dsgmxc/2026_fpga_qrs/llm-log/LLM-078.md

# LLM-078:拐点提前是不是「log 扫描 + 少点 + 插值」造成的?—— **不是**;顺带把自绘硬件板卡入库

- **日期**: 2026-10-24
- **模型**: deepseek-flash(Claude Code harness)
- **任务**: ①用户怀疑 C-V 曲线拐点比参考偏早,是**显示方式**(log 扫描、点数少、插值)造成的;
  ②把桌面新增的四块**自绘硬件板卡**设计源文件推入交付仓库。

## 提示词

```
我突然决定是不是因为我们是log扫描而且点数比较小曲线主要是插值出来的所以从图上显得和标准有点不符合
```

```
你确定水平差不是这个原因导致的吗，我主要是想解决我们曲线的拐点在实测前面的问题
```

```
如果是测量误差就算了，只要不是显示导致的就行
```

```
桌面上多了一个硬件电路文件夹，这些是我们自己画的主要功能的板子也要推送进交付仓库
```

## 一、问题拆分

「显示导致的」包含两个互不相同的机制,必须分开验证:

| 机制 | 会改变什么 | 不会改变什么 |
|---|---|---|
| 60 点 log 网格 + log-log 直线插值 | **点与点之间**画出来的线 | **采样点上的读数**、拐点的真实位置(至多把拐点量化到网格) |
| 实测数据本身 | 采样点读数与拐点位置 | — |

## 二、判据:半降电压 V50

不用「最陡线段」估拐点(它对采样相位敏感),改用与拟合无关的判据:

> **V50** = 电容从 1 V 平台降到 50 V 平台、跨过对数中值时的电压(对数域线性插值)。

对三条腿分别算三种曲线:①参考曲线(201 点,直接取);②参考曲线**按我们的 60 点 log 网格采样后再 log-log 线插**;③实测(2026-10-24 一轮,60 点/腿)。

| 腿 | 参考 V50 | 参考按 60 点采样 + 线插 | 实测 V50 |
|---|---|---|---|
| CISS | 3.94 V | 3.95 V | 4.09 V |
| **COSS** | **10.06 V** | **10.04 V** | **9.23 V** |
| **CRSS** | **10.38 V** | **10.28 V** | **9.11 V** |

⇒ **采样 + 插值只让拐点动 0.02 V(COSS)/ 0.10 V(CRSS);实测却早了 0.83 V / 1.17 V**,差一个数量级。
且插值在采样点上**恒等于实测值** —— 9.62 V 那点实测 385 pF、参考 916 pF,与线怎么画无关。

## 三、实测差异的性质:整条曲线在电压轴上左移

把实测 COSS 与参考做「电压平移 + 竖直偏置」拟合:

| 轮次 | 最佳电压平移 | 竖直偏置 | 平移后残差 | 只做竖直对齐的残差 |
|---|---|---|---|---|
| 2026-10-23 | **+7.6 %** | −6.0 % | 2.2 % | 14.7 % |
| 2026-10-24 | **+7.9 %** | −6.1 % | 2.1 % | 14.7 % |

两轮独立扫压一致到 0.3 %,是稳定的系统效应。关键点:

| 电压 | 实测 COSS | 参考@同电压 | 参考@电压 ×1.079 |
|---|---|---|---|
| 9.62 V | **384.9 pF** | 916.3 pF | **412.5 pF** |

⇒ 不是竖直电平错,而是**整条 COSS 曲线在电压轴上左移约 8 %**(拐点段形状重合,残差 2.1 %)。
**CRSS 不能套这个结论**:平移后残差仍 27 %、电平差 51 %,形状本身就对不上。
**CISS 无有效约束**:曲线平坦,平移与竖直偏置高度简并(有/无平移残差同为 1.2 %)。

## 四、原因未定,但可排除显示

| 候选 | 证据 |
|---|---|
| **显示/插值** | ❌ 已排除:V50 只动 0.02–0.10 V(§二) |
| 器件拐点比参考(10 颗 TK9J90T 中位数)低 | 支持:平移后形状完全重合 |
| 偏压轴标度偏 +8 % | 未排除:`×10` 高压级(`CV_BIAS_HV_RATIO`)**从未端到端实测**;已记录的 DAC 模块误差(`19.777×frac − 10.057`,增益 −1.1 %、零点 −57 mV)**方向相反** |

⇒ 要分开这两者,只能在下一个上电周期用万用表实测高压级 1 / 10 / 50 / 100 V 四点。
用户决定:**若是测量误差则不再追**(原话:「如果是测量误差就算了,只要不是显示导致的就行」)。

## 五、纠错轨迹

| # | 事情 | 结论 |
|---|---|---|
| 1 | 先用「最陡线段」估拐点,得到「60 点网格让 COSS 拐点早约 0.6 V」 | 换成 V50 判据后只有 **0.02 V** ⇒ 那是**估计器自己**的偏差,不是网格效应。**判据的选择会决定结论**;对"位置"类问题要用与拟合无关的判据 |
| 2 | 一度把窗段拟合(低段 −9 % / 拐点 +8 % / 高段 +17 %)当成"非均匀平移" | 平坦段 **平移与竖直偏置简并**,窗段平移不可辨识;只有拐点段约束有效 |
| 3 | 差点把"8 % 左移"归因于已知 DAC 模块误差 | 该误差会让偏压**偏低**、拐点**偏晚**,与观测**方向相反** ⇒ 不能拿来解释 |

## 六、硬件设计源文件入库(同日)

桌面 `硬件电路/` 下 4 份**立创EDA专业版工程归档**,复制进交付仓库 `hardware/`,
**文件名改为纯英文**(M14),源文件保持不动:

| 仓库文件名 | 原文件名 | 大小 | MD5 |
|---|---|---|---|
| `cv_control_expansion_board.epro` | `ProPrj_26cv测试主控拓展版_2026-10-24.epro` | 102,176 B | `20b46ffc…` |
| `lcr_acquisition_board_v3.epro2` | `ProPrj_26嵌赛-LCR采集板-zjy-第三版_2026-10-24.epro2` | 270,729 B | `cc6461a5…` |
| `power_board_110v_48v_in_110v_12v_5v_out.epro2` | `电源板110v,48v输入110v,12v,5v输出.epro2` | 419,302 B | `8f7e76ef…` |
| `relay_matrix.epro2` | `ProPrj_26嵌入式大赛继电器矩阵_2026-10-24.epro2` | 491,762 B | `fe2c9b65…` |

- 复制后逐份 `md5sum` 与源文件比对,**4/4 一致**;
- 新增 `hardware/README.md`:用途 / 打开方式 / 收录范围 / 校验值;
- 顶层 `README.md`:目录对照表加 `hardware/` 行、「新增目录」数 4→6、
  「唯一二进制」改为两类(位流 + 4 份工程归档);
- ⚠️ 工程归档内嵌立创EDA账号元数据(原理图/封装文档的 `username`/`nickname` 字段),
  属设计文件自带内容,**未改动** —— 改动会破坏工程归档的完整性。

## 七、当前状态

| 项 | 状态 |
|---|---|
| 显示/插值嫌疑 | ✅ **已排除**(V50 0.02–0.10 V vs 实测 0.83–1.17 V) |
| 拐点左移的根因 | ⚠️ **未定**:器件 vs 偏压轴;需万用表实测高压级 |
| 用户决定 | 按测量误差处理,**不再追** |
| 代码改动 | **无**(本轮只做分析,未改测量/渲染代码) |
| 硬件文件入库 | ✅ 4 份,MD5 4/4 一致,待提交推送 |
