dsgmxc/2026_fpga_qrs/llm-log/LLM-077.md

# LLM-077:曲线开头的「陡升」—— 不是继电器切错,是**换腿后第一点采在高压没落稳的时候**;顺带查出 ADC 数据线全 0

- **日期**: 2026-10-24
- **模型**: deepseek-flash(Claude Code harness)
- **任务**: 用户观察到「**测曲线下面两条的开头总是有个陡峭的上升**」,问是不是切换过程有问题。

## 提示词

```
测试没什么问题可以更新仓库了，还有为什么我测曲线下面两条的开头总是有个陡峭的上升是切换的过程有什么问题吗
```

## 一、先看现象(来自板上日志,不是推测)

同一轮 0.1→100 V、60 点/腿、驻留 300 ms 的三腿连扫
(`/var/log/qrs-ui.log` 第 1880~2258 行,数据本身是好的):

| 腿 | 第 1 点(0.100 V) | 第 2 点(0.112 V) |
|---|---|---|
| CISS(第 1 腿) | Cs **3378.98** pF,VL/VH 84.86% | Cs 3374.30 pF,84.83% |
| COSS(第 2 腿) | Cs **1872.47** pF,VL/VH 72.43% | Cs **3393.32** pF,86.46% |
| CRSS(第 3 腿) | Cs **572.58** pF,VL/VH 23.87% | Cs **1700.40** pF,37.69% |

⇒ 第 2、3 腿的**第 1 点偏低**(C 只有正常值的一半/三分之一),第 2 点就恢复了。
曲线在 0.1 V 附近看起来就是「先压下去再陡升」—— 用户说的「开头陡升」是**第 1 点太低**造成的,
不是曲线中间有跳变。

## 二、两条对照把原因夹死

| 对照 | 做法 | 结果 | 排除掉什么 |
|---|---|---|---|
| 单腿连扫 | 只跑 CRSS 一条腿(开扫前偏压已在低压停留很久) | 第 1 点完全正常 | **不是继电器切换本身**—— 同样的 `RelayView_ApplyPath()`、同样的稳定窗 |
| 「1 点/腿」 | 0.1 V → 0.1 V、每腿只 1 点,三腿连扫 | 三腿第 1 点**全部正常**(3379 / 3589 / 1809 pF,VL/VH 与稳态一致) | **不是"换腿"这个动作**,而是**上一腿最后一点停在 100 V** |

⇒ 换腿时高压级要从 **100 V 降回 0.1 V**;300 ms 驻留不够,
第 1 点采到的是「还在往下掉的偏压」⇒ 有效电容偏小 ⇒ C 偏低。

## 三、改法:**用实测已经证明够用的那个时刻**

老代码里同一条腿的**第 2 点**是在 0.1 V 下发后 **600 ms** 采的
(= 第 1 点的 300 ms 再加一个驻留),而它**一直是对的**(COSS 3393 pF、CRSS 1700 pF,
与第 3 点一致)。所以改法不是"拍脑袋加时间",而是**把第 1 点挪到 600 ms 这条线上**:

| 文件 | 改动 |
|---|---|
| `src/c_ui/app/pynq_protocol.c` | 🆕 `s_leg_settle_pending`:`sweep_begin_leg()` 置位;`sweep_step()` ① 见到它就把本圈**空等一个驻留**,下一圈才采第 1 点 |
| 同上 | 🆕 `sweep_finish()` 换腿分支里**先 `bias_apply(0.0f)` 再切继电器** |

第二条是查日志时顺带发现的**既有问题**:原来换腿时继电器是在**上一腿终点(通常 100 V)下热切换**的 ——
触点带 100 V 断开/闭合长期会烧蚀,而且高压级要拖到下一条腿下发 0.1 V 时才开始泄放。
先撤到 0 V,泄放从换腿这一刻就开始(多赚一个继电器稳定窗 40~70 ms),触点也不再带压切换。

代价:每条腿 +1 个驻留,三腿一轮 **54 s → 54.9 s**。

## 四、验证:卡在 ADC 上(这次没验成)

部署时发现**新起的 c_ui 所有点都是 A/B 峰峰 0 码**。往下挖:

| 检查 | 结果 |
|---|---|
| 原始采样值 | `0x98[11:0]` **恒 2048** = 存的是 `adc_d ^ 0x800` ⇒ **`adc_d` 恒 0x000** |
| 扫全部相位/分频 | DIV 2/4/13,PH_OFF 从 `−P/2` 到 `P−1−P/2` **逐格试过,全是 2048** |
| 偏压 0→20→60→100 V、回路 CISS/CRSS | **A/B 两路直流也一动不动** |
| `0x88` | `0x104`(OEB=0 使能、PDN=0 不掉电) |
| `0x84` | `0x1`(clk_release=1,MMCM 放行) |
| `0x90` | `0x3`(mmcm_locked=1、done=1);GO 后 busy 会抬起再落下 ⇒ 采集状态机在跑 |
| 软重启(位流重载)后复测 | **仍然全 2048** |

⇒ 不是相位、不是寄存器配置、不是 PL 卡死(重启也不变)⇒ **ADC 的数据线整体没有驱动/没有供电**,
问题在外设侧。**当时写成「硬件故障,待用户用万用表查」—— 这句后来被用户当场更正**(见 §七)。

✅ 日志侧能确认的部分:`[proto] 换腿后第一点:多等 300 ms …` 三条腿各打印一次
(第 2333 / 2577 / 2821 行),新增的定时路径**已跑过**;
❌ **效果(第 1 点是否回到正常值)没验成** —— ADC 不出数,任何扫压都无读数。

## 五、纠错轨迹

| # | 事情 | 结论 |
|---|---|---|
| 1 | 先写了一个直接量「100 V→0.1 V 要多久」的脚本(`tools/bias_settle_test.py`) | 采回来全是 2048。先怀疑**脚本自己错**(只等 `done` 没等 `busy` 抬起、继电器停在 ALL_OFF),两处都改了 —— **还是 2048**。当时把它记成"实验没做成",**实际那时 ADC 已经死了**。教训:全常数读数要先怀疑**量具**,而不是反复改自己的脚本 |
| 2 | 改法第一版注释只写「300 ms 不够」 | 复查日志时发现**老代码的第 2 点(600 ms)一直是对的** ⇒ 把注释改成"600 ms 是实测证明够用的线",**让改动有标定,不是估的** |
| 3 | 只加延时,没看换腿时的继电器 | 读 `sweep_finish()` 才发现换腿时偏压还挂在 100 V 上 —— **继电器一直在热切换**,这是独立于本问题的可靠性缺陷,一并修掉 |
| 4 | 一度以为 ADC 坏了是**软重启能救**的状态 | 软重启(位流重载、`dmesg` 确认加载一次)后复测**依旧全 0** ⇒ 排除 PL 状态,判到外设侧 |
| 5 | **把"未接外设"写成了"硬件故障"** | 用户回:「**是我没接外设**」⇒ 数据线全 0 的**证据没错**,错的是**结论措辞**:证据只支持"外设侧没信号",不支持"坏了"。正确顺序是**先问外设接没接**,再谈供电/排线/万用表 |

## 六、当前状态

| 项 | 状态 |
|---|---|
| 源码(工作区/板 `/home/xilinx/c_ui_src/`) | 已同步,md5 `9dc6c2cd…`;板上 `make -j2` 零 warning,`c_ui` md5 `6ca7dd19…` |
| 运行中的进程 | 仍是**上一个**二进制(只有"多等一个驻留",没有"先撤压再切继电器");下次启动才生效 |
| 上电次数纪律 | 本上电周期位流加载 **1 次**(服务由软重启后手工启动) |
| 阻塞 | **外设未接**(用户确认)—— 不是 ADC 故障 |
| 收尾 | 服务已 `stop`(inactive / disabled);偏压写 **0x00000(0 V)**、继电器 **0x10(ALL_OFF)** 后 `sync` + `shutdown -h now`;ping **100% 丢包** |

## 七、用户更正(同日)

用户原话:

```
是我没接外设，先关系统吧我后面测
```

⇒ 本轮「ADC 全 0」**不是硬件故障,是外设没接**。**§四 的全部排除结论仍然成立**
(相位 / 分频 / 寄存器配置 / PL 状态 / 软重启都已排除),唯一要改的是**把它称为"故障"**。
⚠️ 也因此,**本轮的修复效果仍然没验过** —— 等用户接好外设、下次上电启动服务再验。

## 八、上板验证(同日,外设接好之后)

| 项 | 结果 |
|---|---|
| 上电 → 服务启动 | `dmesg` 位流**恰 1 次**;运行 `c_ui` **`6ca7dd19…`**(两项改动都在);FCLK0 50.0000 MHz |
| ADC 通路自检(只读探针) | A/B 峰峰 **~1124 / ~987 码**(上一轮恒 2048)⇒ 外设已接、通路正常 |
| 用户触发 | 界面点扫压(0.1→100 V,60 点/腿,三腿) |
| 三条 `[proto] 换腿后第一点:多等 300 ms` | **3 / 3** |
| 点数 / OTR | **180 / 180**,OTR 非零 **0** |

**首点 vs 次点(Cs)**:

| 腿 | 修复前 首/次 | 比值 | **修复后 首/次** | **比值** |
|---|---|---|---|---|
| CISS | 3378.98 / 3374.30 pF | 1.001 | 3378.81 / 3375.22 pF | 1.001 |
| COSS | 1872.47 / 3393.32 pF | **0.552** | **3568.80 / 3559.53 pF** | **1.003** |
| CRSS | 572.58 / 1700.40 pF | **0.337** | **1749.57 / 1795.66 pF** | **0.974** |

CRSS 首点比次点低 2.6 %,但**落在第 2 点与第 3 点之间**(第 3 点 1785.53 pF)⇒ 正常点间抖动。
用户目视评价:「**现在好多了**」。

⚠️ **两处改动证据强度不同,别合并**:
①「多等一个驻留」有日志标记 + 首点数据,✅ 已验;
②「换腿前先 `bias_apply(0)`」代码在运行二进制里,但该函数**不打印日志**,本轮**无独立读数** ⇒
只能写"代码路径已生效",**不能写"已确认不再热切换"**。要坐实需加一行日志,下个周期验。

📄 数据归档:`report/measurements/20261024_leg_settle_fix_sweep.md`
(+ `artifacts/20261024_leg_settle_run.log` `79f6a1a0…`、`artifacts/20261024_leg_settle_sweep.csv` `aa855094…`)。
🔌 收尾:服务 `stop`(inactive / disabled)、偏压 0 V、继电器 ALL_OFF、`sync` + `shutdown`,ping 100% 丢包。
