dsgmxc/2026_fpga_qrs/llm-log/LLM-073.md

# LLM-073:自动换挡改判据 —— 用 `VL/VH` 反推 `|Z|`、加换挡后核对、一次只走一挡

- **日期**: 2026-10-23
- **模型**: deepseek-flash(Claude Code harness)
- **任务**: 用户接好回路控制后试自动换挡,报告「合理的电压下切换没问题,电压较小的时候用高档位确实会测出负的」。把换挡判据从复数 `|Z|` 改成两路**解调幅值之比**,并给换挡加一道"换完核对"。

## 提示词

```
现在我的回路控制都连接好了按理说应该可以尝试自动切换了，
前面100欧姆档应该问题不大但是后面是不是切10om会比较好
（模型纠正方向后）
刚式了一下在合理的电压下切换应该没有问题电压较小的时候用高档位确实会测出负的
先断电吧然后你写完我重新上电
```

## 诊断

用用户 2026-10-23 日志里同一器件、同一 50 V CRSS 的三个挡位读数:

| 挡位 | R0 | Re Z | Re Z / R0 | Im Z |
|---|---:|---:|---:|---:|
| B | 100 Ω | 1.85 kΩ | 18.5 | −12.5 kΩ |
| C | 1 kΩ | 17.7 kΩ | 17.7 | −11.9 kΩ |
| D | 10 kΩ | 175 kΩ | 17.5 | −9.7 kΩ |

**实部几乎严格正比于 R0,虚部基本不动** ⇒ 实部是测量链的镜像,不是器件。
`Z = R0·(VH−VL)/VL` 在 `VL ≪ VH` 时是一个大数减小数,通道间任何失配都被按
`|Z|/R0` 倍放大;R0 越大,同一个失配越显眼。负的 Cs 就是在这个背景下出现的:
真实信号已经小于失配项,`Im Z` 被实部伪影压过符号。

**机制未定**:试过"B 路加性串扰"和"B 路增益误差"两个最简模型,都只能解释 Re
而解释不了 Im 同时基本正确。**记录只到"实部 ∝ R0"这一层,不编机制**。
候选的实验是四挡已知电阻标定(见下)。

## 改动(全部在 `src/c_ui/app/pynq_protocol.c`)

| # | 改动 | 为什么 |
|---|---|---|
| 1 | `AdcPair` 增 `vl_vh`(两路解调幅值之比)与 `fresh`(本次采到) | `Z` 坏了比例仍在;`fresh` 防拿上一点残留做决定 |
| 2 | 采集后算 `vl_vh`;比例 > 0.95 ⇒ **判本点无读数**(`z_valid = 0`)并给出建议挡位 | 大数相减已经不可信,往曲线上塞负电容更糟 |
| 3 | 比例 < 0.15 % ⇒ 只警告(不判无效) | B 路进噪声底时 Cs 靠相干平均仍可用,`D/Cp` 不可信 |
| 4 | 换挡判据改为 `z_app = R0·√(1/r² − 1)` | 直接用比值,不经过 `(A−B)` 相消 |
| 5 | **换挡后核对**:同一器件换一挡,`z_app` 必须落在 1.5 倍内;否则**回退旧挡并关闭本轮自动** | 判据错误是确定性的,失败后每点都会重来 —— 必须粘滞 |
| 6 | **一次只走一挡**(`gear_adjacent()`) | 跨挡会一次跨过两个没验证过的电阻,出问题定位不到 |
| 7 | 目标带 `[0.15, 0.90]`;上界取 0.90 而非 0.85 | 0.1 V 的 CISS 在 B 挡上就是 0.894,那一点用户实测"问题不大",不该被赶去 A 挡 |
| 8 | `[adc]` 日志行增 `VL/VH ××.××%` 带 ⚠低/⛔高 | 挡位是否匹配一眼可读,不用事后算 |
| 9 | `sweep_start()` / 换腿时清核对状态 | 换腿等于换器件,上一腿的 `|Z|` 不能跨腿比 |

**自动换挡仍然默认关闭**(文件 `/home/xilinx/sweep_auto_gear` 才开),理由不变:
四个挡位的参考电阻尚未用已知件标定,未标定的比例上做自动决策只是放大未知量。

## 自我纠错(本次最重要的一条)

2026-10-15 的方案注释里写过「**换挡判据本身没错 —— 错的是它脚下的 |Z| 本身不可信**」。
2026-10-23 的数据说明**这句只对一半**:判据(拿复数 `|Z|` 选挡)本身就错,
因为那条 `|Z|` 的实部 ∝ R0,拿它选挡会把坏数再放大一次。注释已改写,
并保留原判断作为追溯(见 `SWEEP_AUTO_GEAR_FLAG` 上方)。

**同日上板后第二次纠错**:上面新加的「换挡后核对」在**拐点附近会误判**。
第一次实测的 3.13× 出现在 9.617 V(B)→ 10.812 V(C),两个点本来就跨过
Coss/Crss 的拐点;而 C 挡的 Re 伪影(9.27 kΩ)又把 `z_app` 抬高。
**判据的假设(相邻两点 |Z| 变化 < 1.5 倍、`z_app` 与 R0 无关)在拐点处两条都不成立。**
⇒ 1.5 倍阈值不是"待定",是**已知不成立**;核对必须改成同偏压复测。
这条也说明:把「未验证的风险」写进记录是有用的 —— 它正是这次踩中的那一条。

## 结果

☐ ✅ 直接可用   ☑ ⚠️ 部分可用   ☐ ❌ 不可用

- **已上板(2026-10-23 第 2 次上电)**:自动换挡只走一步就被核对拦下 ——
  9.617 V 时 B(100 Ω)比例 2.85 % → 换 C;10.812 V 时 C 挡反推 10982 Ω vs 锚点
  3512 Ω,判 **3.13 倍** → 回退 B,**本轮不再换挡**。负 Cs 未再出现;
  其余 58 点全程 100 Ω,所以曲线与上一轮 B 挡数据一致(用户:「感觉区别不大」)。
- **⚠️ 核对判据有缺陷(本轮实测)**:3.13× 不能证明 C 挡坏 ——
  ① 两个读数跨了拐点(9.617 V vs 10.812 V,真实 |Z| 本身在变);
  ② C 挡的 Re∝R0 伪影把**比例反推**的 |Z| 抬高(10.812 V:Re 9.27 kΩ、Im 4.03 kΩ),
     而 `z_app` 只有幅值、分不清 Re/Im。
  ⇒ 结论从「这一挡算不出来」降级为「**这一挡没法用这个判据验**」。
  改法:换挡后在**同一偏压**复测再比,不要拿下一个扫压点当参照。
- **Cs 本身在 C 挡是可用的**:C 挡 10.812 V 读 39.5 pF,与 B 挡 9.617 V 的 50.0 pF、
  12.155 V 的 35.2 pF 连成单调曲线 —— 坏的只是复数 Z 的实部,不是 Cs。
- **证据**:`report/measurements/artifacts/20261023_crss_gear_probe.log`(md5 `26aa69c0…`)。

## 验证方式(上电后照这个跑)

1. `sudo touch /home/xilinx/sweep_auto_gear`,测量页选 B 挡,跑一次「全部」或 CRSS。
2. 日志里应当看到:
   - `[adc] ... VL/VH ××.××%` —— 50 V CRSS(≈12.5 kΩ)在 B 挡应为 **≈0.8 %**
     (`100/√(100²+12550²)`);**若日志明显大于这个数**,说明 B 路存在与 R0 无关的
     偏移,那正是要查的量;
   - 第一次往 C 挡换后,下一点出现 `⛔ 换挡后 |Z| 对不上 … 回退到 100 Ω 挡`,
     随后整轮不再换挡;
   - **不再出现负 Cs**(比例 > 95 % 的点被 ⛔ 挡住)。
3. 若核对没有触发、C 挡的 `z_app` 与 B 挡一致 ⇒ 说明这一挡是好的,可以继续往上试。
4. 四挡已知电阻(10 Ω / 100 Ω / 1 kΩ / 10 kΩ 各配一只)标定做完后,才考虑默认开启。
