dsgmxc/2026_fpga_qrs/llm-log/LLM-069.md

# LLM-069: CRSS 高压端坏点的根因 ——从"采样刻度错一拍"改判到"ADC 真的过载了"(OTR 作证)

- **日期**: 2026-10-15(第 64 次会话)
- **模型**: Claude(DeepSeek-V4-Flash 会话)
- **任务**: 用户 2026-10-14 报告「**我发现 50 附近测量 CRSS 确实容易出问题**」+
  「**我看到的调试界面就是下面那个曲线有波动不太干净的正弦波,你先分析一下这些坏点原因导致的**」。
  产出:`report/measurements/20261015_crss_bad_points_root_cause.md`(纯分析,**未改一行代码**)。
  **推翻/修正了 `LLM-068` 里那条机制推断。**
- **上游**: `LLM-068`(自洽判据 + 重采 —— 它把尖峰"挡在门外",本次是问"门外的到底是什么")

## 提示词

```
我发现50附近测量crss确实容易出问题，现在先把系统关了我要断电了，你查一下最近的单点测量看看原因
```
```
我看到的调试界面就是下面那个曲线有波动不太干净的正弦波，你先分析一下这些坏点原因导致的
```

## 模型回答

**结论一句话**:坏点不是噪声、不是解调算错 —— 是**采集缓冲里混进了 1–10 个打到 ADC 满量程轨的样本**;
它**既挑回路(只有 CRSS)、又挑偏压(只在 ≥40 V)**。CRSS@50 V 坏捕捉 **73%(11/15)**、
CRSS@55 V **89%(8/9)**、CRSS@0.1 V 只有 **5%(1/20)**、CISS 扫压 60 点全程 **0%**。

**三条指纹**:

1. **解调干净、峰峰炸。** CRSS ≥39 V 采纳点上 A 路解调幅值 CV = **0.14%**(0.3274 ± 0.0005 V),
   而同期 ppA 在 1348 → 1354 之间跳。8190 点相干解调对 1–10 个孤立样本几乎免疫(权重 0.12%),
   而峰峰 `max−min` 被单个样本完全决定 ⇒ **是极少数样本的瞬时越界,不是整段污染、不是算术错**。
2. **ppA 落在离散台阶上。** 干净 1060–1640;另一簇在 **2348–2787**。算给你看:
   干净信号跨 `[2048−671, 2048+671] = [1377, 2719]`;若**一个**样本打到上轨 4095 ⇒ `pp = 4095−1377 = 2718`。
   实测那一簇 2731 / 2737 / 2740,**差 <1%** ⇒ **"恰好一个样本到轨"**。`ppA ≈ 4095` 那簇 = 两端都到轨。
3. **A、B 一起胀。** CRSS@55 V 干净时 ppA/ppB = 1351 / **32**(B 路幅值只有 **5.7 码** = 0.28% 满量程),
   坏时 3968 / 3932 —— 20 条高压过载里 **18 条 B 也 ≥2000** ⇒ 瞬变是**两路共有的**,量级 ≡ 满量程。

**★ 决定性证据:`adc_otr`。** 它是 **AD9238 自己的输出引脚**(`Y8`,`led.xdc:130`),
手册原文 *"Out-of-Range Indicator for Channel A/B"*。逐字 OTR 位(2026-10-14 修好位序后才有效):

| 分组 | n | `OTR > 0` |
|---|---|---|
| 干净(ppA < 2000) | **213** | **0(0%)** |
| 高压过载 | 20 | 16(80%) |
| └ ppA ≥ 3900 | **13** | **13(100%)** |

数据总线是 12 根线,OTR 是**独立的第 13 根**。一根与数据无关的引脚**跟着一起置起**,
说明不是数据总线被读错,是 **ADC 自己判定输入越了量程**。且计数只有 1–10 / 16384 字,
而"采样刻度错一拍"会**每个周期都错**(8190 次/采)—— **量级差三个数量级**。

**机制候选(排过序)**:H2a **CRSS 组合下栅极浮空**(1 MHz 经 `Cgd` 整流给浮空节点充电到击穿)领先
—— 它一次解释了"只有 CRSS""只有高压""1–10 次/8192 的稀疏率"三件事;
H2b 50 V 下继电器触点微弧;H2c 偏压 ×10 放大器尖峰(**解释不了"只有 CRSS"**,CISS/COSS 走同一套偏压);
H1 采样刻度错一拍(**被削弱但未排除**,见下)。

**判别实验**:★(a) CRSS 夹具加一只 **1 kΩ 栅–源电阻**(一只电阻,判别力最强);
(b) CRSS@50 V 关掉激励再采;(c) **软件诊断打印越界样本的序号/值/通道** —— 纯 C、不占位流周期,
**是唯一能把 H1 和 H2 分开的实验**。

**⛔ 明确说了不要做的事**:不要用放宽阈值的办法"修"它 —— `142 / 208 / 362` 这种量级,放宽度覆盖不了,
只会把 519 pF 那种尖峰重新放回曲线上。**要修的是模拟侧,不是判据。**

## 结果

☐ ✅ 直接可用
☐ ⚠️ 部分可用
☑ **📋 分析结论,不改代码** —— 用户要的是"分析原因",本次**一行代码没动**。
结论是**根因定位到模拟侧(候选 H2a),并给出三个判别实验**;
⚠️ **没有把 H1(数字)排除掉** —— 见"纠错轨迹"第 7 条。

## 验证方式

**全部数字都在同一份日志上现场重算,不引用转述**:

| 项 | 值 |
|---|---|
| 原始日志 | 板上 `/var/log/qrs-ui.log` → 主机 `/tmp/qrs-ui-final.log` |
| 文件 | **949465 B · 9211 行** · md5 **`809f9c5898362d6b46b63095ba7335c1`** |
| 分析窗口 | 第 7964 – 9211 行(最后一次 `c_ui 启动` 起,进程未再重启) |
| 证据行 | **245 条**(严格格式,带 `码/期望` 与 `采 N 次` 两列) |
| 脚本 | `/tmp/doc69.py` `doc69b.py` `doc69c.py` `doc69d.py`(主机,重启即失;逻辑已写进测量记录各表) |

**回路归属用硬件真值**:取 `[relay] 回路 → X(0xNN)` 那行 —— 它是 `c_ui` **真的写了 `0x1C` 并回读确认**
之后打的,**不是界面按钮状态**。

**手册依据**(本次新读):`/home/hyp/Desktop/硬件资料/AD9238模块资料/芯片手册/ADI-AD9238-65.pdf`
(Rev. C)—— OTR 引脚定义(脚 58 / 脚 39)、*"Out-of-range signals indicate an overflow condition"*、
流水线延迟 **7 周期**、离开过量程 **2 周期**。

**没有做的验证**(不得写成"已证明"):越界样本的序号/通道未记录(§七(c) 要做);
"界面上的正弦不干净"这句**日志证实不了**(见下)。

## 纠错轨迹

<!-- 这一节是评分重点。只记成功案例拿不到分。 -->

1. **★ 差点拿一个"脚本算出来的数"当结论 —— 那个脚本的归属逻辑是错的。**
   我先前用 `/tmp/rate2.py` 算过一张"回路 × 偏压坏点率"表,得到
   `CRSS@50 V 52/54 = 96.3%`、`CISS@50 V 0/11 = 0%`,并据此写下**"是路径依赖,不是偏压依赖"**。
   **这次重算:CRSS@50 V 是 11/15 = 73%(不是 52/54);而且 CRSS@0.1 V 只有 5%、
   高压过载的 20 条全部落在 CRSS、低压过载的 12 条横跨三条腿。**
   根因:`rate2.py` 用 `[proto] 点测 CISS @ 0.10 V` 这行归属回路,而这行**在扫压期间会残留**
   ⇒ 把 227 次扫压捕捉全算到「CISS @ 0.10 V」名下。**那个数已作废,并已告知用户。**
   ⇒ **教训:归类用的"标记行",必须挑那种"写下去就会被回读确认"的(这里是 `[relay] 回路 →`);
   不能用"打印一句话表示意图"的。前者是状态,后者是心情。**

2. **★ 差点把结论说成单因子。** 我第二版的措辞是"**是路径依赖,不是偏压依赖**"。
   重算后:**两个变量都成立** —— 同偏压(50 V)下 CISS 0% vs CRSS 73%(回路);
   同回路(CRSS)下 0.1 V 5% vs 50 V 73%(偏压)。**改成"两个都有,不是单因子"。**
   (这条是第 1 条的后遗症:坏数据必然长出坏结论。)

3. **★ 差点把两个不同口径的 OTR 混成一个。** 我一度准备写"坏点 92–96% 带 OTR≠0,
   正常点也有 4–5%"—— 那是 `LLM-068` 里从 `/tmp/qrs-ui.log` 得来的数。
   **本次实测:干净捕捉 0/213(0.0%)**,与那个"4–5%"对不上。
   根因:逐字 OTR 位是 **2026-10-14 修好位序之后**才有效的(`adc_capture.v:468` 记着
   原文 `{adc_otr, 3'b000, ...}` 把 otr 放到了 bit15,而 `rd_otr = rd_r[12]` 取的是**填充位**),
   早期那些"OTR"只能来自 `0x90[3]` 那根**粘滞**标志 —— **两个口径不是一回事。**
   ⇒ 以本日志为准,**旧口径标为存疑、不删**(它是既成事实的一部分)。

4. **★ 差点把"界面上的正弦不干净"直接算成坏点造成的,算完概率才发现对不上。**
   波形页喂的是交织拆分后的 `s_code_a[0..95]`,**96 点**;
   而越界样本是 **1–10 个 / 8192 点** ⇒ 落进这个窗口的概率约 **1%–12%**。
   这与"一直看着不干净"**对不上**。⇒ **如实标为"未查证",不下判断**,并写清日志里根本没有那 96 点波形数据。
   **没有为了让故事完整而把两者焊在一起。**

5. **★ 差点把 65 MSPS 那一段的证据混进来。** 同一份日志里有 **11 个 `c_ui 启动` 段**,
   前 4 段是 `0x88 = 0x0FF02`(DIV=2,**65.00 MSPS**),后 7 段才是 `0x00104`(DIV=4,32.50 MSPS)。
   我按"格式"筛出的 245 条**逐条核过采样配置,245/245 全落在 32.5 MSPS 段**;
   但**宽松正则能匹配到 2559 条** —— 多出来的 2314 条是**旧格式**(没有 `码/期望` / `采 N 次` 两列)。
   ⇒ **筛证据行不能只按"长得像",要按"哪一段配置生成的"再核一遍。**

6. **★ 差点又把"OTR 是独立证据"说过头了。** 它的确是与 12 位数据线无关的第 13 根线,
   但它**和数据走同一个采样刻度**。所以它排除的是「总线被串扰 / 数据被读错」,
   **不能**排除「整个采样刻度都错」。写成"OTR 证明是模拟问题"会**过度断言**;
   现在的措辞是「**天平压向模拟侧,不是焊死**」,并在 §六 专门留了一节讲数字侧还没排除。

7. **★ 一条自己给自己踩的刹车 —— 没有把 H1(数字)从结论里删掉。**
   证据对 H1 是**不利**的(0/213 vs 16/20 的相关性、量级差三个数量级),但不利 ≠ 排除。
   `led.xdc:213` 那条"输入时序本版**有意不约束**"(杜邦线 tPD ~4 ns vs P=2 时 15.4 ns 眼宽)
   是真的事实 ⇒ **在它被消除之前,"数字侧无辜"说不了。**
   所以结论写成"压向模拟侧 + 给出能把两者分开的实验",**不是**"已经证明是模拟问题"。

8. **★ 顺带纠正了一条我自己先前对用户说过的判断。**
   我说过「CRSS 在 50 V 下 `Re Z = 17.5 kΩ`、`D = 1.43` 物理上不可能」。
   这次因为用户中途**换过挡位**,拿到了同一器件在不同 `R0` 下的三组对照:
   `Re Z` 跟着 `R0` 走(7.2× / 13× / 8.5×),`Im Z` 大体不动(2% / 5% / 10%)。
   ⇒ **可疑的不是那个数大,是它随量程电阻变。** 前面那句话本身说得不准,已在测量记录 §八 里标注修正。

9. **★ 统计数字我做了"增量算术",实跑之后才发现差了 4。**
   写本次会话的 `INDEX.md` footer 时,我按"上一版写 `合计=64`,加我一行 ⇒ 65"手写了一个数。
   **实跑本文件自带的统计脚本后,是 `✅=24 / ⚠️=44 / ❌=0 / 无标记=1 / 合计=69`** ——
   差的不是 1 行,是 **4 行**:表里早就有 68 行,而 footer 一路写 64。三处对账(`ls | wc -l` = 69、
   `grep -c '^| \[LLM-'` = 69、脚本 `合计` = 69,编号 001–069 连续无缺口)全部支持 69。
   ⇒ **改法**:以实跑为准,并把这次漂移**记下来**(与 `LLM-057/058` 那次同类)。
   **教训:统计类数字一律现场跑,不要做增量算术** —— 你不只是可能算错一行,
   是**继承了他人的错误基线却按正确基线递增**,结果两头都不对。

## 沉淀

<!-- 这次的经验能变成 skill/ 下的哪一项?没有就不填,不要硬凑。 -->

→ 候选 `skill/recount-dont-increment/`
   —— **汇总类数字(合计、计数、覆盖率)一律现场重跑,不做"上一版 + 增量"的算术**。
   本次实测:footer 一路写 `合计=64`,实跑得 **69**(少记 4 行,`✅` 虚少 3、`⚠️` 虚少 1);
   而我自己又在其上做了增量算术,得到一个**两头都不对**的 65。
   ⇒ **增量算术会让你同时继承错误基线、又叠加自己的增量。**

→ 候选 `skill/classify-by-state-not-by-intent/`
   —— **归类证据要挑"写下去会被回读确认"的状态行(`[relay] 回路 → X`),不要挑"打印一句话表示意图"的
   (会残留、会跨段污染)**。本次差点因为用错标记行把 227 次捕捉归错回路,
   并从中长出一整条错结论("是路径依赖,不是偏压依赖")。
   适用面比本项目宽:任何"日志里找标记行做分组"的分析都适用。

→ 候选 `skill/independent-evidence-must-share-no-pipeline/`
   —— **判定"某根引脚是独立证据"时,要问它和数据是不是走同一个采样刻度**。
   `adc_otr` 与 12 位数据是两根线、但与数据同拍 ⇒ 它能排除"总线串扰",**不能**排除"刻度整体错"。
   与既有 `skill/measurement-instrument-can-be-wrong` 同族。

→ 与 `LLM-068` 的 `skill/consistency-gate-over-median/` 连成一条线:
   **判据负责"这一次算不算数";根因分析负责"门外的东西是什么"。两件事,别互相替代。**

---

<!--
填写提醒:
1. 当天记录,不要事后补 —— 补出来的没有"验证方式"和"纠错轨迹"
2. 失败也要记 —— 失败记录才是技能包的原料
3. 每条记录里必须能看到"我不同意 / 我改了 / 我验证了"
4. commit message 里加 [llm-XXX] 关联
-->
