dsgmxc/2026_fpga_qrs/docs/dac1220_interface.md

# DAC1220 接口规格(PL 侧实现依据)

> **用途**:`src/rtl/dac_1220.v` 与 `spi_master` 参数取值的**唯一依据**;同时作为
> 设计报告 M09「软硬件划分依据与接口设计」的接口部分素材。
>
> **本文所有结论均出自数据手册或厂商例程源码,逐条标了出处。**
> 凡属**推断**的,一律显式标注「推断」;凡**未核实**的,列入文末。

---

## 〇、资料来源

| 资料 | 路径 | 性质 |
|---|---|---|
| TI 数据手册 SBAS082G(1998-02 / 修订 2009-09) | `/home/hyp/Desktop/硬件资料/DAC1220资料/DAC1220资料/dac1220.pdf` | **一手权威** |
| | ⚠️ 2026-10-12 更正:上格原写 `~/Desktop/DAC1220资料/...`,**该路径不存在** | |
| 厂商 STM32 例程(电压设置版) | 同目录 `程序/DAC1220电压设置/` | 可运行参考,但**本身有两处缺陷**(见 §七) |
| 厂商 STM32 例程(三角波版) | 同目录 `程序/DAC1220三角波输出/` | 同上,追加三角波查表示范 |

**模块晶振频率**:**2.4576 MHz**(2026-09-16 用户**查看模块丝印确认**,与厂商例程声明一致)
→ `tXIN = 1 / 2.4576 MHz = 406.90 ns`(手册 Table 2 规定 `fXIN ∈ [1, 2.5] MHz`,2.4576 MHz 在范围内)。

> ✅ **晶振前提已锁定**(2.4576 MHz → `tXIN = 406.90 ns`)。
>
> ⚠️ **时钟频率**同样决定全部「拍数」。
> ~~当前 PL-only 测试顶层用 `clk_50m`,将来 `cv_sys` 用 `clk_axi = 100 MHz`。~~
>
> 🔴 **2026-09-29 更正:上句已作废。** `clk_axi` 已定为 **50 MHz**(见 `CLAUDE.md` §八、
> `report/source_design_checklist.md` §2.3),与当前 PL-only 顶层的 `clk_50m` **同为 50 MHz**
> ⇒ **"当前"与"将来"不再有频率差**。
> **后果**:本文 §5.1 等处的常量表按两列给出(`@50 MHz` / `@100 MHz`),其中
> **`@100 MHz` 列已失去前提,一律取 `@50 MHz` 列**;该列**保留不删**,作为"换时钟时整表怎么重算"
> 的记录(100 MHz 列 = 50 MHz 列 × 2)。
> ⚠️ 换用任何新频率时,**仍须整表重算**,不要沿用任一列。
> 换算方法见 §3.1 与 §四 的公式列。

---

## 一、电气层

| 项 | 结论 | 出处 |
|---|---|---|
| 引脚 | `SDIO`(双向,数据)、`SCLK`(输入,时钟)、`CS`(输入,低有效)、`XIN/XOUT`(晶振) | 手册引脚图 |
| **CS 处置** | **全程拉低,不参与分帧** | p11:「If CS is not used, it should be tied low.」;例程 `DAC_CS = 0;` 仅出现在 `IO_Init` 中,全文无第二处 |
| CS 高时 | SCLK 上的活动**被忽略** | p11 原文 |
| **reset pattern 前提** | **只在 CS 低时才能触发** | p11:「can only be triggered when CS is low」 |

> **本项目的处置**:`dac_1220.v` 的 `cs` 输出恒低(DAC1220 这一路),
> `spi_master` 的 CS 分帧能力对 DAC1220 不使用(`cs` 仍要驱动,只是保持低)。
> AD9833 的 FSYNC 分帧不受影响 —— 那是另一路。

---

## 二、协议层:帧格式

### 2.1 命令字节格式(手册 Table 6 / Table 7,p12)

| 位 | 7 | 6–5 | 4 | 3–0 |
|---|---|---|---|---|
| 名称 | `R/W` | `MB` | 恒 0 | `ADR` |
| 取值 | 0=写 / 1=读 | 00=1字节 01=2字节 10=3字节 11=保留 | 写 0 | 起始地址 0–15 |

- **命令字节恒为 MSB 先**,不受 `MSB` 位影响(手册 p12「Bit and Byte Order」)
- 一帧 = **命令字节 + 1/2/3 个数据字节**(「A DAC1220 command can read or write one byte, or two or three adjacent bytes」,p12)

### 2.2 寄存器地址(手册 Table 11,p15)

| ADR | 内容 | ADR | 内容 |
|---|---|---|---|
| 0 | DIR 字节 2(MSB) | 8/9/10 | OCR 字节 2/1/0 |
| 1 | DIR 字节 1 | 11 | 保留 |
| 2 | DIR 字节 0(LSB) | 12/13/14 | FCR 字节 2/1/0 |
| 3 | 保留 | 15 | 保留 |
| **4** | **CMR 字节 1(MSB)** | 6/7 | 保留 |
| **5** | **CMR 字节 0(LSB)** | | |

### 2.3 本项目用到的命令字

| 命令字 | 二进制 | 含义 | 数据字节数 |
|---|---|---|---|
| `0x40` | `0100_0000` | **写 DIR(3 字节,ADR=0)** —— 20 位码一次写完 | 3 |
| `0x24` | `0010_0100` | **写 CMR(2 字节,ADR=4)** | 2 |
| `0x05` | `0000_0101` | 写 CMR 低字节(仅改 MD 时用) | 1 |

> **备选(厂商例程的做法)**:`0x00`/`0x01`/`0x02` 分三次写 DIR,`0x04`/`0x05` 分两次写 CMR。
> 功能等价,只是帧数多一倍。**本项目采用多字节命令**,理由:更贴合手册的命令模型,
> 且减少帧数 = 减少 §四 那个 18 µs 帧间隔的累计开销。

### 2.4 DIR 码值格式

手册 p14 原文:DIR 是 24 位,**码值左对齐,低位被忽略**
(「the code stored in it is left justified, with the least significant bits ignored」)。

```
DIR[23:0] = code20 << 4          // 20 位模式:高 20 位有效,低 4 位为 0
```

- 20 位模式:三个字节都必须写(手册 p14 明文)
- 16 位模式:只需写高两字节 —— **本项目用 20 位**

#### 2.4.1 三个数据字节的**逐字节取值**(2026-09-19 补)

> ⚠️ **本节是补上来的。** 上面那句「`DIR = code << 4`」在这里躺了两周,
> 但**从来没有被翻译成"三个字节分别取哪几位"** —— 2026-09-18 的 RTL 就是在这个空档里
> 写成 `code[19:16] / code[15:8]`,**把 `code[11:4]` 这 8 位整个丢掉了**(见 LLM-010)。
> **规格写了公式 ≠ 规格写了接口。**

| 字节 | 手册名 | 取 `code20` 的哪几位 | 写法 |
|---|---|---|---|
| 数据字节 1 | DIR 高字节 | `code[19:12]` | `code[19:12]` |
| 数据字节 2 | DIR 中字节 | `code[11:4]` | `code[11:4]` |
| 数据字节 3 | DIR 低字节 | 只有 `code[3:0]` 是有效码值,低 4 位是**填充** | `{code[3:0], 4'b0000}` |

**三处互证**(三者相互独立,结论一致):

1. **手册 p14 原文** —— 「left justified, with the least significant bits ignored」;
2. **手册 Table 9 算例** —— `code = 80000h` → `DIR = 80000xh`(注意是 5 个十六进制位 + 一个 `x`);
3. **厂商例程 `DAC1220_WDAT()`** —— 先 `dat << 4` 得到 24 位,再取 `[23:16] / [15:8] / [7:0]`。

**常见的错法**(本次踩的就是它):照 `[19:16] / [15:8]` 切。
那等于把 20 位码值当成 24 位里的**连续**三段来切 —— 而 `code << 4` 之后,
字节 2 落在 `DIR[15:8] = code[11:4]`,**不是 `code[15:8]`**。

**错误后果的量级**(引用时用这一行):有效码值变成 `code & ~20'h0FF0` →
最大偏差 4080 码 ≈ **0.39% 满量程**,有效分辨率从 20 位掉到 ~12 位,
且**输出仍然单调** → 用电压表逐点看**发现不了**。

---

## 三、SPI 波形契约(决定上板能否通)

手册 p9 原文:
> "The DAC1220 **latches incoming bits on the falling edge** of SCLK, and **shifts outgoing bits on the rising edge** of SCLK."

| 项 | 结论 | 出处 |
|---|---|---|
| **SCLK 空闲电平** | **低** | Figure 9 / Figure 10 |
| **从机采样边沿(写)** | **下降沿** | p9 正文 |
| **主机改变 SDIO 的边沿** | 上升沿 | p9 正文 |
| **对应 SPI 模式** | **CPOL=0 / CPHA=1(Mode 2)** | 由上两行推出 —— **推断**,非手册原文表述 |
| 位序 | MSB 先(**默认**;`MSB` 位 =0) | Table 13 bit2 |
| 字节序 | 地址递增(**默认**;`BD` 位 =0) | Table 13 bit3 |

### 3.1 时序数值(手册 Table 3,p9 与 Table 4,p10)

| 符号 | 含义 | 下限 | 上限 | `tXIN` 折算 | **建议拍数(@50 MHz / @100 MHz)** |
|---|---|---|---|---|---|
| `t3` | SCLK 高 | 5×tXIN | — | ≥ 2.03 µs | **256** ✅ 已定 / 512 ← **`SPI_HALF_T`,= 5.12 µs** |
| `t4` | SCLK 低 | 5×tXIN | — | ≥ 2.03 µs | **256** / 512(同 `SPI_HALF_T`) |
| `t5` | 数据建立(→ 下降沿) | 40 ns | — | — | 自动满足 |
| `t6` | 数据保持(下降沿 →) | 20 ns | — | — | 自动满足 |
| `t8` | 上升沿 → 新数据输出有效 | — | 50 ns | — | **读方向需注意** |
| `t9` | 命令字节末沿 → 数据字节首沿 | 13×tXIN | — | ≥ 5.29 µs | 见下 |
| `t14` | 上命令末沿 → 下命令首沿(**CS 恒低**) | **41×tXIN** | — | **≥ 16.68 µs** | **1024** / 2048(= 20.48 µs) |

> ⚠️ **由 `t3` 强制的硬约束:`f_SCLK ≤ 1/(10×tXIN) ≈ 246 kHz`。**
> `SPI_HALF_T` 下限 = `5×tXIN / 时钟周期`:**@50 MHz → 102**;**@100 MHz → 204**。
> 原仿真用的 `SPI_HALF_T=10`(100 MHz 下即 5 MHz)**比 DAC1220 的上限快约 20 倍** ——
> **那次验证结论不能直接用于 DAC1220,必须按新分频重跑。**
>
> ✅ 2026-09-16 已定:**`SPI_HALF_T = 256` @ `clk_50m`** = 5.12 µs / 97.66 kHz,余量 +152%。

> **字节间距统一取 ≥ 41×tXIN(即 `t14`)。**
> 该值天然同时满足 `t9`(13)、读方向的 `t11+t12`(14)、`t13`(6),
> 用一个常数覆盖所有「字节之间」的等待,代价是初始化多几十微秒。
> **@50 MHz 取 1024 拍;@100 MHz 取 2048 拍。**

### 3.2 读方向(本项目**不实现**,列出备查)

读时 SDIO 由 DAC 驱动:命令末沿后 `t11`(8–10×tXIN)转输出,再过 `t12`(4×tXIN)首个上升沿到来;
末个下降沿后 `t13`(4–6×tXIN)转三态。

> ⚠️ 厂商例程的 `DAC1220_Read_Byte()` 在**拉高 SCLK 的同一刻**读 SDIO。
> 但按手册,从机是在**上升沿更新**输出(`t8` ≤ 50 ns),那一刻线上还是**上一位**。
> STM32 的 GPIO 操作慢,恰好躲过;**RTL 若做读,必须在下降沿采。**

---

## 四、SCLK Reset Pattern

DAC1220 **无专用复位引脚**,靠 SCLK 上的一段特殊图案触发内部复位(手册 Figure 12 + Table 5,p11)。
**必须在 CS 低时**才被检测。

| 符号 | 定义 | 手册范围(×tXIN) | 窗口(µs) | **厂商例程** | **本项目(RTL 实际值 @50 MHz)** |
|---|---|---|---|---|---|
| `t16` | 第 1 段高 | 512 ~ 800 | 208.3 ~ 325.5 | 600 ✓ | **13000 拍** = 260 µs(= 639 tXIN) |
| `t17` | 低 | ≥ 10 | ≥ 4.07 | 20 ✓ | **500 拍** = 10 µs(= 24.6) |
| `t18` | 第 2 段高 | 1024 ~ 1800 | 416.7 ~ 732.4 | 1100 ⚠️ | **28500 拍** = 570 µs(= 1401) |
| `t19` | 第 3 段高 | 2048 ~ 2400 | 833.3 ~ 976.6 | 2100 ⚠️ | **45000 拍** = 900 µs(= 2212) |

> 🔴 **2026-10-05 更正**:本表原有一列「本项目建议(100 MHz)」,拍数是表中值的 2 倍。
> 该列**已失去前提**(`clk_axi` 2026-09-29 定为 50 MHz),且与 RTL 实值不符 ⇒ 已改成
> 「RTL 实际值 @50 MHz」,逐项与 `dac_1220.v` 对齐。**驱动 `dac_1220` 的时钟是
> `s_axi_aclk`(= PS FCLK0),不是 `clk_axi` 的什么分频。**

> 表中 `t16`/`t18`/`t19` 的拍数均取**窗口近中点**(639 / 1401 / 2212 tXIN,
> 对应中点 656 / 1412 / 2224),而非厂商例程的贴边值。

**复位在第 3 段高的下降沿触发。** 复位后芯片进入 **Sleep 模式**
(Table 12:`MD` 默认 `10b`)。

> 本项目一律取**窗口中点**,而非厂商的下限贴边值 ——
> 厂商的 `t18=1100`(下限 1024)与 `t19=2100`(下限 2048)余量分别只有 7% 与 2.5%。

> 🔴 **表宽要求**:最大表项 **45000 拍 > 65535?** —— 否,45000 < 65535,当前表宽够用。
> 但**若将来取上限值或提高时钟频率,必须复核**:
> 原按 100 MHz 估的 90000 拍**超过 16 位**,这就是 `LLM-005` 当年的告警来源。
> 保守做法:计数器直接用 `[31:0]`(代价可忽略)。

### 4.1 🔴 这三段是**双向窗口**,不是"不低于"—— 决定了允许的时钟频率(2026-10-05 补)

`t16` / `t18` / `t19` **同时有下界和上界**。低位不到复位不完整,
**高位超上界则复位彻底不触发**。这与 `adc_9833` 的时序**性质不同**
(那边全部只有下界,降频只会变慢不会错)。

于是拍数常数一旦按某个频率折好,**就反过来锁定了允许的时钟频率区间**:

| 段 | 拍数 | 窗口(µs) | ⇒ 允许频率 |
|---|---|---|---|
| `t16` | 13000 | 208.3 ~ 325.5 | 39.9 ~ 62.4 MHz |
| `t18` | 28500 | 416.7 ~ 732.4 | 38.9 ~ 68.4 MHz |
| `t19` | 45000 | 833.3 ~ 976.6 | **46.1 ~ 54.0 MHz** ← 最紧 |
| | | **交集** | **46.1 ~ 54.0 MHz** |

⚠️ **不能靠改常数拓宽**:折成拍数后,两个频率下的合法区间**三段全不重叠** ——

| | @27.78 MHz | @50 MHz |
|---|---|---|
| `t16` | 5786 ~ 9042 | 10415 ~ 16275 |
| `t18` | 11575 ~ 20344 | 20835 ~ 36620 |
| `t19` | 23147 ~ 27128 | 41665 ~ 48830 |

⇒ **不存在一组常数同时覆盖两个频率。**

🔴 **本项目的实际后果(已实测坐实)**:板上 `BOOT.BIN` 把 FCLK0 留在 **27.7778 MHz**,
三段变成 **468 / 1026 / 1620 µs,全部超上界** ⇒ 复位不触发 ⇒ CMR 配置与自校准被忽略
⇒ DIR 写入永不生效 ⇒ 输出停在芯片默认 DIR=0,**而寄存器回读一切正常**。

> 🔴 **2026-10-15 更正「DIR=0 到底是多少伏」**:原写「= **−10 V**」,那是 **DF = 1** 口径。
> 芯片实际跑 **DF = 0**,手册 Table 13 的原话是「**If DF is 1, zero gives 0V;
> if DF is 0, zero gives VREF (mid-scale)**」⇒ **DIR = 0 给的是中位 VREF**
> ⇒ 模块 **0 V**,不是 −10 V。
> 📌 当年量到的恒定 −10 V 仍是真的,但它**不是芯片的上电默认值**,而是
> **DF 被上一次成功写进去的 CMR(旧式 `0x20A1`,DF=1)留在芯片里** ——
> DF 是易失位,只要不复位就一直保持;后来 FCLK0 掉到 27.78 MHz 导致
> 新 CMR 写不进去,**旧值就那样留在里面的**。所以复位图案失效那次的症状是 −10 V。

**处置**:新增寄存器 `0x84 CV_CTRL`,**复位值 0**(-DAC 被按在复位态),
由 `drivers/board.py::release_dac()` 在**实测确认 FCLK0 ∈ [46.1, 54.0] MHz** 之后才写 1。
`main.py` 紧跟 `apply_fclk0()` 调用。详见 `report/source_design_checklist.md` §3「第 4 条硬约束」。

📌 **顺带一条**:放行前写进 `0x14` 的偏压码**不会丢** —— `set_in` 只在 `NORMAL_WAIT` 锁存,
被闸住时那一拍确实被丢掉,但寄存器值留着,放行后从机侧的上电脉冲会拿**当前** code 补发一次。
(九步脚本第 `[8]` 步实测过。)

> 证据:`report/llm-log/LLM-043.md` + `report/measurements/artifacts/20261005_dac_release_test.log`。
> ⚠️ **修复后模块输出端的真实电压尚未用万用表量。**

---

## 五、初始化序列(手册 p13「Startup Sequence」)

手册规定的顺序:① 等晶振起振 → ② 可选地发 reset pattern → ③ 配 CMR → ④ 校准。

**本项目采用(纯写,不读回):**

| # | 动作 | 拍数 @100 MHz | 依据 |
|---|---|---|---|
| 1 | **等待 200 ms** | 10 000 000(@50 MHz)/ 20 000 000(@100 MHz) | 硬性下限是 p13「wait for the oscillator to start—**at least 25ms**」;取 200 ms 是为**一次覆盖** p18 写-only 那节的建议「wait at least **150ms-200ms** after startup」(让 I/O 恢复超时清掉残留半截命令)。只在配置后发生一次,取大无成本 |
| 2 | **SCLK reset pattern** | 见 §四 | Figure 12 |
| 3 | 帧间隔 | ≥ 2048 | `t14` |
| 4 | 命令 `0x24` + 数据 `0x20, 0x80` → **CMR = 0x2080** | — | 20 位 + **偏移二进制补码** + Normal + **bit13=1** |
| 5 | 帧间隔 | ≥ 2048 | `t14` |
| 6 | 命令 `0x05` + 数据 `0x81` → **CMR = 0x2081** | — | **只改 MD** → Self Calibration |
| 7 | **等待 600 ms**(参数化,PS 接上后可改为寄存器可写) | 30 000 000(@50 MHz)/ 60 000 000(@100 MHz) | p13:2.5 MHz 下 **300–500 ms,且"实际时间不确定"**;同页写-only 建议「simply wait at least 500ms」 |
| 8 | 完成 | — | 校准结束后**芯片自动回到 Normal 模式**(p13 原文),**无需再写一次 CMR** |

### CMR = 0x2080 逐位

> 🔴 **2026-10-12:本节原写的 `0x20A0 / 0x20A1` 已改成 `0x2080 / 0x2081`** —— 只动了 bit5 `DF`。
> 依据是板上实测:芯片实际跑在**偏移二进制补码**,而原值把 `DF` 写成 1(直通二进制),
> 与 PS 侧换算、也与芯片上电默认值**都不一致**。详见本节末尾「DF 位更正」。

| 位 | 名称 | 值 | 含义 | 出处 |
|---|---|---|---|---|
| 15 | `ADPT` | 0 | 自适应滤波使能(默认) | Table 13 |
| 14 | `CALPIN` | 0 | **校准期间输出断开**(默认,安全) | Table 13 |
| **13** | 保留 | **1** | **必须写 1**(见下) | Table 13 / p18 |
| 9 | `CRST` | 0 | 不复位校准寄存器 | Table 13 |
| **7** | `RES` | **1** | **20 位分辨率** | Table 13 |
| 6 | `CLR` | 0 | 不清数据寄存器 | Table 13 |
| **5** | `DF` | **0** | **偏移二进制补码**(= 上电默认,见下) | Table 13 |
| 4 | `DISF` | 0 | 快速建立/自适应滤波使能 | Table 13 |
| 3 | `BD` | 0 | 地址递增 | Table 13 |
| 2 | `MSB` | 0 | 数据 MSB 先 | Table 13 |
| 1–0 | `MD` | `00` | **Normal**(`01`=自校准,`10`=Sleep) | Table 13 |

### 与厂商例程的两处差异(均为本项目主动修正)

1. **bit13 必须为 1。** 手册 p18 原文:*"For first revision chips, **always write a '1' to this bit**...
   This does no harm in current revision chips."* 厂商例程写的是 CMR 高字节 `0x00` → bit13 = 0,**不满足手册要求**。
   本项目写 `0x20` → `CMR = 0x2080`。
2. **先配好模式,再进校准。** 手册 Table 13 对 `MD=01b` 明确警告:
   *"**No other bits should be changed** in the Command Register when setting this mode."*
   厂商例程把「20位 + 直通二进制 + 进校准」塞进同一次 CMR 写。本项目拆成步骤 4 / 6 两步规避。

---

### 5.1 RTL 常量总表(直接照抄)

**前提 ①**:模块晶振 **2.4576 MHz** → `tXIN = 406.90 ns`(2026-09-16 查丝印确认)。
**前提 ②**:时钟频率 —— **下表给两列,按当前实现选**。

> ⚠️ **时钟频率是这套常量的强前提,不是背景信息。**
> 当前 PL-only 测试顶层用 **`clk_50m`**(`spi_master` 与 `dac_1220` 同一域);
> 将来搬进 `cv_sys` 时是 **`clk_axi = 100 MHz`**(CLAUDE.md §八),
> **届时右列整体减半,且两个模块一起搬** —— 不要把 `dac_1220` 单独留在别的时钟域,
> 否则 `start`/`busy` 变成跨时钟域信号,需要额外的同步器。

| 常量 | 时间 | **@50 MHz 拍数**(当前) | **@100 MHz 拍数**(`cv_sys`) | 手册依据 | 余量 |
|---|---|---|---|---|---|
| **`SPI_HALF_T`** | 5.12 µs | **256** ✅ 已定 | 512 | `t3`/`t4` ≥ 5 tXIN = 2.035 µs | **+152%**(12.58 tXIN) |
| **字节间隔**(所有字节之间统一用) | 20.48 µs | **1024** | 2048 | `t14` ≥ 41 tXIN = 16.68 µs | **+22.8%**;同时覆盖 `t9`(13)、读向 `t11+t12`(14)、`t13`(6) |
| 上电等待 | 200 ms | **10 000 000** | 20 000 000 | 硬性 ≥ 25 ms(p13)+ 建议 150–200 ms(p18) | — |
| 复位 `t16` | 260 µs | **13000** | 26000 | [512, 800] tXIN = 208~326 µs | 639 tXIN(中点 656) |
| 复位 `t17` | 10 µs | **500** | 1000 | ≥ 10 tXIN = 4.07 µs | 24.6 tXIN |
| 复位 `t18` | 570 µs | **28500** | 57000 | [1024, 1800] tXIN = 417~732 µs | 1401 tXIN(中点 1412) |
| 复位 `t19` | 900 µs | **45000** | 90000 | [2048, 2400] tXIN = 833~977 µs | 2212 tXIN(中点 2224) |
| 校准等待 | 600 ms | **30 000 000** | 60 000 000 | 300–500 ms 不定;建议 ≥ 500 ms | 1.2× 上界 |

**`SPI_HALF_T` 为什么最终取 5.12 µs 而不是贴着下限的 2.04 µs:**
传输时间在整套初始化里只占 ~0.4 ms,而紧随其后的校准一步就要 600 ms ——
**跑快没有任何收益,唯一该考虑的是余量。** 实际时钟频率 97.66 kHz。

### 5.1.1 若改成「CS 分帧」而非「CS 恒低」

本项目按 §一 决定 **CS 全程拉低**,因此 `t10`/`t15` 不适用,只需满足 `t14`。
若将来改用 CS 分帧(手册 Figure 10),约束换成:

| 符号 | 含义 | 下限 | @50 MHz 拍数 |
|---|---|---|---|
| `t10` | CS 下降沿 → 首个 SCLK 上升沿 | 11 tXIN = 4.47 µs | ≥ 224 |
| `t15` | CS 高电平脉冲宽度 | 22 tXIN = 8.95 µs | ≥ 448 |

> ⚠️ 当前 `CS_SETUP = 250` @ 50 MHz = 5 µs,对 `t10` 只有 **+12%** 余量(**偏薄**)。
> 且该参数@100 MHz 会变成 2.5 µs < 4.47 µs —— **不满足**。
> 本项目不用这条路,故不成问题;但如果 AD9833 那一路复用同一个 `spi_master`,
> **要单独核 AD9833 的 FSYNC 建立/保持时间**,不要沿用这里的数。

> ⚠️ **字节间隔的起算点**:手册的 `t14` 定义是「上一条命令**最后一个 SCLK 下降沿** → 下一条命令
> **第一个 SCLK 上升沿**」。FSM 里的「字节完成」标志若落在别的边沿上,实际间隔会与表值不符 ——
> **请在波形上量一次下降沿→上升沿的实际空闲时间**,不要只看代码里的常数。

### 5.2 位宽(最容易埋雷的地方)

| 对象 | 最小位宽 | 依据 | 建议 |
|---|---|---|---|
| **延迟表项** | @50 MHz **25 位** / @100 MHz **26 位** | 最大 `30 000 000`(50 MHz)< 2²⁵ = 33 554 432;`60 000 000`(100 MHz)< 2²⁶ | 直接 `[31:0]`,两个频率都够 |
| **分频计数器** | **8 位** | `$clog2(SPI_HALF_T)` = `$clog2(256)` | **参数化推导**,勿写死 `[3:0]` |
| `state` 寄存器 | **3 位** | 状态数 = 6 | 原写 8 位,可收掉 |

> 🔴 **校准等待被 16 位截断的后果(@50 MHz)**:`30 000 000 mod 65536 = 45824` 拍 ≈ **0.92 ms**。
> **综合、实现、仿真全都不报错,但校准根本没等够** —— 症状只会在上板上表现为"输出不准",
> 极难定位。
> `t19` 的 `45000` 也在 16 位临界附近(勉强放得下,但和 25000 的 `t16` 混在一起编很容易抄错),
> 统一用 `[31:0]` 最省心。

---

## 五补、写 DIR 之后的建立时间(正常工作状态的节奏依据)

> **建立时间不在 §五 的初始化序列里** —— 初始化只关心"命令怎么发得出去",
> 而正常工作状态每写一次 DIR 都要**等输出稳定**才能采 ADC。这个数此前本文档缺失,
> 2026-09-18 补入。

**出处**:手册 DYNAMIC PERFORMANCE 表(p3)

| 条件 | 建立时间 |
|---|---|
| To ±0.012%(**16 位**模式) | 1.8 typ / **2 ms max** |
| **20-bit mode, to ±0.003%** | **15 ms** |

**同表注 (5) 原文**:
> "Valid from AGND + 20mV to AVDD – 20mV. **Outside of this range, settling time can be twice the value indicated.**"

→ **本项目是 20 位模式(`RES=1`)** → 按 **15 ms** 计;落在量程两端 20 mV 以内时按 **30 ms** 计。

**自适滤波会加速,但不可依赖**(手册 p18 原文):
> "...increasing the filter frequency only **while the DAC is changing its output by more than
> approximately 40mV**. When the output has settled, the filter frequency is reduced again."

CMR 里 `ADPT=0` / `DISF=0`(Table 10:`00` = "Fast settling only during > 40mV step")→ 已使能。
**这是器件自主行为,不构成时序保证** —— 参数要按 15 ms 留够。

**RTL 取值(@50 MHz)**:`1500000` 拍 = **30 ms**(吃最坏退化值)。
> 供参考:`cal_delay[6]` 的 600 ms 是 30 000 000 拍。

**扫描预算**:100 点 × (0.43 ms 传输 + 15 ms 建立) ≈ **1.54 s / 次扫描**。
(此前 `docs/project_state.md` R05 写的 "~10 ms/点" 是估算,现可换成有出处的 15 ms。)

---

## 六、两条容易踩的运行约束

| 约束 | 内容 | 出处 | 对本项目的影响 |
|---|---|---|---|
| **I/O 恢复超时** | `fCLK=2.5MHz` 时约 **100 ms**;命令若被中断,SCLK/CS 上 **100 ms 无活动则命令被取消** | p11「I/O Recovery」 | **命令中途任何等待都必须 < 100 ms**。步骤 7 的 600 ms 位于**命令之间**,不受影响 —— 但要确认它不落在帧中间 |
| **写-only 的代价** | 无法通过串口确认校准已完成,**DAC 进入开环** | p18「Write-Only Interfacing」 | 校准效果最终由 PS 侧读 ADC 实测输出电压**间接确认**;手册同页建议 write-only 时上电可多等 150–200 ms |

---

## 七、厂商例程自身的两处缺陷(参考时勿照抄)

| # | 位置 | 问题 | 依据 |
|---|---|---|---|
| 1 | `DAC1220_Write_Byte()` 之间的 `delay_us(10)` | 10 µs **低于 `t14` 的 16.68 µs 下限** | Table 4,p10 |
| 2 | `DAC1220_Read_Byte()` 在 SCLK 上升沿即刻采样 | 违反手册「从机在上升沿更新输出」,采样点落在数据翻转窗口内 | p9 正文 + Table 3 `t8` |

> 例程能跑通,说明它落在**容差内**(或 `delay_us` 实际偏长)。**但这不能作为 RTL 的取值依据。**

---

## 八、未核实项(上板前需确认)

| # | 事项 | 为什么重要 |
|---|---|---|
| ~~U1~~ | ✅ **已解除(2026-09-16)**:模块晶振 **2.4576 MHz**(用户查看丝印确认) | §四/§五 全部窗口按 `tXIN = 406.90 ns` 折算的前提成立 |
| U2 | 🔴🔴 **2026-10-12 作废**(留档不删)。那三点读数实为 **`DF = 1` 状态**下取的,与今天(`DF = 0`)矛盾,对照表见 §八补末。原文:🟢 **已证实(2026-09-19 板上实测)**:模块层为 **双极性 ±10 V 量程**。用户用万用表量 **`0x40000`/`0x80000`/`0xC0000`** → **−5 V / 0 V / +5 V**,与 ±10 V 双极性映射**完全对上**。⚠️ **仍未测**:两端点 `0x00000`/`0xFFFFF`(轨附近可能被钳位),故"**满量程恰好是 ±10.00 V**"仍属未证实,只能确认**这三点**落在 ±10 V 线性区间内。⚠️ 证据形式是**用户实测口述,无读数截图** | 芯片本体是 **单极性 `0 ~ 2×VREF`**(Table 8/9,p14);厂商例程里的 **±10 V** 来自模块模拟级 —— **资料包内无模块原理图,无法断言**。**2026-09-18 补充**:厂商例程 `DAC1220VolWrite()` 里 `mapfloat(v, -10.0, 10.0, 0, 1048575)`,是 **±10 V 双极性映射**的**代码级证据**(仍非原理图证据) |
| U3 | 🔴🔴 **2026-10-12 作废**(留档不删)—— 同一批读数,见 §八补。原文:🟢 **已证实(2026-09-19 板上实测)**:`code → 输出电压` 的**模块层**传递关系确为 `V = −10 + 20 × code / 1048575`,三点实测(−5/0/+5 V)与预期一致且单调;实测**字节序** `40 40 00 00`/`40 80 00 00`/`40 C0 00 00` 也**反向确认了 DIR 的 left-justified 位切片实现正确**(见 `report/llm-log/LLM-010.md`)。⚠️ **芯片层 `VOUT = 2×VREF×code/2^20` 未单独实测** —— 但模块层式子与它**同时成立才自洽**,且本项目只用模块层输出 | 决定 PS 侧 Vds 扫描时如何反算码值。见下方 §八补 |
| U4 | **模块 CS/SDIO/SCLK 与 FPGA 引脚的对接方式** | 影响顶层 XDC 与是否需要 IOBUF(本项目纯写,**不需要 IOBUF**) |

### 八补.码值 ↔ 输出电压(2026-09-18 立 / **2026-10-12 实测推翻重写**)

> 🔴 **本节原文写「芯片层用直通二进制、`code = 0` 对应 0 V」,并据此推出
> `V = −10 + 20×code/1048575`。2026-10-12 板上实测证明芯片跑的是
> 偏移二进制补码,原文整体偏了半个量程。本节按实测重写。**

**决定格式的是 CMR 的 `DF` 位(Table 13):`0` = 偏移二进制补码(上电默认),`1` = 直通二进制。**
本项目固定 `DF = 0`,于是:

| 层 | 传递关系(`DF = 0`) | `code = 0x80000` 对应 | 出处 |
|---|---|---|---|
| **芯片层**(DAC1220 本体) | `VOUT = 2×VREF × ((code − 0x80000) mod 2^20) / 2^20` | 芯片 VOUT = **0 V** | Table 8 / Table 9(**补码行**) |
| **模块层**(康威模块模拟级) | `V_module = −10 + 20 × ((code − 0x80000) mod 2^20) / 1048575` | **−10 V** | 下表实测 |

> ⚠️ **`DF = 1` 时同一个码含义完全不同**:`0x80000` 在直通二进制下是
> **芯片 2.5 V → 模块 0 V**。两种格式**正好差半个量程**,在 `code ≥ 0x80000`
> 的整个正半轴上**无法区分**,只有 `code < 0x80000` 能分开 ——
> 2026-10-12 就是靠 `0x7FFFF` 这一点把两者分开的。

**2026-10-12 实测(模块级万用表,`DF = 0` 且软件侧已对齐):**

| 码(hex) | frac = ((code−0x80000) mod 2²⁰)/1048575 | **实测** | 补码模型 | 直通模型 |
|---|---|---|---|---|
| `0x7FFFF` | 1.000 | **+9.72 V** | +10.00 ✓ | **0.0 ✗** |
| `0x26666` | 0.650 | **+2.80 V** | +3.00 ✓ | −3.0 ✗ |
| `0x0CCCC` | 0.550 | **+0.820 V** | +0.82 ✓ | −5.0 ✗ |
| `0x80000` | 0.000 | **−10.0 V** | −10.00 ✓ | 0.0 ✗ |
| `0x99999` | 0.100 | **−8.0 V** | −8.00 ✓ | −2.0 ✗ |
| `0xA6666` | 0.150 | **−7.0 V** | −7.00 ✓ | −1.0 ✗ |

⇒ **六点全部落在补码模型上,直通模型一点不中。**

**六点拟合出的实际特性(不是理想式):**

```
V_module = 19.777 × frac − 10.057        (frac 定义同上)
```

跨度 **19.777 V**(设计 20.000,即 **−1.12%**),零点 **−0.057 V**。
三个带两位小数的点残差 **≤ 0.003 V**。

> ⚠️ **这 ~1.1% 不是 DAC 的。** 手册 p4:DAC 的 gain error 是 **±150 ppm(0.015%)**、
> 双极性零点误差 **±15 ppm** —— 实测偏差是它的 **75 倍**。而且 **DAC1220 没有内部基准**:
> `VREF` 是**输入脚**(手册 p7 接法图:"+2.5V from Voltage Reference"),而 ±150 ppm 的前提
> 写死了「VREF = +2.5V」。⇒ **这 1.1% 出在板上外部 2.5 V 基准或模块增益级的电阻容差上。**
>
> 🟡 **未结案**:自校准(`MD = 01`)到底执行过没有 —— 若 CMR 从未写进芯片,则自校准
> 也从未跑过,芯片一直处于未校准状态,这也可能是这 1.1% 的一部分来源。需仿真的波形证据定论。

**关于 2026-09-19 那次「−5 / 0 / +5 V」实测 —— 已作废:**

| 码 | 那次记录 | 直通二进制应给 | 补码应给 |
|---|---|---|---|
| `0x40000` | **−5 V** | −5 V ✓ | +4.78 V ✗ |
| `0x80000` | **0 V** | 0 V ✓ | −10.06 V ✗ |
| `0xC0000` | **+5 V** | +5 V ✓ | −5.11 V ✗ |

**三点精确落在直通二进制上** ⇒ **那天芯片是 `DF = 1`,今天是 `DF = 0`。**
CMR 易失(芯片无复位脚,配置靠上电后由 RTL 写入),而这次 CMR 写**跨上电不一致**
⇒ 偏压映射**每次上电可能不同**。这正是必须把 RTL 的 `DF` 位改成 0 的理由:
改完之后**无论 CMR 写没写进芯片,`DF` 都是 0**,行为确定。
(仅靠 PS 侧旋转 `0x80000` 治不好 —— 哪次上电 CMR 又写进去了,软件就反着错。)

⚠️ **证据形式**:用户万用表实测**口述**,**无读数截图/数值原文**。定稿报告引用时须写明来源。

```text
剩余待补:写 code = 0x00000 / 0xFFFFF,看是否仍为 −10 V / +10 V
→ 若两端被钳位(如只有 −9.2 V / +9.2 V),则须用实际端点重新拟合 code = (V − b)/a
```

---

## 九、上板测试判据

**协议层(ILA 抓 `sclk` / `sdio` / `cs`)**

- [ ] `cs` 全程为低
- [ ] reset pattern 三段高电平宽度落在 Table 5 窗口内
- [ ] 每个字节 **8 个 SCLK 沿**,`f_SCLK ≈ 195 kHz`
- [ ] SDIO 相对**下降沿**稳定(建立 ≥ 40 ns / 保持 ≥ 20 ns)
- [ ] 字节间距 ≥ 18 µs

**电压层(万用表 / ADC)**

- [x] ✅ **2026-09-19 已完成(三点)**:`0x40000` / `0x80000` / `0xC0000`
      → **−5 V / 0 V / +5 V**,**单调递增、等间距** ⇒ 模块层双极性 ±10 V 量程成立
- [ ] ⏭ **端点补测**:`0x00000` / `0xFFFFF` → 预期 −10 V / +10 V,
      **若被输出轨钳位则须改用实际端点重新拟合**(见 §八补)

> ⚠️ **首轮上板不要接高压级**,先量裸模块输出。

---

*建立:2026-09-16 · 依据 TI SBAS082G + 厂商例程 · 未验证项见 §八*
