dsgmxc/2026_fpga_qrs/llm-log/LLM-066.md

# LLM-066: DAC 上电默认电压追查,查实 `0x14` 复位值在 DF=0 下是 **−100 V**(安全项),已改并重综合

- **日期**: 2026-10-15
- **模型**: Claude(DeepSeek-V4-Flash 会话)
- **任务**: 用户问「**dac上电后默认电压是多少,我发现dac一直输出5v**」→
  查实后用户给指令:「**把pl端默认值给改了重新编译**」

## 提示词

```
dac上电后默认电压是多少，我发现dac一直输出5v
```
```
把pl端默认值给改了重新编译
```

## 模型回答

### 一、先回答「上电默认是多少」—— 分三层,别混

**① 芯片层(有手册出处)**:0 V。

| 出处(`dac1220.pdf`,SBAS082G) | 事实 |
|---|---|
| Table 13,bit 5 `DF` | `0` = Offset two's complement(**default**) |
| Table 13,bit 9 `CRST` 说明 | 「**If DF is 1, zero gives 0V; if DF is 0, zero gives VREF (mid-scale)**」 |
| p17 正文 | 「**After reset, the DIR contains zero.**」 |
| Table 9(20 位补码行) | `0x00000` → 芯片 **2.5 V**;`0x80000` → 芯片 **0 V** |

⇒ DIR 复位 = 0、DF 默认 = 0 ⇒ 芯片出 **中位 VREF = 2.5 V** ⇒ 模块层(−10…+10 V)
⇒ **模块 0 V / 栅极 0 V**。**芯片自己的上电态本来就是 0 V。**

**② 板上实际(改之前)**:🔴 **−100 V**。见下节,这是本轮的真发现。

**③ 用户量到的 +5 V**:不属于上面任何一种 ⇒ 待定位(见 §五)。

### 二、🔴 真发现:`cv_axi_lite_slave.v:514` 的复位值在 DF=0 下是 −10 V

```verilog
bias_code <= 32'h0008_0000;     // 中位码 = 0 V 偏压   ← 旧值
```

它上面那段注释的依据是**旧的 DF=1 传递式** `V_module = −10 + 20 × code/1048575`。
而 `dac_1220.v` 的 CMR 已于 **2026-10-12 由 `0x20A1`(DF=1) 改成 `0x2081`(DF=0)**,
⇒ **同一个码翻到了量程的另一端**:

| 码 | DF=1(注释的依据) | **DF=0(现用,已实测)** |
|---|---|---|
| `0x00000` | −10 V | **0 V** ← 现在 0 V 在这里 |
| `0x80000` | **0 V** ← 复位值想取的就是它 | **−10 V** ⇒ 栅极 **−100 V** |
| `0x7FFFF` | +10 V | +10 V |

**危险点**:那段注释自己的设计意图写着「上电停在 0 V 是无条件安全的中点」,
而 DF=0 之后它落在 **`Vgs` 绝对值最大的那一端**。若上电时 DUT 已接上,是真风险。

**消费时机**:该复位值只经「上电自动发一次 `bias_set`」下发,而该脉冲**门控在 `dac_init_done`**,
所以它恰好在 DAC 初始化跑完(含 CMR=0x2081 那次写)之后才被消费 ——
**即被消费时 DF=0 是确定的**,这正是该换成 `0x00000` 的理由(不成立的只有注释的算术)。

### 三、修复(用户指令)

| 位置 | 改动 |
|---|---|
| `qrs.srcs/sources_1/new/cv_axi_lite_slave.v:514` | `32'h0008_0000` → **`32'h0000_0000`** |
| 同处注释段(497–513) | 整段重写为 DF=0 口径:补上实测传递式、两个码各对应多少伏、**并把「由 DF=1 改来」这件事记在注释里**(不删旧结论,写明它错在哪) |
| `docs/dac1220_interface.md:237` | 「DIR=0 = **−10 V**」→ 更正为 0 V,并**解释当年量到恒定 −10 V 的真因**(DF 是**易失位**,是上一次成功写进去的旧 CMR `0x20A1` 留在芯片里,不是芯片默认) |
| `report/source_design_checklist.md:417` | `0x14` 行的旧传递式**标作废**,换成 DF=0 的实测式 + 新复位值 |
| `docs/dev_handbook.md:183` | `0x80000` = 0 V → **复位值 `0x00000` = 0 V** |

后四处是按本项目既有纪律做的:🔴 **同一句假话印在多处,改一处不改另一处 = 留下自相矛盾的证据。**
(交付仓库镜像 `qrs_fpga_2026/src/rtl/cv_axi_lite_slave.v` 同步,两边 md5 一致。)

### 四、重新综合(用户指令「重新编译」)

用**交付仓库里既有的** `build/build_bitstream.tcl`(它 `source` `build/report_summary.tcl`
出 `build/summary.txt`);脚本每次 `reset_run` 重跑,**不复用旧结果** ——
本工程踩过一次「mtime 落在未来 ⇒ 工具静默跳过重建」。

```
export PATH=$HOME/xilinx/2025.2/Vivado/bin:$PATH
QRS_PROJ_DIR=$HOME/Desktop/fpga_pro/qrs \
QRS_OUT_DIR=$HOME/Desktop/qrs_fpga_2026/build \
vivado -mode batch -notrace -source build/build_bitstream.tcl \
    -log build/vivado_build.log -journal build/vivado_build.jou
```

⚠️ **这一条是纠错后重做的** —— 见下方纠错轨迹第 4 条:本轮**第一遍**综合是我自己
新写了一个 `build/run_impl.tcl` 跑出来的,那个脚本**是重复造轮子**(交付仓库里
`build_bitstream.tcl` 早就在,且 LLM-062 里就引用过它)。已删掉重复件、用既有脚本重跑一遍。

| 项 | 值 |
|---|---|
| 位流 | `qrs.runs/impl_1/system_wrapper.bit` |
| **位流 md5** | **`c92c7ed5b7d695dee73d86abc1c6089c`**(旧 `232c649d0cc143c12c87f17365f6ddd3`)<br>⚠️ 第一遍(重复件脚本)产出的是 `98318ad0…`,**已弃用并删除**,见纠错④ |
| WNS / TNS / 失败端点 | **+0.316 ns** / 0.000 / **0 / 5472** |
| WHS / THS / 失败端点 | **+0.065 ns** / 0.000 / **0 / 5472** |
| WPWS / TPWS / 失败端点 | 3.346 ns / 0.000 / 0 / 2047 |
| LUT / FF | **1790(3.36%)** / **2022(1.90%)** |
| BRAM Tile / DSP | **7.5(5.36%)** / **0** |
| IOB | **67(53.60%)** ← 仍是真瓶颈 |
| DRC ERROR | **0** |
| `.hwh` | **未变**(BD 没动)⇒ `6c376905b48aa8d79778f0d4b21f0bbc` |

已同步 `qrs_fpga_2026/board/qrs.bit`(改名对齐 `config.OVERLAY_BIT`),两边 md5 已回读一致。

### 五、⏳ 仍未结案:用户量到的 **+5 V** 不属于任何一种"默认"

DF=0 下 +5 V 对应的码:

| 表笔接在 | +5 V 意味着 | 对应 `0x14` | 界面「偏压」应显示 |
|---|---|---|---|
| 模块输出端 | 模块 +5 V | `0x42E86` | +50.00 V |
| 栅极(×10 之后) | 模块 +0.500 V | `0x08A3F` | +5.00 V |
| 芯片 VOUT 引脚 | 芯片满量程 2×VREF | `0x7FFFF` | +100.00 V |

⇒ **需要用户回答两件事**(我当不了仪表):量的是**哪两点**;
这个 5 V 是**恒定的**还是**只在上电后一小段时间**。
以及一组三行判据(① 起界面前读 `0x14` 应 = `0x00080000`;② 模块端应量到 −10 V;
③ 起界面后应变 0)。⚠️ **注意①那条判据的预期值已随本次修复改变** ——
下个上电周期读到的应是 **`0x00000000`**。

## 结果

☑ ⚠️ 部分可用

| 项 | 判定 |
|---|---|
| **① 上电默认电压(芯片层)** | ✅ **有手册出处**,0 V |
| **② 板上复位值错在 DF=0 口径** | ✅ **查实**,`0x80000` 在 DF=0 下是 −10 V(有 2026-10-12 六点实测支撑) |
| **③ 修复 + 重综合** | ✅ **完成**(新位流 `98318ad8…`,时序全过,DRC 0 Error) |
| **④ 上板验证** | ⛔ **未做** —— 板子关着(用户此前令 `shutdown -h now`) |
| **⑤ 用户量到的 +5 V** | 🔴 **未定位**,需要用户两个回答 |

## 验证方式

| 项 | 具体 |
|---|---|
| **寄存器映射的出处** | TI `dac1220.pdf`(SBAS082G)Table 8 / Table 9(p14)、Table 13(DF 默认)、p17(DIR 复位=0)、bit9 CRST 说明(**"If DF is 1, zero gives 0V; if DF is 0, zero gives VREF (mid-scale)"**——这一句直接定死了本题) |
| **"旧值在 DF=0 下是 −10 V"** | 不是推导:**2026-10-12 板上六点实测**里 `0x80000 → −10.0 V` 那一点逐字命中(`docs/dac1220_interface.md` §八补) |
| **新位流确实是新的** | md5 `c92c7ed5b7d695dee73d86abc1c6089c` ≠ 旧 `232c649d0cc143c12c87f17365f6ddd3`;`board/qrs.bit` 与工程 `qrs.runs/impl_1/system_wrapper.bit` **回读一致**;`.hwh` 未变(`6c376905…`) |
| **"源没变,P&R 不逐比特可复现"** | **本轮实测复现**:同源、只换驱动脚本,位流 md5 由 `98318ad0…` 变 `c92c7ed5…`,而报出的时序/资源数**一字未变**(WNS +0.316 / LUT 1790 / FF 2022 / BRAM 7.5 / IOB 67) |
| **时间/资源 M3 素材** | `build/summary.txt`(由 `build/report_summary.tcl` 生成)+ `build/system_wrapper_{timing_summary,utilization,drc}_*.rpt`(实现流程自动落盘,从 `qrs.runs/impl_1/` 取) |
| **⛔ 未覆盖** | 上板后的**实际电压**未量(板子关着);`+5 V` 成因未定 |

## 纠错轨迹

1. **我先按旧注释的口径给出了"上电默认 −10 V"的说法(说在"板子实际"那一层) ——
   方向对、数字错。** 真正的板子默认(改前)是 **−10 V 是模块端没错**,但我一开始
   还把它当成"设计有意为之的安全值",直到读到手写注释里那句
   「上电停在 0 V 是无条件安全的中点」才发现**它自己都不认为自己会出 −10 V**。
   ⇒ **注释里写着的"意图"和它当前"实际"打架时,后者才是要报的那个。**
2. **差点把 `qrs.v` 的硬编码 `20'hC0000` 当成"一直输出 5 V"的元凶。**
   `20'hC0000` 在 **DF=1** 下正好是 **+5 V**(与 2026-09-19 那次实测一致),看着极像真凶。
   **靠 `.hwh` 否掉的**:交付与构建两边的 `system.hwh` 里 `MODTYPE` 只有
   `cv_sys / proc_sys_reset / processing_system7 / smartconnect` ——
   **`qrs.v` 不是部署顶层**(它是 P1 时代的独立顶层,恰好在同一个目录里)。
   📌 教训与既有 memory 一致:**"看着最像"的线索要先证伪掉再往下报**。
3. **用错了传递式的年代,差点把 2026-09-19 的旧读数当今天的证据。**
   `project_state.md:791` 那句「`0x086666` = 模块 +0.500 V ×10 = +5.00 V」是
   **DF=1 时代**的;在 DF=0 下同一个 `0x086666` 是 **−9.56 V**。
   ⇒ 本项目**凡引用 2026-10-12 之前的码↔电压读数,必须先确认它属于哪个 DF**。
4. **★ 我重复造了一个本来就存在的构建脚本 —— 而且是在"交付仓库"这一层。**
   我断定「工程里原先没有综合脚本」(依据是上一次构建用的是 `/tmp/q_pull.tcl`,
   而 `/tmp` 跨重启会丢 —— memory 里已有这条,判断本身没错),
   **但我只在工作区 `~/Desktop/qrs_2026_fpga/` 里找了一遍就下了结论**,
   于是新写了 `build/run_impl.tcl` 并跑出位流。
   事后核对交付仓库才发现:**`build/build_bitstream.tcl` 早就在**,
   它 `source` 的 `build/report_summary.tcl` 产出 `build/summary.txt` ——
   正是 LLM-062 里引用过的那个「时序出处」。功能与我的重复件**完全等价**。
   ⇒ **已删掉重复件、用既有脚本把整条链重跑了一遍。**
   📌 教训与既有 memory 同款(**"别说'不存在',除非穷尽搜索"**):**这个项目有两棵树,
   `src/` `build/` `sim/` 是对称的** —— 在**一棵树里**找不到某东西,
   **不等于另一棵树里也没有**。判断"没有某个脚本"之前必须**两棵树都查**。

## 沉淀

→ `skill/`:可复用形态 **「量程旋转半格」** —— 当芯片的**数据格式位**(DF/极性/offset
binary)变更时,**所有以"码"为单位的既有常数(复位值、默认值、查找表、软件映射)
必须逐个复算**;同一个十六进制数在新格式下可能恰好是"另一个极端"。
判据:**格式变更的 commit 里必须列出"所有含码常数的位置",而不是只改那个"看起来相关"的。**
本项目这次就是:PS 侧映射当天改了,PL 侧复位值**漏了三天**。

→ `build/build_bitstream.tcl` 本身:可复用的是**「不复用旧 run」**这一条 ——
`reset_run` 每次都重来,代价是几分钟,换掉的是"工具静默跳过重建"这类
**无提示失败**。

## 归属说明(与 M11 有关)

- **问题是用户提出的**(「dac上电后默认电压是多少,我发现dac一直输出5v」),
  **修复指令也是用户给的**(「把pl端默认值给改了重新编译」)。
- 手册查证、代码定位、修复、综合、文档四处更正由 Claude 完成;
  **上板后量电压仍必须由用户持表**。
- ⭐ **本轮最有价值的是纠错 2**:`20'hC0000` 这条线索在 DF=1 下**精确等于 +5 V**,
  而且它在**同一目录**里,几乎就是答案 —— **是 `.hwh` 的 `MODTYPE` 列表把它否掉的**。
  如果只靠"读起来很像",这次会把一个 P1 时代的退役文件写成根因。
