dsgmxc/2026_fpga_qrs/llm-log/LLM-067.md

# LLM-067: 上板核验复位值(`0x14 = 0x00000` ✅)+ **「PL 空着没有」的判据我自己也是错的** + Python 侧第三处 DF=1 + **恒定 5 V 未结案**

- **日期**: 2026-10-15
- **模型**: Claude(DeepSeek-V4-Flash 会话)
- **任务**: 用户上电后说「**上电了,尝试设置一个电压测试**」,并在岔路口选了
  **「Python 先验复位值 + 设电压」** —— 即:先加载位流、**在软件写任何东西之前**读一次
  `0x14` 的复位值(验证第 61 次那次修复),再放行 DAC 并给出一个电压让用户拿万用表量。
  中途用户问「**你能读到芯片的寄存器值吗,现在还是5v感觉硬件有问题**」→ 指令
  「**应该是dac坏了,先关系统吧**」;末了回答我追问的"读数动过没有" = 「**恒5v**」。

## 提示词

```
上电了，尝试设置一个电压测试
```
```
现在什么情况
```
```
你能读到芯片的寄存器值吗，现在还是5v感觉硬件有问题
```
```
应该是dac坏了，先关系统吧
```
```
恒5v
```

## 模型回答

### 一、把上次的修复放到板上验 —— 过了

`0x14` 的复位值(第 61 次由 `32'h0008_0000` 改成 `32'h0000_0000`)这一次是**读出来的**,
不是推出来的。位流加载后、`apply_fclk0()` 与 `release_dac()` **之前**的快照:

| 寄存器 | 复位值 | 判读 |
|---|---|---|
| **`BIAS_CODE` (0x14)** | **`0x00000000`** | ✅ **期望值** —— DF=0 下正是模块 0 V / 栅极 0 V |
| `VERSION` (0x48) | `0x00010000` | RTL 版本 1.0 |
| `SCRATCH` (0x4C) | `0x00000000` | —— |
| `STATUS` (0x04) | `0x00000000` | 无 err / 无 fault |
| `RANGE_SEL` (0x18) | `0x00000002` | B 挡(100 Ω)—— 与硬件复位挡位一致 |
| `RELAY_CFG` (0x1C) | `0x00000010` | `ALL_OFF`(安全态) |
| `SETTLE_CFG` (0x24) | `0x002805DC` | 稳定窗 0x5DC = 1500 |
| `CV_CTRL` (0x84) | `0x00000000` → **`0x00000001`** | 放行前 DAC 按在复位态,放行后抬起 |

⇒ **旧位流 `0x80000`(栅极 −100 V)没有出现** —— 说明板上/仓库里那份确是新位流。

`apply_fclk0()` 实测 **50.0000 MHz**(IO PLL 1000 / DIV0 20 / DIV1 1,窗口 [40.8, 67.2] 内)。

### 二、回答「能不能读芯片的寄存器」—— 不能,而且原因在 RTL 里

| 问 | 答 |
|---|---|
| FPGA 侧寄存器(`0x14`/`0x1C`/`0x90`…) | ✅ **能** 读,寄存器映射表在 `report/source_design_checklist.md` §3 |
| **DAC1220 芯片内部寄存器**(DIR / CMR / 校准状态) | ⛔ **不能** —— `dac_1220.v` 例化 `spi_master` 时把 `miso(1'd0)` 接了常数、`rx_data()` 悬空 |

⇒ **`docs/dac1220_interface.md` 里挂着的两项「未结案」(CMR 那次写落没落进芯片、
自校准跑没跑起来),用现在这个位流永远结不了案。** 要结案只有两条路:
(1) 改 RTL 把 MISO 接回 `spi_master.rx_data` + 实现读命令(要新位流);
(2) 上示波器/逻辑分析仪抓 SCLK/SDIO(板上 `/opt/sigrok/bin` 在 PATH 里)。

### 三、新增两个工具,把「改电压」的代价从"一次位流"降到"零"

以前改一次偏压就要重载一次位流,而**一次上电只允许一次 `Overlay()`** ——
等于一个上电周期只能试一个电压。现在拆成两件:

| | `tools/bias_set.py` | `tools/bias_mmap.py` |
|---|---|---|
| 位流 | **加载一次**(`Overlay()`) | ⛔ **一次都不加载**(裸 mmap) |
| 何时能跑 | 上电后、PL 还空着的时候 | 位流已配好之后,想跑几次跑几次 |
| 干什么 | 读复位值 / 配 FCLK0 / 放行 DAC `0x84[0]` | 改 `0x14`、回读 |

`bias_mmap.py` 开头自己查 devcfg 判断"本周期加载过位流没有",PL 空着就**拒绝运行** ——
因为空 PL 上读 `0x43C00000` 会把 CPU 挂在 AXI 上(2026-10-02 踩过)。

### 四、走了一遍扫描,数字侧全对,但表针不动

| 步 | 写 `0x14` | 期望模块输出 | 回读 |
|---|---|---|---|
| 1 | `0x00000` | +0.000 V | ✅ |
| 2 | `0x26666` | +3.000 V | ✅ |
| 3 | `0x00000` | +0.000 V | ✅ |
| 4 | `0xD9999` | −3.000 V | ✅ |
| 5 | `0x00000` | +0.000 V | ✅ |

写入/回读**逐点一致**,`0x26666` 正是 2026-10-12 量到 **+2.80 V** 的那个码
(同一块板、同一根线、同一个码)。用户读数:**恒 5 V,全程没动过。**

> ⚠️ 同一天、同一个码、同一块板:2026-10-12 是 **+2.80 V**,2026-10-15 是 **5 V 不动**。
> **这不像"公式错了",像"链子断了"。** 数字侧已解释不了 +5 V:DF=0 下模块满量程
> 是 −10…+10 V,码 `0x00000` 对应 0 V,而 +5 V 只在码 `0x40000` 附近,寄存器里**没有**这个值。

### 五、用户怀疑硬件,我同意「先停」,但三种可能一条都还没排除

| # | 可能 | 怎么分辨 |
|---|---|---|
| 1 | DAC 芯片/模块坏了 | 换模块试;或量模块的基准脚 |
| 2 | SPI 接线动过(SDIO/SCLK/CS 松) | 目视 + 逻辑分析仪抓 SDIO |
| 3 | 模块模拟级坏了(±10 V 放大器 / 它的供电 / 2.5 V 基准) | **量基准脚:若基准脚本身就是 5 V ⇒ 故障在模拟级,不在 DAC** |

⇒ 下一个上电周期的**第一步不是加载位流,是拿表量三个点**:
**基准脚(期望 ≈2.5 V)/ 供电脚 / 输出脚**。

### 六、顺手查出来的仓库漂移(未修)

| 文件 | 工程(Vivado,产位流) | 工作区 / 交付仓库 |
|---|---|---|
| `dac_1220.v` 的 CMR | `0x2080` / `0x2081`(**DF=0** ✅) | `0x20A0` / `0x20A1`(**DF=1** ❌ 陈旧) |
| `swm.v` | —— | 两份不一致 |
| `src/rtl/` 模块数 | 18 个 | **4 个** —— 其余 14 个只在工程里(M1「完整工程文件与源码」的缺口) |

## 结果

⚠️ 部分可用 —— **复位值核验这一条是干净的通过**(且有板上读数),
但**恒定 5 V 的根因一条都没排除**;而我这一轮自己犯的两个错(下详)都属于
"结论听起来像事实、其实没实测"。

## 验证方式

- **复位值**:板上 `/home/xilinx/cv` 跑 `sudo -E … python3 tools/bias_set.py`,
  快照印在终端;期望值来自第 61 次的 RTL 改动 + `cv_regs.BIAS_CODE_ZERO`。
- **判据校准**:同一块板,`Overlay()` **前**读 devcfg(空 PL)
  vs **后**读(已配置)各一次,四个位逐一对照(下表)。
- **写通路**:5 个码写入后逐点回读,全部一致。
- **输出**:用户持万用表读数(=「恒 5 V」)。⚠️ **口头判读,无逐点表值** ——
  只能写"不随码变化",**不能写任何误差百分数**(同 `LLM-043` ⑭⑮ 的口径纪律)。

## 纠错轨迹

1. 🔴 **★ 我第一版 `tools/pl_state.py` 读的寄存器根本不存在。**
   我读了 `PCAP_STATUS(0xF80070C4)` 的 bit0。那个偏移**不是 devcfg 的寄存器**,
   所以它恒读 0 —— 而我在一块**已配置**的 PL 上跑,得到的结论是「⛔ PL 是空的」,差点让用户白等一个上电周期。
   **怎么发现的**:结论与"刚才明明 `Overlay()` 过"自相矛盾,回去查
   `<Vivado>/data/embeddedsw/.../devcfg_v3_9/src/xdevcfg_hw.h`,发现 `STATUS` 在 `0x14`。

2. 🔴 **★ 更隐蔽的一个:我的"判据"也是背来的,不是实测的。**
   改读 `STATUS(0x14)` 之后我用了 `CFG_RESET_B == 0 and GPWRDWN_B == 0` 当"已配置"。
   **实测:这两个位在加载位流前后都读 1,根本不区分。**
   ⇒ 判据改成**在同一块板上、加载前后各读一次**校准出来的 `bit10 PSS_FST_CFG_B`:

   | 位 | 空 PL | 已配置 PL | 结论 |
   |---|---|---|---|
   | 5 `PSS_CFG_RESET_B` | 1 | 1 | **不区分** |
   | 9 `PSS_GPWRDWN_B` | 1 | 1 | **不区分** |
   | **10 `PSS_FST_CFG_B`** | **0** | **1** | ★ **区分** |
   | `STATUS` 整字 | `0x40000A30` | `0x50000F30` | —— |

   ⚠️ **只测了"加载后"那一列**:空 PL 时**我没读 `INT_STS`**,所以
   `INT_STS` bit2(`PCFG_DONE`)只是"加载后为 1",**不算已验证的判据** ——
   文件头已如实标注,不当结论用。

3. 🔴 **板上既有的 `tools/step1_plstate.py`(我 2026-10-03 写的)是错的,且是"永远说已配置"。**
   它把 `STATUS` **bit5** 标成 `PCFG_DONE`。厂商头文件原文是
   `XDCFG_STATUS_PSS_CFG_RESET_B`;真正的 `PCFG_DONE` 在 **`INT_STS(0x0C)` bit2**
   (`XDCFG_IXR_PCFG_DONE_MASK = 0x04`)。
   ⇒ 空 PL 的 bit5 也是 1 ⇒ **它在空 PL 上也会回「已配置 ✅」**,
   即这个"安全探针"在最危险的那种场合失效。**已在 `pl_state.py` 里就地更正并注释留痕**。

4. 🔴 **Python 侧还有第三处 DF=1 —— `cv_regs.py`。**
   第 61 次修的是 RTL 复位值(那是我找到的第二处),第一处是 `dac_1220.v` 的 CMR。
   这次上板前自查才发现 **`bias_volts_to_code(0.0)` 会算出 `0x80000`** ——
   在 DF=0 下那是 **−100 V**。**"要 0 V,给 −100 V"** 是同一个 bug 的第三个落点:
   一个 DF 位,三处独立代码各自记着旧公式。已重写(含 `BIAS_CODE_ROT`、
   `BIAS_CODE_ZERO`),主机端五点自检通过。
   ⇒ 📌 **教训:改一个"语义位"必须全仓搜公式,搜的是"所有算这个物理量地方",不是"我想到的那处"。**

5. 🔴 **★ 我在板上又建了一棵重复的树(第 4 次同型错误)。**
   我把 `src/python` 打包推到 `/home/xilinx/qrs_py`,而板上 **`/home/xilinx/cv` 早就有
   一份逐字节相同的完整 Python 树**(那才是 `qrs-ui.service` 的 `WorkingDirectory`)。
   **怎么发现的**:推之前在板上 `ls`,发现有 `/home/xilinx/cv`。
   已删掉重复件,把新文件直接放进 `/home/xilinx/cv/`。
   ⇒ 现在**一共三棵树**:工作区 / 交付仓库 / 板上 `/home/xilinx/cv`。
   同型错误的前三次见 [[no-all-negative-from-shallow-search]]。

6. ⚠️ **解释器 + 环境变量,我自己先失败了两轮才跑通。**
   `sudo -E python3 tools/bias_set.py` → `ModuleNotFoundError: No module named 'pynq'`;
   换对了 `/usr/local/share/pynq-venv/bin/python3` 之后 → `RuntimeError: No Devices Found / is the XRT environment sourced?`。
   正解(与 `qrs-ui.service` 的单元文件逐字一致):
   `cd /home/xilinx/cv && echo xilinx | sudo -S -p "" -E env XILINX_XRT=/usr /usr/local/share/pynq-venv/bin/python3 …`
   ⇒ 板上 Python 有**三件套前提**:cwd(`/home/xilinx/cv`)、解释器(venv)、`XILINX_XRT`。

7. ⚠️ **一个"看起来是证据、其实不是"的东西**:`/sys/class/fpga_manager/fpga0/state`
   在这块板上**恒为 `unknown`** —— PYNQ 走 `/dev/xdevcfg`/XRT,不经过 fpga_manager。
   ⇒ 「PL 配没配」这个问题,这个 sysfs 文件**答不了**(已写进 `pl_state.py` 文件头,免得下次又去读它)。

## 沉淀

→ 候选 `skill/register-bit-calibration/`(待提炼):
**"判据"和"位定义"一样需要实测校准** —— 从厂商头文件抄位定义只是第一步,
"哪个位真的能区分两种状态"必须在**真件的两种状态上各读一次**才算数。
本例的两个反面样本(读了一个不存在的偏移;用了一个前后都读 1 的位)都不是靠推理发现的,
是靠"在两种状态下各读一次"发现的。

→ 并入既有 [[tool-zero-hits-suspect-the-tool]] 的一类:**判据恒真或恒假时,先怀疑判据本身**,
别急着解释被观测对象。
