dsgmxc/2026_fpga_qrs/llm-log/LLM-062.md

# LLM-062: 「切换测量项目回路没有切换」——一处从未落地的设计,与相位通路的打通

- **日期**: 2026-10-14
- **模型**: Claude(DeepSeek-V4-Flash 会话)
- **任务**: ① 查清"点测量项目按钮,继电器回路不跟着切"的根因并修好;
  ② 在**一次上电周期**内把 RG / Cp / D 三项读数打通(要相位);
  ③ 修完再综合、再上电。

## 提示词

用户的输入按时间顺序,原文粘贴:

```
那就先恢复回路的问题,为什么我切换测量项目回路没有相应的切换
```

(我用 AskUserQuestion 问了三个岔路,用户的回答原文)

```
写入权 = "C 界面接管(推荐)"
范围   = "回路全语义修正(推荐)"
RG 读数 = "看桌面上的qrs项目是怎么计算的"
```

接着是连续四问 —— **这四问是本次记录的核心素材**:

```
我们也用vh和vl的相位差不行吗

不是已经能采到数据了吗,做dft相除不行吗,为什么做不到

adc是同步采样为什么不是统一相位

把系统关了,把项目修复完整再上电
```

## 模型回答

**第一问(回路不切换)**:查实根因不是 bug,是**一处从未落地的设计**。`0x1C`(RELAY_CFG)
能写的地方有三处,一处都没写:

| 位置 | 现状 |
|---|---|
| PL `relay_ctrl.v` | ✅ 白名单互锁 / 原子翻转 / 稳定计时 / err_code,**2026-10-10 已上板验证** |
| C 界面 `relay_view.c` | ⛔ 文件头写着「只读,一个寄存器都不写 —— 写入权归 Python 侧」 |
| C 界面 `pynq_protocol.c:RequestPath()` | ⛔ 只 `printf`「只读回读,未改硬件」 |
| Python `drivers/relay.py` | ✅ 写得完整、实测过 —— 但 **`main.py` 只 import `drivers.board`,零调用方** |

⇒ 硬件永远停在复位值 `ALL_OFF(0x10)`。**顶栏那一栏没在说谎**(它读硬件真值),
说谎的是**按钮高亮** —— 按下去只换了个颜色。

连带查实四处「假装」,全部有代码注释自认:

| 界面动作 | 改之前实际发生 |
|---|---|
| 点「全部」单点 | 把**一份读数填进三张卡** |
| 点「先测 RG 再三路扫压」 | 打印「跳过」,**RG 根本没测** |
| 点 RG 单点 | 打印「无读数可填」,卡片留 `--` |
| 扫压 | 把**同一个 `cs_pf` 写进三条曲线** |

**第二问(为什么不能用 VH/VL 的相位差)**:追查前序 `~/Desktop/qrs`(STM32 工程)的 RG 算式,
逐字抄下来是 `Rg = Re(Z) + 0.7`,`Z = R0·(VH−VL)/VL`(复数)。
问题在于 `Z` 要 **VH 与 VL 的相对相位**,而当时两路是**两次独立采集**,
解调基准锚在**各次采集的第 0 点**(`adc_sample.c:372`):

```
Φ_A = 2π·f_e·t_A + ψ_DUT
Φ_B = 2π·f_e·t_B + ψ_R0
要的相位差 = (Φ_A − Φ_B) − 2π·f_e·(t_B − t_A)     ← 这一项软件不知道
```

`t_B − t_A` 中间隔着一次 8192 点读回(~2.5 ms),而:
- 1 MHz 下要 1° 精度 ⇒ 时间要准到 **2.8 ns**;板上最细的 50 MHz `clk_axi` 只有 **20 ns = 7.2°**;
- 且激励是 AD9833 的**板载 25 MHz 晶振**,与 FPGA 时钟**不同源**;
  2.5 ms 内漂 100 ppm ⇒ 250 ns ⇒ **1 MHz 下 90°**。

⇒ **任何"事后补时间差"的方案在 1 MHz 下都不成立。不是算术问题,是两次采集的相位原点本来就不同。**

**第三问(用户追问「不是已经能采到数据了吗,做 dft 相除不行吗」)**:不行,原因不是 DFT 的算法,
是**两个相量的原点不同**。DFT 本身完全正确,但 `∠Z` 里混进了 `2π·f_e·(t_B − t_A)` 这个
软件不知道的量。用户可以量到"相位差",但那不是 DUT 的相位差。

**第四问(用户追问「adc 是同步采样为什么不是统一相位」)—— 这一问把我推对了。**
用户是对的:**AD9238 在同一个转换沿上同时采 A 和 B**,产生一对同步样本,
这两个字在**同一条总线**上先后送出(tick −1 与 tick 0 就是同一个转换周期的两个半周期)。
而 `adc_capture.v:275` 当时是:

```verilog
wire samp_en = (tick == $signed(ph_off));   // 每个 ADC 周期只命中一个 tick
```

⇒ 同步的那一对里 **B 被扔掉**,要 B 只能再发一次 GO(一万多个转换周期之后)。
**不是 ADC 不同步,是采集器没接那股同步数据 —— 它就在线上,一个 tick 之遥。**
前序 `ad9238_capture.c::AD9238_Deinterleave` 正是这么做的。

于是本轮改成:一次 GO 里 A 窗、B 窗各写一次(偶地址 A、奇地址 B),缓冲 8192 → 16384 字
(每通道仍是 8192 点 ⇒ 解调窗长表一个字不用改)。

**第五问(用户拍板「把系统关了,把项目修复完整再上电」)**:把原本分两批的计划**合成一批**,
一次修完、一次综合、一个位流周期。执行顺序:

```
① 关板子(ssh shutdown)  →  ② 改代码  →  ③ 综合出位流  →  ④ 报「可以上电了」
⑤ 上电:加载位流(本周期仅此一次)→ 板上重编 c_ui → 验证
```

## 结果

☐ ✅ 直接可用   ☑ ⚠️ 部分可用   ☐ ❌ 不可用

> **代码侧已完成并自检通过;上板判据待第 ⑤ 步。**
> 「部分可用」的准确含义:本记录填写的时刻,回路切换**尚未听到咔哒声**、
> RG 读数**尚未与万用表比对** —— 这两条只有上电后能测,而我没有手。
> **不拿"代码写完了"当"功能验证过了"。**

## 验证方式

**已完成的验证(宿主侧,可复现)**:

| 项 | 做法 | 结果 |
|---|---|---|
| 改动的 C 全部能编能链 | `make BUILD=/tmp/cuibuild TARGET=/tmp/cuibuild/c_ui -j`(宿主 x86;板上要 aarch64,这一步只作语法/链接闭环) | ✅ 链接成功,`app/` 无 warning(只有 `ui_demo.c` 那条既有 warning) |
| RTL 语法 | `xvlog` 单文件解析 `adc_capture.v` / `cv_axi_lite_slave.v` / `cv_sys.v` | ✅ 无 error |
| 刻度算术 | 手算 P = 2 / 4 / 5 / 13 四种分频比,核对 RTL 的折叠规则与 A/B 窗 | ✅ 见「沉淀」第 1 条 |
| C 侧三棵树一致 | `diff -rq`(交付仓库 ↔ 工作区 `src/c_ui`) | ✅ 逐文件一致(⚠️ **先踩过:我第一遍改在了错的那棵树上**) |
| **位流重建** | `vivado -mode batch -source build/build_bitstream.tcl`(**完整重建**,`reset_run` 后重跑) | ✅ `synth_1 OK` / `impl_1 OK`,md5 **`232c649d0cc143c12c87f17365f6ddd3`**(旧 `d4d5538e…`)⚠️ 见下方更正条 |
| **BD 是否动过** | `system.hwh` md5 + mtime | ✅ **逐字节未变**(`6c376905…`,mtime 仍 10-10)⇒ BD 没动 |
| **时序** | `build/summary.txt`(由 `report_summary.tcl` 从 `report_timing_summary` 正文筛出) | ✅ **WNS +0.316 / WHS +0.065 / 失败端点 0 of 5472**;**WNS 全落在 `clk_adc_raw`**(由 +1.161 掉下来,是加大缓冲的直接代价)⚠️ 数值随构建而异,此处取**部署版**,见下方更正条 |
| **资源** | 同上 | ✅ **1790 LUT(3.36%)/ 2022 FF(1.90%)/ 7.5 BRAM Tile(5.36%)/ 0 DSP / 67 IOB(53.60%)/ 3 BUFG** |
| **DRC** | `build/system_wrapper_drc_routed.rpt` + 与 `git show HEAD:` 那份对照 | ✅ 无 Error / 无 Critical Warning;⚠️ **新增 `REQP-1840` ×20**,已查实是本次新引入并**判断为不改**(理由见记录正文) |

> ### ⚠️ 2026-10-15 更正:位流 md5
>
> 本记录原先(以及 `INDEX` 页脚)写的是 `182e824810a4c826d8e6466a245e007f`。
> **那是同一夜三次构建里的第一个(22:28),不是最后上板的那个。**
> 实际推到板上并**回读核对过 md5** 的是 **`232c649d0cc143c12c87f17365f6ddd3`**(23:41),
> 它同时是在**实现后网表里查过新寄存器**、确认改动没被综合掉的那一版。
>
> 三次构建 **大小完全相同**(都是 4045690 B),**只有 md5 分得开** ——
> 所以"大小对得上 / 时间戳对得上 / 脚本报成功"这三条**都不构成证据**。
>
> 连带修掉:工作区 `~/Desktop/qrs_2026_fpga/board/qrs.bit` 当时停在中间产物
> `182e8248…`(交付仓库那份是对的)⇒ **谁从工作区部署就会加载错版位流**。
> 现已换成 `232c649d…`,两树 + 板上三者一致。
>
> 台账见 `LLM-063` 纠错轨迹第 4 条。
> ⚠️ **2026-10-15 第二次更正:本块原先还写了一句「三次构建资源数完全相同」—— 那句是错的。**
>
> 交付仓库收尾时核对产物归属(见 `LLM-063` 纠错 ⑥),用 `md5` 把链子钉到末端:
> `fpga_pro/qrs/qrs.runs/impl_1/system_wrapper.bit` = **`232c649d…`**(= 部署版),
> 同目录 11 份 `.rpt` 全为 23:40;而**入库的 `build/system_wrapper_*.rpt` ×4 是 22:28 的**,
> 属**第一次**构建(`182e8248…`)。两次构建的数**并不相同**:
>
> | 项 | 第 1 次(22:16 → `182e8248…`) | **第 3 次(23:39 → `232c649d…`,部署版)** |
> |---|---|---|
> | WNS / WHS | +0.354 / +0.094 ns | **+0.316 / +0.065 ns** |
> | 失败端点 / 总数 | 0 / 5469 | **0 / 5472** |
> | LUT / FF | 1789 / 2021 | **1790 / 2022** |
> | `clk_fpga_0` WNS | 11.540 | **9.440** |
> | BRAM / DSP / IOB | 7.5 / 0 / 67 | **完全相同** |
>
> 源没变(三次构建之间只改了 C 侧 `CV_ADC_DIV_DEFAULT`,不碰 RTL/BD),
> 差异来自**三次独立的布局布线** —— 同一份源,P&R 不是逐比特可复现的。
> ⇒ 上表两行已就地改成**部署版数值**;`build/` 下 4 份 `.rpt` 与 `summary.txt`
> 也已换成部署版那一批(旧的留证在 `/tmp/m03_build1_backup/`,未入库)。
> ⚠️ 由此顺带结清:`LLM-063` 纠错 5 的 ④(`L1–L5 到底在哪一版位流上取得`)
> **本次仍无从判定** —— 但**部署的是 `232c649d…`** 这条已由工程位流 md5 正面坐实。

**待上电验证的判据(§五 L1–L5,只有上电能做)**:

| 级 | 判据 |
|---|---|
| L1 | **听咔哒声**(`relay_ctrl.v:114` 要求的"上电第一件要核对的事")—— 没声音 = 驱动板低有效,要改 `ACTIVE_LOW=1` 并重综合 |
| L2 | 顶栏「回路:」跟着变,不再恒为 `ALL_OFF` |
| L3 | `/var/log/qrs-ui.log` 里无 `[relay] ⚠️ 回读异常` |
| L4 | 另一个 SSH 跑 `sudo -E python3 tools/relay_hold.py --watch`(只读、2026-10-10 实测过的现成基准),报的组合 == 界面刚点的 |
| L5 | 扫压选「全部」,三条曲线**形状不同**(重合 = 只改了一处) |
| 相位 | 两路各自解调都干净正弦;多次采集相对相位稳定;`Cp / D` 不再恒 `--` |
| RG | `Rg = Re Z + 0.7` 与万用表量栅极电阻比对(⚠️ **用户持表读数,我当不了仪表**) |

## 纠错轨迹

**① 我一开始把范围判窄了 —— 漏掉「挡位」这一项。**

用户选的范围是「回路全语义修正」,我在计划里把 `0x18`(挡位)排除在外。这是**按用户原话执行的**,
但我没有主动指出一个后果:前序为 RG **强制 A 挡(10 Ω)并锁换挡**(`pc_protocol.c:282-284`),
而本项目停在 **B 挡(100 Ω)** ⇒ `VL/VH = 100/(100+Rg)`,Rg ≈ 12 Ω 时差量只有 **11%**,
噪声占比大得多。**公式没错(R0 是回读来的),但对比度差一个数量级。** 这一条我写进了代码注释和文档,
没有擅自改挡位(改了就是超范围)。

**② 我把「假话」印在了 4 个地方,改一处没改另外三处。**

`relay_view.c` 文件头写着「C 界面只读」,同一句话还印在 `relay_view.h`、`pynq_regs.h`、
`pynq_protocol.c` 的启动 `printf` 里。我先只改了 `.c` 的文件头,是**用户的范围要求**
(「回路全语义修正」)逼我去核对"还有哪里在说同一句假话"才发现的。
⇒ **规则:同一句结论印在多处时,改之前先 `grep` 那句话,不要只改"我记得的那一处"。**
(`report/llm-log/` 是 M11 的正文,日志与注释打架最伤。)

**③ `pynq_protocol.c` 里有我**自己**上一轮留下的「两路相位不相关」结论。**

这个文件 163–178 行有一段注释,斩钉截铁地说"两路是两次独立采集、相位不相关 ⇒ Cp/D 只能填 `--`"。
而本轮改的 RTL 恰好把这条**推翻**了。我不是删掉它,而是**保留原文 + 标注"原稿这一段是反的"** ——
因为那句注释在当时是**正确的**,它是"相位缺口存在过"的物证。删掉它,M11 里那条因果链就断了。

**④ 我自己搭了一处会静默失配的悬崖,自查时才发现。**

`adc_capture.v` 里我把每通道点数抽成 `CH_DEPTH`,但**声明了没用**(两个绕回比较还在写
`BUF_DEPTH/2`)。`xvlog` **不会报**声明未使用的 localparam。是我逐行回读时发现的。
⇒ 改成 `localparam [CH_AW-1:0] CH_LAST = CH_DEPTH - 1;` 并在两处比较里用它。
**这正是本轮要防的那类缺陷(改容量有多道静默闸,2026-10-08 踩过)在同一处的重演。**

**⑤ 用户连续四问,前三问我都答"做不到",第四问才把我推对。**

前三问我的回答都是**正确的**——「不能事后补时间差」「DFT 不能补相位原点」「两次采集相位不相关」。
**但它们全都是"在错的框架内正确"。** 用户的第三问「ADC 是同步采样,为什么不是统一相位」
直接把前提掀了:**我从头到尾假设了"必须发两次 GO",而 AD9238 的数据本来就同时躺在总线上。**
⇒ 我的三次回答里,只有第三次(`adc_sample.h` 的窗口表)包含了推翻自己的线索,
但我当时没往那个方向想。**教训:当用户连续三次追问"为什么做不到"时,该被质疑的是前提,不是论据。**

## 沉淀

→ `skill/silent-capacity-gates/`(第 ④ 条 —— 容量改动的静默闸,本轮新增一例:改容量时
"每通道点数"抽参数却漏用,编译器不报)
→ `skill/one-go-per-conversion/`(候选,**待上板验证后**再立 —— AD9238 双端口时分复用,
一次转换沿产生的一对同步样本必须一次 GO 全部收下,否则后面算什么都缺相位原点)

---

<!--
填写提醒(已遵守):
1. 当天记录 —— 本文件写于 2026-10-14 当日
2. 失败也记 —— 第 ①②③④⑤ 条都是失败/纠错
3. 能看到"我不同意 / 我改了 / 我验证了" —— 用户第 ④ 问推翻了我的框架(我不同意 → 我验证了)
4. commit message 里加 [llm-062]
-->
