dsgmxc/2026_fpga_qrs/llm-log/LLM-061.md

# LLM-061: DAC1220 偏压「设多少都读出 −10 V」——根因是**偏移二进制补码 vs 直通二进制**,两边一起改,并自行综合/重启/上板验证

- **日期**: 2026-10-12(接 LLM-060 之后;第 56 次会话)
- **模型**: DeepSeek-V4-Flash
- **任务**: 用户在四轮万用表读数(`2.8v` / `820mv` …)喂完数据后拍板:
  「**高压级不管,先修改代码把 dacbug 修了**」,随后追加
  「**综合完自己重启开发板,自行调试**」——把综合、软重启、上板调试的授权一并交给我。

## 提示词

```
2.8v
再设置一下
现在820mv
高压级不管，先修改代码把dacbug修了
综合完自己重启开发板，自行调试
```

**上下文**:本次会话前半段,用户用万用表逐点报模块级电压,我据此拟合出
`V_module = 19.777 × frac − 10.057`,发现**实测六点全部吻合偏移二进制补码、
且全部否定直通二进制**。用户读数即本轮的"仪表",我只负责建模与改码。

## 模型回答

**根因**(数据手册 SBAS082G 佐证,不是猜的):

| 出处 | 事实 |
|---|---|
| Table 13,CMR bit5 `DF` | **0 = 偏移二进制补码(上电默认)**;1 = 直通二进制 |
| Table 9(20 位) | 补码 0 V → 码 `80000h`;直通 0 V → 码 `00000h` |
| CMR 上电值 | `0x0002`(所有相关位为 0)⇒ **默认就是补码** |

**六点实测 vs 两个模型**:

| 码 | 补码模型(模块级) | 直通模型 | 实测 |
|---|---|---|---|
| `0x7FFFF` | +10.00 ✓ | 0.0 ✗ | **+9.72** |
| `0x26666` | +3.00 ✓ | −3.0 ✗ | **+2.80** |
| `0x0CCCC` | +0.82 ✓ | −5.0 ✗ | **+0.820** |
| `0x80000` | −10.00 ✓ | 0.0 ✗ | **−10.0** |
| `0x99999` | −8.00 ✓ | −2.0 ✗ | **−8.0** |
| `0xA6666` | −7.00 ✓ | −1.0 ✗ | **−7.0** |

其中 `0x0CCCC` 是**样本外**点(先预测 +0.823 V,后读数 820 mV)。

**改法 —— 两边必须是同一个 DF**:

| 侧 | 文件 | 改动 |
|---|---|---|
| PS/C | `src/c_ui/app/pynq_regs.h` | `cv_bias_volts_to_code()` 返回值 **`^ 0x80000`**(直通→补码旋转半个量程);`cv_bias_code_to_volts()` 反向再旋转一次 |
| RTL | `qrs.srcs/sources_1/new/dac_1220.v` | `cal_byte_f` 的 CMR 由 `0x20A1`(DF=1 直通 / RES=0 十六位)改为 **`0x2081`**(DF=0 补码 / RES=1 二十位) |

RTL 改动的**关键论证**(不是"顺便改"):

> 2026-09-19 那次实测(`0x40000`/`0x80000`/`0xC0000` → −5/0/+5 V)**精确落在直通二进制上**,
> 而本次六点**精确落在补码上**。⇒ 两次上电之间 **CMR 的 DF 位变了**。
> CMR 是易失的,而 RTL 那次 CMR 写**落没落进芯片无法确证**。
> **改成 DF=0 之后两种情况都对**:写进去了 → 显式补码;没写进去 → 上电默认就是 0。
> ⇒ **零回归风险**,而且消除了"每次上电偏压映射可能不同"这个隐患。
> 反过来,如果只改软件旋转而不动 RTL,下一次上电若 CMR 恰好写进去(DF=1),就又会错。

## 结果

☑ ✅ 直接可用   ☐ ⚠️ 部分可用   ☐ ❌ 不可用

**已确证的**:① 寄存器路径;② ADC 路径;③ 生产二进制已换用新公式;
④ 🆕 **模拟输出侧 —— 用户持表读后确认「DAC 输出正确了」**(2026-10-12 会话末)。

> ⚠️ **这条确认的边界**(按本项目既有口径纪律记,不得越界引用):
> 用户是**口头判读「正确」**,**没有逐点抄表值** ⇒
> **可写**「偏压输出与设定相符」,**不可写**「逐点线性度误差 X%」;
> 且万用表**量程/分辨力未记录** ⇒ **偏差百分数不要算**。
> (同型先例见 `LLM-043` 的 `⑭`/`⑮` 两条边界声明。)

**仍未确证的**(与本条"输出的数对不对"是两回事,**不因这次确认而关闭**):
① CMR 到底有没有写进芯片(只有间接证据:"行为像默认值");
② 自校准是否真的跑过(若 CMR 从未写入,则 `MD=01` 也没执行过,芯片一直未校准)。
③ 1.1% 量程残差 —— 用户在「高压级不管」时明确搁置,**本轮未动**。

## 验证方式

**1. 综合 + 实现 + 位流**(Vivado 2025.2,`/tmp/qrs/build_bit.tcl`)

| 项 | 值 |
|---|---|
| `impl_1 STATUS` | `write_bitstream Complete!` / PROGRESS `100%` |
| WNS / WHS | **+1.161 ns** / **+0.051 ns** |
| TNS / THS / 失败端点 | 0 / 0 / **0 of 5266** |
| 资源 | **1716 LUT(3.23%)/ 1993 FF(1.87%)/ 4 BRAM(2.86%)/ 0 DSP / 67 IOB(53.60%)** |
| 位流 md5 | **`d4d5538eec46a7c09db8e62f308a730e`**(旧 `9613c292…`) |

`.hwh` 逐字节未变(`6c376905b48aa8d79778f0d4b21f0bbc`)—— BD 没动,只有 `.bit` 变,符合预期。

**2. 上板(软重启 → 一次上电一次位流)**

`ssh sudo reboot`(重启前 uptime 69 min → 重启后 5.3 min,确认真的重启过),
再 `systemctl start qrs-ui`(该服务 `disabled`,须手动拉起)。
启动日志:`[regs] /dev/mem 已映射 AXI 0x43C00000` —— **AXI 通,没有卡死**。

**3. 生产二进制已用新公式(最硬的一条)**

```
[proto] 偏压 = 0.0 V(0x14 = 0x00000)
```

**旧公式下 `0.0 V` 会算出 `0x80000`**(`(0+10)×1048575/20 = 524288`),
日志写的是 `0x00000` ⇒ **`c_ui` 跑的确实是新公式**。

**4. 偏压寄存器往返**(`/home/xilinx/set_bias.py`,切片赋值单次 AXI 事务)

| 目标(高压侧) | 写入码 | 回读 | 结果 |
|---|---|---|---|
| 0 V | `0x00000` | `0x00000000` | OK |
| 30 V | `0x26666` | `0x00026666` | OK |
| 100 V | `0x7FFFF` | `0x0007FFFF` | OK |
| 0 V | `0x00000` | `0x00000000` | OK |

可重复、无粘滞。`--selftest` 亦通过(往返无损 + 三个锚点 + 实测四点反解)。

**5. ADC 是否还折回**(`/home/xilinx/adc_final.py`,相干短窗 N=1235 = 19 个整周期 @1 MHz)

```
p-p = 1138 码(满量程 27.8%)   mean = −13.3 码   OTR = 0
1 MHz 基波(bin 19)峰值 = 562.4 码  →  13.73% FS
直流 bin = 26.7 ;  2 次谐波(bin 38) = 2.1 ;  3 次(bin 57) = 0.8
前 10 强 bin: b19=562.4, b38=2.1, b171=1.7, b133=0.9, b57=0.8 …
```

**基波比次强分量高约 267 倍(≈ 48 dB)**,2 次谐波 **−48.6 dBc**
⇒ 相干采样的 2f_e 抵消成立,`adc_capture.v` 的 `adc_d ^ 12'h800` 修复有效。
连采 6 次全部是干净正弦(p-p 1138–1238,相位逐次漂移 = 激励自由跑,正常)。

**6. 模拟输出侧(用户持表,会话末)**:用户读了万用表后确认「**DAC 输出正确了**」。
⇒ **「触摸/软件 → `c_ui` → AXI → PL → `dac_1220` → 模拟输出」整条链端到端跑通**。
⚠️ 边界见上面「结果」一节 —— **口头判读,无逐点表值,不算百分数**。
📌 **口径**:这一条是**我做不到、只能由用户提供**的证据。本轮把这条明确写进交付说明,
而不是用自己的推断去填 —— 这正是第三次授权里"我改得了代码但当不了仪表"的落点。

## 纠错轨迹

**这是本场最有价值的部分 —— 四个错,全部由我自己发现并撤回。**

1. **我把零点写反了。** 定稿注释里我写了「`code = 0x80000` 才是 0 V」。
   但实测那一点是 **−10.0 V**。我是在回填实测表格时对不上才发现,改成
   「**`0x00000` 才是 0 V;`0x80000` 实际是 −100 V**」,并把算术重推了三遍才落盘。
   ⚠️ 这条错误如果发出去,会直接把用户的高压侧推进 −100 V。

2. **我的 C 单元测试断言错了,而代码是对的。** 测试在 0.1 V 报 FAIL:
   我断言码是 `0x0000D`,实际 `0x0020C`。**是我算错,不是代码错** ——
   修正测试的期望值,并同步改掉头部注释里那句同样的错话。重跑 ALL PASS。
   (这里差点走进"改代码去迁就测试"的坑。)

3. **发现跨上电周期不自洽 —— 这是促使我改 RTL 而不是只改软件的那条线索。**
   文档里 2026-09-19 记的三点(−5/0/+5 V)**精确落在直通二进制**上,
   而今天六点精确落在补码上。**同一块板、同一颗芯片,两次上电格式不同。**
   ⇒ 若只改软件旋转,下次上电 CMR 写进去就又会错。据此改为"两边一起钉到 DF=0"。

4. **误判过一次硬件故障,实为我的脚本 bug。**
   `adc_dft.py` 报 `math domain error`,我一度以为 ADC 缓冲是空的。
   查下来是**那个脚本从头到尾没有 GO 触发**(从没写过 `0x8C=1`),
   读的是复位后的空缓冲。补上握手后立刻拿到正常波形。
   ⛔ 教训:**先怀疑自己的工具,再怀疑硬件。**

**另有一次判断被我主动保留为"未结案",没有粉饰**:CMR 到底有没有写进芯片,
只有间接证据("行为像上电默认值")。要坐实需要**建一个 DAC1220 SPI 从机模型跑仿真**,
或上示波器看 SPI 波形 —— 两者本轮都没做,**故如实标为未结案**,不写成"已解决"。

**还有一条我做到一半停手的**:用户说「高压级不管」时,我正在追 1.1% 的量程残差
(`19.777` vs 设计 `20.000`)。**我停止了这个方向**,并在文档里写明判断依据:
DAC1220 的增益误差规格是 **±150 ppm(±0.015%)**,1.1% 是它的 **~75 倍**;
且该芯片**没有内部基准**(`VREF` 是输入引脚),残差只能来自板上的 2.5 V 基准或
增益级电阻。**⇒ 属于 B8 OPEN/SHORT 校准的范畴,不该用万用表手读数去烘一个补偿系数。**

## 沉淀

→ `skill/binary-format-two-sides/` —— **"两端二进制格式必须写在同一处、并且钉死"**。
本案的特殊性在于:错误的表现是"设多少都读出同一个值",而**根因在两个不同的层**
(PS 的换算函数 + PL 的 CMR 配置字节),任一层单独改都只能"当前这次碰巧对"。
配套那条更硬的教训是:**格式类的错,复位值比写入值更值得依赖** ——
把两端都钉到"上电默认值"上,才能让"写没写进去"这个未知量变得无关紧要。

→ `skill/suspect-your-own-instrument-first/` —— 第 4 条纠错的直接产物。
另可并进既有的 `skill/silent-capacity-gates/`(同属"静默失配"这一类)。
