dsgmxc/2026_fpga_qrs/docs/board_pins.md

# 领航者 ZYNQ-7020 引脚查表与已知陷阱

> **用途**:上板前确定"哪个信号该约束到哪个球号"。
> **本文件只记**从官方资料抄出来的事实 + 出处。凡是**推断**都单独标出来。
>
> 建立日期:2026-09-19。触发原因见文末「已知陷阱」第 1 条 —— 一条错误规则导致了一次误判。

---

## 一、两个 40PIN 扩展口

| 项目 | J3 | J4 |
|---|---|---|
| 规格 | 2×20-PIN,2.54 mm | 2×20-PIN,2.54 mm |
| IO 数 | 36 | 36 |
| 电源 | 1×+3.3V、1×+5V、2×GND | 1×+3.3V、1×+5V、2×GND |
| Bank | — | **大部分接 BANK13,仅 XC7Z020 可用** |

**出处**:《领航者 ZYNQ 之 FPGA 开发指南》§5.2「IO 扩展口」(pdftotext 转文本后第 4651–4670 行);
底板原理图 `领航者ZYNQ底板原理图_V3.9.pdf` **第 5 页**(J4 表,与 J1/J2 核心板连接器表同页)。

> ⚠️ **J3 的引脚表本文档暂未录入** —— 只录了 J4。用 J3 前必须另查原理图。
> 两个口的引脚表**完全不同**,不要互相套用。

---

## 二、J4 扩展口完整引脚表(40 脚)

**读法**:奇数脚在左列,偶数脚在右列(已用 J4 的 +3.3V/+5V/GND 分布与指南
「1 个 3.3V、1 个 5V、2 个 GND」的描述交叉确认)。

| 脚 | B 名 | **球号** | 底板网络名 | | 脚 | B 名 | **球号** | 底板网络名 |
|---|---|---|---|---|---|---|---|---|
| 1 | B13_L6_N | V5 | | | 2 | B34_L1_P | T11 | |
| 3 | B13_L19_N | U5 | | | 4 | B13_L19_P | T5 | |
| 5 | B13_L11_N | V7 | | | 6 | B13_L11_P | U7 | |
| 7 | B13_L15_N | W8 | | | 8 | B13_L15_P | V8 | |
| 9 | B13_L17_P | U9 | | | 10 | B13_L17_N | U8 | |
| 11 | B13_L12_N | U10 | | | 12 | B13_L12_P | T9 | |
| 13 | B13_L22_N | W6 | | | 14 | B13_L22_P | V6 | |
| 15 | B13_L13_P | Y7 | | | 16 | B13_L13_N | Y6 | |
| 17 | B13_L14_P | Y9 | | | 18 | B13_L14_N | Y8 | |
| 19 | B13_L16_P | W10 | | | 20 | B13_L16_N | W9 | |
| 21 | B13_L21_P | V11 | | | 22 | B13_L21_N | V10 | |
| 23 | B13_L20_N | Y13 | | | 24 | B13_L20_P | Y12 | |
| 25 | B13_L18_N | Y11 | | | 26 | B13_L18_P | W11 | |
| **27** | B34_L3_N | **V13** | CMOS_D2 | | **28** | B34_L3_P | **U13** | CMOS_D1 |
| **29** | B34_L11_P | **U14** | CMOS_D4 | | **30** | B34_L11_N | **U15** | CMOS_D3 |
| **31** | B34_L4_P | **V12** | CMOS_D6 | | **32** | B34_L4_N | **W13** | CMOS_D5 |
| **33** | B34_L8_P | **W14** | CMOS_PCLK | | **34** | B34_L8_N | **Y14** | CMOS_D7 |
| **35** | B34_L10_P | **V15** | CMOS_PWDN | | **36** | B34_L10_N | **W15** | CMOS_XCLK |
| 37 | GND | — | | | 38 | **+3.3V** | — | |
| 39 | GND | — | | | 40 | **+5V** | — | |

**球号列的可信度分级**:

- 🟢 **已三处互证**(原理图 J4 表 + 原理图 J1 表 + 官方 `NAVIGATOR_ZYNQ_IO.xdc` 的网络名):
  **V13 / U13 / U14 / U15 / V12 / W13 / W14 / Y14 / W15**(即 27–36 脚全部)
- 🟡 **两处互证**(原理图 J4 表 + J1 表的球号):J4 第 1–26 脚(BANK13)。
  **未**与官方 XDC 交叉(官方表不含扩展口)。
- ⚪ 表中留空的「底板网络名」= 该脚在底板上没有外设,是纯扩展 IO。

**当前项目实际用到的 33 个脚**(`qrs.srcs/constrs_1/new/led.xdc` —— ⚠️ **不是 `io.xdc`**,
那个文件已**不被 `qrs.xpr` 引用**,里面有一套互相打架的旧球号,见 §四 陷阱 5)。
下列 22 个是测量前端,**另有 11 个继电器/挡位脚见下一小节**:

| 信号 | 球号 | J4 脚 | BANK | | 信号 | 球号 | J4 脚 | BANK |
|---|---|---|---|---|---|---|---|---|
| `dac_sclk` | W15 | 36 | 34 | | `adc_oe_n` | V5 | 1 | 13 |
| `dac_cs` | W13 | 32 | 34 | | `adc_clk` | T11 | 2 | **34** |
| `dac_mosi` | Y14 | 34 | 34 | | *(模块空脚)* | U5 | 3 | 13 |
| `dds_sclk` | W14 | 33 | 34 | | *(模块空脚)* | T5 | 4 | 13 |
| `dds_sync` | V12 | 31 | 34 | | `adc_d[0..7]` | V7 U7 W8 V8 U9 U8 U10 T9 | 5–12 | 13 |
| `dds_data` | V15 | 35 | 34 | | `adc_d[8..11]` | W6 V6 Y7 Y6 | 13–16 | 13 |
| | | | | | `adc_pdn` | Y9 | 17 | 13 |
| | | | | | `adc_otr` | Y8 | 18 | 13 |

> **2026-10-07 换线**(用户在板上重接后报出):DAC 三根未动;DDS 从 `T5/U7/T11`
> 换到 `W14/V12/V15`(31/33/35 奇数列);ADC 整段从 J4-27/28 + 15–26 脚
> 换到 **J4 第 1–18 脚**。两段各自连续 ⇒ 名单与排线自洽。
> ⚠️ **模块侧空脚 `U5`/`T5` 有意不约束**(模块内部若接地,FPGA 一驱动即短路)——
> 故 `led.xdc` 里 ADC 段只有 16 行,而排线是 18 根,不是漏了。

### 继电器矩阵(K1–K7)与挡位选择(A–D)—— 2026-10-10 新增 11 根

球号由**用户 2026-10-10 报出**(不是我从原理图推的);J4 脚号与 BANK 由本文档
§二 的 J4 表**反查得到**,两者**逐条自洽**(见下方注 ①)。

| 信号 | 球号 | J4 脚 | BANK | B 名 | | 信号 | 球号 | J4 脚 | BANK | B 名 |
|---|---|---|---|---|---|---|---|---|---|---|
| `relay[0]` K1 | U15 | 30 | 34 | B34_L11_N | | `relay[5]` K6 | Y11 | 25 | 13 | B13_L18_N |
| `relay[1]` K2 | U14 | 29 | 34 | B34_L11_P | | `relay[6]` K7 | Y12 | 24 | 13 | B13_L20_P |
| `relay[2]` K3 | U13 | 28 | 34 | B34_L3_P | | `gear[0]` A 10 Ω | Y13 | 23 | 13 | B13_L20_N |
| `relay[3]` K4 | V13 | 27 | 34 | B34_L3_N | | `gear[1]` B 100 Ω | V10 | 22 | 13 | B13_L21_N |
| `relay[4]` K5 | W11 | 26 | 13 | B13_L18_P | | `gear[2]` C 1 kΩ | V11 | 21 | 13 | B13_L21_P |
| | | | | | | `gear[3]` D 10 kΩ | W10 | 19 | 13 | B13_L16_P |

**注 ① 为什么说自洽**:J4 的**奇数列**恰好是 `27=V13 29=U14 23=Y13 21=V11 19=W10`,
**偶数列**是 `30=U15 28=U13 26=W11 24=Y12 22=V10` —— 用户报的 11 个球号
**全部落在这两列的 J4 19–30 区间内**,没有一个是区间外的。若是随手编的,
不可能同时满足"脚号连续 + 列奇偶正确"。

**注 ② 唯一跳过的脚是 J4-20(`W9`)** —— 挡位那一段 `W10(19) → V11(21)` 中间空了一格。
**这是有意的,不是漏接**:`W9` 在 `led.xdc` 里也没有约束,保持悬空。
⚠️ 如果后续要用 `W9`,记得它是 `B13_L16_N`,与 `gear[3]`(W10 = `B13_L16_P`)
**是同一对差分线的正负两端** —— 那对线最好成对使用或成对闲置。

**注 ③ 极性**:`relay_ctrl.v` 的 `ACTIVE_LOW` 参数**默认 0**(= 引脚高电平判为闭合)。
出处两层,均**不是**从继电器驱动板手册查来的:

1. **文档依据**:前序交接文档 `~/Desktop/qrs/ZYNQ项目移植与AI交接说明.md` §3.2
   「#### 继电器矩阵 —— **所有继电器为高电平有效**」(另见同文档 §3.8 组合表)。
2. 🟢 **实测(2026-10-10)**:写 `0x1C = 0x10`(=`AllOff/reset`,定义上**只有 K5 高**),
   万用表量 J4 —— **只有 `W11`(J4-26)= 3.3 V,其余 6 脚 0 V**。
   ⇒ 极性 + 位序(`K1..K7 = bit0..bit6`)**一次同时坐实**。
   证据:`report/measurements/20261010_relay_pin_level_verified.md`。

⇒ 原先「若驱动板低有效,上电配置期会同时吸合全部 7 只」的担忧**已被实测排除**。
⚠️ **但只到 FPGA 引脚为止** —— 驱动板之后的**继电器触点(COM/NO/NC)从未量过**,
「引脚电平对了」≠「触点真翻了」。
⚠️ 上电**配置瞬间**(引脚高阻)的电平仍未覆盖,量的是配置完成后的稳态。

**注 ④ 摄像头复用**:`relay[0..3]` 落在 J4 27–30,即 §四 **陷阱 4** 说的 `CMOS_D1..D4`。
本项目无摄像头模块,不冲突;但与摄像头**不能同时使用**(同 §四 陷阱 4)。

**注 ⑤ 与已有 22 脚的冲突检查**:2026-10-10 用
`grep -o 'PACKAGE_PIN [A-Z0-9]*' led.xdc | awk '{print $2}' | sort | uniq -d`
验过,**无重复球号**(67 条 `PACKAGE_PIN`,11 条是本次新增)。

**板载系统信号**(同样出自官方 XDC + 指南 PL 引脚表):

| 信号 | 球号 | 说明 |
|---|---|---|
| `sys_clk` | **U18** | PL 有源晶振 **50 MHz**,接在 MRCC 全局时钟脚 |
| `sys_rst_n` | **N16** | PL 复位按键 |

---

## 三、出处与复现方法

| 事实 | 出处 |
|---|---|
| J4 引脚表 | `~/Desktop/zdyz/3_开发板原理图和硬件相关文件/领航者ZYNQ底板原理图_V3.9.pdf` **第 5 页** |
| 球号 ↔ 核心板连接器脚号 | 同上第 5 页 **J1 表**(J1 对应核心板 **X4**) |
| `sys_clk = U18`、`sys_rst_n = N16`、`cam_*` 命名 | `~/Desktop/zdyz/3_开发板原理图和硬件相关文件/NAVIGATOR_ZYNQ_IO.xdc`(**GBK 编码,需 `iconv -f GBK`**) |
| PL 外设引脚表(**不含扩展口**) | 开发指南 §「PL 端引脚分配」(`pdftotext` 后第 3540 行起) |
| 扩展口规格 | 开发指南 §5.2「IO 扩展口」(第 4651–4670 行) |
| X4 走线长度佐证 | `.../硬件相关文件/核心板信号走线长度/ZYNQ7010_7020核心板信号走线长度.csv`(格式 `BANK_34:X4.55:U1.W13`) |

**复现命令**(验证上面的表):

```bash
cd ~/Desktop/zdyz/3_开发板原理图和硬件相关文件
pdftotext -f 5 -l 5 -layout 领航者ZYNQ底板原理图_V3.9.pdf - | awk 'NR>=59 && NR<=130' | cut -c180-400
```

---

## 四、已知陷阱

### 陷阱 1 ⛔ 「官方 XDC 里没有这个球号 ⇒ 板上没有这个脚」

**这是错的。** 官方 `NAVIGATOR_ZYNQ_IO.xdc` **只覆盖板载外设**,
扩展口(J3/J4)上的引脚**本来就不在其中**。

开发指南原文:「上表列出了**除扩展口外**,开发板上所有 PL 功能外设所对应的 IO 引脚号,
关于扩展口上的排针所对应的 IO 引脚号,大家可以参考开发板的原理图或者直接查看开发板上的丝印标注。」

**实际后果(2026-09-19 真实发生过)**:
`W13` / `Y14` 在官方 XDC 里叫 `cam_data[5]` / `cam_data[7]`,而 `W15` **在官方表里完全不存在**
→ 模型据此判断「这三个脚是摄像头专用,DAC 模块根本没接到」→ **误判,浪费了一轮排查**。
真相是**这三个脚同时引到了扩展口 J4 的第 32 / 34 / 36 脚**,底板网络名叫 `CMOS_D5` /
`CMOS_D7` / `CMOS_XCLK`(因为也接了摄像头接口),**正点原子把扩展口复用成了摄像头口**。

### 陷阱 2 ⛔ 拿 J3 的引脚表套 J4

两个扩展口的引脚表**不一样**。本文档只录了 J4。

### 陷阱 3 ⚠️ 相邻脚差一位

J4 第 31/33/35 脚分别是 `B34_L4_P` / `B34_L8_P` / `B34_L10_P`(网络名 CMOS_D6 / CMOS_PCLK /
CMOS_PWDN)—— 与第 32/34/36 脚**只差一位**,而且**在另一列**。
数错一列会让三根信号全落到错误的脚上,**现象与"没接"完全相同**。
上板前请**对板上的丝印**再确认一次。

### 陷阱 5 🔴 `constrs_1/new/` 里躺着一个**不再被引用**的 `io.xdc`

**2026-10-07 实测**:`grep -o '[a-z_]*\.xdc' qrs.xpr | sort -u` 只返回 **`led.xdc`** 一个 ——
`io.xdc` **不是"被禁用",是根本没进工程**(`IS_ENABLED = 0` 的说法描述的是更早的状态)。
它现在是**死文件**,但里面的球号与 `led.xdc` **大面积打架**:

| 球号 | `io.xdc`(死) | `led.xdc`(活) |
|---|---|---|
| `U5` | `clk_65m` | 模块空脚(不约束) |
| `V5` / `V7` | (注释里的备选) | `adc_oe_n` / `adc_d[0]` |
| `V12` / `W14` / `V15` | `adc_sync` / `adc_sclk` / `adc_mosi` | `dds_sync` / `dds_sclk` / `dds_data` |

⛔ **不要把它当参考**。要看当前引脚,只有一个来源:`led.xdc`。
⚠️ 顺带更正一条旧记录:那份 `io.xdc` 的 DDS 注释**自己写着**"照 J4 表挑的空闲脚,
**不是从实际接线查来的**" ⇒ 它与用户 2026-10-07 报的 DDS 位置(`V12/W14/V15`)**逐位相同**,
但这**只是碰巧/或用户照它接的**,**不算独立证据**,别引用来"证明接线"。
🗂 该文件曾于 2026-10-05 从交付仓库删除,但 **Vivado 工程里这份仍在** —— 建议归档,但
**不要动工程布局(vivado 工程内删文件属布局动作,归用户)**。

### 陷阱 4 ⚠️ 这些脚同时接到板载摄像头接口

用 J4 的 27–36 脚时,若板上插了摄像头模块,**会与摄像头驱动信号冲突**。
本项目没有摄像头模块,不构成问题;但如果后续要同时用摄像头,必须重新选脚。

---

## 五、与项目状态文档的对应

- 本文件闭环 `docs/project_state.md` §九 **Q05**(「正点原子扩展口可用 I/O 数量与 bank 分布 —— 待查原理图」)。
- 触发本次记录的排障过程见 `report/llm-log/LLM-012.md`。
