dsgmxc/2026_fpga_qrs/llm-log/LLM-056.md

# LLM-056: 继电器矩阵 + 挡位选择落地 —— Q24 结案,BD 第 4 次撞 mref 坑(这次每一步失败都留了证)

- **日期**: 2026-10-10
- **模型**: DeepSeek-V4-Flash
- **任务**: 用户给出 11 个继电器/挡位球号后,授权代写「引脚分配 + 接入 PS 侧」的**全部代码**,并接入 BD、综合实现,交给用户上电调试

## 提示词

```
你直接分配引脚并且接入ps端写完我上电你调试
```

> ⚠️ 这是 `CLAUDE.md` §6.0「所有代码由用户先写」的**显式例外**。此前用户已用
> AskUserQuestion 逐项确认了三个岔路口:① 继电器映射「是,按我报的顺序」
> ② 档位映射「按我报的顺序」③ PL 职责范围「原子寄存器 + 互锁 + 硬件计时(推荐)」。
> 球号由用户在前一条消息给出:「继电器矩阵的引脚占用 u15 u14 u13 v13 w11 y11 y12
> 档位选择引脚占用 y13 v10 v11 w10」。

## 模型回答

新建 `relay_ctrl.v`(原子寄存器 + 白名单互锁 + 毫秒级稳定倒计时 + busy/done 握手),
改写 `cv_axi_lite_slave.v` 实现 `0x04/0x18/0x1C/0x24` 四个寄存器,`cv_sys.v` 引出
11 根端口并拼装 STATUS,`led.xdc` 加 11 行约束(56 → 67 条 `PACKAGE_PIN`)。
随后写 `build/bd_add_relay_gear.tcl` 把新端口接进 BD 并重生成 wrapper。

## 结果

☐ ✅ 直接可用   ☑ ⚠️ 部分可用   ☐ ❌ 不可用

> RTL / XDC 部分一次通过;**BD 接入部分连撞 6 处失败**(见纠错轨迹),
> 全部定位并修复后 `validate_bd_design` 通过、BD 存盘、综合通过、**实现 + 位流完成**
> (WNS `+1.490` / 失败端点 `0 / 5266`),PS 侧寄存器定义已补齐并自测通过,**交付件已就位**。
> ⚠️ **仍未上板** —— 结论到"位流干净"为止,不含任何实测行为。

## 验证方式

| 环节 | 具体证据 |
|---|---|
| 引脚无冲突 | `grep -oP 'PACKAGE_PIN \K[A-Z0-9]+' led.xdc \| sort \| uniq -d` → **输出为空**;总数 67 = 去重后 67 |
| BD 新端口真的进来 | 脚本回读 `create_bd_cell` 后引脚数 **56 → 58**,并逐条断言 `cv_sys_0/relay`、`cv_sys_0/gear` 存在 |
| BD 全部引脚连通 | 脚本遍历 **58 个引脚**逐个查 `get_bd_nets` + `get_bd_intf_nets` → **0 悬空** |
| 时钟/复位网未被打坏 | 回读 `processing_system7_0_FCLK_CLK0` 成员 = `FCLK_CLK0 M_AXI_GP0_ACLK aclk slowest_sync_clk S_AXI_HP0_ACLK s_axi_aclk`,与改造前 dump **逐字一致** |
| 地址段没丢 | 回读 `/processing_system7_0/Data/SEG_cv_sys_0_reg0` **offset `0x43C00000` range `0x1000`**、`/cv_sys_0/M_AXI` → `HP0_DDR_LOWOCM` **offset 0 range `0x40000000`** |
| wrapper 含新端口 | 直接读文件:`output [6:0]relay;` / `output [3:0]gear;` |
| BD 文件本身 | `grep -c relay system.bd` → **5**(⚠️ **不能用 `>relay<` 这种 XML 假设去 grep** —— 该文件是 JSON 风格,第一版 grep 模式错误,一度误判成"没写进去") |
| 综合 | `synth_1` = `synth_design Complete!` 进度 **100%** |
| 实现 / 位流 | `write_bitstream Complete!`;**WNS `+1.490` / WHS `+0.080` / TNS = THS = 0 / 失败端点 0 of 5266**;报告原文 `All user specified timing constraints are met.` |
| 资源 | LUT **1715(3.22%)** / FF **1993(1.87%)** / BRAM Tile **4(2.86%)** / DSP **0** / Bonded IOB **67(53.60%)** |
| DRC | **无 Error / 无 Critical Warning**。1 条 `CHECK-3` + 20 条 `REQP-1839`,后者**全部落在既有的 `u_lcd_fb_reader/lbuf_reg`**,与本次改动无关 |
| 位流本体 | `system_wrapper.bit` 4 045 690 B,md5 **`9613c2928a01f832b71aef7c45c4c0b9`** |
| PS 侧常量 | `python3 -c "import cv_regs"` 通过;`RELAY_LEGAL` 回读 = `['0x0','0x10','0x1e','0x3c','0x51','0x61','0x7f']`,与 RTL `legal_relay` **逐值一致** |
| PS 侧注册 | 断言 `STATUS` / `RANGE_SEL` / `RELAY_CFG` / `SETTLE_CFG` 四个名字都在 `PL_IMPLEMENTED_REGS` 里 → 通过 |
| `.hwh` 含新端口 | 顶层 PORT 表 `DIR="O" LEFT="6" NAME="relay"` / `LEFT="3" NAME="gear"` 各在;`TIMESTAMP` = `Sat Oct 10 15:40:47 2026`(晚于 BD 改造) |

⚠️ ~~未验证~~ **→ 已上板实测(见下 §D)**,以下为**当时的**未验证清单,保留供追溯:
① 位流尚未上板 ② 继电器驱动板**极性未证实** ③ 复位值 `0x10`/`0b0010` 抄自前序**声明**而非电路推导。

**上板后新增的结论**:
- ✅ **极性已证实(改判)** —— 原判"未证实",现已从**前序 STM32 源码原文**坐实:
  `relay_matrix.c` 第 5 行 `/* 位0～位6分别表示K1～K7,高电平为继电器有效。*/`,
  且 `RelayMatrix_WritePort()` 用 `BSRR = ((~asserted)<<16) | asserted`(asserted 置高)
  ⇒ **高 = 吸合**,`ACTIVE_LOW = 0` **正确**。⚠️ 依据是**前序工程源码**,仍**不是**本次对驱动板的直接测量。
- ✅ **白名单二次坐实** —— `relay_matrix.c` 的 8 个 `RELAY_MATRIX_STATE_*` 宏与我们的 7 值白名单
  **逐值相同**(`ALL_OFF=K5=0x10` / `CISS=0x7F` / `COSS=0x61` / `CRSS=0x51` / `RG=0x3C` /
  `CISS_DISCHARGE=0x1E` / `COSS_DISCHARGE=0x00` / `CRSS_DISCHARGE=K5=0x10` 与 ALL_OFF 同值)。
- ⚠️ **仍未做的**:继电器**触点**是否真的按掩码动作 ——
  本次只验证了**寄存器侧**行为(写→回读、拒绝、计时),**没有量触点通断**。
  要坐实需在 ALL_OFF / CISS 两态下量某只继电器的接触电阻。

## 纠错轨迹

### A. 设计层(写之前就拦下的)

1. **掩码陷阱(差点发出去)** —— 最初打算在 `cv_axi_lite_slave.v` 里把 `0x1C` 的写入值
   掩到 `[6:0]` 再存。**自己复查时发现**:用户若写 `0x180`,掩码后得 `0x00`,
   而 `0x00` 在括号表里**是合法组合** ⇒ **一次非法写会变成一次真实的继电器动作**,
   且**不报错**。改为**寄存器存原值不掩码**,切片挪到 `cv_sys.v` 的
   `.cfg_relay(cfg_relay_cfg[7:0])`,保住 `bit7` 让它走到 `relay_ctrl` 被判非法。

2. **偏离规格的两处 —— 是"规格错了"而不是"我没照做"**:
   - 清单一 §2.1 R6 要求「先断后合」。查前序 STM32 的 `relay_controller.c`,里面
     **明确写着**「直接施加目标继电器组合,不插入 AllOff 中间状态」。再想清楚原因:
     在 STM32 上 K1–K7 **跨 4 个 GPIO 口**,一次切换要 4 次 `BSRR` 写,**中间态客观存在**,
     所以要管;在 PL 里 7 位**同一拍翻转**,该瞬态**物理上不存在**,插中间态反而
     **主动制造**一个栅极浮空窗口。⇒ R6 那句在 PL 上是**反的**。
   - R6 说稳定时间单位是「周期数」。40 ms @ 50 MHz = 2 000 000 拍 > 16 位上限 65535,
     **装不下** ⇒ 改用 ms。复位值 40 对齐前序 `RELAY_CONTROLLER_SWITCH_SETTLE_MS = 40`。

   **两条都作为"偏离"显式写进 `relay_ctrl.v` 头部注释**,不是偷偷改。

### B. 工具层(BD 接入,连撞 6 处)

3. **`update_module_reference` 静默失败(第 4 次撞同一个坑)** —— 返回 `rc=1` 且
   `errorInfo` **为空**,日志里**连一行 ERROR 都没有**。探过 `can_resolve_reference cv_sys` = **1**
   (RTL 没问题)、`get_ips cv_sys` 为空;`cells` / `name` / 绝对路径三种写法全失败。
   ⇒ 不可修,改用工程里已记载的「清缓存 → 删 cell → 同名重建 → 重连」处方。

4. **Plan A 被自己的实测证伪** —— 我曾以为"清掉 mref 缓存就够了"。**实测:清完重开 BD,
   引脚数仍是 56,`relay`/`gear` 依然查不到**。原因:`system.bd` **自己也存了一份引脚快照**。
   ⇒ 清缓存是**必要但不充分**。(这条已在脚本注释里标成「Plan A,已证伪」,免得下次再试。)

5. ★★ **`connect_bd_net` 三种写法的实测对比 —— 本次最有价值的一条**:
   - 写法① `connect_bd_net <net> <pin>` ⇒ **BD 41-701**
     `requires at least two pins/ports, or one pin/port and a net`
     —— **而前一行脚本刚断言过那个 net 存在**,说明命令的入参语义与我的预期不同。
   - 写法② **把该网络全部 6 个端点一起喂进去** ⇒ **静默失败**(被 `catch` 吞掉,
     只落进一个**从没被打印过的** `connect_fail` 列表),一路跑到 `validate_bd_design`
     才炸出 **BD 41-758「s_axi_aclk 未连到有效时钟源」** ——
     **错误现象离错误动作隔了 5 个步骤**。
   - 写法③ **两引脚形式**(`<新引脚> <既有网络里的一个老引脚>`)⇒ ✅ **成功**,
     回读 net 成员与改造前**逐字一致**。

   ⇒ **结论(可复用)**:Vivado 会自己把新引脚并进既有的同名网络,**列全老端点反而会因为
   "这些引脚已经连好了"而失败**。**不再猜命令语义,先写 probe 脚本实测再定** ——
   这次是专门跑了一个 `probe2.tcl`(删 cell → 重建 → 依次试三种写法 → 打印结果)才定的。

6. ★ **我自己写的两个判据是错的(自查发现)**:
   - 🅰️ 全量悬空检查**第一版把 33 根引脚全判成"悬空"**:`get_bd_nets -of_objects`
     **看不见 intf net** —— `s_axi_*`/`m_axi_*` 走的是 `get_bd_intf_nets`;
     另 `relay`/`gear` 要等 `make_bd_pins_external` 之后才有 net。
     修法:先查标量 net、再查 intf net,并把检查**挪到第 5 步之后**。
   - 🅱️ `get_property CONNECTED <pin>` 在这里**恒为空字符串** ——
     **连好了也是空**,完全不能当判据(已就地留注释)。

7. **两条命令层面的坑**:
   - `make_external` **不是本版命令名**(`invalid command name`)—— 正确的是
     **`make_bd_pins_external -name <port> <pin>`**(`LLM-044` 已记,这次是照记录避开的)。
   - `make_wrapper` **成功写出了文件**(日志 `Verilog Output written to ...`)却
     **不会重新登记进工程**;而我又先把旧 wrapper 的 file 引用 `remove_files` 掉了 ⇒
     `get_files -quiet system_wrapper.v` 返回空 ⇒ **我误报"没生成"**。
     修法:`make_wrapper` **返回的路径才是新文件**,拿到后 `add_files -norecurse` 登记。
   - ⚠️ `get_bd_nets relay`(按**名字**查)**查不到** —— `make_bd_pins_external` 生成的
     网络名是 `/cv_sys_0_relay`,不等同端口名;按名字查会触发 `Common 17-55`
     **中断整个脚本**。⇒ 一律改用「引脚 → 网络」反查。

8. ⚠️ **一次差点误判(与 `stale-artifact-silent-reuse` 同族)**:我用
   `grep -o '>relay<' system.bd` 得到 **0 次**,差点判定"新端口没写进 BD"。
   实际是**我的 grep 模式基于错误的格式假设** —— 该文件存的是
   `"relay": {`,不是 XML 标签。改用 `grep -c relay` → **5 次**,配合 wrapper 文件内容
   双向确认。📌 **"查不到"与"不存在"是两件事;先确认自己的查法对不对。**

### C. PS 侧接入 + 交付件自查(位流已出,尚未上板)

9. **PS 侧常量不凭记忆转写** —— 写 `cv_regs.py` 的 `RELAY_STATE` 白名单前,
   先把 `relay_ctrl.v` 的 `legal_relay` / `legal_gear` / `ERR_*` **原文 `sed` 出来**再落笔。
   理由:两边各存一份组合表,**写错了两边都不报错** —— RTL 判合法照收,
   PS 判非法拒发,症状是"界面按不动",而**两边日志都干净**。

10. ⚠️ **`.hwh` 是 XML 不是 JSON —— 格式假设错误第 2 次**。我用 `json.load` 解 `qrs.hwh`,
    报 `Unexpected UTF-8 BOM`;差点误判成"hwh 损坏"。实际首字节 `EF BB BF <?xml ...>`,
    是 **`EDKSYSTEM` v1.2 的 XML**。⚠️ 与错误 8(`grep -o '>relay<' system.bd` 得 0)
    **同族**:先入为主假定格式 → 工具如实报"没有" → 我读成"东西不存在"。
    📌 **两次都靠"换个查法再查一遍"翻案**;已并入 `silent-tool-failure` 的处方:
    **不看命令返回值,看被改变的那份东西本身**。

11. ✅ **`SIGIS="undef"` 不是丢约束** —— 差点把 hwh 里 `relay`/`gear` 的
    `SIGIS="undef"` 报成"引脚约束没进位流"。**实测全表**:254 个 PORT 里
    **224 个都是 `undef`**(`lcd_*`/`touch_*`/`adc_*`/`dac_*` 全在其中),
    只有 `clk`(14)与 `rst`(16)有值 ⇒ **`undef` 是用户 IO 的常态**。
    📌 判据不能只看目标那一个,得看**同类项的全貌**。

### D. 上板实测(2026-10-10 晚,板子 192.168.2.99)

**阶段 1(只读)** —— Overlay 加载、`SCRATCH` 回环 3/3、四个新寄存器复位值全对:

| 寄存器 | 读回 | 期望(RTL) |
|---|---|---|
| `STATUS` 0x04 | `0x00000000` | 0 |
| `RANGE_SEL` 0x18 | `0x02` = B 100 Ω | `GEAR_RESET` |
| `RELAY_CFG` 0x1C | `0x10` = ALL_OFF | `RELAY_RESET` |
| `SETTLE_CFG` 0x24 | `>>16` = **40 ms** | 40 |

**阶段 2(读写全测,`tools/relay_rw.py`)** —— **全部通过**:

- **A** 7 个合法组合逐个 写→等 done→回读,**7/7 回读 == 写入值**,err 全 0
- **B** 6 个非法组合(`0x01 0x02 0x80 0xFF 0x11 0x20`)全部 `err=0x01` **且 `RELAY_CFG` 保持 `0x7F` 不变** ⇒ **"拒绝保留现状、不自动 AllOff"在硬件上确认**
- **C** 挡位 4 个合法值 4/4 回读正确;5 个非独热/0 值全 `err=0x02` 且保持 `0x2` 不变
- **D** busy 抢占:`busy=1` 时再写 ⇒ `err=0x03`,**第二次写未生效**(回读仍是第一次的 `0x00`)
- **E** 稳定延时:设 0 → **0.04 ms**;设 40 → **40.10 ms**;设 100 → **100.09 ms**

### ★★ 12. 本次最有价值的实测发现 —— 一个我自己造的"bug",靠算术当场翻案

阶段 2 第一次跑,稳定延时**系统性偏 1.80×**:设 40 ms 量到 **72.2 ms**、设 100 ms 量到 **180.5 ms**。
第一反应是"RTL 的 `MS_CYCLES` 算错了"。

**但 72.0 / 40 = 1.800,而 50 / 27.7778 = 1.800。**
`CLK_FREQ_HZ = 50_000_000` 是对的(RTL 无误)—— **是我的测试脚本在 `Overlay()` 之后没调 `apply_fclk0()`**,
于是 PL 实际跑在 **BOOT.BIN 留下的 27.78 MHz**,2 000 000 个计数器拍自然被拉成 72 ms。
补上 `apply_fclk0(50)` 后 → **40.10 / 100.09 ms**,精确。

📌 **这条顺带成了 FCLK0 的第三个独立测量**(前两个:寄存器解码、帧率法):

| 条件 | 2 000 000 拍实测 | 反推时钟 |
|---|---|---|
| `Overlay()` 后直接量 | **72.0 ms** | **27.78 MHz** |
| 补 `apply_fclk0(50)` 后 | **40.1 ms** | **49.9 MHz** |

⇒ **比值 72.0/40.1 = 1.796,与 50/27.78 = 1.800 吻合**;两个绝对值和它们的比**同时对上**,
比单点测量强。⚠️ 而且它是**计数器法** —— 与寄存器解码、帧率法**机理完全无关**。

📌 **可复用处方**:`Overlay()` 会复位 `FPGA0_CLK_CTRL`,**任何**加载 overlay 的脚本
(含一次性调试脚本)都必须在**之后**重设。主流程无此问题 ——
`main.py:92` 有 `apply_fclk0()`,且 `c_ui` 源码实测**不碰** SLCR(只在注释里写明"放行由 Python 侧做")。

## 沉淀

→ `skill/stale-artifact-silent-reuse/`(**形态 3 补强** —— 本次补齐了
「Plan A 清缓存已证伪」与「`update_module_reference` rc=1 且 errorInfo 为空」两条实测)

→ 🆕 建议新建 `skill/silent-tool-failure/`:**同一类失败在这次出现了 4 种形态** ——
① 命令 `rc=1` 而 `errorInfo` 为空;② 错误被 `catch` 吞掉、现象延迟 5 步才出现;
③ 命令**成功**了(写文件/返回码 0)但**需要的副作用没发生**(file 引用没登记);
④ **自以为是 0 的 grep 模式**把"格式假设错误"报成"不存在"。
四者的共同处方:**不看命令返回值,看被改变的那份东西本身**
(回读引脚表 / 回读 net 成员 / 回读 wrapper 文件内容)。

---

## 附:本次的"偏离"清单(给报告 B06 / M10 用)

| # | 清单 §2.1 R6 原写 | 实际实现 | 依据 | 方向 |
|---|---|---|---|---|
| 1 | 先断后合 | **原子翻转,不插中间态** | PL 里 7 位同拍,瞬态不存在;前序 `relay_controller.c` 明确不插 AllOff | **规格与 PL 相反** |
| 2 | 稳定时间单位 = 周期数 | **毫秒** | 40 ms = 2×10⁶ 拍 > 16 位上限 | 位宽约束 |
| 3 | `relay[7:0]` 8 位 | **`relay[6:0]` 7 位** | 物理上只有 7 只继电器;`bit7=1` 恒判非法 | 实际接线 |
| 4 | 物理黑名单(栅极浮空 / 挡位电阻短路) | **组合白名单(7 个)** | 黑名单判据需要治具原理图,**手头没有**;白名单出处 = 前序硬件已验证的 `relay_matrix.c` | 判据可得性 |
