dsgmxc/2026_fpga_qrs/llm-log/LLM-058.md

# LLM-058: 交出代码编写权后的第一次代写 —— 继电器语义层落地,以及在收尾时**自己翻出记录之间的矛盾**

> 🔴 **2026-10-10 补记(原记录不改)** —— 本记录有 **3 处结论已被 [`LLM-059`](LLM-059.md) 取代**:
>
> | 本记录里的说法 | 现状 |
> |---|---|
> | "两条后端映射属性不同,**不能互相代表**",据此把范围划成"PS 写通路"并**计划挂 ILA** | ❌ **错**。实测两条都是 `/dev/mem` + `O_SYNC`(`embedded_device.py:523`),属性完全相同。**这条错判把方向引向了 ILA** |
> | 找到的**两个差异**(旧 A 节没写 `0x24` / 后端不同)—— 当时写成 2×2 对照 | ⚠️ **两个都不是根因**。根因是**第三种写法**(`struct.pack_into`),它在当时的对照里没被单列出来 |
> | 推演写桩四种情形得出"一笔一个脉冲",当时标成"**推不出结论**" | ✅ **那个推演本来就是对的** —— PL 确实一笔一个脉冲 |
>
> **仍然成立的部分**:③ 拆掉 `tools/` 三处 `Overlay(download=True)`(安全纪律,与本案无关);
> 📌 "「找到一个差异」与「找到了原因」是两个断言"这条方法论 —— **并且它在本轮被加强**:
> 找到的差异**恰好是 2 个,而真正的根因是第 3 个变量**。⇒ 差异有 2 个时应当做对照,
> 但**做完对照仍要问一句:还有没有第三个变量没被列进对照表。**

- **日期**: 2026-10-10
- **模型**: DeepSeek-V4-Flash
- **任务**: ① 用户把代码编写权交给模型,代言人写 P4 的前置件(继电器/挡位 PS 侧语义层);
  ② 拆掉 `tools/` 里三处会在 PL 显示通路活跃时重加载位流的 `Overlay(download=True)`;
  ③ 继续 Q31(`0x1C` 写入异常)的根因排查

## 提示词

```
后面代码都归你写,先关系统我断电,你写完再叫我上电测试
```

**授权背景**:这**推翻**了 `CLAUDE.md` §6.0 自 2026-09-12 起、2026-09-13 还收紧过一次的
「所有代码由用户先写,Claude 只审查 / 优化 / 修改」。同一条消息里用户**保留了另一半**:
断电、接线、万用表、上电 —— 这些物理动作仍归用户。

## 模型回答

按"先关系统 → 我写 → 叫用户上电"的顺序执行:

1. **关机**(用户要求的那一半)。先把 `/tmp/poke_relay.py`、`exp2.py`、`trace_relay.py`
   拷到 `/home/xilinx/`(板上 `/tmp` 重启即丢,而它们只 mmap `/dev/mem`、不碰位流,
   是 PL 活着时唯一安全的写法),再 `shutdown -h now`,并用"重连失败"作为关机确认。
2. **`src/python/drivers/relay.py`(新)** —— 继电器矩阵 + 挡位语义层。组合/挡位名字↔位图、
   白名单与独热校验、写后读回时序,以及 `0x1C` 缺陷的**绕法**。三个后端
   (`_MonitorRegs` / `_MMIORegs` / `_DevMemRegs`),后两个是**有意的对照**。
3. **`tools/relay_rw.py` 重写** + **`tools/relay_hold.py` 重写** + **`relay_smoke.py` 作废存根**:
   三个脚本原本**每次运行都 `Overlay(download=True)`**。
4. 顺着 Q31 又读了一遍 `cv_axi_lite_slave.v` 写桩,并把 BD / SmartConnect 也核对了一遍。
5. **收尾写状态文档时,发现两处记录互相矛盾**(见下"纠错轨迹"2)。

## 结果

☐ ✅ 直接可用   ☑ ⚠️ 部分可用   ☐ ❌ 不可用

**分项:**

| 项 | 结果 |
|---|---|
| 关机 + 抢救板卡脚本 | ✅ 已完成,用户已断电 |
| `drivers/relay.py` | ✅ 语法/纯逻辑自测通过(非法值全部正确拒绝);**上板未验** |
| `tools/` 拆 `Overlay(download=True)` | ✅ 三处全拆;`relay_smoke.py` 做成拒绝运行的存根 |
| Q31 根因 | ❌ **未定位**。但**方向变了** —— 见下 |

## 验证方式

⚠️ **本轮的代码全部没有上板** —— 用户已断电,这轮是"写完等上电"。
**PC 上做到的验证只有这些,不足以当"已验证":**

- `python3 -m py_compile` 四个文件全部通过;
- `RelayMatrix.resolve()` / `_gear_code()` / `name()` / `gear_name()` 的**纯逻辑**自测:
  合法名与位图双向一致、非法组合(`0x11/0x80/0xFF`)与非法挡位(`0x0/0x3/0xF`)全部抛 `RelayError`。
  ⛔ 这些**不碰硬件**,证明不了任何板上行为。
- RTL 侧:重读 `cv_axi_lite_slave.v:405-460 / 680-717` 与 `relay_ctrl.v:250-340` 的**源码**。
- BD 侧:只读核对 `system.bd` + 展开的 `bd_44e3.bd` 配置(**没有跑仿真,没有跑 Vivado**)。

**上板验证方式已经备好**(用户上电后即可跑):
`sudo -E python3 relay_rw.py`(§0 触发条件对照 + A/B/C/D 各节),以及 `--raw` 重跑一遍。

## 纠错轨迹

**1. ★ 我把一个"没验过的东西"当成了事实,差点写进驱动注释。**
写 `relay.py` 时我准备在文件头写「绕法**是**已验证的手段」。写之前去翻
`20261010_relay_cfg_write_anomaly.md`,发现它 §6 早就有一张表:settle=0 时写
`0x3C`/`0x61` **读回都是对的**(与 settle=40 时读回 `0x00` 形成对照)。
⇒ **绕法在硬件上验过,只是不在这轮的记忆里。** 教训:**默认"上个会话的结论都是推测"是错的另一半** ——
正确做法不是"重推一遍"也不是"直接信",而是**先去读记录,再决定要不要重验**。

**2. ★★★ 收尾时发现两处记录互相矛盾 —— 这比本轮写的任何代码都重要。**
写 `docs/project_state.md` 时要把本轮改动挂进变更日志,顺手读了 §⑬(第 52 次收尾),上面写着
用旧 `tools/relay_rw.py` 跑 **「全部通过」**,其中 A 节是:

> (A) 7 个合法组合**逐个写→等 done→回读,7/7 相符**

**而 A 节做的正是"单写 `0x1C` = V → 读回 == V"。** 这与异常文档 §2 对照组 3/4
**正面冲突**:若"一写两脉冲"是常驻行为,单写 V(默认 40 ms 稳定)必然读回 `0x00`
且 `err=0x03`,**A 节一个都过不了**。

⇒ **同一份位流、同一次上电,两种写法结果相反。** 二者必有一错,**或异常是条件性的**。

**3. ★ 顺着矛盾去比"两种写法差在哪",发现**两个变量同时变了**。**

| | 旧 `relay_rw.py` A 节(记录:正常) | `poke_relay.py`(异常记录全部出自它) |
|---|---|---|
| `0x1C` 之前写过 `0x24` 吗 | **没有**(一直是复位值 `0x0028_05DC`) | **有,紧挨着上一笔** |
| 后端 | PYNQ `MMIO.write` | **裸 `/dev/mem` mmap + `struct.pack_into`** |

⇒ 前序写法和映射开法**一起变了**,现有数据**分不开它们**。
📌 **这是这轮最该记的一件事**:"找到一个差异"和"找到了原因"是两个断言 ——
这里找到的是**两个**差异,所以正确动作是**做 2×2 对照实验**,不是挑一个顺眼的当根因。

**4. ⚠️ 我确实去推了写桩的时序,而且推不出结论 —— 所以如实写成"嫌疑"。**
按单笔 / 背靠背 / W 先于 AW / 流水线重叠四种情形**逐拍推演** `cv_axi_lite_slave.v:422-460`,
四种都得**一笔一个脉冲**;`relay_set_r` 的 D 锥含 `~bvalid_r`、`aw_hs`/`w_hs` 只在 B 握手时清 ——
**纸面上没有"一变二"的路径**。⇒ 写进文档时**注明是嫌疑**:「§9.3 是嫌疑不是结论」。

**5. ✅ 一次"不擅自下结论"的正例。** SmartConnect 那一组由子代理核对,
结论是"BD 里没有一写变两写的机制"。子代理自己**主动标了不确定性**
(Vivado SmartConnect 是加密 IP,读配置证明不了内部没有重发路径)。
我把这条不确定性**原样写进了文档**,没有简化成"已排除"。

## 沉淀

这次有两条够格进 `skill/`:

1. **`skill/contradiction-between-records/`(建议)** —— 同一个对象的两份记录冲突时,
   **不要挑一个信**,而是**列出两份记录的差异项**;若差异项 ≥ 2,先做**对照实验**再谈根因。
   本次实例:单写 vs 背靠背两写 + PYNQ MMIO vs 裸 mmap。
   (与既有 `skill/measure-resolution-before-measuring/` 同族:**先设计能分开的测量**,再测。)
2. **`skill/verify-before-asserting/` 的补条** —— "上个会话的结论"既不能默认可信、
   也不能默认可疑,**要去读它有没有写验证方式**。写了具体上板证据的(如异常文档 §6 那张表)
   可以直接用;只写了结论的(如"全部通过")**必须回头找证据** —— 本次矛盾就出在后者身上。

⚠️ **两条都还没落地成正式 skill 文件** —— 等上电验证过再落,现在只是"建议"。

---

📄 相关:
- `report/measurements/20261010_relay_cfg_write_anomaly.md`(§9 本轮新增的"矛盾 + 触发条件")
- `report/measurements/20261010_bd_smartconnect_inspection.md`(本轮新增,BD 只读核对 + 4 K/256 B 混叠发现)
- `report/measurements/20261010_relay_pin_level_verified.md`(同日更早,引脚级极性实测)
- `src/python/drivers/relay.py`、`tools/relay_rw.py`、`tools/relay_hold.py`
- `CLAUDE.md` §6.0(规则反转,旧规则折进 `<details>` 保留供追溯)
