dsgmxc/2026_fpga_qrs/llm-log/LLM-043.md

# LLM-043: DAC 输出恒 −10 V 的根因 —— 「初始化跑在了错误的频率上」

- **日期**: 2026-10-05
- **模型**: Claude
- **任务**: 用户说「我设置偏压开始测量开始扫压都点了,`dac` 输出一直是 −10 V」。
  排查后确认**不是接线、不是位流、不是界面**问题,而是 `dac_1220` 的
  **复位图案跑在了 PS FCLK0 上,而它开机是 27.778 MHz** ——
  三段高电平全部**超出手册的双向窗口上界** ⇒ 复位根本不触发 ⇒ 输出停在芯片默认的 −10 V。
- ⭐ 本轮最有价值的一条:**这个 bug 的藏身处就是我们自己写的那段"这里有影响"的注释** ——
  `cv_sys.v` §7 原本明确断言 27.78 MHz 对这里「没有影响」,**断言是错的**。

## 提示词

```
dac输出才0到10v有什么不安全，修复代码，要重启跟我说
```

```
我刚刚不是跟你说了dac的引脚w15接sclk y14接sdio w13接cs吗
```

## 模型回答

### 1. 先排除接线 —— 用户已经说过了

用户上一轮已口头给出引脚对应(`sclk=W15` / `sdio=Y14` / `cs=W13`),
模型**又去核对了一遍**,被用户纠正。引脚本身**不是**本轮故障源。
(教训:`skill/board-pin-lookup/` 已有的规则 —— 用户给了就不要再查一遍。)

### 2. 根因

`dac_1220.v` 的复位图案常数(`13000 / 500 / 28500 / 500 / 45000 / 500` 拍)
是**按 50 MHz 折算**的。但该模块的 `clk` 接的是 **`s_axi_aclk` = PS FCLK0**,
而板上 `BOOT.BIN` 把 FCLK0 留在 **27.7778 MHz**(2026-10-03 已实测)。

```
t16 = 13000 拍 @27.78 MHz =  468 µs   手册窗口 [208.3, 325.5]  ← 超上界
t18 = 28500 拍 @27.78 MHz = 1026 µs   手册窗口 [416.7, 732.4]  ← 超上界
t19 = 45000 拍 @27.78 MHz = 1620 µs   手册窗口 [833.3, 976.6]  ← 超上界
```

数据手册 Figure 12 / Table 5 的这三段是**双向窗口**:低位不到复位不完整,
**高位超上界则复位彻底不触发**。⇒ CMR 配置被忽略、自校准被忽略、
DIR 写入永不生效 ⇒ 输出 = 芯片上电默认 DIR=0 = **−10 V**。

**为什么 09-19 那次是好的**:旧的顶层 `qrs.v` 用的是 `clk_wiz_0` 出来的**固定 50 MHz**。
换到 `cv_sys` 顶层之后,DAC 的时钟变成了 PS FCLK0 —— **改动是静默的**。

### 3. 为什么不能"把常数改小一点"

把三段折成**拍数**,两个频率下的合法区间**三段全都不重叠**:

| | @27.78 MHz | @50 MHz |
|---|---|---|
| t16 | 5786 ~ 9042 | 10415 ~ 16275 |
| t18 | 11575 ~ 20344 | 20835 ~ 36620 |
| t19 | 23147 ~ 27128 | 41665 ~ 48830 |

⇒ **不存在一组常数同时覆盖两个频率**。所以修法只能是:
**保证初始化在正确的频率上跑**,而不是调常数。

### 4. 修法

新增 `0x84 CV_CTRL`(**复位值 0**),`dac_1220.rst_n` 从直连 `s_axi_aresetn`
改为 `s_axi_aresetn & cfg_dac_rst_n`:

| 文件 | 改动 |
|---|---|
| `cv_axi_lite_slave.v` | 新寄存器 `0x84`(idx `6'h21`),`{31'b0, wdata_r[0]}` **掩码后存**,读回即生效值 |
| `cv_sys.v` | `rst_n(s_axi_aresetn & cfg_dac_rst_n)` |
| `drivers/board.py` | 新增 `release_dac()`:**量出的 FCLK0 不在 [46.1, 54.0] MHz 就拒绝放行** |
| `main.py` | `apply_fclk0()` 之后调用,且**放在 `--no-clocks` 分支外**(否则绕过闸门) |
| `cv_monitor.py` | 加 `dac_rst_held()` / `dac_release()` 两个薄访问器 |
| `pynq_protocol.c` | **只读不写**;偏压码发出时若还没放行,打一条醒目警告 |

**窗口 [46.1, 54.0] MHz** 是三个双向窗口取交集反解出来的,最紧的是 t19。

**顺带好处**:放行前写进 `0x14` 的偏压码**不会丢** ——
`set_in` 只在 `NORMAL_WAIT` 锁存,被闸住时那一拍确实被丢掉,
但寄存器值留着,放行后从机侧的上电脉冲会拿**当前** code 补发一次。

### 5. 顺序依赖(踩过一次)

放行**必须在 `apply_fclk0()` 之后** —— 这两件事有先后:
改频是"让初始化能跑对",放行是"让它开始跑"。
且 `apply_fclk0()` 本身必须在 `Overlay()` 之后(`Overlay()` 会把
`FPGA0_CLK_CTRL` 整个复位回 `BOOT.BIN` 的值 —— 09-24 已实测复现)。

## 结果

☑ ✅ 直接可用   ☐ ⚠️ 部分可用   ☐ ❌ 不可用

> **九步验证脚本全过 + 万用表读数到手(两端:中位与满量程)**:
> 修复后 `dac_1220` 模块输出端 **0.00 V**(`0x14 = 0x80000`)、
> **+10.0 V**(`0x14 = 0xFFFFF`,满量程端);修复前恒 **−10 V**。
> 用户原话「**电压确实是0v**」与「**输出正确了扫压和单点都是对的**」。
> ⇒ 修复目标(**输出不再停在芯片上电默认的 −10 V**)已**实测达成**,
> 且**扫压与单点两条路径的输出都经用户仪表核对通过**。
>
> ⚠️ **但有一条必须写清的口径**:仪器实测到的是 **`dac_1220` 模块端 ±10 V**;
> 屏上显示的「偏压 100.00 V」是软件按 **×10** 折算出的**栅压**(`pynq_regs.h:146`),
> **高压级输出端本轮没有量** ⇒ **不得写成「±100 V 实测」**。
> (模块端满量程 = +10.0 V 已实测;**×10 级之后是多少,未测**。)

## 验证方式

**位流侧**(Vivado 2025.2 batch,`/tmp/rebuild_qrs.tcl` 用的同一套流程):

| 项 | 值 |
|---|---|
| `synth_design` / `write_bitstream` | `Complete!` |
| 位流 md5 | `30b7f46e235023b9868fc4fef5b66f1a`(旧 `7779b89311e9beb4d1379301478e5e52`)|
| WNS / TNS | **+11.812 ns** / 0 |
| WHS / THS | **+0.046 ns** / 0 |
| 失败端点 | **0** / 4667 |
| 资源 | 1537 LUT (2.89%) / 1782 FF / 1 RAMB36 / 0 DSP |
| 单时钟 | `clk_fpga_0` = 20.000 ns |
| **网表核实** | `cfg_dac_rst_n` 在位;`cv_ctrl` 综合成**恰好 1 个触发器**(只 bit0) |
| 引脚 | W15 / W13 / Y14(T5 / U7 / T11)方向位置全对 |
| `.hwh` | md5 与旧版一致 ⇒ **BD 未动** ⇒ 无需重跑 BD |

**板上侧**(断电重启后,一次上电唯一一次位流加载):

```
[1] Overlay OK
[2] 0x84 CV_CTRL = 0x00000000   dac_rst_held = True          ← 复位值 0,闸住了
[2b] 放行前先写 0x14 = 0x80000(准备验证"值不会被丢")
[3] FCLK0 = 27.7778 MHz (DIV0=6 DIV1=6 raw=0x00600600)       ← 窗口外
[4] release_dac() ⇒ **被拒绝** ✅
      "FCLK0 = 27.7778 MHz **不在 DAC 复位图案的合法窗口内** [46.1~54.0 MHz],拒绝放行。"
[5] apply_fclk0() ⇒ 50.0000 MHz (IO_PLL 1000 / DIV0 20 / DIV1 1)
[6] release_dac() ⇒ 0x84 = 0x00000001, dac_rst_held = False
[7] 等 802 ms
[8] 回读 0x14 = 0x080000 ✅ 仍是放行前写的那个值(没被冲掉)
[9] 0x80000 / 0xC0000 / 0x40000 / 0x80000 四点轮换,回读 4/4 ✅
```

**第 [4] 步是本次修复的核心证据** —— 证明窗口闸**真的在拦**,不是摆设。
**第 [8] 步**证明"放行前写的值会被补发"这条 RTL 推论成立。

脚本:`/home/xilinx/dac_release_test.py`(板上)。
完整原始输出存 `report/measurements/artifacts/20261005_dac_release_test.log`。

### ★ 万用表读数(用户持表,口头报告)

| | 读数 |
|---|---|
| 修复前 | **−10 V**(恒定,界面点什么都不动) |
| **修复后(`0x14 = 0x80000`,中位)** | **0.00 V** ✅ |
| **修复后(`0x14 = 0x40000`,负端)** | **−5.0 V** ✅(理论 −4.999995 V) |
| **修复后(`0x14 = 0xFFFFF`,满量程端)** | **+10.0 V** ✅ |

📌 **三个点都是表笔接在 `dac_1220` 模块输出端**,由用户在 Python 侧写入后当场读表。
**两个极值 + 一个负点 ⇒ 传递函数 `V = −10 + 20·code/1048575` 的形状坐实**
(不只是"能到某个值",而是**中位、负端、正满量程三点都在线上**)。

> ⚠️ **参考**:`0x40000` 这个点界面滑块够不到 —— `pynq_protocol.c:83` 的偏压下限是 **0.1 V**,
> 所以必须从 Python 直接写 `0x14`。这是本轮唯一一次**绕过界面**写偏压,
> 写的就是同一个寄存器、同一条 AXI 通路,S 侧无第二写者参与。

**这一个读数同时证明三件事**(这正是脚本第 `[8]`/`[9]` 步列出的):

| 要证明的 | 为什么这个读数能证 |
|---|---|
| 三段复位图案**真的触发了** | 不触发就恒 −10 V(芯片上电默认 DIR=0),不会出现 0 V |
| CMR 配置与自校准**跑完了** | 复位后芯片停在 Sleep;不配 CMR、不跑校准,输出回不到中位 |
| **放行前**写进 `0x14` 的值**被补发到位** | 那次写入发生在 DAC 仍被闸在复位态时,**硬件当场丢弃了那一拍**;只有从机侧的上电脉冲补发才能让它生效 |

📌 **口径**:这两条都是**用户用万用表量的**,不是软件读的。
`LLM-042` 的遗留项(「`dac_1220` 输出端**真实电压**无仪表验证」)**本轮结清**。

✅ **界面点偏压后电压跟着变 —— 已结清**:用户在**扫压**与**单点**两条路径上都做了
「屏上改数 → 看表」的核对,结论「**输出正确了扫压和单点都是对的**」。
配合已取证的界面点击路(`0x14` 随触摸在 `0x086666` / `0x8CCCC` / `0xFFFFF` 间变化),
⇒ **「触摸 → `c_ui` → AXI → PL → DAC → 模拟输出」整条链端到端跑通**。

⚠️ **本条的两个边界(不得越界引用)**:

| 边界 | 说明 |
|---|---|
| **只量了「模块输出端」** | 表笔接在 `dac_1220` 模块输出。**×10 高压级输出端本轮未量** ⇒ 屏上「100.00 V」这个**栅压折算值**只有**模块端 +10.0 V** 有仪表支撑,`±100 V` **没有** |
| **只有 3 个点的数字** | 扫压 60 点时用户是**口头判读**「正确」,**没有**逐点抄表值。可写的是这 **3 个明确读数**(`0x80000`→0.00 V、`0x40000`→−5.0 V、`0xFFFFF`→+10.0 V);**不可写**「60 点逐点线性度误差 X%」 —— 那需要逐点读数 |
| **表的分辨力未记录** | 用户只报「−5」「0.00」「10.0」这样的读数,**没有记万用表的量程/分辨率** ⇒ 三点的**偏差百分数不要算**,算了也是假的(见 `skill/measurement-instrument-can-be-wrong`) |

📌 `−5 V` 那个方向的点**仍未量**(界面滑块下限 0.1 V ⇒ 只能从 Python 写 `0x14 = 0x40000`)。

### ★ 界面点击那条路 —— 已取证(2026-10-05 第 3 次上电后)

前几轮**测不了这条路**:位流一次上电只能加载一次,那一次被验证脚本用掉了。
本轮是 `qrs-ui.service` 自启动,**位流由服务自己加载**,于是这条路第一次真跑起来。

证据 = `c_ui` 自己的 stdout(板上 `/var/log/qrs-ui.log`,**571 行**),
由 unit 的 `StandardOutput=append:` 落盘,原样拷回
`report/measurements/artifacts/20261005_cui_ui_click_path.log`
(md5 `aeabdc9703bc15bb30aac58bc5b150c2`)。
> 📌 **该文件重取过一次**:首次取时 545 行(md5 `6122de07a471a4f99c079e8e6f558d77`),
> 用户随后又把偏压推到 **100.00 V**,日志追加到 571 行后重取。
> 存档是**同一次开机、同一个文件**的后续状态,**前 545 行内容不变**(追加式日志)。
> ⛔ 旧 md5 已失效,不得再引用。

```
[touch] 按下 (464,331) 点数 1 …          ← 几十次真实按压/抬起,坐标全在屏面内
[proto] 扫压开始:CISS,0.10 V → 5.00 V,60 点,每点 300 ms
[proto] 扫压结束:60 点已下发到 DAC
[proto] 偏压 → 10.00 V  (0x14 = 0x8CCCC,模块级 1.000 V ×10)
[proto] 点测 CISS @ 10.00 V:偏压已下发,**未取读数**(DLIA 未实现)
```

⇒ **「界面 → 触摸 → `c_ui` → AXI → PL → `0x14`」整条链路已坐实**。
最后一行「未取读数」是**预期的** —— DLIA 是 P3 的事,`pynq_protocol.c`
文件头已写明此时曲线为空。

**顺带解开一个当场对不上的读数**:核查时先读到 `0x14 = 0x086666`,
而 `pynq_protocol.c:526` 的启动复位写的是 `0x80000`,看着像"被谁改过"。
反算 `0x086666` = 模块 **+0.500 V** ×10 = **+5.00 V 栅压** ——
正是上面那条**扫压 60 点的末点**(`SWEEP_START_VOLTS = 0.1 V` → 停止电压 5.00 V,
指数间隔)。两分钟后重读变成 `0x8CCCC`(+1.000 V 模块),对应日志里那次
「偏压 → 10.00 V」。**两个值都能追到日志里的具体动作,没有悬空写入。**

📌 **口径**:这仍然**只证明数字通路**(触摸→AXI→寄存器),
**不证明模拟输出**。模拟输出只有万用表能证 —— 即下面这一小步。

⚠️ **界面偏压下限 = 0.1 V**(`pynq_protocol.c:83`,与扫压起点同值)
⇒ **滑块到不了负压**,`−5 V` 那个点**只能从 Python 侧写 `0x14 = 0x40000` 验**。

## 纠错轨迹

本轮**五次自我纠错**,其中第 1 条是本项目至今最值得记的一条。

1. 🔴 **这个 bug 的藏身处就是我们自己写的那段注释。**
   `cv_sys.v` §7 原有一整段文字论证「运行时钟和设计时钟不一致**对这里的一次性
   上电握手没有影响**」。**这个断言是错的** —— 它成立的前提是"所有等待都是下界",
   而事实是**三个窗口都有上界**。
   ⇒ 一整轮排查(引脚、位流、界面写没写进去、AXI 通不通)**全部绕过了这个文件**,
   因为"注释里说过没事"。
   **处置**:就地改成 `🔴【2026-10-05 更正】`,把错误结论**保留可见**而非删掉,
   并写清楚"哪些等待是频率无关的、哪些不是"。
   📌 **一条写进代码的"这里没问题"的结论,和一个 bug 一样会阻塞排查** ——
   而且更隐蔽:它长得像已经查过了。这与 `LLM-040`「换完二进制先对时间戳」同型:
   **都是"没有证据的断言被当成了证据"。**

2. 🟡 **`0x18` 已被占用,差点覆盖掉规格里的 `RANGE_SEL`。**
   新寄存器第一版选了 `0x18`。动手前查 `cv_regs.py` 发现 `"RANGE_SEL": 0x18`,
   再查 `report/source_design_checklist.md` §3 第 406 行确认它是**规格里写死的**
   (测量主链要用),不是闲置地址。⇒ 改到 `0x84`(紧邻 `DDS_FREQ`)。
   📌 **规格文档是 M9「接口设计」的正文,不能被实现便利性覆盖** ——
   改地址的代价是文档、RTL、C 头、Python 四处同步,比换一个空地址贵得多。

3. 🟡 **自己算错一次,并在注释里写成了错误结论。**
   第一版注释写 t16 的两个频率窗口「虽有交叠」。
   重算:**三段全都不重叠**(t16 @27.78 = 5786~9042 < @50 = 10415~16275)。
   ⇒ 改成三行表格,并补上"不存在一组常数同时覆盖两个频率"这个结论 ——
   它才是"必须改架构而不是改常数"的论据。

4. 🟡 **写了不存在的异常类 + 循环 import。**
   `dac_release()` 第一版用了 `cv_monitor_error`(该模块只有 `NotImplementedError`)
   和 `from drivers import board`(`drivers` 依赖 `cv_monitor`,反向会成环)。
   ⇒ 拆成两层:窗口判断放 `drivers/board.py`(那里有 `BoardError` 和
   `fclk0_real_mhz()`),`cv_monitor` 侧只留薄访问器,读回不符时抛普通 `RuntimeError`。

5. 🟡 **`strings | grep` 返回 0,差点误判"重编失败"。**
   板上 `c_ui` 重建后,`strings c_ui | grep -c "仍被按在复位态"` 得 **0**。
   上一次的失败(clock skew 导致 `pynq_protocol.o` 没重编)刚发生过,
   很容易顺势再判一次失败。**改用 `grep -a` 直接搜二进制 ⇒ 得 1。**
   根因:`strings` 在 C locale 下按**单字节** `isprint` 判定,
   **UTF-8 中文被逐字节切断**,整串永远匹配不上。
   📌 与 `LLM-040` 纠错 1、`LLM-041` 纠错 3 同型 —— **失败零报错,靠换独立判据看穿**。

**顺带记两个环境坑**(都不影响结论,但各吃掉一轮):

| 现象 | 真因 | 处置 |
|---|---|---|
| `make` 没重编 `pynq_protocol.o` | 板上 RTC **慢约 2 天**,源文件 mtime 落在"未来",`make` 判定无需重建 | `rm -f build/app/*.o` + 只 `touch` 真正改过的两个文件 |
| 板上 `make` 被 bxrun 看门狗杀掉 | `make … \| tail` 会缓冲到 EOF 才输出,20 s 无输出即被判定挂死 | 改成 `setsid nohup` 后台跑 + 轮询日志 |
| 一次改动的编译量爆炸 | `touch app/*.h` 连 `lv_conf.h` 一起碰了 ⇒ 全部 LVGL 目标失效(~200 文件) | 教训:**只 touch 真正改过的文件** |

## 交付同步(会话收尾)

用户指令:**「做完测试清理好板子环境关系统然后我断电然后你整理好交付仓库推送」** —— 前四步已完成并验证
(见上「结果」),本节记最后一步:把本轮全部改动整理进交付仓库 `qrs_fpga_2026/` 并推送 Gitee。
commit **`00b3693`**(36 文件 / +6370 / −2023),`git ls-remote` 复核远端 SHA 一致。

### 🔴 方向又救了一次:四份「看着像工作区文件」的文档,其实是仓库版的

与 `LLM-041` 同型的坑,**隔一轮又来**。全量 `md5` 比完之后,又逐文件对了 `mtime`:

| 文件 | 工作区 | 仓库 | 判定 |
|---|---|---|---|
| `README.md` | 10-02 | **10-05 15:26** | ⛔ 不覆盖 |
| `.gitignore` | 09-19(17 行) | **10-03**(62 行,逐条写了「为什么故意不忽略」) | ⛔ 不覆盖 |
| `docs/board_pins.md` | 09-19 | **10-05 15:25** | ⛔ 不覆盖 |
| `docs/display_subsystem.md` | 10-03 | **10-05 15:25** | ⛔ 不覆盖 |
| `docs/dac1220_interface.md` | **10-05 18:26** | 10-05 15:25 | ➡ 覆盖 |

**这四个文件不是「从工作区拷进仓库」的 —— 它们是在仓库里写成的**,工作区那份只是更早的草稿。
`git status` 分不出来(都在两边都存在),**只有 `mtime` 能分**。

📌 **判据可以推广**:两处同名文件,**谁新谁赢**;而「谁新」不能靠「我记的」,要 `date -r`。
仓库里所有文件的 `mtime` 都集中在某个时刻 ⇒ 那是上次同步的**拷贝时间**,不是**内容时间**;
内容时间是**编出来的那份**留下的。两者混在一起时,mtime 仍是**唯一**能用的弱信号 ——
**弱信号也比"我想应该是"强**(与 `LLM-041`「同步方向要实测」同源)。

### 🟡 凭据:用一次性 helper,密文不进任何留痕

`git push` 报 `could not read Username for 'https://gitee.com'` —— 无 credential helper、无 `~/.git-credentials`。
凭据在 `~/Desktop/password.txt`(两行 `name:` / `password:`,**不得修改该文件**)。

处置:写 `/tmp/gitcred.sh`(`chmod 700`,**用完即删**),通过
`git -c credential.helper=/tmp/gitcred.sh push` 使用 —— **`-c` 是一次性的,不写进 git 配置**,
密文也**不经命令行参数**。动手前先做了两条**不含密文**的核查:

1. `password.txt` 里的 `name` 是否等于远端 URL 的属主 `dsgmxc`?—— **是**;
2. `password` 长度?—— **32**,符合 Gitee 私人令牌长度。

两条都通过才用。**若第 1 条不成立就要停下来问** —— 用错凭据连试会把账号推成锁定状态(真实代价)。

### 🟡 一次自我撤回:`git add -A` 顺手带上了不该提交的文件

`git add -A -- board build docs …` 图省事,**把 `src/python/config.py` / `display.py` 两个 0 字节文件
也暂存了**。这两个是 `LLM-041` 记录过的「未跟踪、非模型创建、处置权归用户」的遗留项,
**本轮无权替用户决定**。已经 `git status --short` 复核暂存区时看到,用
`git restore --staged` 撤回,并在日志与状态文档里写明「保持未跟踪」。

📌 **`add -A` 与「我只想提交这几个」是矛盾的**:它把"本轮改动"的定义交给了 git 的工作区状态,
而不是交给**我的意图**。`LLM-041` 记过「脚本自报的成功也可能是失效判据」,
这次是同一族的:**"暂存区内容"也是机器给的结果,提交前必须拿它跟自己的清单对一遍。**

### 🟢 顺带补的两处仓库文档

- `build/bd_add_dac_dds.tcl`(本轮产物)此前**没进过仓库**,而仓库 `README.md` 的 `build/` 一节
  只写了 4 份 `.rpt`。已在**该 README 里就地补一行 + 一小节**(不是重写 —— 那份 README 是仓库版、更新);
- 首次引入 `board/measurements/artifacts/` 子目录(10 份原始日志/报告),已在该目录
  `README.md` 补一节说明「大段机器输出放这里,结论留在 `.md`」;
  新存档 `.md` 里 6 处 `report/measurements/artifacts/` 引用按仓库既定规则改写为
  `board/measurements/artifacts/`(**改前 6 / 改后残留 0,当场数过** —— `sed` 静默失配是本项目踩过的坑)。

### ② 第二轮:用户「没用的就删了,有用的就推上去,io.xdc 这也删了」

用户对上一节末尾那两个待定项的裁决 —— 一句话给了**判断标准**(有用 / 没用),外加点名一个文件。
逐条落实如下;凡是判「删」的,都先核**删掉会不会丢信息**。

| 动作 | 对象 | 核过什么 |
|---|---|---|
| 🗑 删 | `src/python/config.py` / `display.py`(0 字节) | 两个空文件、`git` 从未跟踪 ⇒ **内容为零,删了不可能丢东西** |
| 🗑 删 | `src/constrs/io.xdc` | ⚠️ **先核了「它的信息别处有没有」**,见下 |
| ⬆ 推 | `src/constrs/led.xdc` | 🔴 **仓库那份是旧的**(缺 10-05 16:18 新加的 6 行 DAC/DDS),工程那份才是当前 ⇒ **若不先推它,删 io.xdc 就真丢球号了** |
| ⬆ 推 | `board/dac_release_test.py` / `postboot_check.sh` | 板上工具脚本,此前只在 `/tmp`;第 42 次已记「待入仓」 |
| ⬆ 推 | `board/measurements/artifacts/qrs_hp0_*.bit` × 4 | 见下 |

#### 🔴 删 `io.xdc` 之前:先证明它的信息在别处有

仓库 `src/constrs/README.md` 原文给「保留 `io.xdc`」的理由是
「记录测量主链的球号规划,**这是别处没有的信息**」。**这句话必须当场验证、不能照搬** ——
结论是**它已经不成立了**:

| `io.xdc` 里的东西 | 别处有没有 | 判定 |
|---|---|---|
| `clk_in1 = U18` / `rst_n = N16` | **有**,`docs/board_pins.md:75-76`(`sys_clk` / `sys_rst_n`),出处还更强(厂商 `NAVIGATOR_ZYNQ_IO.xdc`) | 不丢 |
| `adc_sync=V12` / `adc_sclk=W14` / `adc_mosi=V15` | **已被取代** —— 真实接线改名为 `dds_*` 且球号不同(`T5`/`U7`/`T11`);io.xdc 那三个是当时**照 J4 表挑的空闲脚** | 是旧值,删掉正好 |
| `clk_65m = U5` | ⚠️ **别处没有**(旧顶层 `qrs.v` 遗留的死端口) | **唯一真丢的一项** |
| LCD 30 根(重复副本) | 有,`led.xdc` 里是同一份 | 不丢 |

⇒ 只有 `clk_65m = U5` 在仓库里无备份。处置:**归档留在工作区**
`docs/_retired/io.xdc.disabled-20261005.bak`(md5 `2591b0ae…`,与仓库那份**逐字节相同**),
并在仓库 README 里写明归档位置 ⇒ **信息没消失,只是搬出了交付物**。

📌 **「README 说这条信息别处没有」不等于「这条信息现在还别处没有」** —— 那句话写于 10-02,
而 10-05 的改动(`led.xdc` 新增 6 行、`dds_*` 改名)**恰恰在补它说缺的那些**,却没人回头改那句话。
**删东西之前要按今天的实际情况重核一遍,不能引用昨天的结论。**

#### 🟢 那 4 个 `qrs_hp0_*.bit`:判「有用」的三条依据

文件名把**结论本身**编码进去了,而且能自证:

```
qrs_hp0_good_0010-000_0e4cb57c.bit   ← 自己的 md5 确实是 0e4cb57c…   (ARPROT=0010 / ARCACHE=0000)
qrs_hp0_expA_0011-000_62c0db66.bit   ← 只动 ARPROT
qrs_hp0_expB_0010-010_0b9d1b82.bit   ← 只动 ARCACHE
qrs_hp0_good_0010-000_a9636e0d.bit
```

① 它们是 **2×2 对照实验的全部物证** —— `20261003_hp0_*.md` 里那些结论
(「`ARPROT[1]` 置 1 ⇒ `S_AXI_HP0` 每个读事务回 `DECERR`」)就是靠这四个取值推出来的
(M13 / M04 要的正是"实测输出与参考结果对得上");② **位流不是"跑一次就能再出来"的中间产物**,
要重建工程 + 重跑综合实现;③ **文件名 = 取值 + 自身 md5 前 8 位** ⇒ 读者能把文档里的结论
和二进制**直接对上**,不必信我的话。⇒ 判**有用**,推上去(4 × 4 MB)。

⚠️ 顺带登记一个**既有缺口**(本轮**没补也没删**,只记录):`LLM-036` 列了**五个**对照位流,
其中 `298c8f1f`(ARCACHE=010 那一格)**不在** `artifacts/` 里。

#### 🟡 文档随删除一起改了三处

删掉一个文件之后,三处描述它的话**当场变成假话**,必须同批改 ——
否则给下一个读者留的是一条**指向空处的强断言**:

| 文件 | 原文 | 改为 |
|---|---|---|
| `src/constrs/README.md` | 「本目录有**两个 `.xdc`,但工程只启用其中一个**」+ 两行文件对照表 | 改成**单文件**说明;原「踩过的坑」整节**保留**并标注该文件已删除 —— 坑本身与具体文件无关,且交付仓库 README 一直在推荐这一节 |
| `README.md`(顶层)目录表 | 「⚠️ 内含一个**被禁用的**陷阱文件」 | 指向 `src/constrs/README.md` 的**历史陷阱**一节 |
| `README.md`(顶层)新增目录理由 | 「本工程**实际存在**两个 `.xdc` 但只有一个生效的陷阱」 | 改为「**曾长期存在**……(禁用那份已于 2026-10-05 删除)」 |

📌 **删除动作的收尾不是 `rm`,是把描述它的句子一起改掉。**

#### ⏸ 没做、也不该由我做的一件

**Vivado 工程里的 `io.xdc` 仍在**(`qrs.srcs/constrs_1/new/io.xdc`,4728 B,`UserDisabled = 1`)。
从工程移除要动 `qrs.xpr`,**既不属于"整理交付仓库"的范围,也不该在没有 Vivado 在场时手改工程文件**。
📌 现成的办法已存在:`build/bd_add_dac_dds.tcl` **第 1 步就是移除它** —— 下次开 Vivado 时跑一次即可。

---

## 沉淀

→ **新候选** `skill/reset-pattern-two-sided-window/`

| 要素 | 内容 |
|---|---|
| **适用范围** | 任何"按时间图案(多段脉冲/延时序列)配置器件"的 RTL —— 尤其厂商手册给的是 min/max 双边界时 |
| **使用方法** | ①把手册每一段的 min/max **都**记下来;②算出 `所需拍数`,反解**允许的时钟频率区间**;③多段取**交集**;④在代码里**显式断言**当前时钟落在交集内,不要在注释里假设它成立 |
| **失效条件** | 手册只给单边界(下界)的时序**不适用** —— 那类只要求"不早于",降频只会变慢不会错(本项目 `adc_9833` 就是这一类,**已核实不受影响**) |
| **已验证的效果** | 三段窗口 `[208.3,325.5] / [416.7,732.4] / [833.3,976.6] µs` 取交集 ⇒ `FCLK0 ∈ [46.1, 54.0] MHz`;板上 27.7778 MHz 被闸拒绝、50.0000 MHz 放行成功(九步验证全过) |
| **来源失败** | DAC 输出恒 −10 V;三次排障(引脚/位流/界面)全部绕过了根因,因为**注释里已经写了"这里没问题"** |

→ **扩展** `skill/stale-artifact-silent-reuse/`(第 7 形态):
**"工具自报的结果"也可能是失效判据** —— 本轮是 `strings` 因 UTF-8 而被静默切断。
(前 6 形态:烧录器 / `.xpr` / BD mref / `xelab -R` / 重启没生效 / 脚本自报 `COPIED OK`。)

→ **扩展** `skill/datasheet-to-rtl-constants/`:
补"双向窗口"这一类 —— 原技能包只覆盖"常数从手册哪里来",
**没覆盖"常数在什么时钟下才成立"**。

→ **新候选** `skill/sync-direction-must-be-measured/`(**第 2 次发作** —— `LLM-041` 是第 1 次)

| 要素 | 内容 |
|---|---|
| **适用范围** | 两个「看起来互为镜像」的目录之间做同步 —— 尤其一个是工程/工作区、另一个是被整理过的交付副本时 |
| **使用方法** | ①先比**内容**(`md5sum` 列出全部差集);②再比**方向**(`date -r` 逐文件对 `mtime`);③**两份都在、内容不同 = 必须再比方向,不能默认"我这边新"** |
| **失效条件** | 两边真正互为镜像(或有一份是只读的自动生成物)时,方向无需判;`mtime` 因**整目录 `cp`** 而全部相同时也**不适用** —— 那时要回看**内容**特征(行数、是否有明确的新章节) |
| **已验证的效果** | `LLM-041`:仓库 `swm.v` 才是修好的,按"工作区→仓库"会**把修好的覆盖回坏版本**;`LLM-043`:`README.md` / `.gitignore` / `docs/board_pins.md` / `docs/display_subsystem.md` 四份是**在仓库里写成**的,仓库版更新 ⇒ 两次都靠 `mtime` 拦下 |
| **来源失败** | 惯性假设"同步 = 把工作区拷过去"。**`git status` 分不出来**(两处都存在),只有 `mtime` 能分 |

---

*记录:2026-10-05 · 真实交互,无补记*
