dsgmxc/2026_fpga_qrs/llm-log/LLM-001.md

# LLM-001: 首批 RTL 模块设计 —— NCO / AD9833 SPI / 继电器控制

- **日期**: 2026-09-12
- **模型**: Claude(Claude Code CLI)
- **任务**: 为 MOSFET C-V 监测平台设计并写出第一批底层 RTL 模块,配套仿真与验证脚本

## 提示词

> 我打算从底层往上写,先写 rtl 部分包括 spi,继电器控制以及 dds 的部分,板块我先用正点原子领航者尝试

后续追加:

> 就认定无频差先这个我不管,dds 是只与 dds 模块成功通信,然后我说的 rtl 就是说纯 fpga 的部分,我已经纯 fpga 跑了一遍 led 验证通路

## 模型回答

摘要:

1. 澄清了 "dds 部分" 的两种可能含义(解调参考 NCO vs 自研 RTL 激励源),确认按前者走
2. 给出三个模块的接口规格与设计要点
3. 产出代码:`nco.v` / `ad9833_spi.v` / `relay_ctrl.v` / `gen_sin_lut.py`
   / `nco_tb.v` / `check_nco.py` / `selfcheck_nco_model.py` / `relay_ctrl_tb.v`
4. 关键设计决策:1/4 波查表 + 象限对称展开;AD9833 的 5 帧上电初始化序列;
   继电器先断后合 + 硬件互锁

完整产出见仓库 `src/rtl/`、`src/python/`、`sim/`。

## 结果

☐ ✅ 直接可用   ☑ ⚠️ 部分可用   ☐ ❌ 不可用

**为什么是"部分可用"**:RTL 代码已出,但**本机没有任何 Verilog 仿真器**
(无 iverilog / verilator / xsim),RTL 一行都没有仿真过。只有 Python 侧
(黄金模型自检、LUT 生成)真正跑通并给出了实测数据。RTL 的正确性目前
**只是设计意图,不是验证结论**。

## 验证方式

| 对象 | 验证方式 | 状态 |
|---|---|---|
| 黄金模型算法 | `python3 sim/selfcheck_nco_model.py` | ✅ **已跑**,与 `math.sin` 最大偏差 25.0 LSB(理论截断上限 50.3 LSB),正交性误差 0.0021% |
| 正弦查找表 | `python3 src/python/gen_sin_lut.py` | ✅ **已跑**,生成 1024 项,峰值 32767 |
| `nco.v` | `sim/nco_tb.v` + `sim/check_nco.py` | ⏸ **未跑** —— 需在装 Vivado 的机器上执行 |
| `relay_ctrl.v` | `sim/relay_ctrl_tb.v` 六场景自检 | ⏸ **未跑** |
| `ad9833_spi.v` | 上板示波器看 SCLK/SDATA/FSYNC 与 1 MHz 输出 | ⏸ **未做** |

判据设计:黄金模型对拍要求**逐点误差严格为 0**。理由写在 `check_nco.py`
的文件头 —— 这是"同一套算法的两种实现",不是模拟电路对拍,没有理由存在偏差。
放宽容差只会掩盖真正的 bug。

## 纠错轨迹

**案例:模型把 AD9833 与 FPGA 的晶振频差问题严重高估了**

1. **模型错在哪**
   在早期讨论中,模型判断 AD9833 的独立板载晶振与 FPGA 晶振之间存在
   最坏 100 ppm 频差,断言这"会让测量结果不可用",并据此建议更换激励方案。

2. **怎么发现的**
   用户追问"为什么不能改晶振",模型重新推导解调输出的解析式:

   ```
   P = (A/2) · sinc(Δf·T) · e^{j(πΔf·T + φ)}
   ```

   发现这个含 Δf 的公共因子对**两路通道完全相同**(同一个 Δf、同一个积分窗 T),
   而本项目用的是**比值测量** `Z = R_ref · V_A / (V_src − V_A)`,
   两路相量一除,频差影响**精确抵消**。

3. **怎么改的**
   模型明确承认前一次判断错误("我原本判断这会毁掉测量 —— 重新推导后,
   结论要修正"),给出完整推导,并把结论从"不可用"改为:

   - 频差在比值中约掉 → **不影响阻抗测量**
   - 真实代价是 `sinc(Δf·T)` 的 SNR 损失
   - 由此导出真正的约束:**积分窗 T ≤ 1 ms**
   - 映射到设计参数:f_s = 20 MSPS → R = 20000 抽取值 → CIC N=2 时位宽 41 bit

4. **改完还有没有问题**
   有,而且要说清楚:**这次仍然只是理论推导,没有实测支撑**。
   推导里用的 ±50 ppm 是数据手册估算值,不是实测值。已在
   `docs/project_state.md` §六标注为"交付前必须补:频率计实测两晶振频差"。

   另:用户已决定暂缓处理频差(决策 D15),先按"认定无频差"推进主链路。
   这个暂缓是合理的排期选择,但**报告里 D11 的论证不能只停留在公式**,
   否则"我们用比值法消掉了频差"这句话经不起评委追问。

## 沉淀

本次产出的验证方法论 —— **先验证黄金模型自身,再拿它当基准对拍 RTL** —— 是
一条与具体题目无关的通用经验,值得进技能包。

→ 待提炼为 `skill/golden-model-first/`
   (候选通用 Skill:`golden-compare-script` —— 目前形态还是本项目的
   `check_nco.py`,需要抽象成"参数化 + 可复用到其他模块"才能算通用)

---

*记录人:Claude · 记录时间:2026-09-12*
