dsgmxc/2026_fpga_qrs/llm-log/LLM-017.md

# LLM-017:AD9833 上板首测「500 mV 直流」排障 —— 供电 / CLK 语义 / 输出频率核定

- **日期**: 2026-09-20
- **模型**: Claude (Claude Code)
- **任务**: `adc_9833` 接入 `qrs.v` 后**首次上板**。用户报告输出异常,
  依次追问:① 板子供电是不是 5 V;② 模块上的 `CLK` 是不是 `SCLK`;③ 当前设置该出什么频率。
  本条记录覆盖这三问 + **「500 mV 直流」的排障过程**。
- **⚠️ 本次全程零代码运行** —— 无仿真、无综合、无上板操作。**结论均为静态分析 + 手册查证**。
  上板动作与现象由用户口述,模型未直接观察。

## 提示词(按时间顺序)

```
板子上的供电是5v吗
```
```
模块上的clk就是sclk吗，按照当前设置输出的频率应该是多少
```
```
现在的输出是500mv的直线
```
```
今天先这样吧明天继续测试
```

---

## 一、供电核查(用户第一问)

模型**没有凭印象答**,分三层去取一手资料:

| 层 | 结论 | 出处 |
|---|---|---|
| 开发板**输入** | **DC 6~16 V** 宽范围(板载 DC-DC),**不是 5 V**;USB 供电可用但仅 500 mA,跑不动 PS | 开发指南 V3.4 §27 / §29 |
| 板上**电源轨** | 独立 2×3 排针 +5 V(适配器 1000 mA / USB 500 mA)、+3.3 V(1000 mA);**J4 第 40 脚 = +5 V,第 38 脚 = +3.3 V,37/39 = GND** | 指南 §26/§27 + `docs/board_pins.md` |
| **IO 电平** | 🔴 **PL 三个 BANK(BANK13/34/35)全部 3.3 V** ⇒ **所有 PL IO 都是 3.3 V** | 指南原文:「这 3 个 BANK 的供电均为 3.3V(即 PL 端所有 IO 的电平均为 3.3V)」 |

⇒ 由此得出**必须写进报告的接线铁律**:
**J4 第 40 脚可以提供 5 V 给模块,但 J4 上任何一个信号脚都不能承受 5 V。**

顺带查了 AD9833 模块本身(`AD9833-DDS.pdf`):**模块供电 2.5 V ~ 5.5 V 均可**。

🔴 **模型主动标注一处「取不到」** —— 模块上那颗 3 脚稳压器 `U2`(网络名只有 `VCC` / `OUT` / `GND`)
**PDF 文字层里取不到具体型号**,因此**无法判断它是不是 5 V→3.3 V 的 LDO**。
这直接决定两条互斥接法(接 40 脚还是 38 脚),模型**没有猜,而是把这个判断交回用户**
(建议量静态阻抗或看丝印)。—— 与 `LLM-006`「不拿二手资料替代一手规范」同向。

## 二、`CLK` vs `SCLK`(用户第二问)

用户在模块丝印上看到 `CLK`,问它是不是 `SCLK`。模型先回手册取 AD9833 引脚定义:

| 名字 | U1 引脚 | 作用 | 模块上 |
|---|---|---|---|
| **MCLK** | **第 5 脚** | DDS **主时钟**,决定输出频率基准 | **焊死板载 25 MHz 晶振** |
| **SCLK** | **第 7 脚** | **SPI 串行时钟**,只搬寄存器数据 | **引到接口排针** |

**判据(来自模块自带 STM32 demo,非模型推测)** —— `HARDWARE/AD9833/Communication.h:62-64`:

```c
#define AD9833_FSYNC 	PAout(3)
#define AD9833_SCLK 	PAout(4)
#define AD9833_SDATA 	PAout(5)
```

**demo 只驱动这 3 根线,全文没有任何 MCLK 控制** ⇒ 模块把主时钟固定成板载晶振,
接口上不引出主时钟 ⇒ **接口上标 `CLK` 的那根就是 `SCLK`**。这也是决策 **D10**
(「AD9833 板载晶振焊死,不能由 FPGA 供 MCLK」)的一手依据。

⚠️ 模型同时给了**不依赖丝印的判据**:信号线 **3 根(FSYNC/CLK/DATA)** ⇒ 那个 CLK 是 SCLK;
**另有第 4 根单独标 CLK 或 MCLK** ⇒ 那个才是主时钟。**没有把"我看不到你手上模块"这件事含糊掉。**

## 三、输出频率核定(用户第二问后半)

`qrs.v:89` 的 `adc_code = 28'h0A3D70A = 10 737 418`:

```
f_out = 25 MHz × 10737418 / 2^28 = 999 999.9776 Hz
误差   = −0.0224 Hz = −0.022 ppm
分辨率 = 25e6 / 2^28 = 0.0931 Hz/LSB
```

**并把这 4 帧逐位解码,确认配置本身正确**(与 `LLM-016` 顶层实测的 4 帧对上):

| 帧 | 值 | `D15,D14` | 含义 |
|---|---|---|---|
| 1 | `0x2100` | `00` | CONTROL:**B28=1, RESET=1** → 软复位 |
| 2 | `0x570A` | `01` | FREQ0,**低 14 位** = `0x170A` |
| 3 | `0x428F` | `01` | FREQ0,**高 14 位** = `0x028F` |
| 4 | `0x2000` | `00` | CONTROL:**B28=1, RESET=0** → 释放复位出正弦 |

拼接校验:`(0x028F << 14) | 0x170A = 0x0A3D70A` ✓ 与 `adc_code` 一致。
第 4 帧 `SLEEP1/SLEEP12/OPBITEN/DIV2/MODE` **全为 0**,是标准正弦输出配置。

### 🆕 模型主动提出的前瞻问题(本次新发现,可写报告)

> 上面的 25 MHz 是**标称值**。实际输出 = `真实晶振频率 × 0.0399999925`。
>
> 而 **DLIA 的采样时钟来自 FPGA 的 MMCM** ⇒ **激励基准(AD9833 晶振)与采样基准(FPGA 晶振)
> 是两块独立晶振**。CLAUDE.md §八 的相干采样条件 `R/f_s = k/f_e` 要求两者**严格成整数比** ——
> **不同源就做不到**。

模型**没有要求现在改**(D10 已判过板载晶振不可动),而是**标记为 P3 阶段必然撞上的问题**,
并主动提议下一步可以量化(50 ppm 失配下 CIC 对 `2f_e` 的抑制还剩多少 dB)。
⇒ 属「**提前暴露下游风险而不打断当前节奏**」。

---

## 四、「500 mV 直流」排障(**本次主体**,未结案)

### 现象

模块输出是**一条 500 mV 的直流直线**,没有 1 MHz 正弦。

### 模型给的三成因表(全部有手册原文出处,非推测)

| 成因 | 位 | 手册原文(`表6`) |
|---|---|---|
| **RESET = 1** | D8 | 「Reset = 1时可将内部寄存器复位至0,**对应于中间电平的模拟输出**」 |
| **SLEEP1 = 1** | D7 | 「内部MCLK时钟会被禁用,DAC输出则**保持其预设值**,因为NCO不再执行累加」 |
| **FREQREG = 0** | — | 相位累加器不累加 → 恒定 |

⇒ **三者都是"直流",且都指向同一根因:SPI 没通,或者 MCLK 没跑。**

### 🔴 模型主动指出:先排除量具,别急着怀疑 DUT

手册规格(表1,RSET = 6.8 kΩ):**VOUT 最大 650 mV / 最小 38 mV ⇒ 中间电平 ≈ 344 mV**。

> **用户测到的 500 mV 与 344 mV 对不上。**

模型**没有强行把这 156 mV 的差值圆过去**,而是:
① 如实写「**这个绝对值我解释不了**」;
② 把**最常见的一种假象**摆到最前 —— **万用表 DC 挡测一个正常工作的 1 MHz 正弦,
读数就是平均值 ≈ 344 mV,它本来就看不出有没有振荡**;
③ 给出正确测法:**示波器 + DC 耦合 + 时基 ~0.5 µs/div**。

⇒ 与 `LLM-009`/`LLM-011`/`LLM-014`/`LLM-016` 的「量具错」同源,但**这次是提前拦截,没有等它发生**。

### 劈开问题的判据(从"模块侧"改成"FPGA 侧")

模型要求**先量 FPGA 侧那三根脚,而不是模块侧**:

| 信号 | 球号 | J4 脚 | 底板网络名 |
|---|---|---|---|
| `adc_sync` | **V12** | 31 | CMOS_D6 |
| `adc_sclk` | **W14** | 33 | CMOS_PCLK |
| `adc_mosi` | **V15** | 35 | CMOS_PWDN |

期望:上电后约 **200 ms** 出现 **4 段突发**(`0x2100/0x570A/0x428F/0x2000`),
每段 16 个 SCLK,**SCLK 空闲为高**(CPOL=1);之后 ~800 ms 由 `set_in` 再触发一轮。

| FPGA 三根脚 | 模块 VOUT | 结论 |
|---|---|---|
| 没有波形 | 直流 | 问题在 **FPGA 侧** |
| 4 段波形正常 | 直流 | 问题在 **模块侧** |

**顺带坐实**:`V12/W14/V15` = J4 第 31/33/35 脚 = BANK34 的 `CMOS_D6/PCLK/PWDN`,
与已跑通的 `dac_*`(W13/Y14/W15)**同 bank**;本板无摄像头模块 ⇒ **无冲突**。

### 三个头号嫌疑(按可能性排序)

| # | 嫌疑 | 依据 |
|---|---|---|
| ① | **bitstream 是旧的** | `V12/W14/V15` 是**刚加进 `io.xdc`** 的 —— 没重跑综合→实现→生成位流的话,**这三个球根本没被驱动** |
| ② | **三根线接错** | 症状正是"没反应";要求用**万用表蜂鸣挡**逐根对,**别信丝印** |
| ③ | **MCLK 停振** | 量 U1 第 5 脚;MCLK 停 → NCO 不累加 → 恒定直流(与手册 SLEEP1 同一机理) |

### 顺带指出一处工具缺口

`qrs.v:54-62` 的 `ila_0` 只探了 `rst_n / dac_sclk / dac_cs / dac_mosi` 四个,
**AD9833 的三根没进去** ⇒ ILA 帮不上忙。要加需回 IP 目录把 probe 数 4 → 7 **重新生成**
(**不是文本能改的**)。模型注明:**有示波器的话就先不做这步**。

---

## 结果

☐ ✅ 直接可用  ☑ ⚠️ **部分可用(规格核定可用;故障根因未定位)**  ☐ ❌ 不可用

**可以写"已查明"的**:
- 开发板输入 **DC 6~16 V**、J4 第 40/38 脚 = +5 V/+3.3 V、**PL IO 一律 3.3 V**(均有指南出处)
- AD9833 **MCLK(U1 第 5 脚)≠ SCLK(U1 第 7 脚)**,模块接口上的 `CLK` 是 SCLK(**有模块 demo 源码为证**)
- 当前配置输出 **999 999.9776 Hz**,4 帧逐位解码正确

**不得写"已查明"的**:
- 🔴 **500 mV 直流的根因未定位** —— 三个嫌疑**全是假设**,一次测量都还没做
- 🔴 **500 mV vs 手册中间电平 344 mV 的差值,模型没有解释**
- 🔴 **模块 U2 是不是 LDO 未确认** ⇒ **模块该接 +5 V 还是 +3.3 V 仍未定**
- 🔴 `t8` 仍未结案;`spi_master` 仍未综合 / 未做时序分析 / 未上板

---

## 纠错轨迹

### ① 「先确认板上跑的是哪一版」被提到了第一位(与 `LLM-012` 对照)

`LLM-012` 的教训写在本文件 `INDEX.md` 里:
> 模型把票押在"引脚接错",**真根因是位流没更新**。两个会话连续出现同一模式 ——
> **模型的所有静态分析都建立在"板上跑的是我以为的那版程序"这个从未验证过的前提上。**

本次**把这条前提直接提到了头号嫌疑第 ① 位**,并且是在**没有用户提示**的情况下。
⇒ 这条从"事后总结"变成了"事前动作",是 `LLM-012` 沉淀真正生效的一次。

### ② 模型第三次主动标注「我取不到」(正面样本)

本次有两处,**都没有用推测填补**:
- **模块 U2 型号**取不到 ⇒ 不判断 5 V / 3.3 V,把球交回用户(量阻抗 / 看丝印)
- **500 mV 与 344 mV 对不上** ⇒ 直接写「解释不了」,不编一个自洽的故事

对照 `LLM-003`(把推断说成赛题规定被用户戳穿)与 `LLM-012`(不充分搜索换来全称否定结论)——
**同一失败模式,这次是反着做的。**

### ③ 量具问题被提前拦截,而不是等它发生

前 6 次"量具错"(LLM-009/011/014/016 …)都是**跑完了才发现判据坏了**。
这次在**用户还没做任何测量**时,模型就把「万用表 DC 挡看不清正弦」这条摆到了最前面,
并给出正确测法。⇒ 「先证明量具可信」从**事后归因**变成了**事前检查表**。

---

## 沉淀

→ **`skill/measurement-instrument-can-be-wrong/` 素材已够**(4 次实测 + 1 次提前拦截),**可以动笔**。

→ 新增候选 **`skill/board-pin-electrical-constraints/`**:
查引脚时**不只要查"这个球引到哪",还要查"这个 bank 的 IO 电平是多少"**。
本项目实测:J4 能供 5 V,但 **PL IO 全 3.3 V** —— "板子有 5 V" 与 "IO 是 5 V" 是两件事,
混起来会直接烧模块。

→ 新增候选 **`skill/clock-domain-is-not-clock-frequency/`**:
`MCLK ≠ SCLK`。**同一个器件上两个都叫 "clock" 的引脚,职责完全不同**
(MCLK 定输出频率,SCLK 只搬数据)。
判据不是看名字,而是**看模块自带的例程驱动了哪几根线** ——
demo 只驱动 3 根 ⇒ 第 4 个时钟不存在于接口上。

→ 补充 `skill/vendor-example-is-not-spec/` **反向实例**:
厂商 demo 这次是**正面的证据来源**(用"它没驱动 MCLK"反推出接口形态)。
⇒ **例程不能当"合规"的依据,但可以当"接口形态"的依据** —— 两种用途要分清。

---

*记录人:Claude · 2026-09-20*
