dsgmxc/2026_fpga_qrs/llm-log/LLM-032.md

# LLM-032: PL 侧电容触摸通路(Chunk C)—— `i2c_master` + `gt911_ctrl` 代写、接进 `cv_sys`、跑出含触摸的位流

- **日期**: 2026-10-02
- **模型**: Claude(DeepSeek-V4-Flash 驱动会话)
- **任务**: 接续 LLM-031 的授权「**完成 ps 程序设计以外的其他工作**」,完成触摸子系统的 PL 侧部分:
  ① 自写 `i2c_master.v`(开漏 I2C 主机)RTL;② 自写 `gt911_ctrl.v`(GT911 触摸控制器)RTL;
  ③ 接进 `cv_sys.v` 并引出 4 根外部端口;④ 补 XDC 约束;⑤ 改 BD 并**自己跑出含触摸的位流**。

> ⚠️ **本轮同属 CLAUDE.md §6.0 的显式例外**,范围由用户在上一轮点名为
> 「ps 程序设计以外的其他工作」。**PS 侧 Python 一律未动**(用户自己写)。

## 提示词

```
继续
```

> 上一轮(LLM-031)用户已选定「我继续写 Chunk C 触摸 RTL」这一支,本轮的「继续」是执行指令。
> 另:CLAUDE.md §六 明令「所有代码由用户先写」,本轮 RTL 由模型代写 —— 该例外仅覆盖本轮点名范围。

## 模型回答

**产出 4 个文件 + 3 处配置改动**:

| # | 对象 | 改动 |
|---|---|---|
| 1 | `i2c_master.v`(新,~660 行) | 开漏 I2C 主机:字节级 op 接口(START/WRITE/RD_ACK/RD_NAK/STOP/RECOV)、时钟拉伸等待 + 超时自退、9 脉冲总线恢复 |
| 2 | `gt911_ctrl.v`(新,~750 行) | GT911 控制器:上电复位序列(定器件地址)、16 位寄存器寻址、轮询 0x814E、读 2 触点、两级错误容忍 + 器件地址自愈 |
| 3 | `cv_sys.v` | 4 个新外部端口(`touch_rst_n`/`int`/`scl`/`sda`);三个 `sts_touch_*` 常量换成 `gt911_ctrl` 驱动 |
| 4 | `cv_axi_lite_slave.v` | 🆕 **触摸坐标快照锁存**(见下文"设计判断") |
| 5 | `led.xdc` | 4 条触摸引脚约束 |
| 6 | `system.bd` | 加两个源文件 → `update_module_reference` → `create_bd_port` ×4 → validate |

**设计判断(不是照抄,有取舍记录)**:
- **`i2c_master` 放 `clk_axi` 域** —— 位速率由 `CLK_FREQ_HZ` 分频而来,没有非它不可的频点;
  且上报字直连 AXI 从机寄存器,**同域 = 不需要 CDC**,少一处风险。代价:`clk_axi` 实测
  41.6667 MHz 而参数按 50 MHz 算 ⇒ 所有"毫秒"实际**慢 20%**,对触摸无影响但报告不许写成实测值。
- **坐标快照锁存** —— PS 要读满 3 个寄存器(0x68/0x6C/0x70)才拼得出一次触摸事件,
  而 `gt911_ctrl` 自由运行、来一帧就刷新。三次读之间跨过帧边界就会读出
  "状态说 1 个点、坐标却是下一帧"的**撕裂** —— 撕裂**不报错**,只让界面偶尔跳一下。
  做法:把"读 0x68"当提交点,那一拍把 pt0/pt1 一并锁进 hold。**代价:PS 必须先读 0x68**,
  此前提已写进寄存器表注释。

## 结果

☐ ✅ 直接可用 ☐ ⚠️ 部分可用 ☐ ❌ 不可用

→ 勾 **⚠️ 部分可用**:两个模块各有 xsim 实跑证据,
**含触摸的位流已生成、时序全过、DRC 0 错 0 关键警告**,4 根引脚已在布线后网表里落位;
但 **① 从未上板**(M13 对本批无证据)、**② 真实 GT911 是否接受 0x814F 起始偏移未知**、
**③ 复位时序 20/6/100 ms 抄自前序 STM32 `lcd_touch.c`、非 GT911 数据手册**。

## 验证方式

### ① `i2c_master` 临时 TB(`/tmp/qrs_i2c/tb_i2c_master.v`,0 比对错 / 0 从机错)

带**独立总线监视器**(直接从 SCL/SDA 电平解码,不复用 TB 期望值),四场景:

| 场景 | 线级证据 | 结论 |
|---|---|---|
| GT911 读时序 | `START 28 81 4e` → `START 29` → `81 00 23 01 ab 02`(末字节 NAK)→ `STOP` | 组帧正确 |
| 时钟拉伸 200 拍 | 该字节耗时 **13.26 µs** vs 正常 **9.74 µs** = **+176 拍**(=200−25 自身低相位) | 主机**真的等了** |
| 死拉低 6000 拍(>阈值) | `err=1 busy=0`,自行退出 | 不挂死 |
| 总线恢复 | 9 脉冲 + STOP,`m_scl=z m_sda=z` | 总线已释放 |

### ② `gt911_ctrl` 临时 TB(`/tmp/qrs_i2c/tb_gt911_ctrl.v`,18 项检查全过)

`CLK_FREQ_HZ` 传 1 MHz 做**时间缩放**(126 ms 复位从 630 万拍压到 12.6 万拍,只缩放不改逻辑)。

| 检查 | 结果 |
|---|---|
| 复位期间 rst 低、INT 被驱动高 | ok |
| 126 ms 后 rst 高、INT **释放**(`int_oe=0`) | ok |
| 第 1 次读(状态 0x81) | count=1, pen_down=1, seq=1, **pt0_x=0x123, pt0_y=0x2AB** |
| 第 2 次读(状态 0x00)**必须保持** | count/pen_down 保持,seq **不递增** |
| 第 3 次读(状态 0x80,count=0) | count=0, pen_down=0, seq→2 |
| 第 4 次读(状态 0x81) | count=1, pen_down=1, seq→3 |
| 写 0 到 0x814E 的次数 | **3**(每来一帧清一次) |

### ③ 综合 / 实现(2026-10-02,`qrs.runs/impl_1/`,**本次为全量非增量**)

| 指标 | 值 | 出处 |
|---|---|---|
| LUT | **1133**(2.13%) | `report_utilization` |
| FF | **1380**(1.30%) | 同上 |
| RAMB36 / DSP | 1 / **0** | 同上 |
| **Bonded IOB** | **34(27.20%)** | 同上 —— **正好 30 根 LCD + 4 根触摸**,与引脚账一致 |
| WNS / TNS | **+12.746 ns / 0.000** | `report_timing_summary`,时钟 20 ns(=50 MHz 设计值) |
| 失败端点 | **0 / 3525**(WHS **+0.061** / WPWS **+9.146**) | 同上,`All user specified timing constraints are met.` |
| DRC | **0 Error,0 Critical Warning**(21 条 Warning) | `report_drc` |

> ⚠️ **DRC 那 21 条 Warning 的构成**(如实列,不写成"全干净"):
> `REQP-1839 RAMB36 async control check` × **20** 是唯一实质警告,落在乒乓行缓冲那个
> RAMB36 上(报告触到规则上限 `CHECK-3` × 1 是它连带产生的)。
> **未逐条分析** —— 本批不阻塞出位流,记为待办。
| CDC | 空(单时钟域) | `report_cdc` |

层次:`cv_sys_0` = 667 LUT / 778 FF;网表内确认存在
`system_i/cv_sys_0/inst/u_gt911_ctrl` 与 `.../u_gt911_ctrl/u_i2c`(i2c_master 被展平在内)。
引脚落位(`get_property PACKAGE_PIN`,布线后网表):
`touch_scl=R19`、`touch_sda=P20`、`touch_int=U19`、`touch_rst_n=M19`,均 LVCMOS33。

**产物**(暂存模型工作区 `~/Desktop/qrs_2026_fpga/board/`,**未写入交付仓库**):

| 文件 | 大小 | md5 |
|---|---|---|
| `qrs.bit` | 4,045,690 B | `ad93f160ae0fd4c97da325faabe4b85a` |
| `qrs.hwh` | 145,267 B | `4fa2032b4e2f65712e951300bbe33c3b` |

⚠️ `qrs.hwh` 比第 30 次那版(**143,539 B / `aecf0ced…`**)大 **1,728 B** —— 多出来的就是 4 个触摸端口
(`grep` 实测 hwh 内含 `touch_scl`/`touch_sda`/`touch_int`/`touch_rst_n`)。
**交付仓库 `qrs_fpga_2026/board/` 里仍是旧版,须用户刷新**(§6.0.1,模型无权重写)。

## 纠错轨迹

### A. RTL 真 bug(2 个,均由仿真检出 —— 编译期零告警)

1. **总线恢复收尾发出伪 START**。`i2c_master` 的 `S_REC_HI` 在 `rec_cnt==8` 时直接
   `sda_oe <= 1'b1` 再进 STOP —— 但此刻 SCL **刚被释放、是高**的;
   **SCL 高时把 SDA 由高拉低 = START,不是 STOP**。总线可能在错误的时刻被再次启动。
   → 补一个 `S_REC_END` 状态:先 `scl_oe <= 1'b1` 把 SCL 压回低,再交接给 `S_STOP_A`。
   改完回归 `i2c_master` TB,仍 PASS。

2. **明确松手那一帧没清状态寄存器**。`gt911_ctrl` 的 `S_PROC` 在 `count==0` 分支直接
   `state <= S_IDLE`,漏了向 0x814E 写 0。后果不是"读不到",而是
   **`bit7` 恒为 1 ⇒ 每次轮询都重报同一帧 ⇒ `seq` 疯跑 ⇒ PS 收到连续假释放事件**。
   → 三个新帧分支(正常 / count==0 / count>MAXPT)**统一走清状态事务**。
   检出方式:TB 里数"写 0 到 0x814E 的次数",实得 **1**,预期 ≥3。

3. **坐标拼接被静默截断 18→12 bit**。`{rbuf[3], rbuf[2], 2'b00}` 是 18 位,
   赋给 12 位 reg 时**高字节被无声丢弃**(x 会算成 `0x8C` 而非 `0x123`)。
   → 改 `{rbuf[3][3:0], rbuf[2]}`。**超大拼接赋窄 reg 不报错,只会静默截断** —— 列为复查项。

4. `gt911_ctrl` 初稿另有三处:`sts_touch_status` 拼成了 **34 位**(保留位写成 `5'b0`)、
   `touch_rst_n` 从未驱动、`N_PT[3:0]` 这类**对 `integer` 参数做位选**(工具行为不可靠)。
   → 全部改为显式 `localparam [3:0] MAXPT = N_PT;` 之类。

### B. 验证台自己的坑(会伪装成 DUT 的 bug,5 个)

1. **从机驱动了"解码后的辅助 wire"而非真实三态线** → 主机看到的永远是 NACK,
   整个控制器退到备用器件地址 0xBA。→ `assign touch_sda = sl_sda_r ? 1'b0 : 1'bz;`。
   **教训:多驱动开漏线上,从机与主机必须落在同一个 net。**
2. **TB 漏了上拉电阻** → 主机释放 SCL 后读到 `z`,而 `if (scl_in)` 对 `z` 判**假** ⇒
   主机以为从机一直拉伸,每个 op 都等满超时才退,SCL 永久卡低。
   **这是 TB 缺了板的模型,不是 RTL bug** —— 硬件上 inout 读回的是 IOBUF 的 O 引脚真实电平。
   反过来也提醒了一条**硬件前提**:板上 I2C 必须有上拉。
3. 读地址字节的第 9 位(ACK)也会让从机 `bitc` 走到 8 ⇒ 误触发"数据 ACK"逻辑 ⇒
   整串数据左移一格。→ 加 `tx_just_started` 抑制。(症状出现在场景 2,病根在场景 1 的收尾。)
4. 注入时钟拉伸时若让 SCL 产生**额外边沿**,从机模型会把它算成一个数据位。
   → 必须在 SCL **已经是低**的时候接住、之后再放开。
5. `err`/`done` 是**单拍脉冲**,等 `do_cmd` 返回后再查早已归零 → 加粘滞 `err_seen`。

另:TB 里 `pt_mem[8..15]` 未初始化 ⇒ 读回 `x`,顺着 `tx_sr` 传下去把日志淹成满屏 `rx=xx`。
**仿真里 x 是污染源,不是噪声** —— 用 for 循环初始化掉。

### C. 🔴 工程配置两处(与 RTL 无关,但直接卡住出位流)

1. **约束写进了未启用的文件**。4 条触摸约束先加在 `constrs_1/io.xdc`,
   而该文件 **`IS_ENABLED = 0`** —— 综合实现全程没 Parsing 过它,
   位流在 `write_bitstream` 的 DRC 处炸掉:
   `ERROR: [DRC NSTD-1]` + `[DRC UCIO-1] Problem ports: touch_scl, touch_sda, touch_int, touch_rst_n`。
   → 工程里**真正生效的引脚约束文件是同目录的 `led.xdc`**(`IS_ENABLED=1`),
   LCD 那 30 行也在它里面;触摸约束改放 `led.xdc`。
   ⚠️ 顺带查出:`io.xdc` 里那段 LCD 约束是 **`led.xdc` 的重复副本**,
   而上半段 `clk_in1`/`rst_n`/`dac_*`/`adc_*`/`clk_65m` 是**旧顶层 `qrs.v` 的遗留**
   (这些端口在 `system_wrapper` 里根本不存在)。**已在该文件里写明,未擅自删除。**

2. **工程级消息规则把 `CRITICAL WARNING` 整体降级成 `INFO`**。
   `qrs.xpr` 里有一条 `<MsgRule>`:`Severity=CRITICAL WARNING → NewSeverity=INFO`。
   后果:**任何"0 critical warnings"的报告结论都不可信** —— 而这正是 M3 要交的东西。
   是在追查 DRC 报错时顺带发现的。→ 已用 `reset_msg_config -default_severity` 清除,
   清除后重跑,日志中 `CRITICAL WARNING` 计数为 **0**(不再是被吞掉,而是真的没有)。

3. 另:首次重跑用的是**增量综合**(`read_checkpoint -auto_incremental`,
   参考 `utils_1/imports/synth_1/qrs.dcp`)。增量结果本身有效(已确认
   `u_gt911_ctrl`/`u_i2c` 确在网表内),但作为 M3 证据不够干净 ⇒
   置 `AUTO_INCREMENTAL_CHECKPOINT 0` 后**全量重跑**,上表数字取自全量那次。

## 沉淀

→ `skill/open-drain-bus-both-sides-same-net/` —— 多驱动开漏线,从机与主机必须驱动同一 net;
  TB 里"驱动解码后的辅助 wire"会让主机看到全 NACK。
→ `skill/simulate-open-drain-needs-pullup/` —— 仿真开漏总线必须显式加 `pullup` 原始语元,
  否则 `if (z)` 判假,症状是"所有事务全超时"而 RTL 一行没错。
→ `skill/xdc-file-may-be-disabled/` —— 约束写了不生效,先查
  `get_property IS_ENABLED [get_files xxx.xdc]`,再看 runme.log 里到底 Parsing 了哪几个 xdc。
→ `skill/check-msg-severity-overrides/` —— 报告"0 critical warnings"之前,
  先确认工程里没有 `MsgRule` 把关键警告降级(本次实测踩到)。
→ `skill/wide-concat-silently-truncates/` —— 拼接结果赋给更窄的 reg **不报错**,只静默截断;
  用 `reg[3:0]` 之类显式位选替代整字节拼接。

---

<!--
填写提醒:
1. 当天记录,不要事后补 —— 补出来的没有"验证方式"和"纠错轨迹"
2. 失败也要记 —— 失败记录才是技能包的原料
3. 每条记录里必须能看到"我不同意 / 我改了 / 我验证了"
4. commit message 里加 [llm-XXX] 关联
-->
