dsgmxc/2026_fpga_qrs/skill/classify-by-state-not-by-intent/skill.md

# classify-by-state-not-by-intent

> **给日志分组做统计时,归类依据必须挑「写下去会被回读确认的状态行」,
> 不能挑「打印一句话表示意图」的行。**
> 前者是**状态**,后者是**心情**。
> 本技能来自一次**差点把错结论发出去**的事故 —— 错的那一版数字已经写进了草稿。

## 适用范围

- 任何"**从日志里找标记行,把记录按回路 / 批次 / 模式分组统计**"的分析。
- 尤其命中:**长驻进程的日志**、**同一份日志里混着多轮运行**、
  **标记行是"我准备做 X"而不是"我已经做了 X"** 的场景。
- 不限硬件 —— 一切把日志当数据源的分组统计都适用
  (请求日志、CI 日志、爬虫日志、仿真日志同理)。

## 使用方法

### 判据:一条标记行要能当归属依据,必须**同时**满足三条

| # | 条件 | 反例(本项目实有) |
|---|---|---|
| ① | 它在目标动作**真的发生之后**才打印 | 打印在动作**之前**的"我打算测 X" |
| ② | 它**不会跨动作残留** | 扫压 60 个点期间,上一轮那条单点提示**一直没被覆盖** |
| ③ | 它所在的那一段运行**配置唯一** | 同一份日志里有 **11 个启动段**,前后采样率不同 |

三条缺一条,就先换个标记行,或者先按"**运行段**"把日志切开再统计。

### 做法:标记行按可信度分三级,优先挑有回读的那一级

```
✅ 状态行  写了硬件 / 写了数据库,然后【读回确认】才打印
           本项目:[relay] 回路 → CRSS(0x51)      ← 真的写了 0x1C 并回读
⚠️ 事件行  动作发生了,但没有回读
           本项目:开始扫压
⛔ 意图行  只表示"打算做什么",【会残留】
           本项目:[proto] 点测 CISS @ 0.10 V:…切回路再采一次
```

**要的是第一级。** 第二级能用但要在报告里降权;第三级不能用。

### 事故复盘(数字都是实跑的)

本项目要统计"坏点出现在哪个回路、哪个偏压",第一版脚本用了
`[proto] 点测 CISS @ 0.10 V` 这行做回路归属:

| | 旧归属(**错**) | 重算(**对**) |
|---|---|---|
| CRSS @ 50 V 坏点率 | 52/54 = **96.3%** | **11/15 = 73%** |
| CISS @ 50 V 坏点率 | 0/11 = 0% | (扫压 60 点)0% |

**根因**:那行意图**在 60 点扫压期间一直残留**,于是把 **227 次扫压捕捉**
全算进了「CISS @ 0.10 V」名下 —— 分母凭空多出一个数量级。

**它长出的错结论**:「坏点是**路径依赖**,不是偏压依赖」。
重算后**两个变量都成立**(同偏压 50 V 下 CISS 0% vs CRSS 73%;
同回路 CRSS 下 0.1 V 5% vs 50 V 73%)。
⇒ **坏数据必然长出坏结论** —— 这不是两条独立的错,是因果串起来的。

### 条件 ③ 的实证:按格式筛完,还要按运行段再核一遍

同一份日志,**严格格式**(带 `码/期望`、`采 N 次` 两列)的证据行有 **245 条**;
**宽松正则**能匹配到 **2559 条** —— 多出的 2314 条是**旧格式**。
245 条逐条核过采样配置,`245/245` 全落在 32.50 MSPS 段。

⇒ **筛证据行不能只按"长得像",要按"哪一段配置生成的"再核一遍。**

## 失效条件

- ⛔ **找不到满足三条的标记行时,不要"退而求其次"用意图行** ——
  要么改代码补一条状态行,要么**放弃分组,只报总量**。
- ⚠️ **状态行也可能有代理误差**:它确认的是"寄存器写进去并被读回",
  **不等于**"继电器真的动作了"(那要听声音 / 拿表量)。**分层看待,别越级断言。**
- ⚠️ 按"启动段"切分**只解决条件 ③**,①② 还得单独看。
- ⚠️ 本判据要求日志里**存在**这样的行。如果系统的日志全是你自己新加的,
  先想想新加的那行是不是也犯同样的毛病(打印在动作之前)。

## 已验证的效果

- 重算后的表写进 `board/measurements/20261015_crss_bad_points_root_cause.md` §二,
  并作为**唯一**依据给出"回路与偏压**两个变量都成立**"的结论;
  旧的 `52/54` 那一版已作废并在 `llm-log/LLM-069.md` 里逐条记明。
- 条件 ③ 的抽样核查(245 vs 2559)当场做掉,避免了 65.00 MSPS 段的证据混进来。
- 同一手法在另一处抓出**口径歧义**(见下"相关")。

## 来源

- `llm-log/LLM-069.md` 纠错轨迹第 **1** 条
  ——「★ 差点拿一个"脚本算出来的数"当结论 —— 那个脚本的归属逻辑是错的」
  (原文自评:**"前者是状态,后者是心情。"**)。
- 同卷纠错轨迹第 **2** 条 —— 由坏归属长出的"单因子"错结论;
  第 **5** 条 —— 65 MSPS 段证据行差点混入。
- 相关技能:`skill/measurement-instrument-can-be-wrong/`(判据 3:
  「这个观测能区分我要区分的那两种情况吗」)、
  `skill/recount-dont-increment/`(分组算完要和独立计数器对账)。
