dsgmxc/2026_fpga_qrs/report/design_report.md

# 设计报告

> **MOSFET 寄生电容 C-V 曲线在线监测平台**
> 全国大学生嵌入式芯片与系统设计竞赛'2026 — FPGA 创新设计赛道(AMD)
> 赛道:3.3 自主选题赛道(初级组)
>
> 🚧 **本文件为骨架。** 结构依据指南 3.3.5.3 规定的**七项必备内容**搭建,
> 随项目推进逐节补全。**七节缺一不可。**

---

## 目录

1. [选题背景与创新点](#1-选题背景与创新点)
2. [设计原理与功能框图](#2-设计原理与功能框图)
3. [软硬件划分依据与接口设计](#3-软硬件划分依据与接口设计)
4. [优化过程](#4-优化过程)
5. [大模型协作记录](#5-大模型协作记录)
6. [技能包的提炼过程](#6-技能包的提炼过程)
7. [复现说明](#7-复现说明)

---

## 1. 选题背景与创新点

> **指南要求**:为什么选这个题目,它解决了什么实际问题,前人做过什么。

### 1.1 实际问题 🚧

- MOSFET 寄生电容(Cgs / Cgd / Cds)是功率器件与模拟电路设计的关键参数
- 传统 C-V 表征依赖商用 LCR 表 / 半导体参数分析仪 —— **设备昂贵、不便携、难以在线监测**
- 功率器件的老化与失效往往先体现在寄生电容的漂移上,**在线监测有明确的工程价值**

### 1.2 前人工作 🚧

- 阻抗法 / 自动平衡桥
- 电荷放大法(商用 C-V 表经典做法)
- 准静态 C-V(QSCV)
- **待补**:具体文献与商用方案对比

### 1.3 创新点 🚧

> 对应评分项「创新性与应用价值」**30%** —— 权重最高,务必充分论证。

- [ ] 低成本方案(对比商用仪器的价格量级)
- [ ] **跨学科选题**:从半导体器件表征 / 可靠性监测切入(指南 3.3.2 明确鼓励"从 FPGA 之外的学科中寻找题目")
- [ ] 数字锁相放大器替代模拟锁相 —— 参数可配、无温漂、可重构
- [ ] 硬件内嵌阻抗反演的实时性
- [ ] AI 辅助器件退化识别
- [ ] **待补**:量化对比

---

## 2. 设计原理与功能框图

> **指南要求**:设计原理与功能框图。

### 2.1 测量原理 🚧

**阻抗法 + 正交锁相解调**

```
           ┌─ Ch_A: V_dut
AC源 ─[R_ref]─┬── DUT ── GND
              └─ Ch_B: V_src

Z_dut = R_ref · V_dut / (V_src − V_dut)
Y = 1/Z_dut  →  Cp = Im(Y)/ω ,  Rp = 1/Re(Y) ,  D = tanδ
```

### 2.2 相干采样设计 🚧

```
f_s = f_clk / D                   (ADC 采样率,整数分频)
M   = round(2^B · f_e / f_s)      (NCO 相位增量)
条件: R / f_s = k / f_e           (k 整数 → 平均窗覆盖整数个激励周期)
```
满足后 2f_e 谐波被 CIC 精确抵消(零点落在 2f_e),频谱泄漏为零。

### 2.3 功能框图 🚧

> **待补**:系统级框图(PL / PS / 模拟前端三部分)

### 2.4 PL 内部结构 🚧

> **待补**:DLIA 数据通路框图(NCO → 乘法 → CIC → CORDIC)

---

## 3. 软硬件划分依据与接口设计

> **指南要求**:软硬件划分依据与接口设计。

### 3.1 划分依据 🚧

| 层 | 模块 | 为什么放这一层 |
|---|---|---|
| PL-RTL | `cv_sys` `cv_axi_lite_slave` `spi_master` `dac_1220` `ad9833_spi` `nco` `adc_capture` `relay_ctrl` `meas_fsm` `cdc_sync` | 总线 / 状态机 / 接口 / 时序 —— 需要确定性时序与手工控制 |
| PL-HLS | `dlia_core` `cordic_polar` | 数据通路 —— 需要快速参数空间探索 |
| PS | `cv_monitor.py`(S1)`sweep.py`(S2)`calibrate.py`(S3)`baseline.py`(S4)`anomaly_model.py`(S5) | 无实时性要求 —— 编排、反演、校准、AI、可视化 |

> 📌 PS 侧编号用 `S1`–`S6`(`P1`–`P6` 保留给项目阶段),见 `source_design_checklist.md` §2.4。

### 3.2 接口设计 🚧

> **待补**:详见 `docs/interface.md`(寄存器映射表 / 引脚分配 / 时序约束)

### 3.3 继电器时序状态机 🚧

```
IDLE → SET_BIAS → BIAS_SETTLE → RANGE_SEL → RELAY_SETTLE
     → AC_ON → MEASURE → LATCH → AC_OFF → NEXT
                                    └→ FAULT(全断 + 栅极泄放)
```

**互锁要求**:禁止栅极悬空、禁止量程电阻短路,非法组合拒绝执行并置错误码。

### 3.4 安全设计 🚧

- MOSFET 栅极耐压保护(上电顺序、限流、钳位、泄放电阻)
- 过流 / 超时快速关断

---

## 4. 优化过程

> **指南要求**:优化过程,含**优化前后的性能与资源对比表**。
> 同时对应加分项 **B03(与基线的对比)** 与 **B04(资源取舍论证)**。

### 4.1 基线设计 🚧

**Baseline(B0)**:纯 PS Python 实现锁相解调(`src/python/baseline.py`)

> 基线天然存在 —— 项目最初的设计就是软件全包,后转为硬件 DLIA。

### 4.2 优化前后对比表 🚧

| 指标 | B0(PS Python) | B1(PL 硬件 DLIA) | 提升 |
|---|---|---|---|
| 单点测量时间 | 🚧 | 🚧 | 🚧 |
| 重复性标准差(100 次) | 🚧 | 🚧 | 🚧 |
| PS CPU 占用 | 🚧 | 🚧 | 🚧 |
| 最小可测电容 | 🚧 | 🚧 | 🚧 |

### 4.3 资源与时序 🚧

| 资源 | 用量 | 占比 | 说明 |
|---|---|---|---|
| LUT | 🚧 | 🚧 | XC7Z020 共 53.2K |
| FF | 🚧 | 🚧 | |
| BRAM | 🚧 | 🚧 | 共 4.9 Mb |
| DSP | 🚧 | 🚧 | 共 220 |
| 时钟频率 | 🚧 | | |
| WNS / TNS | 🚧 | | |

### 4.4 消融实验 🚧

- 不同 CIC 抽取率 `R` 下的 SNR–时间权衡曲线
- 相干采样 vs 非相干采样的谐波抑制对比

### 4.5 资源取舍论证 🚧

> 加分项 B04:说明为何当前的资源–性能折中点是合理的,**避免以显著的资源代价换取有限的性能收益**。

### 4.6 设计判断依据 🚧

> 加分项 B06:不只呈现结果,要写清**当时为什么这么选**。

---

## 5. 大模型协作记录

> **指南要求**:提示词、模型回答、**自我纠错轨迹**、智能体工作流设计(如有)。
> 完整记录见 `report/llm-log/`,本节只放**摘要与代表性案例**。

### 5.1 工具与模型声明 🚧

| 模型 | 版本 | 用途 |
|---|---|---|
| 🚧 | 🚧 | 🚧 |

### 5.2 协作流程 🚧

> 哪几类任务用了大模型:生成初稿 / 读报告 / 定位 bug / 写脚本 ...

### 5.3 代表性纠错案例 🚧

> 挑选 **3–5 个最有代表性的**,每个都写:**模型错在哪 → 怎么发现的 → 怎么改的**。

**案例一**:🚧

**案例二**:🚧

**案例三**:🚧

### 5.4 智能体工作流 🚧

> 对应加分项 **B02**。详见 `build/agent/`。

### 5.5 协作效果评估 🚧

> **量化**:大模型帮了多少?哪些它做不了?

---

## 6. 技能包的提炼过程

> **指南要求**:从哪些失败或观察中总结、如何验证有效、边界如何确定。
> 技能包本体见 `skill/`。

### 6.1 提炼逻辑 🚧

> 一条经验的完整链路:`失败/观察 → 归因 → 抽象成规则 → 换场景验证 → 写入 skill/`

### 6.2 技能清单 🚧

**通用 PYNQ Skill(单独加分,换题目/换板卡仍可用)**

| Skill | 来源失败 | 已验证效果 |
|---|---|---|
| 🚧 | 🚧 | 🚧 |

**项目 Skill**

| Skill | 来源失败 | 已验证效果 |
|---|---|---|
| 🚧 | 🚧 | 🚧 |

### 6.3 通用性验证 🚧

> 加分项 B01:证明这些 Skill **不与本队题目绑定** —— 例如换一块板卡、换一个题目后仍然可用。

---

## 7. 复现说明

> **指南要求**:一份可供他人**从零开始完整执行**的操作步骤。
> 同时对应加分项 **B05(从零复现性)**。

### 7.1 环境搭建 🚧

### 7.2 依赖安装 🚧

### 7.3 构建步骤 🚧

### 7.4 上板运行 🚧

### 7.5 结果比对 🚧

> 如何确认复现结果正确 —— 提供参考数据与容差。

---

## 附录

- [ ] 附录 A:仿真与验证结果(M02)
- [ ] 附录 B:综合与实现报告(M03)
- [ ] 附录 C:实测数据与比对(M04 / M13)
- [ ] 附录 D:大模型协作完整记录 → `report/llm-log/`
- [ ] 附录 E:技能包 → `skill/`

---

*创建:2026-09-12 · 🚧 待补全*
