dsgmxc/2026_fpga_qrs/llm-log/AI_ASSIST_SUMMARY.md

# AI 协作要点总结

> 依据本目录 84 条协作记录（`LLM-001` ~ `LLM-084`，2026-09-12 ~ 2026-11-02）整理。
> 原则与记录一致：只写能追到证据的事；没有上板/实测的，明确标"未验证"；被推翻的判断保留纠错轨迹。
>
> 整理日期：2026-11-03

---

## 一、一页结论

1. **AI 在本项目里的角色是"可审阅的工程协作者"，不是答案来源。** 典型闭环是：
   模型给方案或代码 → 人按物理常识、优先级和影响面拍板或否决 → 工具（仿真、综合、上板日志、万用表）
   裁决 → 记录纠错轨迹。模型输出只有经过后两步才算数。
2. **采纳率不是评价标准，"可验证"才是。** 84 条记录中，28 条直接可用，均附原始日志、波形或板上读数；
   55 条部分可用，均明确写出"哪一部分没验"；0 条被记为不可用。这个分布本身就是协作纪律的产物。
3. **人真正不可替代的是四类判断**：物理可实现性、范围与优先级、共享模块的影响面、误差归属。
   AI 的强项是查手册、拆时序、写可综合代码、把现象折算成数值反证；弱项是替人决定"够不够好"。
4. **最高频的失败模式不是算错，而是"把推断当成依据"**：
   把二手结论当一手规范（LLM-003、LLM-013）、把局部观察升级成结论（LLM-020）、
   把工具自报成功当验证（LLM-021、LLM-063）、把上一周期的产物当现值（LLM-084）。
   这类错误反复出现，靠"记录过"防不住，必须落成机械步骤。

### 统计口径

| 指标 | 数值 | 说明 |
|---|---|---|
| 协作记录 | **84** | LLM-001 ~ LLM-084；跨约 7 周 |
| ✅ 直接可用 | **28** | 有可复核证据，结论可直接使用 |
| ⚠️ 部分可用 | **55** | 主结论可用，但部分未验或带遗留项 |
| ❌ 不可用 | **0** | 未出现整条作废 |
| 无标准标记 | **1** | LLM-037，结论列未写标记 |
| 已落地 Skill | **16** | `skill/*/` |
| RTL 模块 | **13** | `src/rtl/` |
| 板上实测位流 | `qrs.bit` | md5 `c92c7ed5b7d695dee73d86abc1c6089c`（README 当前口径） |

> 统计沿用 `INDEX.md` 的结果列口径；截至 LLM-083 为 28 / 54 / 0 / 1，加入 LLM-084（⚠️）后为
> 28 / 55 / 0 / 1。`LLM-037` 的"无标记"是记录本身没写标记，不是统计漏项。

---

## 二、AI 协助的六类要点

| 类别 | AI 主要做了什么 | 代表记录 | 验证方式 |
|---|---|---|---|
| **1. 一手资料核对与规格化** | 读 DAC1220 / AD9833 / AD9238 / LCD 手册，把时序、命令边界、复位流程落成 RTL 常数和状态机 | LLM-006 / 007 / 009 / 010 / 013 / 015 / 019 | 手册页码 + 厂商例程对照 + 仿真日志；发现厂商例程两处不达标 |
| **2. RTL 设计与审查** | `spi_master`、`dac_1220`、`adc_9833`、`adc_capture`、`cv_axi_lite_slave`、LCD 时序与帧缓冲读取 | LLM-004 / 005 / 014 / 027 / 031 / 044 | `xvlog` / `xelab` 零错、综合与布线报告、板上寄存器回读 |
| **3. 仿真与测试台** | 自检型 testbench + 变异测试；先证明"测试会失败"，再相信"测试通过" | LLM-005 / 009 / 010 / 014 / 015 | 21 项/47 项 PASS + 变异体 FAIL 原始日志 |
| **4. 板级 bring-up 与排障** | PYNQ Overlay、串口/直连网线、AXI 从机、继电器矩阵、采样相位、位流/二进制的同一性 | LLM-022 / 023 / 024 / 026 / 027 / 034 / 043 / 059 / 063 | 板上 `ip_dict`、LED/继电器回读、`/proc/<pid>/exe` md5、AR P 表 |
| **5. 测量算法与校准** | 整数窗 DFT、复阻抗反演、Möbius/仿射校准、系数选择守卫、马氏距离异常检测 | LLM-050 / 052 / 079 / 080 / 081 / 083 | 宿主单测 + 板上 180/180 点 + 标准板反查 |
| **6. 工程化与文档** | 仓库首次提交审计、`.gitignore`、四份文档同步、界面截图取证、LLM 记录与 skill 沉淀 | LLM-020 / 021 / 027 / 039 / 084 | 提交前拦截、`md5` 回读、抓帧核对 |

### 阶段划分（按记录日期粗略归纳）

- **2026-09-12 ~ 09-22｜RTL 基础与仿真纪律**：SPI、DAC1220、AD9833、AD9238。
  最重要的产出不是代码，而是"测试台必须先能失败"这条纪律。
- **2026-09-25 ~ 10-05｜上板链路**：PYNQ 2.7、串口/直连网线、LCD 彩条、自写 AXI4-Lite 从机。
- **10-06 ~ 10-20｜采集与系统集成**：ADC 采集通路、继电器矩阵、挡位、界面、校准框架。
- **10-21 ~ 11-02｜精度与验收**：采样相位、通道级校准、AI 异常检测、标准板单点反查、界面截图取证。

---

## 三、被采纳的点

下表只列"记录里能看出被采纳并落地"的条目，不代表全部。

| 编号 | AI 提出的点 | 采纳方式 | 依据 / 结果 |
|---|---|---|---|
| LLM-005 | DAC1220 采用**表驱动 + 6 状态初始化** | 用户据此写出 `dac_1220.v` | 方向成立；首版暴露 6 条致命项，其中"表只驱动等待、没驱动发送"是结构性问题 |
| LLM-007 | `cal_delay[0]` 10→1024 | 采纳 | 满足手册 `t14` 下限，复位图案能发出 |
| LLM-009 / 010 | DAC1220 首次跑通：code↔电压换算、**DIR 字节切片错**修正 | 采纳 | 21 项 PASS + 变异测试 4 FAIL 原始日志 |
| LLM-014 | 代写 `adc_9833.v`：分帧 init + 补 NORMAL 态 | 采纳 | 10 帧全 PASS + 2 组变异测试 |
| LLM-015 | 47 项自检 `tb_adc_9833.v` + 4 个变异体 | 采纳并归档 | 实测指出 `t8` 超手册上限 25 ns，未替它下结论 |
| LLM-018 | 排障先做**零成本排除**：供电、跳线、连接，再怀疑代码 | 采纳 | 用户查出跳线帽没接板载晶振；改前/改后两版位流均在 SMA 口实测 |
| LLM-020 | 首次提交前**命名审计 + 非空 `.gitignore`** | 采纳 | 用户在 commit 前填入 `.gitignore`，避免 `xsim.dir/`、`.Xil/`、`*.jou` 入库 |
| LLM-025 | 不统一 Python 版本，改为**写作纪律 + 板端 3.8 当裁判** | 采纳 | 避免持续环境维护成本；板子本来就是最终解释器 |
| LLM-027 | 先写 `cv_axi_lite_slave.v` 打通 P2 判据（用户纠正排序） | 采纳 | 板上 `VER 0x10000` / `S0 0x0` / `W1 deadbeef` / `W2 a5a55a5a` 四项全对 |
| LLM-028 | 不跳过彩条验证，改为**自检型彩条** | 采纳 | 一次点亮同时坐实 5 个原本只是推论的决策 |
| LLM-029 | 维持 `C_S_AXI_ADDR_WIDTH=7`（模型自撤升 8） | 采纳 | 22+7=29/32，剩 3 个地址；升位要动 `.v`+`module_ref`+Refresh，有实测代价 |
| LLM-031 | LCD 帧缓冲走**原生 AXI3**，不插 `axi_protocol_converter` | 采纳 | HP 是实时通路，行有硬截止期；变延迟 IP 换十几个 LUT 不划算；理由写入 RTL 头注释和 `docs/display_subsystem.md §6.2` |
| LLM-043 | DAC 放行前加 **FCLK0 窗口闸 [46.1, 54.0] MHz** | 采纳 | 27.7778 MHz 被拒、50.0000 MHz 放行；九步验证全过 |
| LLM-044 | **单计数器 8 位分频** + `130 MHz = lcm(65,10)` + 相位偏移 | 采纳 | `xvlog` 零错零警；综合/布线完成；WNS +0.983 ns；跨域两向 `Asynchronous Groups` |
| LLM-044 | 全部 2-FF 同步器补 `ASYNC_REG`（打在第一级）+ `set_clock_groups` | 模型自查后采纳 | 时钟名从 `report_clocks` 抄实测值，不用通配符兜底 |
| LLM-055 | 采集窗 **4096→8192**，RTL / C / UI 三层同步改 | 采纳 | 每层各有一道静默截断闸；10 MHz 档因物理不成立删除 |
| LLM-063 | `CV_ADC_DIV_DEFAULT` **2→4（32.5 MSPS）** | 采纳 | 同一运行内 `2:−1` vs `4:+1`：Im Z 的 SD 3.86%→0.42%，Cs 重复性约 10 倍；代价是均值偏 −12.8% |
| LLM-078 | 用与渲染无关的 **V50 半降电压**替代"最陡线段"判据 | 采纳 | 显示只动 0.02–0.10 V，实测早 0.83–1.17 V ⇒ 排除显示嫌疑 |
| LLM-079 | **4 个与拟合无关的特征 + 马氏距离**，阈值 25 / 100 | 采纳并上板 | 三腿扫压 180/180 全判"正常"；C 与 Python 分数逐位一致 |
| LLM-080 | **两块已知负载两点仿射校准**，不依赖 OPEN/SHORT | 采纳 | `a=(M2−M1)/(Z2−Z1)`、`b=M1−aZ1`、`c=0`；间隔守卫 ≥5%；两负载拟合上板仍待验 |
| LLM-081 | **通道级校准系数选择** + `\|b\|/R0≤0.25` + `\|a−1\|≤0.50` 双守卫 | 采纳并上板 | 只有 B 挡应用校准（A/B/C/D = 0/1/0/0）；单点 CRSS 由 −595 pF 转正 |
| LLM-081 | 校准阈值 0.10→**0.25** | 采纳 | 0.10 时 25 处断言失败；0.25 仍拒掉全部真实退化点 |
| LLM-083 | 先判"测量错"还是"判据错"，协方差补**平台重复性方差** | 采纳并部署 | 曲线在 ±1% 内 ⇒ 判据问题；把误报 117 分降到 1.24 |
| LLM-084 | 读 PL `0x43C00060` 的 `front` 位确定前台 fb 再 dump | 采纳 | 4 张 UI 截图；180° 旋转后 PNG 存档 |

---

## 四、没采取 / 被否决 / 被模型自己撤回的点

| 编号 | 提议 | 结果 | 原因 / 替代 |
|---|---|---|---|
| LLM-002 | "先做仿真再写代码"的论证 | 用户未采纳也未反驳，转而改变分工 | 论证是逻辑推理，不是实测结论 |
| LLM-007 | `assign dac_cs = 1'b0;` | 暂未采纳 | 与 `output reg` + 状态内赋值语义等价，只是表达方式 |
| LLM-007 | 保留 `spi_sclk` / `spi_cs` 调试端口 | 用户删除 | 交付不需要 |
| LLM-013 | AD9833 init 挂到 DAC `PWR_WAIT` 之后 / 单列上电顺序决策 | 用户未表态 | 未决，拟进决策表 |
| LLM-020 | 把 `.git` 并到工作区目录 | **用户否决，模型撤回** | 两个目录是有意分开的（工作区 / 交付仓库）；模型只看目录名与 `.git` 位置就把观察升级成结论 |
| LLM-025 | 电脑装 Python 3.8 / 升级板子的 Python | 用户拒绝 | 统一环境的持续维护成本高于风险；替代是写作纪律 + 板端解释器 |
| LLM-029 | `ADDR_WIDTH` 7→8 | 模型核实后自撤 | 22+7=29/32，还剩 3 个；不为未出现的需求动已验证的边界 |
| LLM-031 | 插 `axi_protocol_converter` | 未选 | 原生 AXI3 更适合按拍数算余量的实时通路 |
| LLM-044 | 双 MMCM + BUFGMUX 切换 | **用户否决** | "写个分频器不行吗怎么只能二分频" ⇒ 一个计数器即可 |
| LLM-044 | PLL 输出 65 MHz 再分频 | 模型自算后放弃 | 65=5×13，65/n 得不到 10 MHz ⇒ 改 130 MHz=lcm(65,10) |
| LLM-044 | "DDS 频率与 ADC 采样率不能独立调" | **用户推翻** | "你调整 dft 代入的频率不就行了"；相干条件不满足只是精度降级，不是功能失效 |
| LLM-055 | 10 MHz 激励档 | 删除 | 25 MHz MCLK 下每周期只有 2.5 个 DAC 采样点：算术成立、物理不成立；用户上板发现输出不了 |
| LLM-063 | 自动换挡 | 用户明示押后 / 禁用 | 等连好挡位控制引脚；后清掉残留 `sweep_auto_gear` 标志 |
| LLM-078 | 继续追 COSS/拐点 8% 左移的根因 | 用户拍板不追 | "如果是测量误差就算了，只要不是显示导致的就行" |
| LLM-079 | 用健康件自身拟合拐点做特征 | 改为 4 个与拟合无关的特征 | 健康件自己就会得高分（Ciss 留一法最大 118.9） |
| LLM-081 | 把 A/C/D 挡校准系数也应用 | 被物性守卫拒绝 | A 挡 `\|b\|/R0=0.564`；C/D 挡 `\|a\|=1.42/9.6`，会把噪声放大 10 倍还标"已校准" |
| LLM-081 | 初始阈值 0.10 | 改 0.25 | 合成用例 0.155 被误拒，25 处断言失败 |
| LLM-084 | 把 C/D 挡写成"已验证" | 拒绝写入 | 用户切到 D 挡但没跑单点，宿主证据 `available=0/1/0/0` |

### 4.1 被实测或反问推翻的判断（不是建议，是结论错误）

| 编号 | 模型当时的判断 | 怎么被推翻 | 留下的教训 |
|---|---|---|---|
| LLM-003 | "厂商 IP 不计入工作量"是赛题规定 | 用户一句"文档有说明吗"→ 全文检索指南 PDF 零命中 → 撤回 | 推断不能包装成规定；要出示一手出处 |
| LLM-013 | 一处 RTL 改动"零风险" | 用户反问"我这个模块还要给 dac 用不好改啊" | 共享模块改动前先数实例、走下游耦合 |
| LLM-021 | "`.xpr` 残留引用已清零" | 再跑一次综合才暴露 | 工具的"回读"才算证据，grep 配置不算 |
| LLM-026 | `X_INTERFACE_PARAMETER` 是时钟识别必要条件；`GPIO_0` 会展开 3 个端口；22 端口不通 | 板上实测逐条推翻 | 探针设计缺陷会被误读成结论 |
| LLM-063 | Im Z 的 SD 从 28.76%→0.42% 是 DIV 的功劳 | 两个变量同时动；改用同一运行内 `2:−1` vs `4:+1` 对照 | "找到一个差异"≠"找到了原因" |
| LLM-081 | COSS 4469→3631 是重复性差 | 用户纠正"前面忘开偏压" | 0 V 时 Coss 最大，同对照 CISS/CRSS 只差 4.7%/0.6%，自洽 |
| LLM-084 | 报告里的二进制 md5 是现值 | 发布前现读 `/proc/<pid>/exe` 发现已变 | 运行中的产物只能现场读 |

---

## 五、人类浓缩后的心得

以下每条都来自真实对话或一次真实返工，括号内是出处。

1. **先要最简机制，再谈最优架构。**
   "写个分频器不行吗怎么只能二分频"（LLM-044）——模型拿双 MMCM + BUFGMUX 解决一个计数器就能解决的问题。
   复杂方案必须先回答：为什么简单方案不行？

2. **"最优"不等于"必须"。**
   "你调整 dft 代入的频率不就行了"（LLM-044）——相干采样是精度最优，不是功能前提；
   把它当成硬约束，会凭空造出一个不存在的设计难题。

3. **改共享模块前，先数它被谁用。**
   "我这个模块还要给 dac 用不好改啊"（LLM-013）——局部改对不等于全局安全；
   改动前要枚举所有实例、所有下游依赖时刻。

4. **坏系数比没系数更危险。**
   "其他档位不合理就先不应用校准呗有关系吗"（LLM-081）——没有校准只是不准；
   用了退化系数会把噪声放大 10 倍，还标着"已校准"。宁可显示"未校准"。

5. **先划清误差归属，再决定追不追。**
   "如果是测量误差就算了，只要不是显示导致的就行"（LLM-078）——测量误差、显示误差、算法误差
   是三类问题，处理成本完全不同；不是所有偏差都值得追到根因。

6. **人对"能不能维护、能不能讲清楚"的判断优先于模型产出速度。**
   LLM-002：用户把模型写好的 2400 行代码推翻，改为自己先写。
   能跑不是唯一标准，能被人接手、能解释每一步才是。

7. **授权是分层的。**
   "你直接分配引脚并且接入 ps 端写完我上电你调试"（LLM-056）——代码可以代写；
   断电、接线、上电、万用表这些物理动作始终在人手里。

8. **目标排序由人定，技术最优要让位于交付节点。**
   "总之现在以复刻出结果为导向，加分点再说"（LLM-060）——先交付可复现的结果，
   再补评分项；模型不能替人决定优先级。

9. **任何"规定/依据"都必须能回到一手出处。**
   "文档有说明吗"（LLM-003）——一句话就让"厂商 IP 不计工作量"这条编造的规定现形。
   二手资料、印象、推断，都不能当规范用。

10. **记录过 ≠ 防住。**
    LLM-063：同一个"改错树"的坑，在 LLM-062 已经记录过，仍然再犯一次。
    沉淀必须落成无条件执行的机械步骤：改前用绝对路径、推完 `md5sum` 回读、
    二进制产物只认 md5。

11. **先定义"我数的这个量在接口哪一侧"。**
    LLM-059：讨论了很久"一次写"，却从没量过"一次写"本身，把它当成了前提假设。
    计量对象没定义清楚，后面的数据都不可比。

12. **先做零成本排除，再怀疑代码。**
    LLM-018：最终根因是跳线帽没接板载晶振，不是 RTL。
    供电、跳线、连接、版本，这些检查的成本远低于重写代码。

---

## 六、协作边界：AI 能做什么、不能做什么

| AI 可以承担 | AI 不能替代 |
|---|---|
| 读一手手册并把时序/命令边界落成常数与状态机 | 判断器件、夹具、接线的**物理事实** |
| 生成可综合 RTL、测试台、脚本与文档 | 上板、断电、接线、万用表等物理动作 |
| 跨文件一致性检查、寄存器映射核对 | 决定需求优先级与"做到什么程度算够" |
| 把现象折算成数值反证（如用原始 Z 反推系数） | 对未实测行为下"已验证"的结论 |
| 把踩过的坑写成检查清单与 skill | 替人承担验收责任 |

**证据等级（记录里实际使用的口径）**：

1. **一手规范**：手册页码、时序图、命令表；
2. **工具证据**：`xvlog`/`xelab` 日志、综合/布线报告、`report_clocks`；
3. **板上证据**：寄存器回读、`/proc/<pid>/exe` md5、波形/截图、万用表读数；
4. **推断**：以上都没有时只能说"推断"，并写明缺哪一步验证。

**三条硬纪律**（多次踩坑后形成）：

- 没有验证就写"未验证"，不为了把话说满而伪造实测；
- 结论被推翻时保留纠错轨迹，不删改历史记录；
- 运行中的产物现场读（`/proc/<pid>/exe`、`md5sum` 回读），不信记忆和上一周期的数字。

---

## 七、证据索引

- 逐条记录：`llm-log/LLM-001.md` ~ `LLM-084.md`，模板见 `llm-log/_TEMPLATE.md`
- 总索引与统计口径：`llm-log/INDEX.md`
- 已落地经验：`skill/`（16 项），例如
  `skill/measurement-instrument-can-be-wrong/`、
  `skill/stale-artifact-silent-reuse/`、
  `skill/count-both-sides-of-interface/`、
  `skill/use-layout-as-ruler/`
- 实现与测量代码：`src/rtl/`、`src/c_ui/`、`src/python/`
- 设计与接口文档：`docs/`
- 当前位流与硬件描述：`board/qrs.bit`、`board/qrs.hwh`（md5 见 `README.md`）

---

*本文件只做归纳，不新增未经记录支持的事实。引用具体结论时，请回到对应的 `LLM-xxx.md` 核对上下文与验证方式。*
