dsgmxc/2026_fpga_qrs/llm-log/LLM-084.md

# LLM-084: 界面截图取证 + 标准板单点反查 —— 校准残差第一次有完整的数

- **日期**: 2026-11-02
- **模型**: deepseek-flash(Claude Code CLI)
- **任务**: 用户要"上电后说截图,就把 UI 界面截下来传到桌面";顺带用界面实测校准效果。

## 提示词

```
重启开发板吧
```

```
拉起服务
```

```
全部测完了
```

```
关闭系统
```

```
我等会给设备上电然后我告诉你截图你就截下ui界面并传输到当前桌面
```

```
上电了
```

```
截图
```

```
名字要命名整理到一个文件夹里
```

```
截图
```

```
截图
```

## 模型回答

1. **重启后又上电时**:软重启 → `systemctl enable qrs-ui`(用户要求开自启)→ `start` 一次,
   本周期位流恰 1 次;复核 A 挡点测日志 `(未校准)`、B 挡 `(已校准)`、AI 0.1/0.1/0.7。
2. **截图方法(不猜双缓冲)**:读 PL 寄存器 `0x43C00060` 的 `front` 位,确定屏幕正在扫的
   是 `fb0 = 0x38100000` 还是 `fb1 = 0x38230000`;再用板上 `/home/xilinx/fb_dump.py`
   只读 dump 1288800 B 的 RGB565 帧缓存;取回宿主后 **180° 旋转**(画布本身是倒的),
   `PIL` 存 PNG 到 `~/Desktop/qrs_ui_shots/<YYYYMMDD>_<HHMMSS>_<页面>.png`。
3. **截图判读**:首页(100 Ω、已校准)、系统复位页、校准页(16/16、四挡 L2*)、单点测量页。
4. **单点页被测件是标准板 1**(Cgs 1986 / Cgd 10 / Cds 104 pF),于是直接算残差:
   CISS 1995.788 pF(−0.01 %)、COSS 116.690 pF(+2.4 %)、CRSS 12.120 pF(+21 %);
   并指出 CRSS 误差大是 `|Z|/R0 ≈ 131` 的量程问题,不是校准算法错。

## 结果

☐ ✅ 直接可用   ☑ ⚠️ 部分可用   ☐ ❌ 不可用

> 截图链路与标准板 CISS/COSS 残差可用;**CRSS 残差 +21 % 受限于"无可用高档位"**,
> 已在报告里给出判据,未把它写成"校准已完善"。

## 验证方式

- 截图:三张 PNG 存 `~/Desktop/qrs_ui_shots/`,其中单点页那张同时入库为
  `report/measurements/artifacts/20261102_standard_board_single_point.png`(`b097e7d4…`)。
- 数值:板上 `/var/log/qrs-ui.log` 的 `[adc] 单点   Z = …` 三行(校准前后都记);
  本次上电 `dmesg` 中位流加载 **1 次**;运行二进制 `/proc/<pid>/exe` 现读。
- 报告:`report/measurements/20261102_standard_board_check.md`。

## 纠错轨迹

1. **把上一周期的二进制 md5 当现值**:我在报告草稿里写 `/proc/<pid>/exe = 44c1ff2b…`
   (那是 2026-10-29 那轮的),发布前现读发现已是 **`ed89168f…`**(后续会话又重编过,
   `nm` 仍含 `cal_channel_point`)。⇒ **运行中二进制的 md5 只能现读,不能抄历史记录。**
2. **截图文件名用错日期**:先按"对话里最后一次系统日期"命名成 `20261029_…`,
   而宿主 `date` 已是 **2026-11-02**(板子关机跨越了几天)。⇒ 文件名日期取
   **截图当时主机的 `date`**,不取会话记忆。
3. **界面文案过期(截图才看见)**:「系统复位」页底部仍写"采样率固定 **65 MSPS**",
   实际 `CV_ADC_DIV_DEFAULT = 4` ⇒ **32.50 MSPS**。纯文案错误,位置
   `src/c_ui/ui/ui_demo.c:3988`;改它要重编+重启服务(二次加载位流),
   本周期不做,留待下次上电前一起改。
4. **C/D 挡上板证据仍缺**:用户本轮切到 D 挡(截图里 `档位:10kΩ`)但没跑单点;
   `|a−1|` 守卫对 C/D 的拒绝仍只有宿主证据 —— **不写成已上板验证**。

## 沉淀

→ 候选 `skill/framebuffer-screenshot-by-front-index/` —— 双缓冲截图必须**先读硬件的前台索引**
再 dump,否则会随机抓到后台帧;且画布旋转角度要以实际物理安装为准(本项目 180°)。
→ 候选补充到 `skill/build-artifact-is-the-evidence/` —— **"正在跑的"md5 要读
`/proc/<pid>/exe`,不是磁盘文件、更不是上一次的记录**。
