dsgmxc/2026_fpga_qrs/llm-log/LLM-083.md

# LLM-083: AI 把健康板判成「异常」—— 模型协方差只有器件间差异,没有本机重复性

- **日期**: 2026-10-30
- **模型**: deepseek-flash(Claude Code CLI)
- **任务**: 用户报「ai检测结果怎么会显示异常」,要求用板上数据定位并修改;
  修改后先上板,文档随后补。

## 提示词

```
ai检测结果怎么会显示异常
```

```
我板子开着啊你看看数据哪里有问题
```

```
现在试试
```

```
所以是什么问题
```

```
进行修改
```

```
继续
```

（部署后）

```
修改好了先传板子上，文档什么的后面慢慢更新
```

```
现在可以去完成更新了
```

## 模型回答

1. **先分清「测量错」还是「判据错」**:用户看到的是 CISS **117.1 异常**、COSS 17.4 /
   CRSS 6.9 正常。把 117 分那条扫压的 CISS 曲线与健康基线逐点比,**整条曲线在 ±1 %
   以内** —— 测量没有问题,是判据把平台漂移当成了器件故障。
2. **分数的来源**:4 个特征里贡献几乎全在**特征 3 `log10(V75/V25)`**。
   该次偏差 **−0.021 log10(−4.8 %)**,而旧模型的 σ 只有
   `1/√2.2238e5 = 0.0021 log10(0.49 %)` ⇒ 2.4 % 就够 25 分、4.8 % 就够 100 分。
   `V25`(1.3 V 附近的交叉点)随平台状态整体移动,`V75` 很稳 —— 比值把 1 % 的平台
   平移放大成 ~5 %。
3. **旧协方差的口径**:来自 **10 颗 TH521 器件之间的差异**,完全不含**同一块板
   重复扫压**的差异。这是建模时漏掉的一个方差项,不是阈值定低了。
4. **修法**:`fit_anomaly_model.py` 增加 `--repeat`
   - 中心 = **4 轮本机健康重复扫压的特征均值**(不再用单次基线);
   - 协方差 = 器件收缩协方差(reg = 0.1)**+ `diag(平台重复性方差)`**;
   - 阈值 25 / 100 不变(改模型口径,不改判据)。
5. **重复性数据只收当前校准方案**:日志里 7 轮完整已校准扫压,5757 / 6627 / 7304 用的是
   旧的**按腿校准**(a ≈ 1.0758),8170 / 8913 / 10127 / 11055 才是 2026-10-29 起的
   **通道级校准**(a ≈ 0.983)。混在一起会把两套系数差算成"平台重复性",把灵敏度白白吃掉。
6. **新模型自检**:4 轮重复扫压得分最大 **2.40**;把用户遇到的那次扫压(日志第 11055 行)
   喂给同一份 C 代码:**CISS 1.24 / COSS 1.29 / CRSS 0.64 → 正常**。
7. **代价如实记**:CRSS 平台重复性 σ ≈ 2 %(4 轮之间有一次 ~3.7 % 的重新校准台阶),
   所以 CRSS **纯增益 10 %** 从旧模型 53.2 降到 **13.6(正常)**;要到 20 % 才 62.9(待查)、
   30 % 才 140.1(异常)。测试里把这条写成显式断言,不藏起来。

## 结果

☐ ✅ 直接可用   ☑ ⚠️ 部分可用   ☐ ❌ 不可用

> 宿主单测全过;新模型已上板,新二进制确认在跑,旧常量逐字节消失。
> **唯一没验的**:用户还没在新模型下再跑一次扫压,**AI 页显示「正常」未亲眼看到**。

## 验证方式

- **宿主单测** `test_anomaly_detect`:ALL OK(基线得分 1.93 / 1.28 / 1.05,
  电平 ×1.10 → 442.8 / 265.8 / 13.6,CRSS ×1.20 → 62.9 待查、×1.30 → 140.2 异常)。
- **同数据复算**:把 11055 行那轮扫压的 180 个点直接喂给 C 版 `Anomaly_Evaluate`
  (`/tmp/test_run11055`,链接同一个 `anomaly_model_data.h`),得 1.236 / 1.291 / 0.641。
- **模型统计**:留一法最大 4.92 / 3.28 / 3.38;两两最大 7.93 / 7.79 / 8.12;
  平台基线 1.92 / 1.29 / 1.05;重复扫压最大 2.40。
- **重复性 σ(header 原样)**:CISS `[0.0013, 0.0020, 0.0009, 0.0137]`,
  COSS `[0.0045, 0.0020, 0.0002, 0.0044]`,CRSS `[0.0085, 0.0074, 0.0003, 0.0025]`。
- **注入异常**(仍要能抓):电平 ×1.05 → 117.3 / 71.5 / 2.1;×1.10 → 443.0 / 265.8 / 13.6;
  电压轴 ×1.08 → 85.3 / 15.7 / 20.4;拐点 ×1.3 → 141.4 / 991.6 / 140.1。
- **上板**:只推 `anomaly_model_data.h`;板上 `rm -f build/app/anomaly_detect.o
  build/app/anomaly_detect.d build/app/pynq_protocol.o build/app/pynq_protocol.d c_ui`
  后 `make -j2`。新 `c_ui` md5 **`ed89168f00b5e7236a228f519cd77e4e`**
  (旧 `a7608ae7…`);用 float 小端字节核对:**16 个新中心/逆协方差常量全部命中,
  4 个旧中心常量 0 命中**。软重启后位流**恰加载 1 次**,`qrs-ui` active,
  `/proc/634/exe` md5 与新二进制一致。
- **数据** `artifacts/20261029_platform_repeat_cal_v2.csv`(工作区 `report/`、交付仓库 `board/` 下)
  (4 轮 × 3 腿 × 60 点 = 720 行,md5 `e4b5c38c2f21baf18cfc018a60fa23b7`),
  由其脚本从 `20261029_ai_abnormal_run.log`(md5 `25f60fa0…`)导出。

## 纠错轨迹

1. **重复性总体一开始收多了**:把 7 轮全收进来,旧校准那 3 轮让协方差整体变大,
   注入 ×1.10 的 CRSS 只剩 11.4 分 —— 判据被稀释。**发现方式**:逐轮打印特征值,
   看到两组之间是"台阶"而不是"抖动"。**改法**:`--min-line 8170` 只收当前校准方案。
2. **提取脚本漏掉 CISS**:`[proto] 扫压第 1 腿:CISS` 打在"扫压开始"横幅**之前**,
   从横幅起扫就永远收不到第一条腿 ⇒ 改为用表头 `CISS+COSS+CRSS` 初始化当前腿。
3. **提取脚本把 3312.001 写成 3312**:`%g` 只有 6 位有效数字 ⇒ 改用 `str()`
   保留日志原值;整份 CSV 重新导出。
4. **原型在 100 V 处返回 NaN**:插值函数对 `t >= 最后一个点` 直接返回 NaN,
   而 C 版是**钳到末段**。不先对齐这两处,C 与 Python 的注入分数没法逐位对。
5. **板上的 make 不能信(旧的坑又踩)** —— 板 RTC 比宿主慢 26 天,上传文件 mtime 在"未来"。
   继续按 `LLM-081` 的纪律:**先 `rm -f` 目标对象再编**,判据是产物里的常量字节,
   不是 make 的输出。
6. **没有为了"保住灵敏度"去换特征**:考虑过把 `V75/V25` 换成固定比值(`C2/C10`、`C3/C20`)
   或局部斜率 —— 它们更稳,但那等于换了一个模型语义,而且仍要靠重复性数据定尺度。
   选择**保留物理含义明确的膝宽比 + 把平台重复性显式写进协方差**,并把代价写进测试。
7. **没有把"已上板"写成"已显示"**:屏幕上的 AI 结果要等一次新扫压才会刷新,
   本轮只写到"新模型在跑、同数据复算正常"。

## 沉淀

→ 候选 `skill/covariance-needs-every-variance-source/` —— 无监督判据的协方差必须覆盖
**所有真实存在的变异来源**(器件间 / 批次间 / 同一台仪器的重复性 / 校准状态),
漏一项就会把"平台的正常漂移"当成"器件的异常";判据失效时先查**方差项**,不是先调阈值。
→ 与 `skill/unsupervised-baseline-absorbs-platform-offset/`(LLM-079)互补:
那一条只把**中心**挪到本机,本条把**尺度**也算上 —— 只挪中心不扩尺度,平台一换状态就误报。
→ 候选 `skill/one-model-two-calibrations/` —— 同一份日志里混着两套校准方案的扫压,
   **不能当作同一总体的重复样本**;分组前先核对每轮用的是哪套系数。
