dsgmxc/2026_fpga_qrs/llm-log/LLM-081.md

# LLM-081: 单点 CRSS 为负 —— 扫压与单点取的不是同一套校准系数

- **日期**: 2026-10-29
- **模型**: deepseek-flash(Claude Code CLI)
- **任务**: 用户问「扫压正常、单点 CRSS 却是负的」。定位根因并修复,上板验证。

## 提示词

```
扫压倒是可以了我现在单点测量怎么会crss是负的，扫压都没问题啊
```

（实现方式由用户二选一,选的是 A）

```
A. 统一成通道级校正(推荐)
```

```
要改代码先关系统吧
```

```
上电了
```

（验证后的追问）

```
跑完了，但是扫压中间是不是有自动切换档位啊我看到有关系吗
```

```
自动换档就关了吧，还有什么要改的吗
```

```
COSS 4469/4481 → 3631/3600后面3千多是我开启偏压测的，前面忘开了
```

```
其他档位不合理就先不应用校准呗有关系吗
```

（第二道守卫上板后）

```
重启开发板吧
拉起服务
全部测完了
```

## 模型回答

1. **数值反证根因**:把日志里的**原始** `Z` 分别套两套系数,逐位复现了显示值 ——
   - 单点 CRSS 原始 `160.55−92.33j` 套 **CRSS-B** 系数 → `137.7+267.4j`(**Cs −595 pF**,与屏幕一致);
   - 扫压 CRSS 原始 `157.53−95.23j` 套 **RG-B** 系数 → `161.14−107.70j`(**Cs +1477.7 pF**,与屏幕一致)。
   ⇒ 扫压三腿都在用 **RG 腿**的系数,单点在用自己的。CISS/COSS 同样能复现。
2. **代码定位**:`sweep_begin_leg()` 里**只有 `Calibration_BeginStandard()`/继电器,没有 `s_pair_path = leg;`**;
   而"先测 RG 再三路扫压"这条路径结束时 `s_pair_path` 停在 3(RG)。
3. **为什么不能只补一行**:CRSS 腿自己的拟合是退化的 —— B 挡标准板 10 pF / 104 pF 对应
   13.2 kΩ / 1.6 kΩ,而 `R0 = 100 Ω`,`b` 拟合出 `3.3·R0`,还带正虚部(非物理)。
   即使把 `s_pair_path` 补对,单点仍会用这份坏系数。
4. **方案 A(用户选定)**:校准应用改成**通道级** —— 在 (挡位, 频率) 下,从四条腿的拟合里选
   `|b|/R0` 最小的一条(且 ≤ `CAL_B_REL_MAX`)。物理依据是「误差网络属于通道、不属于被测腿」。
5. **上板验证**:CRSS 单点 `1530/1531/1538/1538 pF`,扫压首点 `1501.5 pF`,同口径差 2.5 %。
6. **对「其他档位不合理就不应用校准」的回答**:没关系,而且比"有系数就用"更安全 ——
   报告数据本来就只用 B 挡,不应用不改任何已发表数值。检查后发现旧守卫只查 `b`,而 C/D 挡的
   `|b|/R0 ≈ 0.001` 恰好过关,可它们的 `a = 1.054+0.948j` / `1.482+9.471j`(`|a| = 1.42 / 9.6`)
   —— 应用后会把噪声放大近 10 倍,界面却标"已校准"。于是加**第二道守卫**
   `CAL_A_DEV_MAX = 0.50`(`|a−1| ≤ 0.50`)。用真实校准文件复核:A/B/C/D = `0 / 1 / 0 / 0`,
   **只有 B 挡应用校准**,与用户要求的"不合理就不应用"一致。

## 结果

☐ ✅ 直接可用   ☑ ⚠️ 部分可用   ☐ ❌ 不可用

> 主问题(单点为负 / 单点与扫压不一致)**已修并上板验证**;
> 但暴露出的「COSS 相对仪器系统性偏低 13 %」是**改动前后都在**的老问题,本轮未查。

## 验证方式

- 宿主:`test_calibration`(新增退化拟合用例、守卫语义更新)、`test_anomaly_detect` 全部 **ALL OK**。
- 上板:`c_ui` md5 `5f9c5ddfffbfa02af8f188db68abc634`(测量用的);位流 `c92c7ed5…` 本周期**恰加载 1 次**;
  FCLK0 50.0000 MHz;1 MHz / 32.5 MSPS;挡位 B。
- 第二道守卫:宿主单测 ALL OK;另写 `/tmp/check_channel` 直接调 `Calibration_Init()` 读**板上真校准文件**,
  得 `total=16/48`、A/B/C/D `available = 0/1/0/0`;板上重编为 `44c1ff2b794078d78de7b448613a5755`
  (`nm` 含 `cal_channel_point`),**下个上电周期生效**(本周期仍在跑的进程是旧二进制,
  按"一次上电一次位流、不重启服务"的规矩不动它)。
- 数据:单点 3 次 + 180 点扫压 + 2 次偏压未使能的对照点测;
  `report/measurements/20261029_channel_cal_verify.md`、`artifacts/20261029_leg_settle_sweep_cal_v2.csv`。

## 上板复验(同日,重启后)

提示词:「**重启开发板吧**」→「**拉起服务**」→「**全部测完了**」。

- **前置**:软重启后位流**恰加载 1 次**;服务运行时 `/proc/906/exe` md5 = **`44c1ff2b…`**
  ⇒ 带第二道守卫的二进制真的在跑(不是"新编了但起的还是旧的")。FCLK0 50.0000 MHz。
- **守卫**:A 挡三腿点测日志写 `(未校准)`(原样输出 3485.7 / 3758.9 / 1589.2 pF);
  B 挡写 `(已校准)`。
- **B 挡点测**:CISS 3311.6 / 3328.7、COSS 3609.4 / 3598.5、CRSS **1539.3 / 1539.8 pF**,
  RG **3.113 Ω**;重复性 0.5 % / 0.3 % / 0.03 %。
- **扫压**:CISS 单腿 60 点 + 三腿 180 点,**250/250 条 ADC 记录 `OTR 0`**,扫压期间无自动换挡;
  CRSS 单点 1539.5 vs 扫压首点 1504.1(**2.3 %**)。
- **新基线**:`[ai] CISS 0.1 / COSS 0.1 / CRSS 0.7 -> 正常`(阈值 25)⇒ `ANOMALY_MODEL_BASELINE_DATE "2026-10-29"` 生效。
- ⚠️ **C/D 挡本轮没点**:其"被拒"目前只有宿主证据(同一校准文件 `available = 0/1/0/0`),
  **不写成已上板验证**。日志见 `report/measurements/artifacts/20261029_guard_verify_run.log`。

## 纠错轨迹

1. **物性守卫阈值先设 0.10,把正常点也毙了** —— `test_calibration` 25 处断言失败:
   测试里的合成 `b = {15, −4}`(`|b|/R0 = 0.155`)被拒。
   **发现方式**:跑单测看失败数,不是靠读代码。
   **改法**:阈值放到 **0.25** —— 仍拒掉全部真实退化点(CRSS-B 3.28、CRSS-C 0.66、CRSS-D 0.542、
   A 挡最佳 0.564),同时放行 COSS-B(0.048)、RG-B(0.057)、CISS-B(0.0097)。
2. **守卫用例的语义变了没跟着改**:原测试断言"腿 2(RG)单独拟和应用应**不准确**",
   通道级之后 RG 腿也该**准** —— 测试期望改成「四条腿反演一致」。
3. **板上 `make` 撒谎(最费时的一条)**:推源码后 `make -j2` 打印重编 `pynq_protocol.o`、
   重新链接 `c_ui`,但 **md5 与改动前完全一样**,`nm` 里没有新符号。
   **根因**:板子 RTC 慢 11 天,上传文件的 mtime 在"未来",`-MMD` 的 `.d` 也是;
   make 的时间比较失效,链进了旧 `.o`。
   **改法**:`rm -f build/app/*.o build/app/*.d c_ui && make -j2`。
   已写进 `docs/dev_handbook.md` §8.2:判据必须是 `nm c_ui | grep <新符号>` 与
   `grep -ac '<新中文串>' c_ui`,**不是 make 的输出**。
4. **验证手段本身踩坑**:第一轮用 `strings c_ui | grep '状态:就绪'` 得 0 —— `strings` 只出 ASCII,
   中文恒 0,该判据无效。改用 `grep -a` 直接扫二进制。
5. **误判「COSS 重复性差」**:同一 0.1 V 下 COSS 先是 4469/4481 pF,后是 3631/3600 pF,
   一度判为"换腿沉降不足"。用户纠正:**前两次偏压没使能**。
   数据自洽:0 V 时 Coss 最大(+24 %),同一对照里 CISS 只差 4.7 %、CRSS 只差 0.6 % ——
   与物理一致。⇒ **两种工况,不是重复性**。教训:点测日志打印了"偏压 0.100 V"这个**设定值**,
   却没打印**输出是否使能**,判据被含糊的日志误导。
6. **自动换挡残留**:`/home/xilinx/sweep_auto_gear` 是 10-15 留下的文件开关,本轮扫压中途
   切了一次挡(1/180 点)。回退逻辑正确、数据连续可用;已删除标志文件。
7. **单守卫漏判(用户提问才暴露)**:第一版通道选择只查 `|b|/R0`,于是 C/D 挡被判"可用" ——
   它们的分母 `R0` 是 1 kΩ / 10 kΩ,把一个大得离谱的 `a` 虚部"归一"掉了。
   **发现方式**:用户问"其他档位不合理就先不应用校准呗有关系吗",我把它当检查项去核,
   打印出四挡的 `a` 才看到 `|a|` 到了 9.6。
   **改法**:加 `|a−1| ≤ 0.50`;**测试跟着改** —— 4 处合成 `a = {2.0, 0.3}`(本意只是造"小 b")
   现在会被新守卫拒,改成 `{1.05, 0.02}`(仍满足"小 b、a 接近 1"的原意),并另加一个
   **只有大小不对 b 很小**的专用用例,保证两道守卫各自都有用例覆盖。

## 沉淀

→ 待建 `skill/numeric-reproduction-of-a-log/` —— 把"两套系数分别代回原始值、看哪一套能逐位复现屏幕读数"
作为定位"两条路径口径不一致"的判据;它比读代码快,且不依赖日志文案。
→ 待建 `skill/build-artifact-is-the-evidence/` —— 构建工具的输出不是证据,
**产物里的符号/字符串**才是;存在时钟偏差时先删产物再编。
