dsgmxc/2026_fpga_qrs/llm-log/LLM-080.md

# LLM-080:两负载校准 —— 两块已知标准板走两点仿射,不再依赖开路/短接

- **日期**: 2026-10-27
- **模型**: deepseek-flash(Claude Code harness)
- **任务**: 本夹具的 OPEN 被四挡一致性闸判死、用户又不愿短接 ⇒ 只剩一块标准板时**采到 16/16 也拟合 0/16**。改代码支持**第二块标准板**(参数同样手动输入),用两个已知负载定仿射,用户随后上电验证。

## 提示词

```
一定要完成短路校准才能进行校准吗
```

```
一定要短接吗没别的办法吗
```

```
我有两个负载行不行
```

```
关闭系统吧，改成支持两负载的模式，一样手动输入然后我再上电
```

## 一、为什么两块负载就够

误差模型是 Möbius:`Z_m = (a·Z_d + b)/(c·Z_d + 1)`。本夹具实测误差主要是一条
**乘法型复数误差**(`a` 为复数、`b ≈ 0`),所以退化成仿射也够用:

```
Z_m = a·Z_d + b        (c = 0)
```

- 只有 **一块**已知负载 ⇒ 一个方程,`a`、`b` 两个未知量 ⇒ **无解**(这正是 10-25 那轮
  「标准板校准 16/16 采集成功、拟合 0/16」的原因);
- **两块**已知负载 ⇒ 两对 `(Z_L, M_L)`:

```
a = (M_2 − M_1) / (Z_2 − Z_1)
b = M_1 − a·Z_1
```

⇒ **既不需要开路,也不需要短接**。

**间隔守卫**:`|Z_2 − Z_1| ≥ 5% × max(|Z_1|, |Z_2|)`(`CAL_LOAD_SEP_MIN`)。
两块板标称值太接近时两个方程几乎重合,硬解会把测量噪声放大 `1/间隔` 倍 ——
宁可显示"未标定",也不给一个数字好看但没有意义的反演。

## 二、落地改动

| 文件 | 改动 |
|---|---|
| `app/calibration.h` | `CAL_STD_LOAD2 = 3`;`CAL_FIELD_CGS2/CGD2/CDS2/RG2`(6..9,`CAL_FIELD_COUNT = 10`);`CalBoard` 加 4 个 double;flags 扩到 **16 位**(`CAL_F_LOAD2 0x100` / `CAL_F_WEAK_LOAD2 0x200`,原 8 位不动);`Calibration_PointFlags` → `uint16_t`;新增 `Calibration_LegDefined2` / `Calibration_StandardZ2` |
| `app/calibration.c` | `CAL_VERSION` **1 → 2**;头 64 → **96 B**、点 100 → **120 B**(新增 `load2_re/im`);`refit_point()` 新增**路径 3:LOAD1+LOAD2 两点仿射**;单负载路径优先标准板 1、未定义才退回标准板 2;`StandardZ` 抽出公共实现;`StoreRaw` / `SetBoardField` / `Init` 处理新字段;完成消息区分「标准板1 / 标准板2」 |
| `app/pynq_protocol.c` | 标准名 4 个;准入放宽到 `standard ≤ CAL_STD_LOAD2`,LOAD2 检查**它自己那组**参数;只采到一块板时进度行提示「再采另一块标准板即可标定」;`s_cal_text` 80 → **256 B** |
| `ui/ui_demo.c` | 校准页 10 个字段(左面板 576 → 700 px,3 行 × 4 列);采集按钮 3 → 4(动作码 **343**);覆盖格新增 `2` 记号;所有 `CalField` 的标题/单位/名称/提示/格式化/当前值 switch 补齐;字段按钮改 **2 位小数** |
| `tests/test_calibration.c` | 新增 `acquire_two_loads()` 与两个用例:两块板相隔 50%+ → **16/16 且反演误差 < 1e-6**;只差 1% → **0/16** |

**拟合路径优先级**(`refit_point()`):

```
1. OPEN + SHORT + LOAD   完整 Möbius
2. SHORT + LOAD          仿射(c=0)
3. LOAD1 + LOAD2         两点仿射(c=0)   ← 本次新增
4. OPEN + LOAD           b=0 的 Möbius
5. 仅 OPEN               平行杂散校正(a=1,b=0,c=1/M_o)
```

高优先级先试:SHORT 是精确 0 Ω,比"两个数据手册标称值"更可信;只有它不可用时才走两负载。

⚠️ **存盘格式升到 v2 ⇒ 旧 `cv_calibration.dat` 会被版本号拒掉**,板上升级后**必须重采**。
这是有意的:布局变了还"尽量兼容",读到错位的 double 比直接拒更危险。

## 三、自我纠错轨迹

| # | 事情 | 结论 |
|---|---|---|
| 1 | 字段从 6 个加到 10 个,先按 **2 行 × 5 列、每格 128 px** 排 | 用 `lv_font_get_glyph_dsc` 逐字量宽:"1000000.000 pF" = **144 px**,而 128 px 按钮的标签只有 108 px ⇒ 必然折行被裁。改成 **左面板 700 px / 3 行 × 4 列(161 px)** |
| 2 | 量字宽的第一版小程序用了 `lv_txt_utf8_next()` | LVGL **8.2 没有这个 API**(链接期 undefined reference)⇒ 自己写 UTF-8 解码(1/2/3 字节) |
| 3 | 改用 700 px 后右侧覆盖表从 388 收到 280,汇总行原样保留 | 实测 "拟合 16/16 · 1 MHz · 全部 48/48" = **311 px** > 260 ⇒ 去掉频率那段(224 px)。频率在常驻状态行里本来就有 |
| 4 | 字段按钮仍是 3 位小数 | "1000000.000 Ω" = 136 px 可以(141 可用),但 "1000000.000 pF" = 144 px **超 3 px** ⇒ 按钮显示统一改 **2 位小数**(133 px);键盘里仍是 3 位,存的值不动 |
| 5 | 行高先写 50 | 字号 20 的 `line_height = 24`,两行 = **48 px**,只剩 2 px 余量;改成 **54 px**,三行落在 40..206(面板高 212) |
| 6 | 只采一块板时进度行写「本频率拟合 0/16」 | 用户会误以为**采集失败**;其实采集 16 点全成功、缺的是第二个方程。加一条分支:「再采另一块标准板即可标定」 |
| 7 | 编译器报 `-Wformat-truncation`:66 B 写进 57 B | 老缓冲 `s_cal_text[80]` 装不下中文(每字 3 字节,进度行最长约 200 B)⇒ 扩到 **256 B**(960 px 标签放得下) |

## 四、验证方式

| 项 | 结果 |
|---|---|
| 宿主 `make -j4`(c_ui 全量) | ✅ **零告警** |
| `test_calibration` | ✅ **ALL OK**;新增「两块板(相隔 50%+)→ 16/16,反演相对误差 < 1e-6」「两块板只差 1% → 0/16」;原有 7 组路径/守卫/存盘用例全部照旧通过 |
| `test_anomaly_detect` | ✅ ALL OK(回归) |
| `test_ref_model` | ✅ PASS(回归) |
| `qr_payload_test` | ✅ PASS(回归) |
| 字宽/折行 | ✅ 所有新增文字用 `lv_font_get_glyph_dsc` 实测过;所用汉字全部在 `ui_font_cn_20` 的 619 码位表内(脚本逐字核对,0 缺字) |
| 上板 | ⛔ **未做** —— 用户将重新上电,届时才算验收 |

## 五、上电后的验收步骤(未执行)

1. 拷 5 个文件到 `/home/xilinx/c_ui_src/` 对应目录(`calibration.{c,h}`、`pynq_protocol.c`、`ui/ui_demo.c`、`tests/test_calibration.c`),回读 md5;
2. 板上 `make -j2`;
3. 校准页填**两块板**各自的 Cgs/Cgd/Cds/Rg(左上排 = 板 1,中排 = 板 2);
4. 「采集负载 1」→「采集负载 2」→ 看 `[cal]` 与进度行的 `本频率拟合 16/16`;
5. ⚠️ **RG 腿要有 Rg > 0 才拟合**,两组都填后应为 **12/16 或 16/16**(取决于是否填了 Rg)。

## 六、上板验证(2026-10-27,仅界面;用户只上电了主板)

用户原话:「**我只上电了主板先验证一下界面吧**」「**点了**」(点校准页),随后「**先把系统关了你慢慢改吧**」。

**做了什么**:SSH 拷 4 个源文件(测试源不进板)→ 回读 md5 全同 → 板上 `make -j2` 零告警 →
`systemctl start qrs-ui.service`(**位流本次上电只加载一次**)→ 用 `fb_dump.py` 直接从 DDR
抓帧(**不看人眼转述**),按显示旋转 180° 还原后逐页核对。

| 项 | 结果 |
|---|---|
| 首页 | ✅ 五入口齐全、中文无缺字;顶栏 后端/偏压/回路/档位 全有值 |
| 触摸 | ✅ 三次按下均报坐标;末次 raw (160,60) → 逻辑 (863,539),与 180° 旋转一致 |
| 校准页 | ✅ 10 个参数字段(3 行 × 4 列)、4 个采集按钮、4×4 覆盖表、进度条全部渲染,**无重叠** |
| `[cal]` | `没有可用的校准文件` —— **v1 文件被版本号拒掉,符合预期** |

**抓到的 4 处缺陷**(前三处是裁字,第四处是旧文案;全部是这次抓帧才发现的):

| # | 现象 | 实测 | 改法 |
|---|---|---|---|
| 1 | 覆盖表腿名显示成 `CIS` / `ЁOS` / `ЁRS` | CISS **43** / COSS **52** / CRSS **50** px,标签只有 **42** | 标签 42 → **54**,四列起点 52 → 62、步距 54 → 52 |
| 2 | 四个标准全采时单元格会裁字(未发生,推算得出) | `OSL2*` = **58** px > 格宽 50 | 单元格加 `text_letter_space = −3` ⇒ 46 px |
| 3 | 顶栏状态末尾折行、右侧露出半个「定」 | 原串 **323** px > 状态栏 **318** | 改成 `状态:就绪(Cs/Cp/D 未标定)` = **242** px |
| 4 | 首页「校准」格写「标准板**三**标准标定」 | 已是四个标准 | 改「开路 / 短接 / **两块标准板**」= 216 px(候选里的「和」U+548C **不在字库**,已弃) |

**验证**:改完宿主 `make -j4` 零告警;`test_calibration` / `test_anomaly_detect` / `test_ref_model` / `qr_payload_test` 四套**全过**。
⛔ **当时没上板** —— 改代码要重启服务,而重启 = 第二次下载位流(红线),所以只能等下一个上电周期。

**第二次上电复验(2026-10-27,`LLM-080` 续)**:用户「**上电了**」→ 我在**用户明说**「**启动**」之后才拉起服务
(本次上电仍只加载一次位流);拷 2 个文件 → 回读 md5 相同 → 板上 `make -j2` 零告警。抓帧结果:

| 项 | 复验结果 |
|---|---|
| 顶栏状态 | ✅ `状态:就绪(Cs/Cp/D 未标定)` 一行显示完整,右侧不再露出半个「定」 |
| 首页「校准」格 | ✅ `开路 / 短接 / 两块标准板` |
| 覆盖表腿名 | ✅ `CISS` / `COSS` / `CRSS` / `RG` 四个都完整(裁字消失) |
| 整页 | ✅ 10 个字段 + 4 个采集按钮 + 覆盖表 + 进度条无重叠;触摸 `raw(88,49) → 逻辑(935,550)`(180° 旋转一致) |

⛔ **仍未验**:两块标准板各自的参数录入与 LOAD1+LOAD2 两点仿射(需要接标准板、手动填参数)。
板子已按用户要求 `systemctl stop` + `shutdown -h now`(服务停后确认 `inactive`,再关机,ping 已无响应)。

**记录状态**:⛔ 上板验收完成前保持 ⚠️;验收后把本行改为 ✅ 并在 `INDEX.md` 同步。
