dsgmxc/2026_fpga_qrs/llm-log/LLM-079.md

# LLM-079:无监督异常检测直接做进 C/LVGL 界面(不需要故障样本)

- **日期**: 2026-10-24(代码与宿主验证)/ **2026-10-25(上板验收)**
- **模型**: deepseek-flash(Claude Code harness)
- **任务**: ①判断「AI 异常检测」在现有数据条件下是否做得出;②做完后**直接接入界面**,不要只做离线脚本。

## 提示词

```
ai异常检测好做吗我们应该可以尝试复现一个吧
```

```
直接做进界面吧
```

## 一、可行性判据:没有故障样本也能做

手上**没有任何"坏器件"的标签**,所以不能做监督分类。可用的是:

| 数据 | 内容 | 用途 |
|---|---|---|
| TH521 原始导出 | **10 颗**同批 TK9J90T 的完整 C-V(201 点) | 定义"健康器件之间允许多大差异" |
| 本机 2026-10-24 扫压 | 一台健康件的完整三腿曲线(60 点/腿) | 定义"这台机器测健康件长什么样" |

⇒ 用**无监督离群检测**(马氏距离):健康总体给协方差,本机基线给中心;
不需要一条故障样本,也不需要训练。

## 二、特征选择:避开拐点的器件离散

第一版用 8 个固定电压锚点(含 10 V),Coss/Crss 在拐点处的**器件间离散达 31% / 49%**,
健康件自己就会得高分(Ciss 留一法最大 118.9)。改成为**与拟合无关的 4 个特征**:

```
f0 = log10(Cs @ 0.3 V)      低压电平
f1 = log10(Cs @ 100 V)      高压电平
f2 = log10(V50)             半降电压:电平 = sqrt(lo*hi) 的穿越点
f3 = log10(V75 / V25)       拐点宽度:25% / 75% 电平的电压比
```

低压锚点从 0.1 V 挪到 **0.3 V**(log-log 插值):0.1 V 是扫压第一点,
2026-10-23 那轮的首点沉降缺陷会把整条曲线误判成异常(当时 Coss 得分 21051)。

## 三、模型与阈值

- 协方差:10 颗器件的**收缩协方差**(reg = 0.1),逆矩阵入库;
- 中心:本机 2026-10-24 健康基线的特征(= 总体均值 + 平台偏移,偏移被吸收);
- 判据:`score = d^T P d`,即马氏距离平方。

| 量 | CISS | COSS | CRSS |
|---|---:|---:|---:|
| 留一法最大健康分 | 8.99 | 4.01 | 3.94 |
| 两两最大健康分(换一颗健康件) | 9.07 | 8.32 | 9.02 |
| 同配置复跑 2026-10-23 得分 | 5.40 | 0.79 | 0.58 |

⇒ 阈值 **25**(≈ 健康最大值的 2.8 倍),`>= 100` 判"异常":

| 注入异常(在健康基线上合成) | CISS | COSS | CRSS |
|---|---:|---:|---:|
| 电平 ×1.05 | 447.9 | 186.6 | 13.9 |
| 电平 ×1.10 | 1709.2 | 712.0 | 53.2 |
| 电压轴 ×1.05 | 77.7 | 17.9 | 9.0 |
| 电压轴 ×1.08 | 135.2 | 50.9 | 41.0 |
| 拐点 ×1.2 | 3764.0 | 1343.7 | 80.5 |
| 拐点 ×1.3 | 6095.9 | 2946.8 | 147.4 |

10-15 那轮(65 MSPS 配置)得分 64/46/57 —— **换配置就会越界**,
所以模型只在当前固定配置(1 MHz / 32.5 MSPS / 自动挡位)下声明有效。

## 四、落地文件

| 文件 | 作用 |
|---|---|
| `src/c_ui/tools/fit_anomaly_model.py` | 从归档 zip + 本机基线生成常数;`--check` 打印健康/注入分数 |
| `src/c_ui/app/anomaly_model_data.h` | 自动生成:中心 3×4、逆协方差 3×4×4、阈值 |
| `src/c_ui/app/anomaly_detect.{c,h}` | 特征提取(与 Python 逐式对应)+ 马氏距离 + 等级 |
| `src/c_ui/app/pynq_protocol.c` | `sweep_finish()` 里调用;中止 / 重新开始时清空 |
| `src/c_ui/ui/ui_demo.c` | 结果页新增第 6 个页签「AI 检测」:三条腿各一行(得分/判词/最大偏离) |
| `src/c_ui/tests/test_anomaly_detect.c` | 宿主单测:基线≈0、×1.10 检出、×1.05 分级、拒绝短曲线 |

## 五、自我纠错轨迹

| # | 事情 | 结论 |
|---|---|---|
| 1 | C 版首写把单调下降曲线判成 `hi > lo`,**所有健康曲线都返回"数据不足"** | 宿主单测第一次跑就暴露;改成 `hi < lo`,并把这条写进注释 |
| 2 | 生成器按文件名通配抓到 **13 颗**(含 `值钱/` 另一批 3 颗),留一法最大分涨到 **13.20**、注入分数下降 | 归档 README 指定只用 `1`–`10`;加路径深度 + 目录名过滤,器件数断言 = 10 |
| 3 | 打算用的中文文案有 **13 个字不在点阵字库里**(诊/疑/评/估/半/拐/宽/阈/马/氏/距/足/≥) | 不重刷字体:改用字库内等价文案(「AI 检测」「待查」「V50 电压」「V75/V25 比」「判据」「>=」),并用脚本比对 `unicode_list` 逐字确认 |
| 4 | 发现结果页**参考标准值**的 4 处 `lv_label_set_text_fmt(..., "%.3f")` 是坏的 | `LV_SPRINTF_USE_FLOAT = 0` ⇒ 屏上会显示成 `f`;改为先 `UI_CalFormatNumber()` 再 `%s` 拼接。该坑与 2026-10-24 校准页"f pF"同源 |

## 六、验证状态

| 项 | 状态 |
|---|---|
| C 特征提取 vs Python | ✅ 10-24 基线三腿特征逐位一致(4 位小数),10-23 得分 5.40 / 0.79 / 0.58 与 Python 完全相同 |
| 注入异常 | ✅ C 与 Python 一致(1709.20 / 711.96 / 53.17 等) |
| 宿主单测 `test_anomaly_detect` | ✅ **ALL OK**(含拒绝 5 点短曲线、全无效、NULL) |
| 宿主 `make -j2` | ✅ 零 warning |
| 板上原生单测(A9) | ✅ **ALL OK**;基线 0.0012 / 6.3e-5 / 6.1e-6,×1.10 → 1710.54 / 711.99 / 53.19(与 x86 差 0.08 %,libm 实现差异) |
| 板上 `make -j2` | ✅ 零告警,32 s;`c_ui` md5 **`92cad413…`** |
| 上板三腿扫压 | ✅ 180/180 点有效,拒收 0;三行 `[ai]`:CISS **0.1** / COSS **0.0** / CRSS **5.2**,全部「正常」 |
| 界面抓帧 | ✅ 「AI 检测」页签渲染正常,无缺字方框(`artifacts/20261025_ai_tab.png`) |
| 收尾 | ✅ 服务 `stop`、偏压 `0x0`、继电器 `0x10`、服务仍 `disabled`、关机 |

## 七、上电验证(已于 2026-10-25 执行完毕)

1. 上电,确认 `192.168.2.99` 可 ping;✅
2. 拷贝 6 个源文件到 `/home/xilinx/c_ui_src/` 对应目录,md5 回读一致;✅
3. `cd /home/xilinx/c_ui_src && make -j2`;✅
4. 用户说「启动吧」后启动 `qrs-ui.service`(本次上电唯一一次位流加载);✅
5. 用户触摸跑三腿扫压,日志出三行 `[ai] ...`;✅
6. 抓「结果页 → AI 检测」一帧,三条腿得分与判词显示正常。✅

📄 完整证据(含逐点 CSV、端点值、CRSS 5.2 的解释):
`report/measurements/20261025_ai_detection_board.md`。
