dsgmxc/2026_fpga_qrs/llm-log/LLM-075.md

# LLM-075:只有 OPEN 时能做什么 —— 平行杂散校正 + 四挡一致性闸,以及「校准开着扫压全无效」的归因

- **日期**: 2026-10-24
- **模型**: deepseek-flash(Claude Code harness)
- **任务**: 用户不敢短接(源侧限流无记录),问能不能只做一两个标准;标准板未到,要求先做
  OPEN 校准并量化"比原来好多少";采完 OPEN 后要求分析数据;最后问
  「**开着校准扫压就全显示无效**」是不是校准结果不可用造成的。

## 提示词

```
我有点不敢短接测量，确定可以这样测吗，能不能只做其中一两个校准不一定要全做吧
```

```
现在上电了，标准板还没到所以先做开路校准我看看校准完比原来好多少
```

```
我测了一遍你看看
```

```
简单说下什么意思，为什么不可用
```

```
为什么我刚刚开着校准扫压就全显示无效了，是因为校准结果不可用吗
```

## 回答与改动

### ① 部分校准怎么选

| 可用的标准 | 能定什么 | 结论 |
|---|---|---|
| OPEN + LOAD | `a/c` + `c`(`b = 0` 的分式线性) | **推荐**:LOAD 是唯一能钉住增益的一条,必须有 |
| OPEN + SHORT | 只有 `a/c` 与 `b`,**定不了 `c`** | 原来判"不拟合";本轮改为**仅开路平行杂散校正** |
| SHORT + LOAD | 仿射(假定 `c = 0`) | 兜底路径,OPEN 坏时用 |
| 只有 SHORT | 一个点都定不了 | 不拟合 |

⇒ 没有标准板时,**OPEN-only 能做的只有一件事**:减掉与器件并联的夹具杂散,
即 `a=1, b=0, c=1/M_o`,反演 `Z_d = 1/(1/Z_m − 1/M_o)`,标记 `CAL_F_FIT_OPEN`。
它**不识别增益 `a` 与串联项 `b`**;标准板到位后 `refit` 会自动升级成完整路径。

### ② 两道新增守卫

| 常量 | 值 | 作用 |
|---|---|---|
| `CAL_OPEN_ONLY_MIN_Z` | 10 Ω | 开路本身太小 ⇒ 不是开路,不拟合 |
| `CAL_OPEN_ONLY_MIN_DEN` | 0.1 | `\|1 − Z_m/M_o\| < 0.1` ⇒ 器件只占并联导纳的 10 % 以下,修正不可信,`Apply` 返回 false |
| `CAL_OPEN_MAX_GEAR_SPREAD` | 3.0 | **同一开路在四挡上的幅值必须落在 3 倍以内**;否则不是夹具阻抗,一律不拟合 |

第三条是本轮实际起作用的:**四挡实测开路相差 150–1500 倍**(见下),闸把 16 个点全拒了。

### ③ 本轮实测:OPEN 数据不可用

板上 `[cal]` 日志(1 MHz,四腿 × 四挡,共 16 点,全部采样成功):

| 腿 | A(10 Ω) | B(100 Ω) | C(1 kΩ) | D(10 kΩ) |
|---|---:|---:|---:|---:|
| CISS | 5215 | 56041 | 505922 | 803522 |
| COSS | 200 | 173579 | 212945 | 307960 |
| CRSS | 543 | 120067 | 459428 | 803601 |
| RG | 661 | 118712 | 595430 | 1021297 |

同一根开路线在四挡上本该是**同一个数值**,实测却随 `R0` 增长 ⇒ 这不是夹具阻抗,
而是**通道地板**:`VL/VH ≈ 0.19 %`(`B` 路 ≈ 1 ADC LSB,0.49 mV),折算成视在阻抗
≈ `526·R0`。只有 D 挡能看见真实开路,折算 **0.15–0.52 pF**;D 挡本身也不可信
(见 `LLM-073` 的 `Re Z ∝ R0`),所以能说的只有一句:
**现有数据不支持"夹具并联杂散 7–14 pF"这个前提,具体值定不了。**

### ④ 「校准开着扫压全无效」的归因

不是校准判的。日志与代码两边都能对上:

- 那 60 个点全程 `挡位 0x8`(D 挡,10 kΩ),`判据拒收 0 次 / 判无效 0 点`,`z_valid` 一直为 1;
- 每点都是 `(已校准)`,校准前 `14569 + 1303j` → 校准后 `14618 + 1508j`;
  **虚部在校准前就是正的**(感抗),`Cs` 按 `−1/(ω·ImZ)` 算出来是负的;
- UI 的有效性判据是 **`Cs > 0`**(`src/c_ui/ui/ui_demo.c:8084`),所以每点都标「无效」、曲线不画。

⇒ 负电容来自 **D 挡的相位伪影**,校准只是让它多偏了 0.3 %,没有翻转符号。
同一腿 B 挡 0.2 V 读到 `149 − 91j Ω`(Cs ≈ 1749 pF),是正常的容性;正确做法是换 B 挡。

## 改动

| 文件 | 内容 |
|---|---|
| `src/c_ui/app/calibration.h` | 🆕 `CAL_F_FIT_OPEN`(0x80);退化路径文档补"仅开路平行杂散校正" |
| `src/c_ui/app/calibration.c` | 🆕 `open_is_consistent()`(四挡 3 倍一致闸)+ OPEN-only 解算 + `CAL_OPEN_ONLY_MIN_Z/MIN_DEN`;`Calibration_Init()` 载入后 `refit_all()`,**旧文件里不可信的 FIT_OPEN 点在下次启动时会被清掉** |
| `src/c_ui/app/pynq_protocol.c` | 短接警告改写:校准偏压是**直流**,降它减不了交流激励;源侧限流未记录 |
| `src/c_ui/tests/test_calibration.c` | +4 个用例:OPEN-only 拟合与反演、器件导纳 < 10 % 被拒、四挡不一致被拒、坏 OPEN + SHORT + LOAD 退回仿射 |

## 纠错轨迹

| # | 事情 | 结论 |
|---|---|---|
| 1 | 我在 `LLM-073` 里把 CRSS 的加性偏移归因成「夹具并联电容 7–14 pF」 | **本轮实测证伪**:四挡开路互相差 150–1500 倍,不是同一个物理量;能看见的那一挡只折出 < 0.6 pF。夹具杂散**不是**主要误差 |
| 2 | 讲短接风险时,我先说"把校准偏压降到 0.1 V"像是一种保护 | **不对**:校准偏压是**直流**,交流激励幅度是固定的(`0x10` EXC_AMP 未实现),降偏压只减直流分量。日志文案已改,不再暗示它有限流作用 |
| 3 | 用户问"校准完比原来好多少",我先按 OPEN-only 算了一个 CISS 点 | 7.941−45.295j → 7.939−45.257j,`Cs` 3513.7 → 3516.7 pF,**改善 0.08 %** ⇒ 如实回答"几乎没改善",不把它包装成校准有效 |
| 4 | 对"全无效"的第一假设是**反演分母变号** | **错了**。实测 `\|Z_m\|/\|M_o\|` 只有 1.8 %,分母没有变号;真正原因在 UI 的 `Cs>0` 判据与 D 挡读数。靠读日志的 `(校准前 → 校准后)` 两列改判 |
| 5 | 守卫加完后,当前跑的进程仍是旧二进制 | 新闸在磁盘上的 `c_ui` 里,当前进程仍会用坏 OPEN 数据;要让闸生效必须下一次启动/上电(不能 restart 服务 = 第二次位流) |

## 结果

⚠️ **部分可用** —— 代码与宿主单测完成;OPEN 采集在板上 16/16 走通;
**但 OPEN 数据本身被证明不可用,新闸尚未在板上生效**。

## 验证方式

| 项 | 方式 | 结果 |
|---|---|---|
| 拟合/反演/守卫 | `tests/test_calibration.c`(宿主) | **ALL OK**;含 OPEN-only 反演、10 % 导纳守卫、四挡不一致 = 0 拟合 |
| OPEN 采集 | 板上日志 `[cal] OPEN …` 16 行 + `cv_calibration.dat` | 16/16 存盘成功;文件中 16 个点 flags = **0x89**(OPEN\|FIT\|FIT_OPEN) |
| 负电容归因 | 同一次扫压的 60 行 `[adc] 扫压` | 全程 D 挡,`判无效 0 点`,`Cs` 从 −105 pF 到 −12 pF;校准前数值已是正虚部 |
| 新闸 | 宿主单测 + 代码路径 | ✅ 单测拒绝;⛔ **板上未验**(旧进程仍在跑,下一次启动才生效) |

## 沉淀

- 候选 `skill/standard-data-must-agree-across-ranges/`:同一个标准件在不同量程上的读数
  必须互相一致;**不一致时先怀疑测量链的地板,而不是把它当夹具参数拟合**。
  本轮正是靠这条把一个"看起来能拟合"的 16 点 OPEN 判死。
- 候选 `skill/validity-is-a-ui-rule-too/`:排障时"日志说有效、屏幕说无效"并不矛盾 ——
  读数有效性和**显示有效性**是两套判据(这里是 `Cs > 0`),先找出屏幕依据哪一条。
