dsgmxc/2026_fpga_qrs/llm-log/LLM-072.md

# LLM-072:把十颗同型号器件的典型 C-V 曲线做成参考模型,并接进结果页做叠加对比

- **日期**: 2026-10-23
- **模型**: deepseek-flash(Claude Code harness)
- **任务**: ① 从桌面 `同惠仪器测试.zip` 里挑出同型号十颗器件的典型曲线;② 在「结果汇总」页加「器件类型」选择器和「叠加参考曲线」开关;③ 单点结果把参考值逐行排在实测值下面;④ 型号名改为 **TK9J90T**;⑤ 上电部署并确认界面。

## 提示词

```
桌面上有一个同惠仪器测试zip
这里面包含多少组数据
这些所有的数据来自同一型号的十颗mos选取合适的数据来导出一份针对这一型号的典型数据有作为参考
然后这份数据要导入程序，就是在结果汇总的页面，要多一个控件选择器件类型，
多一个控件决定是否在图中显示用于曲线对比，扫压页要注意如果要显示参考曲线的话
如何较好的区分实测曲线和参考曲线单点的结果就正常把参考数据放在下面一一对应即可
tk9j90t这是器件型号，名字改一下
板子上电了，外设没上电你先拉起看看
看着没问题
```

补充口径(由用户在追问中确认):器件类型选择器**先只有一项,但必须可扩展**;
单点结果的参考值 **Cs / Cp / D 三项都要**;参考曲线**同时出现在「扫压结果」和「扫压波形」两张图上**,
由同一个开关控制。

## 模型回答

### 1. 数据筛选与参考模型

- 压缩包里有 **14 组**测量目录;`1`–`10` 是同型号的十颗器件(用户指定),`值钱/11`、`值钱/13`、`值钱/14`
  不用。三颗被排除者与典型曲线只差 1.4–2.5 %(中位),**再纳入会改动 Coss/Crss 拐点附近的值**,故不混入。
- 逐点取 **十颗的中位数**(不是均值 —— Coss/Crss 拐点有个别早跳变样本会拖均值);
  每条曲线的 Vds 是仪表实际读数,网格不统一,先按 `(log Vds, log C)` 插值到标称网格:
  **Vds 0.1 → 100 V,201 个对数等距点**;Rg 按 `(Vgs, Rg)` 插值,**−3 → +3 V,101 点**。
- 最接近典型值的单颗是 **7 号**(1–100 V 上 RMS 对数偏差 1.71 %),但它只作为记录,不改变"典型 = 中位"的定义。
- **Cp 不单独存表**:仪表给出的 Cs 与 D 是两列独立的中位数,若再对 Cp 单独取中位,
  三个数在同一个偏压点上会互相对不上(实测最大差 2.4 %)。改为运行时 `Cp = Cs / (1 + D²)`,
  使界面上同一行的 Cs/Cp/D **按构造自洽**。这一点写进了数据表和 README。
- 产出:`tools/make_th521_reference.py`(从归档 zip 重跑)+ `src/c_ui/app/ref_th521_data.{c,h}`
  + 只读访问层 `src/c_ui/app/ref_model.{c,h}` + 宿主单测 `src/c_ui/tests/test_ref_model.c`。

### 2. 界面

- **器件类型选择器**:文字取自 `RefModel_Name(model)`,遍历 `RefModel_Count()` —— 以后加型号
  只加表、不改 UI 调用方。
- **叠加开关** `叠加:开 / 叠加:关`:**同一份状态**驱动「扫压结果」与「扫压波形」两张图的参考曲线
  和两处「标准」图例;关掉时图例一起隐藏,避免图例指着不存在的线。
- **曲线区分**:参考线用**虚线 + 稍暗颜色 + 2 px**,实测线保持实线。CISS/COSS/CRSS 同一腿同色,
  靠线型区分测量与参考,不额外占用颜色维度。
- **单点结果**:每张腿卡在实测值下面加一行浅色参考值(Cs / Cp / D),RG 卡加「标准 Rg」;
  偏压未知时显示 `标准 --`,不猜。
- 提示语写明口径:`Cs 可直接对照;Cp/D 标准值不含线阻,实测值含线阻`。

### 3. 「TH521 是仪器,TK9J90T 是器件」

用户指出 `TK9J90T` 是器件型号后,改了**界面显示名、代码注释、生成器、生成表头、单测断言、归档 README**;
文件名 `th521_*` **保持不变**(它们描述数据来源 = 同惠 TH521 仪器的导出),并在 README 里写清这层关系,
避免以后再把仪器名当成器件名。

### 4. 部署与上板确认

- 推 7 个源文件到板上 `/home/xilinx/c_ui_src/`(逐文件回读 md5)→ 板上 `make -j2`(**零 warning**)
  → 新 `c_ui` md5 **`f2e169dea0ac612014853965aea96a7b`**。
- 本上电周期**只加载一次位流**(`dmesg` 恰 1 条 `writing qrs.bin`),FCLK0 **50.0000 MHz**,
  首帧提交后切 DDR 源(`0x50 = 2`)。
- 抓帧(fb0 的 PPM,`report/measurements/artifacts/20261023_ref_curve_ui.png`,md5 `ba05add2…`)
  显示:标题行 CISS / COSS / CRSS 图例 + **标准**图例、**「TK9J90T 标准(10 颗)」**、**「叠加:开」**,
  三条**虚线**参考曲线,坐标轴 0.10 → 100 V。用户随后目视确认「**看着没问题**」。

## 结果

☐ ✅ 直接可用   ☑ ⚠️ 部分可用   ☐ ❌ 不可用

- **已确认**:参考数据生成、查表/插值/夹紧/自洽单测、界面控件与虚线渲染、板上部署。
- **未确认**:**实测曲线与参考曲线叠在同一张图上的区分效果** —— 抓帧时外设未上电、没有实测数据
  (显示 `0 点/3`),图里只有三条参考线。用户说「看着没问题」覆盖控件与参考线本身,
  不能据此写成「实测/参考已同图对比验证」。
- **未做**:扫压页(扫压波形 tab)的抓帧;参考值单点卡的抓帧。

## 验证方式

| 项 | 证据 |
|---|---|
| 数据选择 | `report/measurements/artifacts/20261023_th521_reference/README.md`(十颗、中位、排除项、拐点方差) |
| 数据可重跑 | `tools/make_th521_reference.py` + 归档 `th521_source.zip`(md5 `666f0474…`) |
| 查表层 | `gcc -std=gnu11 -O2 -Wall -Wextra … && /tmp/test_ref_model` ⇒ **75 项 ok / 0 failure**,含 `Cp = Cs/(1+D²)` 三条腿最大相对误差 **0** |
| 型号名 | 单测断言 `RefModel_Name(0) == "TK9J90T 标准(10 颗)"` |
| 宿主编译 | `src/c_ui` `make` 零 warning |
| 板上二进制 | `/home/xilinx/c_ui_src/c_ui` md5 `f2e169dea0ac612014853965aea96a7b` |
| 一次位流 | `dmesg | grep -c 'writing qrs.bin'` = **1**;`qrs.bit` md5 `c92c7ed5…` |
| 屏上证据 | `report/measurements/artifacts/20261023_ref_curve_ui.png`(md5 `ba05add2016c6dd2eb20ddbd615e1ef2`) |

## 纠错轨迹

1. **LVGL 的 `dash_width/dash_gap` 只管横线与竖线**。第一版给 `lv_draw_line_dsc_t` 设了 dash 参数,
   斜线段却没有虚线效果 —— 读 `third_party/lvgl/src/draw/sw/lv_draw_sw_line.c` 发现按 hor / ver / skew
   分派,只有前两者处理 dash。改成**按弧长自己走虚线**(`UI_DrawDashedSegment`,5 on / 4 off),
   并把 dsc 的 dash 归零,避免两道裁剪叠加。
2. **我以为字体子集覆盖了所有 UI 字串,实际没有**。子集里**没有「比」「十」**;原稿「曲线对比」「十颗」
   在屏上会掉字。改词为「叠加」「10 颗」「对照」,并把所有真实 UI 字符串重新筛了一遍
   (日志里的 emoji 缺字不算 —— 那是 stderr,不上屏)。
3. **改名后按钮装不下**。`TK9J90T 标准(10 颗)` 在 cn_20 下宽 185.75 px,原标签区 182 px。
   选择器 202 → **210 px**、开关 116 → **110 px**,重排整行后不动其他控件。
4. **读板上瞬时状态时差点拿旧文件当新证据**。板上 `fb_dump.py` 已不在(`/home/xilinx` 没有),
   而第一次 `md5sum` 读到的是上一次遗留的 PPM(两块 md5 相同) —— 若不复核就把旧帧当成本次截图。
   改为**先删旧 PPM、再确认脚本存在、再 dump**,并核对输出里的颜色统计。
5. **板上 `sudo` 这次不是免密**(`sudo -n` 失败,报 "a terminal is required"),无 NOPASSWD。
   用 pty + `sudo -S -p ''` 喂出厂口令执行 dump;口令**没有落进任何文件或提交**。

## 沉淀

- 候选 `skill/vendor-widget-draws-only-some-orientations/`:**库文档说"支持虚线"不等于每条绘制路径都支持** ——
  验证要看**分派表**,并在目标几何(斜线)上实测。
- 扩展 `skill/stale-artifact-silent-reuse/`:第 6 种形态 —— **板上脚本丢失、旧输出文件仍在**,
  命令失败后 `md5sum` 照样给出一个值 ⇒ **先删产物再看新产物**,不看"文件存在"。
- 候选 `skill/derived-value-over-independent-median/`:**多列相关量逐列取中位会破坏恒等式** ——
  要么只存独立量、其余现算,要么接受显示不自洽;本项目选前者。
