dsgmxc/2026_fpga_qrs/llm-log/LLM-070.md

# LLM-070:扫压参数页并入结果页 + 触摸读数 + 实测数据二维码

- **日期**: 2026-10-17
- **模型**: DeepSeek-V4(Claude Code 会话模型名 `deepseek-flash`)
- **任务**: 把扫压完成后的独立参数页移到「结果汇总 → 扫压结果」;结果页支持按住/滑动曲线读单点值;删掉 AI 质量 UI;二维码移到「数据传输」并按前序工程 `~/Desktop/qrs` 的方案传真实测量数据。

## 提示词

```
我现在没接外设结果正确与否先不管，你看到每次扫压完成后有一个参数界面吗
这个窗口应该移动到结果汇总的扫压页面才对，而且扫压结果的调试结果也应该有，就是不仅仅是曲线还能够滑动查看某点具体值
ai质量相关的就删了但是二维码移动到结果汇总的传输上，我要通过二维码传输数据
你去查看桌面的qrs工程看看他怎么使用二维码的，就照那个
要不先断电等你写完我再上电测试
你把系统关了先
```

## 模型回答

- 阅读前序工程 `~/Desktop/qrs` 的 `ai_cv2spice_acv1.c` / `ai_cv_sweep_payload.c` / `ai_cv2spice_physics.c` /
  `AI_Model_Web/js/model-codec.js` / `sweep-codec.js`,确认 URL 形式为
  `https://fox4327.github.io/ai-cv2spice-web/#m=<ACV1>&c=<SCV1>`。
- 逐字移植 ACV1/SCV1 编码器,新增 `cv_qr_payload.c` 负责公共区间、ACV1 节点、SCV1 隐式网格重采样与 URL 组装,
  `cv_qr_live.c` 接扫压生命周期。
- `ui_demo.c`:删除独立参数页、右滑返回、头部动画、AI 质量标签与接口;把 6 张参数卡、分析电压控件移到
  「扫压结果」页;新增探针归属(扫压页 / 结果页)与结果页触摸回调;新增「数据传输」页二维码。
- 板子已按要求关闭,本次只做代码 + 宿主编译 + 纯逻辑单测 + 与网页解码器的 Node 交叉验证。

## 结果

☑ ✅ 直接可用   ☐ ⚠️ 部分可用

> 板上已跑通(2026-10-17,3 个上电周期);**用户随后实按确认触摸滑动读数正常、手机扫码正常**。
> 全部验证项结案,板子已关机。

## 验证方式

1. `cd src/c_ui && make -j2` —— 全量编译通过,`ui_demo.c` 零 warning。
2. `tests/qr_payload_test.c` —— 宿主运行 **PASS (0 failure(s))**:
   ACV1 12 节点、36 个 ΔQ > 0、SCV1 141 点、CRC 正确。
3. `/tmp/verify_qr.mjs` —— 用前序工程自带的 `model-codec.js` / `sweep-codec.js` 解码生成的 URL:
   flags=4、元数据、频率、Vpp、Rg、节点数一致;SCV1 电压网格与独立重建逐点一致;
   0.1 / 1 / 10 / 100 V 四点 `csPf` 相对误差 < 0.5% —— **PASS**。
4. **板上(2026-10-17 上电后)**:
   - 15 个文件上传 `/home/xilinx/c_ui_src/`(含 3 个后续字体/文案修正),回读 md5 逐一致;
   - 板上 `make -j2` 成功;
   - 3 个上电周期(每次只加载一次位流):结果页截图、数据传输页截图;
   - `[qr] ACV1 12 节点 / SCV1 141 点 / URL 1223 B / CRC acv1=0xa78b18cf scv1=0xaee88716` —— 与宿主单测**完全相同**;
   - 对屏上二维码截图用 jsQR 解码:**成功,1223 B**;解码文本与宿主 `/tmp/qr_url.txt`
     逐字节一致(md5 同为 `e65c53432d5fec7d9640df2be8c87d70`);
   - 截图与原始日志:`report/measurements/20261017_ui_result_transfer/`。
5. **用户实按确认(2026-10-17)**:真实手指按住/滑动读数正常;手机实拍扫描「数据传输」页二维码正常。

## 纠错轨迹

1. **SCV1 不是任意点。** 最初打算把实测点直接编码,读 `sweep-codec.js` 后发现解码器**不传电压表**,
   而是按 start/stop 重建隐式网格(`i*20/60`,再补整数,最后替换首点)。
   ⇒ 改为在 C 侧按同一规则生成网格并做 log-log 重采样;否则解码端电压全错。
2. **Float16 下限。** 前序的 `1e-8 nC` 在 Float16 下变成 0(次正规数最小约 6e-8)。
   ⇒ 改为 `1e-6 nC`,并在文档里写明。
3. **结果页探针函数写死 `g_sweep_chart`。** 首次编译通过前发现结果页触摸会驱动扫压页的图表;
   ⇒ 把 `UI_SelectSweepProbe` / `UI_SelectInterpolatedSweepProbe` 参数化为 `(chart, owner)`。
4. **全局变量定义顺序。** `UI_ResultsSweepTouchEvent` 在 `g_results_chart` 定义之前引用,编译报
   `undeclared`;`g_results_summary_label` 同样。⇒ 在文件前部补文件作用域声明。
5. **单测预期偏离。** 原计划"让一个点无效 ⇒ SCV1 valid 位为 0"不成立:PCHIP 重采样会对每个网格点求值,
   单点无效不会产生无效网格点。⇒ 测试改为断言"仍能完整解码",并在计划记录里如实保留差异。
6. **`LV_FONT_MONTSERRAT_20` 未启用。** 参数卡数值改用已启用的 `montserrat_24`。
7. **子集字体缺字 —— 屏幕静默丢字。** 第一轮上板截图里「分析电压」显示成「分电压」,
   「实测数据二维码」缺「维」;`ui_font_cn_20/28.c` 是按固定符号表生成的子集,
   LVGL 遇到缺字**不报错、渲染空白**。⇒ 扫描 C 字符串字面量(排除注释)与字体 cmap 比对,
   用系统 `NotoSansCJK-Regular.ttc` 的 SC 面 + 原参数重新生成,605 → 670 码位。
8. **结果页摘要在 350 px 内放不下。** 原文案「每路点数 N    有效曲线 x/3    最近一次 RG --」
   在截图右端被裁掉 `RG --`;面板右上只剩 350 px(再宽会压到图例)。
   ⇒ 缩短为「每路点数 N · 有效曲线 x/3 · RG --」,实测完整显示。
9. **`fb_dump.py` 没有执行位。** 直接 `sudo /home/xilinx/fb_dump.py` 报 command not found
   (权限 `-rw-rw-r--`)。改为 `python3 /home/xilinx/fb_dump.py` 即可,不改文件权限。
10. **板上源码树分 `app/`、`ui/` 子目录。** 第一次把 3 个文件按 basename 传到
   `/home/xilinx/c_ui_src/` 根目录,板上 `make` 报 "Nothing to be done" —— 根目录文件不在
   `wildcard app/*.c ui/*.c` 里。⇒ 改传到 `ui/`,并删掉根目录误放的副本。

## 沉淀

- 协议移植的通用教训:**先读解码器,再写编码器**;点集/网格这类"隐式约定"要写成可交叉验证的单测。
- 十六进制浮点格式(Float16)的边界值要用实际编码器回读确认,不能按 float32 直觉设下限。
- **子集字体的缺字不会报错。** 改中文 UI 文案后必须把「字符串字面量集合」与字体 cmap 做差集,
  再重生成;这一条应写进任何 LVGL + 自定义字体的检查清单。
- **屏上产物要能自己回读验证**:二维码截图用 jsQR 解回文本、与实际载荷比 md5,
  比"看起来像二维码"强得多。
