dsgmxc/2026_fpga_qrs/llm-log/LLM-068.md

# LLM-068: 扫压末端尖峰的根因(不是算术,**是整次采集混进了坏样本**)+ 用户口径「多测几次取合理值」的正确形态(自洽闸 + 重采,不是中位数)

- **日期**: 2026-10-15
- **模型**: Claude(DeepSeek-V4-Flash 会话)
- **任务**: 用户看到 CRSS 高压端 Cs 冒出 519 pF(基线 ~13 pF)的尖峰,问
  「**什么原因,或者扫压的时候就是多测几次取合理值让结果更稳定行不行**」,
  随后指令「**按照最合理的方式进行修复**」。
  产出:`adc_sample.{c,h}` 新增 `AdcSample_PpConsistent()` 自洽判据;
  `pynq_protocol.c` 新增 `adc_capture_pair()` 重采外壳 + 账本 + 两处日志证据。

## 提示词

```
我想知道什么原因，或者扫压的时候就是多测几次取合理值让结果更稳定行不行，就是尽量不要发生这种情况
```
```
按照最合理的方式进行修复
```

## 模型回答

**根因(先答"为什么",这是用户真正问的那半句)**:不是算术算错。
**同一个缓冲里有两个数互相矛盾** —— `B/INB 幅值 0.0067 V`(1 MHz 单点相干解调、
8190 点平均)隐含峰峰 `2×0.0067/2.0×4096 = 27 码`,而同一次采集打出的 `峰峰` 是
**2588 码**,差 **94 倍**。正常点这两个数一致到 ~2%。
指纹还多一条:某次扫压出现 `A码 = B码 = 3205`(两路读到**同一个字**)。
机制:A 与 B 是**同一条 12 位总线上的两个时分字**,采样刻度错一拍就会让 A 读到 B 的字
⇒ `VH ≈ VL` ⇒ `Z ≈ 0` ⇒ Cs 爆掉。只在 **CRSS 高压端**放大,因为 `Cs ∝ 1/VL²`,
那里 `VL = 23 码`(0.56% 满量程);同样的毛刺落在 CISS(`VL ≈ 1000 码`)上动不了 1%。
⇒ 指向采样刻度距 ADC 总线边沿只有 **1 tick = 7.69 ns** —— 与 **2026-10-15 的
`P=2→4` 改动**(Cs 离散度 3.86% → 0.42%)记的是同一个机制。
⚠️ **明说这是推断不是证明**:决定性实验(扫 `P=4` 的四个刻度 `{−2,−1,0,+1}` 看跑间稳定性)
在界面活着时做不了 —— 界面每次采集开头都会经 `MeasureConfig_PushPhase` 重写 `0x88`。

> 🔴 **上面这条机制推断,已被 `LLM-069` 削弱(2026-10-15 同日,第 64 次会话)。原判保留在上面供追溯。**
>
> `LLM-069` 在**同一份日志**上重算后,把天平压向了**模拟侧真的过载**,而不是采样刻度:
> ① **`adc_otr`**(AD9238 **自己的**溢出输出引脚,与 12 位数据线无关的第 13 根线)在
> "峰峰占满"的 **13/13** 个捕捉里都置起,而在 **213 个干净捕捉里一次都没有(0/213)**;
> ② OTR 计数只有 **1–10 / 16384 字** —— "刻度错一拍"会**每周期都错**(8190 次/采),**量级差三个数量级**;
> ③ 解调幅值 CV 只有 **0.14%**(同期 ppA 在 1348→1354 跳)⇒ 是**极少数样本的瞬时越界**,不是整段污染。
>
> ⚠️ **但本条推断没有被推翻成"数字侧无辜"** —— `adc_otr` 与数据**走同一个采样刻度**,
> 它排除的是「总线被串扰 / 数据被读错」,**排除不了「整个刻度都错」**;
> 且 `led.xdc:213` 那条"ADC 输入时序**有意不约束**"(杜邦线 tPD ~4 ns)"仍然成立。
> ⇒ 结论是「**压向模拟侧,不是焊死**」。判别实验见 `LLM-069` §七(**软件打印越界样本的序号/值/通道** —— 不占位流周期)。
>
> 📌 **顺带修正本记录 §结果 里两处口径**:
> - 那张判据表的 `OTR ≠ 0` 两行(干净 1.4% / 坏 36.9%)出自 `/tmp/qrs-ui.log`,
>   而**逐字 OTR 位是 2026-10-14 修好位序之后才有效的** —— 早期那些"OTR"只能来自 `0x90[3]` 那根**粘滞**标志。
>   **两个口径不是一回事**,以 `LLM-069` 的 0/213 为准,此处标为存疑、不删。
> - 正文里「正常点只有 4–5%」与表里「干净 1.4%」本就自相矛盾,一并记在此处。

**回答"多测几次取合理值行不行"**:方向对,但**中位数不行**。
坏点不是"读数有噪声",是**整次采集里混进了坏样本** —— 同一个缓冲里两个数差 94 倍。
这种点整次都错,N 次取中位数会让**错的多数赢**。
有效的形态是先问"**这一次算不算数**"(由一条物理不变式定义),不算数就**换一次重采**。
即:**「合理」由不变式定义,不由投票定义。**

**重采真的有用吗(实测,不是想当然)**:日志里同一偏压连测 ≥4 次的 **63 组,
全部是"有时标、有时不标",次次都标的一组都没有** ⇒ 毛刺在同一点上不恒定,重采能救。

**判据**(`码 ≤ K × 2×幅值 + FLOOR`,单边 —— 只拦"码比物理上可能的大得多")。
阈值**从 2039–4462 个真实样本里选**,不是拍的:

| 判据 | 抓住"坏"(`码/期望 > 5`) | 误伤"好" |
|---|---|---|
| 只看 `OTR ≠ 0` | 128/347(36.9%) | 24/1692(1.4%) |
| K=2.5, FLOOR=32 | 347/347(100%) | 155/1692(9.2%) |
| **K=3.0, FLOOR=64** ← **选定** | **342/347(98.6%)** | **31/1692(1.8%)** |
| K=4.0, FLOOR=128 | 341/347(98.3%) | 31/1692(1.8%) |

分布:中位比值 A 1.021 / B 1.084;p90 B 37.0;max B 193.5;
坏点 `码` 一律钉在 3800–4095(与期望值无关),其中 92–96% 带 `OTR ≠ 0`(正常点只有 4–5%)。
误伤集中在"较小那一路只有 50–200 码"的点(6.1%),200 码以上只有 1.2% —— FLOOR 就是为此而设。

## 结果

☐ ✅ 直接可用
☑ ⚠️ **部分可用** —— **已在板上验证有效**(尖峰消失,真值落回邻点趋势线),但有两处已知代价未消除:
CRSS 腿 **5/60 点被判无读数**(其中 4 点在 0.2–1.3 V 陡峭段),且**严格 A/B 未做**(见下)。
☐ ❌ 不可用

## 验证方式

**已做(语法层)**:
- `gcc -std=gnu11 -fsyntax-only -Wall -Wextra ... app/pynq_protocol.c app/adc_sample.c` → **无输出,零告警**
- 阈值来自 `/tmp/qrs-ui.log`(767923 B)实测样本,**不是理论推演** —— 判据表四行都是同一个脚本跑出来的
- 重采可行性来自对同一偏压重复测量的**分组统计**(63 组,n≥4)

**已做(上板,2026-10-15)** —— 完整记录见 `report/measurements/20261015_sweep_consistency_gate_verified.md`:
- 三个 C 源推到板上、`make` 重编、`md5sum /proc/969/exe` = `887812b56c9de93f02ad7793bf0349f0` 与推上去的一致
- 字节级串检查: `自洽`×4 / `采集自洽账本`×1 / `CV_ADC_TRIES`×3 / `判无读数`×1 / `拒收`×2 / `重采第`×1;
  **反向对照**:旧 `c_ui.prev` 的 `自洽` = **0**
- 新日志列确实出现:`码/期望 X.XX / X.XX | 采 N 次`、`[proto] 采集自洽账本:…`
- **决定性证据**:同一台设备、同批偏压,改前有三个点**逆着趋势往上跳**
  (`Cs = 21.26 / 519.52 / 13.43 pF`,而 CRSS 高压端本应单调下降),改后落在
  **15.57 / 14.74 / 12.31 pF**,整条曲线恢复单调。`519.52 pF` 就是用户最初报告的那根尖峰。
  ⚠️ **判读用「单调性」不用「插值」** —— 插值会循环论证(拿改后的 49.53 去验改后的 44.06);
  也**不能**说"改后这三个数就是真值",只能说"**不再逆趋势**"。

| | 改前 | 改后 |
|---|---|---|
| `码/期望` max | **167.04** | **7.54** |
| 比值 > 10 的点 | 5 | **0** |
| 比值 > 50 的点 | 3 | **0** |

**待做(不得写成已完成)**:
- **严格 A/B 未做**。上面是"先后两轮同参数",**不是**同时刻交替;
  真正的对照(`CV_ADC_TRIES=1` 那轮尖峰应回来)要改 `qrs-ui.service` 的 `Environment`,
  那需要**重启服务 = 第二次加载位流**(红线)⇒ **只能等下一个上电周期**。
- 一次采集的耗时 **~6 ms** 至今仍是**估计值**,未实测(A/B 两轮总时长差 ÷ 重采次数)。
- **B 类拒收是否过度收紧,未判**:4 个被弃点全在 0.2–1.3 V(CRSS 陡峭段,`码/期望` 只有 4–6)。
  **只能说"判据把这 4 个点判没了",不能说"这 4 个点本来就该丢"** —— 要拿已知电容比。
- 🆕 **门外那些坏捕捉到底是什么,已由 `LLM-069` 立项分析**(结论:模拟侧过载,候选 H2a = CRSS 组合下栅极浮空)。
  ⛔ **仍未定位到具体元件** —— 判别实验(栅–源 1 kΩ 电阻 / 关激励重采 / 软件打印越界样本序号)一个都没做。

## 纠错轨迹

<!-- 这一节是评分重点。只记成功案例拿不到分。 -->

1. **★ 差点把阈值按理论定死,而不是按数据定。**
   我第一反应是"K=3 太松" —— A 路幅值下 `3×1352+32 ≈ 4088` 几乎等于满量程,
   看着像"满量程毛刺都拦不住"。**若照这个直觉把 K 调小,会把大量好点判掉。**
   改法:先把日志里真实分布量出来。结果 A 路最大比值只有 **3.71** ⇒ K=3.0 在 A 路完全安全;
   真正需要收紧的是 B 路,而 B 路靠 FLOOR 才收得住。**先测分布,再选阈值。**

2. **★ 第一版方案过大,自己砍掉了。**
   我最初设计的是"N 次采集取中位数",配**第二对 64 KB 暂存缓冲 + memcpy 拿胜者**。
   写之前意识到:自洽闸已经把**整次坏掉的采集**挡在门外了,活下来的点之间只差 ~0.4%,
   而"重采到第一次自洽为止"**不需要任何额外交互缓冲**。
   ⇒ 换成现在的形态。**更简单,论证强度不减。**

3. **★ 把估计值写成了实测值的口气,自查后改回。**
   `ADC_SAMPLE_TRIES_MAX` 的注释里原写「量级 ~6 ms」,读起来像量过。
   **实际上没有。** 改成显式标注"**估计,未实测**",并附上测量方法(A/B 两轮总时长差 ÷ 重采次数)。
   —— 这正是 `skill/` 里 `measurement-instrument-can-be-wrong` 那条的同型错误。

4. **★ 一个假设被自己证伪,如实告诉用户,没有悄悄丢掉。**
   我怀疑 `sweep_autoscale()` / `MeasureConfig_PushPhase` 会在采集途中重写 `0x88`,
   那会产生一模一样的"两种字混在一个缓冲里"的签名。查下来:`PushPhase` 只在
   `AdcSample_CapturePair` 里调,**且被 `wait_until(ADC_STS_BUSY_MASK, 0, ...)` 挡住** ——
   正是 `adc_capture.v` 自己规定的规则。**这条路径排除,已明说。**

5. **★ 板卡目录结构又猜错一次(这是同一类错误的第 5 次)。**
   我按 `/home/xilinx/cv/src/c_ui/app/` 去 md5,两个路径都不存在。
   实为:C 源在 **`/home/xilinx/c_ui_src/app/`**,而 **`/home/xilinx/cv/` 是纯 Python 树**
   (`qrs-ui.service` 的 `WorkingDirectory`)。教训照旧:**先列目录,再下结论。**

6. **★ 交付仓库同步时,`rsync` 报的两处"差异"方向恰好相反,照它同步会把仓库打回旧版。**
   - `src/rtl/`:工作区那份是 **9 月残本 5 个文件**,仓库那份才是当前真本 **18 个文件**
   - `board/qrs.bit`:工作区 `232c649d…`(**10-14 那版**)vs 仓库 `c92c7ed5…`(**10-15 第 61 次,现行**)
   - `report/measurements/20261005_*.md`:两边**只差 `report/` vs `board/` 路径前缀**,仓库那版才是对的
   ⇒ 三个方向都由**时间戳/md5/内容**逐个核过才动手,`--dry-run` 的"有差异"三个字不足以定方向。
   另:仓库把 LLM 记录放在**顶层 `llm-log/`**,工作区放在 `report/llm-log/` —— 直接 rsync 会造出一棵重复的树。

7. **★ 分析自己的日志时,把方向读反了 —— 搜出了上一个点的证据。**
   要统计"判无读数"的点,我从 `⛔` 那行**向前**找证据行,结果拿到的是**上一个点**的
   `采 N 次`,算出来几个自相矛盾的数(一个"被弃"的点却显示"试了 2 次")。
   根因在**代码结构**:`adc_capture_pair()` 返回**之后**调用方才打证据行
   (`adc_log_pair()`),所以 `⛔` 在证据行**之前**。
   ⇒ 改成**向后**搜,得到正确的 5 个被弃偏压(0.322 / 0.363 / 0.579 / 1.314 / 55.688 V)。
   **教训:定位证据行之前,先在源码里确认调用顺序,不要按"先因后果"的直觉排布。**

8. **★ 自己写的日志措辞有歧义,被自己读错一次。**
   `[proto] 采集自洽账本:…` 打在 `sweep_finish()` 里,**读起来像"本轮扫压"的账**;
   实际上 `s_adc_rej` / `s_adc_rescued` / `s_adc_void` 只在 `pynq_protocol.c:1322`
   **进程初始化**时清零,`sweep_start()` 里**没有**清零 ⇒ 是**进程累计**。
   本轮数里 223 − 199 = 24 次来自扫压之前的单点测量。
   ⇒ **如实告诉用户这个口径问题,没有让它被当成"本轮拒收 36 次"。**
   修法(未做):要么把措辞改成进程累计的口径,要么在 `sweep_start()` 里真的清零。

9. **★ 拒收分组表算错了,而且和账本对不上 —— 是我自己没做对账。**
   第一版分组表列出 18 组、拒收次数合计 **32**,而账本说 **36**。两个数不一致我却没查。
   根因两条:① 按"连续行"分组时,把收尾的 **`✓ 重采第 N 次自洽`** 行也当成了拒收计进去
   (它带着 `码/期望 X / Y`,看着像拒收行),组内比值列表因此多一项、次数也虚高;
   ② **漏了 COSS 腿的两组**(79.123 / 88.951,各 2 次) —— 它们的比值 24.32 / 26.00 与 CRSS 高压端同量级,
   而我先前断言"A 类灾难性坏字只在 CRSS 高压端",**那条断言也是错的**。
   ⇒ 重算后 20 组 / 36 次,与账本逐字吻合。**教训:分组统计做完必须和独立计数器对账;
   对不上时先怀疑自己的解析,而不是先怀疑计数器。**

10. **★ 判读证据时用了循环论证。**
    我写"改后 `44.06 V` 的 15.57 pF 落在邻点插值 ~15.9 上" —— 可那个"邻点"就是
    `49.53 V`,而它的 **14.74 pF 同样是这次改动的产物**。**拿改动的输出去验证改动本身。**
    改成:用 CRSS 高压端**本应单调下降**这个**与改动无关的物理先验**判读 ——
    改前序列 `16.35 → 21.26 → 519.52 → 13.28` 三处逆趋势向上跳,改后 `16.48 → 15.57 → 14.74 → [断] → 12.79`
    单调(被弃点除外)。同为佐证,措辞也从"这就是真值"退到"**不再逆趋势**"。

## 沉淀

<!-- 这次的经验能变成 skill/ 下的哪一项?没有就不填,不要硬凑。 -->
→ 候选 `skill/consistency-gate-over-median/`
   —— **整次采集坏掉时,中位数治不了,要靠"物理不变式 + 重采"**。
   适用面比本项目宽:任何"同一份数据里两个数本应互相印证"的采集系统都适用
   (本次的不变式是"峰峰值 ≈ 2 × 解调幅值")。
→ 候选 `skill/sync-direction-must-be-proven/`
   —— 两棵同构树的同步,**"有差异"不指示方向**;定方向要靠 md5 + 内容 + 时间戳三选一。

---

<!--
填写提醒:
1. 当天记录,不要事后补 —— 补出来的没有"验证方式"和"纠错轨迹"
2. 失败也要记 —— 失败记录才是技能包的原料
3. 每条记录里必须能看到"我不同意 / 我改了 / 我验证了"
4. commit message 里加 [llm-XXX] 关联
-->
