dsgmxc/2026_fpga_qrs/llm-log/LLM-064.md

# LLM-064: 扫压结束不归零偏压、扫压不自动换挡 —— 两处缺陷与 `|Z| ≈ R0` 判据

- **日期**: 2026-10-15
- **模型**: Claude(DeepSeek-V4-Flash 会话)
- **任务**: 用户连着报两件事 ——
  ① 「扫完了,吧偏压调回 0,它这扫完都没有置零」(**缺陷**:扫压收尾不归零偏压);
  ② 「先把档位修复了不然数据都很奇怪」(**缺陷**:扫压全程固定一个挡位)。
  两条都要修、都要能上板验。

## 提示词

用户的输入按时间顺序,原文粘贴:

```
扫完了，吧偏压调回0,它这扫完都没有置零
```

(我先把偏压那条查实、给出「界面自身写才有意义」的理由之后,用户接着给第二条 —— 原话:)

```
先把档位修复了不然数据都很奇怪
```

(修完、重启、起服务之后,用户:)

```
重启吧
启动吧
先关一下系统吧
```

## 模型回答

### 第一条:偏压不归零 —— 先证伪,再定位

**没先改代码,先读硬件**。`0x14` 当场读回 **`0x0007FFFF`**。按 `pynq_regs.h:344-420`
的映射(`raw = (v/10 + 10)*1048575/20; return (uint32_t)(raw+0.5f) ^ 0x80000u;`)
反解 —— **正好 +100.000 V**。DUT 栅极被留在满扫压上,不是一个偏移、不是一个近零残差。

定位到两处,且两处性质不同:

| 位置 | 原行为 | 判断 |
|---|---|---|
| `sweep_finish()` | **完全没有写 `0x14`** | 纯疏忽,改 |
| `RequestSweepStop()` | 主动打印「偏压保持在当前点」 | **是当初写下的设计意图**,不是疏忽 ⇒ 一并改掉,但要说明为什么推翻它 |

收尾改成走 `bias_apply(0.0f)` 而不是直接 `cv_reg_write(0x14, 0)`,理由是**可观测性**:
顶栏「偏压:」那一栏只有 `bias_apply()` 这条路径会经 `bias_announce()` 更新 ——
绕过它写寄存器,硬件归零了而**界面仍显示 100.00 V**,那比不归零更难查。

用 `0.0f` 而不是界面旋钮下限 `0.1 V`:收尾要的是**真零**,即码 `0x00000`。

### 第二条:扫压不换挡 —— 先看数,再定判据

先把「数据奇怪」证成量程问题、而不是器件属性:

- 整段 CRSS 腿固定 **B 挡 100 Ω**,而 `|Z|` 从 **363 Ω 走到 15 313 Ω**;
- `VL/VH` 从 23.2 % 塌到 **0.64 %**,60 点里 **21 点低于 5 %**;
- `Cs` 在 6.77 V → 13.66 V **一个倍压之内掉 14 倍**(434 pF → 31 pF)。

`Z = R0·(VH−VL)/VL` 里 `VL` 是分母 ⇒ 它的相对误差被 **`|Z|/R0`** 放大(100 V 处 = 153 倍)
**直进 `Cs`**。这就解释了高压段的散点。

判据推导(不是试出来的):

| 区段 | 谁小 | 被放大的误差 |
|---|---|---|
| `|Z| ≫ R0` | `VL` | `|Z|/R0` 倍 |
| `|Z| ≪ R0` | `VH−VL` | `R0/|Z|` 倍 |

两者在 `|Z| = R0` 处相等 ⇒ **最优点 `VL/VH ≈ 70.7 %`**。四挡是等比级数(10/100/1k/10k)
⇒ 「最近」= **log 轴上最近**。边界恰在相邻两挡正中间,而 `|Z|` 有噪声 ⇒ 逐点取最近会在
边界来回跳,**每跳一次曲线就换一次标定基础** ⇒ 加 **0.15 十倍程迟滞**。

落地:`pynq_regs.h::cv_range_pick()`(纯判据,不写寄存器)+
`pynq_protocol.c::sweep_autoscale()`(趁本点新鲜 `|Z|` 先换好下一点的挡)。
**换挡失败即粘滞关闭**(`s_auto_gear_off`)—— 判据是确定性的,失败后每点都会算出同一个
"该换"的结论,不粘滞就会每 300 ms 重试并弹框,把扫压搅成一片报错。

## 结果

☐ ✅ 直接可用   ☑ ⚠️ 部分可用   ☐ ❌ 不可用

**① 偏压归零 ✅ 上板确证。** 上电后 `0x14 = 0x00000000`(新二进制冷启动即 0)。

**② 自动换挡 🔴 上板后已回退 —— 本条结论被推翻,见下。**

---

### 🔴 2026-10-15 追加更正:② 自动换挡已**默认关闭**(原地推翻,不删原文)

原结论「加自动换挡让数据变好」**不成立**。上板后的实情:

| 现象 | 证据 |
|---|---|
| 换挡**真的落到了硬件** | 8 次 `🔁 自动换挡`,全部寄存器回读确认 —— 机制没错 |
| **但它把唯一一条随偏压变化的曲线毁了** | COSS 腿把挡位从 B 顶到 C,**CRSS 腿继承 C 再顶到 D**;CRSS 抬到 D 之后出来的是 `|Z| = 140 kΩ`、`Cs` 为负、`D = 71` |
| **判据脚下的 `|Z|` 本身不可信** | 参考电阻是否真是挡位标称值,**至今未用已知件标定过**。在一个坏数上乘一次错比例,只会放大 |
| **几何上不成立** | COSS 腿 @ 0.100 V 同一次里 `VL/VH` = **7.36 %**("100 Ω")与 **39.3 %**("1000 Ω")。对任何无源 `Z`、任何 10× 电阻对反解 ⇒ `|Z|² < 0`。**这两条读数不可能同时为真** |

**处置**(2026-10-15,第 60 次):`sweep_autoscale()` 加**总开关**,默认**关**。
开关用**文件**(`/home/xilinx/sweep_auto_gear`)不用环境变量 —— 环境变量要重启服务才生效,
而重启服务 = 第二次 `Overlay()` = **红线**;文件在 `sweep_start()` 时现读,下一场扫压即生效。
判据本身(`cv_range_pick()`)**一个字没改、§验证方式 那一整张表全部仍然有效** ——
被推翻的是「**现在就该启用它**」这个判断,不是判据的算术。

### ⚠️ 另一条被推翻的中间结论(同一次上板)

「接线整理后四个挡位读数终于一致了」—— **是虚的**。那场测量的**偏压是关的**:

| 条件 | CISS | COSS |
|---|---|---|
| 四挡测试(偏压**关**) | 3504.8 pF | 4750.2 pF |
| 偏压**关**的那场扫压 | 3505.4 pF | 4743.8 pF |
| 偏压**开**的扫压 | 2055.4 pF | 118 pF |
| 整理接线**之前**(偏压开) | 2055.5 pF | 114 pF |

⇒ 「变好了」只是偏压没开;**接线整理没有改变任何东西**。

## 验证方式

| 项 | 具体 |
|---|---|
| **判据本身** | `sim/tb_gear_pick.c`(主机自检,`gcc -lm`,**不需要 Vivado、不需要板子**);
日志 `sim/logs/tb_gear_pick.log` —— **10/10 PASS,退出码 0**;报告 `sim/gear_pick_verification.md` |
| **输入数据** | **实测**,不是构造的:`report/measurements/20261015_crss_sweep_manual_gear.md` 里那 60 组 `Z` |
| **负对照** | 同一条数据上「固定 B 挡」最坏 `VL/VH` **0.65 %** ⇒ 证明这套判据**有失败能力**,不是"怎么都能过" |
| **三条跑道** | ① 固定 B:0 次换挡,最坏 0.65 %;② 无迟滞:4 次换挡 / **2 次方向反转** / 挡位非单调;
③ 迟滞 0.15(落板配置):**2 次换挡 / 0 次反转 / 单调 B→C→D**,`VL/VH` **21.95 %–83.41 %** |
| **迟滞的直接测试** | 让 `|Z|` 停在 B/C 分界 316.2 Ω 上左右晃 ±5 %,跑 40 次:迟滞 0 → **39/40 次换挡**;
迟滞 0.15 → **0/40**。同一份代码、同一份输入,只改迟滞宽度,结果从 39 变 0 |
| **偏压归零** | ⛔ **只做到静态核对**:新编的板上二进制里 `偏压已归 0` 出现 **3 次**、
`偏压保持在当前点` 出现 **0 次** ⇒ 修复确已进二进制。**收尾路径本身没有实跑过** |
| **上板验** | ⏳ **未做**(本轮没有跑过修复后的扫压) |

## 纠错轨迹

1. **`VL/VH` 写成了标量式。** 我先把日志行写成 `100.0/(1.0 + z_mag/R0)`,正确的是**相量和的模**
   `R0/|R0+Z|`。两者在 `|Z| ≫ R0` 时接近、在 **`|Z| ≈ R0` 附近差近一倍** —— 而本判据**恰好**
   在 `|Z| ≈ R0` 附近做判断。
   **怎么发现的**:自己回看日志行时觉得和 §3 表里的实测比例对不上(B 挡实测 84.9 %,标量式给 59.5 %)。
   ⚠️ 同一个混淆**在同一会话里犯了两次**,第二次才意识到是同一个错。
2. **`strings | grep '偏压已归 0'` 返回 0,我差点据此判定"修复没编进去"。**
   根因是 GNU `strings` 默认只打 ASCII 串,**UTF-8 中文串根本不会出现**。
   改用 `grep -ao` 直接扫二进制 → **3 次**。**是我的工具错了,不是代码错了。**
3. **`pgrep -f 'c_ui --axi-base'` 报出两个 PID。** 是假阳性 —— 模式串出现在我自己那条
   远程 shell 命令行里。用 `ps -eo pid,ppid,args | grep -a '[c]_ui'` 交叉核对,实际只有一个。
4. **`0x80000 = 0 V` 这个错误口径还留在代码注释里。** `RequestReset()` 的注释写着
   「偏压 → 0 V(码 `0x80000`)」,**补码下那是 −100 V**。代码本身(`bias_apply(0.0f)`)是对的,
   错的是注释。已就地更正 —— **日志与注释打架最伤 M11**(同 §6.0.1 的既有纪律)。
5. **换挡日志里的 `VL/VH` 实测值一度取错。** 拿 C 挡的 `|Z|` 去算 B 挡的预测值,
   算出 59.5 % 而实测 84.9 %。改为一律从 `s_pair.mag_a_v / mag_b_v` 当场取实测、用例中挡位算预测。

## 沉淀

→ `skill/`(本轮已具备可复用形态的两条,**尚未成文**):
1. **「量程判据 = 让放大系数最小的那个量居中」** —— 误差只有在两个来源相等处才最小,
   判据不该取"信号大"或"信号小",该取**两者交点**;等比挡位 ⇒ 在 log 轴上判,并配迟滞。
2. **「先给测试台一个失败的能力」** —— 负对照(固定 B 挡必须真的坏)比任何 PASS 都有说服力;
   没有负对照的自检,通过数再多也不能排除「判据恒真」。

## 归属说明(与 M11 有关)

- **两条需求都来自用户的一句话**,方案、推导、实现、测试台由 Claude 完成。
- **输入数据是用户上板实测的**(60 点 CRSS `Z`),不是 Claude 造的。
- **纠错轨迹 1 是本轮最有价值的一条** —— 同一个公式混淆在**同一会话内犯了两次**,
  说明它不是笔误而是**我的默认直觉错了**;第二次是靠"与实测比例对不上"发现的,
  **不是靠重读自己的推导**。这条比"我改对了"更能说明协作方式。
- ⚠️ **两条修复本轮都没上板验证** —— 记 ⚠️ 不记 ✅。
