dsgmxc/2026_fpga_qrs/llm-log/LLM-065.md

# LLM-065: 切回固定挡位 + 上板坐实「数据很奇怪」的根因是 **CRSS 腿模拟前端饱和**

- **日期**: 2026-10-15
- **模型**: Claude(DeepSeek-V4-Flash 会话)
- **任务**: 用户连着给三条指令 ——
  ① 「**还是很奇怪，要不先切换会固定档位的模式把**」(回退 `LLM-064` 的自动换挡);
  ② 「**自己重启把**」(授权我软重启,不用等他);
  ③ 「**先关系统吧**」(收尾关机)。

## 提示词

用户的输入按时间顺序,原文粘贴:

```
还是很奇怪，要不先切换会固定档位的模式把
```
```
自己重启把
```
```
先关系统吧
```

## 模型回答

### 一、回退用**文件开关**,不用环境变量(为了避开红线)

理由:环境变量要重启服务才生效,而**重启 `qrs-ui.service` = 第二次 `Overlay()` = 红线**;
文件在 `sweep_start()` 时**现读、不缓存** ⇒ 「改文件 → 下一场扫压」即生效,代价为零。

| 位置 | 改动 |
|---|---|
| `pynq_protocol.c:126` | `#include <unistd.h>`(为 `access()`) |
| `pynq_protocol.c:168` | `#define SWEEP_AUTO_GEAR_FLAG "/home/xilinx/sweep_auto_gear"` + 完整理由注释 |
| `pynq_protocol.c:200` | `sweep_auto_gear_enabled()` |
| `pynq_protocol.c:1007` | `sweep_autoscale()` 开头早退 |
| `pynq_protocol.c:918` | 扫压起手日志**明说**当前模式,事后对日志不会有歧义 |

```bash
sudo touch /home/xilinx/sweep_auto_gear   # 回到自动换挡
sudo rm    /home/xilinx/sweep_auto_gear   # 固定挡位(默认)
```

**判据一行没改、`sim/gear_pick_verification.md` 那张表全部仍然有效** ——
被推翻的是「**现在就该启用它**」,不是判据的算术。

### 二、编译与核对(不等用户,自己做完)

| 项 | 结果 |
|---|---|
| 源码两边 md5 | `183e40ffb1b1580f07a0848e17da9652` ✅ |
| 板上 `make -j2` | **exit 0**;日志里**明确看到** `-c app/pynq_protocol.c` 重编 + 重新链接 |
| 新 `c_ui` md5 | `6bec1b4b4290305ee91968215be34e86` |
| 旧二进制留底 | `c_ui.prev` / `557ed63c42530b6ffbe3995cbb849efe` |
| `ldd` 缺失库 | **0** |

新旧二进制**正反对照**(⛔ `grep -ao`,不用 `strings`):

| 串 | 新 `c_ui` | 旧 `c_ui.prev` |
|---|---|---|
| `自动换挡默认关闭` | **1** | 0 |
| `扫压期间固定不变` | **1** | 0 |
| `第 1 点用`(旧话术) | **0** | **1** |

⚠️ **链路里的一处坑(本轮新增)**:正在运行的执行文件**不能被 `make` 直接覆盖**
(Linux `ETXTBSY`)。做法是先 `mv c_ui c_ui.prev`(rename 不影响已运行的 inode)
再 `make` —— **顺带白得一份回滚件**。

### 三、软重启 + 上电后全项核对(用户授权,`自己重启把`)

`shutdown -r now` → +3 s 网络断 → +15 s 网络通。核对全过:

| 项 | 实测 |
|---|---|
| `qrs.bit` md5 | `232c649d0cc143c12c87f17365f6ddd3` ✅ |
| `qrs.hwh` md5 | `6c376905b48aa8d79778f0d4b21f0bbc` ✅(BD 未动) |
| 位流加载次数 | **1**(`dmesg` 里恰好一条 `writing qrs.bin`)✅ 红线守住 |
| `qrs-ui.service` | 重启后 `disabled` + `inactive`;`systemctl start` 后 `active` |
| FCLK0 | **50.0000 MHz**(IO_PLL 1000 / DIV0 20 / DIV1 1)✅ |
| 采样 | **32.50 MSPS,DIV=4,PH_OFF=+1**(`0x88 = 0x00104`)✅ |
| 激励 | 1.000 MHz(`0x80 = 0xA3D70A`)✅ |
| `0x04` STATUS | `0x00000000`(空闲 / `err_code = 0`)|
| `0x14` BIAS | `0x00000000` = **0.000 V** ← `LLM-064` ① 的归零修复,**冷启动即 0** |
| `0x18` RANGE_SEL | `0x00000002` = **B 档 100 Ω**(RTL 复位值)|
| `0x1C` RELAY_CFG | `0x00000010` = `ALL_OFF`(K5,复位值)|
| `0x84` CV_CTRL | `0x00000001`(DAC 已放行)✅ |

### 四、★ 用户跑了一场扫压 —— **「数据很奇怪」的根因坐实**

日志 `/var/log/qrs-ui.log` 第 **5384–6103** 行(该文件跨上下电**追加不截断**)。
存档:`report/measurements/20261015_uilog_fixed_gear_sweep.txt`,md5 `8c17256b861ed0e099d2b007d86c10c8`。

**① 固定挡位真的生效了**(用户①②的直接验收):

```
[proto] 扫压开始:CISS+COSS+CRSS,0.10 V → 100.00 V,60 点/腿,每点 300 ms
        挡位 0x2(100 Ω):🔒 **扫压期间固定不变**(自动换挡默认关闭,要开见 SWEEP_AUTO_GEAR_FLAG)
```
60 点**每一点**都印 `挡位 0x2`,`sweep_autoscale()` 一次都没触发。

**② 三腿继电器真的逐腿切了**(`LLM-062` §一④ 的验收):

```
[relay] 回路 → CISS(0x7F)  →  RG(0x3C)  →  CISS(0x7F)
[relay] 回路 → COSS(0x61)
[relay] 回路 → CRSS(0x51)
[proto] 扫压结束:CRSS,共 60 点已下发到 DAC
```
⇒ 三条曲线**不再共用一份数据**(`LLM-062` 结清的「四处假装」之一,上板确证)。

**③ 🔴🔴 核心发现:CRSS 腿的两路 ADC 都顶到满量程。**

| 腿 | A 峰峰(码) | B 峰峰(码) | OTR 非零 | `VL/VH` | 判定 |
|---|---|---|---|---|---|
| CISS | 1199–3516 | 943–3516 | **1 / 72** | 74 % 稳 | ✅ 正常 |
| COSS | 1636–2876 | 133–3569 | **1 / 60** | 7.3 % 稳 | ✅ 正常 |
| **CRSS** | **2815–4095** | **3213–4095** | **58 / 60** | 0.09 %–3.3 % | 🔴 **饱和** |

`4095` = **12 bit 满量程**(`VFS_PP = 2.0 V / 4096 码`)。CRSS 腿最大 OTR = **43 / 次采集**;
**B 通道基波塌到 0.002–0.008 V,而原始峰峰是满量程** ⇒ **信号没了,只剩削顶。**
`Z` 因此飞出 2955 Ω → **127 kΩ**,`Cs` 出 **−210.7 pF / 507.5 pF / 2.56 pF** 这类非物理值。

**对照下来 CISS / COSS 两条腿是干净的** —— `|Z|` 稳(`VL/VH` 74 % / 7.3 %),
`Cs` 平(2055 pF / 118 pF),`OTR` 各只有 1 次非零。

**④ 顺带坐实:前一轮的「变好了」是虚的(见 `LLM-064` 更正)。**

## 结果

☑ ⚠️ 部分可用

| 项 | 判定 |
|---|---|
| **① 固定挡位** | ✅ **上板确证**(60 点全 `挡位 0x2`,日志明说模式) |
| **② 三腿逐腿切继电器** | ✅ **上板确证**(`[relay] 回路 →` 三腿序列) |
| **③ 偏压归零** | ✅ **上板确证**(冷启动 `0x14 = 0x00000000`) |
| **④ CRSS 腿饱和** | 🔴 **新发现,未处置** —— 见下 |

## 验证方式

| 项 | 具体 |
|---|---|
| **固定挡位落板** | 上电后 60 点日志**逐点**印 `挡位 0x2`;起手行印 `🔒 扫压期间固定不变` |
| **二进制确是新版** | 新旧**正反对照**三个串(表见上);`md5sum` = `6bec1b4b…` |
| **位流是部署版** | `md5sum /home/xilinx/qrs.bit` = `232c649d…`;`dmesg` 一条 `writing qrs.bin` |
| **日志存档可信** | 本次前 4141 行 md5 = `229092e490c2de4818d20d256681945a`,与上一份存档**逐字节相同** ⇒ **追加不截断**这条性质**实测**成立,历史行号引用不会失效 |
| **饱和是实测不是推断** | `OTR` 是 **PL 侧 AD9238 的越限标志**,不是软件算的;`峰峰 4095` 是 12 bit **满幅** |
| **未覆盖** | ⛔ **CRSS 腿为什么饱和未定位** —— 是继电器组合、前端增益、还是 DUT 侧的耦合?**需要夹具原理图**,不在我手上 |

## 纠错轨迹

1. ★ **我把「四个挡位读数终于一致」当成了接线修好的证据,它是虚的。**
   用户整理接线后测四挡得 CISS 3504.8 / COSS 4750.2 pF,看着比之前"整齐"。
   我回头比对才发现:**那场的偏压是关的** —— 偏压关的扫压给 3505.4 / 4743.8 pF(吻合),
   偏压**开**的给 2055.4 / 118 pF,而整理接线**之前**(偏压开)给 2055.5 / 114 pF。
   ⇒ **接线整理没有改变任何东西**;「变好」只是偏压没开。
   📌 **两个变量一起动时,"看起来更好"什么都证明不了** —— 同 `LLM-063` 纠错① 的同一类错。
2. **我把日志里的一次「挡位 10000 Ω → 1000 Ω → 100 Ω」误读成"迟滞失效、挡位来回跳"。**
   回原始行才发现那是 **CISS 腿第一个点继承了上一条腿的 D 挡、再用两步收敛下来** 🔴
   —— 这恰恰是 `|Z| ≈ R0` 判据**该有的行为**,不是故障。**是我读日志的模式错了,不是硬件错了。**
3. **自写的日志解析器把腿归属算错**:分组表显示 `VL/VH ≈ 90 %`,而同一份日志里
   自动换挡那行写的是 7.4 %。**我没信自己的解析器**,退到 `sed` 逐行原文才确认。
   根因:解析器把 `cur_leg` 跨场带了过去。
4. **正被运行的执行文件不能被 `make` 覆盖(Linux `ETXTBSY`)。**
   做法改成先 `mv c_ui c_ui.prev` 再 `make` —— rename 不动已运行的 inode。
   📌 **顺带白得一份回滚件**,比直接覆盖更安全。
5. **`echo xilinx | sudo -S -p '' wc -l < /var/log/qrs-ui.log` 读口令失败。**
   重定向 `<` 由**远端 shell 先于 `sudo`** 执行 ⇒ `sudo -S` 的 stdin 被换成了那个文件,
   它拿日志的头几行当口令,报两次 `Sorry, try again.`。
   改成把文件名当**参数**(`wc -l /var/log/...`)即可。

## 沉淀

→ 待建 `skill/two-variables-one-move/`(**两个变量一起动时,任何"看起来更好"都不构成证据**;
判据 = **一次只动一个,并且把"没动"的那一次也记下来**)—— `LLM-063` 纠错① 与本次纠错 1 **同型复发**,
说明它不是一次疏忽而是**我的默认推理方式有漏**。

→ `skill/`:本轮还产生一条可复用的**运维**形态:
**「用文件开关代替环境变量 / 服务重启」** —— 当重启进程本身是红线时(此处 = 第二次加载位流),
把"编译期决定"改成"运行时现读"能让代价从「一个上电周期」降到「零」。
⚠️ 判据:开关的读取点必须是**每次进入该功能时**,而不是进程启动时缓存。

## 归属说明(与 M11 有关)

- **三条指令全部来自用户的一句话**;文件开关的设计、编译、上电核对、日志解析由 Claude 完成。
- **软重启由 Claude 执行**(2026-10-12 第三次授权:综合 / 软重启 / 自行调试归我;
  **真断电、接线、万用表仍是用户的**)。
- ⭐ **本轮最有价值的是纠错 1** —— 它不是代码错,是**我在两个变量同时变化时把"看起来更整齐"
  当成了因果**。而推翻它的证据**(偏压关/开两场扫压的数字)**本来就在我自己的日志里**,
  **不是靠新做一次实验拿到的** ⇒ 教训是「先把手上的数据两边都读一遍,再下结论」。
- 🔴 **CRSS 腿饱和目前只是"症状坐实",成因未定位** —— 本记录**不替它下结论**。
