dsgmxc/2026_fpga_qrs/llm-log/LLM-063.md

# LLM-063: 扫压数据「看着不对」的三个成因,与采样刻度 DIV 2 → 4

- **日期**: 2026-10-15(工作起于 2026-10-14 夜)
- **模型**: Claude(DeepSeek-V4-Flash 会话)
- **任务**: ① 用户报「偏压扫了一遍,结果跟之前不太一样」,查是不是档位问题;
  ② 回答「档位没法自动调节,会不会烧 LCR 电桥」;
  ③ 按用户拍板把 `CV_ADC_DIV_DEFAULT` 由 2 改成 4 并落地(重编 c_ui,不重下位流)。

## 提示词

用户的输入按时间顺序,原文粘贴:

```
我刚刚开启了偏压测量一遍后面又关了,你看看结果有没有问题,感觉跟之前不太一样是不是档位没法自动调节的问题,没法调档位应该只是测量不准不会烧lcr电桥吧
```

(我把三个成因摆出来、并给出推荐后,用户拍板 —— 原话,引用的是我的建议:

> 先把 `CV_ADC_DIV_DEFAULT` 由 2 改成 4 —— 纯 C 一行,不用重下位流,只重编 c_ui。
> 所有腿共同受益,消掉翻位尖刺。⚠️ 代价:`f_s` 65 → 32.5 MSPS,`Cs` 整体偏约 13%,
> 历史 65 MSPS 那批数不能再直接比。这条还等你拍板(任务 #10)。

)

```
这个修复吧,档位先别动等我连上档位控制引脚,然后如果你用不上开发板就先关系统
```

## 模型回答

三件事,分开说:

1. **扫压曲线"不对"有三个独立成因,不是一个**。逐一给出日志证据:
   - **档位卡在 B(100 Ω)** —— 偏压高于约 11 V 后 `|VL|` 塌到 0.002–0.009 V
     (约 9–40 个码),`Re Z` 随机散(1724 / 1062 / 1079 / 1140 / 1343 …),
     而受控条件下同一量的 SD 是 0.44%。成因:`|Z_DUT|` 升到 6–16 kΩ 而 R0 只有
     100 Ω ⇒ `|VL|/|VH| ≈ 0.008`。**自动挡与手动挡都不存在**
     (日志原文:「档位 0x18 仍只读回显」)。
   - **DIV=2 的边缘采样仍在翻 B 的总线位** —— 日志里 `A/INA` 幅值 0.2706 V /
     0.2705 V / 0.2710 V(平滑),而**峰峰值** 1286 → 1289 → **1535** 码,
     跳跃幅度正好 ±1024/±2048;`B/INB` 峰峰在 400↔2500 之间跳。
   - **低偏压头部几点**(0.100 → 0.112 V)Cs 从 695 → 1755 pF 跳变,同一个成因。
2. **档位卡住不会烧电桥**。挡位只选四个参考电阻之一(10 Ω / 100 Ω / 1 kΩ /
   10 kΩ),不碰增益、不碰供电。B 挡下日志里电流最大 2.45 mA,即使 DUT 短路也只有
   几 mA。唯一要当心的是 A 挡(10 Ω),电流约大 10 倍。
   ⚠️ **明确说了不确定的部分**:夹具原理图不在团队手上
   (`source_design_checklist.md` 自己写着),所以**下游模拟开关的保护我无法核实** ——
   这一条只能由用户对着硬件确认。同时排除了一个疑似偏压缩放 bug:
   `pynq_regs.h:325-328` 记着外部 ×10 级,90.000 V 就是真栅压。
3. **改 DIV**:`CV_ADC_DIV_DEFAULT 2u → 4u`。P=2 时整张刻度表只有 `{−1, 0}` 两点,
   贴死 `adc_clk` 两个边沿,零建立裕量;P=4 的表是 `{−2,−1,0,+1}`,`+1` 使 A 落 tick+1、
   B 落 tick−1,各离边沿 7.69 ns。

## 结果

☐ ✅ 直接可用   ☑ ⚠️ 部分可用   ☐ ❌ 不可用

- 「三个成因」与「不会烧电桥」:✅ 用户认可,按此拍板。
- 改 DIV 本身:✅ 已落地(见下),**但要等下一个上电周期才生效** ——
  重启 `qrs-ui.service` 会再调一次 `Overlay()` = 第二次加载位流,是红线。
- **明确没做**:自动挡 / 手动档位切换(用户说等他连上挡位控制引脚)、
  `ADC_SAMPLE_R_TIA = 1000.0f` 与 B 挡 100 Ω 的不一致。

## 验证方式

**改前改后的对照,同一回路、同一条件**,不是两次不同实验:

- 回路 CRSS(`0x1C = 0x51`)、挡位 `0x18 = 0x02`(B / 100 Ω)、`f_e = 1 MHz`、
  继电器与 DAC 全程不动、每档**连采 30 次**。
- 工具(都在仓库里,可复现):
  `sudo -E python3 tools/adc_cfg_probe.py --cfg '2:-1' --only-z --z 30`
  `sudo -E python3 tools/adc_cfg_probe.py --cfg '4:+1' --only-z --z 30`

| DIV/PH | f_s | Re Z ±SD | Im Z ±SD | Cs ±SD (pF) | D ±SD |
|---|---|---|---|---|---|
| `2:−1` | 65.0 | 231.44±1.02 (0.44%) | −75.33±2.91 (3.86%) | 2115.90±81.66 (3.86%) | 3.08±0.13 (4.20%) |
| `4:+1` | 32.5 | 228.52±0.78 (0.34%) | −86.30±0.36 (0.42%) | **1844.19±7.79 (0.42%)** | 2.65±0.01 (0.19%) |

⇒ Cs 重复性 81.66 → 7.79 pF,**约 10 倍**。代价:`Cs` 均值偏 −12.8%
(2115.90 → 1844.19),**历史 65 MSPS 那批读数不能与之后的直接比**。

**落地验证(主机侧 + 板上)**:

- 主机编译核对:`cv_adc_cfg_word(CV_ADC_DIV_DEFAULT, cv_adc_phase_center(CV_ADC_DIV_DEFAULT))`
  = **`0x00000104`**(DIV=4 / PH=+1),`cv_adc_sample_hz()` = 32 500 000 Hz,
  tick +1 落在合法区 `[−2, +1]` —— 与板上实测的 `4:1` 是同一配置。
- 相干窗在三档激励下重算仍全部成立(1 MHz → 252/8190;100 kHz → 25/8125;
  10 kHz → 2/6500),`ADC_DEMOD_MIN_M = 1` 不是瓶颈。
- 板上重编 `c_ui`:**exit 0**,唯一一条 warning 出在没动过的 `ui/ui_demo.c:1805`。
- 新二进制内容核对(用 `grep -a` 查 UTF-8 裸字节):新串 `CV_ADC_DIV_DEFAULT 定死`
  出现 1 次;旧串精确短语 `已固定 65 MSPS` 出现 **0 次** ⇒ 编进去的确实是本轮的源。
- 二进制 md5 `7932dd2fac74fc710d6d3e18e3d041b5`(板上)。

**离场状态(关机前实测)**:

| 项 | 值 |
|---|---|
| 位上跑的位流 | `232c649d0cc143c12c87f17365f6ddd3`(**本周期没有再加载**,仍是上一周期那一次) |
| `.hwh` | `6c376905b48aa8d79778f0d4b21f0bbc`(未变 ⇒ BD 没动) |
| 板上 `c_ui`(新编) | `7932dd2fac74fc710d6d3e18e3d041b5` —— **下次上电才生效**,本次服务进程仍持旧二进制 |
| `qrs-ui.service` | `active` 但 `enabled=disabled`(符合"用户说开才开") |
| 继电器 `0x1C` | 已回 **`ALL_OFF(0x10)`**(`err=NONE`) |
| 板子 | `sync` + `shutdown -h now`,ping 已不通 |

## 纠错轨迹

1. **错:我把「修复前」和「修复后」的两批数混着比。**
   我起初写「Im Z 的 SD 从 28.76% → 0.42%」。28.76% 是**位流修好之前**那一批
   (那时两路来自两次独立 GO,相位随机),0.42% 是修好之后 **DIV=4** 那一批 ——
   **两个变量一起动了**,这个对比证明不了 DIV 有用。
   发现方式:写代码注释时要引用复现命令,回去翻原始输出,发现两批不是同一次运行。
   改正:只用**同一次的** `2:−1` vs `4:+1`(231.44 / 2115.90 那两行),
   两者都在位流修好之后,唯一变量是 DIV。笔记里把 28.76% 那批标成"位流缺陷的证据",
   不与 DIV 混谈。
2. **错:我用 `strings | grep '中文' | wc -l` 得到 0,并把它当成证据。**
   GNU `strings` 默认只打印可打印 ASCII,**中文 UTF-8 永远不出现** —— 这个 0 是
   必然的,不携带任何信息。
   发现方式:自查(想到"如果工具默认过滤掉我要找的东西,那这个命令永远回 0")。
   改正:改用 `nm c_ui | grep -i relayview` 查符号表;这一轮改用 `grep -a` 直接匹配裸字节。
3. **★★ 错:我从错误的那棵树推文件到板子 —— 而且这是「已经记过一次」的坑。**
   主机上 **`src/c_ui/app/` 有两份**:工作树 `~/Desktop/qrs_2026_fpga/` 与
   交付仓库 `~/Desktop/qrs_fpga_2026/`。我把编辑**做进了交付仓库那份**,
   然后用相对路径 `src/c_ui/app/...` 从**工作树**推 —— 推上去的是**没改过**的版本。
   发现方式:推完做 md5 校验,6 个文件**全部对不上**。若只看 `--put` 的"成功"输出
   (它印的是**本地文件大小**,不是远端校验值)就会以为推成功了。
   改正:`diff -rq` 确认两树之间**除了我这轮的改动没有任何独立漂移**,
   再把 6 个文件从交付仓库拷回工作树,两树一致后重推,**md5 逐行相同**。
   📌 **`LLM-062` 的「验证方式」表里已经写过同一条** ——「C 侧三棵树一致 …
   ⚠️ **先踩过:我第一遍改在了错的那棵树上**」。**记录过 ≠ 防住**:
   写进文档只是一句话,没有任何**机械步骤**在拦它,所以隔了一晚又踩一次。
   ⇒ 真正该沉淀的不是"记住有两棵树",而是一个**每次推送后无条件执行的校验动作**
   (`--put` 之后回读远端 md5,不等于不许放行)。见「沉淀」。

4. **错(文档层):`LLM-062` 记的位流 md5 是中间产物,不是板上跑的那一个。**
   同一夜连出了三个位流:`182e8248…`(22:28)、`90cadcce…`、**`232c649d…`(23:41)**。
   `LLM-062` 的「综合实现结果」与 `INDEX` 页脚都写着 `182e8248…`,而
   **推到板上并核对过 md5 的是 `232c649d…`**(会话内实测:`/home/xilinx/qrs.bit`
   = `232c649d…`)。⇒ 三处口径不一,且**工作区 `board/qrs.bit` 停在 `182e8248…`**
   (交付仓库那份才是对的)⇒ 谁若从工作区部署,会加载**错的那一版位流**。
   发现方式:写本记录的验证方式时回去核 bit,顺手 `find` 全部 `.bit` 算 md5,
   发现同夜三个 md5 并存。
   改正:工作区 `board/qrs.bit` 已换成 `232c649d…`(两树 + 板上三者一致);
   `LLM-062` 与 `INDEX` 页脚的 md5 就地更正并注明。
   📌 **这一条的教训与第 3 条同源**:`md5` 是唯一能分辨"同名不同内容"的手段,
   而**文件大小、时间戳、脚本的"成功"输出都不能** —— 三个位流**大小完全相同**
   (都是 4045690 B),只有 md5 分得开。
5. **改完仍有问题吗**:有,且是**已知的、留着的** ——
   ① 新默认**要等下一个上电周期才生效**(本次没重启服务,这是红线);
   ② 档位仍卡在 B,高偏压段 `Re Z` 照样散(成因一没解决,等用户连好挡位引脚);
   ③ `Cs` 的 −12.8% 偏移是**真实代价**,不是噪声;
   ④ `LLM-062` 那批「已上板验证」的结论(回路切换 L1–L5)是在 `182e8248…` 还是
      `232c649d…` 上取得的 —— **待下一次上电 md5 复核时一并坐实**,
      本记录不替它下结论。

6. **★★ 错(文档层,同日自查发现):`M03` 入库的那三份实现报告,和部署的位流不是同一次构建。**

   起因:收尾时 `git status` 里还有一处 ` M build/vivado_build.log`,我去看它改了什么,
   发现它的会话头是 **23:39:19**(cwd = 交付仓库根),而 `HEAD` 那份是 **22:16:11**
   (cwd = `build/`)。⇒ 是两次不同的构建。顺着查:

   | 证据 | 事实 |
   |---|---|
   | 三条 `vivado_build*.log` 会话头 | 22:16:11 / 23:29:18 / 23:39:19 ⇒ **那一夜跑了三次完整构建** |
   | `fpga_pro/qrs/qrs.runs/impl_1/system_wrapper.bit` | md5 **`232c649d…`**、mtime 23:41 ⇒ **就是部署的那一版** |
   | 该 `impl_1/` 下 11 份 `.rpt` | 全部 23:40 |
   | 入库的 `build/system_wrapper_*.rpt` ×4 | 全部 **22:28** ⇒ 属**第一次**构建(`182e8248…`) |
   | 根目录 `summary.txt`(23:41) | 是 **23:39 那次运行自己写的汇总** |

   🔴 **而两次构建的数并不相同** —— 这直接推翻了 `LLM-062` 更正块里那句
   「**三次构建资源数完全相同**」:

   | 项 | 第 1 次(22:16 → `182e8248…`) | **第 3 次(23:39 → `232c649d…`,部署版)** |
   |---|---|---|
   | WNS | +0.354 ns | **+0.316 ns** |
   | WHS | +0.094 ns | **+0.065 ns** |
   | 失败端点 / 总数 | 0 / **5469** | 0 / **5472** |
   | Slice LUTs | 1789 (3.36%) | **1790 (3.36%)** |
   | Slice Registers | 2021 (1.90%) | **2022 (1.90%)** |
   | `clk_fpga_0` WNS | 11.540 | **9.440** |
   | `clk_adc_raw` WNS / 端点数 | 0.354 / 216 | **0.316 / 218** |
   | Block RAM Tile / DSP / IOB / BUFG | 7.5 / 0 / 67 / 3 | **完全相同** |

   ⇒ 源**没变**(那三次构建之间只改了 C 侧 `CV_ADC_DIV_DEFAULT`,不碰 RTL/BD),
   差异纯粹来自**三次独立的布局布线**(同一份源,P&R 结果不是逐比特可复现的)。
   **不改设计,只改口径:凡引用「10-14 那版位流」的性能与资源数字,一律以部署版为准。**

   改正三件事:
   ① 把**部署版**的 4 份 `.rpt` + 它自己写的 `summary.txt` 收进 `build/`
      (旧的 4 份 + 旧 summary 留证在 `/tmp/m03_build1_backup/`,未入库);
   ② `LLM-062` / `INDEX` 页脚 / `docs/project_state.md` / `docs/dev_handbook.md`
      里的 WNS / LUT / FF / 端点数就地更正为部署版数值,并注明差异来源;
   ③ 删掉 `LLM-062` 更正块里那句「三次构建资源数完全相同」。

   📌 **教训:和上面第 4 条是同一件事的第二次现形** —— 第 4 条我只核了**位流**的 md5,
   就以为"口径统一了",顺手还写下一句没验过的断言(「资源数完全相同」)。
   **一次只核一种产物 = 把同类缺陷留在原地。**
   一根 md5 链要一直钉到**证据的末端**:位流 → 检查点 → 每一份报告,
   并且**断言"相同"之前必须真的 `diff` 一次**。

7. **错(工程卫生层):`.gitignore` 里有 8 条规则是死的,而且死得很安静。**

   发现方式:第 4 条收尾时 `git status` 里 `build/vivado_build.jou` 一直是 `??`,
   可 `.gitignore` 明明白白写着 `*.jou` —— 起了疑,用 `git check-ignore -v a.jou`
   一查,**没有匹配行**。

   原因:**gitignore 没有「行尾注释」这种写法。** `*.jou    # 说明` 里的 `#` 不是注释符,
   整行(含所有空格与中文说明)被当成**一条字面 pattern**,于是这条规则静默失效 ——
   不报错、不提示,`git status` 里看起来"只是还没加"。中招的 8 条:
   `*.jou` / `*.wdb` / `xsim.dir/` / `sim/out/` / `.ipynb_checkpoints/` /
   `.Xil/` / `*.pb` / 一条被空格缩进的续行注释(整整一行都成了 pattern)。

   改正:把说明挪到**独占一行**、`#` 顶格;逐条 `git check-ignore -v` 复核
   (8 条全部生效),并 `git ls-files -i -c --exclude-standard` 确认
   **0 个已入库文件被新规则吃掉**;另补两条具体形态(`/vivado.log`、`vivado_*.backup.log`),
   ⛔ **不加 `*.log` 全局规则、也不列 `summary.txt`** —— 后者是 `M03` 证据。
   文件头加了一段红字,把"没有行尾注释"这条写死在最前面。

   📌 **它和 `skill/silent-capacity-gates/` 里已经沉淀的那类缺陷同源**:
   **"看起来像写了"和"真的生效了"之间,隔着一个必须实际执行的检查动作**
   (那条通道:capacity / filter / self-reported-success / 现在再加一条 **注释语法**)。

## 沉淀

→ `skill/silent-capacity-gates/`(本轮追加一条:**"工具默认过滤 / 工具自报成功"也是一道静默闸** ——
`strings` 过滤掉非 ASCII、`--put` 印**本地**大小当成功、`grep` 在二进制里默认只认文本、
`find`+`ls` 的**大小与时间戳分辨不出同名不同内容**,四者都不报错,
且都会让人得到"找不到 = 不存在""推成功 = 推对了"的结论。判据:`--put` 之后**回读远端 md5**。)

→ 待建 `skill/two-trees-one-name/`(同名双份目录:改一棵、推另一棵)。
📌 **这一条的价值不在"记住",而在"记录过也照样再犯"** —— `LLM-062` 已写过一次,
隔一晚又踩。⇒ 沉淀必须是**无条件执行的机械步骤**,不能是注意事项:
① 改前先 `cd` 到工作树、用**绝对路径**编辑;② 推完 `md5sum` 回读远端逐行比对,
不相等就停;③ 涉及二进制产物(`.bit`/`.hwh`)时,**大小与时间戳都不算证据,只认 md5**。

→ 待建 `skill/evidence-chain-pinning/`(**证据链要钉到末端,不能只核一个产物**)。
一轮构建至少产出四类文件:位流、检查点、报告(`.rpt`)、汇总(`summary.txt`)。
**只核位流的 md5 就宣布"口径统一"是错的** —— 报告可能来自另一次构建(本轮实测:
位流是第 3 次、报告是第 1 次,**而两者数值确实不同**)。
判据三动作:① 找到与部署位流 **md5 相同**的那个产物(本轮:`impl_1/system_wrapper.bit`),
以它为锚;② 锚所在目录的**所有**报告与它同批(`mtime` 同分钟)才算同一次;
③ **说"两者相同"之前真的 `diff` 一次** —— 本轮那句「三次构建资源数完全相同」
就是没验过的断言,被 `diff` 当场否掉(WNS 0.354 vs 0.316、LUT 1789 vs 1790)。

---

<!--
填写提醒:
1. 当天记录,不要事后补 —— 补出来的没有"验证方式"和"纠错轨迹"
2. 失败也要记 —— 失败记录才是技能包的原料
3. 每条记录里必须能看到"我不同意 / 我改了 / 我验证了"
4. commit message 里加 [llm-XXX] 关联
-->
