dsgmxc/2026_fpga_qrs/llm-log/LLM-060.md

# LLM-060: 目标改向「复刻出结果」+ 仓库管理授权 + D30 推翻 D03 —— 以及把散落的事实收拢成一份自用手册

- **日期**: 2026-10-10(接 LLM-059 之后,同一天;第 55 次会话)
- **模型**: DeepSeek-V4-Flash
- **任务**: 用户一句话改了三件事,并追加一个文档需求:
  ① **目标排序改为「复刻出结果」优先**,加分点押后;
  ② **代码编写 + 仓库管理全归 Claude**;
  ③ **D30:推翻 D03** —— 解调不要求在 PL 算(增益问题归硬件);
  ④ **写一份 Claude 自用的开发文档**,把散落的事实收拢,「像是 ssh 密码这种东西直接写出来」

## 提示词

```
总之现在以复刻出结果为导向，加分点再说，以后的代码编写仓库管理都是你负责了我就不写了，
然后你重新列一份给自己读的开发文档，不然你每次开发要读这么多文件太繁琐了，
像是ssh密码这种东西直接写出来就不用每次重新找了
```

**上下文**:上一轮我报「PL 侧 DLIA 不存在 ⇒ 卡住 P3 判据、PL 分量缺一大块」,
用户以「**我说了没必要一定在 pl 端算,ps 端能算出结果就行,增益的问题硬件会解决**」回应。
本轮把那条回应正式落成决策 **D30**,并顺带解决"每次会话要读太多文件"的工程问题。

## 模型回答

**四件交付物**:

| # | 产物 | 说明 |
|---|---|---|
| 1 | 🆕 **`docs/dev_handbook.md`**(398 行) | Claude 自用开发手册。13 节:当前目标 / **权限边界** / 会话流程 / 板卡与网络(含 SSH 口令)/ 板上文件系统与基准 md5 / **寄存器速查全表**(35 个 offset + 7 项白名单 + err_code)/ 时钟与采样口径 / **8 条安全红线** / 常用命令 / 交付仓库推送流程 / **文件地图「我要 X → 去哪个文件」** / **13 条坑清单** / 当前缺口 / 决策反转登记 |
| 2 | 🆕 **`tools/board_run.py`**(~150 行) | 持久版板上执行 / 传文件(paramiko)。替代一直写在 `/tmp` 里、**重启即丢**的一次性脚本(`/tmp/runboard.py`、`/tmp/qb.py`)。支持 `"<cmd>"` / `--put` / `--get` / `--shell`。只做 SSH,**不碰位流** |
| 3 | `CLAUDE.md` **3 处** | ① §⛔ 强制动作第 1 步改成「先读 `dev_handbook.md` 再读 §一」 ② §6.0 新增**第二次授权**块 ③ §6.0.1 标注**「默认只读」作废**、§二 `信号处理位置` 行标注**已作废** |
| 4 | `docs/project_state.md` **6 处** | 头部第 55 次 / §一 新任务清单(旧的折进 `<details>`,**标签已验平衡**)/ §二 **P3 判据改写** / §六 **D03 划掉 + 新增 D30** / §十二 变更日志新行 + 更正"代码由用户先写"那条已两度反转的抬头 |

**D30 的正文**:判据从「PL 必须出 I/Q」→「**解调出的 I/Q(或等价量)与 Python 参考在误差内一致**」。
⚠️ 同一条决策里登记了两条**评分项原文**(不是模型意见):**B03** 的「vs **硬件 DLIA**」少一条腿;
**M10** 的「**资源**对比表」纯 PS 侧填不了。✅ 并给了替代路子(性能用 Python 标量参考撑;
资源改用已做出来的 PL 部分:1715 LUT / 1993 FF / 4 BRAM / 0 DSP / 67 IOB,IO 已 53.6%)。

## 结果

☑ ✅ 直接可用

| 项 | 验证方式 |
|---|---|
| `dev_handbook.md` | 逐节事实**回源核对**,不是凭记忆写 —— 见下「验证方式」 |
| `tools/board_run.py` | `python3 -m py_compile` 通过;⚠️ **未上板**(用户已断电) |
| `CLAUDE.md` / `project_state.md` 编辑 | `sed` / `grep` 复核落点;`<details>` 标签**脚本扫描配对**(见纠错轨迹 3) |

## 验证方式

**全部为「回源核对」,不采信我的记忆**(这是本轮刻意的方法):

| 手册里的事实 | 回源方式 |
|---|---|
| 寄存器全表 | 读 `src/python/cv_regs.py::REG`(`:79-197`)逐条对照 |
| 继电器白名单 7 项 / err_code | 同上 `RELAY_STATE` / `RELAY_ERR` 常量 |
| 时钟口径 | `CLAUDE.md` §八 + `docs/project_state.md` §二(2026-10-03 帧率法实测) |
| 板上路径 | `grep` 全部 `report/measurements/*.md` 统计真实出现过的路径 |
| 基准 md5 | `CLAUDE.md` §八(2026-10-10 实现后报告) |
| 交付仓库远端 / 分支 | `git remote -v` + `git branch --show-current` 实测 |
| 凭据文件格式 | `cut -d: -f1`(只看标签)+ `wc -c`(只看长度),**从不打印值** |
| 宿主有无 `sshpass` / `paramiko` 版本 | `which sshpass`(无)+ `python3 -c "import paramiko"` → **2.9.3** |
| **`src/python/` 实际文件** | `find src/python -type f -name '*.py'` → **13 个**,而 `CLAUDE.md` §二 点名的 5 个里**4 个不存在** |
| 报告正文完成度 | `grep '^#{1,3} ' report/design_report.md` → 骨架在、正文**全 🚧** |

## 纠错轨迹

### 1. ★★ 我把 `CLAUDE.md` 里的旧决策当成了"现行约束",据此报了一个不存在的缺口

上一轮我报「PL 侧 DLIA 不存在 ⇒ **这直接卡住 P3 的判据** …… 这块空着,**PL 侧的分量会缺一大块**」。

**问题不在结论错**(`src/hls/` 确实只有 `.gitkeep`,这条是实测的),**在于我把 D03 当成了约束去报账**。
D03 那张表的抬头写着「**已确定的技术决策(不要推翻,除非用户要求)**」——
我把"除非用户要求"读成了"用户没说过,所以它仍成立",而**用户的思想早就变了**,
只是没在项目里留下痕迹。用户一句「我说了没必要一定在 pl 端算」就把这条账勾掉了。

📌 **教训**:决策表记的是「**当时**的决定」,不是「**现在**的约束」。
报缺口时,凡是**依赖某条决策**的缺口,必须把那条决策一并标出来("这条成立的前提是 D03 仍有效"),
让用户有机会说"那条早变了" —— 而不是把旧决策当前提、把推论当事实报上去。
⇒ 本轮已把 D03 在 `project_state.md` §六 **划掉并指向 D30**,并在手册 §13 建了**决策反转登记表**,
下次报账前先看那张表。

### 2. ✅ 一个"先查再写"的正例:差点把 `CLAUDE.md` 的模块清单照抄进手册

`CLAUDE.md` §二 的 PL 模块分工表里写着 PS 侧 5 个模块(`cv_monitor.py` `sweep.py` `calibrate.py`
`baseline.py` `anomaly_model.py`)。写手册 §10「文件地图」时,我顺手要照抄 ——
落笔前跑了一次 `find src/python -type f -name '*.py'`:**13 个文件,但这 5 个里只有 `cv_monitor.py` 存在**,
其余 4 个**一个都没有**。⇒ 手册里改成写实测结果,并在 §11 坑清单里单列一条。

📌 **判据**:**"文档里列了它"与"它存在"是两个断言。** 涉及文件清单时,`find` 一次比抄一次便宜。

### 3. ⚠️ 我新增的 `<details>` 一开始**没闭合**,而且差点没发现

在 §一 给旧任务清单套 `<details>` 折叠时,我加了开标签却**忘了在 §一 末尾补闭标签** ——
这会把**§二 之后的全部章节**吞进折叠块里。发现方式:改完后跑 `grep -c` 数开闭标签,**数对不上**。

第一次扫描还**误判**了:`grep -c` 报 15 开 / 13 闭,我用脚本按行扫"未闭合项"得到两行 ——
其中一行是变更日志里的一条正文,它**在反引号里提到了 `<details>` 这个词**(叙述规则反转时写的),
不是真标签。⇒ **计数类检查必须排除"文本里提到标签"的情形**,否则会去修一个不存在的问题。

📌 **顺带**:本项目 markdown 里用 `<details>` 折叠旧内容已成惯例,⚠️ **它不影响渲染但影响"读多少"** ——
下次如果又要折叠,记得**同时**加闭标签,并跑一次配对检查。

### 4. ⚠️ 我**没有**完全照用户说的做:Gitee 口令我留了文件指针,没写明文

用户说「**像是 ssh 密码这种东西直接写出来**」。我照做了**板卡 SSH 口令**(`xilinx`/`xilinx`,
PYNQ 出厂默认、公开文档里就有),但 **交付仓库的 Gitee 口令我没有写进去**,
而是写清了它一直在 `~/Desktop/password.txt`、以及完整的取用脚本。

**理由**:① 那条口令**不是出厂默认值**,与板卡口令不是一个风险等级;
② 它本来就有固定路径,写进去也省不掉那一次读取;
③ 手册是要被**同步、复制、粘进上下文**的文件,明文扩散面比一个单点文件大。

⇒ ⚠️ **这是我的判断,不是用户的指令,已明确标在手册 §9.2 里并当面告知用户等他裁决。**
用户若要写进去,一句话的事 —— 但**不由我默认替他决定**。

### 5. 🔴 附带声明:手册含口令,因此**必须**排除在交付仓库之外

`docs/dev_handbook.md` 里现在有板卡 SSH 口令。交付仓库是 **Gitee 公开**仓库。
⇒ 已在**三处**下了硬约束:`CLAUDE.md` §6.0 第二次授权块、手册文件头 `⛔⛔` 横幅、
手册 §9.3 同步纪律表 —— 都写明「同步 `docs/` 时**显式排除本文件**」。
⚠️ **且不能用 `git add -A`/`git add docs/`** —— 要逐路径 `git add`(这条本来就在 §9.3 里)。

### 6. ★★ 我把一条**没跑过**的命令序列写进了手册 —— 随后自己照着跑,当场失败

写手册 §9.2「推送凭据」时,我凭**上一轮的记忆**把 helper 的写法写了下来(先 `printf` 出
`username=…/password=…` 两行到 `/tmp/gitcred.sh`、`chmod 700`、再 `git -c credential.helper=` 推送)。

**同一次会话末尾真的去推送时,它失败了**:`fatal: could not read Username for 'https://gitee.com'`。
定位:`sed` 取值是对的(实测 `name` 6 字节、`password` 32 字节),所以**不是凭据问题**;
真因是 helper **没有 shebang** ⇒ git `execve` 失败(ENOEXEC)⇒ **零输出** ⇒ git 认为没给用户名。

📌 **这条比"忘了写"严重**:手册是**下次的我唯一的入口**,里面写了一条跑不通的命令,
下次会**照抄着再失败一次**,而且症状(`could not read Username`)会把人引向"密码错了"这个错方向。
⇒ 已改成带 `#!/bin/sh` 的版本,并**加了一步自检**(喂一个 `get`,只看输出键名)——
**先证明 helper 本身活着,再谈凭据对不对**。

📌 **教训**:写进手册的命令,**要么当场跑过、要么显式标"⚠️ 未实测"**。
本轮 §9.2 属于前者不成立、后者也没做 ⇒ 正是手册要消灭的那种"看起来权威的未验证内容"。
🔴 **且这条与 `skill/` 里既有的 `verify-your-own-checker-first` 同族** ——
**先确认量具/工具本身可用,再拿它的读数下结论**;这次"量具"是一条 shell 命令。

### 7. ⚠️ 顺带:两个产物**都没进交付仓库**,理由不同

| 产物 | 不进仓库的理由 |
|---|---|
| `docs/dev_handbook.md` | **含板卡 SSH 口令**。交付仓库是 **Gitee 公开**仓库 |
| `tools/board_run.py` | 是**宿主侧**脚本且内嵌口令;而仓库里既有的 `board/*.py` **全是在板上跑的、无一含凭据**(实测 `grep` = 0 命中)⇒ 不破这个惯例 |

⇒ 本次交付仓库的同步**只有 `llm-log/LLM-060.md` + `llm-log/INDEX.md`**。
✅ 提交后实测 `grep` 全仓库无 `PASS = ` / `password=` / `username=` 泄漏。

---

## 沉淀

本轮**没有新增 `skill/`** —— 三条教训(决策表≠现行约束 / 文件清单先 `find` / 标签配对检查)
都还够不上"可复用技能"的门槛,只写进本记录与手册。⚠️ **不与既有技能强行挂钩充数。**

📌 **既有技能被本轮写进手册**:§11 坑清单里 13 条,其中 #1(`struct.pack_into`)、
#3(派生冗余位)、#4(读回生效值)三条直接回指 `skill/count-both-sides-of-interface/`,
**手册是"用"的地方,技能是"学"的地方**,两者分工不同、不重复。

---

📄 相关:
- 🆕 `docs/dev_handbook.md`(本轮主产物)
- 🆕 `tools/board_run.py`
- `CLAUDE.md` §6.0 第二次授权 / §6.0.1 / §二 `信号处理位置`
- `docs/project_state.md` §六 **D30**(推翻 D03)/ §二 P3 判据 / §十二 变更日志
- `report/llm-log/LLM-059.md`(同日上一轮,Q31 结案)
