dsgmxc/2026_fpga_qrs/docs/display_subsystem.md

# 显示子系统设计规格

> **建立:2026-10-02**
> **状态:架构已定,两侧代码均已写完(2026-10-02)。本文件是显示子系统的设计输入。**
> **PL 侧**(第 30/31 次):RTL 已写、仿真已跑、位流已生成;**2026-10-03 起已上板** —— 见 §0.1。
> **PS 侧**(第 32 次):`src/python/` 驱动层 + `src/c_ui/` LVGL 移植已落地;**2026-10-03 起已上板** —— 见 §8。
> **上游依据**:`docs/project_state.md` §六 决策 D22(修订)/ D24 / D25;
> 前序 STM32 系统交接文档 `ZYNQ项目移植与AI交接说明.md` §4 / §6.3.7 / §7 阶段 7。
>
> ⚠️ **本文件只写规格,不含代码。** 代码位置:PL 侧在
> `qrs.srcs/sources_1/new/`,PS 侧在 `src/python/`,界面进程在 `src/c_ui/`(见 §8.5)。
> 📌 §8.5 的 `src/c_ui/` 是**用户点名授权**由模型写的一次(2026-10-02),其余 RTL
> 仍按 `CLAUDE.md` §6.0 由用户实现。

---

## 0. 这次改了什么(一句话)

**显示架构从「PL 生成整屏」改为「PS 出画面 + PL 只负责扫描输出」。**

| 项 | 原方案(D22,2026-09-25) | **现方案(2026-10-02)** |
|---|---|---|
| 画面来源 | PL 实时算:每像素比较 `y == curve[x]` | PS 渲染进 DDR 帧缓存,PL 读出 |
| 帧缓存 | **无** | **双帧,RGB565,DDR** |
| 曲线缓存 | 唯一数据源 | **降级为 PL 硬件画线加速器** |
| 能显示什么 | 一条 C-V 曲线 | **任意画面**(页面/控件/中文/图形) |

**为什么改**:D22 的前提是「本项目要显示的就是一条 C-V 曲线」。该前提**被产品的实际界面推翻** ——
前序系统的 `ui_demo.c` 有 **5367 行**(6 个页面、LVGL 控件、中文字库、双指缩放、二维码页),
曲线缓存**在范畴上**承载不了(它只会画 `y = f(x)`)。

⚠️ **D22 的推理本身没有错**:"1024×600 RGB888 帧缓存 = 14.75 Mb > XC7Z020 全部 BRAM 4.9 Mb" 是事实。
错的是**从 BRAM 装不下推出"所以不要帧缓存"** —— **DDR 存在**。前序系统在只有 8 MB HyperRAM 的
STM32 上都做了双帧。**当时选曲线缓存的真实理由是回避 DDR/VDMA 复杂度,不是不能做。**

### 0.1 落地状态(2026-10-03 更新)

> 本表是**唯一**的状态口径 —— 正文各节标题上的标记若与本表冲突,以本表为准。
> 🆕 **2026-10-03 变化**:DDR 帧缓存通路打通 + PS 侧上板 ⇒ **本表再无"未上板"项**
> (仅剩 `lcd_vblank_ctrl` 的画面级撕裂检测、`lcd_curve_ram`/`lcd_draw` 未做)。
> 🆕 **同日口径更正**:全文 7 处「实测 41.6667 MHz」已按 §八 纪律清除(见 §4.2 / §6.6 / §8.5 / §9)。
> ⚠️ **本表"上板已验证"的范围**:均指**本轮实测通过**,且**均无自动化回归** —— 改动后需重测。
> 新增两项证据在下方「界面实测」与「触控实测」。
>
> 🆕 **2026-10-03 第 36 次追加**:① **触摸 X 偏移结案** —— \|δ\| ≤ 11 px,**不需要标定修正**
> (判据与走过的弯路见下方「『点按键左边才触发』的排查结论」);
> ② **画面横向平移无物理通路**(HSYNC 恒高 + DE 模式)已给出一手依据;
> ③ **上电自启动落地并端到端验证通过**(`board/qrs-ui.service`,断电重启见分晓 → 已见分晓,
> 且实测**不拖慢启动**,逐节点对照见下方「上电自启动」);
> ④ 🟡 上电那一下的漂移有**领先假设但未证实**(改像素时钟时屏没被按住 —— `lcd_bl`/`lcd_rst` 恒 1 硬连)。

> 🔴 **阻塞期根因(2026-10-03 已结案)**:`S_AXI_HP0` 全量 `DECERR` ⇒ 帧缓存全黑。
> 根因 = **`ARPROT[1]`(NS,非安全位)置 1**,`ARCACHE` 无关。修法 `assign m_axi_arprot = 3'h0;`。
> 📄 `report/measurements/20261003_hp0_decerr_rootcause_arprot.md`

| 模块 | 规格 | RTL | 仿真 | 综合/实现 | **上板** |
|---|---|---|---|---|---|
| `lcd_timing` | ✅ §6.1 | ✅ | ✅ 2 帧 PASS | ✅ | ✅ **上板已验证**(整屏图案经它扫描输出,用户目视三元素全对) |
| 7 个新寄存器 | ✅ §5.2 | ✅ | ⚠️ **仅语法过** | ✅ | ✅ **上板已验证**(`0x74/0x78/0x7C` 读到,`0x60/0x64` 切 src/fb_base 生效) |
| `lcd_fb_reader` | ✅ §6.2 | ✅ | ✅ **5 帧 1 228 800 px 0 错** | ✅ | ✅ **上板已验证**(拍数 99.9~100%,`axi_or_nz=1`,`px_or_nz=1`,画面正确) |
| `lcd_vblank_ctrl` | ✅ §6.3 | ✅ | ✅ **换址时序已验** | ✅ | ⚠️ **部分**:换址寄存器已通;**画面级撕裂检测未做** |
| BD 接线(HP0 64 bit) | ✅ §6.2b | — | — | ✅ validate 通过 | ✅ **上板已验证** |
| 位流 | — | — | — | ✅ **已生成** | ✅ **上板**:`0e4cb57c…`(板上 `/home/xilinx/qrs.bit` 已更新) |
| `i2c_master` / `gt911_ctrl` | ✅ §6.6 | ✅ | ✅ **i2c 4 场景 + gt911 18 项全过** | ✅ | ✅ **上板已验证**(21 组按下/抬起事件,坐标合理;见下方"触控实测") |
| 坐标快照锁存(§5.2) | ✅ §5.2 | ✅ | ⚠️ **仅语法过** | ✅ | ✅ **上板已验证**(`0x68→0x6C→0x70` 三读拼事件,与 UI 侧日志逐点一致) |
| `lcd_curve_ram` / `lcd_draw` | ✅ §6.4 | 🔴 未写(🟡 P5 后) | 🔴 | 🔴 | 🔴 |

**PS 侧(第 32 次新增,见 §8)**

| 模块 | 规格 | 代码 | **PC 上构建/自检** | **上板** |
|---|---|---|---|---|
| `src/python/` 驱动层(`cv_regs` / `cv_monitor` / `drivers/`) | ✅ §8.5 | ✅ | ✅ `py_compile` 全过 + 位域/对齐/测试图断言全过 | ✅ **上板已验证**(本轮全部读数与画图均由它完成) |
| `src/c_ui/`(LVGL 8.2 + `ui_demo.c` 原样) | ✅ §8.2 | ✅ | ✅ **PC 上 `make` exit 0,自有代码 0 warning** | ✅ **上板已验证**(板上首次 `make -j2` **1m52.7s exit 0**;界面渲染正确,见下方"界面实测") |
| FCLK0 固化(决策 F1 结案) | ✅ §8.5 | ✅ 写在 `main.py` | ⚠️ 语法过 | ✅ **上板复测**:`apply_fclk0()` → **50.0000 MHz** |

> ⚠️ **"上板已验证"的口径**:指**本轮实测通过**。除 `src/c_ui/` 外各条均无自动化回归,
> 改动后需重测。⚠️ 仍未打破的限制:**无 ILA 抓 AXI**(`ila_0` 只探 SPI 引脚且未进已实现的 BD)。

#### 界面实测(2026-10-03)

**方法:不看渲染日志,直接从 `/dev/mem` 把 DDR 帧缓存抠出来当截图。**
物理基址取自寄存器 `0x58 FB_BASE0`(实测 `0x38100000`,与 PS `pynq.allocate` 报的一致),
按 RGB565 小端解成 PNG。**这是独立于 UI 进程的第三个观测者。**

实测内容 —— 顶栏(`页 | 主控:未连接 | 偏压: 0.1V | 回路:C1SS | 系统就绪`)、
标题(`MOSFET 参数测试系统 / C-V / RG 参数测量终端`)、四张卡片
(**初始化 / 单点测量 / 一键测量 / 扫压测量**)。

⇒ 一次性证到了三件此前只是"PC 上编过"的事:
1. **LVGL 真的把像素写进了 DDR**(不是写去了别处);
2. **RGB565 字节序正确**(颜色合理,无 R/B 交换、无半字节错位);
3. **中文字库在 PYNQ 上渲染正常**(15088 点阵那套在 STM32 之外的平台上同样work)。

> 📌 `主控:未连接` 是**预期**的 —— `display_protocol` 是空实现,9 个 `DisplayProtocol_Request*`
> 一律返回 `false`。宁可显示失败也不假装成功(见 §8.4)。

#### 触控实测(2026-10-03)

**两套独立观测者,坐标逐点一致**:① 外部只读 `/dev/mem` 轮询 `0x68/0x6C/0x70`;
② `c_ui` 自己的 `[touch]` 日志。同一次会话的 21 组事件两边数值完全相同。

四角方向测试(对应 `main.py` 里那句「⚠️ 触摸的坐标轴是否要翻转」的待决问号):

| 按下的角 | 实测 (x, y) | 判定 |
|---|---|---|
| 左上 | (39, 28) | ✅ |
| 右上 | (1009, 25) | ✅ |
| 右下 | (1001, 583) | ✅ |
| 左下 | (19, 570) | ✅ |

⇒ **x 向右增、y 向下增,与屏幕一致 —— 不需要任何翻转/镜像。**
全日志坐标范围 x 19~1009 / y 13~583(面板 1024×600),四边各余 15~20 px 是手指按不到最边上,
**不是坐标被截断** —— `pynq_indev.c` 的越界计数从未触发。

**多点触控**:抓到 1 次 `点数 2`。PL 只导出 **2 个触点且不含 `track_id`** ⇒ 三指以上、
以及"哪根手指是哪根"的语义**与前序 STM32 版不同,不得当等价实现**(风险 D3 仍在)。

**已知但无害**:`err` 粘滞位在本轮为 1。它是**开机以来曾出错**,不是"此刻在错" ——
`gt911_ctrl.v:588` 在**任何** `S_ERR` 进入时置位,而 `S_ERR` 包含**器件地址 NACK**;
该设计带"器件地址自愈"(`:590-596`,连错 3 次换 0x5D/0x14 重试)。
⚠️ **但本轮未验到究竟是哪个触发点置的位**(没有寄存器暴露 `use_alt`/`err_cnt`),不写成结论。

#### 「点按键左边才触发」的排查结论(2026-10-03 第 36 次)

用户报告「画面整体稍微向右平移,但按键位置是对的,点按键左边才触发跳转」。
此症状由**两项合成**,而**两者的临床表现完全相同**,必须靠绝对参考才能分开:

```
δ_total = δ_display(扫描输出把画面整体右移) + δ_touch(触摸把坐标整体报大)
```

| 项 | 结论 | 依据 |
|---|---|---|
| `δ_display` | **恒为 0 —— 结构上不可能不为 0** | `lcd_timing.v` 输出级 `assign lcd_hs = 1'b1;`(HSYNC 恒高)+ DE 模式 ⇒ 屏**没有行同步脉冲可数**,唯一的列参考是 **DE 的上升沿**;源极驱动从 DE 拉高那刻起往移位寄存器灌像素 ⇒ **x=0 必然落在第 0 列**。这不是"测了没测到",是**没有物理通路** |
| `δ_touch` | **\|δ\| ≤ 11 px** | 见下 |
| 全链路缩放 | **零** | `gt911_ctrl.v` **不下载配置表**(只轮询 `0x814E`/`0x814F`),坐标取 `{rbuf[3][3:0], rbuf[2]}` 原样 12 位;`pynq_touch.c` / `pynq_indev.c` 零变换;`lv_indev.c:332` 只在 `rotated != 0` 时变换,当前 `rotated = 0` |

**判据(不依赖手指精度)**:首页两张大卡各 **453×156**、中间**只有 22 px 缝隙**
(左卡 x∈[48,501]、右卡 x∈[523,976])。按缝正中 x≈512:

| 现象 | 结论 |
|---|---|
| 两张卡都不进按下态 | **\|δ\| ≤ 11 px** ← **实测结果** |
| 右卡进按下态 | δ > +11 px(触摸报得偏右) |
| 左卡进按下态 | δ < −11 px(触摸报得偏左) |

⇒ **触摸不需要做任何标定修正。** 用户定性:「之前那个应该是个例外,先不管了」。

> 🔴 **为什么不用"点已知竖条中心再比坐标"那种方法** —— 这是本轮走过的弯路,记下来避免重犯:
> 5 根已知位置的竖条,让用户逐条点中心,反推 δ = 红 **+8.5** / 绿 +15.5 / 白 **+7.5** / 黄 +3.5 / 蓝 **+0.5**。
> **单调递减,看着像约 1.4% 的欠标定** —— 差点写进结论。
> **但同一根蓝条,上一轮量到 +10.5,这一轮 +0.5** ⇒ **手指瞄准的重复性就是 ±10 px**,
> 与要测的效应**同量级** ⇒ **这套量具没有分辨力,数字不能当结论用。**
> (绿色那条 y=285,其余四条 294~304 —— 它本身就是瞄歪的,连进拟合都不该。)
> 📌 **教训:给人做"测一下"的测试之前,先算清它能分辨多小的量。分辨力不够就换量具,不要解读数字。**
> 📄 `report/llm-log/LLM-037.md`

### 上电那一下的画面漂移(🟡 领先假设,未证实)

- **现象**:同一套显示通路,有时上电后画面整体偏移,有时正常;用户称「之前那个应该是个例外」。
- **领先假设**:`main.py` 的顺序是 `Overlay()` 加载位流 → `apply_fclk0()`;
  此时 **PL 已经在驱动 `lcd_clk` / DE**,把 FCLK0 从 27.78 跳到 50.000 等于给屏的时序参考抽一下,
  而 **HSYNC 恒高 ⇒ 屏没有第二根参考线可以重新锁相**。
- **反证(未消除)**:早先 `fbhold.py` 那次也在同序下调了 `apply_fclk0()`,当时目视**无漂** ⇒
  要么是随机滑移(滑多少取决于撞在帧里哪个位置),要么真因不是它。**两种都未排除。**
- **正解所需、但未做(属 RTL,归用户)**:`cv_sys.v:448-449`

  ```verilog
  assign lcd_bl  = 1'b1;
  assign lcd_rst = 1'b1;
  ```

  **背光与复位恒 1 硬连,没有寄存器** ⇒ 软件**没有任何办法**在改像素时钟前把屏按住。
  建议加寄存器位,让 `main.py` 能走「加载位流 → 按住屏 → `apply_fclk0` → 放开屏」。

### 上电自启动(2026-10-03 落地)

部署件:`board/qrs-ui.service`(装到板 `/etc/systemd/system/`,已 `enable`)。
三条约束写进了单元注释,**改之前必须先读**:

1. **`Restart=no` 是故意的** —— 自动重启 = 第二次加载位流 = 踩过的挂死路径(`lcd_fb_reader` 是活跃 AXI 主机)。
2. **解释器必须写全路径** `/usr/local/share/pynq-venv/bin/python3` ——
   `/home/xilinx/pynq` 只是**指向 venv 的软链**,`/usr/bin/python3` 能 import pynq
   **纯粹因为 SSH 的 cwd 恰好是 `/home/xilinx`**(`sys.path[0]` 撞上了),而 systemd 的 cwd 是 `/`。
3. **`XILINX_XRT` / `VIRTUAL_ENV` / `PATH` 必须显式给** —— systemd **不读** `/etc/profile.d/`
   (实测 `bash -lc` 也不设这三个);少 `XILINX_XRT` 会报 `RuntimeError: No Devices Found`。

✅ **2026-10-03 端到端验证通过**(用户断电重启):`Main PID 546 main.py` + 子进程 `630 c_ui`,
屏上正常出界面,`apply_fclk0()` 后 `clk_axi` = **50.000 MHz**(IO PLL 1000 / DIV0 20)。

**「开机是不是变慢了」—— 用单调时钟对照,答案是"没有"。**
`journalctl -b N -o short-monotonic`(板子 RTC 会跳,单调时间不受影响):

| 节点 | boot -1(无自启动) | boot 0(有自启动) |
|---|---|---|
| Basic System | 13.93 s | **12.07 s** |
| Network is Online | 28.33 s | **25.18 s** |
| QRS 界面服务启动 | — | 25.37 s |
| sshd 可连 | 29.29 s | **26.39 s** |
| Multi-User System | 30.81 s | **28.30 s** |
| Jupyter started | 41.54 s | 44.20 s |

⇒ 除 jupyter 外**每个节点都早了 2~3 s**;`Network Online → sshd` 间隔两次都是 **0.96 s**
(界面服务没把 sshd 往后挤)。`qrs-ui.service` **不出现在 `systemd-analyze blame` 里**,
也不在启动关键链上。

**启动真凶是原有的两个**(与本次改动无关):
`jupyter.service` **31.78 s**、`networking.service` **13.67 s** —— 后者是 DHCP 超时
(直连网线对端没有 DHCP 服务器,`/etc/network/interfaces.d/eth0` 里 `iface eth0 inet dhcp`
一直等不到租约)。

⚠️ **感知上的"慢"很可能是"开始盯屏"造成的**:界面服务 25.4 s 才起,LVGL 首帧再晚几秒
⇒ 上电后**屏大约 28~30 s 是空的**。以前没人等屏,现在等了。

🟡 **两条可选优化(未做)**:
1. **去掉 `After=network.target` / `Wants=network.target`** —— `main.py` 不碰网络,
   `network.target` 却要等 `networking.service` 那 13.7 s DHCP 走完(界面服务 25.37 s
   紧跟在 Network Online 25.18 s 之后,就是被它压住的)。预计界面**提前 ~13 s** 出。需再上电验证。
2. **治根**:把 `eth0` 的 dhcp 换掉或缩短超时 ⇒ **整个启动省 13.7 s**,
   sshd / jupyter 一起受益。属于板子系统配置,归用户改。

**已实测的读数**(实现后,**仅当前 BD 口径** —— 测量主链尚未进 BD):

| | 第 30 次(显示通路) | **第 31 次(含触摸,全量非增量)** |
|---|---|---|
| LUT | 830(1.56%) | **1133(2.13%)** |
| FF | 995 | **1380(1.30%)** |
| BRAM / DSP | **1**(乒乓行缓冲)/ 0 | **1** / **0** |
| IOB | 30(24%) | **34(27.20%)= 30 LCD + 4 触摸** |
| WNS | +12.985 ns | **+12.746 ns**(TNS 0.000 / 失败端点 0 / 3525 端点) |
| DRC | 0 error | **0 Error / 0 Critical Warning**(⚠️ 21 Warning,见下) |

> ⚠️ **第 31 次 DRC 那 21 条 Warning**(如实列):`REQP-1839 RAMB36 async control check` × **20**
> 落在乒乓行缓冲那个 RAMB36 上,`CHECK-3` × 1 是它触到规则上限连带产生的。
> **未逐条分析**,记为待办 —— 不阻塞出位流。

🔴 **本子系统唯一没有任何证据的一步是"上板"** —— 而风险 **D1(cache 一致性)**、
`arcache`/`arprot` 取值、16 次串行突发的真实带宽、**I2C 外部上拉是否真的存在**,
**四项都只有上板才能验**。详见 `report/llm-log/LLM-031.md` 与 `LLM-032.md`。

🔴 **PS 侧另有四项同样只有上板才能验**(第 32 次,详见 `report/llm-log/LLM-033.md`):

| # | 待验 | 不通过的后果 | 备选 |
|---|---|---|---|
| **R1** | `CONFIG_STRICT_DEVMEM` 是否开着 | 开着则 `/dev/mem` **不能映射普通 RAM**,`c_ui` 起不来 | `iomem=relaxed` / `/dev/dma_heap/system` + `DMA_BUF_IOCTL_SYNC` / 降级到 Python 侧 numpy 绘制 |
| **R2** | 非缓存映射下整屏 1.2 MB 同步的真实耗时(**只有估算**) | 首帧可能吃掉 17 ms 帧预算一大半 ⇒ 帧率不够 | PL 加矩形拷贝器,或换 dma-heap(映射可缓存) |
| — | `ui_demo.c` 在 PYNQ 上的**运行时行为**(编得过 ≠ 跑得起来) | 首页画不出来 | 按 `README.md §9` 逐条二分 |
| — | 板上 **gcc/make 存在**、A9 上 LVGL 编译耗时 | 编不了 | `apt install build-essential` |

> ⚠️ **两条工程事实(2026-10-02 实测,不是文档推断)**
> - 🔴 **工程里唯一启用的引脚约束文件是 `led.xdc`,不是 `io.xdc`。**
>   `io.xdc` 的 `IS_ENABLED = 0` —— 写进去的约束**一个字都不生效**。
>   第 31 次把 4 条触摸约束先写进 `io.xdc`,综合实现全程没 Parsing 过它,
>   位流直接在 `[DRC NSTD-1]`/`[DRC UCIO-1]` 处炸掉。**LCD + 触摸的球号都在 `led.xdc`。**
> - 🔴 **`qrs.xpr` 里曾有一条 `<MsgRule>` 把 `CRITICAL WARNING` 整体降级成 `INFO`。**
>   后果:**"0 critical warnings"这种结论在本工程里默认不可信**。已 `reset_msg_config` 清除;
>   **引用本工程任何历史报告里的关键警告计数前,先确认那条规则不在。**

---

## 1. 硬件事实(不可协商)

| 项 | 值 | 来源 |
|---|---|---|
| 屏 | **ATK-MD0700R-1024600-IPS**,1024×600,24-bit 并行 RGB,**DE 模式** | 清单 §2.3b |
| LCD 信号 | **30 根**,物理接在 **PL BANK34/35** | 🔴 **`qrs.srcs/constrs_1/new/led.xdc`**(**不是** `io.xdc`,见下表脚注) |
| 触摸 | **GT911**,4 根 `touch_scl/sda/int/rst_n`,同样只在 PL | 同上 |
| PS MIO | **对 LCD 与触摸零连接** | ⇒ 时序发生器**只能**在 PL |

⇒ **"PL 出时序"不是设计偏好,是硬件接线决定的。**

**引脚使用(37 根,全部在 `led.xdc`)**

```
lcd_rgb[23:0]  24 根    W18 W19 R16 R17 W20 V20 P18 N17 V17 V18 T17 R18
                        Y18 Y19 P15 P16 V16 W16 T14 T15 Y17 Y16 T16 U17
lcd_hs  N18     lcd_vs  T20     lcd_de  U20
lcd_clk P19     lcd_bl  M20     lcd_rst L17

touch_scl R19   touch_sda P20   touch_int U19   touch_rst_n M19
```

> 🔴 **脚注:`led.xdc` 才是活的那一个(2026-10-02 实测)**
>
> 工程里有两个引脚约束文件,但 **`io.xdc` 的 `IS_ENABLED = 0`** ——
> 综合实现全程**不 Parsing 它**,写进去的约束**一个字都不生效**。
> **真正生效的是同目录的 `led.xdc`**(`IS_ENABLED=1`)。
>
> - ⚠️ `io.xdc` 里那 30 行 `lcd_*` 是 `led.xdc` 的**重复副本**;
>   上半段 `clk_in1`/`rst_n`/`dac_*`/`adc_*`/`clk_65m` 是**旧顶层 `qrs.v` 的遗留**
>   (这些端口在 `system_wrapper` 里根本不存在)。
> - 🔴 **教训**:第 31 次把 4 条触摸约束写进 `io.xdc`,综合实现照过,
>   位流在 `write_bitstream` 的 DRC 处才炸:
>   `[DRC NSTD-1]` + `[DRC UCIO-1] Problem ports: touch_scl, touch_sda, touch_int, touch_rst_n`。
>   **"约束文件在工程里" ≠ "约束生效了"** —— 要看 `runme.log` 里到底 Parsing 了哪几个 xdc。
> - 📌 `io.xdc` 的清理(删除 or 清空)**未执行**,属工程布局调整,留给用户决定。
>
> ⚠️ **触摸球号出处**:厂商例程 `28_top_lcd_touch` 的 `top_lcd_touch.xdc`(#LCD TOUCH 段),
> **不是**从原理图查的。⚠️ 该厂商文件里**没有 `PULLUP` 属性**而其设计能跑通
> ⇒ **推断**触摸排线上已有**外部上拉**(**未实测**);本工程同样不加 PULLUP
> (加了只会把"外部上拉缺失"这个硬件问题掩盖成"时好时坏")。
> **上板若 I2C 完全无响应,第一件事是量 SCL/SDA 静态电平。**

---

## 2. 架构与数据通路

```
┌───────────────── PS(Linux / PYNQ)─────────────────┐
│  LVGL 渲染 ──► 后台帧缓存(DDR)                     │
│  写 LCD_SWAP ────────────────┐                     │
│  读 TOUCH_* ◄──────────┐     │                     │
└────────────────────────┼─────┼─────────────────────┘
                         │     │ AXI-Lite
┌────────────────────────┼─────▼─────────────────────┐
│ PL                     │  cv_axi_lite_slave        │
│  gt911_ctrl ◄─ i2c_master ◄── GT911                  │
│  lcd_vblank_ctrl ──► 前台索引                        │
│                        │                             │
│  lcd_fb_reader ──AXI3 read──► DDR(帧缓存)            │
│         │ 行数据                                     │
│         ▼                                            │
│  ping-pong 行缓冲(2 × 2 KB)                         │
│         │                                            │
│  lcd_timing ──► lcd_hs/vs/de/clk + px_x/px_y         │
│         │                                            │
│  RGB565 → RGB888 展开 ──► lcd_rgb[23:0]              │
└──────────────────────────────────────────────────────┘
```

**关键点**

1. **PS 画帧缓存 = CPU 直接写 DDR**,不需要 DMA 写通道。
2. **PL 侧只有「读」这一个方向的 AXI 主机** ⇒ 是单向顺序读,AXI 主机逻辑最简形态。
3. **换址只发生在 VBlank** —— 由 `lcd_vblank_ctrl` 保证,PS 无法在扫描中途改前台。

---

## 3. 帧缓存布局与格式

### 3.1 格式:RGB565

| 理由 | 说明 |
|---|---|
| 与 LVGL 天然一致 | `lv_conf.h` 实测 `LV_COLOR_DEPTH = 16` ⇒ `lv_color_t` 就是 16 bit,**前序 UI 全部按 16 bit 写** |
| 带宽减半 | 100 MB/s(RGB565)vs 150 MB/s(RGB888) |
| 引脚不用动 | PL 输出端把 RGB565 **展开**成 24 bit 送 `lcd_rgb[23:0]`(每色 MSB 对齐,低位补 0) |

> ⚠️ **与清单 §2.3b 的「24-bit 并行 RGB」不冲突**:那是**物理接口位宽**,本行是**帧缓存存储格式**。二者独立。

### 3.2 尺寸与对齐

| 项 | 值 |
|---|---|
| 一帧 | 1024 × 600 × 2 = **1 228 800 B**(1.17 MiB) |
| 双帧 | **2 457 600 B**(2.34 MiB) |
| 对齐 | **64 KB**(`LCD_FRAME_BUFFER_ALIGNMENT = 0x10000`) |
| 单槽 | `((1228800 + 65535) & ~65535)` = **1 245 184 B** |

### 3.3 地址由 PS 分配,不写死

`LCD_FB_BASE0` / `LCD_FB_BASE1` 是**寄存器**,PS 分配好内存后写入物理地址。
⇒ PL 侧**不得**把帧缓存地址做成编译期常量。

> 📌 前序系统的地址是写死的(`0x70000000` / +64 KB),因为那是 STM32 的固定 HyperRAM 映射。
> **Zynq 上不该照搬** —— DDR 由 Linux 管理,写死地址会与内核分配冲突。

---

## 4. 时序与带宽预算

### 4.1 时序(与清单 §2.3b 一致,不变)

| 参数 | 值 |
|---|---|
| PCLK | **50 MHz**(屏窗口 40.8 ~ 67.2 MHz) |
| 行 | 20 + 140 + 1024 + 160 = **1344** DCLK ⇒ 行周期 **26.88 µs** |
| 帧 | 3 + 20 + 600 + 12 = **635** 行 ⇒ 帧周期 **17.069 ms** |
| 刷新率 | **58.59 Hz** |
| 消隐 | 行消隐 **320 DCLK = 6.4 µs**(hblank) |

> ⚠️ **PCLK = 50 MHz 是本设计取的值**,不是厂商值。厂商例程与前序系统用 **45 MHz**。
> 两者都在屏的允许窗口内,且 50 MHz 是本工程 `clk_wiz` 的现成输出、**彩条已在该频率上点亮过**。
> ⇒ 保持 50 MHz 不变,但**报告里必须写明这是我们的取值**。

### 4.2 带宽

| 项 | 值 |
|---|---|
| 像素率 | 50 Mpx/s |
| **DDR 读带宽(必需)** | 50 M × 2 B = **100 MB/s** |
| 一行 | 1024 × 2 = **2048 B** |
| 行突发 | 2048 B / 8 B = **256 拍**(64-bit) |

**AXI 侧余量核算**

| clk_axi | 64-bit 峰值 | 100 MB/s 占比 |
|---|---|---|
| **设计值 50 MHz / 真值 50.000 MHz**(IO PLL 1000 / DIV0 20) | 400 MB/s | **25%** |

> 🔴 **口径已更正(2026-10-03)**:本节曾按「实测 41.6667 MHz / 333 MB/s / 30%」计算 ——
> **该值已被推翻**。41.6667 是 PYNQ 按**假定的** IO PLL 1500 做的除法(`1500/6/6`),
> **从来不是任何仪表的读数**。2026-10-03 用时基独立实测(帧率法)得
> **IO PLL = 1000 MHz、`apply_fclk0()` 后 FCLK0 = 50.000 MHz**。
> 证据:`report/measurements/20261003_fclk0_real_measured.md`。
>
> ⚠️ **但有一个真实的前置条件**(不能省):板上 `BOOT.BIN` 把 FCLK0 留在 **27.78 MHz**,
> 且 `Overlay()` 会把 `FPGA0_CLK_CTRL` **整个复位**回该值 ⇒ **50 MHz 只在 `main.py`
> 调过 `apply_fclk0()` 之后成立**。在那之前 PL 跑在 27.78 MHz(低于面板窗口下限)。
> ⇒ 本节的 25% 是**稳态口径**;开机头几百拍不适用(表现为"上电闪一下")。
>
> 25% 占用**可接受**,但 DDR 还要承受 PS 侧 CPU 写帧缓存的流量 ⇒ 见 §9 风险。

### 4.3 行缓冲(ping-pong)

```
BRAM18 × 2(≈ 1 个 BRAM36):256 深 × 64 bit = 2048 B,两块轮流
```

**取数时序必须是"边扫边取",不能等消隐期**

| 做法 | 可用时间 | 256 拍 @50 MHz = **5.12 µs** |
|---|---|---|
| ❌ 只在行消隐取 | 6.4 µs | 余量 **25%** —— 一有 DDR 争用就欠载 |
| ✅ **在上一行有效扫描期内取下一行** | **20.48 µs** | 余量 **~4×** |

⇒ **`lcd_fb_reader` 必须在行 N 扫描期间发起行 N+1 的突发**,这是设计约束不是优化。

---

## 5. 寄存器映射(新增 7 个)

沿用 `cv_axi_lite_slave.v` 现有译码(`ADDR_WIDTH = 7`,`a[6:2]` 5 位字索引 ⇒ **32 个**)。

### 5.1 占用核对(实测)

| | 数量 | 地址 |
|---|---|---|
| 已定义 | **22** | `0x00` ~ `0x54` |
| **本次新增** | **7** | `0x58` ~ `0x70` |
| 余量留给 P4 安全链 | 3 | `0x74` / `0x78` / `0x7C` |
| **合计** | **32** | 满 |

### 5.2 新增寄存器

| 偏移 | 名称 | R/W | 位域 | 说明 |
|---|---|---|---|---|
| `0x58` | `LCD_FB_BASE0` | RW | `[31:0]` | 帧缓存 0 物理基址,由 **PS 分配后写入** |
| `0x5C` | `LCD_FB_BASE1` | RW | `[31:0]` | 帧缓存 1 物理基址 |
| `0x60` | `LCD_SWAP` | RW | 写 `[0]`目标索引;读 `[0]`当前前台 `[1]`pending | 写 ⇒ **下一 VBlank 生效** |
| `0x64` | `LCD_FB_STATUS` | RO | `[0]`front `[10:2]`vblank_cnt `[18:11]`swap_cnt `[19]`underrun `[20]`axi_err | 诊断 |
| `0x68` | `TOUCH_STATUS` | RO | `[2:0]`触点数 `[3]`pen_down `[4]`err `[15:8]`seq | **★ 一次触摸事件的提交点** —— PS **必须最先读它** |
| `0x6C` | `TOUCH_PT0` | RO | `[11:0]`x `[27:16]`y | 触点 0(**读的是快照,非直连上报字**) |
| `0x70` | `TOUCH_PT1` | RO | `[11:0]`x `[27:16]`y | 触点 1(同上) |

> 🔴 **★ `0x68` → `0x6C` → `0x70` 的读序是硬前提(2026-10-02 第 31 次定,不可调换)**
>
> PS 要读满 3 个寄存器才拼得出一次触摸事件,而 `gt911_ctrl` 是**自由运行**的 ——
> 来一帧就刷新上报字。三次读之间若跨过帧边界,就会读出
> "**状态说 1 个点、坐标却是下一帧的**"这种**撕裂**。
> 撕裂**不报错**,只让界面**偶尔跳一下** —— 是最难归因的那类 bug。
>
> **做法**:从机把"**读 `0x68`**"当**提交点**,那一拍把 `pt0`/`pt1` 一并锁进 hold
> (`cv_axi_lite_slave.v` 的 `tch_pt0_hold`/`tch_pt1_hold`);`0x6C`/`0x70` 读的是**快照**。
> **代价:PS 端读序固定 `0x68` 在先。** 先读坐标再读状态 → 拿到的是**上一拍的快照**,
> 对不上刚读到的 `seq`。
>
> ⚠️ 本条**只在仿真层面成立**(语法过 + 逻辑走查),**未上板**。
>
> 📌 附:`seq` 的语义**(2026-10-02 第 31 次定案)** —— 由 `gt911_ctrl` 持有,
> **每产生一个新坐标帧递增一次**,不是"读一次递增一次"
> (第 29 次曾记为"待决",现按**控制器持有**落地)。
> **证据**:`gt911_ctrl` 临时 TB 实测 —— 连读两次、第二次状态 `0x00` 时
> `seq` **不递增**;来新帧(`0x80`/`0x81`)才 `seq→2`、`→3`。
> PS 判新旧的方式:比较两次读到的 `seq` 是否不同。

**预留(P4 安全链,本次不实现)**

| 偏移 | 名称 | 用途 |
|---|---|---|
| `0x74` | `WATCHDOG_KICK` | PS 心跳 |
| `0x78` | `FAULT_LATCH` | 故障锁存 |
| `0x7C` | `SAFETY_STATE` | 安全状态 |

### 5.3 ⚠️ 两条约束

1. **`LCD_SWAP` 读回的是"已生效"值,不是"已请求"值** —— 请求与生效必须分开,
   否则 PS 会在换址尚未发生时就宣称切换完成。同一原则适用于将来的 `RELAY_REQUEST/APPLIED`。
2. **地址已满**。若后续还需要寄存器,**必须把 `C_S_AXI_ADDR_WIDTH` 从 7 改成 8**
   (64 个寄存器)。⚠️ 该改动会动到已跑通的 BD:`module_ref` 的 `.xci` 是**端口边界快照**,
   改参数后**必须 Refresh Module Reference**。**本次不动。**

### 5.4 触摸为什么只用 2 点

前序 `ui_demo.c` 的交互只有:单击、沿曲线拖动、**双指缩放**、双击。
⇒ **≤ 2 点足够**。GT911 支持 5 点,但寄存器位置不够,且 UI 用不上。

---

## 6. PL 模块接口规格

### 6.1 `lcd_timing.v`(保留,职责扩展)

| | |
|---|---|
| **输入** | `clk_lcd`(= `clk_axi`,**设计值 50 MHz / 真值 50.000 MHz**,IO PLL 1000 / DIV0 20)、`rst_n` |
| **输出(时序)** | `px_x[10:0]` `px_y[10:0]` `de_req` `de_act` `vblank` `line_start` `frame_start` `h_disp` `v_disp` |
| **输出(同步)** | `lcd_hs` `lcd_vs` |
| **【不】输出** | `lcd_de` `lcd_clk` `lcd_bl` `lcd_rst` `lcd_rgb` —— **输出级在 `cv_sys` 里五行 assign**,本模块只管时序 |
| **行为** | 计数式;`h_cnt` 0~1343,V `v_cnt` 0~634;`de_act` 仅在有效区为高 |
| **给下游** | `line_start` / `frame_start` / `vblank` 是 `lcd_fb_reader` 与 `lcd_vblank_ctrl` 的节拍源 |
| **验收** | ILA 量行周期 = 1344 clk、帧周期 = 635 行;`de_act` 高电平 1024×600 |

> 🔴 **★ 相位约定(改这一块前必须看懂,写错会静默偏移画面)**
>
> | 拍 | `req_c`(内部) | `de_req` | `px_x`/`px_y` | `de_act` | 像素源输出 |
> |---|---|---|---|---|---|
> | t | 高 | 低 | — | 低 | — |
> | t+1 | 低 | **高** | **✔ 此刻有效** | 低 | — |
> | t+2 | 低 | 低 | — | **高** | **✔ 与本拍对齐** |
>
> - 像素源**必须寄存输出**(`lcd_display` 是,行缓冲也是)。
>   组合逻辑的源会**整体左移 2 像素**。
> - `de_act` 是 `de_req` **再延一拍**,不是同拍。
> - 这三行是**逐级复刻厂商 `lcd_driver`** 得到的,不是重新设计的 —— 换时序件的目的是
>   加帧缓存通路,不是重定义面板节拍。见 `LLM-030`。
>
> ✅ **2026-10-02 已实现并 xsim 实测通过**(`PASS`):2 帧内 `de_req` = 1228800 拍
> (= 2×1024×600)、坐标序列错误 0、`de_act` 相位错误 0、`line_start` = 1200、
> 行周期 1344 clk、帧周期 635 行、末行为 y=599。
> ⚠️ **这是仿真,不是上板** —— ILA 那一条验收判据仍未做。
>
> 🐛 同轮仿真抓到一个真 bug:取数窗上界误用 `H_ACT_END`(1184)而非 `H_REQ_END`(1182),
> 导致**每行多发 2 个像素**(`px_x` 跑到 1025)。已修,并在代码里留了注释钉住。

> 🔑 **时钟域(原遗留问题已消解)**:`clk_lcd` **直接取 `clk_axi`**。
> 两域同频 ⇒ 行缓冲、曲线缓存**都不需要 `cdc_sync`**,不需要双口 BRAM 独立写时钟。
> **不要另起 FCLK_CLK1** —— 那会凭空引入一个真实的跨时钟域。

### 6.2 `lcd_fb_reader.v`(🆕 新增,本子系统核心)

> ✅ **已实现**(2026-10-02)。`qrs.srcs/sources_1/new/lcd_fb_reader.v` 约 250 行。
> 仿真:xsim,4 帧 / **1,228,800 像素逐点核对,0 错误**,`underrun=0`、`axi_err=0`、
> `ARLEN` 恒为 15。验证脚本本身**没进工程**(临时件在 `/tmp`,`sim/` 归用户)。

| | |
|---|---|
| **职责** | AXI **读**主机:从当前前台帧缓存取出一整行,写入 ping-pong 行缓冲 |
| **输入** | `clk`、`rst_n`、`fb_base[31:0]`(当前前台基址)、`frame_start`、`line_start`、`de_req`、`px_x` |
| **AXI3** | **只读**:`araddr[31:0]`、`arlen[3:0]`、`arsize`、`arburst`、`arvalid/arready`、`rdata[63:0]`、`rvalid/rready/rlast/rresp`。**无写通道** |
| **突发** | 每行 **16 次 × 16 拍**,64-bit ⇒ 128 B/次 × 16 = **2048 B/行**。**串行**(一次收满再发下次) |
| **输出** | `px_data[15:0]`(RGB565,寄存输出,与 `de_act` 同拍) |
| **行为** | 行 N 扫描期间发起行 N+1 的读(见 §4.3);`rready` 在 `S_DATA` 常开(顺序无重排,不需反压) |
| **异常** | `rresp != OKAY` 或行缓冲欠载 ⇒ 置粘滞 `axi_err` / `underrun`;**看门狗超时后回 `S_IDLE`,不得死等** |
| **验收** | ① 静态测试图(彩条/棋盘/渐变)上板图案正确;② `underrun` 长时间运行后仍为 0;③ ILA 抓一次行突发的 `arvalid/arready/rvalid` 握手 |

> 🔴 **协议必须是 AXI3,不是 AXI4**(2026-10-02 实测,不可推翻)
>
> Zynq-7000 的 **HP/GP 口就是 AXI3**。把 `M_AXI` 声明成 `PROTOCOL AXI4` 后 BD **直接拒绝连线**:
> ```
> ERROR: [BD 41-1285] The protocols of the interfaces '/cv_sys_0/M_AXI'(AXI4)
>        and '/processing_system7_0/S_AXI_HP0'(AXI3) are incompatible.
> ```
> 且 **AXI3 单次突发上限 16 拍**(AXI4 才放宽到 256)⇒ `MAX_BURST_LENGTH` 只能是 16、
> `ARLEN` 只有 4 位,"一行 256 拍"必须拆成 16 次突发。
>
> **备选方案(已否决)**:在 BD 里插一个 `axi_protocol_converter` 把 AXI4 转成 AXI3。
> 否决理由:HP 是**实时数据路径**,而它有**每行硬截止**(行消隐只有 6.14 µs,
> 取一行要在上一行扫描期内完成)。转换器会在这条路径上再引入**一级不确定延迟**,
> 且多一个不可控的 IP。**延迟可预测 > 少写几行代码。**
> 代价:状态机多一个 4 bit 突发计数 + 一个比较器,约十几 LUT。

> **为什么自写而不用 AXI VDMA**:PS 画帧缓存是 **CPU 直写 DDR** ⇒ VDMA 的**写通道用不上**,
> 而读通道要配上 `v_tc` 才能用。本设计需要与 `lcd_timing` **紧耦合**(行节拍、欠载处理),
> VDMA 的 FIFO 深度不可控。**且 AXI 突发读握手正是赛题「接口协议」考察点。**

### 6.3 `lcd_vblank_ctrl.v`(🆕 新增)

> ✅ **已实现**(2026-10-02)。`qrs.srcs/sources_1/new/lcd_vblank_ctrl.v` 约 120 行。
> 仿真已验证:换址请求被受理(`pending=1`)→ **下一个 `frame_start` 才生效**
> (`front` 翻转、`fb_base` 由 `0x1000_0000` 变 `0x1020_0000`)→ 换完之后像素**仍然全对**。

| | |
|---|---|
| **职责** | 保全帧完整性:换址只在 VBlank 发生 |
| **输入** | `clk`、`rst_n`、`frame_start`、`swap_req`/`swap_tgt`(来自 0x60 写)、`fb_base0/1`、`underrun`、`axi_err` |
| **输出** | `fb_base`(给 `lcd_fb_reader`)、`sts_lcd_status[31:0]` |
| **行为** | 收到 swap 请求 → 置 `pending` → **下一个 `frame_start`** 才把前台索引翻转、清 `pending` |
| **异常** | `underrun` / `axi_err` 只**透传**给状态字,本模块不改行为 —— 状态的事实源在 `lcd_fb_reader` |
| **验收** | ILA 同时抓 `lcd_vs` 与 `fb_base` 变化时刻,确认**只在 VBlank 内变化**;连续快速写 `LCD_SWAP` 不出现撕裂 |

> ⚠️ **同一拍到达的 `swap_req` 不会被吃掉**:`frame_start` 分支写在前面、`swap_req` 分支写在后面,
> 后者覆盖 ⇒ 恰好卡在消隐首拍的请求会**顺延到下一帧生效**,而不是被静默丢弃。
> 反过来写就会丢 —— 这是**分支顺序即语义**的一个实例。

### 6.2b BD 侧接线(2026-10-02 落地)

| 项 | 值 |
|---|---|
| 用哪个 AXI 口 | **PS7 `S_AXI_HP0`**(不是 GP0)。理由:HP 是**直连 DDR 的独立通路**,GP0 要经过 `axi_smc` 且位宽只有 32 bit |
| `PCW_USE_S_AXI_HP0` | `1`;`PCW_S_AXI_HP0_DATA_WIDTH = 64` |
| 数据宽度 | `M_AXI` 64 bit ⇒ 每行 16 次 × 16 拍 = 2048 B |
| 时钟 | `FCLK_CLK0` → `S_AXI_HP0_ACLK`。**与 `S_AXI` 同一个 `clk_axi`** ⇒ 无需 CDC |
| 复位 | `S_AXI_HP0_ARESETN` 由 Vivado 自动补默认连接(该端口在 PS7 v5.5 上**不作为独立引脚**暴露,`get_bd_pins` 查不到) |
| 地址段 | `/processing_system7_0/S_AXI_HP0/HP0_DDR_LOWOCM`(1 GB @ `0x0000_0000`)分给 `/cv_sys_0/M_AXI` |
| AXI-Lite 地址 | `/cv_sys_0/S_AXI/reg0` 仍在 `0x43C0_0000` / 4 KB(**未变**) |

> 🔴 **踩坑记录:改了 RTL 端口,BD 不会自动跟着变。**
> `update_module_reference` 在 Vivado 2025.2 上**返回码 1 且错误消息为空**(bat 模式下不可用)。
> 真正的缓存是 `qrs.gen/sources_1/bd/mref/<模块名>/component.xml` ——
> **它是上一次打开 BD 时生成的快照**,改了 RTL 后若不删,BD 会一直用旧端口表,
> 表现为"明明加了 `m_axi` 端口,`get_bd_pins` 却一个都查不到"(不报错,只是**静默用旧的**)。
> **正确做法:`rm -rf qrs.gen/sources_1/bd/mref/<模块名>`,再 `delete_bd_objs` + `create_bd_cell` 重建该单元。**

> 📌 前序系统这一段在 PS 侧做(`LCD_LTDC_SetFrameBufferVBlank(addr, 50ms)` 带超时兜底)。
> **搬到 PL 后更硬**:PS 无论如何都无法在扫描中途改前台 —— 这是把安全性从软件自律变成硬件保证。

### 6.4 `lcd_curve_ram.v` + `lcd_draw.v`(🔄 改定位)

| | |
|---|---|
| **新定位** | **PL 硬件画线加速器**,不再是唯一数据源 |
| **做什么** | 由 PL 把曲线点直接写进帧缓存,省掉 PS 逐点渲染 |
| **接口** | `lcd_curve_ram` 仍是 1024 × 10 bit;`lcd_draw` 从"实时描点生成整屏"改为"向帧缓存写点" |
| **优先级** | 🟡 **P5 之后再做**。它是**优化项**(对应评分表 20% 的性能与资源优化),不是通路必需 |
| **报告用途** | 保留 D22 原论证,作为 **B04 资源取舍** + **M10 优化前后对比**的素材:同一功能,PS 软件渲染 vs PL 硬件画线 |

> ⚠️ **本次不实现**。通路(§6.1~6.3)跑通后,曲线可以先由 PS 侧 LVGL 画 —— 与全功能复刻一致。

### 6.5 `char_rom.v`(❌ 可删)

中文字库由 PS 侧 LVGL 渲染(`ui_font_cn_20` / `ui_font_cn_28`,共 **15088 行**点阵)。
**PL 不需要字模 ROM。** 清单 §2.1b 原 R13 取消。

### 6.6 `i2c_master.v` + `gt911_ctrl.v`

✅ **2026-10-02 第 31 次已写完并进了位流**(xsim 两 TB 全过,**未上板**)。

| 模块 | 接口要点 |
|---|---|
| `i2c_master.v` | **字节级 op 接口**(`go` / `op[2:0]` / `tx_byte` / `rx_byte` / `ack_rx` / `busy` / `done` / `err`),**不是**"读一个寄存器"的高层接口 —— GT911 的事务形状不规整(写 2 字节地址 → 重启 → 读 N 字节),把 op 序列交给上层拼才可复用。含**时钟拉伸等待 + 超时自退**、**9 脉冲总线恢复**。参数 `CLK_FREQ_HZ` / `SCL_FREQ_HZ` / `STRETCH_TIMEOUT` |
| `gt911_ctrl.v` | 复位序列(**INT 拉高锁器件地址 `0x14`**)/ 16 位寄存器寻址 / 轮询 `0x814E` / 读 2 触点 / **两级错误容忍**(连错 3 → 总线恢复,连错 5 → 重走复位序列 + 地址自愈)。`touch_int` 是 **inout** |

> 🔴 **`touch_int` 是双向的,不能当纯输出**:GT911 用"**复位释放瞬间 INT 的电平**"
> 锁存 I2C 器件地址(高 → `0x14`,低 → `0x5D`)⇒ **主机在复位期间必须驱动它、之后必须释放**。
> 三个三态口(`scl`/`sda`/`int`)在 `cv_sys.v` 里**必须保持 `inout` 原样引出** ——
> 拆成 `o`/`oe`/`i` 会变成 3 个外部端口,而物理上各只有 1 个引脚,`io.xdc` 无法对同一引脚写三条约束。IOBUF 由综合器在顶层推断。

⚠️ **`i2c_master` 放在 `clk_axi` 域**:位速率由 `CLK_FREQ_HZ` 分频而来,没有非它不可的频点;
且上报字直连 AXI 从机寄存器,**同域 ⇒ 不需要 CDC**。

> 🔴 **本节原写「`clk_axi` 实测 41.6667 MHz ⇒ 所有毫秒慢 20%」—— 该前提已作废(2026-10-03)。**
> `apply_fclk0()` 之后 `clk_axi` 真值就是 **50.000 MHz**,与 `CLK_FREQ_HZ` 的假定一致 ⇒
> **稳态下没有缩放误差,IIC 的毫秒是真毫秒。**
> 唯一不成立的是**开机头几百拍**(`BOOT.BIN` 留在 27.78 MHz,`Overlay()` 又把
> `FPGA0_CLK_CTRL` 复位回该值)——那时 IIC 会慢 `50/27.78 ≈ 1.8×`。
> GT911 的复位/配置序列发生在 `apply_fclk0()` **之后**,故不受影响。

`gt911_ctrl` **必须带上 §7 的语义**,否则长按闪烁会复现。

---

## 7. GT911 触摸语义(🔴 前序踩出来的,必须照搬)

| 规则 | 说明 |
|---|---|
| **`status.bit7 = 0` 只表示「没有新坐标帧」,不等于松手** | bit7 在两帧之间会暂时为 0。**此时必须保持上一按压状态** |
| 只有 `bit7 = 1` 且触点数 = 0 的新帧,才是明确松手 | |
| 活动触摸轮询 | **10 ms** |
| 兜底轮询 | **100 ms** |
| 最近活动触摸保持窗口 | **150 ms** |
| 连续 3 次总线错误 | 执行 **I2C 恢复** |
| 连续 5 次错误 | **复位触摸控制器** |

> ⚠️ **若把"无新数据"直接映射成 release,会重现按钮闪烁、拖动中断、双指缩放不稳定。**
> IIC 地址 `0x14` 或 `0x5D`(取决于复位时 INT 电平)。

---

## 8. PS 侧移植策略

> ✅ **本节已落地(2026-10-02 第 32 次)** —— 代码在 `src/python/` 与 `src/c_ui/`,
> 规格即本节。⚠️ **PC 上编过、自检过,「未上板」** —— 见 §0.1。

### 8.1 原样搬的部件(实测确认零 STM32 HAL 依赖)

`ui_demo.c` 的 include 实测为:

```c
"ui_demo.h"  <stddef.h>  <stdint.h>  <math.h>  <stdlib.h>  <string.h>
"BSP/LCD/lcd_panel_config.h"   "BSP/LVGL/lv_port_indev.h"
"display_protocol.h"  "engineering_parameters.h"  "lvgl.h"  "sweep_interpolation.h"
```

| 部件 | 行数 | 落地情况 |
|---|---|---|
| `ui_demo.c` / `ui_demo.h` | **5367** | ✅ **一行未改** —— 靠 §8.5 的路径别名树解析它的前序 include |
| `ui_font_cn_28.c` / `ui_font_cn_20.c` | **15088** | ✅ drop-in |
| `sweep_interpolation.c` + `engineering_parameters.c` | 451 | ✅ drop-in |
| LVGL 8.2.0 本体 | — | ✅ vendor 原样(`src/c_ui/third_party/lvgl/`) |
| `display_protocol.h` | — | ✅ 原样;`.c` 由**空实现**顶替 —— 见 §8.5 |

⚠️ **`src/c_ui/ui/` 下 9 个文件与前序工程逐字节一致** —— `md5sum` 逐一核对 **+ `diff -q` 全量复核**。
证据表与可复现命令在 `src/c_ui/README.md §5`。**「原样搬」这句话是可辩护的,因为它可复现。**

> 🔴 ~~本次会话只做底层(PL 侧)。UI 具体怎么画,等用户单独说明后再动。~~ **本条已失效** ——
> 2026-10-02 第 32 次用户明确指示「**ps端帮我完成屏幕的界面初始化先**」,
> UI 已按「**直接上 LVGL C** + 最小闭环」落地。

### 8.2 LVGL 移植层(✅ 已落地)

| 文件 | 行数 | 职责 |
|---|---|---|
| `app/pynq_disp.c` | 308 | flush cb:画进**后台**帧缓冲 → 写 `LCD_SWAP` → 等生效。逻辑照搬前序 `lv_port_disp.c`(297 行),只把 `LCD_LTDC_SetFrameBufferVBlank()` 换成写 PL 寄存器 |
| `app/pynq_touch.c` | 222 | 触摸**生产者**:按 `0x68`→`0x6C`→`0x70` 读,处理 `bit7` 语义(§7) |
| `app/pynq_indev.c` | 143 | LVGL 输入驱动:把生产者缓存的结构体喂给 LVGL,**自身零寄存器读** |
| `app/pynq_regs.c` / `.h` | 179 / 139 | `/dev/mem` mmap + AXI 读写字 |
| `app/pynq_protocol_stub.c` | 168 | `DisplayProtocol_*` 空实现(见 §8.5) |
| `app/main.c` | 419 | 入口 + 主循环 —— **只做装配**,不含任何驱动逻辑 |

⚠️ **`pynq_touch.c` 与 `pynq_indev.c` 分成两个文件不是洁癖** —— 触摸由**两个时钟节奏**驱动:
生产者要 ~10 ms 采样一次、且要能承受总线错误;消费者必须与 LVGL 同频、且**绝不能阻塞**。
合成一个文件必然写成"在 `indev_read_cb` 里读寄存器",那会在 I2C 卡住时**把整个 UI 拖死**。

### 8.3 🔴 不要用 LVGL 自带的 fbdev 后端

LVGL 的 Linux fbdev 后端**直接写 `/dev/fb0`**,**不做双缓冲、不等 VBlank**。
直接用它 ⇒ 前序辛苦修掉的**撕裂 + 长按闪烁会全部回来**。

⇒ **必须用 §8.2 的自定义 flush cb**,参照前序 `lv_port_disp.c` 的
「换址 + 只同步无效区域 + 超时兜底 + 错误计数」。**已照此实现。**

⚠️ 连带一条前序没写下来的坑:**`direct_mode = 1` + `full_refresh = 0` 时必须做「矩形同步」** ——
LVGL 只重画失效区域,其余像素指望缓冲里还是上一帧;可**换址之后新后台是更早的那一帧**
⇒ 不把本次失效矩形从新前台补到新后台,界面会一块块"退回两帧前"。
**这个 bug 只在局部刷新时显形,极难归因**(实现见 `pynq_disp.c` 的 `sync_invalid_areas()`)。

### 8.4 🔴 Cache 一致性(头号坑)

PS 写完帧缓存后,PL 通过 AXI 读 DDR —— **可能读到 cache 里的旧数据**。
**表现**:画面偶尔不更新 / 花屏,**极难查**。

**本设计的处置:让这条路径上的写不走 cache。**

| 谁 | 做什么 | 为什么 |
|---|---|---|
| **Python**(`drivers/lcd.py`) | 用 `pynq.allocate` 从 **CMA** 分配两块 64 KB 对齐缓冲,**只分配、不写像素** | C 侧拿不到物理连续内存;C 需要的是**物理地址** |
| **C**(`c_ui`) | 用 `/dev/mem` mmap 这两块**物理地址**,LVGL 的重绘直接落在这段映射上 | ARM 上 `/dev/mem` 的 mmap 走 `ioremap`,映射属性为 **Device(非缓存)** ⇒ PL 读 DDR 直接看到 PS 的写 |
| **PL** | 照常读 | — |

⇒ **D1 在这条路径上不成立** —— 但这是**设计依据,不是实测结论**:
「非缓存」取决于内核的 `ioremap` 行为,**本板未验**。
若上板发现缓存依然存在,处置依次是:`DMA_BUF_IOCTL_SYNC` → 换 `/dev/dma_heap/system`。

⚠️ 因此 **§9 的 D1 在首轮上板时仍是必测项**,只是"预期会过"而不是"没法过"。

### 8.5 实际落地的结构(2026-10-02 第 32 次)

用户对本轮的要求是「**注意文件管理,最好每个模块有自己的基础驱动库别什么都堆到 main 里面
也尽量别混在一起**」,结构按这条要求分层:

```
src/python/                         ← PS 侧。main.py 是唯一的装配点
  cv_regs.py          186 行   寄存器地址 + 位域 + 面板参数 —— 【唯一事实源】
  cv_monitor.py       227 行   唯一 mmio 层(bindto / link_check / _read / _write)
  drivers/
    lcd.py            234 行   LcdPanel:双帧缓存分配·64 KB 对齐·写基址·切源
    touch.py          275 行   TouchPanel:0x68→0x6C→0x70 读序 + bit7 语义
    board.py          110 行   Overlay 加载 + FCLK0 固化
    ui_process.py     163 行   拉起/停止 C 界面进程,传参,收退出码
  main.py             160 行   【只装配】,无驱动逻辑
  tools/
    display_probe.py  271 行   显示自检:纯色 → 彩条 → 帧缓存渐变图 → 切源
    touch_probe.py    193 行   触屏自检:连读 N 次打印 seq/count/pen_down/x/y
```

```c
src/c_ui/                           ← 界面进程(独立可执行文件)
  third_party/lvgl/                 LVGL 8.2.0,vendor 原样
  port/BSP/…                        路径别名树(4 个头,262 行)
  ui/                               前序 9 个文件,逐字节一致
  app/                              本工程新写的 7 个文件 + Makefile + README
```

**四条关键设计判断**(都是取舍,不是照抄):

1. 🔑 **帧缓存必须由 Python 分配。** C 侧拿不到物理连续内存(`pynq.allocate` 走 CMA 是最可靠的路径),
   而 C 需要**物理地址**去 `/dev/mem` mmap。⇒ 分工只能是"Python 分配 + 传址,C 映射 + 写"。
   **这不是风格选择,是唯一路径。** ⚠️ 对齐:单槽 1,245,184 B,`pynq.allocate` 不保证 64 KB 对齐
   ⇒ 多分配再手动取对齐地址。
2. 🔑 **C 是独立进程,不是 Python 里的一个函数。** 直接回应"别混在一起":界面与测量编排边界最硬;
   将来接测量数据时,用 pipe/socket 替换前序的 UART7 协议层,**不污染 UI 代码**。
3. 🔑 **`ui_demo.c` 一行不改,靠 `-Iport` 路径别名树。** 让它编过有两条路 ——
   改它几行 include,或让 `port/BSP/LCD/lcd_panel_config.h` 顶上前序路径。
   **选后者** —— 改一行,"与前序工程逐字一致"这句话就再也说不出口,而那是报告里可辩护的资产。
   ⇒ `port/BSP/LCD/lcd_panel_config.h`(54 行)/ `port/BSP/TOUCH/lcd_touch.h`(118 行)/
   `port/BSP/LVGL/lv_port_disp.h`(55 行)/ `port/BSP/LVGL/lv_port_indev.h`(35 行)。
   📌 其中**只有 `lv_port_disp.h` 与前序有接口差异**(`Init` 收两个物理地址而非 LTDC 句柄),
   `lv_port_indev.h` 与前序**逐字相同**。
4. 🔴 **`err` 是粘滞位,不是实时故障信号。** `gt911_ctrl.v:588` 置位、**`:264` 只在复位/重配时清**
   ⇒ 语义是"**开机以来曾出错**"。若按实时故障处理,**一次上电噪声会让触摸永久失效**,
   且症状(按了没反应)会把排查引到外部上拉/底板上这些**无关方向**。
   ⇒ `pynq_touch.c` 只**报一次**然后照常读。

**`display_protocol` 的处置**(本轮不接通):`.c` 换成一个空实现,**9 个 `DisplayProtocol_Request*`
一律返回 `false`**。

> 🔴 **为什么不返回 `true`**:返回 `true` 会让状态栏谎称「指令发送完成」,
> `RequestSweep` 还会清 `g_sweep_inspection_ready` 并切页 —— 即**假装测量已启动**。
> 宁可显示失败也不假装成功。
>
> ⚠️ **预期现象**:点测量按钮时状态栏显示「UART7发送失败」。
> 这是**如实报告"指令没发出去"**,**不是触屏坏了** —— 触屏好不好看 `tools/touch_probe.py`。
> 页面之间的**导航**不走这一层(纯 LVGL),不受影响。

**FCLK0(决策 F1 结案)**:`Clocks.fclk0_mhz = 50` 固化进 `main.py`(具体做法见
`board.py apply_fclk0()`:设完**再覆盖 `DIV0 = round(1000/X)`**,因为 `Clocks` 假定 IO PLL = 1500)。

⚠️ **口径(2026-10-03 实测,已更正)**:`BOOT.BIN` 留 **27.78 MHz**,`Overlay()` 会把它复位回该值,
`F2` 因此规定**设定必须在 `Overlay()` 之后**;**`apply_fclk0()` 之后真值 = 50.000 MHz**。
⛔ **不得再写「41.6667 MHz(实测)」** —— 那是 PYNQ 按假定 IO PLL 做的除法,不是仪表读数。
📄 `report/measurements/20261003_fclk0_real_measured.md`

## 9. 风险

| # | 风险 | 说明 | 处置 |
|---|---|---|---|
| D1 | **Cache 一致性** | PS 写、PL 读,见 §8.4 | 用 `pynq.allocate`;首轮验证专测 |
| D2 | **LVGL 后端不做双缓冲** | 见 §8.3 | 不用现成后端,自定义 flush cb |
| D3 | **DDR 带宽争用** | 显示读 100 MB/s,与 PS CPU 写争用。⚠️ 原写"`clk_axi` 只有 41.6667 MHz"**已作废**,真值 50.000 MHz ⇒ AXI 峰值 400 MB/s、显示占 25% | 行缓冲 ping-pong + 提前取行;长时间跑 `underrun` 必须保持 0 |
| D4 | **换址撕裂** | 若在扫描中途换 `fb_base` | `lcd_vblank_ctrl` 硬件保证,PS 无法绕过 |
| D5 | **PCLK 取值与厂商不一致** | 我们 50 MHz,厂商/前作 45 MHz | 两者均在窗口内;文档写明来源,报告不混称 |
| D6 | **寄存器地址已满** | 32 个用尽 | 见 §5.3;再要加必须 `ADDR_WIDTH 7→8` |

---

## 10. 未决项

| # | 事项 | 影响 | 状态 |
|---|---|---|---|
| **F4** | 帧缓存分配到 DDR 的哪一段(CMA / `/dev/mem` 预留) | 决定 PS 侧代码与 cache 处理方式 | ⏸ 待定 |
| **F5** | 是否保留曲线缓存加速器 | 影响 PL 资源与 P5 后工作量 | ⏸ 待定(P5 后) |
| **F6** | UI 的具体画法 | 本次用户将单独说明 | ⏸ 待用户 |
| **F7** | `lcd_rst`(L17)的极性与时序 | 屏复位 | ⏸ 待核对模块手册 |

---

## 11. 与报告章节的对应

| 本文件章节 | 报告用途 |
|---|---|
| §0 改了什么 | **M10 优化过程** + **B09 决策记录**(含放弃原因) |
| §2 架构与数据通路 | **M08 设计原理与功能框图** + **M09 软硬件划分依据** |
| §4 带宽预算 | **B04 资源取舍论证** + **M10 优化前后对比** |
| §6.2 为什么自写 AXI 读主机 | **B06 设计判断依据** |
| §8.3 / §8.4 | **M12 技能包**候选(两类平台移植的共性陷阱) |

---

*创建:2026-10-02 · 本文件由 Claude 维护(非代码文档,`CLAUDE.md` §6.0)*
