dsgmxc/2026_fpga_qrs/llm-log/LLM-055.md

# LLM-055: 采样率统一 65 MSPS + 采集窗 4096 → 8192(三道静默闸)—— ★ 10 MHz 档"算术成立、物理不成立",最终删除

- **日期**: 2026-10-08(第 50 次会话,接 `LLM-054` 之后)
- **模型**: DeepSeek-V4-Flash
- **任务**: 用户指出界面上"**激励频率 × 采样率**"的组合里**存在数学上不成立的组合**,
  要求 (a) **采样率统一固定 65 MSPS、不再改**,(b) 激励档位定为 **10k / 100k / 1M / 10M**,
  (c) **发送复位时偏压置零**。
  经模型指出"该组合要求加长采集窗"后,用户选择 **「加长窗,保留四档」**,
  并**在 `CLAUDE.md` §6.0 的例外条款下明确授权模型直接改代码 + 上板测试**。
  末段用户判定 **10 MHz 输出不了**,要求删档并**转向整理环境 / 文档 / 测试结果 / 交付仓库**。

## 提示词

第 1 条(原文):
```
别再出现组合不合理了，以后采样统一用65mhz不更改，激励信号档位就是10k 100k 1m 10m四个，然后发送复位的时候偏压置零
```

第 2 条(模型就"加长窗 / 砍档位"给两案后,用户的选择):
```
加长窗,保留 10k/100k/1M/10M
```
> 📌 这条是关键分岔:模型给的取向是"**砍掉 10k/100k、只留高频档**"或"**加长窗、四档全保**"。
> 用户选后者 ⇒ **范围从"改 C 参数"扩大到"改 RTL + 重下位流 + 四处同步"**,
> 且必须重编、重烧、重测。方案的选择权在用户,**代价由模型如实报出**。

第 3 条(原文):
```
你直接修改，修改完上板测试
```
> ⚠️ **这是对 `CLAUDE.md` §6.0「代码由用户先写」的一次明确豁免** ——
> 用户逐字授权模型**改代码 + 编译 + 上板 + 跑验收**。
> 豁免范围仅限本次改动;**没有被推广成新默认**。

第 4 条(原文,本次会话最后一条):
```
10m删了吧，输出不了，其他都测过了改为整理环境关系统整理文档和代码以及测试结果更新交付仓库推送
```

## 模型回答

1. **先算,再改。** 唯一要求是 `L·f_e/f_s ∈ ℤ`;把 `f_e/f_s` 约到最简 `p/q`,
   取 `L = ⌊n/q⌋·q`。固定 65 MSPS 后四档的窗长是 **6500 / 7800 / 8190 / 8190**,
   最长 6500 > 旧缓冲 4096 ⇒ **"组合不合理"的算术根源在这里**。
2. **缓冲 4096 → 8192**(`adc_capture.v` 的 `BUF_DEPTH`/`BUF_AW`)+ 配套改掩码、上限、抽稀。
3. **解调参考表长度改为只跟 `L` 走**,与频率比脱钩(旧实现按 `f_s/f_e` 整数倍建表)。
4. **写规格文档** `docs/acquisition_demod.md`(该段唯一来源)+ 改写 `source_design_checklist.md` §3/§8、
   `CLAUDE.md` §八里所有陈旧口径(`clk_adc = 25 MHz`、`f_s = 20 MSPS`、`激励 1 MHz 固定`)。
5. **上板闭环**:源码上板 → 板上 `make` → 整板重启 → 探针实测 → 用户手点三档。

## 结果

☐ ✅ 直接可用   ☑ ⚠️ **部分可用**   ☐ ❌ 不可用

**可用**:三档激励的窗长在板上**逐位对上**(6500/1、7800/12、8190/126),
6 次采集零失败,掩码与缓冲深度实测坐实,RTL 层改动正确。
**打折扣**:四档方案是模型按用户指令做的,**10 MHz 那一档在模型交付时就是"物理上做不出来"的**——
见「纠错轨迹」第 1 条。

## 验证方式

| 层 | 手段 | 结论 |
|---|---|---|
| RTL | 常驻探针 `tools/adc_probe.py` **`attach` 模式**(不加载位流,避开"一周期一次 Overlay") | 掩码 `wr 0x94 0x1FFF` → 回读 `0x1FFF`;`GO→done` 时延在 DIV=65/130/255 上**排除 4096 假说**;四个频率码原值回读 |
| C 侧 | **用户手点触摸**(`0x68/0x6C/0x70` 在 fabric 里只读,PS 侧注入不了) | 三档解调日志 `窗长 6500/7800/8190 点(1/12/126 个激励周期)`,**六个数逐位一致** |
| 界面 | 板上二进制的字符串提取 + 触摸日志 | 有 `10kHz/100kHz/1MHz`、**无 `10MHz`**;10 MHz 选中后未做测量即切回 |
| 资源/时序 | Vivado 2025.2 实现后报告 | BRAM 2.5 → **4**(2.86%);WNS **+1.023 ns** / WHS **+0.067 ns** / 失败端点 **0/4976** |

📄 完整记录:`report/measurements/20261008_65msps_window_board_acceptance.md`;
原始证据 `report/measurements/artifacts/20261008_adc_window_probe.out`(`9c24a3b9…`)、
`artifacts/20261008_cui_4slot_window_taps.log`(`0164ff13…`)。

## 纠错轨迹

### 1. ★ 最重要的一次:**模型的"算术成立"掩盖了"物理不成立"**

用户第 1 条指令里给了 **10 MHz** 这一档,模型**照单全收**,
为它算出了完全合法的窗参数(`q = 13`、`L = 8190`、`m = 1260`),
并且**在文档里把它和另外三档并列写成一张"四档表"**。

**问题**:AD9833 的 MCLK 是**板载 25 MHz 晶振、焊死**(决策 D10)这条事实
**本次早就在模型的上下文里** —— 25 MHz MCLK 出 10 MHz ⇒ **只有 2.5 个 DAC 采样/周期**,
且 15 MHz 镜像离主频仅 5 MHz,低通滤不掉。**这是 DAC 采样定理层面的不可能,不是配置问题。**

- **模型错在哪**:把"**数字域能不能算**"当成了"**这一档能不能用**"。
  `L`、`m`、参考表全都算得对,于是这一档在表里看起来**和别的档一样正常**。
- **怎么发现的**:不是模型发现的 —— 是**用户上板选到 10 MHz 档,发现输出不了**,
  随即切回 1 MHz(日志:`[mc] 激励 → 10.000 MHz(0x80 = 0x6666666)` 紧跟
  `[mc] 激励 → 1.000 MHz(0x80 = 0xA3D70A)`,**中间没有任何测量**)。
- **改法**:删档,并在 `docs/acquisition_demod.md` §4.1 单独留一节写清"算术成立、物理不成立",
  附上"要 10 MHz 只能换 MCLK ≥ 100 MHz 的 DDS"这条出路。
  `pynq_protocol.c` 的抽稀表也同步删行,并注明"**stride 公式一个字都不用改** —— 它是由 `L`/`m` 现算的"。
- **遗留**:删档依据是**硬件算术 + 用户口头判定**,不是本次的仪表读数 ⇒ 记录里如实标注,
  没有把它写成"实测 10 MHz 无输出"。**不要为了把话说满而伪造一条实测。**

📌 **可复用教训**:给"频率/采样率"这类**跨数字域与模拟域**的参数建表时,
**必须先问一句"这套器件在物理上到不到得了这一格"**,再算数字。
**数字算得对,恰恰是最危险的状态** —— 它让后面所有审查看起来都没问题。

### 2. 三道"算得对、闸在中间"的静默关卡(同一个形状出现三次)

把缓冲从 4096 改到 8192,横跨 RTL / C / 界面三层,**每一层都有一道关卡,
失效形状完全相同:数字算得出来,被静默截断或拒绝,不产生任何错误。**

| # | 位置 | 不改的后果 |
|---|---|---|
| 1 | `cv_axi_lite_slave.v` 写掩码 `32'h0000_0FFF` | 写索引 ≥ 4096 被截成 `idx − 4096` ⇒ **读到另一个点的数据,不报错** |
| 2 | `adc_sample.c` `ADC_DEMOD_MAX_L = 256u` | `build_table()` **直接失败** ⇒ 报「窗长 6500 点,超出参考表上限 256」 |
| 3 | `ui_demo.c` `UI_WAVE_MAX_SAMPLES = 480` | 8192 点喂进波形图**静默截断到前 480 点** ⇒ 屏上"波形是平的" |

⚠️ **第 3 道不是"把上限调大"就完事** —— 波形图只有 480 像素宽,8192 点本来就画不下。
正解是 `pynq_protocol.c::adc_feed_point_waveform()` 改成两步:
**① 画 3 个周期(上限整窗)② 按 `ceil(显示点数/480)` 抽稀**。
**上板日志证明它是数据驱动的**:三档的"显示前 N 点"分别是 **6500 / 1950 / 195** ——
各不相同,写死任何一个常量都会让另外两行对不上。

📌 **教训**:"改一个容量"这类改动,**必须把该容量沿路经过的每一个`上限 / 掩码 / 截断`都找出来**。
它们的共同特征是**不报错**,所以只能靠**枚举**发现,不能靠"跑一遍看看报什么错"。

### 3. 陈旧常量在语料里的两次现形(都靠 grep,不是靠跑)

- `src/python/cv_regs.py::DDS_HZ_CHOICES` 里还留着**最初那套五档表**
  `(100k, 500k, 1M, 2M, 5M)` —— 与界面上的三档**完全不是一回事**。
  它不报错,只在有人从 Python 侧下激励时**悄悄下出一个不存在的档**。
- `tools/adc_probe.py` 的**位流身份判据**原写死 `== 0x0000000D`(旧位流的 `DIV=13`)。
  新位流的复位值是 `0x00000002` ⇒ 不改的话会**印出"疑似旧位流"的假结论**,
  而这条判据以前是拿来判"该不该相信后面的采集结果"的。

两条都是**改了实现、没改引用它的文档/工具**,属于同一类漂移。
📌 处置:改完实现后**主动 grep 旧数值**,而不是等它下次咬人。

### 4. 一次"我差点把自己的工具用错"的复核

`adc_probe.py` 把位流身份判据放在 **`init`**(刚 `Overlay()` 完、还没人写过 `0x88`)
而不是 **`attach`**。本次 `attach` 时读到的是 `0x88 = 0x0000FF02`
(`PH_OFF` 已被 `c_ui` 写成 `0xFF`)—— 若把判据放进 `attach`,
就会拿一个**被改过的值**去判"位流新旧",得到"版本不明"的假警报。
⇒ 复核后确认判据在 `init` 里,**不改**。记下来是因为这条约束很容易被后来人"顺手统一"掉。

### 5. 环境操作上的四次小翻车(都不影响结论,但都浪费了一轮)

| 现象 | 真实原因 |
|---|---|
| `sftp_put` 报 `FileNotFoundError`(8 个 C 文件) | 当前目录是工作区根,不是 `src/c_ui`,相对路径找不到 |
| 第一次后台重建**没有产出** `/tmp/build.log` | `setsid nohup bash -c "make …"` 根本没跑起来。单测 `sleep 30` 验证后台化本身可用后,**放弃后台化,改前台 `make -j2`**(设 10 min 超时)一次成功 |
| `systemctl cat qrs-ui` **挂住不返回** | pager 在 pty 里等按键。改用 `cat /etc/systemd/system/qrs-ui.service` |
| 两个文件被报 `rc=1`(虚假失败) | `gcc … \| grep -v` 取到的是 **`grep` 的**退出码(无匹配 = 1)。改成把过滤结果收进变量再显式打印,**三个文件全干净** |

📌 后两条同源:**退出码经过管道就已经不是被检查对象的了**。

### 6. 收尾清板时的一条自我纠正:「均已归档」是顺手写的,没验

用户第 4 条指令里末段把工作转向"整理环境 / 文档 / 测试结果 / 交付仓库",
清板时按"**删之前先找副本**"的流程走,撞出一处**上一轮自己的不实断言**:

- 上一轮状态文档的板子环境表里写着:`qrs-ui.log.pre-8192` 与 `.pre-3dds`
  **「均已归档」**或为日志轮转。
- 本轮把板上 `/var/log/qrs-ui.log.pre-8192`(142 258 B)算出 md5 回工作区搜 ——
  **`8517f0b3…` 查无**。而 `.pre-3dds` 确实在(第 50 次已归 `20261008_cui_4slot_window_taps.log`,
  `0164ff13…`)。⇒ **那句话一半是真的,却整句读起来像已经核实过。**
- **处置**:补档为 `20261008_cui_before_8192_window.log`,并在**同一张表**里**保留原判、并列写明更正**
  (不删痕迹 —— 删了就看不出"这里曾经写错过")。
- 📌 **可复用教训**:**「已归档」是对某个文件的存在性断言,和"我记得我归档过"不是一回事。**
  存在性断言必须落到**具体的 md5 或路径**上;而状态文档里那种顺手写的概括句,
  最容易在下一轮被后人(包括模型自己)当既成事实拿去用。

📌 **收尾清板的判据本轮定形**(已写入 `report/measurements/artifacts/README_board_screenshots.md` §五末尾):
删除条件是「**板上这一份是不是唯一一份**」,**不是**「它大不大」;
而"是不是唯一一份"**必须用内容比对去查,不能用文件名或大小猜** ——
`fb0_now` 与 `fb1_now` 文件名不同、内容却相同;`fb0_chk` 名字像"检查图",实际就是已归档的复位页。
⚠️ **比图要解码后比 `md5(pixels)`,不能比文件哈希** —— PNG 编码方式不同则哈希必然不等(本轮 9 张全按此查)。

### 7. ★ 收尾漏了一步,而且是用户追问才发现的:「关系统」

用户第 4 条指令末段原文:

```
10m删了吧，输出不了，其他都测过了改为整理环境关系统整理文档和代码以及测试结果更新交付仓库推送
```

模型的切分里,「关系统」被读成了 **「关(掉环境这块)+ 系统(性)整理文档」** ——
于是把整理、文档、仓库都做了,**唯独没关板子**。用户随后一句
「**系统怎么没关**」把它点破,补做后才收工。

- **这里"关系统"是动宾(关闭系统)**;模型切成了「关」+「系统整理」,而**两种切法各自都讲得通**,
  所以错得毫无察觉 —— 没有任何一层会报错。
- ⚠️ **更值得记的是:错的这一半(关机)恰恰是用户唯一会立刻发现的那一半。**
  文档改了、仓库推了,那些用户都要翻才看得见;板子没关,他**一抬眼就知道**。
  ⇒ **任务清单里像"关机 / 拔电 / 断电"这种用户可当场核验的动作,应当作独立条目列出并当场核销,
  不能混在"整理环境"这个概括词里被消化掉。**
- 🔴 **补做时又翻出一处上一轮的不准** :板上 `/var/log/qrs-ui.log.pre-8192`(`8517f0b3…`)
  与 `.pre-3dds`(`0164ff13…`)**仍然躺在板上**,而前一轮的记录把这两件写成"已归档 / 已删除"。
  实际是 **归档了,但板上那份没删**。本轮按"唯一一份"判据(**md5 与归档件逐一相同**)删除。
- **关机三重确认**:`systemctl poweroff` → `ping` **4 发 0 收 / 100% 丢包**,隔 15 s 复核第二次结果相同,
  `/dev/tcp/192.168.2.99/22` **无响应**。
- ⚠️ 关机前实测状态:`qrs-ui` = **`disabled` 但 `active`**(用户手工起的,符合既定纪律);
  新 `qrs-ui.log` 显示用户 **22:13** 仍在点触摸并按下过参数复位 ⇒ 关机是**在用户明确要求下**执行的。

📌 **可复用教训**:模型对**中文指令的动宾切分**要按"用户可能真会说的整词"来切
(「关系统 / 关板子 / 断电」是整词),而不是按自己顺手的语法切 ——
**切错时两个残片都能自圆其说,所以只能靠"把可当场核验的动作单列出来"来兜底。**

## 沉淀

→ ✅ **已落地** [`skill/silent-capacity-gates/`](../../skill/silent-capacity-gates/skill.md)
—— 容量类改动沿路的 `掩码/上限/截断`,静默型 / 报错型 / **上限型≠容量型** 三分法
(本文「纠错轨迹」§2 是它的正文素材;§3 是它的第三节;§4 的时延法与"三档互不相同"是它的验收判据)。

→ 候选 `skill/param-table-spanning-domains/`(跨数字域与模拟域的参数表,必须先过物理可行性再算数字 —— 纠错轨迹 §1)
→ 候选 `skill/stale-constant-drift/`(改完实现主动 grep 旧数值 —— 纠错轨迹 §3;
   ⚠️ 与已落地的 `stale-artifact-silent-reuse/` 母题相邻但不同,是否合并待定)

---

<!--
填写提醒:
1. 当天记录,不要事后补 —— 补出来的没有"验证方式"和"纠错轨迹"
2. 失败也要记 —— 失败记录才是技能包的原料
3. 每条记录里必须能看到"我不同意 / 我改了 / 我验证了"
4. commit message 里加 [llm-XXX] 关联
-->
