dsgmxc/2026_fpga_qrs/llm-log/LLM-051.md

# LLM-051: 用户重接引脚 → 约束与注释全量换球号 + 重建位流;★ 换线使**三条**上板结论作废,其中一条牵出「守卫窗可能不再成立」

- **日期**: 2026-10-07(第 47 次会话)
- **模型**: DeepSeek-V4-Flash
- **任务**: 用户在板上**重新接线**后报出新的球号名单,要求把**文档和代码**的引脚都改掉,
  并把新位流传到板上(用户随后上电)。

## 提示词

第 1 条(会话开头,按 `CLAUDE.md` 的强制动作):
```
阅读当前项目
```

第 2 条(原文粘贴,含用户的口头简写与空格):
```
我刚刚改了引脚连接，对dds是data-v15 clk-w14 sync-v12 dac是sclk-w15 sdio-y14 cs-w13对adc是oeb-v5 clk-t11 nc-t5 nc-u5 d0-v7 d1-u7 d2-w8 d3-v8 d4-u9 d5-u8 d6-u10 d7-t9 d8-w6 d9-v6 d10-y7 d11-y6 pdn-y9 otr-y8
```

第 3 条(授权改代码 + 说明 nc 的处理 + 预告上电):
```
nc大概就是悬空引脚不官它，把文档和代码的引脚都改了，等下我上电你传上去
```

> 📌 第 3 条构成 `CLAUDE.md` §6.0 所说的「**用户明确要求**」——
> 模型的角色是审查/优化/修改、不主动代写代码,**改引脚约束属于被点名授权的例外**。
> 模型此前倾向于「先只改文档、代码等用户确认」,该倾向被这条指令覆盖。

## 模型回答

1. **核对式解析**了第 2 条的自由文本 —— 用户把三组信号连写成一句话(`对dds是…dac是…对adc是…`,
   中间无标点),模型先把它解析成 24 个球号,再**逐条与工程实际约束比对**,而不是直接照抄覆盖。
2. 定位到工程里**唯一启用的约束文件**是 `led.xdc`(`qrs.xpr` 里 `io.xdc` **根本没有被引用**),
   改了其中 **19 行**(DDS 3 + ADC 16);`adc_d[*]` 的 12 行按用户报的顺序重排。
3. RTL 侧同步改注释:`cv_sys.v`(DDS 3 处 + ADC 6 处)、`adc_capture.v`(5 处端口注释)。
4. **程序化复核**(不靠肉眼):19/19 球号正确、24 球零重复、与 LCD 30 / 触摸 4 / 系统 2 球零冲突、
   空脚 `U5`/`T5` 有意不约束。
5. 指出换线的**连带后果**:三条上板实测结论随之作废(见下),并**重跑全流程**出新位流。

## 结果

⚠️ 部分可用

- ✅ **约束与注释部分**:可用(19/19 经脚本复核 + 全流程重建通过)。
- ⏸ **上板部分**:**全部未验证** —— 板子当时停机(`ping 192.168.2.99` 100% 丢包),
  新位流尚未上传,三条作废结论尚未重测。

## 验证方式

| 环节 | 具体证据 |
|---|---|
| 约束改动正确 | 脚本逐行比对 `led.xdc` 的 19 行 → **19/19 一致** |
| 球号合法性 | `vivado -mode batch` → `link_design -part xc7z020clg400-2` → `get_package_pins`,24 球**全部存在**,并取回 BANK 与 `PIN_FUNC` |
| 冲突检查 | 集合运算:新球 ∩ LCD 30 球 = 空 · ∩ 触摸 4 球 = 空 · ∩ `sys_clk/sys_rst_n` = 空;新球内部零重复 |
| 重建 | Vivado v.2025.2,`reset_run synth_1/impl_1` → `launch_runs impl_1 -to_step write_bitstream`;**`write_bitstream Complete!` / 0 Errors**;`report/measurements/artifacts/20261007_qrs_*.rpt`(timing / utilization / drc / clocks,4 份与位流**同批**) |
| 时序 | `All user specified timing constraints are met.`:`clk_fpga_0` WNS **+12.928** / WHS **+0.045** / 0 失败(4083 端点);`clk_adc_raw` WNS **+1.055** / WHS **+0.120** / 0 失败(83);`clk_fb_raw` WPWS +18.408 |
| 布线 | `# of nets with routing errors ......... 0`(5000 逻辑网 / 3602 可布 / 3602 全布) |
| 资源 | LUT 1662(3.12%)· FF 1886 · BRAM 2.5 · DSP 0 · **IOB 56(44.80%)** |
| **IOB 数的交叉校验** | **56 = LCD 30 + 触摸 4 + 模拟前端 22** —— 不多不少 ⇒ 22 根模拟线**全部**按新球号落地,且**没有多余端口**被带出来 |
| 位流身份 | `board/qrs.bit` md5 `886b250be8cc2453001afc49d2523ed1` → **`aa9d1ae7f8bdd055cfc6f76d31768eaf`** |
| **`.hwh` 未变** | md5 `afeeb7b970d95e81ef3a79d3edb52516`,与换线前**逐字节相同** ⇒ 只动了 XDC,**寄存器图与地址映射未变** ⇒ 板上 `main.py`/`c_ui`/`qrs-ui.service` **不用重编** |
| 上板三条重测 | ⏸ **未做**(等用户上电);判据已先写明,见 §「纠错轨迹」第 3 条 |

## 纠错轨迹

> 本次会话**没有出错后被用户纠正**的经历,以下四条全是**模型自己发现并收回**
> —— 尤其第 1 条,是模型**自己写错的检查脚本**差点反过来"证明"用户的文件是错的。

**1. 🔴 自己写的检查脚本用了错的正则,把 12 行**完全正确**的约束报成「不符」**

- 模型写了个脚本比对 `led.xdc` 与实际球号,结果 12 行 `adc_d[n]` 全报 🔴 不符。
- 一度要宣布「约束文件大面积写错了」。**先看原文件再下结论**才发现:
  约束写的是 `[get_ports {adc_d[0]}]`(**带大括号**),而脚本的捕获组 `(\S+)\]`
  把 `{adc_d[0]` 连同**左大括号**一起捕获了 ⇒ 与 `adc_d[0]` 永不相等。
- 改成 `.strip('{}')` 后 **19/19 全对**。
- ✅ **模型当场明确说明「是我的正则,不是你的文件」**,没有把工具缺陷记成用户的错。
- 📌 教训:**检查脚本报错时,先证明脚本本身是对的,再指责被检查的对象。**
  这是本项目**第二次**栽在"自己写的检查工具"上(上一次是比值判据对加性常数敏感)。

**2. ⚠️ 差点把 `T11` 判成「时钟脚换了、MMCM 链要废」**

- `get_package_pins T11` 报 **`IS_CLK_CAPABLE = 0`** / `IS_GLOBAL_CLK = 0`(`IO_L1P_T0_34`),
  而 `adc_clk` 恰好落在它上面 ⇒ 第一反应是"换到了非时钟脚,采集链要废"。
- **回 RTL 核实后收回**:`adc_clk` 是 FPGA 的 **`output wire`**
  (`cv_sys.v:243` / `adc_capture.v:228 assign adc_clk = (cnt < half);`),
  是模块产生的**输出**;MMCM(`u_adc_mmcm`)的输入取 **PS FCLK0**,**根本不经过这个脚**。
  且换线前的 `V13`(`IO_L3N_T0_DQS_34`)**同样是 `clk_cap = 0`**,当年也这么跑通了。
- 📌 教训:**引脚属性报"异常"时,先回 RTL 查这个脚到底是输入还是输出** ——
  同一个物理属性对输入/输出的含义完全不同。

**3. ⚠️ 差点把 `io.xdc` 的 DDS 球号当成「独立证据」去证明用户的接线**

- 发现那个**已死**的 `io.xdc` 里 DDS 写的是 `V12/W14/V15` —— 与用户这次报的**逐位相同**,
  一度想说"两处独立来源互相印证,接线应该没问题"。
- **读了该文件自己的注释**才发现它写着:那些脚是"**照 J4 表挑的空闲脚,不是从实际接线查来的**"。
  ⇒ 两个"来源"其实是**同一条**(都源自 J4 引脚表) ⇒ **不算独立证据**,
  也**不能**用来反证用户接线。已收回并写进 `board_pins.md` 陷阱 5。
- 📌 教训:**"两处一致"不等于"两处独立"** —— 先确认两条来源的**出处**是否同源。

**4. ★ 最有价值的一条:把"换线"从**引脚问题**推到**结论作废问题** —— 并查出其中一条比想象中更严重**

- 换线本身只是改 19 行球号。但模型指出:**三条上板实测结论是绑在物理接线上的**,
  换线即作废(它们背后的**方法与判据仍有效**,换掉的只是**实测数据**):

  | # | 作废的结论(出处 `LLM-045` ⑧) | 为何作废 | 重测判据 |
  |---|---|---|---|
  | 1 | **D0/D11 位序判定正确** | 实测取自**换线前**的球排列 | 采一段正弦:**光滑单调 = 对,锯齿/回文 = 接反** |
  | 2 | **采样窗刻度 `−2 / −5 / −31`** | 窗中心含 **FPGA↔ADC 的来回传播延迟**,换脚即平移 | 扫 `PH_OFF` −6…+6(DIV=13)看三级台阶落在哪 |
  | 3 | **OEB 有效性**(三态冻结证据) | 同上,证据取自旧球号 | 关 `OEB_N` 看读数是否**冻结成精确常量**(p-p = 0) |

- 🔴 **第 2 条比"刻度变了"严重得多 —— 这是本次会话最硬的一条发现**:
  `measure_config.c::adc_window()` 里的稳定窗 `[2−P/2, +1]` 是**从 AD9238 手册推出的**,
  它是"**相对 ADC 自己的时钟脚**"的窗,**公式里没有"来回传播延迟"这一项** ——
  旧接线**凑巧**落进 ±0.5 tick 才与实测逐点对上。
  ⇒ 若换线后实测中心**整体平移 ≥1 tick**,说明该函数算出来的**已经不是真实稳定窗**,
  那时这个守卫会**放行"寄存器回读全对、数据却是错的"那种垃圾值** ——
  **而那正是它唯一要挡的情形**。
  ⇒ **重扫不是可选项,它是判断"这个守卫还成不成立"的唯一手段。**
- **代码未动**:该函数是**公式不是查表**,换线不该改它;只加了一段注释说明
  "旧实测已作废 + 平移 ≥1 tick 意味着什么"。
- 📌 与既有风险 **`R08`「时序常数与物理配置绑定」同族 —— 这是第二次踩**
  (第一次:`dac_1220` 的复位图案常数绑在 50 MHz 上,见 `LLM-043`)。

**5. 🟡 顺带更正一处「抄来但没人数过」的统计**

`docs/project_state.md` §十 一直写着 `直接可用 12 · 部分可用 34`,本轮一数实际是 **13 / 33**
(记录数也停在 46,实际 **50**)。原数字**是从别处抄的,没有数过**。
已更正,并**同时写清统计口径与其局限**(脚本取 INDEX 第 6 列;结论单元格里若含竖线会**列错位**,
实测 4 行无标记、其中 3 行即属此类 ⇒ **报的是近似值,不是精确值**)。

## 沉淀

→ 🆕 **新候选** `skill/verify-your-own-checker-first/`
(**检查脚本报错时,先证明脚本本身是对的,再指责被检查的对象** ——
本次是正则把 `{adc_d[0]` 的左大括号吃进去了,12 行正确约束被报成"不符";
**同族第二次**:上一次是比值判据对加性常数敏感)

→ 🆕 **新候选** `skill/input-or-output-decides-pin-semantics/`
(**引脚属性报"异常"先回 RTL 查方向** —— `IS_CLK_CAPABLE = 0` 对**输出**脚毫无意义,
因为时钟是模块自己产生的、MMCM 的输入另有来源)

→ **扩展** `skill/cite-sources-for-rule-claims/`
(**"两处一致"≠"两处独立"** —— 先查两条来源的**出处**是否同源;
本次 `io.xdc` 与用户报的 DDS 球号逐位相同,但前者自述是"照表挑的,不是从实际接线查的",
⇒ 同源、**不算独立证据**)

→ **扩展** `skill/verify-claims-not-intuition/`
(**硬件改动要连带清点"哪些结论绑在这份硬件上"** ——
换 19 行球号的真正后果不是引脚变了,而是**三条实测结论作废**;
且其中一条牵出"**公式里缺了那个随硬件变化的项** ⇒ 守卫可能已失效"这种**隐性**后果)

→ **扩展** `skill/pynq-overlay-bringup/`
(补**判据**:`.hwh` 逐字节未变 ⇒ 寄存器图未动 ⇒ **PS 侧不用重编、只换 `.bit`**;
比只比时间戳可靠)
