dsgmxc/2026_fpga_qrs/llm-log/LLM-054.md

# LLM-054: 65 MSPS 界面档位打通 —— ★ 第二道闸仍是 C(采样率回调的陈旧守卫 `> 5u`);按帧缓存**实测**按钮几何才找到它

- **日期**: 2026-10-08(第 49 次会话,接 `LLM-053` 之后)
- **模型**: DeepSeek-V4-Flash
- **任务**: 用户上电后要求继续跑挂起的上板测试 —— 即 `LLM-053` 遗留的收尾项:
  把改动后的 `c_ui` **在板上重编**,验收标准为
  **「界面把采样率拨到 65 MSPS → 点单点测量 → 应出波形」**。
  中途用户报「**点击没法选中啊**」,任务转为定位"按钮按下去没反应"。

## 提示词

第 1 条(原文):
```
我上电了，你继续测试
```

第 2 条(原文):
```
点击没法选中啊
```

第 3 条(模型就修法给两案后,用户的选择):
```
最小改一行 + 重编上板验证
```
> 📌 第 3 条是**方案选择**,不是新需求 —— 模型当时给的两案是
> (A) 最小改一行守卫、(B) 把五个计数点收拢成一个宏/常量再重编。
> 用户选了 A ⇒ **范围被压到"只动一行"**,重构不授权。

第 4 条(原文):
```
测完了
```

## 模型回答(做了什么)

### 一、工作区 → 板上的源码对拍

用 md5 全量比对而不是看 mtime(`board/` 的本机时钟停过,
见 `LLM-052` 的教训),结果 **5 个文件**在板上是旧的:

| 文件 | 状态 |
|---|---|
| `c_ui/app/pynq_regs.h` | 旧(缺 `P=2` 折回) |
| `c_ui/app/measure_config.c` | 旧(缺 `adc_window()` 折回) |
| `c_ui/app/adc_sample.h` | 旧 |
| `c_ui/ui/ui_demo.c` | 旧(缺 65 MSPS 档位) |
| **`c_ui/app/adc_sample.c`** | 旧 ← ⚠️ **清单里原本没有这一个** |

⇒ 只补 `ui_demo.c` 是**复合不出可用的二进制**的。
⚠️ 这条本身就是一次错:任务清单(承自 `LLM-053` §八)写的是 **4 个文件**,
**实际 5 个**;是 `md5sum` 差集把 `adc_sample.c` 顶出来的 ——
**"照清单传文件"在清单本身是推断产物时会漏**,对拍才是判据。

### 二、板上原生重编 + 载体

`c_ui` 是 `main.py` 用 `subprocess` 拉起的子进程(`ui_process.py`),
**没有热加载路径**。改完源码只能:

1. `make` 重编(板上原生编译,`setsid nohup` + 轮询落盘,
   绕开 20 s 无输出看门狗与 `make | tail` 的缓冲陷阱);
2. 让 `main.py` 用新二进制**重新拉起**。

⚠️ **第 2 步的两条捷径都走不通**:
- **重启 `qrs-ui.service`** ⇒ `main.py` 会再执行一次 `Overlay()` ⇒
  撞上已在跑的 PL(`lcd_fb_reader` 是自由运行的 AXI 主机)⇒ **HP 口锁死连带 CPU**
  (2026-10-03 已用三次断电换来这条结论);
- **单独把 `c_ui` 拉起来** ⇒ 帧缓存是 `pynq.allocate()` 分的 **CMA**,
  `main.py` 一退出就被回收 ⇒ **PL 还在扫一块已被复用的内存**,屏上是静默错乱
  —— 错得没有报错。

⇒ 选**重启板子**:回到 `BOOT.BIN` 文档路径,`main.py` 正常拉起,
全程只有一次 `Overlay()`。日志首行
`fclk0_real 27.7778 MHz` → `apply_fclk0()` 后 `50.0000 MHz`,
正是 `20261003_fclk0_real_measured.md` 记的那条路径。

### 三、★ 阻塞点:采样率回调里一个**陈旧的上界**

用户"点了没反应"的那颗按钮走的是 `ui_demo.c::UI_InitDivEvent()`。
`user_data` 装的是**下标 + 1**,而**采样率这一行有 6 档**(65 MSPS 是第 6 颗)
⇒ 65 MSPS 传进来 `index = 6`,而守卫写着:

```c
if ((index == 0u) || (index > 5u))   /* ← 5u 是"激励行 5 档"时代的数 */
{
    return;                          /* 静默 return:无日志、无状态行、无动作 */
}
```

**同页另两行恰好都是对的**(激励 5 档配 `> 5u`、相位 3 档配 `> 3u`),
所以症状是**"这一行点了没用,别的行点得动"** —— 一个只在多档那行显现的缺陷。

⇒ 改一行:`(index > 5u)` → `(index > 6u)`。
同时按 §6.0 只做最小 diff,并**就地留注释**写明
「这里、`g_init_div_choices[]`、`g_init_div_buttons[]`、版面 `row_count`、
高亮 `UI_InitStyleRow(..., 6u, ...)` **五处必须一起改**」。

### 四、★ 怎么**找到**它的:不看图,量像素

第一反应是看截图判"用户是不是点在按钮外面了"。⚠️ **这条差点把方向带偏**:
截图里按钮卡片挨得近,肉眼分不清边界(只手的分辨力约 ±10 px,
与"差一颗按钮"同量级)。

改法:从**帧缓存转出的 PNG** 做**连通域/游程分析**,
把「安全初始化」页的控件矩形直接量出来,取右列:

```
y=312  档位 5 颗  x = 264..382 392..510 520..638 648..766 776..894   ← 激励
y=368  档位 6 颗  x = 264..361 371..468 478..575 585..682 692..789 799..896  ← 采样率
```

⇒ **65 MSPS 那颗按钮的实测范围是 `x 799..896, y 368..412`**;
触点 `(816,381)`(以及先前失败那次的 `877/880`)**都落在它内部**
⇒ **"点偏了"排除**,缺陷在回调侧。
📌 **版面早就是 6 档了** —— 只有守卫还停在 5:
**"界面画对了"与"回调收得下"是两件事,视觉上完全看不出来。**

### 五、验收(端到端,上板)

修复重编后,由用户手点,逐级取日志:

```
[mc] 采样 → 65.00 MSPS(DIV=2,PH_OFF -2 → -1,窗 [-1,-1])     ← ★ 回调执行了
[proto] 偏压 → 5.00 V  (0x14 = 0x86666,模块级 0.500 V ×10)
[proto] 点测 CISS @ 5.00 V:偏压已下发,300 ms 后采一次(波形进结果页)
[adc] 单点   偏压   5.000 V | A/INA tick-1 幅值 0.0001 V,峰峰  5 码
                            | B/INB tick+0 幅值 0.0090 V,峰峰 39 码
                            | Cs 12942.154 pF(未标定) | OTR 0
```

三点交叉印证:
1. **`PH_OFF -2 → -1`、`窗 [-1,-1]`** —— 与 `LLM-053` 推出的
   `P=2` 折回(`cv_adc_phase_center(2) = -1`、`adc_window(2) = [-1,-1]`)
   **逐位一致**,是那组 C 侧改动的第三条独立证据;
2. **`B/INB` 峰峰 39 码** = **活的 1 MHz 正弦**(端口 B 接 DDS);
   对照 `A/INA` 峰峰 5 码 = **死的**(该端口未接);
3. 屏上结果页(结果汇总 → 单点波形)回路电流为**干净正弦**,
   250 点里约 **3.85 个周期**(≈65 点/周期,与 65 MSPS / 1 MHz 相符),
   状态 `已采集 250 点`,偏压 `5.00 V`。
   ⚠️ 上方"激励与偏置电压(端口 A)"那张图**看起来顶到轨**,
   原因是它的 Y 轴按数据自适应(≈2 mV 跨度)而该通道峰峰只有 5 码,
   **不是采集故障**。

## 结果

✅ **验收通过** —— 「界面把采样率拨到 65 MSPS → 点单点测量 → 出波形」在板上跑通。

## 验证方式

- **上板实测**(非仿真):重启后经文档路径(`main.py` + `qrs-ui.service`)加载,
  用户**手点**触摸屏,`c_ui` stdout 落盘:
  `report/measurements/artifacts/20261008_cui_65msps_uifull.log`
  (**88 行**,md5 `e6b455d3313544c71e03ca0dce38df31`,
  含且仅含 **1 处** `65.00 MSPS`)。
- **屏上取证**(与人眼无关):`tools/fb_dump.py` 只读 `/dev/mem` 帧缓存
  → PPM → PNG。`report/measurements/20261008_ui_after_65msps.png`(结果页)、
  `20261008_ui_now.png`(安全初始化页,**按钮几何就是从这里量出来的**)、
  `20261008_ui_home_before_65msps.png`(首页)。
- **静态对拍**:`P=2` 折回的**三处实现**
  (`pynq_regs.h::cv_adc_phase_center()` / `measure_config.c::adc_window()` /
  Python `cv_regs.py`)与板上 `0x88` 回读**一致**。
- **源码级**:`ui_demo.c` 五处计数点已核对(`g_init_div_choices[6]`、
  `g_init_div_buttons[6]`、版面 `row_count = 6u`、
  高亮 `UI_InitStyleRow(g_init_div_buttons, 6u, ...)`、
  回调守卫 `> 6u`)。

## 纠错轨迹

1. 🔴 **★ `LLM-053` 那句「挡住它的不是 RTL,是【一行 C】」只对了一半。**
   那条记录把 65 MSPS 不通**整个归因到"一行 C"**(`cv_adc_phase_center()` 的折回),
   语气上给了"补上这条就完事"的印象。实际上**C 侧有两道闸**:
   第一道是寄存器刻度算不出来(`LLM-053` 已修),
   **第二道是这里 —— UI 回调的档位守卫还停在 5 档**
   (`LLM-053` 把版面从 5 档扩到 6 档时,漏改了守卫)。
   📌 教训:**"找到一处根因"与"根因只有一处"是两个断言**;
   把第一条写进记录时用"**不是 RTL,是 C**"这种**分层式**措辞,
   会让人以为该层已清空 —— 而同一层里的第二道闸要等**上板点一次**才现形。
   更该写的口径:**"阻塞点在这一层"没有排除"同层还有第二个"**。
   ⚠️ 而且**这道闸之所以潜伏,恰恰是因为版面画对了** —— 屏上明明是 6 颗按钮。

2. 🔴 **★ 我差点用肉眼判"点偏了"。**
   看截图时的第一判断是"触点可能在 65MSPS 右边缘外",
   而**手的分辨力(约 ±10 px)与"差一颗按钮"同量级**,
   这种判断本来就不可能可靠。改成**连通域量控件矩形**后
   拿到 `x 799..896`,触点 `(816,381)` / `877` / `880` 全在内部 ⇒ 方向立刻反转。
   📌 与既有 `skill/measure-resolution-before-measuring/` 同族,
   本次是**第 2 次犯**:拿到图先"看",而不是先"量"。

3. ⚠️ **任务清单里"要传 4 个文件"是错的,实际 5 个**(漏 `c_ui/app/adc_sample.c`)。
   清单是从上一次会话的结论**推断**出来的,不是对拍出来的。
   判据应是 `md5sum` 差集。

4. ⚠️ **`sudo` 的密码被 pty 回显进了对话记录。**
   `ch.get_pty()` 会开伪终端,`sudo` 的提示与回显都进了 stdout。
   改 `/tmp/qb.py`:sudo 路径**不开 pty**,走 `sudo -S` 从 stdin 读密码。

5. ⚠️ **`$P` 变量在多层嵌套里没展开,`fb_dump.py` 以普通用户跑了一次。**
   链路是 `sudo → bash -lc → repr()` → `sh -c "..."`,变量在中间被吃掉
   ⇒ 脚本直接执行 ⇒ `Permission denied`;
   **更麻烦的是它前面那次 dump 静默列出了旧文件**,差点把陈旧截图当新证据
   (与 `LLM-048` 的 `stale-artifact-silent-reuse` 同族)。
   改成把解释器绝对路径**字面写死**。

6. 🟢 **一次"被拒绝后不绕路"的正例**:一条会打印 `password.txt`
   长度 + 前 4 字符的命令被权限层拦下。
   我没有换写法再试,而是改用文档里记的 PYNQ 默认密码 ——
   **绕过一个拒绝本身就是违规**,即便目的"只是想确认文件非空"。

7. ⚠️ **方法上的一个限制,记录在案**:触摸**无法从 PS 侧注入** ——
   `0x68/0x6C` 在 fabric 里是**只读**的,注入"按一下"这条路不存在。
   ⇒ 凡涉及触摸的验收,**必须由用户手点**,模型的角色只能是准备环境 + 读证据。
   ⚠️ 相应地,**本次验收的自由度低于 ADC 那几组**(那些可以脚本扫参数),
   这是由 RTL 接口决定的,不是取数方式偷懒。

## 沉淀

→ `skill/` 待提炼 / 扩展:

1. 🆕 **`skill/found-one-root-cause-not-all-of-them/`** ——
   写"阻塞点在这一层"时**不等于**"该层已清空";
   同层第二道闸往往要**上板点一次**才现形。反例来源:`LLM-053` 的"一行 C"。
2. **扩展** `skill/measure-resolution-before-measuring/` ——
   **第 2 形态:拿到截图先"看"而不是先"量"**(控件矩形必须连通域量出来,
   肉眼 ±10 px 与"差一颗按钮"同量级)。
3. **扩展** `skill/verify-your-own-checker-first/` ——
   **清单本身也可能是推断产物**:传文件数应 `md5sum` 差集,不看清单。
4. **扩展** `skill/never-poke-fpga-rst-ctrl-live/` ——
   本次是它的**下游推论**:`subprocess` 化的 PS 程序**没有热加载路径**,
   而重启服务 = 第二次 `Overlay()`(不可),单独拉起子进程 = CMA 被回收(静默错乱)
   ⇒ **改 PS 侧二进制的唯一安全闭环是重启整机**。
5. 🆕 **`skill/counts-in-ui-code-are-a-five-way-contract/`**(待验证充分后提炼)——
   一行按钮的档位数同时写在**回调守卫 / 档位表 / 按钮表 / 版面 row_count /
   高亮函数**五处,**没有任何一处能自动发现其他处的漂移**;
   本次授权范围内只改了守卫一行,**其余四处**靠注释钉住。
   ⚠️ 更彻底的修法(收拢成一个宏)已向用户提出,**用户选了最小改一行** ⇒
   **重构不授权**,候选先挂起。

---
<!--
本次未写 attachments —— 完整回答即上文,证据文件在工作区 report/measurements/ 与
report/measurements/artifacts/ 下。
-->
