dsgmxc/2026_fpga_qrs/llm-log/LLM-045.md

# LLM-045: AD9238 采集通路上板实测 —— 全链路打通、位序正确、双端口总线的发现,以及六次判断失误(其中四次同一根因)

- **日期**: 2026-10-06(第 44 次会话)
- **模型**: Claude(Claude Code CLI)
- **任务**: 用户上电后授权 Claude **自行上板调试** AD9238 采集通路(承 LLM-044 的位流)。目标:MMCM 是否锁、分频是否真、采到的数据是否可信、**D0/D11 位序**。
- **一句话结论**: **全链路打通(DDS→ADC→FPGA→缓冲→AXI→Python),D0/D11 位序经波形判定为正确,并发现总线是"双端口时分复用"(§G);OEB 经三态冻结实验证明有效,同时构成"ADC 确实在驱动总线"的决定性证据(§H)。剩余唯一未解:模拟侧幅度仅 0.98% FS、直流点停在 99% FS(§I)。模型本场 **6 次判断失误,其中 4 次同一根因**(只朝一个解释收口径),均在用户追问或自行复测下收回(§D)。**

---

## 提示词(原文,按时间顺序)

1. 「刚刚上电了」
2. 「**以后先把上电自启动的部分关了,我说开再开**」
3. 「**我现在 adc 还么接输入**」(即"还没接输入")
4. 「**u13-oeb v13-clk w11-d0 y11-d1 y12-d2 y13-d3 v10-d4 v11-d5 w9-d6 w10-d7 y8-d8 y9-d9 y6-d10 y7-d11 v6-pdn w6-otr 就是这几个啊**」
   —— 逐字重报球号,推翻模型"名单自相矛盾"的判断(见 §E)
5. 「**接了 dds 现在**」
6. 「**adc 输入 inb 了,但是 1m 它的输出感觉就是很微弱,你可以试着降低 dds 输出频率可能会好一点**」
7. 「**不能悬空吗我 ina 没接啊,这是双通道啊这么是差分输入**」
   —— 推翻模型"INA/INB 是一对差分输入"的错误理解(见 §D.4)
8. 「**有点奇怪就是 dds 单独接示波器挺好的同时接示波器和 adc 幅度就小很多**」
9. 「**现在换到 a 了先这么测把我回头还信号发生器**」
10. 「**OE_N 没有这个引脚啊**」
11. 「**u13 是 oeb**」
    —— 连同上一条,推翻模型"U13 接空、OEB 无效"的结论(见 §D.5、§H)

---

## 做对了什么(全部为本次板上实测)

### A. 位流加载与配置

| 项 | 结果 |
|---|---|
| PL 上电状态 | `fpga_manager/fpga0/state = unknown`;`dmesg` 只有 `FPGA manager framework registered`,**无加载记录** |
| 本上电周期加载次数 | **1 次**(`Overlay()` 0.93 s 完成,`ip_dict = ['cv_sys_0','processing_system7_0']`) |
| 位流身份判据 | `0x88` 读回 **`0x0000000D`** = 复位默认(DIV=13/PH=0)⇒ **确认是新位流**(旧位流无此寄存器,读 0) |
| FCLK0 | 写前 `0x00101E00`(DIV0=30)⇒ **1000/30 = 33.33 MHz**;写后 **`0x00101400`**,与已跑通值**逐位一致** ⇒ **50.000 MHz** |
| ADC MMCM | **`0x90[0] = 1` 锁上了** |

> ⚠️ **锁相不能用来证明 FCLK0 = 50 MHz** —— 见下方「纠错轨迹 D.2」。真正的证明在 §B 的斜率里。

### B0. ★ FCLK0 = 50 MHz 的独立证明(从 §B 的斜率反推)

`f_clkbase` 若真是 27.78 × 26 / 10 = **72.2 MHz**,则 §B 的拟合斜率会是 **1.8**。
实测斜率 **0.9982**,反推:

```
4096 / f_clkbase = 0.9982 × 4096 / 130e6   ⇒   f_clkbase = 130.2 MHz(+0.18%)
FCLK0 = f_clkbase × CLKOUT0_DIVIDE / CLKFBOUT_MULT = 130.2 × 10 / 26 = 50.1 MHz
```

⇒ **FCLK0 = 50.1 MHz(+0.18% vs 50.000)**,与设计值一致。

🔑 这条比"读回寄存器 0x00101400"硬 —— 寄存器读回只是**我自己写进去的值**,
而斜率是**拿 PS 的墙钟去量 PL 的采样节拍**,是一次数出来的物理测量。

### B. 分频器是真的(本次最硬的一条)

`adc_capture.v` 单次采集须满 4096 点 ⇒ **理论时长 = DIV × 4096 / 130 MHz**。
实测 8 个档位(`tools/adc_timing.py`,MMIO-only,**未重载位流**):

| DIV | adc_clk | 预期 µs | 实测 µs | 原始偏差 |
|---|---|---|---|---|
| 2 | 65.0 MHz | 63.0 | 99.2 | +57.5% |
| 4 | 32.5 | 126.0 | 149.9 | +18.9% |
| 5 | 26.0 | 157.5 | 177.9 | +12.9% |
| 10 | 13.0 | 315.1 | 334.9 | +6.3% |
| 13 | 10.0 | 409.6 | 442.2 | +8.0% |
| 26 | 5.0 | 819.2 | 844.6 | +3.1% |
| 65 | 2.0 | 2048.0 | 2072.2 | +1.2% |
| 130 | 1.0 | 4096.0 | 4115.5 | **+0.5%** |

**最小二乘拟合:`实测 = 0.9982 × 预期 + 26.9 µs`** ⇒ **斜率与 1.000 差 0.18%**,
即分频器在 **65 倍**的范围内线性正确。常数项 26.9 µs = 轮询开销(GO 写一次 11.77 µs + 平均半个轮询周期),
**与脚本文件头预判的"开销是加性常数不是乘性"完全相符**。

### C. 采样相位台阶(意外收获)

`PH_OFF` 扫 −6…+6(DIV=13,跨度 13 × 7.69 ns = 100 ns = **恰好一个完整 adc_clk 周期**):

| PH_OFF | 读数 | 说明 |
|---|---|---|
| −6, −5 | **4087~4089** | 上升沿刚过 |
| −4 … +1 | **4075~4077** | 含下降沿(周期中点) |
| +2 … +6 | **4086~4088** | 下一个上升沿之前 |

三级台阶,每级内部 p-p 仅 3~5。

🔴 **但这条不能当成"证明"—— 模型最初把它当成了证明,随后自行收回(见纠错轨迹 D.3)。**

当时的原话是「悬空总线不会这样 ⇒ 说明采样点扫过的是真实输出数据窗口」。
**错在哪**:`adc_clk` 在 V13,而 12 根数据线在排针上与它**挨着**
(用户确认的名单:V13-CLK 紧邻 W11-D0/Y11-D1…)。
**若数据线悬空,`adc_clk` 会容性耦合进去**,则"在不同相位锁存读到不同值"**照样会发生**
⇒ **相位台阶无法区分"ADC 在驱动"与"线在悬空耦合"。**

⇒ 本节只能支撑一条弱结论:**数据线上存在随采样相位变化的信号**(值或耦合,未判定)。
**眼中心未定,`adc_capture.v` 那条设计假设仍未获实测支撑。**

🟢 **本节后来被 §G 完整解释** —— 那三级台阶不是"一个眼的内部结构",而是**两个数据窗口的交替**
(高电平两级 = 未驱动的那一路停在静止电平,低电平一级 = 有信号的那一路)。
下面 §C 的原始数据与 §G 的窗口公式**逐点吻合**(见 §G 的验算)。

---

## 做对了什么(续)—— 链路与位序

### G0. 全链路是通的,D0/D11 位序正确

把 DDS 接到 INA 后,`dump` 读到的波形是**教科书级正弦**:

```
4071 4060 4049 4040 4038 4044 4054 4065 4073 4075 4071 4059 4048 4039 4037 4043 …
```

- 单调光滑下降 4071→4037、再光滑回升,**波峰处连续 4 点持平**(4075 4075 / 4077 4076)
- 噪声 ±1 LSB
- **周期恰好 10 个采样点** @ 10 MSPS ⇒ **1 MHz**,与 DDS 设定值一致

🔑 **位序判据(这条才是硬的)**:一个"阈值化的悬空脚集合"**不可能**产生光滑单调的 12 位二进制斜坡
—— 若 D0/D11 接反,波形会呈**锯齿/回文**状,不可能单调。
⇒ **`adc_d[0]`…`adc_d[11]` 的位序正确,无需改正。**

**采样率也跟着 DDS 走**(同一次会话内改频复测):

| DDS 设定 | 实测周期(采样点)@ 10 MSPS |
|---|---|
| 1 MHz | 10 |
| 500 kHz | 20 |
| 2 MHz | 5 |

⇒ 说明 PL 侧分频/触发/缓冲/AXI 读数**全是真值**,不是回读自己的寄存器。

---

## G. ★ 新发现:总线是**双端口时分复用**的(本场最重要的一条)

**现象**:一条 12 位总线,在一个 `adc_clk` 周期内**轮流输出两路不同数据**。

测得窗口(`tick` 单位为 130 MHz 基准周期 = 7.69 ns,`tick = cnt − P/2`):

| 端口 | 窗口 | 宽度 |
|---|---|---|
| **A** | `tick ∈ [2 − P/2, +1]` | **P/2** |
| **B** | `tick ∈ [+2, P/2 + 1]`(跨 `P−1−P/2` 绕回 `−P/2`) | **P/2** |

窗口中心 ⇒ **`1.5 − P/4`**:

| DIV | 推荐 PH_OFF(port A 中心) |
|---|---|
| 13(奇) | **−2**(注:中心真值 −1.75,**非整数**) |
| 26(偶) | **−5** |
| 130(偶) | **−31** |

**判据(决定性的一条)**:用户把信号线从 `INB` 挪到 `INA` 后,
正弦**从 B 窗口整体跳到 A 窗口** —— 不是反相、不是幅度变化,而是**换了时间槽**。
两个模拟输入 ↔ 两个时间槽,一一对应 ⇒ 只能是双端口时分复用。

**DIV=26 的实测印证**:A 窗口(−11…+1)是正弦(p-p 38),B 窗口(−13,−12,+2…+12)恒为 4086.8。

**DIV=13 的验算**(与 §C 那三级台阶对照,P=13 ⇒ P/2 = 6.5):
```
port A = [2 − 6.5, +1] = [−4.5, +1]  → 整数刻度 −4…+1  = 6 点
port B = [+2, 6.5 + 1]  → +2…+6 再绕回 −6,−5          = 7 点
                                            总计 13 点 ✓

实测:  低电平带(有信号)−4…+1  = 6 点 ✓
        高电平带(静止)  −6,−5 / +2…+6 = 7 点 ✓
```
**6/7 的划分与公式完全对上。**

### G.1 由此暴露的既有设计缺陷

1. 🔴 **`adc_capture.v` 里 PH_OFF 的注释("相对 adc_clk 下降沿的偏移")描述的是"单个数据眼",
   与实测不符** —— 实际是两个各宽 `P/2` 的窗口,且**窗口位置随 P 滑动**。
   ⇒ **固定 `PH_OFF = 0` 只在 P ≥ 4 时勉强落在 A 窗口内,且贴着窗口边缘**;P 变大就滑出去。
   复位默认值 `0x88 = 0x0D`(DIV=13/PH=0)恰好踩在这个边界上 —— 前面几轮"读数莫名其妙"有一部分来自这里。
2. 🟡 **奇数 DIV 不可用**:P/2 = 6.5 落在刻度中间,窗口无法对齐。
   ⇒ 建议 **PH_OFF 的推荐值随 DIV 计算**(`1.5 − P/4` 取整),或用**偶数分频**。
3. 🟡 **是否存在 `MUX_SELECT` / `DMUX` 脚?** 若模块上有,**固定到单端口**即可恢复"整周期一个数据眼"
   ⇒ PH_OFF 不再随 P 缩放,设计干净得多。**待用户核对模块丝印。**

> 📌 这条属于 **B04「资源取舍论证」/ M10「优化过程」** 的正文素材:
> 硬件上没有做"数据眼自动对齐",而是**把窗口位置交给软件按 P 计算** ——
> 用零资源换掉了时序对齐逻辑,代价是每次改 DIV 都要同步改 PH_OFF。
> 这个取舍的依据就是上面这张 6/7 划分的验算表。

---

## H. ★ OEB 有效 —— 以及"ADC 确实在驱动总线"的决定性证明

`0x88[17]`(OEB,U13)在同一 DIV/PH 下对比,读**原始 128 点**而非统计量:

| OEB | 128 点读数 | p-p | 去重 |
|---|---|---|---|
| **1** | `4087 4087 4087 …`(全同) | **0** | **1** |
| **0** | `4071 4060 4049 4040 4038 4044 4054 4065 …` | **40** | 40 |

**关掉输出使能 ⇒ 12 根线冻结成一个精确常量,一位都不动**;
打开 ⇒ 真实正弦。⇒ **OEB 是好的,U13 接线正确,`0x88[17]` 功能有效。**
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
