dsgmxc/2026_fpga_qrs/board/measurements/20261015_crss_sweep_manual_gear.md

# 2026-10-15 · CRSS 扫压实测(手动固定挡位)——「数据奇怪」现场

| 项 | 内容 |
|---|---|
| **日期** | 2026-10-15 |
| **目的** | 第一次跑通三腿扫压,拿到 CRSS 腿的完整 C-V 曲线;**同时暴露自动换挡的缺口** |
| **位流** | `qrs.bit` md5 `232c649d0cc143c12c87f17365f6ddd3`(2026-10-14 23:49 综合) |
| **激励** | AD9833,1 MHz |
| **采样** | 32.50 MSPS(`0x88 = 0x00104`,DIV=4,PH_OFF=+1) |
| **参考电阻** | **全程固定 B 挡 100 Ω**(`0x18 = 0x2`)—— 手动选的那一挡,扫压不换挡 |
| **扫压范围** | 0.10 V → 100.00 V,60 点/腿(指数间隔),每点驻留 300 ms |
| **腿** | 三腿一次跑完:`CISS(0x7F)` → `COSS(0x61)` → `CRSS(0x51)` |
| **原始日志** | 板上 `/var/log/qrs-ui.log`;CRSS 腿 120 行摘录曾存 `/tmp/sweep.txt`(重启即丢) |
| **结论** | 曲线**低压段可信、高压段不可信** —— 详见 §3;已立项自动换挡并在主机侧验证 |

---

## 1. 日志原文(头尾)

```
[proto] 扫压开始:CISS+COSS+CRSS,0.10 V → 100.00 V,60 点/腿,每点 300 ms
[relay] 回路 → CISS(0x7F)
[relay] 回路 → COSS(0x61)
[relay] 回路 → CRSS(0x51)
...
[adc] 扫压   偏压 100.000 V | A/INA tick+1 幅值  0.3271 V 峰峰  1348 码 | B/INB tick-1 幅值  0.0021 V 峰峰    36 码 | OTR 0
[adc] 扫压   Z =  1653.202 -15223.801 j Ω (R0 = 100 Ω,挡位 0x2) | Cs    10.454 pF | Cp    10.333 pF | D 0.10859 | I   0.0213 mA  (均未标定)
[proto] 扫压结束:CRSS,共 60 点已下发到 DAC
```

**三腿继电器确实各切了**(`→ CISS` / `→ COSS` / `→ CRSS`)—— 这是 2026-10-14
那次「切测量项目不切继电器」修复的 L5 判据,本次通过。

## 2. CRSS 腿 60 点全表

| # | 偏压 V | A 码 | B 码 | VL/VH % | OTR | absZ Ω | Re Z | Im Z | Cs pF | Cp pF | D | I mA | absZ/R0 |
|---|---|---|---|---|---|---|---|---|---|---|---|---|---|
| 1 | 0.100 | 1255 | 300 | 23.24 | 0 | 362.9 | +217 | -291 | 547.09 | 351.6 | 0.7 | 0.7063 | 3.63 |
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

### 3.1 可信的部分

* **`Cs` 在 8 V 以下单调下降**,量级符合功率 MOSFET 的 Crss;
* **`absZ` 与实测幅值比自洽**:`abs(VL)/abs(VH) = R0/abs(R0+Z)`(**相量和的模**)
  在每一个点上都能用表里的 `Re Z` / `Im Z` 复算出与 `VL/VH` 一致的数
  (0.10 V 处 `100/abs(316.9 - 290.9j) = 23.24 %`,与实测 23.24 % 逐位吻合)
  ⇒ **拆交织、相位对齐、解调这三段是对的。**

### 3.2 不可信的部分(本次的核心发现)

| 偏压 | absZ | `VL/VH` | 状况 |
|---|---|---|---|
| 0.10 V | 363 Ω | 23.2 % | 可用 |
| 6.77 V | 441 Ω | 19.9 % | 开始吃紧 |
| 13.66 V | 5 231 Ω | **1.89 %** | `VL` 已进量化底 |
| 100.00 V | 15 313 Ω | **0.64 %** | `VL` 只剩 36 码峰峰 |

全程 **21 / 60 个点的 `VL/VH < 5 %`**。

**为什么这不只是「精度差一点」:** `Z = R0·(VH-VL)/VL` 里 `VL` 在**分母**上。
`VL` 的相对误差被按 `absZ/R0` 倍放大 —— 100 V 处 `absZ/R0 = 153`,
也就是 `VL` 上 0.5 % 的扰动会让 `Cs` 变 75 %。

**症状(曲线形态):** 6.77 V → 13.66 V 之间,`Cs` 从 434 pF 掉到 31 pF ——
**一个倍压内掉 14 倍**。功率 MOSFET 的 Crss 随 Vds 是单调下降,但不会这样塌。
这不是器件特性,**是量程没跟上**。

**正确做法:** 该处 `absZ = 5.2 kΩ`,应当切到 **D 挡 10 kΩ**
(`VL/VH` 会回到 82 %),而不是继续用 B 挡 100 Ω。

### 3.3 一个附带观察:幅值(V)与峰峰(码)在小信号段不一致

多数点上两列自洽(两个通道都是 `2.42e-4 V/码`);
但高压段 B 通道对不上 —— 36 码峰峰按同一比例应是 0.0087 V,却报 0.0021 V。

**解释(未单独验证):** `码` 是**原始采样的峰峰**(噪声主导),
`幅值` 是**相干解调后的 I/Q 模**(噪声被 8190 点平均压下去)。
⇒ 小信号段原始 p-p ≈ 噪声底(23~40 码),而相干幅值仍能取出约 4 码的真信号。
**这正说明解调在干活**;但也说明 `码` 那一列在小信号段**不能当信号电平看**。

## 4. 后续

* **自动换挡已实现并在主机侧验证** —— 判据 `absZ ≈ R0`(推导见
  `src/c_ui/app/pynq_regs.h::cv_range_pick()`),用**本表的 60 组 Z** 跑
  `sim/tb_gear_pick.c`:换挡 2 次、0 次方向反转,`VL/VH` 全程 21.95 % … 83.41 %。
  见 `sim/gear_pick_verification.md`。
* ⚠️ **本次数据不必重测也已在文档里留下** —— 它是「手动固定挡」那一版的现场,
  与自动换挡版构成 M10 要的**优化前后对比**。
* ⚠️ **尚未上板验证**:本轮两处改动(自动换挡、扫压收尾偏压归零)都要
  **下一次上电 / 重启周期**才生效 —— 重启 `qrs-ui.service` 会二次加载位流,红线。
* `Cp` / `D` **仍未做 OPEN/SHORT 校准**(加分项 B8),表里的绝对值只能看形状。
