dsgmxc/2026_fpga_qrs/board/measurements/20261007_rewire_rebuild.md

# 2026-10-07 引脚重接 + 全量重建(新位流)

> **本次做了什么**:用户**在板上重新接线**后报出新的球号名单 → 改 `led.xdc` +
> RTL 注释 → 重跑 synth/impl 出**新位流** → 入库 `board/qrs.bit`。
>
> **一句话结论**:新位流已生成并落地,**时序全过、0 布线错误、`.hwh` 未变**
> —— 但**三条上板结论随换线作废**,必须在新接线下重测(见 §四)。

---

## 一、换线内容(用户 2026-10-07 报出)

| 组 | 旧球号 | **新球号** | J4 脚 |
|---|---|---|---|
| DDS `sclk` | T5 | **W14** | 33 |
| DDS `sync` | U7 | **V12** | 31 |
| DDS `data` | T11 | **V15** | 35 |
| ADC `clk` | V13 | **T11** | 2 |
| ADC `oe_n` (OEB) | U13 | **V5** | 1 |
| ADC `pdn` | V6 | **Y9** | 17 |
| ADC `otr` | W6 | **Y8** | 18 |
| ADC `d[0..11]` | W11 Y11 Y12 Y13 V10 V11 W9 W10 Y8 Y9 Y6 Y7 | **V7 U7 W8 V8 U9 U8 U10 T9 W6 V6 Y7 Y6** | 5–16 |
| DAC `sclk/cs/mosi` | W15 / W13 / Y14 | **未动** | 36 / 32 / 34 |

**模块侧空脚**:`U5`(J4-3)、`T5`(J4-4) 用户说明为"悬空引脚,不管它"
⇒ **有意不写约束**。若这两脚在模块内部接地,FPGA 一旦驱动即短路;
不约束则综合器保持未使用(高阻)。
⚠️ **故 ADC 段只有 16 行 `set_property`,而排线是 18 根 —— 不是漏了。**

**名单自洽性**(旁证,非证明):两段各自连续 ——
ADC 独占 **J4-1…J4-18**;DDS 在 **31/33/35**(奇数列)、DAC 在 **32/34/36**(偶数列)。
与一根 2×9 排线 + 一段 2×3 排线的物理形态吻合。

---

## 二、约束核对(改完当场用脚本复核,不靠肉眼)

| 检查 | 结果 |
|---|---|
| `led.xdc` 19 行新球号是否逐项正确 | ✅ 19/19(脚本比对,`[get_ports {adc_d[n]}]` 的大括号已剥) |
| 新球内部有无重复 | ✅ 无 |
| 新球 ∩ LCD 30 球 | ✅ **空** |
| 新球 ∩ 触摸 4 球 | ✅ **空** |
| 新球 ∩ `sys_clk(U18)` / `sys_rst_n(N16)` | ✅ **空** |
| 空脚 `U5`/`T5` ∩ 任何在用球 | ✅ **空** |
| 24 个球是否都存在于 `xc7z020clg400-2` | ✅ 全部 `get_package_pins` 查到,含 BANK 与功能 |
| 电平 | ✅ 全部 `LVCMOS33`(BANK13 依据 = 厂商例程 `30_digital_voltmeter` 同电平能综合) |

> ⚠️ **差点误判**:`T11` 实测 `IS_CLK_CAPABLE = 0` / `IS_GLOBAL_CLK = 0`
> (`IO_L1P_T0_34`)。**但这不影响** —— `adc_clk` 是 FPGA 的**输出**
> (`adc_capture.v:228 assign adc_clk = (cnt < half);`),MMCM 的输入是 PS FCLK0,
> 根本不经过这个脚。换线前的 `V13` 同样是 `clk_cap = 0`,当年也这么跑通了。
> 📌 这是「**看到属性异常先回 RTL 查这个脚到底是输入还是输出**」的一次应用。

---

## 三、重建结果(m3 素材 —— 综合与实现实测值)

**工具**:Vivado v.2025.2 · 器件 `xc7z020clg400-2` · Speed `-2`
**流程**:`reset_run synth_1` / `reset_run impl_1` → `launch_runs impl_1 -to_step write_bitstream`
**结果**:`synth_design completed successfully`(39 s)· `write_bitstream Complete!` ·
**`131 Infos, 1 Warnings, 0 Critical Warnings, 0 Errors`**

### 3.1 时序 —— `All user specified timing constraints are met.`

| 时钟 | 周期 | 频率 | WNS (ns) | 失败端点 | WHS (ns) | 失败端点 |
|---|---|---|---|---|---|---|
| `clk_fpga_0` | 20.000 ns | 50 MHz | **+12.928** | 0 / 4083 | **+0.045** | 0 / 4083 |
| `clk_adc_raw` | 7.692 ns | 130 MHz | **+1.055** | 0 / 83 | **+0.120** | 0 / 83 |
| `clk_fb_raw` | 20.000 ns | 50 MHz | — | — | — | — |
| `async_default` 组内 | — | — | `clk_adc_raw` +5.039 / `clk_fpga_0` +14.160 | 0 | — | 0 |

- 脉宽:`clk_fpga_0` WPWS +7.000、`clk_adc_raw` +3.346、`clk_fb_raw` +18.408,**全 0 失败**。
- ⚠️ **`clk_fpga_0` 的 WHS 只有 +0.045 ns** —— 正,但很薄。保持时间违规**不能靠降频解决**,
  是可维护性上的观察点,此处仅记录,不作处理。
- ⚠️ **`adc_d[*]` / `adc_otr` 的输入时序本版有意不约束**(理由见 `led.xdc` 末尾)——
  这几个端口会以 `no_input_delay` 出现在未约束清单,**是已知且有意**,不是漏了。

### 3.2 资源

| 资源 | 用量 | 占比 |
|---|---|---|
| Slice LUTs | 1662 | 3.12% |
| Slice Registers | 1886 | 1.77% |
| Block RAM Tile | 2.5(2×RAMB36 + 1×RAMB18) | 1.79% |
| DSP48E1 | **0** | 0.00% |
| Bonded IOB | **56** | 44.80% |

- ✅ **56 个 IOB 是一个有用的交叉校验**:LCD 30 + 触摸 4 + 模拟前端 22 = **56**,**不多不少**。
  ⇒ 22 根模拟线**全部**按新球号落地,且**没有多余端口被带出来**。
- ⚠️ `sys_clk(U18)` / `sys_rst_n(N16)` **未出现在 IO 报告里** ⇒ **未绑定**。
  与架构一致:本工程是 PL-only 顶层,时钟来自 PS FCLK0,不用板上 50 MHz 有源晶振。
- ⚠️ **DSP = 0** ⇒ 本次位流**不含** HLS 的 `dlia_core` / `cordic_polar`(尚未做)。正常。
- ⚠️ 本表是**实测**。`CLAUDE.md` §八 的「~10.5K LUT / 8 DSP / ~5 BRAM」是**纸面估算**,
  差距主要来自"HLS 还没进去"和"显示通路比估算的轻" —— **引用时用本表,不要再用那张纸面表**。

### 3.3 布线

```
# of logical nets ................. 5000     # of routable nets ........... 3602
# of nets not needing routing ..... 1398     # of fully routed nets ....... 3602
                                            # of nets with routing errors .    0
```

### 3.4 位流身份

| 项 | 值 |
|---|---|
| 新 `board/qrs.bit` | 4,045,690 B · md5 **`aa9d1ae7f8bdd055cfc6f76d31768eaf`** |
| 旧 `board/qrs.bit`(2026-10-06) | 4,045,690 B · md5 `886b250be8cc2453001afc49d2523ed1` |
| `board/qrs.hwh` | md5 `afeeb7b970d95e81ef3a79d3edb52516` —— **与换线前逐字节相同** |

✅ **`.hwh` 未变**是有意义的结论:**只动了 XDC,寄存器图与地址映射完全没变**
⇒ 板上的 `main.py` / `c_ui` / `qrs-ui.service` **一个字节都不用重编**,
只换 `.bit` 即可(位流身份判据见 `skill/pynq-overlay-bringup/`)。

**同批报告**(与位流同一批综合实现产出,`.rpt` 与 `.bit` 必须同批):
`report/measurements/artifacts/20261007_qrs_{timing_summary_routed,utilization_placed,drc_routed,clocks}.rpt`

---

## 四、🔴 换线**作废**的三条上板结论(必须重测)

> ✅ **2026-10-07 已重测** —— 两条复现、一条**本次没测到**(测法有缺陷,非被测对象失效)。
> 详细数据、原始日志与波形图见 `20261007_adc_65msps_and_retests.md`。
>
> | # | 结论 | 重测结果 |
> |---|---|---|
> | 1 | D0/D11 位序 | ✅ 复现(波形光滑单调,无锯齿/回文) |
> | 2 | 采样窗刻度 −2 / −5 / −31 | ✅ 复现(平坦带逐拍吻合 `[2−P/2, +1]`,**换线没有平移窗口**) |
> | 3 | OEB 三态冻结 | ⬜ **本次没测到** —— `adc_probe.py::cmd_go()` 会用只含 DIV/PH_OFF/CONT 的 `cfg` **重写整个 0x88**,把 OEB_N 清回 0 ⇒ 测的全程是 OEB 关。**上次的 4095 冻结结论未被推翻**,仍有效。 |
>
> 第 2 条下文担心的"稳定窗公式可能不再成立"**没有发生** —— `adc_window()` 守卫生效。

这三条都绑在**物理接线**上,不绑在 RTL 上 —— 换线即作废,但它们背后的**方法与判据仍然有效**。

| # | 作废的结论(出处) | 为何作废 | 换线后怎么重测 |
|---|---|---|---|
| 1 | **D0/D11 位序判定正确**(`LLM-045` ⑧①) | 那次实测是在**换线前**的接线下做的;球的排列变了,位序可能整体错位 | 采一段正弦:光滑单调 = 对;**锯齿/回文 = 位序接反** |
| 2 | **采样窗刻度 `−2 / −5 / −31`**(`LLM-045` ⑧②) | 窗口中心依赖 **FPGA↔ADC 的来回传播延迟**(输出脚出去 + 数据脚回来,单位 7.69 ns/tick);换脚即平移 | 扫 `PH_OFF`(−6…+6,DIV=13),看台阶落在哪 |
| 3 | **OEB 有效的三态冻结证据**(`LLM-045` ⑧③) | 同上,证据取自旧接线的球号 | 关 `OEB_N` 看读数是否冻结成**精确常量**(p-p = 0) |

> 🔴 **第 2 条不只是"刻度变了"这么轻松。** `measure_config.c::adc_window()` 里那个
> 稳定窗 `[2−P/2, +1]` 是**从 AD9238 手册推出的**(相对 ADC 自己的时钟脚),
> 它**没有"来回传播延迟"这一项**。旧接线凑巧落进 ±0.5 tick 才与实测逐点对上。
> **若换线后实测中心整体平移 ≥1 tick,说明本函数的窗不再是真实稳定窗** ——
> 那时守卫会**放行"回读全对、数据是错的"那种垃圾值**(正是该守卫唯一要挡的情形)。
> ⇒ **重扫不是可选项**,它是判断"这个守卫还成不成立"的唯一手段。
> 代码本身**不动**(它是公式不是查表),只在该处加了指向本节的注释。
>
> 📌 **与 `R08`「时序常数与物理配置绑定」同族 —— 这是第二次踩。**
> (第一次:`dac_1220` 的复位图案绑在 50 MHz 上。)

---

## 五、顺带查出的问题(未处理,已告知用户)

1. 🔴 **`constrs_1/new/io.xdc` 是死文件** —— `grep -o '[a-z_]*\.xdc' qrs.xpr | sort -u`
   只返回 **`led.xdc`** 一个,`io.xdc` **根本没进工程**(不是"被禁用")。
   它的球号与 `led.xdc` **大面积打架**(`U5`/`V5`/`V7`/`V12`/`W14`/`V15`)。
   ⛔ **不要把它当参考**。建议归档,但**改 Vivado 工程布局归用户**,未动。
   ⚠️ 另:该文件自述其 DDS 球号是"**照 J4 表挑的空闲脚,不是从实际接线查来的**"
   ⇒ 它与用户报的新 DDS 位置逐位相同,**只是碰巧/或用户照它接的,不算独立证据**。
2. ⚠️ `cv_sys.v` 里「本模块是**单通道**接法」那条注释仍**陈旧** ——
   `LLM-045` 已实测坐实该总线是**双端口时分复用**。本轮**未动**(不在换线范围内)。
3. ⚠️ 交付仓库 `qrs_fpga_2026/src/constrs/led.xdc` **仍是旧球号** ——
   按 §6.0.1 该仓库只读,等**用户点名**再同步。

---

## 六、结论

| 项 | 状态 |
|---|---|
| `led.xdc` 19 行球号 + RTL 注释 | ✅ 已改并逐项复核 |
| 全工作区文档引脚记录 | ✅ 已改(`board_pins.md` §二 + 陷阱 5、`source_design_checklist.md` §2.3、`project_state.md` §九 Q02 + §十二) |
| 新位流 | ✅ 已生成,时序全过 / 0 布线错误 / 存入 `board/qrs.bit` |
| `.hwh` | ✅ 未变,无需重编 PS 侧 |
| **上板验证** | ✅ **已上板**(2026-10-07 当晚) —— 结果见 §七 |

---

## 七、上板验证结果(2026-10-07 当晚,用户上电后)

> **上电前提(实测)**:`uptime` 0 min(刚开机)· `qrs-ui.service` **disabled/inactive** ✅
> · `fpga_manager/fpga0/state` = **`unknown`** ⇒ **PL 尚未被加载过** ⇒ 这是本次上电**唯一一次**加载机会。
> **载入方式**:`tools/step2_overlay.py`(带 `safelog`,`Overlay()` 前后逐行落盘)。
> 结果:`Overlay 返回 ✅` · `0x48 VERSION = 0x00010000` ✅ · `0x4C` 写 `0xA5A51234` 读回一致 ✅。

### 7.1 板级基线(两项独立再确认)

| 项 | 实测 | 与既有文档 |
|---|---|---|
| **FCLK0 开机默认** | **27.7778 MHz**,`FPGA0_CLK_CTRL = 0x00600600`(DIV0=6 / DIV1=6) | ✅ 与 `20261003_fclk0_real_measured.md` 逐位一致 |
| **`apply_fclk0()` 之后** | **50.0000 MHz**,`0x00101400`(DIV0=20 / DIV1=1) | ✅ 一致(IO PLL 1000 / DIV0 20) |
| **MMCM 何时锁** | `0x84 = 0` 时 `0x90 = 0x00000000`(**`locked = 0`**);置 `0x84[0] = 1` 后 **0.2 s 内** `locked = 1` | ✅ 与 `cv_sys.v:710 mmcm_rst = ~(s_axi_aresetn & cfg_clk_release)` 相符 —— **`0x84[0]` 同时放行 MMCM 与 DAC** |

> 📌 这条值得单独记:**不先置 `0x84[0]`,整条 ADC 通路是"寄存器全在、读数全 0"** ——
> 本次第一次跑 `adc_rd.py` 就是 `0x90 = 0`、128 点全 0。若不知道这个闸,极易误判成"换线把采集链搞坏了"。

### 7.2 ✅ **采样窗刻度:没有平移**(§四 第 2 条 —— 结案)

`PH_OFF` **全扫 −6…+6**(P=13 的整个合法范围),DIV=13,`OEB_N = 0`,每档 64 点:

| PH_OFF | −6 | −5 | **−4 … +1** | +2 | +3 | +4 | +5 | +6 |
|---|---|---|---|---|---|---|---|---|
| 读数区间 | 4083–4086 | 4082–4090 | **4074–4078** | 4083–4086 | 4083–4086 | 4083–4086 | 4083–4085 | 4083–4086 |

**与旧接线(`LLM-045`)逐段对照**:

| 台阶 | 旧接线 | **新接线(本次)** | 边界是否一致 |
|---|---|---|---|
| 外侧低(−6, −5) | 4087–4089 | 4082–4090 | ✅ **一致** |
| **中(−4 … +1)** | 4075–4077 | **4074–4078** | ✅ **一致** |
| 外侧高(+2 … +6) | 4086–4088 | 4083–4086 | ✅ **一致** |

⇒ 🟢 **台阶边界完全没有移动,只是绝对值整体低了几个 count**(悬空电平不同所致)。
**换线没有平移采样窗。**

⇒ **`measure_config.c::adc_window()` 的守卫 `[2−P/2, +1] = [−4, +1]` 在换线后依然是对的。**
§四 里那条"若中心平移 ≥1 tick,守卫就会放行垃圾值"的担心 —— **实测排除,守卫仍然成立。**
> ⚠️ **结论强度**:这里能排除的是"**≥1 个 tick 的整体平移**"(台阶边界肉眼可分,分辨率约半 tick)。
> 它**不能**排除亚 tick 的延迟变化 —— 那要靠真实信号下的数据眼再看一次(见 §7.4 末)。
> 但**"守卫失效"这个担心的门槛正是"≥1 tick"**,所以按原判据,这条可以结案。
代码继续不动(它是公式,不是查表)。

> ⚠️ **这条结论的适用范围要说清**:本次测的**不是"有信号时的数据眼"**,而是
> **悬空总线上的两个数据窗口的交替**(判据依据同 `LLM-045` §G)。
> 它证明的是**两个窗口在时间轴上的位置**没变,而"窗中心采到的是稳定值"这件事
> 仍要等有真实信号时再确认一次。⇒ 见 §7.4。

### 7.3 ✅ **OEB 三态冻结:在新接线下重新坐实**(§四 第 3 条 —— 结案)

| `OEB_N` | 读数 | p-p | 去重数 |
|---|---|---|---|
| **1**(关输出驱动) | **128 点全同 `4095`** | **0** | **1** |
| 0(ADC 在驱动) | 随 PH_OFF 在两/三个台阶间变化 | 2–8 | 3–5 |

⇒ 关掉驱动源,读数**冻结成一个精确常量** —— 容性耦合给不出"128 点一位不动"。
⇒ **ADC 确实在驱动这条总线,且 `OEB_N`(新球号 `V5`)接线与功能都正确。**

> ⚠️ 冻结电平由**旧接线的 4087 变成 4095**:两者都是"三态后的静止电平",
> 差异只反映**新的 12 根数据线悬空时的泄漏/串扰环境不同**,不影响本判据。

### 7.4 ⏸ **D0/D11 位序:本次无法测**(§四 第 1 条 —— 挂起,非遗漏)

**用户当场说明:「我 adc 没接东西先别管」** —— ADC 输入端**悬空**。
实测也完全吻合:读数停在 `4076 ± 2 / 4095`(**99.5% FS**),p-p 仅 2–4 counts。

**旁证(顺手做的一条判别实验)**:把 `0x14 BIAS_CODE` 从 `0x00000` 扫到 `0xFFFFF`
(**模块端 −10 V → +10 V**,七档),ADC 读数**均值跨度仅 0.4 counts**:

| BIAS_CODE | 0x00000 | 0x40000 | 0x60000 | 0x80000 | 0xA0000 | 0xC0000 | 0xFFFFF |
|---|---|---|---|---|---|---|---|
| 理论 V(模块端) | −10.0 | −5.0 | −2.5 | 0.0 | +2.5 | +5.0 | +10.0 |
| ADC 均值 | 4075.8 | 4075.9 | 4075.7 | 4076.0 | 4076.0 | 4075.9 | 4075.7 |

⇒ 偏压走满量程、ADC 读数纹丝不动 ⇒ **模拟输入端确实没接东西**(与用户的话一致),
**不是** DAC 或线断了。

📌 **这条数据本身有用,别丢**:它给出**「ADC 输入悬空」的基线 = `4076±2`(OEB 打开)/ `4095`(OEB 关)。
将来接上前端后,若读数仍贴着这个基线,就说明**信号根本没进来** —— 一个立刻可判的二值判据。

🔴 **位序测试为什么必须等真信号**:12 位全稳定时,任何位置换都得到同一个数
⇒ **常数读不出位序**。判据本身不变(有信号后:光滑单调 = 对,锯齿/回文 = 接反)。

### 7.5 本节小结

| §四 的三条 | 结果 |
|---|---|
| ① D0/D11 位序 | ⏸ **挂起** —— 需真实信号(用户:ADC 未接) |
| ② 采样窗刻度 | ✅ **结案:未平移,守卫仍成立** |
| ③ OEB 有效性 | ✅ **结案:新接线下重新坐实** |

⇒ 换线**没有**破坏测量主链。三条里两条已闭环,剩一条卡在**外部模拟输入**上,与 PL/XDC 无关。
