dsgmxc/2026_fpga_qrs/sim/adc_9833_verification.md

# `adc_9833` 功能验证报告

| 项 | 内容 |
|---|---|
| **日期** | 2026-09-20 |
| **被测对象** | `adc_9833.v`(AD9833 DDS 的三线 SPI 初始化 + 频率字更新控制块) |
| **测试平台** | `sim/tb_adc_9833.v`(**自检型**,由 Claude 代写 —— 见 §7 归属说明) |
| **工具** | Vivado Simulator (xsim) 2025.2,`xvlog` → `xelab` → `xsim` |
| **原始日志** | `sim/logs/tb_adc_9833_fixed.log`(46 PASS / 1 FAIL)、`sim/logs/tb_adc_9833_mutant.log`(4 个变异体,22 FAIL) |
| **结论** | **47 项检查:PASS 46 / FAIL 1**。唯一一项 FAIL 是 **t8 max 的实测偏离**,见 **§5** —— 这是本次最有价值的产出。⚠️ **未综合、未上板**,见 §6 |

---

## 1. 验证目标

`adc_9833` 的职责分两段:

1. **上电初始化** —— 等 `PWR_WAIT` → 连发 4 帧 16 位控制/频率字 → 拉高 `init_done`;
2. **正常工作** —— 此后每收到一个 `set_in` 上升沿,把输入的 28 位频率字**分两帧**发出去,然后等下一个。

本测试台只回答一件事:**AD9833 芯片在这三根线上真正看到的东西对不对。**
判据全部来自 AD9833 手册(中文 Rev. E),不来自 RTL 源码(见 §2)。

---

## 2. 方法:三个刻意的设计选择

### 2.1 只观察引脚,不看 DUT 内部

测试台把 `adc_sclk` / `adc_sync` / `adc_mosi` **当成外部示波器探头**:

1. 在 `adc_sclk` **下降沿**采样 `adc_mosi`(CPOL=1 / CPHA=0,从机在下降沿取数 —— 手册 p13 图 4);
2. MSB first 移位进 16 位移位寄存器;
3. **在 `adc_sync == 0` 期间数满 16 位**就推出一帧。

帧同步直接用 `adc_sync` 的电平判定,**不用间隔阈值切分**(那是 `tb_dac_1220` 的做法,因为那边 `dac_cs` 恒低)。
另设一个计数器 `n_stray`,统计「FSYNC 为高时出现 SCLK 下降沿」与「帧没凑满 16 位就抬 FSYNC」——
这两类都是协议违例,应当是 0。

### 2.2 期望值全部来自手册,不来自 RTL

| 判据 | 出处 |
|---|---|
| `D15,D14` 地址位:控制字 = `00`、频率寄存器 = `01` | 手册表 5(控制寄存器位)/ 表 9 算例 |
| **B28=1 时两次连续写入的 `D15,D14` 必须相同** | 表 9(「FREQ0 寄存器写入(D15, D14 = 01)」两次) |
| **第一次写入 = 14 个 LSB,第二次 = 14 个 MSB** | 表 9 正文 + 算例 `0xFFFC000 → 0010…/0100…/0111…` |
| 控制寄存器位图 `0 0 B28 HLB FSELECT PSELECT 0 RESET SLEEP1 SLEEP12 OPBITEN 0 DIV2 0 MODE 0` | 表 6 |
| 各控制位含义(FSELECT / PSELECT / SLEEP1 / SLEEP12 / OPBITEN / DIV2 / MODE) | 表 6 逐条描述 |
| `f_out = fMCLK/2^28 × FREQREG` | 手册 p15 |
| t4 / t5 / t6 / t7 / t8 / t11 | 表 2(p4) |

> ⛔ **这条是上一份验证报告(`dac_1220_verification.md` §2.2)留下的方法论,本次继续执行**:
> 判据的来源必须独立于被测物。若期望值从 RTL 抄,「波形与期望一致」**恒真**,
> 通过了也不含任何信息 —— 那正是 `LLM-010` 暴露过的陷阱。
> 本次三个测试码值对应的六个期望帧**全部手算后写成 `localparam` 常量**,
> 没有一处是把 RTL 的表达式搬过来。

### 2.3 用「初始化那个频率字」当正常态的测试向量(本次新加的手法)

更新①故意喂 `code = 0x0A3D70A` ——**就是初始化里用的那个频率字**。
它发出的两帧 `0x570A / 0x428F` 应当与 init 的第 2、3 帧**逐字节相同**。

这条把两条独立代码路径(`init_word_f` 与 `freq_word_f`)钉在同一条手册规则上:
若两者对表 9 的理解有分歧,必有一侧露馅。**几乎零成本,但覆盖了一个此前没人查过的接缝。**

### 2.4 一处加速参数,其余全真值

只有 `PWR_WAIT` 被覆写(真值 `10_000_000` = 200 ms → 1000 拍),"上电等多久"本次不验证。
`SPI_HALF_T=256` / `CS_SETUP=1000` / 帧间隔 1024 拍 **全部保持真值**。

⇒ **这是本份报告比 `dac_1220` 那份强的地方**:那边压缩了三个毫秒级等待,
所以 §E 的时序数字只能测出"协议层"的间隔;本次可以**直接与手册窗口逐条比对**。

---

## 3. 结果:47 项检查,PASS 46 / FAIL 1

| 分组 | 内容 | 结果 |
|---|---|---|
| **A** | 初始化 4 帧逐字比对 | 5/5 PASS |
| **B** | 控制字位域解码(19 项:地址位 / B28 / RESET / 各位含义 / 保留位) | 19/19 PASS |
| **C** | 频率字重建 + 输出频率 | 2/2 PASS |
| **D** | 正常态三次更新(含触发打在发射中途) | 8/8 PASS |
| **E** | 时序实测 | 8/9 PASS(**1 FAIL = t8**,见 §5) |
| **F** | `init_done` 行为 | 2/2 PASS |
| **G** | 复位期 FSYNC 空闲态 | 1/1 PASS |

**几条可直接引用的实测数字:**

| 量 | 实测 |
|---|---|
| 初始化 4 帧 | `0x2100` → `0x570A` → `0x428F` → `0x2000` |
| 重建 FREQREG | `0x0A3D70A` = 10 737 418 |
| 输出频率 | `25 MHz × 10737418 / 2^28` = **999 999.9776 Hz** |
| `init_done` 时刻 | 第 4 帧结束 **827.59 µs** → `init_done` **858.35 µs**(相差 30.76 µs = 帧间隔 1024 拍) |
| SCLK 半周期 | **5120 ns**(256 拍,`SPI_HALF_T` 真值),抖动 0 |
| t4 SCLK 周期 | **10 240 ns** |
| t7 | **25 100 ns** |
| t11 | **20 270 ns** |
| 帧间 FSYNC 高电平 | **20 580 ns** |

> ✅ **"发射中途来的 `set_in` 沿不会丢"已实测坐实**:更新③的触发打在更新②两帧之间
> (测试台在帧 6 收完后才打脉冲),更新③的两帧 `0x6AAA / 0x42AA` 照常发出。
> 机制是 `adc_9833.v` 把 `set_pending <= 1` **写在 `case` 之后、无条件执行** ——
> 若改成只在 `NORMAL_WAIT` 里判,这一项会失败(见 §4 变异 M3 的同类验证)。

---

## 4. 变异测试:4 个变异体全部被抓

判据「能通过」不算证据,**「该失败时会失败」才算**。故各改一处再跑:

| 变异体 | 改动 | 被抓在哪 | FAIL 数 |
|---|---|---|---|
| **M1** | `freq_word_f` 两帧顺序对调(先发 14 MSB 再发 14 LSB)—— **违反手册表 9** | D 组:三次更新的帧值 + 三次 FREQREG 重建**全部** FAIL | 7 |
| **M2** | init 帧2:`0x428F` → `0x828F`(地址位由 FREQ0 变成 FREQ1) | A 组(帧2 值)、B 组(帧2 地址位、两帧地址位相同)、D 组(与 init 互证) | 4 |
| **M3** | init 帧3:`0x2000` → `0x2100`(**RESET 位永不释放**) | A 组(帧3 值)、B 组(RESET 释放、两帧只差 RESET 位) | 3 |
| **M4** | 正常态两帧地址位 `01` → `00`(把频率字当控制字发) | D 组:三次更新的帧值 + 与 init 互证 | 4 |

**四处变异各自命中语义正确的检查项,没有一个是"连带误伤"。**
(M1/M2/M4 的 FAIL 总数里都含 §5 那条基线自带的 t8,那是恒在项,不影响判读。)

---

## 5. 🔴 唯一一项 FAIL:实测 t8 超出手册上限 25 ns(本次最有价值的产出)

### 5.1 事实

```
t8 实测        : 10 260 ns  (= 513 个 50 MHz 时钟拍)
手册窗口       : 10 ns  ~  (t4 − 5 ns) = 10 235 ns
超出           : 25 ns(约 0.24%)
```

`t8` = **末个 SCLK 下降沿 → FSYNC 上升沿**的保持时间(表 2,p4)。

### 5.2 根因(逐行读 `spi_master.v` 得到,不是推测)

`spi_master.v` 的 `SCLK_TOG` 状态:每帧 32 个 SCLK 沿(16 降 + 16 升,`TH = 2*DATA_WIDTH`)。
`bit_cnt` 计到 `TH` 时,**还要再等满一个 `delay_cnt == SPI_HALF_T-1` 周期**才跳 `DONE`
(`spi_master.v:150-163`),而 `cs` 是在 `DONE` 里抬起的(`spi_master.v:165-167`)。所以:

```
末个 SCLK 下降沿(第 31 沿)  ──+256 拍──►  末个上升沿(第 32 沿)
                             ──+256 拍──►  DONE → cs 抬起
                                          ⇒ t8 = 512 拍 + 1 拍 = 513 拍 = 10 260 ns
```

也就是 **t8 = t4 + 1 拍**,比手册上限 `t4 − 5 ns` 多出 25 ns。

### 5.3 为什么物理上仍然安全(以及这条判断的边界)

手册写 t8 max 的目的,是保证 FSYNC 在**下一个 SCLK 下降沿之前**抬起 ≥5 ns ——
否则 AD9833 会把那个沿当成新字的第 0 位。

本项目实测:**FSYNC 抬起之后,下一帧的第一个 SCLK 下降沿在 45 680 ns 之后**
(测试台新增的 `t8_eff` 项,Pass)。对比它需要保护的 5 ns,**裕量约 9000 倍**。

原因是本设计的 SCLK **不是连续的**:末个下降沿之后 SCLK 只再有一个上升沿就停住,
下一帧要等 1024 拍帧间隔 + `CS_SETUP`(1000 拍)才重新开始。而手册同时允许
「SCLK 可以是连续的」那种用法 —— `t8 max = t4 − 5 ns` 正是为连续 SCLK 设的界。

> ⚠️ **这条判断的边界(必须如实写明)**:
> ① 本机**没有英文原版手册**,`t8 max` 只在中译版表 2 上见到,且该条自带脚注
> 「**通过设计保证,但未经生产测试**」;
> ② 上面「为什么仍然安全」是**对 t8 max 立法意图的解读**,不是手册原文;
> ③ 因此**这一项的最终判定仍建议上板实测结案**(ILA 抓「末个 SCLK 下降沿 → FSYNC 抬起」)。

### 5.4 处置:留给用户决策,本报告不擅自改判

两条路,都已量化:

| 方案 | 动作 | 代价 |
|---|---|---|
| **A. 接受偏离 + 文档化** | 不动任何 RTL,把本项记成「已知偏离 + 理由」 | 0.24% 超限,但上述物理裕量成立。**当前有效做法** |
| **B. 改 `spi_master.v`** | `SCLK_TOG` 在 `bit_cnt` 到 `TH` 时**直接**跳 `DONE`(去掉那一次多余的半周期等待)⇒ t8 = 5120 ns,**通过** | ⚠️ 改的是**共享模块**,且 `dac_1220` 已上板验证过。`LLM-013` 已算过它的耦合面:`done` 提前 ⇒ `dac_1220` 字间间隔 **35.8 → 30.7 µs**(手册 t14 下限 16.68 µs,仍满足)。**用户已于 09-20 拍板「方案 A:一行不改」** |

→ **本报告按现行决策(**不改 `spi_master`**)把该项保留为 FAIL 显示,不做静默放行。**
若用户后续接受偏离,应在报告里连同 5.3 的边界一起写明,而不是把这条检查删掉。

---

## 6. 未覆盖项(不得把本报告当成"AD9833 已经能用"的证据)

| 未覆盖 | 说明 |
|---|---|
| ❌ **未上板** | AD9833 实物是否真接受这 4 帧、是否真输出 1 MHz,**一次没测** |
| ❌ **未综合、未做时序分析** | 本报告只有功能仿真,没有资源/时序数据 |
| ❌ **`PWR_WAIT` 真值未跑** | 测试台把它压成 1000 拍。「等 200 ms 够不够晶振起振」未验证 |
| ❌ **板载 MCLK 频率未验证** | `f_out = 999 999.9776 Hz` 是按**板载 25 MHz 晶振**算的;晶振实际频率未测 |
| ❌ **复位流程未单独验证** | 本次只验了「帧0 置 RESET=1、帧3 清 RESET=0」;未验手册 p16 所述「复位不清频率/相位/控制寄存器」 |
| ❌ **`t8` 判定未结案** | 见 §5.3 边界 |
| ✅ **~~`io.xdc` 尚未加这三根引脚~~ 已加**(2026-09-20 第 18 次) | `adc_sync=V12` / `adc_sclk=W14` / `adc_mosi=V15`(J4 第 31/33/35 脚,BANK34)。⚠️ **未经实际接线核对**,见 §9 |
| 🔴 **上板首测失败** | 2026-09-20 第 19 次:模块输出是 **500 mV 直流直线**,根因未定位。见 §9 |

---

## 7. 归属说明(CLAUDE.md §6.0)

**本测试台由 Claude 代写**,属 §6.0 的**显式例外**:用户原话「**我新建了 adc_9833 的 tb 文件帮我设计完并记录结果**」。
原文件是 Vivado 生成的空壳(只有 `module tb_adc_9833(); endmodule`),由 Claude 补完。
**如实记录,不包装成用户所写。**

被测对象 `adc_9833.v` 同样是 Claude 代写(用户 2026-09-20 明确要求,见 `LLM-014`)。
⇒ **本次是「模型写的代码 + 模型写的判据」,证据强度低于 `tb_dac_1220`(那份至少被测对象是用户写的)。**
引用时请把这一条限制一并带上。

### 7.1 一条工具陷阱(实测,值得进 skill)

**xsim 2025.2 在 `%s` 里打印宽向量时,会破坏非 ASCII 字节。**

实测证据:`chk` 任务里 `$display("  PASS | %0s", label)`,`label` 是 `reg [8*128-1:0]`。
标签 `"init 帧0 = 0x2100"` 中的 `帧`(`e5 b8 a7`)输出成了 `ff ff ff e5 ff a7`。

```
期望: 69 6e 69 74 20 e5 b8 a7 30 20 3d 20 30 78 32 31 30 30
实测: 69 6e ff ff ff e5 ff a7 30 20 3d 20 30 78 32 31 30 30
```

**内联 `$display("…中文…")` 完全正常**(日志里是标准 UTF-8)。
所以约定是:**中文写在内联 `$display` 里,`chk` 的标签一律写英文。**
`tb_dac_1220.v` 的 `chk` 标签恰好全是 ASCII,所以此前从未暴露。

---

## 8. 复现命令

```bash
export PATH=/home/hyp/xilinx/2025.2/Vivado/bin:$PATH
REPO=/home/hyp/Desktop/qrs_2026_fpga
mkdir -p /tmp/tb_adc9833 && cd /tmp/tb_adc9833

xvlog $REPO/src/rtl/spi_master.v $REPO/src/rtl/adc_9833.v $REPO/sim/tb_adc_9833.v
xelab tb_adc_9833 -s tb_sim
xsim  tb_sim -R | tee run.log
```

> ✅ **【2026-09-20 更新,第 18 次会话】上面这条命令现在可以跑了。**
> 写这份文档时它**跑不通** —— `src/rtl/adc_9833.v` 当时**尚未同步进仓库**(只在 Vivado 工程
> `qrs.srcs/sources_1/new/` 里),当时的绕行办法是把第 2 个参数换成工程内路径。
> 该文件已同步,`diff -q` 与工程副本**逐字节一致**(5 199 B)。
>
> 📌 **保留这段历史是有意的** —— 这是**第二次**在"最后写复现步骤"环节暴露出文件没同步
> (第一次是 `LLM-013` 的 `qrs.v` / `io.xdc`)。**复现命令应当当作交付验收项来写** ——
> 写一条"看着能跑、其实跑不了"的命令,比不写更糟。

要复现变异测试,按 §4 的表改对应一处后重跑即可(改动是单点 `sed`,原始的变异源文件未入库)。

---

## 9. 上板首测记录(2026-09-20 第 19 次)—— 🔴 失败,根因未定位

> ⚠️ **本节不是仿真结果**。现象由**用户口述**,Claude **未直接观察**;
> 本节**没有任何测量数据**,只有一个排查路径。

### 9.1 现象

AD9833 接上板后:

```
输出 = 一条 500 mV 的直流直线(**没有** 1 MHz 正弦)
```

### 9.2 手册给的三种成因(全部有原文出处)

| 成因 | 位 | 手册原文(中文 Rev. E `表6`) |
|---|---|---|
| **RESET = 1** | D8 | 「Reset = 1时可将内部寄存器复位至0,**对应于中间电平的模拟输出**」 |
| **SLEEP1 = 1** | D7 | 「内部MCLK时钟会被禁用,DAC输出则**保持其预设值**,因为NCO不再执行累加」 |
| **FREQREG = 0** | — | 相位累加器不累加 → 恒定 |

**三者都表现为直流,且都指向同一个根因:SPI 没通,或者 MCLK 没跑。**

### 9.3 ⚠️ 先排除量具 —— 500 mV 这个数本身对不上

手册规格(`表1`,RSET = 6.8 kΩ):**VOUT 最大 650 mV / 最小 38 mV / 典型 0.6 V p-p**
⇒ **中间电平 ≈ 344 mV**。用户测得 **500 mV** —— **差值未解释,不做断言**。

> 🔴 **必须用示波器 + DC 耦合 + 时基 ~0.5 µs/div。**
> **万用表 DC 挡测一个正常工作 1 MHz 正弦,读数就是平均值(≈ 344 mV),
> 本来就看不出有没有振荡** —— 是本次最可能的一种假象。

### 9.4 排查判据:先量 FPGA 侧,把问题劈成两半

| 信号 | 球号 | J4 脚 | 底板网络名 |
|---|---|---|---|
| `adc_sync` | **V12** | 31 | CMOS_D6 |
| `adc_sclk` | **W14** | 33 | CMOS_PCLK |
| `adc_mosi` | **V15** | 35 | CMOS_PWDN |

**期望波形**:上电后约 **200 ms** 出现 **4 段突发**(`0x2100 / 0x570A / 0x428F / 0x2000`),
每段 16 个 SCLK,**SCLK 空闲为高**(CPOL=1);约 800 ms 由 `set_in` 再触发一轮。

| FPGA 三根脚 | 模块 VOUT | 结论 |
|---|---|---|
| 没有波形 | 直流 | 问题在 **FPGA 侧** |
| 4 段波形正常 | 直流 | 问题在 **模块侧** |

### 9.5 三个头号嫌疑(按可能性排序,**一个都还没排除**)

| # | 嫌疑 | 依据 / 动作 |
|---|---|---|
| ① | **bitstream 是旧的** | `V12/W14/V15` 是**刚加进 `io.xdc`** 的 —— 没重跑综合→实现→生成位流的话,**这三个球根本没被驱动**。**先确认板上跑的是哪一版** |
| ② | **三根线接错** | 用万用表**蜂鸣挡**逐根对,**别信丝印**(`CLK` 的歧义见 §9.6) |
| ③ | **MCLK 停振** | 量 U1 第 5 脚;MCLK 停 → NCO 不累加 → 恒定直流 |

### 9.6 附带查清的两条硬件事实(有出处,可写报告)

**① 「板子有 5 V」≠「IO 是 5 V」**

| 层 | 结论 | 出处 |
|---|---|---|
| 开发板输入 | **DC 6~16 V**(板载 DC-DC),**不是 5 V** | 开发指南 V3.4 §29 |
| J4 电源脚 | **第 40 脚 = +5 V,第 38 脚 = +3.3 V,37/39 = GND** | `docs/board_pins.md` |
| 🔴 **IO 电平** | **PL 三个 BANK(BANK13/34/35)全部 3.3 V ⇒ 所有 PL IO 都是 3.3 V** | 指南原文:「这 3 个 BANK 的供电均为 3.3V(即 PL 端所有 IO 的电平均为 3.3V)」 |

⇒ **J4 第 40 脚可以给模块供 5 V,但 J4 上任何信号脚都不能承受 5 V。**

**② `MCLK` ≠ `SCLK`**

| 名字 | U1 引脚 | 作用 | 模块上 |
|---|---|---|---|
| **MCLK** | **第 5 脚** | DDS **主时钟**,定输出频率 | **焊死板载 25 MHz 晶振** |
| **SCLK** | **第 7 脚** | **SPI 串行时钟**,只搬数据 | **引到接口排针** |

判据 = 模块自带 STM32 demo **只驱动三根线**(`HARDWARE/AD9833/Communication.h:62-64`:
`AD9833_FSYNC=PAout(3)` / `AD9833_SCLK=PAout(4)` / `AD9833_SDATA=PAout(5)`,**全文无 MCLK 控制**)
⇒ **模块把主时钟焊死成板载晶振,接口上不引出** ⇒ 接口上标 `CLK` 的那根**就是 SCLK**。
这是决策 **D10** 的一手依据。

### 9.7 🔴 上电前必须确认的一项(直接关系硬件安全)

模块上那颗 3 脚稳压器 **`U2` 的具体型号在 `AD9833-DDS.pdf` 的文字层里取不到**
(只有网络名 `VCC` / `OUT` / `GND`)。**因此无法判断它是不是 5 V→3.3 V 的 LDO**,这决定了:

- 是 LDO ⇒ 模块 VCC 接 **J4 第 40 脚(+5 V)**,其信号脚输出即 3.3 V,**与 FPGA 直连安全**;
- 不是 LDO(直通)⇒ 接 5 V 会让信号脚也变 5 V,**必须改接 J4 第 38 脚(+3.3 V)**。

**动作:量模块 VCC 脚对 GND 的静态阻抗,或直接看 `U2` 丝印。**

### 9.8 未验证项(引用时不得跳过)

- 🔴 **根因未定位** —— §9.5 三个嫌疑**全是假设,一次测量都还没做**;
- 🔴 **非综合、非上板波形,无任何测量数据**;
- ⚠️ **ILA 里没有 `adc_*` 三根线** —— 改 `ila_0` 的 probe 数(4 → 7)要回 IP 目录**重新生成**,
  **不是文本能改的**;
- ⚠️ `t8` 判定仍未结案(见 §5.3)。

---

*报告人:Claude · 2026-09-20*
