dsgmxc/2026_fpga_qrs/board/measurements/20261025_ai_detection_board.md

# 2026-10-25 上板验收:AI 异常检测做进界面

- **板卡**:正点原子领航者 ZYNQ-7020
- **位流 md5**:`c92c7ed5b7d695dee73d86abc1c6089c`(与工作区 `board/qrs.bit` 一致)
- **`c_ui` md5**:`92cad4131b74949aadbfcf9f6f1fadd0`(板上原生 `make -j2` 产出,零告警)
- **服务**:`qrs-ui.service` 本次上电启动一次(即唯一一次位流加载),验收后 `stop` + 关机
- **配置**:FCLK0 **50.0000 MHz** · 激励 **1.000 MHz** · 采样 **32.50 MSPS**(`0x88 = 0x00104`,DIV=4 / PH_OFF=+1) · 挡位 **0x2(100 Ω)** · 扫压驻留 300 ms

## 一、宿主之外的第一层验证:板上原生单测

`test_anomaly_detect` 在板载 A9 上编译运行(**ALL OK**),基线三腿得分
**0.0012 / 6.3e-5 / 6.1e-6**,注入 ×1.10 后 **1710.54 / 711.99 / 53.19**。
⚠️ 与宿主 x86 的 1709.20 / 711.96 / 53.17 差 **0.08 %**,量级来自 `pow`/`log10` 的 libm 实现差异;
阈值判级完全不受影响(两者都远离 25 / 100 的边界)。

## 二、三腿扫压

```
[proto] 扫压开始:CISS+COSS+CRSS,0.10 V → 100.00 V,60 点/腿,每点 300 ms
[proto] CISS 腿跑完(60 点),接着跑 COSS
[proto] COSS 腿跑完(60 点),接着跑 CRSS
[proto] 扫压结束:CRSS,共 60 点已下发到 DAC
[proto] 采集自洽账本:实际采 181 次,判据拒收 0 次,重采救回 0 点,判无效 0 点(CV_ADC_TRIES=3)
```

180/180 点有效,OTR 全 0。三腿电压轴逐点相同;首点 / 次点比 **1.001 / 1.004 / 0.973**
(10-24 换腿稳置修复的判据是「接近 1」,本次复现,未见 10-24 之前的 0.55 / 0.34)。

| 腿 | Cs @ 0.1 V | Cs @ 100 V |
|---|---:|---:|
| CISS | 3379.531 pF | 2020.981 pF |
| COSS | 3565.715 pF | 83.770 pF |
| CRSS | 1741.723 pF | 9.918 pF |

原始日志:`report/measurements/artifacts/20261025_ai_detection_qrs-ui.log`(md5 `54819d3e…`,4196 行)
逐点 CSV:`report/measurements/artifacts/20261025_ai_detection_3legs_60pt.csv`(从日志解析,60 行 × 4 列)

## 三、AI 评分

```
[ai] CISS 得分 0.1 -> 正常(n=60, 最大偏离=V75/V25 比 -0.001 log10)
[ai] COSS 得分 0.0 -> 正常(n=60, 最大偏离=100V 电平 -0.000 log10)
[ai] CRSS 得分 5.2 -> 正常(n=60, 最大偏离=100V 电平 +0.018 log10)
```

| 腿 | 得分 | 等级 | 对照 |
|---|---:|---|---|
| CISS | **0.1** | 正常 | 10-24 基线 0.001;阈值 25 |
| COSS | **0.0** | 正常 | 10-23 同配置复跑 0.79 |
| CRSS | **5.2** | 正常 | 留一法最大 3.94、两两最大 9.02、阈值 25 |

**CRSS 的 5.2 高于留一法最大 3.94** —— 它是「换一颗健康器件」侧的分差(两两最大 9.02),
不是故障;模型设计时就以两两距离而不是留一法定阈值,原因即此(见 `LLM-079` §三)。

界面抓帧:`report/measurements/artifacts/20261025_ai_tab.png`
(结果页第 6 页签「AI 检测」,旋转 180° 还原后;三行判词与页脚判据全部正常显示,
无缺字方框 —— 字库白名单核对在 `LLM-079` 纠错 ③)。

## 四、收尾

| 动作 | 读数 |
|---|---|
| `systemctl stop qrs-ui` | `inactive` |
| 偏压 `0x14` | `0x00000`(0 V) |
| 继电器 `0x1C` | `0x10`(**ALL_OFF**) |
| `systemctl is-enabled qrs-ui` | **disabled** |
| `sync` + `shutdown -h now` | 执行;25 s 后 ping **100 % 丢包** |

## 五、结论与边界

- ✅ AI 检测**已上板可用**:扫压结束自动评分、日志有 `[ai]`、界面有判词。
- ✅ 健康件三腿全部判「正常」,与宿主单测、Python 原型一致。
- ⚠️ **本轮没有故障样本**:「能检出异常」的判据仍来自合成注入(×1.05/×1.08/×1.1/×1.2/×1.3),
  **不是**一颗真坏器件。报告里必须这么写,不能写成"实测检出故障"。
- ⚠️ 模型只在 **1 MHz / 32.5 MSPS / 自动挡位**下声明有效;换配置或改标定须用
  `src/c_ui/tools/fit_anomaly_model.py` 重出常数。
