dsgmxc/2026_fpga_qrs/board/measurements/20261023_three_leg_full_sweep.md

# 2026-10-23 三腿全量扫压记录(CISS+COSS+CRSS,0.1→100 V,60 点/腿)

> 数据来源:板上 `/var/log/qrs-ui.log` 第 **10617–10989** 行(本轮最后一次扫压),
> 原样存档 `artifacts/20261023_qrs-ui.log`(md5 `a4cd23b7d40dc487055e1cc21a753172`,
> 1112982 B)。
> 逐点表:`artifacts/20261023_sweep_3legs_60pt.csv`(md5 `c4ace5ec92673222d54c92bf487d8b1c`,180 行)。

## 运行条件(从日志逐字取)

| 项 | 值 |
|---|---|
| 位流 | `c92c7ed5b7d695dee73d86abc1c6089c` |
| `c_ui` | `ce35bc8f77452bdbedb4a529cd0b31ab`(含「全部」页三卡显示修复,2026-10-23) |
| 激励 | 1.000 MHz |
| 采样 | 32.50 MSPS(DIV=4,PH_OFF=+1) |
| 挡位 | **B = 100 Ω**(`0x18 = 0x2`,全部 180 点回读一致) |
| 扫压 | 0.10 → 100.00 V,60 点/腿,指数间隔,驻留 300 ms |
| 腿序 | CISS → COSS → CRSS(逐腿切继电器) |
| 采集自洽账本 | 实际采 **206 次**,判据拒收 0,重采救回 0,判无效 0(`CV_ADC_TRIES=3`) |

## 每条腿的首末点

| 腿 | n | Cs @0.1 V | Cs @100 V | D @0.1 V | D @100 V | A 峰峰最大 | B 峰峰最大 | OTR 非零 |
|---|---:|---:|---:|---:|---:|---:|---:|---:|
| CISS | 60 | 3375.84 pF | 2025.68 pF | 0.1718 | 0.1383 | 1266 | 1012 | 0/60 |
| COSS | 60 | 1884.89 pF | 83.90 pF | 0.1047 | 0.0824 | 1644 | 1028 | 0/60 |
| CRSS | 60 | 596.34 pF | 9.49 pF | 0.7887 | 0.1344 | 1358 | 437 | 0/60 |

★ **本轮 180 点 OTR 全部为 0** —— 10-15 记录的「CRSS 高压坏点」本次**未复现**;
A 峰峰全程 1139–1644 码(未到 4095 轨)。
⚠️ 这是「本次运行的观测」,不构成「坏点已解决」—— 两者差一个根因。

## 关键电压点(取最接近目标电压的实测点;完整 60 点见 CSV)

### CISS

| 目标 V | 实测 V | Cs pF | Cp pF | D | I mA | A 峰峰码 | B 峰峰码 |
|---:|---:|---:|---:|---:|---:|---:|---:|
| 0.1 | 0.100 | 3375.84 | 3279.07 | 0.1718 | 2.4468 | 1188 | 1011 |
| 1 | 1.040 | 3038.62 | 2959.58 | 0.1634 | 2.4199 | 1203 | 1002 |
| 10 | 9.617 | 2149.05 | 2106.85 | 0.1415 | 2.2908 | 1254 | 947 |
| 50 | 49.535 | 2037.50 | 1999.22 | 0.1384 | 2.2649 | 1264 | 936 |
| 100 | 100.000 | 2025.68 | 1987.67 | 0.1383 | 2.2621 | 1266 | 935 |

### COSS

| 目标 V | 实测 V | Cs pF | Cp pF | D | I mA | A 峰峰码 | B 峰峰码 |
|---:|---:|---:|---:|---:|---:|---:|---:|
| 0.1 | 0.100 | 1884.89 | 1864.47 | 0.1047 | 2.2425 | 1271 | 926 |
| 1 | 1.040 | 2593.16 | 2559.61 | 0.1145 | 2.3945 | 1220 | 990 |
| 10 | 9.617 | 399.82 | 315.39 | 0.5174 | 0.7543 | 1541 | 290 |
| 50 | 49.535 | 115.84 | 115.10 | 0.0803 | 0.2873 | 1637 | 124 |
| 100 | 100.000 | 83.90 | 83.33 | 0.0824 | 0.2089 | 1644 | 94 |

### CRSS

| 目标 V | 实测 V | Cs pF | Cp pF | D | I mA | A 峰峰码 | B 峰峰码 |
|---:|---:|---:|---:|---:|---:|---:|---:|
| 0.1 | 0.100 | 596.34 | 367.64 | 0.7887 | 0.7429 | 1256 | 309 |
| 1 | 1.040 | 1284.38 | 515.45 | 1.2214 | 1.0169 | 1179 | 422 |
| 10 | 9.617 | 48.69 | 40.34 | 0.4549 | 0.0888 | 1331 | 42 |
| 50 | 49.535 | 12.35 | 12.03 | 0.1628 | 0.0251 | 1357 | 17 |
| 100 | 100.000 | 9.49 | 9.33 | 0.1344 | 0.0195 | 1358 | 13 |

## 二维码载荷(扫压结束自动生成,取自同段日志)

```
[qr] Rg 未知,回退 3.60 Ω(与前序一致)
[qr] ACV1 12 节点 / SCV1 141 点 / URL 1223 B / CRC acv1=0x06b6c3db scv1=0xb5aba750 / 0.1000-100.0000 V
```

## 本次数据里两个「看起来反常」的点(只记录,不解释)

1. **COSS 在 0.1–1 V 段非单调**:0.100 V → 1884.89 pF,1.040 V → 2593.16 pF,9.617 V → 399.82 pF。
   低偏压段先升后降,与「Coss 随 Vds 单调下降」的预期不符;原因未查。
2. **CISS 的 Cs 也随偏压下降**(3375.84 → 2025.68 pF),幅度约 −40%。
   若 CISS 腿拓扑确实含 Cgd 分量,这可以解释;但**必须先有夹具原理图才能判断**,
   本轮不据此下结论。

## 口径与边界(不得越界引用)

- `Cs / Cp / D` **全部未标定**(`VFS_PP` / `R_TIA` 仍是纸面值),**只能比较形状与相对变化**,不能当绝对电容值。
- 全部 180 点都在 **DIV=4(32.5 MSPS)+ B 挡(100 Ω)**;引用绝对值必须带上这两个条件与日期。
- 本轮**没有**逐点万用表比对,也没有夹具原理图 ⇒ 数据是「系统自报值」,不是「已溯源的测量值」。
- 屏上曲线页未抓拍(需要手指点击导航);数据以日志/CSV 为准。
