dsgmxc/2026_fpga_qrs/board/measurements/20261015_delivery_repo_state_audit.md

# 交付仓库现状核对(2026-10-15)

> **起因**:用户问「**仓库现在是最新吗,不是的话就更新**」。
> **结论**:**仓库整体是最新的,但发现 1 处真缺口 + 5 个未入库工具** —— 已补。
> **⚠️ 其中 1 处是硬缺口**:交付仓的 RTL **建不出**它自己发布的那份位流。

---

## 一、方法(以及为什么不能只看 `git status`)

`git status --short` 为空 **只能证明"已提交",不能证明"与源头同步"**。
真正的源头有三个,方向各不相同:

```
Vivado 工程   /home/hyp/Desktop/fpga_pro/qrs/qrs.srcs/…   ← RTL 的真源头
     ↓ (综合)
部署位流      qrs.runs/impl_1/system_wrapper.bit            ← 板上跑的那份
     ↓
交付仓库      ~/Desktop/qrs_fpga_2026/                      ← 发布物
```

⛔ **`rsync -rcn` 报"有差异"不指示方向**(本项目已踩过三次,
见 `llm-log/LLM-068.md` 纠错轨迹第 6 条)。
⇒ 本次**逐文件**核 **md5 + mtime + 内容 diff**,方向靠时间链定,不靠工具输出。

---

## 二、结果:仓库 vs 工作区(606 个跟踪文件)

| 类别 | n |
|---|---|
| 两边都有、内容一致 | **562** |
| 两边都有、**有差异** | **6** |
| 仅仓库有(工作区没有对应项) | 38 |

### 那 6 处差异 —— **全部是仓库更新/更正确**,逐条判过方向

| 文件 | 工作区 | 仓库 | 判据 | 结论 |
|---|---|---|---|---|
| `.gitignore` | 348 B · 09-19 | **4535 B · 10-15** | 仓库版含"8 条失效规则修活"的实测说明 | 仓库**新** |
| `README.md` | 4438 B · 10-02 | **11573 B · 10-08** | 体积 2.6×、日期晚 6 天 | 仓库**新** |
| `board/qrs.bit` | `232c649d…` · 10-14 | **`c92c7ed5…` · 10-15** | 与 `impl_1` 当前位流逐位相同 | 仓库**对** |
| `board/…/20261005_dac_dds_ui_endtoend.md` | `report/…` 前缀 | **`board/…` 前缀** | `diff` 只差路径前缀,仓库那侧与本仓目录结构一致 | 仓库**对** |
| `src/rtl/swm.v` | 1572 B · 09-26,**缺 `endmodule`**、复位分支未包 `begin/end` | **1569 B · 09-29** | 仓库版是**修好的**,工作区那份编译不过 | 仓库**对** |
| `src/rtl/dac_1220.v` | 7474 B · 09-19 | **9312 B · 10-12** | 日期晚 23 天、体积大 25% | 仓库**新** |

⇒ **工作区在这 6 处全部落后**,不需要从工作区往仓库推任何东西。

---

## 三、★ 真缺口:交付仓的 RTL **建不出**它自己发布的位流

**症状**:`src/rtl/adc_capture.v` 在交付仓与 Vivado 工程里**不是同一份**。

| | md5 | 时间 | 状态 |
|---|---|---|---|
| Vivado 工程 | `4c98f8035bafda15962af99a63ca8699` | 2026-10-14 **23:39** | 含「**记录起点恒取 A 的刻度**」修复 |
| 交付仓 | `cc5dccf4f2dac71d0d20aa03c7cacba8` | 提交 `1eeec9e` 2026-10-14 **22:35** | **修复之前**那一版 |
| 部署位流 | `c92c7ed5b7d695dee73d86abc1c6089c` | 2026-10-15 **18:21** | 由**工程那一份**建成 |

### 判据:时间链把"源码 → 位流"钉死

```
源码 mtime   10-14 23:39   ─┐
                            ├─⇒ 位流 mtime(10-15 18:21)晚于源码
位流 mtime   10-15 18:21   ─┘   ⇒ 【位流里一定含这一版源码】

交付仓提交   10-14 22:35   ⇒ 【交付的是修复之前那一版】⛔
```

**这条推理不用打开 Vivado、不用重跑综合**,只需要三个时间戳。
⚠️ **方向只能单向用**:位流比源码**晚**能证明"含";
位流比源码**早**证明不了"不含"(可能是改完没重建)。

### 修复内容(为什么这不是"无关紧要的一版")

被漏掉的改动把采集记录窗口的起点从「GO 之后**第一个命中的刻度**」
改成「**恒取 A 的刻度**」。原写法下 GO 撞在采样周期内的位置是**硬币**:
先撞上 A ⇒ 两路的第 0 个样本同属转换 X(配对正确);
先撞上 B ⇒ B₀ 在转换 X、A₀ 在转换 X+1,**错开一整个转换**,
⇒ 文件头「两路第 k 个样本来自同一个转换 k」的**相位原点不变式当场失效**。

文件自己记了实测指纹(DIV=4):两簇间距 **11.070°** vs 预测 **11.077°**(差 0.007°),
`|VH|/|VL|` **逐位不变**(整数样本平移不改 DFT 幅值)
⇒ **Re Z 只动 ~1.5%,而 Im Z / Cs / D 跳 30–70%** —— 即用户报告的**「读数比较跳跃」**。

### 处置

把**工程那一份**拷进交付仓(**不是反过来**),两边 md5 现已一致
(`4c98f803…`);并在 `skill/stale-artifact-silent-reuse/` 记为**第五种形态**。

> ⚠️ **诚实标注**:这次修复**没有任何 `llm-log` 记录**。
> 全库检索 `start_tick` / `rec_go` / `记录起点` / `11.070` **均 0 命中**;
> 它的设计依据**只写在 RTL 文件自己的头注释里**。
> ⇒ 本次**只同步 + 如实记载,不代写交互记录**(`CLAUDE.md` §6.2 红线)。

---

## 四、补入库的 5 个工具(工作区 `tools/` → 仓库 `board/`)

| 文件 | 用途 | 安全性 |
|---|---|---|
| `adc_buf_dump.py` | dump **冻结**的采集缓冲(只读,不写 `0x88`/`0x8C`) | 只读 |
| `adc_cfg_probe.py` | 主动触发采集,逐档比对采样刻度(**写** `0x88`/`0x8C`) | ⚠️ 写 |
| `board_run.py` | **宿主机侧** SSH 跑命令 / 传文件(paramiko) | 只做 SSH,不碰位流。**⚠️ 入库前已改掉写死的口令**,见下 |
| `relay_set.py` | 一次性设回路/挡位,**写完即退,不回滚** | ⚠️ 写 |
| `relay_smoke.py` | ⛔ **已作废**,仅指向 `relay_rw.py`;保留是为挡住"再写一次 `Overlay(download=True)`" | — |

**为什么入库**:仓库 `board/` 里**已有**它们的 5 个同类
(`adc_probe.py` / `adc_timing.py` / `fb_dump.py` / `relay_hold.py` / `relay_rw.py`),
md5 逐一对齐(全一致);**只缺这 5 个** ⇒ 补齐才成套(M4 实测输出 / B5 复现性)。

### 🔴 `board_run.py` 的写死口令 —— **入库前已改掉(本次的一处真拦截)**

原文件把口令**以字面量写死在源码里**(用的是 **PYNQ 出厂默认口令**,此处不复述其值)。
虽然出厂默认本身是公开信息,但把它**提交进公开仓库**等于**发布一份可用凭据**,
而且**提交过一次就永久留在 git 历史里** —— 之后再改文件也删不掉。

**改法**(不改工具能力,只去掉内置口令):

```python
HOST = os.environ.get("QRS_BOARD_HOST", "192.168.2.99")   # 拓扑:有默认值
USER = os.environ.get("QRS_BOARD_USER", "xilinx")
PASS = os.environ.get("QRS_BOARD_PASS")                   # ⛔ 口令:无默认值
PORT = int(os.environ.get("QRS_BOARD_PORT", "22"))
```

`connect()` 开头加一道守卫:口令为空时**明确报错并提示怎么设**,而不是回落到任何默认值。

**顺带做的**:全仓扫一遍「**赋值型口令字面量**」
(即 `口令变量 = "…字面量…"` 这种形状,`--include` 限定 `*.py|*.c|*.h|*.sh|*.tcl`)
——**零命中**;本次新增的 5 个工具逐个单独扫,**全部干净**。
> 📌 本条**只记手法、不复述被扫出来的值** —— 见下面那条教训。

> 📌 **教训一**:**"这是个调试脚本"不是"它可以带凭据"的理由。**
> 判断标准是**它会不会被提交 / 被发布**,不是它重不重要。
>
> 📌 **教训二(本次自己又踩了一次)**:**"把口令写进修复说明文档"和"把口令写进源码"
> 是同一件事。** 我第一版这份核对记录里,为了说清"原来错在哪",
> 把那个口令**逐字抄进了正文**;commit message 里也抄了一遍 ——
> **那等于换个文件、换次提交,再泄漏一遍。**
> ⇒ 正确写法:**只描述形状,不复述值**(本段现在就是这么写的)。
> **"引用"不是"泄漏"的豁免理由。**

---

## 五、**没有**入库的东西,以及理由

| 项 | 为什么不入库 |
|---|---|
| `docs/dev_handbook.md` | ⛔ **项目红线**:含口令与内部判断,**永不进交付仓库** |
| `docs/project_state.md` | 工作区专用的进度文档,一直未入库(既定分工) |
| `report/source_design_checklist.md` | **内部规格**(寄存器映射 / 集成流程 / 窗口表)。是否作为 M8 素材**由用户定**,本次不擅自加 |
| `backup/`(7.9 MB) | 旧位流 + 旧 PS python 快照,`stale-artifact` 家族的**原件**,不宜作交付物 |
| `board_stage/`(4.1 MB) | 推板用的暂存副本(比现行位流旧),非交付物 |
| `src/c_ui/build/**`(≈370 个 `.o/.d` + `c_ui` 二进制) | 构建中间产物,`make` 可再生 |
| `vivado*.jou` / `vivado.log` | 仓库**顶层那 8 个是未跟踪文件**,`.gitignore` 已正确忽略,**不在版本库里** |

---

## 六、同轮排查里的两个**假警报**(记下来,免得下次再查一遍)

1. **`io.xdc` 不在仓库里** —— 一度以为缺约束。
   实际:`grep -c 'io.xdc' qrs.xpr` = **0**,它**不在工程的构建链上**。
   ⇒ **盘上存在 ≠ 工程在用。"仓库缺某文件"不等于"仓库有缺口"。**
   (与 `stale-artifact` 形态 2 是同一枚硬币的两面:那一次是"`grep` 配置文件
   不能证明工具**没**引用",这一次是"`ls` 目录同样不能证明工具**在**引用"。)
2. **`tools/` 与 `board/` 同名文件** —— 一度以为两份会漂移。
   实际:两边**同名文件 md5 全一致**,差异只在"仓库缺的那 5 个"。

---

## 七、仍然敞着的口子

- ⛔ **工作区 `src/rtl/` 是 9 月的 5 文件残本**(仓库那份才是真本 17 个文件)。
  **谁若从工作区部署会拿到错的 RTL。** 本次未动工作区 —— 建议后续**直接删掉**
  这个残本目录,或改成指向 Vivado 工程的说明文件(需用户拍板)。
- ⚠️ **板子当前断电**,无法核 `/home/xilinx/` 那两棵树与仓库的对齐情况
  ⇒ **本次核对只覆盖"工程 ↔ 仓库"**,板上那棵**未核**。
- ⚠️ `report/source_design_checklist.md` 的归属未定(见 §五)。
- ⚠️ 时链法只能证明"交付源码**可以**建出该位流",
  **不能**证明"板上跑的就是这一版" —— 那需要板上 `Overlay()` 后的回读。

---

## 八、证据清单

| 项 | 值 |
|---|---|
| 仓库跟踪文件 | 606 |
| 一致 / 有差异 / 仅仓库 | 562 / 6 / 38 |
| 修的 RTL | `src/rtl/adc_capture.v` → `4c98f8035bafda15962af99a63ca8699` |
| 补的工具 | `board/{adc_buf_dump,adc_cfg_probe,board_run,relay_set,relay_smoke}.py` |
| 部署位流 | `board/qrs.bit` = `c92c7ed5b7d695dee73d86abc1c6089c` |
| 构建报告一致性 | `build/*.rpt` 四份与 `qrs.runs/impl_1/` **md5 全一致**(WNS +0.316 / 0 DSP / 1790 LUT) |
