dsgmxc/2026_fpga_qrs/board/measurements/20261015_crss_bad_points_root_cause.md

# CRSS 高压端「坏点」的根因分析(2026-10-15 第 64 次会话)

> **起因**:用户 2026-10-14 原话 ——
> 「**我发现 50 附近测量 CRSS 确实容易出问题**」「**我看到的调试界面就是下面那个曲线有波动不太干净的正弦波**,
> 你先分析一下这些坏点原因导致的」。
>
> **一句话结论**:坏点**不是噪声、也不是解调算错** —— 是**采集缓冲里混进了 1–10 个打到 ADC 满量程轨的样本**。
> 它**既挑回路(只有 CRSS)、又挑偏压(只在 ≥40 V)**;在 CRSS@50 V / 55 V 上,坏捕捉分别占 **73% / 89%**。
> `adc_otr` 这根 **ADC 自己的溢出引脚**在"峰峰占满"的 13 个捕捉里 **13/13 都置起**,
> 而在 213 个干净捕捉里 **一次都没有(0/213)** ⇒ 天平压向**模拟侧真的过载了**,不是 PL 读错总线。
> ⚠️ **但这不等于数字侧已经排除** —— 见 §六、§九。

---

## 一、数据来源与运行条件

| 项 | 值 |
|---|---|
| 原始日志 | 板上 `/var/log/qrs-ui.log` 拉到主机 `/tmp/qrs-ui-final.log` |
| 文件 | **949465 B · 9211 行** · md5 **`809f9c5898362d6b46b63095ba7335c1`** |
| 分析窗口 | 日志第 **7964 – 9211 行**(最后一次 `c_ui 启动` 到日志末尾,进程未再重启) |
| 位流 | `c92c7ed5b7d695dee73d86abc1c6089c`(10-15 第 61 次构建) |
| `c_ui` | 2864832 B,md5 `887812b56c9de93f02ad7793bf0349f0`(含自洽判据 + 重采) |
| 激励 | `0x80 = 0xA3D70A` = **1.000 MHz** |
| 采样 | `0x88 = 0x00104` ⇒ DIV=4,PH_OFF=+1,窗 `[+0,+1]` ⇒ **32.50 MSPS** |
| 重采上限 | `CV_ADC_TRIES` 未设 ⇒ **3** |
| 判据 | `码 ≤ 3.0 × 2×幅值 + 64`(单边) |
| 档位 | 中途被用户换过:`0x1`(10 Ω)/ `0x2`(100 Ω)/ `0x4`(1 kΩ) —— **本次分析按日志里 `Z` 行自报的 `R0` 区分** |

> ⛔ **口径纪律:同一份日志里有 11 个 `c_ui 启动` 段,采样配置不全一样。**
> 早期 4 段是 `0x0FF02`(DIV=2,**65.00 MSPS**),后面 7 段才是 `0x00104`(DIV=4,32.50 MSPS)。
> **本分析只取严格格式(带 `码/期望` 与 `采 N 次` 两列)的 245 条证据行 —— 逐条核过,
> 245/245 全部落在 `0x00104` 那一段**(旧格式没有这两列,是上一版 `c_ui` 打的)。
> 混用会得到一张自相矛盾的表。

**证据行合计 245 条**,按回路 × 标签:

| 回路 | 扫压 | 单点 |
|---|---|---|
| CISS | 60 | 22 |
| COSS | 60 | 0 |
| CRSS | 60 | 43 |
| **合计** | **180** | **65** |

> ⚠️ 回路归属取自 `[relay] 回路 → X(0xNN)` 这行 —— 它是 `c_ui` **真的写了 `0x1C` 并回读确认**之后打的,
> 是**硬件真值**,不是界面按钮状态。(早先 `/tmp/rate2.py` 用 `[proto] 点测 …` 这行归属,
> 而它会在扫压期间残留 ⇒ 把 227 次扫压捕捉全算到「CISS @ 0.10 V」名下。**那个数已作废**。)

---

## 二、坏点在哪

**判据**:一次捕捉里 `ppA ≥ 2000 码`(干净值约 1060–1640,见 §四)。

| 类 | 位置 | n | 占比 |
|---|---|---|---|
| **干净** | 处处 | **213** | 86.9% |
| **低压过载** | 偏压 < 3 V(CISS@0.1V ×1 / COSS@0.23,0.58V ×2 / CRSS@0.2–1.3V ×9) | **12** | 4.9% |
| **高压过载** | **偏压 ≥ 40 V —— 20 条全部在 CRSS** | **20** | 8.2% |

**高压过载逐条(这是本次要解释的那一类)**:

| 标签 | 偏压 V | ppA 码 | ppB 码 | OTR | `码/期望` A / B | 采 |
|---|---|---|---|---|---|---|
| 扫压 | 55.688 | 2348 | 2197 | 0 | 1.75 / **142.37** | 3(判无读数) |
| 单点 | 55.000 | 2627 | 2025 | 0 | 1.95 / **163.10** | 3 |
| 单点 | 55.000 | 3844 | 3967 | **1** | 2.86 / **362.01** | 3 |
| 单点 | 55.000 | 4095 | 3960 | **4** | 3.05 / **66.08** | 3 |
| 单点 | 55.000 | 4095 | 2787 | **3** | 3.06 / **47.05** | 3 |
| 单点 | 55.000 | 3968 | 3932 | **9** | 2.95 / **335.11** | 3 |
| 单点 | 55.000 | 3971 | 4095 | **5** | 2.95 / **252.20** | 3 |
| 单点 | 55.000 | 3953 | 3963 | **6** | 2.93 / **170.70** | 3 |
| 单点 | 55.000 | 3973 | 4095 | **8** | 2.97 / **250.61** | 3 |
| 单点 | 50.000 | 3975 | 4095 | **9** | 2.96 / **310.67** | 3 |
| 单点 | 50.000 | 3969 | 3581 | **10** | 2.96 / **258.88** | 3 |
| 单点 | 50.000 | 2737 | 3107 | **5** | 2.04 / **49.85** | 3 |
| 单点 | 50.000 | 3955 | 4095 | **9** | 3.02 / **83.50** | 3 |
| 单点 | 50.000 | 4081 | 4095 | **9** | 3.05 / **65.67** | 3 |
| 单点 | 50.000 | 4047 | 3918 | **1** | 3.05 / **65.27** | 3 |
| 单点 | 50.000 | 3968 | 3954 | **1** | 2.98 / **64.25** | 3 |
| 单点 | 50.000 | 3700 | 2944 | 0 | 2.76 / **47.59** | 3 |
| 单点 | 50.000 | 3953 | 940 | **1** | 2.96 / **15.70** | 3 |
| 单点 | 50.000 | 2731 | 3109 | **5** | 2.03 / **208.65** | 3 |
| 单点 | 50.000 | 2502 | 1991 | 0 | 1.86 / **139.47** | 3 |

**同偏压多次采到的比例(用户的观察,量化了)**:

| 点 | 证据行 | 其中过载 | 占比 |
|---|---|---|---|
| **CRSS @ 50.000 V** | 15 | **11** | **73%** |
| **CRSS @ 55.000 V** | 9 | **8** | **89%** |
| CRSS @ 0.100 V | 20 | 1 | 5% |
| CISS @ 50 V(扫压 60 点全程) | 60 | **0** | **0%** |

⇒ **同一个偏压(50 V)、同一台设备、同一时刻:CISS 全干净,CRSS 73% 坏。**
**同一个回路(CRSS)换偏压:0.1 V 只有 5% 坏,50 V 有 73% 坏。**
**两个变量都有,不是单因子。**

**扫压侧同一现象**:CRSS 扫压 60 点里,`44.062 / 49.535 / 55.688 / 70.381 / 100.000 V` 五点标了 `采2次` 或 `采3次`
—— 即**第一次捕捉被拒收**(拒收行原文见日志 8500–8545)。**所以 CRSS 高压端的坏捕捉不是只在 50/55 V 两个点,
是一整段(约 ≥40 V)都有,只是 50/55 V 概率高到 3 次重采都不够。**

---

## 三、指纹一:解调是干净的,**炸的只有峰峰**

CRSS 高压端(≥39 V)被采纳的 8 个点 —— 峰峰在跳,解调幅值纹丝不动:

| 量 | 值 |
|---|---|
| A 路解调幅值 | 均值 **0.3274 V**,标准差 **0.0005 V** ⇒ **CV = 0.14%** |
| 同期 ppA | **1348 → 1354** 码 |

**为什么这条重要**:8190 点相干解调对 1–10 个孤立样本**几乎免疫**(权重 10/8190 = 0.12%),
而**峰峰 `max−min` 被单个样本完全决定**。所以:
- **不是解调算错**,也不是基准/正交性坏了;
- **不是整段信号被污染**(那会同时抬高幅值);
- **是"极少数样本的瞬时越界"** —— 这正是下面那条台阶的证据。

---

## 四、指纹二:ppA 落在**离散台阶**上

| ppA 区间 | n | 判读 |
|---|---|---|
| **1060 – 1640** | 213 | 干净,与 `2×幅值` 一致到 ~2% |
| **2348 – 2787** | 16 | **恰好一个**样本打到轨(见下) |
| **3700 – 3844** | 3 | 一端到轨 + 另一端异常远离 |
| **3953 – 4095** | 13 | **两端都到轨**(12 位全刻度) |

**"恰好一个样本到轨"不是比喻,是算出来的**:

```
干净信号(CRSS @ 55.000 V):幅值 A = 0.3275 V
  幅值码 = 0.3275 / 2.0 × 4096 = 671 码
  offset-binary 中心 2048 ⇒ 干净信号跨 [2048−671, 2048+671] = [1377, 2719],pp = 1342(实测 1351 ✓)

若【一个】样本打到上轨 4095,而下沿仍是 1377:
  pp = 4095 − 1377 = 【2718】
实测那一簇:2731 / 2737 / 2740 …  ⇒ 差 <1%
```

⇒ **ppA ≈ 2700 那一簇 = 一次采集里刚好有一个样本被推到 ADC 满量程轨。**
`ppA ≈ 4095` 那一簇 = 上下**两端**都碰到轨(12 位全刻度)。**这不是连续噪声谱,是稀疏的、打到头的越界。**

**换算成电压**(`ADC_SAMPLE_VFS_PP = 2.0 V` ⇒ 4096 码 = 2.0 V ⇒ **0.488 mV/码**,满量程 **±1.0 V**):
A 路正弦本身只有 0.327 V 幅值,**要有一个样本够到 ±1.0 V,输入上必须叠一记约 ±0.7 V 的瞬变**。

**★ A 和 B 一起胀** —— 这是"共模"的直接证据:

| | 干净时 | 坏时 |
|---|---|---|
| CRSS @ 55.000 V,ppA / ppB | 1351 / **32** | 3968 / **3932** |
| 两路真实信号差 | A 幅值 0.3275 V(671 码)vs B 幅值 0.0028 V(**5.7 码**)—— **差 118 倍** | 坏捕捉里 20 条有 **18 条 B 也 ≥2000** |

B 路平时只有 **5.7 码**的幅值(0.28% 满量程),一次瞬变能把它顶到 3932 码
⇒ **这记瞬变是两路共有的**,不是 B 路前端自己的毛病;量级 ≡ 满量程。

---

## 五、★ 决定性证据:`adc_otr`

`adc_otr` **不是 PL 算出来的**,是 **AD9238 自己的输出引脚**(`Y8 / J4-18`,`led.xdc:130`,LVCMOS33)。
厂家手册原文:*"Out-of-Range Indicator for Channel A/B"*(脚 58 / 脚 39),
*"Out-of-range signals indicate an overflow condition, which can be used with the most significant bit to determine low or high overflow"*;
流水线延迟 **7 个时钟周期**(与数据同步),**离开过量程状态需 2 个时钟周期**。
来源:`/home/hyp/Desktop/硬件资料/AD9238模块资料/芯片手册/ADI-AD9238-65.pdf`(Rev. C,2010)。

**逐字 OTR 位**(`cap_mem[wr_addr] <= {3'b000, adc_otr, (adc_d ^ 12'h800)}` → `[12]`)—— 注意这是
**2026-10-14 修好位序之后**才有效的;`0x90[3]` 那根**粘滞**标志是另一个口径,两者不可混用。

| 分组 | n | 其中 `OTR > 0` | 比例 |
|---|---|---|---|
| 干净(`ppA < 2000`) | **213** | **0** | **0.0%** |
| 低压过载 | 12 | 2 | 16.7% |
| **高压过载** | **20** | **16** | **80.0%** |
| └ 其中 `ppA ≥ 3900`(占满) | **13** | **13** | **100%** |
| **全体最大 OTR 计数** | — | **10**(共 16384 个字) | — |

**为什么这条能推**:
1. **干净捕捉 0/213** —— OTR 位不是"随机翻转"的。若采样刻度整体错乱,它该和坏捕捉一样频繁置起。
2. **数据总线是 12 根线,OTR 是独立的第 13 根线。** 一根与数据无关的独立引脚**跟着一起置起**,
   说明**不是数据总线被串扰/读错** —— 是 ADC **自己判定输入越了量程**。
3. **稀疏率对得上**:OTR 计数 1–10 / 16384 字(≈0.006%–0.06%),与"每几百微秒来一记尖峰"的形态一致;
   一条错误采样刻度会**每个周期都错**(8190 次/采),量级差三个数量级。

> ⚠️ **这条证据的边界,必须说清**:`adc_otr` 与 12 位数据走**同一个采样刻度**。
> 所以它排除的是「**总线被串扰 / 数据被读错**」这一类数字故障,
> **不能**排除「**整个采样刻度都错**」。后者要另想办法(见 §七(c))。

---

## 六、天平的另一端:数字侧并没有被排除

**必须如实说的一条既有事实**(`src/constrs/led.xdc` 第 213 行起,md5 `62b45e5568321d4b2465ec89aee68a48`):

```
# ⚠️ ADC 并行数据 adc_d[*] / adc_otr 的【输入时序本版有意不约束】。
#    原因如实记录,不糊过去:
#      · 采样时钟 adc_clk 的周期由运行时寄存器 P 决定(P=13 → 100 ns,
#        P=2 → 15.4 ns),**一个静态 XDC 写不下所有档位**;
```

`adc_d[11:0]` 与 `adc_otr` 是**杜邦线**接过来的,布线时延离散度约 **4 ns**;
而 P=2 时数据眼宽 15.4 ns、采样刻度距总线边沿只有 **7.69 ns**(`clk_axi` 周期)。
**这是一条已知且有意接受的风险,不是遗漏。** 在它被消除之前,
"数字侧完全无辜"这句话说不了。当前的证据只是把天平压向了模拟侧,不是把它焊死。

---

## 七、机制候选与判别实验

### 候选(按当前证据排)

| # | 假设 | 支持 | 反对 / 未决 |
|---|---|---|---|
| **H2a** ★领先 | **CRSS 组合下栅极浮空** —— 既无直流回路也无交流地,1 MHz 激励经 `Cgd` 整流给浮空节点充电,直到某处击穿放电,打出一次尖峰 | 解释了**为什么只有 CRSS**;解释了**为什么只有高压**(充电电流 ∝ 偏压);解释了 1–10 次/8192 的稀疏率 | 无原理图,无法从代码证实 |
| H2b | 继电器触点在 50 V 下**微弧** | 只在高压出现 | K1–K7 里哪个触点、为什么只在 CRSS 组合 —— 未知 |
| H2c | 偏压 **×10 放大器 / 供电**上有周期性尖峰 | 高压才有 | **解释不了"只有 CRSS"** —— CISS/COSS 走同一套偏压 |
| H1 | PL **采样刻度错一拍**(数字) | 与 2026-10-15 `P=2→4` 那次"离散度 3.86%→0.42%"是同一族问题 | ★ **被 OTR 削弱** —— 独立引脚跟着置起;且干净捕捉 0/213。**但未排除** ⇒ 见 §六 |

### 判别实验(按性价比排)

| # | 做什么 | 判据 | 成本 |
|---|---|---|---|
| **(a)** ★ | **CRSS 夹具上加一只 1 kΩ 栅–源电阻** | 尖峰**消失** ⇒ H2a 坐实 | 一只电阻 |
| **(b)** | CRSS @ 50 V 下**关掉激励**(AD9833 停)再采一次 | 尖峰**仍在** ⇒ 与激励无关(偏 H2c);**消失** ⇒ 与激励耦合有关(偏 H2a / H2b) | 改一次寄存器 |
| **(c)** | **软件诊断**:在坏捕捉分支打印每个越界样本的**序号 / 值 / 落在 A 还是 B** | A、B **同序号** ⇒ 共模模拟; **不同序号** ⇒ 交织或指针缺陷 ⇒ 数字; **只有 B** ⇒ B 前端 | 纯 C 改动,板上 `make`,**不占位流周期** |

> **(c) 是唯一能把 H1 和 H2 分开的实验**,而且它**不需要任何硬件动作**。

### 与判据的关系(重要)

**自洽闸已经做对了它该做的事**:20 条高压过载里,重采救回了 16 条,只有 4 条走到"判无读数"。
**所以这次要修的不是判据,是模拟侧。** ⛔ **不要用放宽阈值的办法"修"它** ——
`142 / 208 / 362` 这种量级,放宽度覆盖不了,只会把 519 pF 那种尖峰重新放回曲线上
(即 `LLM-068` 留下的那条警告)。

---

## 八、附带发现:CRSS 的阻抗随量程电阻 `R0` 漂

日志里 `Z` 行自报 `R0`,而用户这次**中途换过挡位**,于是**同一台设备、同一个偏压**下拿到了三组对照:

| 测量 | `R0` | `Re Z` | `Im Z` | `Cs` | `Cp` | `D` |
|---|---|---|---|---|---|---|
| CISS @ 50 V | 100 Ω | 10.98 Ω | −77.9 Ω | 2042 pF | 2002 pF | 0.141 |
| CISS @ 50 V | **1 kΩ** | 79.36 Ω | −79.5 Ω | 2000 pF | **1003 pF** | **0.998** |
| CRSS @ 0.10 V | 10 Ω | 20.3 Ω | −97.4 Ω | 1633 pF | 1565 pF | 0.209 |
| CRSS @ 0.10 V | 100 Ω | 157.0 Ω | −88.0 Ω | 1809 pF | 432 pF | **1.784** |
| CRSS @ 50 V | 100 Ω | 2050 Ω | −11611 Ω | 13.7 pF | 13.3 pF | 0.177 |
| CRSS @ 50 V | **1 kΩ** | **17476 Ω** | −12223 Ω | 13.0 pF | 4.28 pF | **1.43** |

**观测**:`Re Z` 跟着 `R0` 走(7.2× / 13× / 8.5× 三组),`Im Z` 大体不动(2% / 5% / 10%)。

一个**线性**器件的 `Z` 是它自己的属性,**不该随量程电阻变**。现在它变了,而且是
**`Cs` 稳、`D`/`Cp` 跟着 `Re Z` 漂**:

```
CISS @ 50 V:换个挡,D 从 0.141 → 0.998(7×),Cp 从 2002 → 1003 pF
```

⇒ **能下的那一半结论:`Im Z` 那一路(→ `Cs`)大体可信;`Re Z` 那一路(→ `D` / `Cp`)目前不可信。**
⇒ **不能下的**:原因未定位。候选 ① A/B 两路**相位原点仍不共基**
(§三 的交织修复对齐的是 ADC 的同一个转换周期,但 INA / INB 两条**前端模拟链**延迟不同);
② 前端网络寄生电阻;③ 夹具 / 继电器触点电阻。**都只是候选,不写成结论。**

> 📌 **口径修正**:我先前对用户说过「CRSS 在 50 V 下 `Re Z = 17.5 kΩ`、`D = 1.43` 物理上不可能」。
> **有了 `R0` 对照才说得准**:17.5 kΩ 只在 `R0 = 1 kΩ` 下出现;`R0 = 100 Ω` 下同一器件是 **2.05 kΩ**。
> **可疑的不是那个数大,是它随量程电阻变。**

---

## 九、这份分析做不到的(不得当成做到了)

| 项 | 为什么 |
|---|---|
| **"界面上的正弦不干净" 无法证实或证伪** | 日志里只有 `幅值 / 峰峰 / OTR`,**没有那 96 点波形数据**。波形页喂的是交织拆分后的 `s_code_a[0..95]`;要让越界样本落进这 96 点窗口,概率约 `(1–10)/8192 × 96 ≈ 1%–12%`,**看起来对不上"一直不干净"** ⇒ 用户看到的波动**可能另有来源,也可能是显示刷新本身**。**未查证,不下判断。** |
| **越界样本的序号 / 通道没有记录** | 现在只统计了 OTR 的**个数**,没有位置 ⇒ 判不了"共模 vs 交织"。这正是 §七(c) 要补的 |
| **一根 OTR 分不出是哪一路** | 板上只接了 **一根** `adc_otr`(`Y8`);AD9238 手册上是 `OTR_A`(脚 58)与 `OTR_B`(脚 39)两根 ⇒ **无法判断溢出发生在 A 还是 B** |
| **严格 A/B(关重采)仍未做** | 要改 `qrs-ui.service` 的 `Environment` = 重启服务 = **第二次加载位流**(红线)⇒ 只能等下一个上电周期 |
| **一次采集耗时仍未实测** | `~6 ms` 依旧是估计值(方法:两轮总时长差 ÷ 重采次数) |

---

## 十、复现

```bash
# 板上拉日志(需 sudo)
sudo -E python3 /home/xilinx/tools/...          # 或用 tools/board_run.py --get
# 主机侧:只取严格格式的 245 行(带 码/期望 与 采 N 次 两列)
grep -a '码/期望' /tmp/qrs-ui-final.log
# 逐字 OTR 对照(注意:同偏压要分开归类,别把 CISS 和 CRSS 混在一起)
grep -a -E '扫压|单点' /tmp/qrs-ui-final.log | grep -a 'OTR'
```

**分析脚本**(主机 `/tmp`,重启即失,逻辑已完整写在上文各表里):
`doc69.py`(分桶 + OTR 联合分布)· `doc69b.py`(回路 × 坏点率)· `doc69c.py`(CRSS 逐条)·
`doc69d.py`(三类判定)· `doc69e`(Z 行 + `[relay]` 真值归属)

**相关记录**:`report/llm-log/LLM-068.md`(自洽判据的立项与上板验证)、
`report/measurements/20261015_sweep_consistency_gate_verified.md`(判据本轮的完整账)、
`report/llm-log/LLM-069.md`(本次分析的自纠错轨迹)
