dsgmxc/2026_fpga_qrs/board/measurements/20261010_relay_cfg_write_anomaly.md

# `0x1C RELAY_CFG` 写入异常 —— 实测记录(2026-10-10)

**状态:✅ 已解决(2026-10-10 当晚闭环,见 §10)。根因在 PS 侧调用方式,PL 无缺陷。**
被测对象:板上位流 md5 `9613c2928a01f832b71aef7c45c4c0b9`,
由 `fpga_pro/qrs` 于 2026-10-10 15:43 实现产出(源文件 15:31–15:33 修改,**早于**综合)。
测量手段:`/dev/mem` mmap 裸寄存器读写(`/tmp/poke_relay.py`,不加载位流、不用 pynq)。

> ⚠️ **本文件 §1 / §7.4 / §8 / §9 的结论都建立在"一次 AXI 写"这个前提上,而那个前提是错的。**
> §10 用 2×2 + 性质隔离 + 三类探针把它推翻了。**读本文件请直接看 §10,再看前面的历史轨迹。**
> 保留前文是因为 §9 那次"记录互相矛盾"的发现本身是本项目最有价值的一条纠错素材(M11)。

---

## 1. 结论摘要

### ✅ 最终结论(2026-10-10,见 §10)

**PS 侧写寄存器时用 `struct.pack_into` 会产生两笔 AXI 事务**(先写 `0x00000000`,再写载荷),
**而不是一笔**。于是:

* 笔①`0x00` 在 `relay_ctrl` 白名单里(`COSS_DISCHARGE`)⇒ **被受理**,`relay_reg ← 0x00`,arm busy 40 ms;
* 笔②真值 ⇒ 撞 `busy` ⇒ `ERR_BUSY(0x03)`;
* ⇒ **写什么合法值,硬件都停在 `0x00`。**

`settle = 0`(无互锁)时后写覆盖前写 ⇒ 一切正常 —— **这正是"为什么只有 `0x1C` 显形"**:
它是唯一带稳定时间互锁的命令寄存器。其它寄存器同样被多写一笔零,但后写胜出,看不出来。

**PL 无缺陷:** `relay_set_r` 一笔事务一拍脉冲,行为与源码一致。
修法是改 PS 侧那一行调用方式(`_DevMemRegs.write` 用切片赋值),不是改 RTL、不用挂 ILA。

### ❌ 以下是被推翻的旧结论(保留供追溯)

**~~对 `0x1C` 的每一次 AXI 写,PL 侧表现为「两次 `cfg_relay_set` 脉冲」~~:**
~~第一次携带 `cfg_relay = 0x00`,第二次携带真正写入的值。~~

~~`0x00` 在白名单里(合法组合 `COSS_DISCHARGE`),所以**第一次脉冲总被受理**~~
~~⇒ `relay_reg ← 0x00`;第二次脉冲随后按状态被受理或被拒。~~

~~**源 RTL(`relay_ctrl.v` + `cv_axi_lite_slave.v`)每次写只产生一拍脉冲。**~~
~~⇒ **板上实际行为无法由当前源文件推出。** 根因未定位。~~

**错在哪:** "两拍脉冲"这个**现象**是对的,但归因错了。
它不是"一次写被 PL 拆成两拍",而是"PS 发了**两笔**写"。
当时只数了 PL 收到的脉冲数,没去数 PS 发出的**事务**数 —— 见 §10.4。

## 2. 四组对照实验(全部为实测)

| # | `0x24` settle | 写 `0x1C` | 合法? | 读回 `0x1C` | `0x04` STATUS | **源 RTL 预测** |
|---|---|---|---|---|---|---|
| 1 | 0 ms | `0x3C` | ✓ | **`0x3C`** ✓ | err=0x00 busy=0 | relay=0x3C, err=0x00 ✓ 一致 |
| 2 | 0 ms | `0x80` | ✗ | **`0x00`** ✗ | err=0x01 busy=0 | relay **不变=0x3C**, err=0x01 |
| 3 | 2000 ms | `0x51` | ✓ | **`0x00`** ✗ | err=0x03 busy=1 | relay=0x51, err=**0x00** |
| 4 | 40 ms | `0x1E` / `0x61` | ✓ | **`0x00`** ✗ | err=0x03 busy=1 | relay=0x1E/0x61, err=0x00 |

对照组 1 与 2 **只差写入值**,`settle` 均为 0(busy 不可能置起)。

### 为什么只有「两次脉冲」能同时解释对照组 2

- `0x1C` 从 `0x3C` 掉到 `0x00` ⇒ 必有一次**被受理**的 `relay_reg ← 0x00`
  (`relay_reg` 只在该受理分支被写;复位分支写的是 `RELAY_RESET=8'h10`,不是 0)。
- 同一次写里 `err = 0x01`(ERR_RELAY)⇒ 必有一个**非法值**被送进 FSM(`0x80`)。
- 一个脉冲不可能同时是 `0x00` 和 `0x80`。⇒ **至少两个脉冲。**

对照组 1 亦是佐证:`settle=0` 时 busy 不置起,两次脉冲**都被受理**,
后一次(真值)覆盖前一次 ⇒ 读回恰好等于写入值,因此看起来「正常」。

## 3. 已排除项(逐条实测,不是推断)

| 假设 | 排除方式 | 结果 |
|---|---|---|
| 源与位流不一致 | 全盘 `find` 同名文件 + `.xpr` 引用 + DCP 时间戳 | 全盘只有 1 份 `relay_ctrl.v`;DCP(synth 15:42:19 / routed 15:43:10)晚于源(15:31) |
| 第二个写入方(PS 侧) | `systemctl stop qrs-ui` 后复测 | **现象完全复现** ⇒ 与 C 界面无关 |
| C 界面偷偷写寄存器 | `grep` 全部 `app/` 源码 | 日志打印 `RELAY_CFG=0x10` 原值不动;`relay_view.h:5` 明确「只有 `cv_reg_read`」 |
| `IDX_*` 常量重复 / 读分支 case 重复 | 全量 dump 读分支(860–925 行)+ grep | 无重复 |
| `wdata_r` 落后一笔写 | 前一笔写故意留低位 `0x61`,复测读回 | 读回 `0x00` **不是** `0x61` ⇒ 不是简单的陈旧数据 |
| 拒绝时不清 `relay_reg`(源 RTL 自身契约) | 见对照组 2 | **源 RTL 的契约「拒收一位都不动」在板上不成立** |

## 4. 为什么本记录不给出根因

已核对到源 RTL 的每一处相关逻辑(握手寄存器、`do_write`、
`relay_set_r` 脉冲生成、FSM 受理/拒绝分支、白名单、读回路径),
**在源 RTL 中每次写只可能产生一拍 `relay_set_r`**:

```
wire do_write = aw_hs & w_hs & ~bvalid_r;      // bvalid_r 在 do_write 当拍下一拍即置 1
                                               // ⇒ do_write 只可能高 1 拍
relay_set_r <= 1'b0;                           // 默认清
if (do_write && (awaddr_r[7:2] == IDX_RELAY_CFG)) relay_set_r <= 1'b1;
```

⇒ 源 RTL 无法产生「两拍脉冲」。**需要仿真或网表级核对才能继续**,
不宜凭推理下结论。

## 5. ⚠️ 安全相关(比上面更该先处理)

`0x00` = `COSS_DISCHARGE`,与 `0x10` = `ALL_OFF` 是**两个不同的物理组合**。
既然第一次脉冲总携带 `0x00` 且总被受理,则:

> **一个「被拒收」的写(例如非法值 `0x80`)仍会把继电器组合实际拨到 `0x00`。**
> —— 源 RTL 的设计备忘明确承诺相反的行为(「拒收:relay_reg 一位都不动」)。

实测证据见对照组 2(`relay_reg` 由 `0x3C` 变为 `0x00`)。

⚠️ **继电器的物理触点从未用万用表量过** —— 以上全部是**寄存器侧**的读数。
「`relay_reg` 变了」与「继电器真的动了」是两件事,后者需要实测触点确认。

## 6. 复现命令

```bash
# 板上(需 root)。poke_relay.py 只 mmap /dev/mem,不加载位流。
echo xilinx | sudo -S -p "" python3 /tmp/poke_relay.py w 0x24 0x00000000 0x1C 0x3C
echo xilinx | sudo -S -p "" python3 /tmp/poke_relay.py w 0x1C 0x80    # ⇒ 0x1C 变 0x00
```

---

# 7. 【2026-10-10 二次排查】网表核对 + 隔离对照 —— **"两次脉冲"已坐实,根因在 `cv_sys` 之外**

上面第 1–6 节只到"源 RTL 推不出"。本节补两组**实测/核对**,把结论往前推了一步。

## 7.1 网表核对(已实现的路由后 DCP,不是源文件)

`qrs.runs/impl_1/system_wrapper_routed.dcp`,Vivado batch `open_checkpoint` + `all_fanin`。

| 查什么 | 结果 |
|---|---|
| `relay_set_r` 有几个? | **1 个**(`u_cv_axi_lite_slave/relay_set_r_reg`)—— 脉冲发生器唯一 |
| `relay_set_r_reg/D` 的扇入起点 | 只有 `awaddr_r_reg[2..7]`、`aw_hs_reg`、`w_hs_reg`、`bvalid_r_reg` |
| ⇒ 对应源式 | `(aw_hs & w_hs & ~bvalid_r) & (awaddr_r[7:2]==IDX_RELAY_CFG)` —— **与源文件逐项一致** |
| ⇒ **`~bvalid_r` 在不在锥里?** | **在**。⇒ `do_write` 高不过 1 拍 ⇒ **`relay_set_r` 一次 `do_write` 只可能高 1 拍** |
| `relay_cfg_reg[*]/D` 的扇入起点 | 只有 `wdata_r_reg[*]` |
| `relay_reg_reg[4]` INIT / `relay_cfg_reg[4]` INIT | **都是 1** ⇒ 复位值 **0x10**(`ALL_OFF`)✓ 与源一致 |

**⇒ 网表是源文件的忠实实现。PL 侧不可能由一次 AXI 写产生两拍 `cfg_relay_set`。**

## 7.2 隔离对照 —— 每次写单独一个进程,排除"同进程连写两个寄存器"

手段:`/tmp/exp2.py`(只 `mmap /dev/mem`,不碰位流),**每个寄存器写各起一个进程**。

| # | settle | 写 `0x1C` | 写前 | 写后 |
|---|---|---|---|---|
| ② | 0 ms | `0x3C`(合法) | `0x1C=0x3C` | `0x1C=0x3C` ✓ err=0x00 |
| ③ | 0 ms | `0x80`(非法) | `0x1C=0x3C` | **`0x1C=0x00`** ✗ err=0x01 |
| ④ | 0 ms | `0x3C`(合法) | `0x1C=0x00` | `0x1C=0x3C` ✓ err=0x00 |
| ⑤ | 0 ms | **`0x18=0x4`(挡位)** | `0x1C=0x3C` | **`0x1C` 纹丝不动** ⇒ 异常只跟 `0x1C` 这个地址绑定 |
| ⑦ | 2000 ms | `0x51`(合法) | `0x1C=0x3C` | **`0x1C=0x00`** err=0x03(BUSY) |

⇒ **③ 单独一个进程、只写 `0x1C` 一个寄存器,异常照样复现。**"同进程连写两个寄存器"的干扰被排除。

## 7.3 ★ 决定性证据:`done` 当独立计数器 —— **写入值相同也照样是两次脉冲**

`relay_ctrl` 里 `done_r` 只在**一次被受理的继电器写**之后、稳定计时走完时置 1。
而 `0x00`(COSS_DISCHARGE)在**白名单里**,单独一次写必然被受理 ⇒ 必然 `err=0x00`。

**把 `settle` 设成 1 ms,然后写 `0x1C = 0x00`(注意:写入值就是 `0x00` 本身):**

```
写前  0x04=0x00000002  0x1C=0x00   settle=1ms
写 0x1C <- 0x00
写后  0x04=0x00000306  0x1C=0x00   ⇒  err=0x03 (BUSY)
```

| 模型 | 预测 |
|---|---|
| **一次脉冲** | `0x00` 合法 ⇒ 受理 ⇒ `err=0x00`、`busy` 走 1 ms 后 `done=1` |
| **两次脉冲** | 第一次受理(arm busy)⇒ 第二次撞 busy ⇒ **`err=0x03`** |
| **实测** | **`err=0x03`** ⇒ **两次脉冲** |

**这一条把"读回 0x00 是因为数据陈旧/被 0x00 覆盖"的解释全部排除** ——
写入值本身**就是 `0x00`**,两次脉冲携带的是**同一个值**,仍然撞出 BUSY。

## 7.4 结论(本次能确定的 / 不能确定的)

**✅ 已坐实:**

1. **一次 AXI 写 → `relay_ctrl` 收到 ≥2 个 `cfg_relay_set` 脉冲。**(7.3,数据无关,板上实测)
2. **PL 侧不具备这个能力。** `relay_set_r` 只有一个 FF,`~bvalid_r` 在锥内,
   一次 `do_write` 只可能高 1 拍。(7.1,已实现网表核对)
3. **⇒ 只能是 ≥2 次 AXI 写事务(≥2 组 AW+W 握手)到达 `cv_sys` 的 `S_AXI`。**
4. **第一次携带的 `WDATA = 0x00000000`** —— 由 ③ 反推:`relay_reg` 从 `0x3C` 掉到 `0x00`,
   而 `relay_reg` 只在**受理分支**被写;复位分支写的是 `0x10`。所以必有一次
   **被受理的、值为 `0x00`** 的写。
5. **异常绑定在 `0x1C` 这个地址上**:写 `0x18` 时 `0x1C` 纹丝不动(⑤)。
6. **故障在 `cv_sys` 之外** —— PS 写通路(Zynq `M_AXI_GP0` → BD 里的 `axi_smc` → `S_AXI`)。
   上一次"源/位流不一致"的怀疑,现在有了**正面证据**排除:网表就是源。

**❌ 仍不能确定(不下结论):**

- **是谁、为什么把一个写变成两个。** 候选:Zynq GP0 端口 / BD 里的 `axi_smc`
  (含 `s00_si_converter` 的 AXI4→AXI4-Lite 转换、`s00_mmu`)/ `/dev/mem` 通路。
  **寄存器回读已经问不出更多了** —— 要区分只能在片上抓 AXI 写通道。

**⚠️ 顺带发现的一处潜伏隐患(与本异常无直接因果,但该记):**
`cv_sys.v:66` 是 `C_S_AXI_ADDR_WIDTH = 8`(地址只有 8 位),
而 BD 里给 `cv_sys_0/S_AXI/reg0` 分的段是 **`0x43C00000`,range `4K`**。
RTL 只译码 `awaddr_r[7:2]`(高 6 位被丢掉),所以 `0x1C` 与 `0x11C`、`0x21C`……
**会落到同一个寄存器**。当前 PS 只写低 256 字节,踩不到;但地址宽度和段范围对不上,
将来扩寄存器时是个陷阱。

## 7.5 复现命令

```bash
# 板上(需 root)。expx.py 只 mmap /dev/mem,不加载位流。
echo xilinx | sudo -S -p "" python3 /tmp/exp2.py 0x24 0x00010000   # settle = 1 ms
echo xilinx | sudo -S -p "" python3 /tmp/exp2.py 0x1C 0x00         # ⇒ err=0x03
```

```tcl
# PC 上核对网表(Vivado batch)
open_checkpoint /home/hyp/Desktop/fpga_pro/qrs/qrs.runs/impl_1/system_wrapper_routed.dcp
all_fanin -flat -startpoints_only -to [get_pins system_i/cv_sys_0/inst/u_cv_axi_lite_slave/relay_set_r_reg/D]
```

## 7.6 下一步(唯一能再往前推的一步)

**在 `u_cv_axi_lite_slave` 的写通道上挂 ILA**,探针
`s_axi_awaddr / s_axi_awvalid / s_axi_awready / s_axi_wdata / s_axi_wvalid / s_axi_wready /
s_axi_bvalid / s_axi_bready`,触发条件 `awvalid & awready`。

它一次就能回答:每次 PS 写,到底有几组 AW/W 握手、各自带什么数据、`bready` 什么时候来。
**需要重建位流。** 在那之前不宜再猜。

---

# 8. 【2026-10-10】软件绕法 —— **已验证可用,P4 不必等根因**

既然异常只在 **`settle != 0`** 时暴露(`settle = 0` 时两次脉冲都被受理,后一次(真值)覆盖前一次),
就可以把"等稳定时间"这件事**从硬件搬到 PS 侧自己等**:

```
写 0x1C = V 的正确时序
  1) 写 0x24 = 0x0000_0000        # settle ← 0
  2) 写 0x1C = V                  # 两次脉冲都被受理 ⇒ relay_reg = V,err = 0
  3) 写 0x24 = 0x0028_05DC        # settle 恢复 40 ms
  4) PS 自己 time.sleep(0.040)    # 等继电器稳定(硬件不再代劳)
```

**板上实测(同一目标值、两种 settle 直接对照):**

| settle | 写 `0x1C` | 读回 `0x1C` | STATUS |
|---|---|---|---|
| 40 ms(默认) | `0x51` | **`0x00`** ✗ | err=0x03 |
| **0 ms** | `0x3C` | **`0x3C`** ✓ | err=0x00 |
| 40 ms(默认) | `0x61` | **`0x00`** ✗ | err=0x03 |
| **0 ms** | `0x61` | **`0x61`** ✓ | err=0x00 |

**代价 / 前提(要写进代码注释,不然将来踩):**

1. **PS 必须自己 sleep 够稳定时间** —— 硬件不再置 `busy`、不再置 `done`,超时/错误保护都没了。
2. 中间会有一拍(**20 ns @50 MHz**)把继电器组合瞬时拨到 `0x00`(COSS_DISCHARGE)。
   机械继电器吸合是 ms 级,**20 ns 不足以让它动**;但这是"靠继电器的时间常数兜着",不是设计出来的。
3. 这是**绕法,不是修法**。根因仍在(§7),`relay_ctrl` 的 `busy/done/err` 三个保护全部失效。

⚠️ 本节只是"能往下走",不等于 §7 的结论可以不管 —— 报告里必须两者都写。

---

## 9. 🔴 【2026-10-10 晚 · 新线索】两处记录**互相矛盾** ⇒ 异常**不是静态性质**

### 9.1 矛盾在哪

第 52 次会话的收尾记录(`docs/project_state.md` 变更日志,§⑬ 阶段 2)写着:
用当时的 `tools/relay_rw.py` 跑,**「全部通过」**,其中 A 节是

> (A) 7 个合法组合**逐个写→等 done→回读,7/7 相符**

而 A 节做的事情是:**写 `0x1C = V`,等 `busy` 落,读回`,` 断言 `== V`**。

⚠️ **这正是本文档 §2 对照组 3/4 断言不可能的写法** —— 若"写一次 → 两个脉冲"
是常驻行为,则单写 `V`(默认 40 ms 稳定)必然读回 `0x00` + `err=0x03`,
**A 节 7/7 里一个都不可能通过**。

⇒ **同一份位流、同一次上电,两种写法结果相反。** 二者必有一错,或异常**是条件性的**。

### 9.2 两种写法差在哪(已逐条对过)

| | 旧 `relay_rw.py` A 节 | `poke_relay.py w …`(§2/§7 全部实测) |
|---|---|---|
| `0x1C` 之前写过 `0x24` 吗 | **没有** —— `0x24` 一直停在复位值 `0x0028_05DC` | **有,而且是紧挨着的上一笔** |
| 之前还写过什么 | `SCRATCH` 回环 3 次(vs `0x4C`)+ 读若干 | 无 |
| 后端 | PYNQ **`MMIO.write`** | **裸 `/dev/mem` mmap** `struct.pack_into` |
| `0x1C` 之后的动作 | 轮询 `0x04` 直到 `busy` 落 | 读 `0x1C` / `0x04` |

**两个变量同时变了**(前序写法 + 映射开法),所以现有数据**分不开它们**。
这不是"再来一轮推理"能解决的 —— 必须**做对照**。

### 9.3 第一嫌疑:紧挨着的两次 AXI 写

`cv_axi_lite_slave.v` 的写桩(`:422-460`)是**串行**的:

```verilog
assign s_axi_awready = ~aw_hs & ~bvalid_r;      // 手上有 B 没回,就不再收 AW/W
assign s_axi_wready  = ~w_hs  & ~bvalid_r;
wire   do_write      = aw_hs & w_hs & ~bvalid_r;  // 两通道都到齐才动寄存器
```

`aw_hs` / `w_hs` **只在 B 握手完成时**清(`:432-433`、`:439-440`),
`relay_set_r` 由 `do_write` 打一拍(`:714`)。**逐拍推演(单笔、背靠背、W 先于 AW、
流水线重叠)都得出一笔一个脉冲** —— 见 §10。

⇒ **纸面上推不出"两笔并成一笔"或"一笔拆成两笔"**。所以 §9.3 是**嫌疑**不是结论。

### 9.4 已备好的对照实验(**零成本,上电即可跑**)

`tools/relay_rw.py` 的 **§0「触发条件对照」** 已重排到**所有其它写之前**,一次跑出两行:

| 步骤 | 做法 | 复现的是 |
|---|---|---|
| ① `cold` | **不碰 `0x24`**,直接写 `0x1C = 0x7F` | 旧 A 节的条件(日志说「正常」) |
| ② `pair` | **紧挨着**先写 `0x24`(40 ms)再写 `0x1C = 0x61` | `poke_relay.py` 的条件(记录说「异常」) |

判读(脚本会自己打印):

| ① | ② | 结论 |
|---|---|---|
| ✓ | ✗ | ★★ **触发条件 = 紧挨着的两次 AXI 写** —— 下一步挂 ILA 只看第二笔 |
| ✗ | ✗ | 与写法无关,PS/Zynq 层面的常驻问题 |
| ✓ | ✓ | ⚠️ **异常没复现** —— 与本文档结论矛盾,**先别改结论**,把完整输出贴回来 |

配套开关:`--raw` 把后端换成裸 mmap —— 用来**分离第二个变量**(§9.2 第 3 行)。
四种组合(2 条件 × 2 后端)一次上电就能全跑完。

✅ **这四种组合已于 2026-10-10 当晚跑完**,结果是上表最后一行的 **(✓,✓) —— 异常没复现**,
两个后端都正常。正是这个"没复现"逼出了 §10:如果 PL 真会"一写变两拍",
它不可能随调用方式而变。⇒ **§1 的结论已于 §10 推翻。**

---

## 10. ★★★ 根因(2026-10-10 当晚闭环)—— 在 PS 侧,PL 无缺陷

### 10.1 2×2 对照:一次上电、同一份位流、同一个进程

按 §9.4 跑出的结果:

| 后端 \ 条件 | §0 cold(不碰 0x24) | §0 pair(紧邻写 0x24) | A 节 7 组合 |
|---|---|---|---|
| `pynq.MMIO.write` | ✓ 正常 | ✓ 正常 | 7/7 ✓ |
| 裸 `/dev/mem` mmap | **✗ 异常** | **✗ 异常** | **7/7 ✗** |

⇒ **触发条件是"用哪个后端",不是"写之前有没有碰 `0x24`"。** §9.3 的"紧挨着的两次 AXI 写"**被证伪**。

### 10.2 关键否证:两个后端的**映射开法完全相同**

原本的假设是"PYNQ 的映射不是 `/dev/mem`" —— **错**。板上读源码:

```python
# /home/xilinx/pynq/pl_server/embedded_device.py:523  (pynq.MMIO 就是走这里)
mmap_file = os.open('/dev/mem', os.O_RDWR | os.O_SYNC)          # ← 与 poke_relay.py 逐字相同
mem = mmap.mmap(mmap_file, length + virt_offset, mmap.MAP_SHARED,
                mmap.PROT_READ | mmap.PROT_WRITE, offset=virt_base)
array = np.frombuffer(mem, np.uint32, length >> 2, virt_offset)  # ★ 唯一差别:包成 uint32 数组
```

⇒ 同一个 `/dev/mem`、同一个 `O_SYNC`、同一组 flag。
**唯一差别是"写下去的那一笔到底多宽、发了几笔"** —— 即调用方式,不是映射属性。

### 10.3 性质隔离(每次只改一个性质,写 `0x1C`)

| 变体 | 结果 |
|---|---|
| ① `pynq.MMIO.write`(numpy `uint32` 整字存) | `0x61` / err `0x00` ✓ |
| ② `mmap` + `struct.pack_into`,带 `O_SYNC` | `0x00` / err `0x03` ✗ |
| ③ `mmap` + `struct.pack_into`,**去掉** `O_SYNC` | `0x00` / err `0x03` ✗ ⇒ **`O_SYNC` 无关** |
| ④ `mmap` + **切片赋值** `m[a:b] = bytes` | `0x61` / err `0x00` ✓ |
| ⑤ 手工四次**单字节**存 | `0x61` / err `0x00` ✓ |

⇒ **判别式就是 `struct.pack_into` 与其它所有写法。**

### 10.4 公平四路对照(每次先把 busy 清干净并核对基线)

前面几轮的对照**不公平** —— `settle = 40 ms` 而脚本只 sleep 了几十 ms,
上一笔的 busy 窗口可能还没退。补齐基线后:

| 写 `0x1C = 0x61`,基线 `relay=0x10 busy=0 err=0x00` | 结果 |
|---|---|
| ① `pynq.MMIO` 整字 | `0x61` / err `0x00` ✓ |
| ② 裸 mmap **单字节** `m[0x1C]` | `0x61` / err `0x00` ✓ |
| ③ 裸 mmap **切片赋值** | `0x61` / err `0x00` ✓ |
| ④ **`struct.pack_into`** | **`0x00`** / err **`0x03`** ✗ |

再把 `settle` 设成 **0**(没有互锁):**四种写法全部得到 `0x61` / err `0x00`。**
⇒ ④ 的**最后一笔**是对的 —— 问题不在"值送错",在**发送笔数**。

### 10.5 收口:`struct.pack_into` 的第一笔写下去的是常数 `0x00000000`

用 `0x4C SCRATCH` 当证人(它整字锁存 `wdata_r`、读回原值,不受 relay 合法性/互锁干扰):

```python
mio.write(0x4C, 0x11223344); mm[0x4F] = 0xAA ; mio.read(0x4C)
# → 0xAA223344   (不是 0xAA000000 也不是 0xAAAAAAAA)
```

⇒ 窄写**确实**被模拟成"读-改-写"(其余字节来自器件现值)。**但**这条只解释 0x4F,
**不解释 `0x1C` 归零** —— RMW 会**保住** `bits[7:0]`。

决定性的一步:在 `0x1C` 上遍历 (基线, V):

| 基线 | V | 读回 |
|---|---|---|
| `0x10` | `0x00000061` | `0x00` |
| `0x61` | `0x00000061` | `0x00` |
| `0x7F` | `0x00000061` | `0x00` |
| `0x10` | `0x0000007F` | `0x00` |
| `0x61` | `0x0000007F` | `0x00` |
| `0x7F` | `0x00000000` | `0x00` |

**与基线无关、与 V 无关** ⇒ 第一笔不是 RMW(否则应等于基线),也不是 V,而是**常数 `0x00000000`**。

于是机制完整:

```
struct.pack_into("<I", mm, 0x1C, V)
   ├─ 事务①  WDATA = 0x00000000   → cfg_relay_set 脉冲①  → 0x00 合法 → 受理,relay_reg←0x00,busy←1
   ├─ 事务②… WDATA = …载荷…        → 脉冲②…              → busy ⇒ ERR_BUSY(0x03)
   └─ (settle=0 时无互锁 ⇒ 最后一笔胜出 ⇒ 结果正确,这就是为什么这个坑只在 0x1C 显形)
```

`0x00` 在 `relay_ctrl.v:216` 的白名单里 —— 这一步是**必须**的:若 `0x00` 不合法,
第一笔会被 `ERR_RELAY(0x01)` 拒收、`relay_reg` 不动、后续笔照常受理,**缺陷就不存在了**。

### 10.6 实测排除项(都是"试过,不是" )

| 假设 | 判据 | 结论 |
|---|---|---|
| `O_SYNC` 造成 | 变体 ② vs ③ | ✗ 无关 |
| 裸 mmap vs PYNQ 映射属性不同 | 读 `embedded_device.py:523` | ✗ 同一个 `/dev/mem` + `O_SYNC` |
| 窄写被当成 RMW 且 RMW 读回 0 | 10.5 遍历 6 组 | ✗ 与基线无关 ⇒ 不是 RMW |
| PL 把一笔拆成两拍 | §10.4 换写法即消失 | ✗ PL 一笔一拍 |
| 前序紧邻的 `0x24` 写是触发条件 | §10.1 2×2 | ✗ 与写法相关而非与序列相关 |

### 10.7 修法 + 修后验证

**修法(一行)**:`src/python/drivers/relay.py::_DevMemRegs.write`
`struct.pack_into(...)` → `self._map[off:off+4] = value.to_bytes(4, "little")`(切片赋值 = 一笔)。

**修后上板实测** `verify_relay.py`(同一进程里跑完,给 §10 留证):

| 节 | 内容 | 结果 |
|---|---|---|
| A | 修后 `_DevMemRegs`:7 个合法组合 | **7/7 写→读回相符,err=0x00** ✓ |
| A | 非法值 `0x80/0xFF/0x11` | **3/3 被拒 err=0x01,回路停在上一态** ✓ |
| A | 挡位 A/B/C/D | **4/4 相符,err=0x00** ✓ |
| A | `wait_idle()` 等硬件 busy | **40.6 ms**,`busy=0 done=1` ✓ |
| B | **同一个类,只把 `write` 换成 `struct.pack_into`** | `CISS`/`COSS`/`RG` **全部落到 `0x00`,err=0x03** —— **缺陷稳定复现** |

B 节是关键:同一份代码、同一次上电、只差写下去的那一行调用方式,
⇒ 结果从"7/7 通过"翻转成"3/3 失败"。**这是根因归属最干净的证据。**

**全量工具复跑**(`tools/relay_rw.py --diagnose`,两个后端各一遍):

| 节 | 内容 | `--raw`(devmem) | 默认(MMIO) |
|---|---|---|---|
| ★0 | cold / pair 触发条件对照 | ✓ 正常 / ✓ 正常 | ✓ 正常 / ✓ 正常 |
| A | 7 组合 + 4 挡位 写→读回 | **11/11 ✓** | **11/11 ✓** |
| B | 默认 40 ms 下写→读回(**期望已反转成"必须通过"**) | **3/3 ✓** | **3/3 ✓** |
| C | 6 个非法组合被拒 + 状态不变 | **6/6 ✓** | **6/6 ✓** |
| D1 | `set_gear()` 的 Python 护栏 | **5/5 ✓** | **5/5 ✓** |
| D2 | `gear_write_raw()` 打 RTL 拒收分支 | **6/6 ✓** | **6/6 ✓** |
| E | 稳定延时实测 | 0/40.2/100.4 ms | 0/40.2/100.4 ms |
| | **合计** | **结果:全部通过** | **结果:全部通过** |

⇒ 两个后端**结果一致** —— 修法同时覆盖了两条路。

### 10.7.1 顺带修掉的两处**测试自身**的缺陷(与硬件无关,但会掩盖结论)

1. **`section_d` 测错了层(5 条假失败)。**
   原 D 节写非法挡位后期望 `err = 0x02`,实测恒为 `0x00`。原因不是硬件:
   `drivers/relay.py::set_gear()` **在 Python 侧就预校验**,非独热值直接抛
   `RelayError`,**根本不碰硬件** ⇒ 硬件侧当然不会有 `ERR_GEAR`。
   ⇒ 拆成两层,并**新增 `RelayMatrix.gear_write_raw()`**(原生口,不预校验):
   `D1` 测 Python 护栏(期望:抛异常 **且 err 保持 0x00 = 硬件未被触碰**),
   `D2` 把非法值**真写下去**测 RTL 拒收(期望 `err=0x02` 且 `gear_reg` 不变)。
   ⚠️ **这是本次唯一一个新覆盖到的 RTL 分支** —— `relay_ctrl.v` 块④ 的
   `ERR_GEAR` 在此之前**从未被验过**(见 §10.7.1 第 1 条的成因)。

2. **`section_b` 的期望过期。** 它原为"缺陷复现",**期望就是失败**。
   缺陷结案后期望反转成"必须通过",已改成**回归护栏**
   (挡"哪天又有人把 `_DevMemRegs.write` 改回 `pack_into`")。

3. **`section_trigger` 结束时硬写 `r.workaround = True`** —— 会把调用方的
   `--workaround` 选择覆盖掉(A 节因此一度在绕法下跑)。已改为**存-还**。

### 10.8 本文件该留下的一条方法论

§9 那处"两处记录互相矛盾"是本案的转折点,但**它只把问题从"PL 有 bug"推到"条件性现象"**。
真正定位靠的是**把"现象"换成"可数的量"**:

> 之前一直数的是 **PL 收到的脉冲数**(2),却没数 **PS 发出的 AXI 事务数**(实际 1)。
> 两个数不相等,就是矛盾的所在 —— 而"1"这个数**从来没有人测过**,它是被当成前提假设掉的。

⇒ 沉淀进 `skill/`:**[`count-both-sides-of-interface/`](../../skill/count-both-sides-of-interface/skill.md)**
(2026-10-10 已落地)。

### 10.9 附带发现(与本缺陷无关,但影响别处)

* `cv_axi_lite_slave.v:60/571/929` 三处注释写「**WSTRB 未实现,只支持整字写**」。
  实测**属实**(`s_axi_wstrb` 只出现在端口声明 `:157`,无任何使用)。
  这条是**必须知道**的:任何窄写(含上面那种 RMW 模拟出的窄写)都会被当成整字接收。
* `0x48` 是 **VERSION(RO,恒 `0x00010000`)**,`0x4C` 才是 SCRATCH —— 本次排查中
  一度把 `0x48` 当 SCRATCH 用,浪费了一轮。**已在 `cv_regs.py` 注释里确认过,是自己看错了。**
