dsgmxc/2026_fpga_qrs/sim/gear_pick_verification.md

# `cv_range_pick()`(扫压自动换挡判据)功能验证报告

| 项 | 内容 |
|---|---|
| **日期** | 2026-10-15 |
| **被测对象** | `src/c_ui/app/pynq_regs.h::cv_range_pick()` —— 扫压自动换挡的**唯一判据** |
| **测试平台** | `sim/tb_gear_pick.c`(**自检型**,Claude 代写 —— 见 §7) |
| **工具** | 宿主机 `gcc`(不需要 Vivado、不需要板子) |
| **原始日志** | `sim/logs/tb_gear_pick.log`(10/10 PASS,退出码 0) |
| **输入数据** | **实测**,不是构造的:`report/measurements/20261015_crss_sweep_manual_gear.md` 的 60 组 `Z` |
| **结论** | ✅ **10 项判据全部通过**;⚠️ **未上板**,见 §6 |

---

## 1. 验证目标

`cv_range_pick()` 只回答一件事:**给定 `|Z|` 和当前挡位,该不该换挡、换到哪一挡。**

它存在的理由是 2026-10-15 那次 CRSS 扫压 —— 全程固定 B 挡 100 Ω,而 `|Z|` 从
363 Ω 走到 15 313 Ω,高压段 `VL/VH` 掉到 **0.64 %**,`Cs` 曲线在 6.77 V → 13.66 V
之间一个倍压内掉 14 倍。见 `report/measurements/20261015_crss_sweep_manual_gear.md`。

本测试台**不碰硬件**。寄存器通路那一半(写 `0x18`、回读核对、独热闸)由
`RelayView_ApplyGear()` 负责,它 2026-10-15 已上板验证。

---

## 2. 判据

```
选 argmin |log10(R0) - log10(|Z|)|          # 「最近十倍程」
且仅当   best_d + margin < cur_d  时才换     # margin = 0.15 十倍程
```

**为什么最优是 `|Z| ≈ R0`**(推导见 `pynq_regs.h` 的注释):
`Z = R0·(VH−VL)/VL` 的误差只有两个来源,方向相反 ——

| 区段 | 谁小 | 相对误差被放大 |
|---|---|---|
| `|Z| ≫ R0` | `VL` | `|Z|/R0` 倍(第 3.2 节那个 0.64 % 就是它) |
| `|Z| ≪ R0` | `VH−VL` | `R0/|Z|` 倍 |

两者在 `|Z| = R0` 处相等 ⇒ 最优点 `VL/VH ≈ 70.7 %`,两种失效模式各占一半。
四挡是等比级数(10/100/1k/10k)⇒「最近」= log 轴上最近。

**为什么要迟滞:** 边界恰在相邻两挡正中间(各差 0.5 十倍程),而 `|Z|` 有噪声 ——
逐点取最近会让边界附近的点来回跳,而**每跳一次,曲线就换一次标定基础**。

---

## 3. 四条跑道

全部用**同一份实测数据**(60 组 `Z`),只有换挡策略不同。起手挡位都是 B(复位值)。

| 跑道 | 策略 | 换挡次数 | 方向反转 | 挡位单调 | `VL/VH` 最坏 |
|---|---|---|---|---|---|
| ① | 固定 B 挡 100 Ω(**改动前的行为**) | 0 | — | — | **0.65 %** |
| ② | 自动换挡,**无**迟滞 | 4 | **2** | **否** | 23.25 % |
| ③ | 自动换挡,迟滞 0.15(**本次落板配置**) | 2 | **0** | **是** | **21.95 %** |

③ 的换挡轨迹:

```
点 35  |Z| =  390 Ω  B 100Ω → C 1kΩ    VL/VH  22.0 % →  78.8 %
点 41  |Z| = 4223 Ω  C 1kΩ  → D 10kΩ   VL/VH  22.0 % →  85.5 %
末挡 = D 10kΩ
```

② 在同一条数据上出现了 **2 次方向反转**(`B→C→B→C→D`)—— 换挡不是单调推进,
而是**先退后进**。退挡意味着同一段曲线两头用了不同的标定基础,这正是迟滞要挡掉的。

---

## 4. 迟滞的**直接**测试(跑道 ④)

§3 里 ② 的反转是"顺带"出现的。为了**直接**测迟滞本身,构造一条停在分界线上的序列:
让 `|Z|` 在 B(100 Ω)与 C(1 kΩ)的分界 `√(100·1000) = 316.2 Ω` 上左右晃 ±5 %,跑 40 次。

| 迟滞 | 换挡次数 |
|---|---|
| 0 | **39 / 40** —— 每一次都换,来回横跳 |
| 0.15 | **0 / 40** —— 完全不换 |

这是判据具备**失败能力**的正面证据:同一份代码、同一份输入,只改迟滞宽度,
结果从 39 次变成 0 次。

---

## 5. 判据(10 项,全部 PASS,退出码 0)

| # | 判据 | 结果 |
|---|---|---|
| 1 | ① 固定 B 挡时 `VL/VH` 掉到 1 % 以下(**负对照**:证明出题不是"怎么都能过") | PASS |
| 2 | ③ `VL/VH` 全程不低于 20 % | PASS |
| 3 | ③ 换挡方向从不反转 | PASS |
| 4 | ③ 挡位序号单调不减 | PASS |
| 5 | ③ 末挡落在 D 10kΩ | PASS |
| 6 | ② 无迟滞时真实数据上确实发生方向反转 | PASS |
| 7 | ② 无迟滞的换挡次数不少于有迟滞 | PASS |
| 8 | ② 无迟滞时挡位序号不单调 | PASS |
| 9 | ④ 迟滞 0.15 显著减少分界处抖动 | PASS |
| 10 | ④ 迟滞 0.15 在分界线上最多只换 1 次 | PASS |

复现:

```bash
gcc -std=gnu11 -Wall -Wextra -O2 -I../src/c_ui/app -o /tmp/tb_gear_pick \
    sim/tb_gear_pick.c -lm && /tmp/tb_gear_pick
```

---

## 6. ⚠️ 本报告**没有**覆盖的部分

| 未覆盖 | 为什么 | 由谁覆盖 |
|---|---|---|
| `0x18` 真的写进硬件、回读一致 | 主机测试不碰寄存器 | `RelayView_ApplyGear()`,2026-10-15 上板已验 |
| **扫压中换挡**对曲线的影响 | 需要真实 DUT 与真实继电器 | ⏳ **待上板**(下一次上电周期) |
| 换挡后**驻留时间是否够**挡位继电器稳定 | 挡位继电器机械稳定时间未知 | ⏳ 待上板;每点驻留 300 ms,量级上够,但要实测 |
| `|Z|` 在**换挡瞬间**的读数 | 判据用的是换挡**前**那一点的 `|Z|` | 设计如此(最多落后一个点),见 `sweep_autoscale()` 注释 |
| 第 1 点仍用手动挡位 | 有意不做预扫,理由见 `sweep_autoscale()` 注释 | 设计如此 |

---

## 7. 归属说明(与 M11「大模型协作」有关)

* **判据(含 `|Z| ≈ R0` 的推导与迟滞宽度 0.15)与测试台**由 Claude 提出并实现,
  2026-10-15。用户当时的指令是「**先把档位修复了不然数据都很奇怪**」——
  需求来自用户,方案与实现来自 Claude。
* **输入数据是用户上板实测的**,不是 Claude 造的。
* Claude 在本轮**自己抓到并修正了一处错误**:`VL/VH` 最初写成了标量式
  `R0/(R0+|Z|)`,而正确的是相量式 `R0/|R0+Z|`。两者在 `|Z| ≫ R0` 时接近,
  在 `|Z| ≈ R0` 附近差近一倍 —— 而本判据恰好在 `|Z| ≈ R0` 附近做判断。
  轨迹见 `report/llm-log/`。
