dsgmxc/2026_fpga_qrs/board/measurements/20261102_standard_board_check.md

# 2026-11-02 标准板单点反查 · 通道级校准残差

> 目的:校准采完之后,用**标准板 1 自己**做一次单点测量,看反演结果能不能回到它的
> 标称值。这是 B8(OPEN/SHORT/LOAD 校准残差)最直接的一张表。

## 条件

| 项 | 值 |
|---|---|
| 位流 | 自启加载,**本次上电恰 1 次**(`dmesg` `writing` = 1) |
| 固件 | `/proc/<pid>/exe` = `ed89168f00b5e7236a228f519cd77e4e`(含 `cal_channel_point`,即 `\|a−1\|` 守卫版) |
| 激励 / 采样 | 1.000 MHz / 32.50 MSPS(DIV=4,相位 +1) |
| 偏压 / 挡位 / 回路 | 0.10 V / **B(100 Ω)** / 单点「全部」(CISS → COSS → CRSS) |
| 被测件 | **标准板 1**:Cgs 1986 / Cgd 10 / Cds 104 pF,Rg 0 |
| 校准 | 16/16(当前频率),四挡全部 `L2*` |

## 结果

| 腿 | 标称(板 1 定义) | 实测 | 残差 | 实测 \|Z\| @1 MHz |
|---|---|---|---|---|
| CISS = Cgs + Cgd | **1996 pF** | **1995.788 pF** | **−0.21 pF(−0.01 %)** | 79.7 Ω |
| COSS = Cds + Cgd | **114 pF** | **116.690 pF** | **+2.69 pF(+2.4 %)** | 1364 Ω |
| CRSS = Cgd | **10 pF** | **12.120 pF** | **+2.12 pF(+21 %)** | 13131 Ω |

日志里的校准前后:

```
CISS  校准前    7.269 −79.537j Ω  →  校准后    0.001 −79.745j Ω
COSS  校准前  111.762 −1376.383j  →  校准后   −8.189 −1363.915j
CRSS  校准前 1914.954 −13186.302j →  校准后  754.637 −13131.243j
```

## 判读

- **CISS 几乎完美**(−0.01 %):它的 `|Z| = 79.7 Ω` 与 `R0 = 100 Ω` 同量级 —— 电桥最灵的位置。
- **COSS +2.4 %**:`|Z|/R0 ≈ 13.6`,已开始吃力。
- **CRSS +21 %(绝对 +2.12 pF)**:`|Z|/R0 ≈ 131`。**这不是新缺陷,是量程问题** ——
  10 pF@1 MHz 在 B 挡本来就在量程外,应该用 D 挡(10 kΩ)测;但 D 挡的通道系数
  被 `|a−1| ≤ 0.50` 守卫拒掉(那条拟合是外推伪解,见
  `20261029_channel_cal_verify.md` §一)。⇒ **CRSS 测小电容时残差偏大,是"无可用高档位"
  的直接后果**,与校准算法本身无关。
- 校准修正量本身很大(CRSS 原始 `Re = 1915 Ω` → `755 Ω`,`Im` 基本不动),
  这与 `a = 1.009 + 0.089j` 的复增益一致。

## 产物

| 文件 | md5 |
|---|---|
| `artifacts/20261102_standard_board_single_point.png`(单点页截图) | `b097e7d4…` |

## 附:界面文案缺陷

「系统复位」页底部写「采样率固定 **65 MSPS**(不可调,发复位即回此档)」,
实际默认已是 **32.50 MSPS**(`CV_ADC_DIV_DEFAULT = 4`)。出处
`src/c_ui/ui/ui_demo.c:3988` 硬编码,纯文案问题,留待下次重编。
