dsgmxc/2026_fpga_qrs/board/measurements/20261030_ai_repeatability.md

# 平台重复性数据集与 AI 判据口径(2026-10-30)

> 起因:2026-10-29 的一次健康扫压被 AI 判成 **CISS 117.1「异常」**,而那条 CISS 曲线
> 与健康基线逐点差在 **±1 %** 以内。根因不是测量,是异常检测模型的协方差
> **只含器件间差异,不含同一块板的重复扫压差异**。本文记录据此新建的重复性数据集、
> 模型口径的变化,以及它对判据灵敏度的影响。

## 一、数据来源

| 项 | 值 |
|---|---|
| 原始日志 | `artifacts/20261029_ai_abnormal_run.log`(1,314,718 B,md5 `25f60fa04921c1601c28156fd4223c91`) |
| 提取脚本 | `src/c_ui/tools/extract_platform_repeats.py` |
| 提取结果 | `artifacts/20261029_platform_repeat_cal_v2.csv`(720 行 = 4 轮 × 3 腿 × 60 点,md5 `e4b5c38c2f21baf18cfc018a60fa23b7`) |
| 配置 | 1 MHz、32.5 MSPS、B 挡 100 Ω、0.1 → 100 V、60 点/腿 |

提取脚本只收**一整轮完整三路扫压**:表头 `CISS+COSS+CRSS`、每条腿点数与表头一致、
所有读数标 `(已校准)`、`Cs > 0`、偏压严格递增。未校准、单腿、点数不齐、含坏点的整轮丢弃。

```bash
python3 src/c_ui/tools/extract_platform_repeats.py \
    --log report/measurements/artifacts/20261029_ai_abnormal_run.log \
    --min-line 8170 \
    --output report/measurements/artifacts/20261029_platform_repeat_cal_v2.csv
```

## 二、为什么只收 4 轮(8170 起)

日志里共有 **7 轮**完整已校准三路扫压。按校准方案分成两组:

| 组 | 扫压开始行 | 校准方案 | 是否入集 |
|---|---|---|---|
| 旧 | 5757 / 6627 / 7304 | 按腿校准(`a ≈ 1.0758`) | ❌ |
| 新 | **8170 / 8913 / 10127 / 11055** | 通道级校准(`a ≈ 0.983`) | ✅ |

两套系数之间有一个固定的增益差;把它们混成一个"重复性总体",算出来的是
**两套校准的差**,不是平台的重复性。实测代价很直接:7 轮混收时,
CRSS 电平 ×1.10 的注入得分从 13.6 掉到 11.4(判据被无谓稀释)。
`--min-line 8170` 只保留当前方案。

## 三、4 轮特征(log10)

| 扫压 | 腿 | 0.3 V 电平 | 100 V 电平 | V50 | V75/V25 |
|---|---|---|---|---|---|
| 8170 | CISS | 3.51182 | 3.30592 | 0.49375 | 0.80915 |
| 8170 | COSS | 3.50771 | 1.93055 | 0.96650 | 0.43150 |
| 8170 | CRSS | 3.16392 | 0.97772 | 0.96021 | 0.24508 |
| 8913 | CISS | 3.51188 | 3.30570 | 0.49338 | 0.80928 |
| 8913 | COSS | 3.50759 | 1.93102 | 0.96630 | 0.43097 |
| 8913 | CRSS | 3.16466 | 0.98525 | 0.95997 | 0.24343 |
| 10127 | CISS | 3.51423 | 3.30200 | 0.49199 | 0.78355 |
| 10127 | COSS | 3.51601 | 1.92729 | 0.96674 | 0.43876 |
| 10127 | CRSS | 3.18007 | 0.99410 | 0.95962 | 0.24829 |
| 11055 | CISS | 3.51392 | 3.30266 | 0.49203 | 0.78797 |
| 11055 | COSS | 3.51473 | 1.92735 | 0.96661 | 0.43881 |
| 11055 | CRSS | 3.17775 | 0.99207 | 0.95969 | 0.24870 |

结构很清楚:**组内两轮几乎重合**(如 CISS V75/V25 0.80915 / 0.80928,0.78355 / 0.78797),
**两组之间是台阶**(0.809 → 0.784,约 −3.1 %),台阶位置正好是重新校准那次
(8913 → 10127)。所以平台的"重复性"里既有逐轮抖动,也有**换校准状态后的整体平移**;
后者恰恰是 2026-10-29 误报的来源,不能当成偶然误差丢掉。

## 四、模型口径变化

| 项 | 旧(LLM-079 / LLM-081) | 新(LLM-083) |
|---|---|---|
| 中心 | 单次平台健康扫压(2026-10-29 v2 CSV) | **4 轮重复扫压的特征均值** |
| 协方差 | 10 颗 TH521 器件收缩协方差(reg = 0.1) | 同上 **+ `diag(平台重复性方差)`**(4 轮估计,`ddof = 1`) |
| 阈值 | 25 / 100 | 25 / 100(不变) |

重复性 σ(log10,行内为 4 个特征):

```
CISS [0.0013, 0.0020, 0.0009, 0.0137]
COSS [0.0045, 0.0020, 0.0002, 0.0044]
CRSS [0.0085, 0.0074, 0.0003, 0.0025]
```

生成命令:

```bash
python3 src/c_ui/tools/fit_anomaly_model.py            # 写 src/c_ui/app/anomaly_model_data.h
python3 src/c_ui/tools/fit_anomaly_model.py --check    # 只打印自检分数
```

## 五、自检结果

| 样本 | CISS | COSS | CRSS |
|---|---|---|---|
| 8170 | 1.92 | 1.29 | 1.05 |
| 8913 | 1.63 | 1.66 | 0.78 |
| 10127 | 2.40 | 1.67 | 0.99 |
| **11055(2026-10-29 报 117.1 那条)** | **1.24** | **1.29** | **0.64** |
| 留一法最大(10 颗器件) | 4.92 | 3.28 | 3.38 |
| 两两最大(器件之间) | 7.93 | 7.79 | 8.12 |

注入异常(对平台健康基线做变换,样本不在建模数据里):

| 注入 | CISS | COSS | CRSS |
|---|---|---|---|
| 电平 ×1.05 | 117.3 | 71.5 | 2.1 |
| 电平 ×1.10 | 443.0 | 265.8 | **13.6(正常)** |
| 电平 ×1.20 | 1617.2 | 962.9 | **62.9(待查)** |
| 电平 ×1.30 | 3347.8 | 1988.4 | **140.1(异常)** |
| 电压轴 ×1.05 | 32.1 | 3.3 | 3.2 |
| 电压轴 ×1.08 | 85.3 | 15.7 | 20.4 |
| 拐点 ×1.2 | 85.8 | 436.4 | 69.8 |
| 拐点 ×1.3 | 141.4 | 991.6 | 140.1 |

## 六、代价与边界

- **CRSS 纯增益 10 % 不再判"异常"(13.6 < 25)。** 平台自身的 CRSS 重复性
  σ ≈ 2 %,10 % 只有 ~3.7σ;要到 ~15 % 才过 25 分。旧模型把这里算成 53.2,
  代价是**健康板被误报** —— 这是有意接受的取舍,测试里写成显式断言。
- 4 轮估计 σ 的自由度只有 3,对**下一次重新校准**的平台平移未必完全覆盖;
  若再次出现组间台阶超过本次观测,应补采扫压再加 `--repeat`,而不是调阈值。
- 模型仍只对**当前固定配置**(1 MHz、32.5 MSPS、B 挡 100 Ω、通道级校准)声明有效。

## 七、上板记录

| 项 | 值 |
|---|---|
| 推送文件 | 仅 `src/c_ui/app/anomaly_model_data.h` |
| 板上重建 | `rm -f build/app/anomaly_detect.o build/app/anomaly_detect.d build/app/pynq_protocol.o build/app/pynq_protocol.d c_ui && make -j2` |
| 新二进制 | `ed89168f00b5e7236a228f519cd77e4e`(旧 `a7608ae7ed65ed1833f7fa23912fac07`) |
| 常量核对 | 16/16 新中心/逆协方差 float 常量命中;4/4 旧 CISS 中心常量 0 命中 |
| 上电周期 | 软重启后 `dmesg` **仅一条** `writing qrs.bin`;`qrs-ui` active;`/proc/634/exe` = `ed89168f…` |

⚠️ **未验**:新模型下的一次真实扫压与 AI 页显示 —— 需要一次由用户触发的测量。
