dsgmxc/2026_fpga_qrs/board/measurements/20261029_channel_cal_verify.md

# 2026-10-29 通道级校准上板验证 · 单点与扫压一致性 + 新 AI 基线

> 目的:验证 `LLM-081` 的「校准改成通道级」是否真的修掉了
> **单点测 CRSS 为负**(而扫压正常)的问题;并用同一轮数据重建 AI 基线。

## 一、问题与本轮改动

| 项 | 内容 |
|---|---|
| 现象 | 单点 CRSS @0.1 V = **−595 pF**;同一器件扫压 CRSS @0.1 V = **+1477.7 pF** |
| 根因 | `sweep_begin_leg()` 从不设置 `s_pair_path`,扫压三腿**全用 RG 腿的系数**;单点按本腿取 —— CRSS 腿自己的拟合退化(`|b| = 3.3·R0`),反演出负电容 |
| 改动 | 应用校准改为**按 (挡位, 频率) 选一条"通道"拟合**(`cal_channel_point()`),取 `|b|/R0` 最小且 ≤ **0.25** 的一条;扫压与单点必然同口径 |
| 物性守卫① | `CAL_B_REL_MAX = 0.25`(`|b|/R0`)—— 挡位 A 的最佳候选为 0.564 ⇒ 判"不可用",页面显示**部分校准**(不拿坏系数硬算) |
| 物性守卫② | 🆕 `CAL_A_DEV_MAX = 0.50`(`|a−1|`)—— **本次追加**。上一版只查 `b`,导致 C/D 挡虽然 `|b|/R0 ≈ 0.001` 却被判"可用",而它们的 `a` 是 `1.054+0.948j` / `1.482+9.471j`(`|a| = 1.42 / 9.6`,相位转 42°/80°)—— 应用后会把噪声放大 9.6 倍还标"已校准" |

用真实校准文件复核(`/tmp/check_channel`,直接调 `Calibration_Init()`):

```
init=1 total=16/48 freq(1MHz)=16
A 10R   available=0
B 100R  available=1
C 1k    available=0
D 10k   available=0
```

⇒ **只有 B 挡应用校准**;A/C/D 一律原样输出原始 Z,界面显示"部分校准"。

## 二、条件

| 项 | 值 |
|---|---|
| 位流 | `qrs.bit` md5 **`c92c7ed5b7d695dee73d86abc1c6089c`**;`dmesg` 中 `writing qrs.bin` **恰 1 次** |
| 固件 | `c_ui` md5 **`5f9c5ddfffbfa02af8f188db68abc634`**(测量用的这份;之后只重编了 AI 模型数据 → `2a0c7ccb…`,不影响测量值) |
| FCLK0 | **50.0000 MHz** |
| 激励 / 采样 | **1.000 MHz** / **32.50 MSPS**(DIV=4, PH_OFF=+1) |
| 挡位 | **B(100 Ω)**,`0x18` 回读 `0x2` |
| 校准文件 | md5 **`c8a3624c2df603678d3f36b4394a2ecc`**,拟合 16/48(仅 1 MHz);通道选中的是 **CISS 腿的 B 挡仿射拟合** `a = 1.009192+0.088978j`,`b = 0.1984+0.9445j`,`|b|/R0 = 0.0097` |
| 扫压 | 0.1 → 100 V,60 点/腿,驻留 300 ms,腿序 CISS → COSS → CRSS |

## 三、结果

### 3.1 点测 vs 扫压首点(偏压 0.1 V,挡位 B,1 MHz)

| 腿 | 单点(3 次) | 单点均值 | 扫压首点 | 点−扫 | TH521 参考 |
|---|---|---|---|---|---|
| CISS | 3285.4 / 3328.3 / 3325.5 pF | 3313.1 pF | 3312.0 pF | **+0.03 %** | 3212.5 pF(+3.1 %) |
| COSS | 3631.2 / 3600.3 / 3603.0 pF | 3611.5 pF | 3480.8 pF | **+3.8 %** | 4163.3 pF(**−13.2 %**) |
| CRSS | 1537.7 / 1538.3 / 1539.6 pF | 1538.5 pF | 1501.5 pF | **+2.5 %** | 1503.9 pF(+2.3 %) |

- **CRSS 由 −595 pF 变为 +1538 pF**,符号与量级都正确;单点与扫压差 2.5 %,不再是两个口径。
- ⚠️ **COSS 系统性偏低 13 %**(点测与扫压彼此一致,说明不是随机误差)。**旧基线同样偏低 12 %**
  (2026-10-29 v1 扫压 3652.1 pF)→ **不是本次校准改动引入的**,成因未查,记在案。
- 用户另做过两次**偏压未使能**的点测作对照:CISS 3443/3444、**COSS 4469/4481**、CRSS 1530/1531 pF。
  与偏压使能后相比,**只有 COSS 变化大**(+24 %),CISS / CRSS 只差几个百分点 ——
  与「0 V 时 Coss 最大」的物理一致。⇒ 早先怀疑的「COSS 重复性差」**不成立**,是两种偏压条件。

### 3.2 扫压完整性

| 项 | 结果 |
|---|---|
| 点数 | **180 / 180**(60 点/腿) |
| OTR 非零 | **0 / 180** |
| `VL/VH` 范围 | 0.59 % – 87.14 % |
| `换腿后第一点` 标记 | **3 / 3** |
| 扫压结束标记 | `[proto] 扫压结束:CRSS,共 60 点已下发到 DAC`(日志第 8554 行) |

### 3.3 ⚠️ 扫压中途的自动换挡(已处置)

板上存在 `/home/xilinx/sweep_auto_gear`(2026-10-15 实验留下的文件开关,跨重启保留),
本轮在 **COSS 第 43 点(13.664 V)** 触发一次 B→C 换挡,核对发现 |Z| 差 2.13 倍后**自动回退 B 并关闭本轮自动**:

```
[proto] 🔁 自动换挡:100 Ω(0x2)→ 1000 Ω(0x4)| 比例反推 |Z| ≈ 659 Ω…
[proto] ⛔ 换挡后 |Z| 对不上:…换成 1000 Ω 挡后反推 1402 Ω(差 2.13 倍)
[relay] 挡位 → 100Ω(0x2, R0 = 100 Ω)
```

影响面:**180 点里只有这 1 点**在 C 挡测得。它与相邻点连续
(12.155 V = 247.3 pF → **13.664 V = 247.7 pF** → 15.362 V = 214.4 pF),不是离群点。
⇒ **数据可用**;事后已 `sudo rm /home/xilinx/sweep_auto_gear`,后续扫压固定挡位。

## 四、AI 基线重建

| 项 | 结果 |
|---|---|
| 新基线 | `artifacts/20261029_leg_settle_sweep_cal_v2.csv`(md5 **`39b15c26bc0a767f90f0e879b7cbcad5`**,180 点) |
| 旧基线 | `20261029_leg_settle_sweep_cal.csv`(**保留**)—— 它是在"三腿套 RG 系数"的错误口径下采的 |
| 自评分 | **0.00 / 0.00 / 0.00** |
| 留一法最大健康分 | 8.99 / 4.01 / 3.94 |
| 两两最大健康分 | 9.07 / 8.32 / 9.02 |
| 注入 `level x1.10` | 1709.2 / 712.0 / 53.2(与旧模型同量级) |
| 生成文件 | `src/c_ui/app/anomaly_model_data.h`,`ANOMALY_MODEL_BASELINE_DATE "2026-10-29"` |
| 宿主单测 | `test_anomaly_detect`、`test_calibration` 均 **ALL OK** |
| 板上二进制 | 重编为 **`2a0c7ccb290626b25f2c56e0e4fdd95d`**;**追加第二道守卫后重编为 `44c1ff2b794078d78de7b448613a5755`**(`nm` 已确认含 `cal_channel_point`)。两份都**下个上电周期生效** |

## 五、产物

| 文件 | md5 |
|---|---|
| `artifacts/20261029_leg_settle_sweep_cal_v2.csv` | `39b15c26bc0a767f90f0e879b7cbcad5` |
| `artifacts/20261029_cv_calibration.dat` | `c8a3624c2df603678d3f36b4394a2ecc` |
| `artifacts/20261029_channel_cal_run.log`(本周期日志 7988–8565 行) | `a59caef3ebc7f91fa90cce106bf11186` |
| 原始日志 | 板上 `/var/log/qrs-ui.log` 第 **7988**(本周期启动)起,至第 **8554**(扫压结束) |

## 六、复验:第二道守卫 + 新基线(同日重启后)

板子软重启 → 服务只加载 **1 次**位流 → 运行中的 `/proc/906/exe` md5 = **`44c1ff2b…`**(带 `|a−1|` 守卫);
FCLK0 50.0000 MHz。用户操作了 A / B 两挡点测 + 两场扫压,日志第 **8617–9316** 行
(产物 `artifacts/20261029_guard_verify_run.log`,md5 **`f5f8a4a7…`**)。

### 6.1 守卫在板上的行为

| 挡位 | 日志标记 | 三腿单点(0.1 V) |
|---|---|---|
| **A(10 Ω)** | `(未校准)` | CISS **3485.7** / COSS **3758.9** / CRSS **1589.2 pF** |
| **B(100 Ω)** | `(已校准)` | CISS **3311.6 / 3328.7**、COSS **3609.4 / 3598.5**、CRSS **1539.3 / 1539.8 pF** |

- **A 挡确实走"原样输出"**(日志明确 `(未校准)`,数值未做反演)—— 与设计一致。
- B 挡重复性:CISS 0.5 %、COSS 0.3 %、CRSS **0.03 %**;RG 单点 `Rg = 3.113 Ω`。
- ⚠️ **C/D 挡本轮没点**(用户只切了 A 和 B)。它们被新守卫拒掉这件事,
  证据是宿主端用**同一份校准文件**跑出的 `available = 0/1/0/0` —— **上板未复现**,如实标注。

### 6.2 扫压与 AI(新基线生效)

| 项 | 结果 |
|---|---|
| 第一场 | CISS 单腿 60 点;`[ai] CISS 0.1 -> 正常` |
| 第二场 | 三腿 **180 点**;`[ai] CISS 0.1 / COSS 0.1 / CRSS 0.7 -> 正常`(阈值 25) |
| OTR | **250 / 250** 条 ADC 记录全为 `OTR 0` |
| 端点 | CISS 3312.5 → 2021.6 pF;COSS 3479.2 → 85.3 pF;CRSS 1504.1 → 9.67 pF |
| 点−扫(CRSS) | 单点 1539.5 vs 扫压首点 1504.1 ⇒ **2.3 %**(与上一轮 2.5 % 同量级) |
| 挡位切换 | 只在用户按 A/B 时发生(`[relay] 挡位 → …`),扫压期间**无自动换挡** |

⇒ **`ANOMALY_MODEL_BASELINE_DATE "2026-10-29"` 的新基线在板上确认有效**(三腿得分 0.1 / 0.1 / 0.7)。

## 七、遗留

1. **COSS 系统性偏低 13 %**(相对 TH521)—— 改动前后都在,单点与扫压一致;未查成因。
2. **A/C/D 三挡都无可用通道系数**,现已由代码强制:
   A 挡 `|b|/R0 = 0.564 > 0.25`(守卫①拒),C/D 挡 `a` 偏离 1 太远
   (C:`1.054+0.948j`、D:`1.482+9.471j`,`|a−1| = 0.95 / 9.48 > 0.50`,守卫②拒)。
   **这三挡原样输出未校准的原始 Z,界面显示"部分校准"** —— 不拿坏系数硬算,
   也不因为"没有系数"就停用该挡(量程仍然可用,只是数值未修正)。
   报告数据只用 B 挡,不受影响。
3. ✅ **已验收(见 §六)**:新守卫生效(A 挡 `(未校准)`)、新基线生效(三腿 0.1 / 0.1 / 0.7)。
   仅剩 **C/D 挡的上板行为未点验**。
