dsgmxc/2026_fpga_qrs/board/measurements/20261015_sweep_consistency_gate_verified.md

# 采集自洽判据 —— 上板验证(2026-10-15 第 63 次会话)

> **这是 `LLM-068` 的"验证方式"那一节。** 判据本体见 `src/c_ui/app/adc_sample.h`
> (`AdcSample_PpConsistent()`),重采外壳见 `src/c_ui/app/pynq_protocol.c`(`adc_capture_pair()`)。
>
> **一句话**:同一台设备、同一批偏压 —— 改前有三个点**逆着趋势往上跳**
> (`Cs = 21.26 / 519.52 / 13.43 pF`,而 CRSS 高压端本应单调下降),改后落到
> **15.57 / 14.74 / 12.31 pF**,整条曲线恢复单调。
> ⚠️ **代价**:CRSS 腿 **5/60 点被判无读数**(8.3%),其中 4 点在 0.2–1.3 V 的陡峭段。
> ⚠️ 这是**先后两轮**对比,不是同时刻交替 —— **严格 A/B 未做**(见 §五)。

---

## 一、运行条件

| 项 | 值 |
|---|---|
| 位流 | `c92c7ed5b7d695dee73d86abc1c6089c`(10-15 第 61 次构建) |
| `c_ui` | **2864832 B**,md5 `887812b56c9de93f02ad7793bf0349f0`(运行中进程 `/proc/969/exe` 回读一致) |
| 扫压 | `CISS+COSS+CRSS,0.10 V → 100.00 V,60 点/腿,每点 300 ms` |
| 档位 | `0x18 = 2`(B 挡 100 Ω),**扫压期间固定**(`SWEEP_AUTO_GEAR_FLAG` 文件不存在 ⇒ 自动换挡关闭) |
| 激励 | `0x80 = 0xA3D70A` = 1.000 MHz |
| ADC | `0x88 = 0x00000104`(DIV=4,PH_OFF=+1)⇒ **32.5 MSPS** |
| 重采上限 | `CV_ADC_TRIES` 未设 ⇒ **3**(默认) |
| 判据 | `码 ≤ 3.0 × 2×幅值 + 64`(单边) |

**对照用的"改前"那一轮**:同一份 `/var/log/qrs-ui.log` 的 **6669 行**那次扫压,
参数完全相同(同档位、同激励、同 60 点/腿),**跑的是旧 `c_ui`**(`2861204 B`,
`6bec1b4b…`)。两轮之间只换了 `c_ui`,**硬件、接线、配置一字未动**。

> ⚠️ **这不是严格 A/B**:两轮是先后跑的,不是同一时刻交替。
> 严格 A/B(同目标连扫两轮、其中一轮带 `CV_ADC_TRIES=1`)仍待做 —— 见 §五。

---

## 二、总账

| | 改前(6669 行) | 改后(8116 行) |
|---|---|---|
| 有读数的点 | 180 / 180 | **175 / 180** |
| `码/期望` 中位 | 1.03 | 1.03 |
| `码/期望` **p90** | 4.75 | **1.99** |
| `码/期望` **max** | **167.04** | **7.54** |
| 比值 **> 10** 的点 | **5** | **0** |
| 比值 **> 50** 的点 | **3** | **0** |
| 采集次数 | 180(每点一次) | **211**(160 点一次过 + 21 次重采 + 15 次被弃点的尝试) |

**账本原文**(`/var/log/qrs-ui.log:8558`):
```
[proto] 采集自洽账本:实际采 223 次,判据拒收 36 次,重采救回 15 点,判无效 5 点(CV_ADC_TRIES=3)
```
⚠️ **这四个数是"c_ui 进程启动以来"的累计,不是"本轮扫压"的**(`s_adc_rej` 等只在
`pynq_protocol.c:1322` 进程初始化时清零,`sweep_start()` 里没有清零)。
**36 次拒收、5 次判无效全部落在本轮扫压内**(日志里全部 `拒收第` 与 `⛔` 行都在 8116–8558)。

📌 **对账:211(扫压内,可数) + 11(扫压前的单点证据行,全是 0.1 V)= 222,账本说 223。**
**差 1 次,未解释** —— 最可能是某次采集在打印证据行**之前**就失败退出(那条路径只打
`adc_report_failure()` 不打证据行),但**没有证据,只是最可能的解释**。

> 📌 **这是我这行日志的措辞缺陷** —— 它挂在 `sweep_finish()` 里,读起来像"本轮"。
> 要么改成进程累计的口径,要么在 `sweep_start()` 里真的清零。**记在此处,未修。**

---

## 三、★ 决定性证据:同一个偏压,改前漏过 / 改后拦下

CRSS 腿高压端逐点对照(改前那轮的 `码/期望` 由 `幅值 V` 与 `峰峰 码` **现算** ——
旧二进制不打这两列;改后那轮是二进制自己打的):

| 偏压 V | 改前 `码/期望` B | 改前 Cs pF | 改后 `码/期望` B | 改后 Cs pF | 判读 |
|---|---|---|---|---|---|
| 39.190 | 1.70 | 16.35 | 2.37 | 16.48 | 一致 |
| **44.060** | **167.04** | **21.26** | 2.14 | **15.57** | ★ 改前漏过坏字 |
| **49.530** | **94.30** | **519.52** | 2.27 | **14.74** | ★ 改前漏过坏字 |
| 55.690 | 2.53 | 13.28 | **141.15** | **—** | ⛔ 改后判无读数(连拒 3 次) |
| 62.600 | 3.29 | 12.86 | 2.63 | 12.79 | 一致 |
| **70.380** | **63.57** | 13.43 | 3.81 | **12.31** | ★ 改前漏过坏字 |
| 79.120 | 7.32 | 11.83 | 2.54 | 12.05 | 一致 |
| 88.950 | 7.85 | 11.32 | 7.54 | 11.44 | 一致(小信号区) |
| 100.000 | 3.50 | 11.14 | 2.22 | 11.08 | 一致 |

**判读用"单调性"而不是"插值",理由是不循环论证** —— CRSS 在高压端本来就该**单调下降**
(`Cs ∝ 1/VL²` 且 Crss 随 VDS 增大而降)。把相邻几点连起来看:

```
改前 Cs:  16.35 → 21.26 → 519.52 → 13.28 → 12.86 → 13.43 → 11.83 → 11.32 → 11.14
          (39.19)  (44.06)  (49.53)  (55.69)  (62.60)  (70.38)  (79.12)  (88.95)  (100.0)
                        ↑↑↑ 向上跳 34%      ↑↑↑ 向上跳 3800%   ↑↑↑ 向上跳 4%
改后 Cs:  16.48 → 15.57 → 14.74 → [断]  → 12.79 → 12.31 → 12.05 → 11.44 → 11.08
```

**改后除"被弃的 55.69 V"外严格单调下降。改前有三个点逆着趋势往上跳。**

> ✅ **判据确实在起作用 —— 不是"代码看着对",是同一批偏压上的数变了。**
> ⚠️ 但**不要**说"改后这三个数就是真值" —— 只能说"**改后不再逆趋势**"。
> 真值要靠已知电容比对。

---

## 四、代价:被拒/被弃的点在哪

全部 **36 次拒收**,按偏压归成 **20 组**(一组 = 同一个点上的连续拒收)。
表中只列**被拒那几次**的比值,采纳那次的比值不列(= 它已经过了闸):

| 回路 | 偏压 V | 拒收次数 | 各次(被拒的)`码/期望 B` | 结局 |
|---|---|---|---|---|
| **COSS** | 79.123 | 2 | **24.32 / 12.64** | ✓ 采纳(第 3 次) |
| **COSS** | 88.951 | 2 | **26.00 / 6.61** | ✓ 采纳(第 3 次) |
| CRSS | 0.202 | 1 | 9.26 | ✓ 采纳(第 2 次) |
| **CRSS** | **0.322** | 3 | 5.91 / 9.46 / 5.96 | ⛔ 判无读数 |
| **CRSS** | **0.363** | 3 | 5.70 / 5.49 / 4.20 | ⛔ 判无读数 |
| CRSS | 0.408 | 1 | 8.85 | ✓ 采纳(第 2 次) |
| CRSS | 0.515 | 2 | 6.10 / 6.13 | ✓ 采纳(第 3 次) |
| **CRSS** | **0.579** | 3 | 5.76 / 4.73 / 6.49 | ⛔ 判无读数 |
| CRSS | 0.651 | 1 | 7.50 | ✓ 采纳(第 2 次) |
| CRSS | 1.040 | 2 | 5.10 / 5.60 | ✓ 采纳(第 3 次) |
| **CRSS** | **1.314** | 3 | 4.43 / 8.20 / 6.40 | ⛔ 判无读数 |
| CRSS | 1.477 | 2 | 5.51 / 6.33 | ✓ 采纳(第 3 次) |
| CRSS | 1.867 | 1 | 5.94 | ✓ 采纳(第 2 次) |
| CRSS | 2.360 | 2 | 6.19 / 11.54 | ✓ 采纳(第 3 次) |
| CRSS | 10.812 | 1 | **71.95** | ✓ 采纳(第 2 次) |
| CRSS | 44.062 | 1 | **27.47** | ✓ 采纳(第 2 次) |
| CRSS | 49.535 | 1 | **202.57** | ✓ 采纳(第 2 次) |
| **CRSS** | **55.688** | 3 | **194.92 / 161.71 / 142.37** | ⛔ 判无读数 |
| CRSS | 70.381 | 1 | **88.62** | ✓ 采纳(第 2 次) |
| CRSS | 100.000 | 1 | **116.16** | ✓ 采纳(第 2 次) |

**CISS 腿一次拒收都没有**(60 点全部一次过)。

**两种性质完全不同的"拒收",不能混为一谈**:

| 类型 | 出现位置 | 典型比值 | 重采救得回吗 |
|---|---|---|---|
| **A. 灾难性坏字** | COSS 高压端(≥79 V)+ CRSS 高压端(≥10 V) | **24 ~ 203** | ✅ **救得回**(9 组里 8 组两次以内就过) |
| **B. 陡峭段的中度失配** | CRSS 低偏压端(**0.2 – 2.4 V**) | **4 ~ 12** | ⚠️ **一半救不回**(14 组里 4 组连拒 3 次) |

- **A 类就是这次要修的东西** —— 比值 24–203 正是旧日志里酿成 21/519 pF 尖峰的那一类。
  ⚠️ **修正一处早先的说法**:我先前写"A 类只在 CRSS 高压端",**不对** ——
  COSS 的 79.123 / 88.951 也各有一次(24.32 / 26.00)。A 类**两条腿都有**,只是 COSS 只有 2 处。
- **B 类是判据的"过度收紧"区**:0.2–2.4 V 是 CRSS 从 1747 pF 掉到 840 pF 的陡峭段,
  B 路幅值本来就小(`码/期望` 分母小),`FLOOR = 64` 挡不住比值 5–6。
  **4 个被弃的点全部在这个区**,而这里恰恰是曲线信息最密的地方。

### ⚠️ 一条与既有结论有张力的实测

`LLM-068` 的"重采可行性"论证是:日志里同一偏压连测 ≥4 次的 **63 组全部"有时标、有时不标",
次次都标的一组都没有** ⇒ 重采能救。

本轮出现了一个**连拒 3 次**的点(`55.688 V`,B = 194.92 / 161.71 / 142.37)。
❗ **三个值差异很大,说明是三次独立的坏字,不是恒定条件** —— 所以它**不推翻**那条结论
(那条说的是"没有恒定失败的点"),但它说明:**坏字概率高的点上,3 次重采会不够**。
⇒ 若这类点变多,**先查 RTL 的采样刻度,不要把阈值放宽**(放宽度不足以覆盖 142 这种量级,
只会把 519 pF 那种尖峰重新放回曲线上)。

---

## 五、还没做的(不得当成做到了)

| 项 | 为什么没做 |
|---|---|
| **严格 A/B**(同目标连扫两轮,一轮 `CV_ADC_TRIES=1`) | 改 `qrs-ui.service` 的 `Environment` 要**重启服务** = **第二次加载位流**(红线)。只能等下一个上电周期 |
| **一次采集耗时实测** | `ADC_SAMPLE_TRIES_MAX` 注释里写的 `~6 ms` **仍是估计值**。方法:两轮总时长差 ÷ 重采次数 |
| **B 类拒收的收紧是否过度** | 要拿已知电容在 0.2–2.4 V 段比对才能判。**现在只能说"它把 4 个点判没了",不能说"这 4 个点本来就该丢"** |

---

## 六、复现

```bash
# 板上(需 sudo)
sudo -E python3 -c "..."                # 或直接看日志
grep -a '码/期望' /var/log/qrs-ui.log | tail -200
grep -a '自洽账本' /var/log/qrs-ui.log
grep -a '本点连采' /var/log/qrs-ui.log   # 判无读数的点

# 关掉重采退回旧行为(下一个上电周期,写进 service Environment)
CV_ADC_TRIES=1
```

**原始数据**:`report/measurements/artifacts/`
- `20261015_sweep63_consistency_gate.log` —— 本轮扫压 443 行原文(8116–8558)
- `20261015_sweep63_after.csv` —— 改后 180 点(5 点 `cs` 为空 = 判无读数)
- `20261015_sweep63_before.csv` —— 改前 180 点,同一份日志的 6669 行那次
