dsgmxc/2026_fpga_qrs/board/measurements/20261001_lcd_ps_ctrl_and_fclk0.md

# 2026-10-01 · PS 控屏闭环 + FCLK0 频率实测 · 板上实测存档

> # 🔴 2026-10-03 更正批注 —— 本文件 §5.2 / §5.3 / §八 的时钟结论**已被推翻**
>
> **错误结论**:「FCLK0 实测 = 41.6667 MHz」「IO PLL = 1500 MHz」。
> **实际**:本板 IO PLL = **1000 MHz**,当时 DIV0=6/DIV1=6 的真值是 **27.78 MHz**。
> **原因**:41.6667 是 `Clocks.fclk0_mhz` 的**读回值**,而 PYNQ 内部假定 IO PLL = 1500
> ⇒ `1500/6/6`。**它是除法结果,不是任何仪表的读数。**
> 本文 §5.2 列的三条"相互独立证据"**其实是同一条** —— 全部源自 PYNQ 那一个内部假定。
>
> **推翻方式**(2026-10-03,首次独立时基测量):帧几何是常量(1344×635),
> 若 FCLK0 真是 41.6667 MHz,帧率应为 48.82 Hz;**实测 32.50 Hz**,差 50%。
> 该判据不依赖任何 PS_CLK 假定。
>
> 📄 详见 [`20261003_fclk0_real_measured.md`](20261003_fclk0_real_measured.md)。
>
> **正文一律保持原样,不作修改** —— 保留完整纠错轨迹,是 M11「自我纠错」的正文素材。
> 引用本文时,**§5.2 / §5.3 / §八 的时钟部分不得再作为依据**;
> §5.1(PS 控屏闭环)与 §六(工程侧核实)**不受影响,仍然有效**。

> 本轮两个成果:
> ① **PS 第一次能控制 LCD** —— `cv_sys` 内像素源 mux 打通,自写 AXI 寄存器直接改屏色;
> ② **FCLK0 实测 = 41.6667 MHz** —— 与 BD 里写的 50 MHz **不一致**,并已确认可用 PYNQ 在运行时改到精确的 50 MHz。
>
> 对应必做点 **M13**(板上跑通 + 实测输出)/ **M04**(实测与参考比对)。
> ② 是本项目**第一条"设计值 vs 实测值"不符的硬证据**,归入 **B9 决策记录**素材。

---

## 一、被测对象 / 测点

| 项 | 值 |
|---|---|
| 被测对象 | `cv_sys`(PL 顶层容器)+ `cv_axi_lite_slave` 新增的 `LCD_CTRL` / `LCD_FILL` 两个寄存器 |
| 测点 | **无物理测点** —— 测的是 AXI 寄存器语义 + 屏上像素结果 |
| 基址 | `0x43C0_0000`,窗口 4 KB |
| 仪器 | **无**。读数为 `MMIO.read()` 返回值与肉眼观察屏幕 |
| 屏幕 | ATK-MD0700R-1024600-IPS,1024×600,RGB888,DE 模式 |

⚠️ **本轮无万用表、无示波器、无 ILA** —— 凡涉及"频率"的结论只有寄存器算术,
**没有独立时基测量**。见 §七。

## 二、所烧位流版本(**排除"烧的是旧程序"**)

| 项 | 值 |
|---|---|
| 仓库内文件 | `board/qrs.bit`,**4 045 690 B**,2026-10-01 17:41 |
| **md5** | **`92b7edd62375db289be3a23343a2a427`** |
| 工程侧原件 | `qrs.runs/impl_1/system_wrapper.bit`,md5 **同上** ✅ |
| `.hwh` | `board/qrs.hwh`,129 596 B,md5 **`3193004015494b4818c9c6f76262bc2b`** |

> 🟢 **本次比 2026-09-29 那次强一档**:上次只有"本地时间戳没变过",
> 这次**仓库内的 `.bit` 与工程侧产物做过 md5 逐字节比对,一致** ——
> 但**仍未与板子上那份做过比对**。`scp` 之后本地文件未再改动,只能说"传上去的那份是这一版"。

## 三、板型与环境

| 项 | 值 |
|---|---|
| 板型 | 正点原子领航者 ZYNQ-7020(xc7z020clg400-2) |
| PYNQ | **2.7.0** |
| 板上 Python | **3.8.2** |
| 上位机 | `scp` 经直连网线(192.168.2.100 ↔ 192.168.2.99) |
| 加载方式 | `Overlay('/home/xilinx/qrs.bit')`,**只加载 `.bit`,不跑 `ps7_init`** |
| 执行 | 板上 `sudo -E /usr/local/share/pynq-venv/bin/python3` |

⚠️ 全程**上板操作由用户执行**,模型未接触板子;串口输出由用户粘贴,是本轮**唯一**实测来源。

## 四、原始串口输出(用户执行,原文照录)

### 4.1 链路自检 + PS 控屏

```
[sudo] password for xilinx:
['cv_sys_0', 'processing_system7_0']
phys_addr: 0x43c00000
VERSION  : 0x10000
write 0xDEADBEEF -> read 0xDEADBEEF  OK
write 0xA5A55A5A -> read 0xA5A55A5A  OK
LCD_CTRL 复位值: 0x0 (应为 0 = 彩条)
绿 0x00FF00 -> 回读 FILL=0x00FF00 CTRL=0x00000001
红 0xFF0000 -> 回读 FILL=0xFF0000 CTRL=0x00000001
蓝 0x0000FF -> 回读 FILL=0x0000FF CTRL=0x00000001
切回彩条 -> 回读 CTRL=0x00000000
```

**用户观察:绿 → 红 → 蓝 → 彩条,屏上四次变化全部正确。**

### 4.2 FCLK0 频率

```
$ sudo -E …/python3 -c "from pynq import Clocks;print('fclk0', Clocks.fclk0_mhz)"
fclk0 41.666667

$ sudo -E …/python3 -c "from pynq import MMIO;v=MMIO(0xF8000170,4).read(0);print(hex(v))"
0x600600
```

### 4.3 运行时改频 + 寄存器前后对比

```
$ sudo -E …/python3 -c "…m=MMIO(0xF8000170,4); print(hex(m.read(0))); Clocks.fclk0_mhz=50;print(hex(m.read(0)))"
0x600600
0x101e00
```

**用户观察:改频后屏仍正常显示(闪一下后照旧)。**

## 五、预期值 vs 实测值(M04 要的比对数据)

### 5.1 PS 控屏

| # | 操作 | 预期 | **实测** | 判定 |
|---|---|---|---|---|
| 1 | `ip_dict` 键 | 仅自建 `cv_sys_0` + PS7 | `['cv_sys_0','processing_system7_0']` | ✅ |
| 2 | `phys_addr` | `0x43C00000` | `0x43c00000` | ✅ |
| 3 | `read(0x48)` | `0x0001_0000` | `0x10000` | ✅ |
| 4 | `write(0x4C,0xDEADBEEF)` | 回读同值 | `0xdeadbeef` | ✅ |
| 5 | `write(0x4C,0xA5A55A5A)` | 回读同值 | `0xa5a55a5a` | ✅ |
| 6 | `read(0x50)` 复位值 | `0`(彩条) | `0x0` | ✅ |
| 7 | 写 `0x54`+`0x50=1` ×3 色 | 屏变对应色 | 绿/红/蓝 **均正确** | ✅ |
| 8 | `0x50=0` | 回彩条 | 屏回彩条 | ✅ |

🟢 **第 1 条是意外收获**:`axi_gpio_0` 不在 `ip_dict` 里 —— 用户在 BD 中删除 GPIO 这一动作的**独立旁证**。

🟢 **第 7 条同时验证了 RGB 位序**:三色各只亮一个通道(`0x00FF00`/`0xFF0000`/`0x0000FF`),
若 24 根 RGB 位序接错,出现的会是**别的颜色**。用户确认颜色正确 ⇒ **RGB888 位序正确**。
> ⚠️ 但这与 `measurements/README.md` 里"**彩条的顺序才有判别力**"不冲突 ——
> 那条说的是厂商彩条的**白\|黑\|红\|绿\|蓝 顺序**(LLM-021),与本轮的单色填充是两回事,不得互相替代。

### 5.2 FCLK0 —— **设计值 vs 实测值不符**

| 项 | 设计值(BD) | **实测值** | 差异 |
|---|---|---|---|
| FCLK0 | `PCW_ACT_FPGA0_PERIPHERAL_FREQMHZ = 50.000000` | **41.666667 MHz** | **−16.7%** |

**寄存器解码**(Zynq-7000 `FPGA0_CLK_CTRL` @ `0xF8000170`):

| 时刻 | 寄存器值 | `DIVISOR0 [13:8]` | `DIVISOR1 [25:20]` | `SRCSEL [5:4]` | 反算 IO PLL |
|---|---|---|---|---|---|
| 改前 | `0x00600600` | 6 | 6 | 0(IO PLL) | 41.6667 × 36 = **1500 MHz** |
| 改后 | `0x00101e00` | 30 | 1 | 0(IO PLL) | 50.0 × 30 = **1500 MHz** |

**第三个独立证据**:PYNQ 收到"要 50 MHz"后自行写入 `DIV0=30` ——
它也认为 `50 × 30 = 1500`,即 **IO PLL = 1500 MHz**(PS_CLK 33.333 × 45)。

**三条相互独立的事实指向同一结论**:
1. `1500/6/6 = 41.6667` 与 `Clocks.fclk0_mhz` 读数分毫不差 ⇒ **41.6667 是真时钟**
2. 改频后**寄存器发生变化**(`0x00600600` → `0x00101e00`)⇒ **PYNQ 操作的是真硬件,不是缓存**
3. `1500/30/1 = 50.0` 与请求值吻合 ⇒ **`Clocks.fclk0_mhz = 50` 是可用且精确的**

### 5.3 根因

`Overlay()` **只加载 `.bit`,不跑 `ps7_init`** ⇒ FCLK0 的实际值由**板子启动镜像的 `BOOT.BIN`** 决定,
**BD 里的 `PCW_ACT_FPGA0_PERIPHERAL_FREQMHZ` 在运行时被完全忽略**。
本板 `BOOT.BIN` 把 FCLK0 留在 `41.6667 MHz`,工程里写的 50 MHz **从未生效过**。

## 六、同批次工程侧核实(非板上证据,供互相印证)

| 项 | 值 | 来源 |
|---|---|---|
| BD 参数 | `PCW_ACT_FPGA0_PERIPHERAL_FREQMHZ = 50.000000` | `qrs.srcs/sources_1/bd/system/system.bd` |
| 时序(按 50 MHz 约束收敛) | WNS **+13.943 ns** / TNS 0.000 / 失败端点 **0** | `impl_1/…timing_summary_routed.rpt`(2026-09-29 批次) |
| 资源 | LUT **616**(1.16%)、FF **758**、BRAM 0、DSP 0 | `impl_1/…utilization_placed.rpt` |

> 🔑 **时序余量方向是安全的**:设计按 **50 MHz(20 ns 周期)** 收敛且通过,
> 实际跑 **41.6667 MHz(24 ns 周期)** ⇒ **余量更大**,不存在"跑超频"的风险。
> 反过来,把时钟改回 50 MHz 也仍在已收敛的约束之内。

## 七、本轮**没有**证明的事(不得越界引用)

- ❌ **FCLK0 的 41.6667 / 50.0 MHz 只有"寄存器解码 + PYNQ 请求值"两条证据,没有独立时基测量。**
  未用示波器测 PL 输出引脚、未用 ILA 计频。**严格说这是"配置推断",不是"频率测量"**;
  但它比纯读文档强 —— **寄存器是硬件状态,不是文档**。
- ❌ **未证明 50 MHz 下 LCD 的刷新率是多少。** 只证明"屏正常显示"。
- ❌ **未测设置 50 MHz 后 AXI 事务是否仍然可靠** —— 改频后没有重跑一遍 `SCRATCH` 回环。
- ❌ **未做任何功能仿真。** `cv_sys.v` / `cv_axi_lite_slave.v` 至今零激励、零波形。
- ❌ **未测 `WSTRB`**、未测未实现地址的读行为、未测背靠背连续访问。
- ❌ **未证明 `LCD_CTRL` / `LCD_FILL` 之外其余 18 个寄存器的行为** —— `case` 里根本没有它们。
- ❌ **未测厂商 `lcd_driver` / `lcd_display` 的 HS/VS/DE 时序参数**。
  本轮通过**不能**继承给将来的自研 `lcd_timing`。
- ⚠️ **改频后未做断电重启验证** —— `Clocks.fclk0_mhz` 是**运行时**动作,
  断电后一定回到 `BOOT.BIN` 设定的 41.6667,**尚未验证这一点**。

## 八、结论

🟢 **PS 控屏闭环达成**(2026-10-01):PS 写 `0x54` + `0x50` ⇒ 屏变色,两个 mux 分支(彩条 / 填充)均验证。

🟡 **FCLK0 频率:设计值 50 MHz,实测 41.6667 MHz,不符。**
已确认可在运行时改到精确的 50 MHz(寄存器实测确认),**但该结论尚未固化为代码**。

⚠️ **口径纪律**:本项目此前所有文档写"`clk_axi` = 50 MHz"—— 依据一直是 **BD 配置**。
本文件首次给出**板上实测值 41.6667 MHz**。**报告引用时必须区分"设计值"与"实测值"**,
不得写成"clk_axi = 50 MHz(实测)"。

## 九、遗留决策

| # | 决策点 | 选项 |
|---|---|---|
| F1 | 时钟方案 | **A** 运行时 `Clocks.fclk0_mhz=50` 固化进 `main.py` / **B** 重建 `BOOT.BIN` / **C** 接受 41.6667 并改全部文档 |
| F2 | 若选 A | 设定时机应是 `Overlay()` **之前**(PL 首拍即在 50 MHz),需实测确认 |
| F3 | 若选 C | 需同步改 BD 的 `FREQ_HZ`、`.hwh`、所有 `.v` 的 `X_INTERFACE_PARAMETER` |

**模型建议:选 A。** 理由——① 一行、零硬件工作;② 使时钟成为**本设计自己保证的常量**,
不再继承 `BOOT.BIN` 的偶然值(换板/换镜像即失效);③ 仍在已收敛的 50 MHz 约束内,无时序风险。
