dsgmxc/2026_fpga_qrs/board/measurements/20261003_ddr_hp0_decerr.md

# 2026-10-03 · DDR 帧缓存全黑 —— HP0 **每个**读事务都回 DECERR · 板上实测存档

> ## 🟢 后续(2026-10-03 同日晚):根因已找到
>
> **根因:`ARPROT[1]`(NS,非安全位)置 1。** 修法 `assign m_axi_arprot = 3'h0;`
> —— **`ARCACHE` 无关**。2×2 单变量分离四格全测,每格先核综合后网表再上板。
> 位流 `0e4cb57c…`,**显示通路已端到端打通**(用户目视确认图案)。
>
> 📄 `report/measurements/20261003_hp0_decerr_rootcause_arprot.md` · `report/llm-log/LLM-036.md`
>
> ⚠️ 本文件的**现象**部分全部有效;**§十 的"下一步"已由上述文件接管**。

> **本轮结论(一句话)**:`src_sel=2`(DDR 帧缓存)时,**AXI 读事务全部握手成功、拍数满帧**,
> 但**每一个响应都是 `DECERR` 且 `RDATA` 全零**;**与地址无关** —— 9 个地址扫描无一例外。
>
> 🔴 **根因未找到**(← 此句已被上方更正覆盖)。本文件的价值在于**把已排除项逐条钉死**。
> 本文**不含任何推断性结论**,凡未实测的一律写"未验证"。

> 对应必做点 **M2**(验证结果:说明功能正确性是怎么确认的 —— 本轮是**反面**证据链)、
> **M13**(板上实测)、归入 **B9 决策记录**与 **M11 纠错轨迹**素材。
>
> 承 [`20261003_fclk0_real_measured.md`](20261003_fclk0_real_measured.md)(同日,时钟口径)。

---

## 一、被测对象 / 测点 / 仪器

| 项 | 值 |
|---|---|
| 被测对象 | `lcd_fb_reader.v`(PL 自研 AXI3 读主机)+ BD 里 `cv_sys_0/M_AXI` → `processing_system7_0/S_AXI_HP0` 直连通路 |
| 测点 | **无物理测点** —— 全部通过 `cv_axi_lite_slave` 的三个只读观测寄存器读出 |
| 观测寄存器 | `0x74 DBG_BEATS` / `0x78 DBG_ARADDR` / `0x7C DBG_STATE` |
| 仪器 | **无。** 无逻辑分析仪、无 ILA、无示波器 |
| 屏幕 | ATK-MD0700R-1024600-IPS,1024×600,RGB888,DE 模式 |
| 判定方式 | ① PS 读寄存器;**② 人眼看屏**(用户报"全黑") |

⚠️ **本轮所有"AXI 层面"的结论都来自 PL 内部自己数出来的计数器,没有独立旁观者。**
计数器本身可能与故障同源 —— 这一点在 §六 标明。

## 二、所烧位流版本(排除"烧的是旧程序")

| 项 | 值 |
|---|---|
| 板上 `/home/xilinx/qrs.bit` md5 | **`f45cb1753d5b0e108bc9783eca615fd6`** |
| 工程侧 `qrs.runs/impl_1/system_wrapper.bit` md5 | **同上** ✅ |
| 板上 `/home/xilinx/qrs.hwh` md5 | **`4fa2032b4e2f65712e951300bbe33c3b`** |
| 工程侧 `qrs.gen/sources_1/bd/system/hw_handoff/system.hwh` md5 | **同上** ✅ |

> 🟢 **`.bit`/`.hwh` 是配套的一对,两侧都做过 md5 逐字节比对。**
> 两个文件 mtime 不同(hwh 21:40 / bit 00:34)—— 那是因为 **`.hwh` 由 BD 生成、
> 重跑 `impl_1` 不会重新生成它**;本轮 RTL 改动**不涉及 BD 端口**,BD 未变、hwh 未变。
>
> ⚠️ 但**仍未与板子上那份做过比对**:`scp` 之后本地文件未再改动,
> 只能说"传上去的那份是这一版"。

## 三、本条位流相对上一版的唯一改动(0x74 拆位)

第 33 次位流已证明**拍数是满帧**(153600),却仍全黑 ⇒ 说明"拍数"只证明**握手发生了**,
**看不见数据本身**。故本轮把 `0x74` 拆成两段:

| 位 | 字段 | 含义 |
|---|---|---|
| `[17:0]` | `beats_cnt` | 本帧 `m_axi_rvalid` 拍数(满帧 **153600** = 256 拍 × 600 行) |
| `[19:18]` | `rresp_lat` | 本帧最后一次非 OKAY 响应:`00` 无 / `10` SLVERR / `11` **DECERR** |
| `[20]` | `axi_or_nz` | 本帧**任一拍 `rdata` 有任一比特为 1** |
| `[21]` | `px_or_nz` | 本帧 `px_data` 出现过非零(**行缓冲确实读出了东西**) |
| `[31:22]` | — | 保留 |

> 🔑 **为什么要这样拆**:`DECERR` 时 AXI 从设备会回 **全零数据**,而**握手照常完成**。
> 只看拍数,「拿到了 153600 拍零」和「拿到了 153600 拍真图像」**读数完全一样**。

## 四、原始实测数据

### 4.1 三个工况(`tools/lcd_ddr_debug.py`,每点连采 300 次取最大值)

| # | 工况 | `beats_cnt` | 占满帧 | `rresp_lat` | `axi_or_nz` | `px_or_nz` | 屏上(用户目视) |
|---|---|---|---|---|---|---|---|
| 1 | `src=0` 厂商彩条(基线:不该取数) | **0** | 0.0% | `00`(无错) | 0 | 0 | 🟢 正常彩条 |
| 2 | `src=1` 整屏填充 | — | — | — | — | — | 🟢 正常纯色 |
| 3 | `src=2` fb0 = `0x38100000`(内容:整屏绿+中间红横带) | **153088** | 99.7% | **`11` DECERR** | **0** | **0** | 🔴 **全黑** |
| 4 | `src=2` fb0 = `0x00100000`(内核镜像,内容必然非零) | **153121** | 99.7% | **`11` DECERR** | **0** | **0** | 🔴 **仍然全黑** |
| 5 | `src=2` fb0 = `0x38230000`(自己的 fb1:整屏蓝) | **153600** | 100% | **`11` DECERR** | **0** | **0** | 🔴 **仍然全黑** |

> 第 3/4/5 行的 99.7% 是**帧内随机采样**的产物(`0x74` 每个 `frame_start` 清零),
> 不是欠载。第 5 行采到 100%。

🟢 **第 1 行是干净的对照组**:不取数时 `rresp_lat = 00`,`axi_or_nz = 0`。
⇒ **DECERR 是我方读事务的响应**,不是背景噪声。

🔴 **第 4 行是最有判别力的一行**:地址换成**内核镜像**(内容当然是任意非零字节)。
若通路只是"取错了块 DDR",屏上应出现**花屏/噪声**;
实际是**仍然全黑**且 `axi_or_nz=0` ⇒ **一个非零比特都没回来过**。

### 4.2 `DBG_ARADDR` 地址生成器核对(证明"地址算对了")

`0x78` 采到 **`0x381EDF80`**,按 fb0 = `0x38100000` 拆:

```
0x381EDF80 - 0x38100000 = 0x000EDF80 = 974 720 (十进制)
974 720 = 456 × 2048 + 15 × 128
          └ 行号 456    └ 该行内第 15 个突发 × 128 B(16 拍 × 8 B)
```
⇒ 行首对齐 ✅、128 B 对齐 ✅、落在 fb0 的 1,245,184 B 范围内 ✅。

### 4.3 地址扫描(`tools/lcd_fb_sweep.py`)—— **决定性的一轮**

把 `fb_base0` 依次指向 9 个地址,每点采 120 次:

| 地址 | 指向 |
|---|---|
| `0x00000000` | OCM(**必然可读**) |
| `0x000F0000` | DDR 低端 |
| `0x00100000` | 内核镜像起始 |
| `0x01000000` | DDR 中段 |
| `0x10000000` | DDR |
| `0x20000000` | DDR |
| `0x30000000` | DDR |
| `0x3FF00000` | DDR 顶端(1 GB 边界内) |
| `0x40000000` | **越界**(HP0 的 MEMRANGE 上界 = `0x3FFFFFFF`) |

**结果:9 个地址无一例外,全部 `rresp_lat = 11 (DECERR)` 且 `axi_or_nz = 0`。**

🔑 **这一轮的作用**:`0x00000000`(OCM)和越界的 `0x40000000` **给出完全相同的读数**
⇒ **拒绝发生在端口层面,与地址译码无关。**
"地址映射配错了""帧缓存不在 DDR 里""PS 没 flush cache"这一类假设**全部作废**。

## 五、已排除项(每条都带证据)

| # | 假设 | 判据 | 结论 |
|---|---|---|---|
| 1 | 帧缓存分配/地址错了 | 9 点扫描全 DECERR,含 OCM 与越界地址 | ❌ 排除,**与地址无关** |
| 2 | 数据没写进 DDR(cache 未 flush,风险 D1) | 换成内核镜像地址仍 `axi_or_nz=0` | ❌ 排除(至少不是**唯一**原因) |
| 3 | TrustZone 把 DDR 判成安全区 | `TZ_DDR_RAM` = `0x00000000` ⇒ 全片非安全 | ❌ 排除 |
| 4 | HP0 地址窗口配错 | hwh MEMRANGE `HP0_DDR_LOWOCM` = `[0x00000000, 0x3FFFFFFF]` | ❌ 排除 |
| 5 | BD 连线/位宽错 | 生成的 `synth/system.v` 里 `S_AXI_HP0_ARID`/`ARLOCK`/`ARQOS` 均接 0,`ARCACHE`/`ARPROT`/`RRESP` 均已连;hwh 端口宽度逐条核过 | ❌ 排除 |
| 6 | 我 10-02 写挂板子留下的残留复位 | `FPGA_RST_CTRL` 读回 `0x00000000`(全不复位);且本轮**再次确认只读、未写**) | ❌ 排除(但见 §七 保留意见) |
| 7 | `clk_axi` 频率异常 | `FPGA0_CLK_CTRL` = `0x00101400`(DIV0=20/DIV1=1 = 50 MHz);**同一条 AXI-Lite 通路在此时钟下读写正常** | ❌ 排除 |
| 8 | **AFI 读通道配成了 32 位** | `afi0_rdchan_ctrl` = `0x00000000` ⇒ `32BitEn = 0` ⇒ **64 位**(与 64 位主设备匹配) | ❌ 排除 |
| 9 | AFI 发不出事务 | `afi0_rdchan_issuingcap` = `0x00000007`(**最大值**) | ❌ 排除 |
| 10 | PL 侧 FSM / 乒乓 / 位宽 / mux | 静态分析全过;`rd_sel`/`wr_sel` 确实在翻转(实测到 `1/0` 与 `0/1` 两种),`buf_ready=3` | ❌ 排除 |

## 六、SLCR / AFI 寄存器现场(`/tmp/t_slcr.py`、`/tmp/t_afi.py`,**只读**)

> 🔴 **两个脚本都只读,一个字节都没写。** `FPGA_RST_CTRL` 是明令只读的
> (见 memory `never-poke-fpga-rst-ctrl-live`:2026-10-02 写它会锁死 CPU)。
> 两者已在板上清理时删除,内容见本表。

| 地址 | 名称 | 读回值 | 解读 |
|---|---|---|---|
| `0xF8000240` | `FPGA_RST_CTRL` | `0x00000000` | 全部复位**未断言** |
| `0xF8000440` | `TZ_DDR_RAM` | `0x00000000` | DDR 全片非安全 |
| `0xF8000170` | `FPGA0_CLK_CTRL` | `0x00101400` | DIV0=20 / DIV1=1 ⇒ 50 MHz |
| `0xF8F02000` | `L2C_CTRL` | `0x410000C8` | — |
| `0xF8008000` | `AFI0_RDCHAN_CTRL` | `0x00000000` | 64 位读通道 |
| `0xF8008004` | `AFI0_RDCHAN_ISSUINGCAP` | `0x00000007` | 最大 |
| `0xF8008010` | `AFI0_RDDATAFIFO_LEVEL` | `0x0000001A` | **队列里有 26 项** |
| `0xF8008024` | `AFI0_WRCHAN_CTRL` | `0x00000F00` | — |
| `0xF8008028` 起 | — | **Bus error** | 部分 AFI 寄存器不可读 |

🟡 **`afi0_rddatafifo_level = 26` 这条目前解释不了** ——
若读通道被彻底拒死,FIFO 里不该有数据;若有数据,数据又全是零。
**本轮未探明,留作明天的线索之一。**

## 七、🔴 尚未解释的 / 明天的入口

**核心问题:`processing_system7_0/S_AXI_HP0` 为什么拒绝每一个事务。**

已排除的十条(§五)全部指向**配置层面是对的**,剩下的怀疑方向:

| # | 方向 | 为什么值得查 | 明天的第一步(按代价排序) |
|---|---|---|---|
| **A** | **板上运行的 PS7 配置根本不是本设计导出的那份** | 本项目**已有一条同源先例**:`BOOT.BIN` 把 FCLK0 留在 27.78 MHz,BD 里写的 50 MHz 从未生效(`20261003_fclk0_real_measured.md`)。**`Overlay()` 只加载 `.bit`,不跑 `ps7_init`** ⇒ HP 端口/AFI 的初始化由板子启动镜像决定 | 🔴 **断电重启(或 `sudo reboot`)**。重启会重跑 `BOOT.BIN` 里的 `ps7_init`,把 PS7 恢复到"设计者当时想要的"状态。**这是零成本、且唯一能排除"板子停在坏状态"的实验** |
| **B** | 我 10-02 写 `FPGA_RST_CTRL` 把板子写挂死,**之后可能一直没断电** | 那次死锁后 `FPGA_RST_CTRL` 现在读 `0x0` 看着干净,但**"读回干净"不等于"AFI 状态机已复原"** | 同 A:重启即可判定。**注意:重启前无法区分 A 与 B,重启后若好了,也不能区分**(两者都靠重启解决) |
| **C** | `arcache = 4'b0011` / `arprot = 3'b010` 取值不对 | 第 31 次记录里**已标明"取值无出处"**;这两个常量是 PL 侧唯一没被排除的可疑输入 | 加一个 PS 可写的寄存器,**一次综合测多组组合**,避免一轮一轮烧 |
| **D** | 重建 `BOOT.BIN`(原决策 F1 的选项 B) | 若 A 成立,这是根治;B 也一并解决 | 代价高(要跑 Vitis/SDK),**放在 A 之后** |

> ⚠️ **纪律**:§五 第 6 条第 1 列的"排除"是**基于读回值**做的判断;
> 鉴于 memory `never-poke-fpga-rst-ctrl-live` 的教训,
> **"寄存器读回符合预期"不足以证明该寄存器控制的硬件已复原**。此条在 A/B 判定前**保留**。

## 八、本轮**没有**证明的事(不得越界引用)

- ❌ **没证明 HP0 通路在任何时刻曾经工作过。** 这条通路自第 31 次接上 BD 起**从未上板**,
  所以**无法区分"一直是坏的"与"被某次事故弄坏的"**。
- ❌ **没做任何独立观测。** 全部读数来自 PL 内部计数器与 PS 侧寄存器读;
  没有 ILA 抓过 AXI 波形,**没有第三方确认过 `RRESP` 真的是 `11`**。
- ❌ **没读 `ps7_init` / `BOOT.BIN` 的内容。** §七 方向 A 是**有先例的推断**,不是证据。
- ❌ **没查 `dmesg` / 启动日志里关于 AFI 或 PL 的行。**
- ❌ **没测写通路。** 本设计 `M_AXI` 是 `READ_WRITE_MODE = READ_ONLY`,`AWVALID` 恒 0,
  **写通道从未被激励过**。`AFI0_WRCHAN_CTRL = 0xF00` 因此也说明不了什么。
- ❌ **`0x40000000` 越界那一行,不能用来证明"越界会 DECERR"** ——
  因为**界内也一样 DECERR**,该行没有判别力。
- ❌ **屏幕"全黑"是目视结论,不是像素测量。** 没有截屏、没有读回像素。
- ❌ **本轮与 `arcache`/`arprot` 无关的 RTL 一律未改**;位流 md5 变化仅来自 §三 的 0x74 拆位。

## 九、结论

🔴 **`src_sel = 2`(DDR 帧缓存)在当前板子上不可用:HP0 对每个读事务回 `DECERR` + 全零数据,
且与地址无关。**

🟢 **同时确认了三件好事**:
1. **PL 侧取数 FSM、地址生成器、乒乓行缓冲、状态机全部工作** —— 拍数满帧、地址正确、`rd_sel`/`wr_sel` 翻转正常;
2. **`src_sel = 0`(彩条)/ `1`(填充)两条显示支路与整条 PS↔PL AXI-Lite 通路的正常**;
3. **`.bit`/`.hwh` 在板上与工程侧一致**(§二)。

⇒ **问题被收敛到了一个点上:PS7 的 `S_AXI_HP0` 端口本身**,PL 侧的一切都已被证明是对的。
**下一个动作是断电重启,不是改代码。**

---

# 十、2026-10-03 第二轮(同日,接 §七)—— 新证据,以及一条**与 §九 相反**的推论

> 本节**追加**,不改动 §一–§九 的历史判读(纠错纪律:原文留痕)。
> §九 把矛头指向「PS7 的 HP0 端口本身」;**本节 10.3 把这条反过来**:
> 根因**不在 PS7 的配置里**,只可能在 **PL 侧**(或板子本身)。
> §七 的四条方向被砍到两条。

## 10.1 「AFI 读通道被位流关掉了」—— 作废

把官方那份**厂商已验证**的位流烧进同一块板,读同一组寄存器(全程**只读**):

| 地址 | 名称 | 我方 `qrs.bit` | 官方 `pl_rw_ddr.bit` |
|---|---|---|---|
| `0xF8008000` | AFI0_RDCHAN_CTRL | `0x00000000` | `0x00000000` |
| `0xF8008004` | AFI0_RDCHAN_ISSUINGCAP | `0x00000007` | `0x00000007` |
| `0xF8008010` | AFI0_RDDATAFIFO_LEVEL | `0x00000000` | `0x00000000` |
| `0xF8008024` | AFI0_WRCHAN_CTRL | `0x00000000` | `0x00000000` |
| `0xF8000240` | `FPGA_RST_CTRL`(只读) | `0x00000000` | `0x00000000` |

⇒ **四种读数逐条相同。** 「读通道被位流关掉/位流改了 AFI 状态」**不成立**。

## 10.2 🔴 修正 §六:那两行 AFI 读数**不是稳定值**,不是"配置"

同一条 `qrs.bit`、同一块板,两个会话:

| 地址 | §六 存档(同日早些时候) | 本节复测 |
|---|---|---|
| `0xF8008010` | `0x0000001A`(= 26) | `0x00000000` |
| `0xF8008024` | `0x00000F00` | `0x00000000` |

⇒ **这两个寄存器读的是「当时的活动状态」,不是「配置」。**
§六 表里这两行的**「解读」列作废**(`0xF00`→"64 位读通道"、`26`→"队列里有 26 项" 均属过度解读)。
§五 第 8 条(用 `RDCHAN_CTRL = 0` 排除 32 位配置)**结论恰好仍成立**(官方也是 0),
但**理由要换成 10.1 的对照** —— 不是"读到 0 即 64 位"。

## 10.3 🔴🔴 本节最强推论:AFI 不可能成为根因

`ps7_init.c`(厂商例程那份,7450 行)**对 AFI 寄存器一次写都没有**
—— `grep -cE "0XF8008[0-9A-F]{3}"` = **0**,三段 AFI 段(`AFI0/1/2 REGISTERS`)全空。
而**位流无法写 PS 侧寄存器**。

```
⇒ 任何位流烧进来,AFI 都停在同一个上电默认值
⇒ 若厂商那份 HP0 能工作(它是随板已测试例程),则该默认值【是可工作的】
⇒ DECERR 不可能是 AFI 配错
```

**这一条把 §七 的方向表砍掉一半:根因不在 PS7 的 HP0 配置里。**

## 10.4 PS7 参数全量比对:**HP0 一处不差**

上一轮(§五 第 5 条)只比了 6 个键。本轮把两份 hwh 的 PS7 段**全量**比对:
官方 979 个参数 / 我方 979 个参数,**不同 37 个**。

| 类别 | 条数 | 内容 |
|---|---|---|
| DDR PHY 训练 | 25 | `PCW_PACKAGE_DDR_BOARD_DELAY*`、`PCW_PACKAGE_DDR_DQS_TO_CLK_DELAY*`、`PCW_UIPARAM_DDR_{CLOCK,DQS,DQ}_*_PACKAGE_LENGTH`、`DDR_PARTNO`、`DDR_MEMORY_TYPE`、`DDR_T_RC` |
| 时钟缓冲 | 1 | `PCW_FCLK_CLK0_BUF` FALSE / TRUE |
| 控制通路 | 2 | `PCW_USE_M_AXI_GP0` 0/1、`PCW_M_AXI_GP0_FREQMHZ` 10/50 |
| 调试 | 8 | `PCW_FTM_CTI_IN/OUT0..3` |
| 其它 | 1 | `PHASE` `0.000` / `0.0`(同值,格式差) |

**`S_AXI_HP0` 相关键:0 处不同。**

> DDR 那 25 项是**两块不同板子**的 DDR 走线参数 —— 官方例程的板与我们这块不同,
> 我们这组值与"PS 侧 Linux 能正常跑"相符(且 `PCW_DDR_RAM_HIGHADDR` 两边都是 `0x3FFFFFFF`)。
> **没有任何一项能解释「每个读事务都 DECERR」。**

## 10.5 🆕 唯一找到的拓扑差异:官方**过 SmartConnect**,我们**直连**

官方 `system.bd` 的 `interface_nets`:

```
axi4_rw_test_0/M_AXI  →  axi_smc/S00_AXI          ← 过 SmartConnect
axi_smc/M00_AXI       →  processing_system7_0/S_AXI_HP0
```

我方 `qrs.gen/sources_1/bd/system/synth/system.v:355-389`:

```
.S_AXI_HP0_ARADDR (cv_sys_0_M_AXI_ARADDR),   ← 直连,中间没有任何 IP
.S_AXI_HP0_ARID   ({6{1'b0}})
.S_AXI_HP0_AWVALID(1'b0), .S_AXI_HP0_WVALID(1'b0), .S_AXI_HP0_BREADY(1'b0)
```

**官方那只主机**:`DATA_WIDTH 32` / `ID_WIDTH 1` / `BURST_LEN 16` / AXI4,
BD 里 `C_M_AXI_TARGET_SLAVE_BASE_ADDR = 0x10000000`(合法,在 1G 段内)。
⇒ 它**必须**过 SmartConnect:数据宽度 32→64、ID 1→6、AXI4→AXI3 三样都要转。

**我们这只**:自声明 AXI3 / 64 位 / ID 0 / `MAX_BURST_LENGTH 16`
(`cv_sys.v:132`)⇒ IPI 判定可直连,**没插互联**。

> ⚠️ **这是本轮唯一找到的、能区分两个设计的东西,但它【不是已证明的根因】。**
> 直连在 AXI 语义上合法;要证它不行,得把"插了互联的版本"跑起来比。
> 已排成实验(10.7)。

## 10.6 方向 A/B(板子停在坏状态)—— 权重下降,**但未排除**

- `dmesg` 干净:无 AXI / AFI / DDR 相关报错;`/sys/class/fpga_manager/fpga0/state` = `operating`;
  `/proc/cmdline` 正常。**(补上了 §八 里"没查 dmesg"那一项。)**

  ```
  [    3.608758] of-fpga-region fpga-full: FPGA Region probed
  [  166.574269] fpga_manager fpga0: writing qrs.bin to Xilinx Zynq FPGA Manager
  [  178.505522] fpga_manager fpga0: writing qrs.bin to Xilinx Zynq FPGA Manager
  [  275.939685] fpga_manager fpga0: writing pl_rw_ddr.bin to Xilinx Zynq FPGA Manager
  [  490.228925] fpga_manager fpga0: writing qrs.bin to Xilinx Zynq FPGA Manager
  ```

- 该次上电后位流只被加载过 4 次,**全部是我方操作**(前者为本次实验,后两条为 10.1 的对照与还原)。
- **但"断电重启"这条实验仍未做过** —— 判定前它一直在(§七 A/B)。

## 10.7 🆕 已备好的判决实验:厂商位流当"金标准",**判读不靠人眼**

本轮查明(出处 `~/Desktop/zdyz/3_开发板原理图和硬件相关文件/NAVIGATOR_ZYNQ_IO.xdc`,GBK 编码):

```
L14 = key[0]  = PL_KEY0
H15 = led[0]  = PL_LED0
L15 = led[1]  = PL_LED1
```

⇒ 官方 `20_pl_rw_ddr` 位流**在本板上按一下 KEY0 就能跑**。已 staged 在板上:
`/home/xilinx/pl_rw_ddr.bit` + `.hwh`(`Overlay("/home/xilinx/pl_rw_ddr.bit")`)。

**触发链**(唯一入口,PS 侧够不着):

```
key_init(L14) → key_debounce_0/key → util_vector_logic_0 → axi4_rw_test_0/m_axi_init_axi_txn
```

**判读改用 DDR 指纹,不靠 LED** —— 厂商 RTL 写的是**自增数**
(`axi4_rw_test_v1_0_M_AXI.v:457-461`:`axi_wdata <= 1, 2, 3 … 16`),
地址 `M_AXI_AWADDR = 0x10000000 + 偏移`(16 拍 × 4 B = 64 B)。

**已实测基线**(PL 未触发,该处是 Linux 的 DTB):

```
0x10000000 = 0xEDFE0DD0   0x10000004 = 0xD0E95900   0x10000008 = 0x38000000
0x1000000C = 0xC4E55900   0x10000010 = 0x28000000   0x10000014 = 0x11000000
```

**判决表**:

| 按 KEY0 之后 `0x10000000…3C` | 含义 |
|---|---|
| 变成 `0x1, 0x2, 0x3 … 0x10` | ✅ **HP0 写+读都通** ⇒ DECERR 出在**我方 PL 侧**(10.5 或主机协议) |
| 仍是 DTB 那几个字 | 🔴 **厂商设计也读不出来** ⇒ 问题在**板子 / PS 状态**,与我方 RTL 无关 |

> ⚠️ **副作用**:这一步会覆盖 `0x10000000` 处 64 B 的 DTB。
> 内核启动时已解析完 DTB,**预期无影响 —— 但这是推断,不是实测。**

## 10.8 本轮仍**没有**证明的事(不得越界引用)

- ❌ **10.7 的判决实验【尚未执行】。** 它需要**按一次物理按键** ——
  触发链没有第二条入口,`L14` 在 PL 侧,PS 够不着。
- ❌ **没有独立观测者,§八 那条限制仍然有效。** 工程里那个 `ila_0` 只探 SPI 引脚
  (`qrs.v:64-71`:探 `rst_n / dac_sclk / dac_cs / dac_mosi / adc_sclk / adc_sync / adc_mosi`),
  **且在已实现的 BD(`system_wrapper`)里没有例化** ⇒ **抓不到 AXI**。
- ❌ **没有证明直连是错的**(10.5)。只能说它是**唯一找到的差异**。
- ❌ **没有断电重启过。**
- ❌ **10.3 的推论依赖一个前提**:「厂商那份位流的 HP0 是能工作的」。
  这个前提**本身就在 10.7 待验** —— 若 10.7 判为"仍读不出",则 10.3 的推论要一并推翻。
