dsgmxc/2026_fpga_qrs/board/measurements/20261003_fclk0_real_measured.md

# 2026-10-03 · FCLK0 **首次用时基独立实测** · 推翻「41.6667 MHz」 · 板上实测存档

> 🟢 本轮解决 **F1 决策**(时钟方案),并且是**第一条独立时基测量** ——
> 2026-10-01 那次只有"寄存器算术 + PYNQ 请求值",得出 **IO PLL = 1500 MHz**,**是错的**。
>
> 🔴 **结论:本板 IO PLL = 1000 MHz(非 1500)。**
> `Clocks.fclk0_mhz = 50` 写的是 DIV0=30 ⇒ **真值只有 33.33 MHz**,
> **仍低于**面板窗口下限 40.8 MHz。真 50 MHz 必须 **DIV0 = 20**。
>
> 对应必做点 **M04**(实测 vs 参考比对)/ **M13**(板上跑通);
> 归入 **B9 决策记录**(F1 结案)/ **B4 资源取舍**素材。

---

## 一、被测对象 / 测点 / 仪器

| 项 | 值 |
|---|---|
| 被测对象 | PL 时钟 `FCLK0`(= **像素时钟 PCLK**,`cv_sys.v` `assign lcd_clk = s_axi_aclk`) |
| **测点** | **无物理测点**。测的是 `vblank_cnt` 的**变化速率**,反推帧率 |
| 仪器 | **无**。CPU 的 `time.monotonic()` 当秒表 |
| 屏幕 | ATK-MD0700R-1024600-IPS,1024×600,RGB888,DE 模式 |
| 面板允许 PCLK 窗口 | **40.8 ~ 67.2 MHz**(屏手册) |

### 1.1 测量原理(为什么这算"独立时基")

```
真实 PCLK = 帧率 × (H_TOTAL × V_TOTAL) = 帧率 × 1344 × 635 = 帧率 × 853440
```

`H_TOTAL / V_TOTAL` 是 `lcd_timing.v` 的**常量**(行 1344 拍、场 635 行),**不随频率变**。
于是"数帧"与"数秒"就给出一个**两个不同 PLL 的比值**:

| 时间源 | 来自 |
|---|---|
| 帧 | **IO PLL** → FCLK0 → `lcd_timing` |
| 秒 | **ARM PLL** → CPU 时钟 → `time.monotonic()` |

⚠️ **诚实边界**:两者都由同一颗 `PS_CLK` 分频而来 ⇒ 这是**跨 PLL 交叉验证**,
**不是**溯源到外部频率标准的绝对测量。它足以判定"分频比是多少",
**不足以**给出"绝对精度 ±0.01%"这类结论。见 §六。

## 二、所烧位流版本

| 项 | 值 |
|---|---|
| 板上 `/home/xilinx/qrs.bit` md5 | `ad93f160ae0fd4c97da325faabe4b85a` |
| 工程侧 `qrs.runs/impl_1/system_wrapper.bit` md5 | **同上** ✅ |
| 结论 | 本轮测的是**当时的第 32 次位流**,不是旧程序 |

> 本轮 FCLK0 结论**只依赖 `lcd_timing.v` 的常量**(它在第 30 次位流起就没再改过),
> 与 `lcd_fb_reader` 的改动无关 ⇒ **不会被第 33 次位流推翻**。

## 三、原始实测数据

同一套脚本 `tools/t_fclkchk.py`,每点采集 6 秒(约 195 帧)。

| # | `FPGA0_CLK_CTRL` | DIV0 | DIV1 | 帧率 (Hz) | **实测 PCLK (MHz)** | 按 1000 MHz 反算 | 按 1500 MHz 反算 |
|---|---|---|---|---|---|---|---|
| 1 | `0x00600600` | 6 | 6 | 32.4954 | **27.7331** | 27.7778(+0.16%) | 41.6667(**+50%**) |
| 2 | — | 30 | 1 | 38.997 | **33.2816** | 33.3333(+0.16%) | 50.0000(**+50%**) |
| 3 | — | 20 | 1 | 58.6560 | **50.0589** | 50.0000(−0.12%) | 75.0000(**+50%**) |

第 2 点取自同日更早的一轮(`t_50mhz.py`),第 1/3 点取自本轮(`t_fclkchk.py`)。

**每点的隐含 IO PLL**:`实测PCLK × DIV0 × DIV1`

| # | 隐含 IO PLL |
|---|---|
| 1 | 27.7331 × 36 = **998.4 MHz** |
| 2 | 33.2816 × 30 = **998.5 MHz** |
| 3 | 50.0589 × 20 = **1001.2 MHz** |

⇒ 三点一致落在 **1000 MHz ± 0.2%**。**1500 MHz 被排除**,差距 50%。

## 四、🔴 「41.6667 MHz」是怎么来的 —— 它从来不是测量值

```
Clocks.fclk0_mhz 读回 = IO_PLL(PYNQ 假定值) / DIV0 / DIV1
                      = 1500 / 6 / 6 = 41.6667
```

PYNQ 内部按 `PS_CLK = 50 MHz` 建模(实为 33.333),算出 IO PLL = 1500。
**41.6667 是 `1500/36` 这个除法结果,不是任何仪表或计数器的读数。**

### 4.1 一句话证伪

| 若 FCLK0 **真是** 41.6667 MHz | 帧率应为 `41.6667e6 / 853440` = **48.82 Hz** |
|---|---|
| **实测帧率** | **32.50 Hz** |

差 **50%**。这个判据**不依赖任何 PS_CLK 假定** —— 帧几何是常量,数出来的帧就是数出来的帧。

### 4.2 现场对照(同一次运行、同一个寄存器)

```
   寄存器 0x00600600  DIV0=6 DIV1=6
   按 IO PLL 反算 =  27.7778 MHz
   帧率法实测     =  27.7329 MHz
   PyNQ 说的      =  41.6667 MHz   ← 错的那个
```

⇒ 2026-10-01 那次"**三条独立证据指向 1500**"的三条,**其实是同一条**:
它们分别是 PYNQ 的假定、PYNQ 的除法、PYNQ 写下的分频值 —— **全部源自 PYNQ 内部那一个假定**。

## 五、修复与验证(已上板,不需重新综合)

### 5.1 改动

| 文件 | 变更 |
|---|---|
| `src/python/drivers/board.py` | `apply_fclk0()` 在 `Clocks.fclk0_mhz = X` 之后**覆盖 DIV0 = round(1000/X)**;新增 `fclk0_real_mhz()` / `fclk0_divs()` 按 IO PLL 反算真值;`board_info()` 改报真值 |
| `src/python/cv_regs.py` | 新增 `IO_PLL_MHZ=1000.0` / `FCLK0_BOOT_MHZ=27.78` / `FCLK0_PYNQ_50_MHZ=33.33` / `FCLK0_DIV0_FOR_50=20`;删去 `FCLK0_MEASURED_MHZ=41.666667` |

```python
div0 = max(1, int(round(cv_regs.IO_PLL_MHZ / mhz)))     # ← 本函数存在的唯一理由
v = _slcr(FPGA0_CLK_CTRL)
_slcr(FPGA0_CLK_CTRL, (v & ~(0x3F << 8)) | (div0 << 8))
```

### 5.2 验证结果

| # | 项 | 预期 | **实测** | 判定 |
|---|---|---|---|---|
| 1 | `Overlay()` 之后 DIV0/DIV1 | 回到 BOOT.BIN 的值 | `0x00600600`(6/6) | ✅ 复现了"Overlay 会冲掉时钟设置" |
| 2 | 此时真值 | — | 反算 27.7778 / **实测 27.7329** | ✅ 两者吻合 0.16% |
| 3 | `apply_fclk0()` 后寄存器 | DIV0=20 / DIV1=1 | `0x00101400` | ✅ |
| 4 | 函数返回值 | 50.0 | **50.0000 MHz** | ✅ |
| 5 | **帧率法独立实测** | 50.0 | **50.0594 MHz** | ✅ 偏差 −0.12% |
| 6 | 落在面板窗口 40.8~67.2 | 是 | 是 | ✅ |

> 🔑 **第 1 条是白捡的**:它同时复现了 2026-10-01 §九 遗留决策 **F2**
> (「设定时机应在 `Overlay()` 之前?」)—— **答案是更早也没用**:
> `Overlay()` 会把 `FPGA0_CLK_CTRL` **整个复位**回 BOOT.BIN 的值,
> 所以设定**必须在 `Overlay()` 之后**。`main.py` 的现有顺序是对的。
>
> 🟡 代价:这样一来 PL 的头几百拍跑在 27.78 MHz(出窗口)才切到 50 MHz。
> 屏上表现为**上电闪一下** —— 与 2026-10-01 观察到的"闪一下后照旧"同一现象。
> 若要彻底消除,只有重建 `BOOT.BIN`(原 F1 选项 B)。

### 5.3 M3 需要的时钟结论

| 口径 | 值 |
|---|---|
| `clk_axi` 设计值(BD) | **50.000 MHz** |
| `clk_axi` **真值**(改频后,按 IO PLL 反算) | **50.000 MHz**(DIV0=20/DIV1=1) |
| `clk_axi` 开机默认值(BOOT.BIN) | 27.78 MHz —— **低于面板窗口下限,不受支持** |
| 面板窗口 | 40.8 ~ 67.2 MHz |

⛔ **口径纪律(修订)**:自本日起,凡引用 `clk_axi` 频率:
- ✅ 写「设计值 50 MHz / 真值 50.000 MHz(IO PLL 1000 / DIV0 20)」
- ⛔ **不得再写「41.6667 MHz「实测」」** —— 那是 PYNQ 的计算值
- ⛔ 不得直接引用 `Clocks.fclk0_mhz` 当真值(它假定 IO PLL = 1500)

## 六、本轮**没有**证明的事(不得越界引用)

- ❌ **不是溯源测量。** 没有频率计、示波器、GPS 参考。两个时间源(IO PLL / ARM PLL)
  同源于 `PS_CLK` ⇒ 它证明的是**分频比**,不是**绝对频率**。
  若板上晶振本身偏 0.1%,本方法**看不出来**。
- ❌ **`PS_CLK = 33.3333 MHz` 未直接测量** —— 它取自板级设计惯例。
  但注意:**§四的证伪不依赖这个数**。
- ❌ **分辨率 ≈ ±0.15%**(6 秒窗内数整数帧 + 轮询抖动)。**不足以**支撑
  "IO PLL 恰好 = 1000.000 MHz" 这种精度断言;只能说 **999~1002 MHz**。
  对本次目的(选 DIV0 落在 40.8~67.2 窗口内)余量充足。
- ❌ **未验证 50 MHz 下 AXI 事务是否仍然可靠** —— 改频后没重跑 `SCRATCH` 回环。
- ❌ **未验证长时间(>6 s)在 50 MHz 下的画面稳定性**,`underrun` 未做长跑监视。
- ❌ **未测断电重启**:`apply_fclk0()` 是运行时动作,断电必回 27.78 MHz(已由 §5.2 第 1 条间接证明)。

## 七、结论

🟢 **F1 结案**:选 **A**(运行时改频),并**补上 DIV0 修正**。

| 项 | 结论 |
|---|---|
| 本板 IO PLL | **1000 MHz**(三点反推一致,±0.2%) |
| 「41.6667 MHz 实测」 | **伪** —— PYNQ 按错误 IO PLL 假定算出的值 |
| `Clocks.fclk0_mhz = 50` 的真值 | 33.33 MHz —— **仍低于面板窗口下限** |
| 真 50 MHz 的做法 | **DIV0 = round(1000 / 50) = 20** |
| 已实现 | `drivers/board.apply_fclk0()`,已上板验证(反算/实测吻合 0.12%) |

🔴 **连带影响(尚未处理,交接事项)**:

| 文档/代码 | 问题 |
|---|---|
| `CLAUDE.md` §八 | 写「实测 41.6667 MHz」;应改为「真值 50.000 MHz(设计 50)」 |
| `report/measurements/20261001_lcd_ps_ctrl_and_fclk0.md` | §5.2/5.3 推出 IO PLL = 1500,**已加更正批注** |
| `docs/display_subsystem.md` 多处 | 带宽表 / 取行余量表 / CDC 说明全按 41.6667 算 ⇒ **数字要重算** |
| `docs/project_state.md` §70 附近 | 记「2026-10-01 已跑(实测 41.6667)」 |
| `source_design_checklist.md` §2.3 | 写 `clk_lcd = 50 MHz ← 从 clk_axi 分频` —— `clk_axi` 本身就是 50,分不出更大的 |
| `docs/dac1220_interface.md` | 全表给了「@50 / @100 MHz」两列,100 MHz 列已失去前提 |
| `cv_sys.v` / `lcd_fb_reader.v` / `gt911_ctrl.v` 注释 | 多处「设计 50 / 实测 41.6667」 |
