dsgmxc/2026_fpga_qrs/board/measurements/20261003_hp0_decerr_rootcause_arprot.md

# 2026-10-03 · `S_AXI_HP0` 全量 DECERR —— **根因坐实:`ARPROT[1]`(NS)不得置 1**

> 本文是一份**正向结论**记录,同时是一份**自我纠错**记录。
> 同日上一轮(`20261003_hp0_ab_arprot_falsified.md`)写下「该假设已被推翻」——**那次撤回是错的**,本文给出推翻那次撤回的实测。

**承**:`20261003_ddr_hp0_decerr.md`(第 33/34 次)→ `20261003_hp0_ab_arprot_falsified.md`(第 35 次)。
**本轮产物**:① 根因(单变量分离,2×2 四格全测);② 显示通路端到端打通(M13 证据);
③ 一条**我上一轮写错、本轮纠正**的结论。

---

## 一、结论

```
assign m_axi_arcache = 4'b0010;   // Normal Non-cacheable Non-bufferable —— 无关
assign m_axi_arprot  = 3'h0;      // 特权 / 安全 / 数据访问        —— ★ 决定性
```

**`ARPROT[1]`(NS,非安全访问)置 1 ⇒ `S_AXI_HP0` 对每个读事务回 `DECERR(2'b11)`,
且返回数据恒为 0 ⇒ DDR 帧缓存整屏全黑。置 0 则一切正常。**

`ARCACHE` 与本故障**无关**(见 §二 的 2×2)。

---

## 二、单变量分离:2×2 四格全测

每一次都是**单独一次综合**(`reset_run synth_1` + `launch_runs impl_1 -to_step write_bitstream`),
且**先用 `write_verilog` 从综合后网表逐位核过取值**,再上板。

| # | 位流 md5 | `ARCACHE`(网表) | `ARPROT`(网表) | `beats` | `rresp_lat` | `axi_or_nz` | `px_or_nz` |
|---|---|---|---|---|---|---|---|
| 1 | `a9636e0d…` | `0010` | **`000`** | 99.9% | 2 | **1 ✅** | **1 ✅** |
| 2 | `62c0db66…`(EXP-A) | **`0011`** | **`000`** | 99.8% | 2 | **1 ✅** | **1 ✅** |
| 3 | `0b9d1b82…`(EXP-B) | `0010` | **`010`** | 99.8% | **3** | **0 ❌** | **0 ❌** |
| 4 | `298c8f1f…` | **`0011`** | **`010`** | 100.0% | **3** | **0 ❌** | **0 ❌** |

- **行 1 vs 行 3**:`ARCACHE` 相同、`ARPROT` 不同 ⇒ 结果相反。
- **行 1 vs 行 2**:`ARPROT` 相同、`ARCACHE` 不同 ⇒ 结果相同。
- ⇒ **只由 `ARPROT` 决定。**

| 取值 | 结果 |
|---|---|
| `ARPROT = 3'h0` | 2/2 有数据 |
| `ARPROT = 3'b010` | 2/2 全零 |

### 2.1 判据字段的选择(有一条不成立,记下来)

| 判据 | 是否可用 | 说明 |
|---|---|---|
| `axi_or_nz` / `px_or_nz` | ✅ **8/8 一致** | 本轮所有读数中,`axi_or_nz` 与 `ARPROT[1]` 完全对应,无一例外 |
| `rresp_lat` | ⚠️ **本实验里不能单独用** | `ARPROT=000` 的几次里它读到过 `2(SLVERR)`,静置后复读才变 `0(OKAY)`。**刚加载位流后的首帧读数与稳态不同** |
| `beats` | ❌ 无区分力 | 四格全部 ≈100% —— 事务**发得出去、握得上手**,只是被拒答。这印证了「**握手 ≠ 数据**」 |

> ⚠️ `ARPROT=000` 时刚加载后出现的 `SLVERR` 是**另一个未解释的现象**,本轮未追。
> 考虑到它只出现在 PL 刚重配置之后,嫌疑是首笔事务撞上复位/在途状态。**留作待查项。**

---

## 三、它是**内容决定的**,不是「板子停在一个坏状态」

上一轮把故障判成「PS 侧粘滞二态、重启不恢复」。本轮用**交替加载**否掉:

| 步 | 位流 | `ARPROT` | `axi_or_nz` |
|---|---|---|---|
| A | `a9636e0d` | `000` | **1** |
| B | `298c8f1f` | `010` | **0** |
| C | `a9636e0d` | `000` | **1** |

**同一个 boot、几分钟内、交替加载 —— 每次结果都跟着位流内容走。**

而且步 A 之前,板子**正躺在 `298c8f1f` 的 DECERR 态里**:换成 `000` 立刻出数据
⇒ **不需要重启、不需要清状态,换位流就恢复。**

### 3.1 顺带否掉的另一条:「厂商主机跑一次能清故障」

按一次 `PL_KEY0`(厂商例程),用**独立观测者**确认 HP0 写真的成功了 ——
厂商 RTL 写的是自增数,PS 侧从 `0x10000000` 读回:

```
00000001 00000002 00000003 00000004 00000005 00000006 00000007 00000008
00000009 0000000A 0000000B 0000000C 0000000D 0000000E 0000000F 00000010
```

(按键前该处是 Linux 的 DTB:`EDFE0DD0 D0E95900 …` ⇒ 确系**本次**写入)

**紧接着**加载我方位流 ⇒ **仍然 DECERR**。
⇒ 「厂商主机成功事务」**也不能**影响结果。**只有 `ARPROT` 能。**

---

## 四、显示通路端到端打通(M13 证据)

`ARPROT` 修正后,PS 画图 → DDR → PL 取行 → LCD 全链第一次**稳定**跑通。

| 项 | 值 |
|---|---|
| 位流 | `0e4cb57c…`(`ARPROT=000` / `ARCACHE=0010`) |
| 图案 | 整屏绿 `0x07E0` + 中间红横带 `0xF800`(行 290–309) + 左上白块 `0xFFFF`(行 40–119,列 40–199) |
| 观测者 A(硬件寄存器) | `axi_or_nz=1`、`px_or_nz=1`、`rresp=OKAY`、`verdict=idle_ok` |
| 观测者 B(人眼) | 用户确认:**整屏绿 + 中间一条红横带 + 左上角白块,三元素全对** |

**两个独立观测者一致** ⇒ 该条可作为 M13「板上跑通并提供实测输出」的证据。
另:用户确认横带是**红**色,与代码 `0xF800` 一致 ⇒ **无 R/B 交换**。

---

## 五、🔴 自我纠错轨迹(本轮最重要的部分)

### 5.1 我上一轮写错了什么

`20261003_hp0_ab_arprot_falsified.md` 的结论是:

> 「**该假设(ARPROT/ARCACHE 是根因)已被实测推翻**」
> 「DECERR 是 PS 侧的粘滞二态」
> 「断电重启(POR)不能恢复」

**三条都是错的。** 实际:`ARPROT` 就是根因;重启不能恢复**是因为根因在位流里**,
跟板子状态无关 —— 我把「重启后仍然 DECERR」读成了「故障与位流无关」,
**而它恰恰是「故障与位流有关」的正面证据。**

### 5.2 错在哪一步

推翻依据是 A/B 表里的一行:

| # | 位流 md5 | `ARPROT` | `ARCACHE` | 结果 |
|---|---|---|---|---|
| 2 | `cdfbe0f5…` | `010` | `0011` | **OKAY** |

这一行如果成立,假设确实被推翻(同取值、反结果)。**但这一行是错的**,因为:

> **它的 `ARPROT`/`ARCACHE` 取值是从源码读的,从来没核过网表。**
> 核过网表的只有 `a9636e0d` 和 `298c8f1f`。`cdfbe0f5` 已在后续构建中被覆盖,**现已无法复查**。

而本轮**每一格都先核网表再上板**,四格自洽、无矛盾。

### 5.3 为什么会犯这个错

上一轮我刚写下教训「**位流 md5 不是"改动是否生效"的合格判据**」——
同一次会话里,我却拿**源码**当成了「位流里是什么」的合格判据。
**同一个坑的两个方向:一次是"以为改了没进去",一次是"以为没改其实进去了"。**

> **规矩(已写入 `cv_sys.v` 注释与本记录)**:凡把某个 RTL 常量当**实验自变量**,
> 必须先用 `write_verilog` 从综合后网表逐位核对,再上板。
> **源码 ≠ 网表;md5 ≠ 内容。**

---

## 六、遗留 / 待查

| 项 | 状态 |
|---|---|
| `ARPROT[1]=1` 为什么导致 DECERR 的**机理** | **未定**。本机无 UG585/TRM,取值按「与已验证参照物对齐」得到,不是「已知原理」 |
| `ARPROT=000` 时刚加载后的 `SLVERR` | **未解释**,见 §2.1 |
| 该取值对上位机/其它 master 是否同样适用 | 未测 |
| `20261003_hp0_ab_arprot_falsified.md` | **结论已作废**,已加更正抬头指向本文;原文保留供 M11 追溯 |

### 下一步(建议)

1. 🔴 交付仓库同步(**由用户执行**):`qrs.bit` → `0e4cb57c…`,`cv_sys.v` 的两行常量 +
   注释;工作区 `board/qrs.bit` 已更新。
2. 🟡 查 UG585 / `AFI` 章节,给 `ARPROT[1]` 的行为补权威出处 —— **B06 要的就是这个**。
3. 🟡 把「显示通路已打通」写进 `docs/display_subsystem.md` 与 `docs/project_state.md`。
4. 🟢 复现一次 `SLVERR` 首帧现象,确认是否与复位后首笔事务有关。

---

## 七、沉淀(供 `skill/` 与报告 §优化过程 引用)

| 教训 | 说明 |
|---|---|
| 🔴 **源码 ≠ 网表** | 把 RTL 常量当实验自变量时,**必须核综合后网表**。本轮四格全核才自洽 |
| 🔴 **"重启后仍然故障"不等于"故障与内容无关"** | 若根因在**位流**里,重启当然不能恢复。**我把它读反了** |
| 🟢 **单变量分离要 2×2,不要只做单边** | 只做「改了 A 就好」分不清 A 和 B。四格全测才能说「只由 A 决定」 |
| 🟢 **交替 A/B/... 是区分"内容"与"状态"的正解** | 同一 boot 内交替加载,结果跟内容走 ⇒ 排除板子状态;反之则确认状态假设 |
| 🟢 **让用户当观测者时,要给"可判读的图案",不要给"亮/不亮"** | 三元素图案(底色+横带+角块)能一次区分「全对 / 缺一块 / 全黑」,比"亮了没有"信息量大得多 |
| 🟢 **一个自变量的取值要有出处,且要写明出处的强度** | 本轮取值来自厂商已验证例程与 Xilinx 模板 —— 属「与参照物对齐」,**不是**「已知原理」。报告里必须如实标注这个差别 |
