dsgmxc/2026_fpga_qrs/board/measurements/_TEMPLATE_display_touch_bringup.md

# <YYYY-MM-DD> · 显示 + 触摸首次上板 · 板上实测存档

> 📌 **这是模板,不是记录。里面的空格全部待填,一个数字都不要预设。**
> 照 `README.md` 的约定改名成 `YYYYMMDD_<slug>.md` 后再填。
>
> **本次要一次性验掉的四件事**(对应 `docs/display_subsystem.md` §0.1 的「上板」列):
> ① **风险 D1** —— PS 写 DDR、PL 读,画面是否正确(首次实测)
> ② **风险 R1** —— `/dev/mem` 能否映射普通 RAM
> ③ **风险 R2** —— 非缓存映射下整屏同步耗时
> ④ **触屏** —— PL 侧 `i2c_master`/`gt911_ctrl` 与真实 GT911 是否通信成功
>
> 对应必做点 **M13**(板上跑通 + 实测输出)/ **M04**(实测与参考比对)。
> D1/R1/R2 是 **B9 决策记录**素材。

---

## 〇、填表纪律(先读)

- ⛔ **没测的格子写「未测」,不要留空,也不要推测。** 留空会让后面的人分不清"没测"和"忘了填"。
- ⛔ **每一项都要能指到一行日志 / 一张照片 / 一条命令输出。** 指不到的,标「凭印象」。
- ✅ 反例判据:如果某个数字在报告里会被引用,它就必须在本文件里有一手出处。

---

## 一、被测对象 / 测点

| 项 | 值 |
|---|---|
| 被测对象 | PS 侧 `src/python/main.py` + `src/c_ui/c_ui`;PL 侧 `lcd_fb_reader` / `lcd_vblank_ctrl` / `i2c_master` / `gt911_ctrl` |
| 测点 | 屏上像素(肉眼)+ AXI 寄存器读回 + 触摸坐标 |
| 基址 | `0x43C0_0000`,窗口 4 KB |
| 仪器 | <填:示波器 / 万用表 / ILA / 无> |
| 屏幕 | ATK-MD0700R-1024600-IPS,1024×600,RGB888,DE 模式 |

⚠️ **如果有"频率 / 时序"结论而本轮没有独立时基(示波器/ILA)**,在这里写明 —— 见 §八。

---

## 二、所烧位流版本(**排除"烧的是旧程序"**)

| 项 | 值 |
|---|---|
| 板上文件 | <填:路径> |
| 板上 md5 | <填:在**板子上**跑 `md5sum` 的结果> |
| 参考值(工作区 `board/qrs.bit`,md5 已核实) | `ad93f160ae0fd4c97da325faabe4b85a` |
| 参考值(工作区 `board/qrs.hwh`,145 267 B) | `4fa2032b4e2f65712e951300bbe33c3b` |

> 🔴 **两件事必须做**:
> ① `.bit` 与 `.hwh` **成对**用同一版 —— PYNQ `Overlay` 需要与位流匹配的 hwh;
> ② **md5 要在板子上算**,不是比对本地文件。本轮以前吃过"烧的是旧程序"的亏(`LLM-012`)。

---

## 三、板型与环境

| 项 | 值 |
|---|---|
| 板卡 | 正点原子领航者 ZYNQ-7020(XC7Z020) |
| 镜像 / PYNQ 版本 | <填> |
| 内核版本 | <填:`uname -r`> |
| Python 版本 | <填:`python3 -V`> |
| gcc / make 版本 | <填:`gcc --version` / `make -v`> |
| `Clocks.fclk0_mhz` 读回 | <填**实测值**> |

> 📌 **`Clocks.fclk0_mhz` 这一格是本轮的关键**:`main.py` 已固化 50,
> 但**"写了"不等于"生效了"** —— 要读回。
> ⛔ **但不得把 `Clocks.fclk0_mhz` 的读回值当实测值** —— 它假定 IO PLL = 1500,
> 2026-10-01 由此读出的 **41.6667 已被推翻**(真值 27.78,IO PLL 实为 1000)。
> 口径纪律:本格填**独立时基测出的真值**(如帧率法),并写明方法与误差。
> 📄 `report/measurements/20261003_fclk0_real_measured.md`

---

## 四、前置检查(任一不过就停下,别往下走)

| 检查 | 命令 | 结果 |
|---|---|---|
| 板上能编 C | `which gcc make` | <填> |
| `/dev/mem` 能映射 RAM | `grep STRICT_DEVMEM /boot/config-$(uname -r)` | <填> |
| 内核 cmdline | `cat /proc/cmdline` | <填> |
| 触摸有外部上拉 | 万用表量 SCL/SDA 静态电平 | <填:____ V> |
| root | `id -u` | <填> |

### 板上目录约定(和 `cv_regs.py` 里的默认值对齐)

| 板上路径 | 来源 | 为什么是这个路径 |
|---|---|---|
| `/home/xilinx/qrs.bit` + `/home/xilinx/qrs.hwh` | 工作区 `board/` | `cv_regs.OVERLAY_BIT` 的默认值;**PYNQ 要求 `.bit`/`.hwh` 同名同目录** |
| `/home/xilinx/cv/` | 工作区 `src/python/` 整个目录 | python 树根 —— 下面命令都在这个目录里跑 |
| `/home/xilinx/c_ui` | 板上 `make` 的产物 | `cv_regs.C_UI_BINARY` 的默认值 |

> ⚠️ **`.bit` 与 `.hwh` 必须成对拷**。只换 `.bit` 会让 PYNQ 用旧 hwh 解析,
> `ip_dict` 里少 IP,报的却是"位流里没有这个 IP"这种误导性错误。
>
> 🔴 **顶层实例名是 `cv_sys_0`,不是 `cv_axi_lite_slave_0`。**
> `cv_axi_lite_slave` 自 2026-10-01 起被包进 `cv_sys` 内部(见 `cv_sys.v` 头注释),
> BD 里只挂 `cv_sys` 一个 module_ref。名字在 `cv_regs` 里定义两处:
> `TOP_MODULE`(实例名 `cv_sys_0`)/ `TOP_MODULE_VLNV`(VLNV `…:module_ref:cv_sys:1.0`)——
> **两者不相等,不能互相推导**。
> 📌 2026-10-02 首次上板就栽在这里:`board.py` 报"位流里没有 `cv_axi_lite_slave_0`",
> 而 `.bit`/`.hwh` 本身是好的。
>
> 📌 三处路径**都可以改**,只要 `--bit` / `--ui-bin` 传对 —— 但改了就**不要**把
> "默认值"当事实写进报告。

---

## 五、分步实测(每步独立可判)

> 每一步都记录 **命令** + **原始输出** + **判据是否通过**。

> 下面命令一律假设**在板上的 python 树根目录**里执行(`cd /home/xilinx/cv`),
> 且一律 `sudo -E`(bare `sudo` 会清环境变量 ⇒ XRT 报 `No Devices Found`)。

| # | 验什么 | 命令 | 判据 | 实测 | 通过? |
|---|---|---|---|---|---|
| 1 | PS↔PL 链路 | `sudo -E python3 tools/display_probe.py`(第 1 步即自检,不通直接退 1) | `link_check()` PASS → `VERSION = 0x00010000` | <填> | <填> |
| 2 | FCLK0 生效 | 同上第 2 步 / 见 §三 | 读回 = <填目标值> | <填> | <填> |
| 3 | **显示通路 + 风险 D1** | `sudo -E python3 tools/display_probe.py` | 屏上**肉眼可见**「彩条 → 纯色 → 渐变图」切换;且 `/dev/mem` 旁路读回一致 | <填> | <填> |
| 4 | 帧缓存不欠载 | 同上第 7 步(5 s)/ 或跑 ≥60 s 后读 `0x64[19]` | **`underrun` 必须 = 0**、`axi_err = 0` | <填> | <填> |
| 5 | **触屏坐标** | `sudo -E python3 tools/touch_probe.py`(逐点提示) | 五点偏差均 ≤ 90 px;抬起后 `count` 归 0 | <填> | <填> |
| 6 | **LVGL 首页** | `sudo -E python3 main.py` | 屏上出现首页 + **中文字形不是方框** | <填> | <填> |
| 7 | LVGL 触摸联动 | 点首页按钮 | 页面**切走** | <填> | <填> |

📌 **第 1–5 条都是独立脚本,可以单独跑**;第 6/7 条由 `main.py` 拉起 `c_ui` 完成。
`main.py` 自己也会按 1→2→3→4→6 的顺序走一遍,所以第 1–4 条也可以通过 `main.py` 的输出代填
(但仍建议**先用 probe 单独跑**,失败时定位才准)。

📌 **第 6/7 条才是"界面初始化"的真正判据。** 第 3/5 条是硬件通路判据。

⚠️ **第 5 条的已知差异**:PL 只导出 **2 个触点、不含 `track_id`** ⇒ 三指以上、
或"哪根手指是哪根"的语义与前序 STM32 版**不同**。填表时不要按等价实现描述。

⚠️ **第 6 条的预期现象**:点测量按钮状态栏会显示「**UART7发送失败**」——
这是**如实报告"指令没发出去"**(`display_protocol` 是空实现),**不是触屏坏了**。

---

## 六、原样粘贴的原始输出 / 照片清单

```
<把关键命令的原始输出粘进来。不要改写、不要摘要。>
```

| 证据 | 文件 |
|---|---|
| 屏上首页照片 | <填:路径或「未拍」> |
| 渐变测试图照片 | <填> |
| `underrun` 计数截图 | <填> |
| 触摸坐标日志 | <填> |

---

## 七、风险结论(逐条给"过 / 不过 / 未测")

| # | 风险 | 本轮结论 | 依据 |
|---|---|---|---|
| **D1** | PS 写 DDR → PL 读的 cache 一致性 | <过 / 不过 / 未测> | <哪张图 / 哪条日志> |
| **R1** | `CONFIG_STRICT_DEVMEM` 挡住 `/dev/mem` | <过 / 不过 / 未测> | <§四 的读数> |
| **R2** | 非缓存映射下整屏 1.2 MB 同步耗时 | <填实测 ms / 未测> | <测量方法> |
| — | I2C 外部上拉是否真的存在 | <确认 / 否定 / 未测> | <§四 的电压读数> |
| — | 真实 GT911 是否接受 `0x814F` 起始偏移 | <是 / 否 / 未测> | <§五 第 5 条> |
| — | 16 次串行突发的真实带宽 | <填 / 未测> | <读 `0x64` 或 ILA> |

> ⚠️ **D1 的预期是"过"**:设计上,`/dev/mem` 的 mmap 在 ARM 上走 `ioremap`,
> 属性是 **Device(非缓存)** ⇒ PL 直接看到 PS 的写。**但这是设计依据,不是实测** ——
> 本表这一格就是要把它变成实测。**若不过**,处置见 `src/c_ui/README.md §7`。

---

## 八、本轮**没有**测到的东西(如实列,不要当成已通过)

- <填>

> 📌 上一轮的教训:**"编得过"不等于"跑得起来"**;"通路通"不等于"频率对"。
> 本节的长度本身就是一项质量指标 —— 写得越短,越可能是没仔细想。

---

## 九、结论一句话

<填>
