dsgmxc/2026_fpga_qrs/skill/measurement-instrument-can-be-wrong/skill.md

# measurement-instrument-can-be-wrong

> **量具会错。** 本技能包收录本项目**八次**「错的是量具/判据,不是被测对象」的真实事故,
> 以及从这八次里提炼出的四条通用判据。
> 这是本仓库素材最厚的技能 —— 因为它踩得最多。

## 适用范围

- 任何**带测量环节**的工程活动:RTL 仿真、上板读数、脚本判据、人眼观察、LLM 的推理。
- 尤其在**LLM 协作**场景下命中率极高:模型报错时的**第一反应几乎总是怀疑被测对象**。
- 不限于硬件 —— 任何"我做了个测量,结果和预期不一样"的场合。

---

## 使用方法

### 判据 0:报错时,**先审量具,再审被测对象**

> **当失败点与最近改动无关,或同一路径另一次却通过了时,先审量具。**

这是本技能包唯一的总入口。八次事故里有六次符合这个触发条件。

### 判据 1:量具的**分辨力**必须先算出来,再谈结论

**事故**:用户报"画面整体向右平移"。模型画了 5 根已知竖条让用户点中心,读出:

| 竖条 | 帧缓存中心 | 点到 | δ |
|---|---|---|---|
| 红 | 131.5 | 140 | +8.5 |
| 绿 | 323.5 | 339 | +15.5 |
| 白 | 515.5 | 523 | +7.5 |
| 黄 | 707.5 | 711 | +3.5 |
| 蓝 | 899.5 | 900 | +0.5 |

δ **单调递减**,看着像"约 1.4% 欠标定",模型差点就这么写了。

**自己把这条推翻的证据**:同一条蓝条,**上一轮量到 +10.5,这一轮 +0.5** ——
同一条、同一位置、同一个人,**两次差 10 px**。

⇒ **手指瞄准的重复性就是 ±10 px 量级,和要测的效应同量级。这套量具没有分辨力。**

✅ **正确做法**:判据从**被测对象自己的几何**里**算出来**,而不是**量出来**。
用户界面里两张大卡各 453 px、中间**只有 22 px 缝**(左卡 x∈[48,501]、右卡 x∈[523,976])。
问法从"偏移多少 px"改成"**有没有越过某个已知界**":

> 按缝正中 x≈512:右卡亮 ⇒ δ > +11;都不亮 ⇒ **|δ| ≤ 11**;左卡亮 ⇒ δ < −11。

**一次按压得结论。** 缝隙边界是 UI 框架自己算的,不依赖手指精度。

> **判据:如果一个数字要写进结论,它必须**先有已知分辨力**。**
> 反例:模型用"两端各 8 px 白条"做边缘判定,**只排得掉 δ ≥ 8**,
> 却被当成 δ≈0 的证明 —— 而且**从未向用户声明这个测试的分辨力**。
> 用户后来说「偏移严重多了」,两者量级根本对不上。

### 判据 2:**证据条数 ≠ 证据强度,独立性才是**

**事故**:某次"实测"记录了 IO PLL = 1500 MHz,并列出**三条相互独立的证据**。
复核发现:三条**其实同源** —— 一个 PYNQ 内部假定 + 一次写操作,**没有一条独立**。

> ⇒ **列的"证据"条目再多,只要同源,就只有一条。**

📌 顺带一条**具体**的量具坑:
**`Clocks.fclk0_mhz` 的返回值不是仪表读数。** 它按**假定**的 IO PLL 频率做除法。
本项目曾把它的输出(41.6667 MHz)当"实测值"写进全部文档,**后被独立时基推翻**。
真值要靠**独立时基**测(本项目用"帧率法":帧几何是常量,数帧率反推像素时钟)。

### 判据 3:选判据要问「**它能区分我要区分的那两种情况吗**」

**事故 A**:某个调试寄存器里同时记录"取数拍数"和"数据非零标志"。四格实验中:

| 字段 | 表现 | 可用性 |
|---|---|---|
| `beats`(拍数) | **四格全都 ≈100%** | ❌ **无区分力** |
| `rresp_lat` | 随"刚加载 / 稳态"变化 | ⚠️ 不稳定 |
| `axi_or_nz`(数据非零) | **8/8 一致** | ✅ 唯一可靠 |

**事故 B**:推理是「**重启之后仍然故障 ⇒ 故障与程序无关**」。
方向反了 —— **若根因写在程序里,重启当然不能恢复**。
「重启后仍故障」恰恰是「故障与程序有关」的**正面证据**。

> ⇒ **否定一条假设时,要问「这个观测能区分我要区分的那两种情况吗」,
> 而不是「这个观测符不符合我的预期」。**
> 「重启无效」能区分的是**有无持久存储**,不能区分**故障在 PL 还是在 PS**。

### 判据 4:量具的**语义边界**要对齐 —— 它测的是不是我以为的那个东西

| 量具 | 你以为它证明的 | 它实际证明的 |
|---|---|---|
| `grep -c <名> file` | "配置里没有悬挂引用" | 只证明**文件里没有这个字符串**,不证明工具加载后不引用 |
| **文件大小变没变** | "文件改了没" | ❌ **无效**:两个不同地址 `0x40000000` 与 `0x43C00000` 恰好等长,`.bd` 两次都是 **29 039 B** |
| 位流 **md5** | "改动生效了没" | 只能证明**位流变了**,不能证明**变的是我以为的那一处** |
| 读活动状态寄存器 | "配置是什么" | 读的是**当时的活动状态**;同一地址两次读数不同(`0xF8008024` 一度读到 `0x00000F00`,`0xF8008010` 读到 `0x0000001A`,复测全变) |
| 人眼看 LED | "写成功了" | 一层**不可靠转述**。改用 PS 侧独立读回 |
| 编辑器的标签页内容 | "磁盘上的文件" | Vivado **不自动重载**外部修改;在该页 Ctrl+S 会把新版覆盖回旧版 |

---

## 失效条件

- ⛔ **本条清单不能替代对被测对象的实际排查** —— 它的作用是**排序**,不是**定罪**。
  量具错了是一种可能,不是唯一可能。
- ⛔ **不要因为它走向另一个极端**:把每次失败都归给量具,同样是不合格的推理。
  正确姿势是**先做一个能区分"量具错 / 对象错"的实验**。
- ⚠️ **"人眼当观测者"在有些场合是唯一可行的** ——
  那时要做的不是放弃,而是**给可判读的多元素图案**
  (本项目用「整屏绿 + 中间红横带 + 左上小方块」,一次回报同时区分"全对 / 行内偏移 / 无数据 / R-B 交换")。

## 已验证的效果

| 事故 | 错的是哪个量具 | 纠正方式 |
|---|---|---|
| 1 | **VCD 解码器**把下降沿当采样点 | 按协议语义重定采样沿 |
| 2 | **引脚监视器**把采样沿写反 | 同上 |
| 3 | **TB 期望值算错**(7 位十六进制当 8 位算) | 手算复核;矛盾点是"同一路径另一次 PASS" |
| 4 | **测试图案**(回文 `A5A5` 对位序反转**零判别力**) | 换非回文图案,抓取率 **2/6 → 5/6** |
| 5 | **`sed` 静默失配** ⇒ 负测试**恒 PASS** | 确认落盘后重跑,立刻抓出 **5 个 FAIL** |
| 6 | **文件大小**作判据(两地址等长) | 改为**按值**核 |
| 7 | **`beats`** 作判据(四格全 100%) | 改用 `axi_or_nz`(8/8 一致) |
| 8 | **手指瞄准**(±10 px) | 换成**用被测对象布局当尺子**的二值问法 |

**净收益**:第 6 项曾让一次结论"回滚又回滚"(一天内推翻自己的推翻);
第 8 项让一个悬了两轮的显示偏差问题**一次按压结案**。
⇒ **换量具比换结论便宜得多。**

## 来源

- 事故 1、2、3 → `LLM-009` / `LLM-011` / `LLM-014`(「量具错」第 5 次;
  共同点:**报错时第一个怀疑对象永远是被测对象**)。
- 事故 4、5 → `LLM-005` 纠错轨迹 A / C。
- 事故 6 → `LLM-027` 纠错轨迹 3(**BD 未保存**时先查 mtime 而不是先怀疑用户)。
- 事故 7 → `LLM-034` / `LLM-035` / `LLM-036`(DDR 帧缓存全黑排障;
  以及「证据条数 ≠ 证据强度」这条硬纠错)。
- 事故 8 → `LLM-037`(模型**两次拿噪声当结论**,被用户叫停后换量具)。
- 表里的"人眼看 LED" → `LLM-036`(厂商例程按键触发,改用 PS 侧读回复核)。

**相关技能**:`skill/use-layout-as-ruler/`(事故 8 的正面方法)、
`skill/stale-artifact-silent-reuse/`(量具本身过期)、
`skill/rtl-constant-experiment-must-verify-netlist/`(源码作判据的失效)。
