dsgmxc/2026_fpga_qrs/board/measurements/artifacts/20261023_th521_reference/th521_typ_cv.csv

Vds_V | Ciss_typ_pF | Ciss_sd_pF | Ciss_min_pF | Ciss_max_pF | Coss_typ_pF | Coss_sd_pF | Coss_min_pF | Coss_max_pF | Crss_typ_pF | Crss_sd_pF | Crss_min_pF | Crss_max_pF
0.1 | 3212.5337 | 28.9015 | 3181.2300 | 3258.8756 | 4163.2818 | 20.7872 | 4136.3044 | 4198.5507 | 1503.8637 | 30.6501 | 1464.8519 | 1548.5005
0.103514 | 3206.6019 | 29.3845 | 3173.4499 | 3254.0381 | 4158.0094 | 19.5222 | 4129.8508 | 4187.1914 | 1501.9867 | 29.9980 | 1464.8519 | 1546.8264
0.107152 | 3204.2391 | 29.5781 | 3170.5820 | 3254.0358 | 4148.4455 | 18.7161 | 4126.6231 | 4175.3941 | 1500.4623 | 29.8292 | 1464.8519 | 1546.1091
0.110917 | 3204.9496 | 29.1178 | 3169.0953 | 3252.8036 | 4138.1042 | 18.6659 | 4118.6618 | 4163.6301 | 1498.1642 | 30.1986 | 1463.2100 | 1545.4090
0.114815 | 3201.9958 | 29.5959 | 3167.7702 | 3251.8805 | 4127.1351 | 19.1091 | 4107.4794 | 4155.7818 | 1496.7526 | 30.0999 | 1462.0605 | 1543.5759
0.11885 | 3201.1374 | 29.6974 | 3166.4474 | 3250.8519 | 4125.5662 | 21.7589 | 4091.1223 | 4150.1777 | 1496.3561 | 29.6767 | 1461.8922 | 1541.1756
0.123027 | 3199.6888 | 29.6441 | 3165.3727 | 3249.7500 | 4116.3939 | 23.6496 | 4085.0780 | 4146.6320 | 1494.5035 | 29.2719 | 1459.8341 | 1538.7791
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
