dsgmxc/2026_fpga_qrs/board/measurements/artifacts/20261023_th521_reference/th521_typ_rg.csv

Vgs_V | Rg_typ_ohm | Rg_sd_ohm | Rg_min_ohm | Rg_max_ohm
-3 | 3.4387 | 0.0261 | 3.4004 | 3.4889
-2.94 | 3.4179 | 0.0239 | 3.3882 | 3.4766
-2.88 | 3.3646 | 0.0235 | 3.3342 | 3.4213
-2.82 | 3.3089 | 0.0232 | 3.2795 | 3.3652
-2.76 | 3.2549 | 0.0234 | 3.2245 | 3.3108
-2.7 | 3.2044 | 0.0233 | 3.1750 | 3.2611
-2.64 | 3.1607 | 0.0238 | 3.1312 | 3.2188
-2.58 | 3.1248 | 0.0241 | 3.0953 | 3.1837
-2.52 | 3.0947 | 0.0245 | 3.0660 | 3.1560
-2.46 | 3.0705 | 0.0247 | 3.0417 | 3.1324
-2.4 | 3.0491 | 0.0252 | 3.0209 | 3.1130
-2.34 | 3.0310 | 0.0255 | 3.0030 | 3.0963
-2.28 | 3.0159 | 0.0256 | 2.9884 | 3.0814
-2.22 | 3.0019 | 0.0260 | 2.9742 | 3.0690
-2.16 | 2.9897 | 0.0260 | 2.9633 | 3.0578
-2.1 | 2.9795 | 0.0267 | 2.9521 | 3.0484
-2.04 | 2.9709 | 0.0268 | 2.9428 | 3.0402
-1.98 | 2.9632 | 0.0270 | 2.9356 | 3.0332
-1.92 | 2.9576 | 0.0274 | 2.9297 | 3.0285
-1.86 | 2.9532 | 0.0276 | 2.9259 | 3.0251
-1.8 | 2.9505 | 0.0278 | 2.9223 | 3.0224
-1.74 | 2.9494 | 0.0282 | 2.9207 | 3.0223
-1.68 | 2.9487 | 0.0284 | 2.9196 | 3.0218
-1.62 | 2.9492 | 0.0284 | 2.9213 | 3.0223
-1.56 | 2.9497 | 0.0285 | 2.9220 | 3.0234
-1.5 | 2.9512 | 0.0289 | 2.9221 | 3.0252
-1.44 | 2.9519 | 0.0293 | 2.9238 | 3.0275
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
