dsgmxc/2026_fpga_qrs/board/measurements/artifacts/20261015_sweep63_after.csv

leg | bias | a_v | a_code | b_v | b_code | otr | ratio_a | ratio_b | tries | re | im | r0 | gear | cs | cp | d | cur
CISS | 0.1 | 0.2881 | 1204 | 0.2441 | 1020 | 0 | 1.02 | 1.02 | 1 | 8.249 | -47.023 | 100 | 0x2 | 3384.635 | 3283.574 | 0.17544 | 2.4414
CISS | 0.112 | 0.2882 | 1205 | 0.2442 | 1011 | 0 | 1.02 | 1.01 | 1 | 8.256 | -47.075 | 100 | 0x2 | 3380.910 | 3280.011 | 0.17539 | 2.4417
CISS | 0.126 | 0.2882 | 1206 | 0.2441 | 1013 | 0 | 1.02 | 1.01 | 1 | 8.272 | -47.145 | 100 | 0x2 | 3375.876 | 3275.055 | 0.17545 | 2.4406
CISS | 0.142 | 0.2882 | 1206 | 0.244 | 1015 | 0 | 1.02 | 1.02 | 1 | 8.281 | -47.195 | 100 | 0x2 | 3372.301 | 3271.565 | 0.17547 | 2.4403
CISS | 0.16 | 0.2883 | 1209 | 0.244 | 1013 | 0 | 1.02 | 1.01 | 1 | 8.275 | -47.260 | 100 | 0x2 | 3367.617 | 3267.435 | 0.17510 | 2.4400
CISS | 0.18 | 0.2883 | 1208 | 0.2439 | 1010 | 0 | 1.02 | 1.01 | 1 | 8.292 | -47.369 | 100 | 0x2 | 3359.871 | 3259.987 | 0.17504 | 2.4393
CISS | 0.202 | 0.2884 | 1207 | 0.2439 | 1012 | 0 | 1.02 | 1.01 | 1 | 8.310 | -47.469 | 100 | 0x2 | 3352.816 | 3253.125 | 0.17506 | 2.4386
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
