dsgmxc/2026_fpga_qrs/board/measurements/artifacts/20261015_sweep63_before.csv

leg | bias | a_v | a_code | b_v | b_code | otr | ratio_a | ratio_b | tries | re | im | r0 | gear | cs | cp | d | cur
CISS | 0.1 | 0.2881 | 1208 | 0.2446 | 1014 | 0 |  |  |  | 7.977 | -47.110 | 100 | 0x2 | 3378.365 | 3284.198 | 0.16933 | 2.4459
CISS | 0.112 | 0.2881 | 1206 | 0.2445 | 1016 | 0 |  |  |  | 7.973 | -47.145 | 100 | 0x2 | 3375.873 | 3281.996 | 0.16913 | 2.4454
CISS | 0.126 | 0.288 | 1290 | 0.2444 | 1168 | 0 |  |  |  | 7.974 | -47.203 | 100 | 0x2 | 3371.692 | 3278.150 | 0.16892 | 2.4443
CISS | 0.142 | 0.2881 | 1206 | 0.2444 | 1014 | 0 |  |  |  | 7.967 | -47.292 | 100 | 0x2 | 3365.383 | 3272.503 | 0.16847 | 2.4442
CISS | 0.16 | 0.2882 | 1207 | 0.2444 | 1018 | 0 |  |  |  | 7.992 | -47.347 | 100 | 0x2 | 3361.455 | 3268.327 | 0.16880 | 2.4438
CISS | 0.18 | 0.2883 | 1206 | 0.2443 | 1012 | 0 |  |  |  | 8.008 | -47.459 | 100 | 0x2 | 3353.543 | 3260.698 | 0.16874 | 2.4434
CISS | 0.202 | 0.2883 | 1207 | 0.2443 | 1016 | 0 |  |  |  | 7.993 | -47.575 | 100 | 0x2 | 3345.342 | 3253.509 | 0.16801 | 2.4434
CISS | 0.227 | 0.2883 | 1207 | 0.2442 | 1013 | 0 |  |  |  | 8.038 | -47.673 | 100 | 0x2 | 3338.480 | 3246.197 | 0.16861 | 2.4416
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
