dsgmxc/2026_fpga_qrs/board/measurements/artifacts/20261023_sweep_3legs_60pt.csv

leg | bias_V | A_tick | A_amp_V | A_pp_codes | B_tick | B_amp_V | B_pp_codes | OTR | R0_ohm | gear | Z_re_ohm | Z_im_ohm | Cs_pF | Cp_pF | D | I_mA
CISS | 0.100 | 1 | 0.2886 | 1188 | -1 | 0.2447 | 1011 | 0 | 100 | 0x2 | 8.099 | -47.145 | 3375.836 | 3279.070 | 0.17179 | 2.4468
CISS | 0.112 | 1 | 0.2886 | 1188 | -1 | 0.2447 | 1011 | 0 | 100 | 0x2 | 8.096 | -47.194 | 3372.330 | 3275.918 | 0.17155 | 2.4471
CISS | 0.126 | 1 | 0.2888 | 1190 | -1 | 0.2448 | 1012 | 0 | 100 | 0x2 | 8.110 | -47.251 | 3368.294 | 3271.910 | 0.17163 | 2.4481
CISS | 0.142 | 1 | 0.2887 | 1188 | -1 | 0.2446 | 1010 | 0 | 100 | 0x2 | 8.101 | -47.336 | 3362.235 | 3266.570 | 0.17113 | 2.4460
CISS | 0.160 | 1 | 0.2888 | 1189 | -1 | 0.2447 | 1012 | 0 | 100 | 0x2 | 8.120 | -47.399 | 3357.748 | 3262.014 | 0.17131 | 2.4467
CISS | 0.180 | 1 | 0.2888 | 1193 | -1 | 0.2446 | 1012 | 0 | 100 | 0x2 | 8.128 | -47.492 | 3351.200 | 3255.835 | 0.17114 | 2.4456
CISS | 0.202 | 1 | 0.2888 | 1190 | -1 | 0.2445 | 1009 | 0 | 100 | 0x2 | 8.130 | -47.580 | 3344.981 | 3250.099 | 0.17086 | 2.4450
CISS | 0.227 | 1 | 0.2890 | 1190 | -1 | 0.2445 | 1011 | 0 | 100 | 0x2 | 8.142 | -47.695 | 3336.932 | 3242.435 | 0.17072 | 2.4452
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
