dsgmxc/2026_fpga_qrs/board/measurements/artifacts/20261024_leg_settle_sweep.csv

leg | index | bias_v | A_pp_codes | B_pp_codes | Cs_pF | Cp_pF | D | I_mA
CISS | 1 | 0.100 | 1136 | 969 | 3378.808 | 3283.082 | 0.17076 | 2.3375
CISS | 2 | 0.112 | 1138 | 970 | 3375.219 | 3279.604 | 0.17075 | 2.3367
CISS | 3 | 0.126 | 1136 | 969 | 3370.829 | 3275.652 | 0.17046 | 2.3365
CISS | 4 | 0.142 | 1136 | 969 | 3365.965 | 3270.711 | 0.17066 | 2.3359
CISS | 5 | 0.160 | 1140 | 969 | 3361.205 | 3266.287 | 0.17047 | 2.3361
CISS | 6 | 0.180 | 1137 | 968 | 3354.975 | 3260.593 | 0.17014 | 2.3353
CISS | 7 | 0.202 | 1139 | 969 | 3348.573 | 3254.539 | 0.16998 | 2.3348
CISS | 8 | 0.227 | 1140 | 969 | 3340.721 | 3247.213 | 0.16970 | 2.3348
CISS | 9 | 0.255 | 1137 | 969 | 3331.139 | 3238.007 | 0.16959 | 2.3333
CISS | 10 | 0.287 | 1138 | 969 | 3321.679 | 3228.969 | 0.16945 | 2.3329
CISS | 11 | 0.322 | 1141 | 968 | 3310.800 | 3218.774 | 0.16909 | 2.3318
CISS | 12 | 0.363 | 1137 | 968 | 3297.066 | 3205.691 | 0.16883 | 2.3307
CISS | 13 | 0.408 | 1139 | 967 | 3283.106 | 3192.644 | 0.16833 | 2.3297
CISS | 14 | 0.458 | 1140 | 967 | 3266.209 | 3176.444 | 0.16811 | 2.3296
CISS | 15 | 0.515 | 1141 | 966 | 3246.088 | 3157.576 | 0.16743 | 2.3274
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
