dsgmxc/2026_fpga_qrs/board/measurements/artifacts/20261025_ai_detection_3legs_60pt.csv

bias_V | Cs_CISS_pF | Cs_COSS_pF | Cs_CRSS_pF
0.1 | 3379.531 | 3565.715 | 1741.723
0.112 | 3375.642 | 3551.426 | 1789.927
0.126 | 3372.077 | 3531.906 | 1781.86
0.142 | 3367.362 | 3508.747 | 1775.808
0.16 | 3362.735 | 3482.564 | 1764.431
0.18 | 3355.12 | 3453.019 | 1753.994
0.202 | 3348.677 | 3423.253 | 1742.565
0.227 | 3341.276 | 3389.773 | 1727.518
0.255 | 3332.059 | 3354.435 | 1712.566
0.287 | 3322.461 | 3314.461 | 1695.327
0.322 | 3311.26 | 3271.554 | 1675.815
0.363 | 3298.116 | 3225.459 | 1655.047
0.408 | 3283.464 | 3176.515 | 1630.89
0.458 | 3267.265 | 3121.367 | 1603.733
0.515 | 3247.301 | 3064.369 | 1573.729
0.579 | 3224.177 | 3001.605 | 1539.77
0.651 | 3199.193 | 2934.894 | 1501.951
0.732 | 3168.756 | 2861.928 | 1459.093
0.823 | 3132.764 | 2782.776 | 1411.744
0.925 | 3092.81 | 2698.081 | 1356.05
1.04 | 3046.375 | 2606.974 | 1294.075
1.169 | 2995.499 | 2510.887 | 1230.186
1.314 | 2941.996 | 2410.209 | 1160.635
1.477 | 2887.935 | 2309.346 | 1090.606
1.661 | 2835.214 | 2211.546 | 1023.317
1.867 | 2785.363 | 2115.763 | 959.408
2.099 | 2737.137 | 2021.321 | 899.866
2.36 | 2690.41 | 1930.643 | 843.206
2.653 | 2645.769 | 1841.296 | 788.907
2.982 | 2602.272 | 1754.456 | 737.285
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
