dsgmxc/2026_fpga_qrs/board/measurements/artifacts/20261029_leg_settle_sweep_cal.csv

leg | index | bias_v | A_pp_codes | B_pp_codes | Cs_pF | Cp_pF | D | I_mA
CISS | 1 | 0.1 | 1134 | 969 | 3483.786 | 3461.065 | 0.08102 | 2.3301
CISS | 2 | 0.112 | 1135 | 966 | 3479.288 | 3456.595 | 0.08103 | 2.3298
CISS | 3 | 0.126 | 1137 | 968 | 3474.238 | 3451.513 | 0.08114 | 2.3291
CISS | 4 | 0.142 | 1136 | 968 | 3467.106 | 3444.613 | 0.08081 | 2.3295
CISS | 5 | 0.16 | 1137 | 968 | 3460.019 | 3437.626 | 0.08071 | 2.3289
CISS | 6 | 0.18 | 1137 | 966 | 3452.128 | 3429.793 | 0.08070 | 2.3275
CISS | 7 | 0.202 | 1136 | 966 | 3444.013 | 3421.831 | 0.08051 | 2.3281
CISS | 8 | 0.227 | 1136 | 967 | 3433.345 | 3411.429 | 0.08015 | 2.3264
CISS | 9 | 0.255 | 1136 | 967 | 3422.437 | 3400.494 | 0.08033 | 2.3263
CISS | 10 | 0.287 | 1137 | 964 | 3408.899 | 3387.191 | 0.08006 | 2.3261
CISS | 11 | 0.322 | 1137 | 965 | 3393.023 | 3371.742 | 0.07945 | 2.3239
CISS | 12 | 0.363 | 1137 | 964 | 3376.988 | 3355.890 | 0.07929 | 2.3241
CISS | 13 | 0.408 | 1141 | 962 | 3357.634 | 3336.758 | 0.07910 | 2.3224
CISS | 14 | 0.458 | 1140 | 965 | 3335.573 | 3315.077 | 0.07863 | 2.3208
CISS | 15 | 0.515 | 1139 | 963 | 3310.733 | 3290.484 | 0.07845 | 2.3190
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
