dsgmxc/2026_fpga_qrs/board/measurements/20261006_sweep_all_framebuffer.png

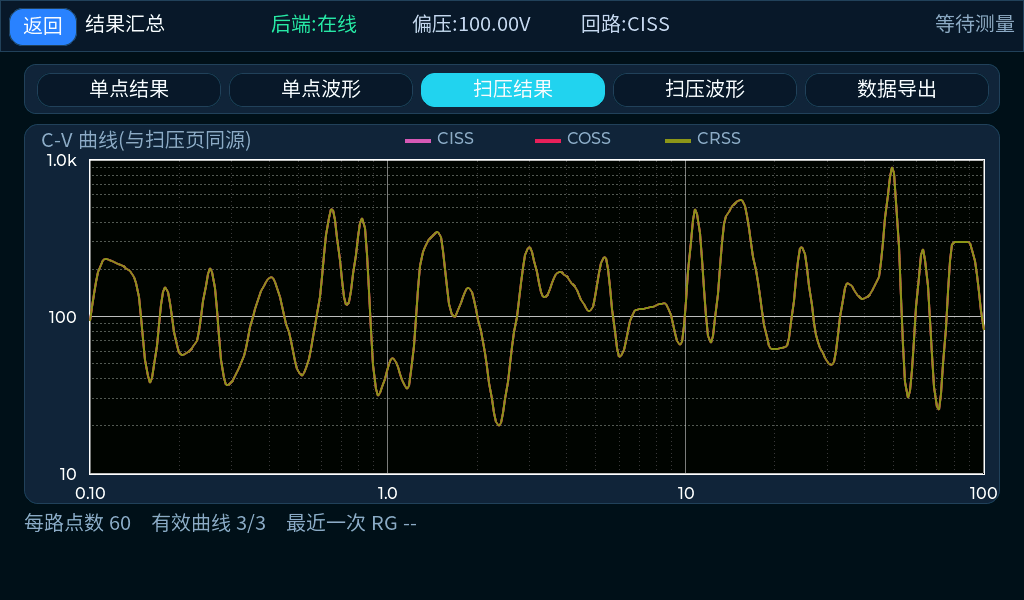
board/measurements/20261006_sweep_all_framebuffer.png
