dsgmxc/2026_fpga_qrs/board/measurements/20261007_adc_65msps_waveforms.png

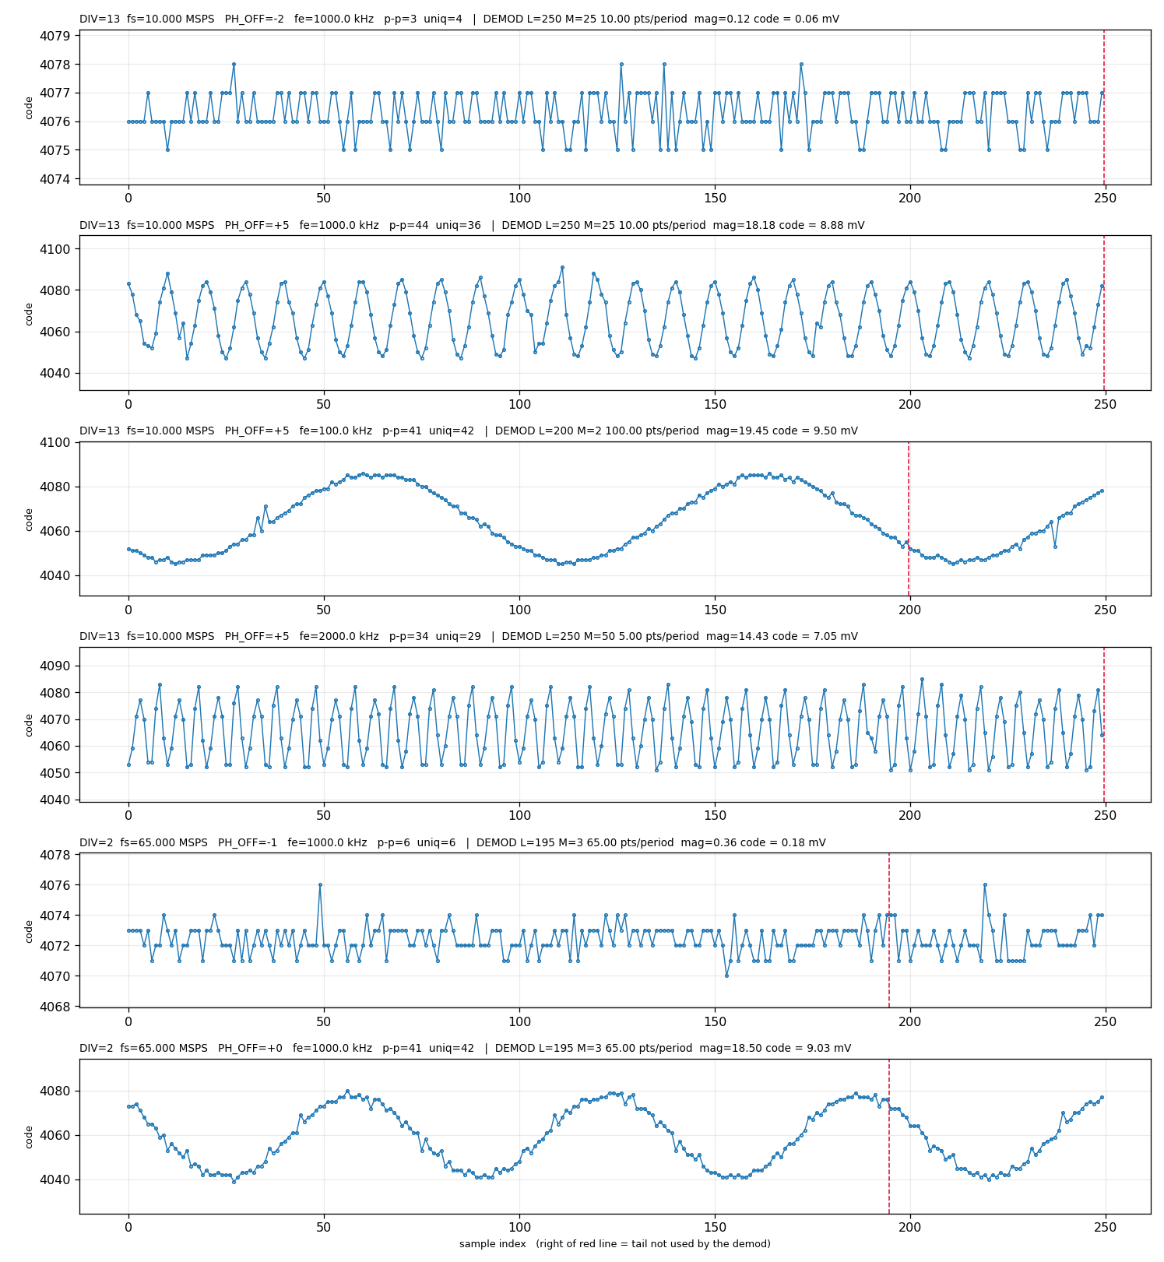
board/measurements/20261007_adc_65msps_waveforms.png
