dsgmxc/2026_fpga_qrs/board/measurements/20261008_ui_after_65msps.png

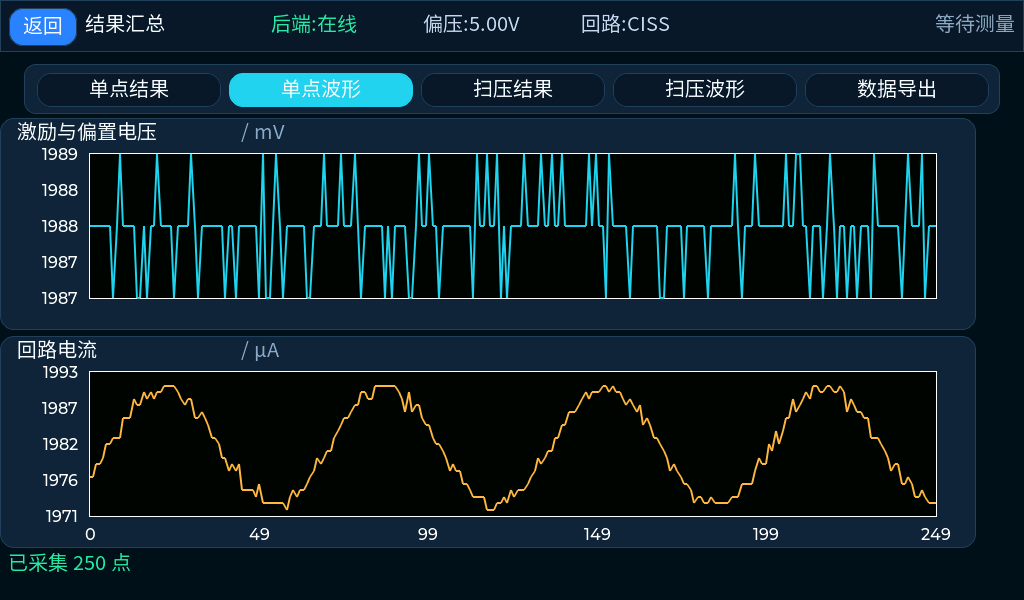
board/measurements/20261008_ui_after_65msps.png
