dsgmxc/2026_fpga_qrs/board/measurements/20261008_ui_now.png

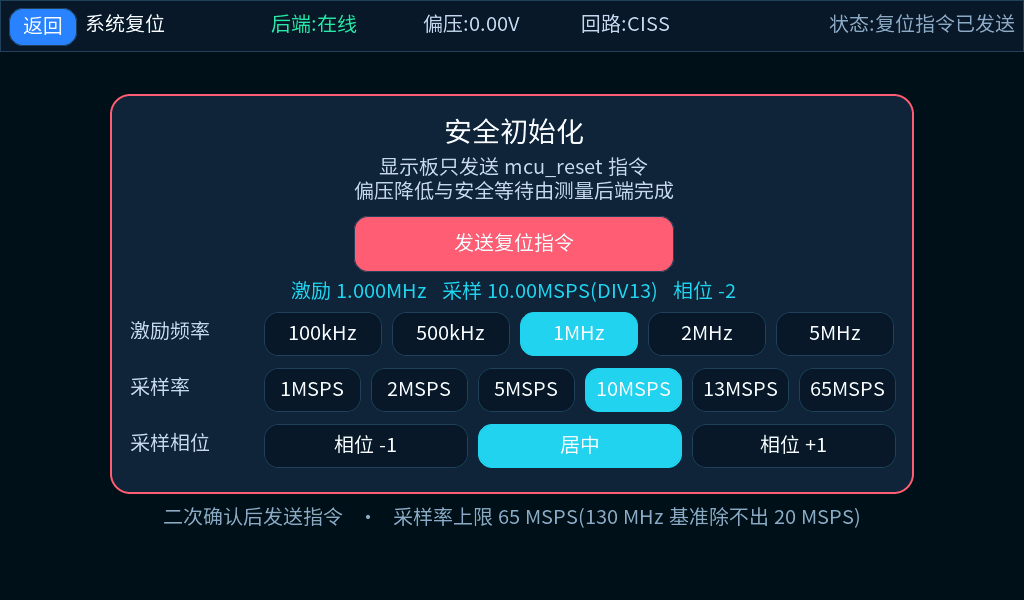
board/measurements/20261008_ui_now.png
