dsgmxc/2026_fpga_qrs/board/measurements/20261010_ui_alert_gear_illegal.png

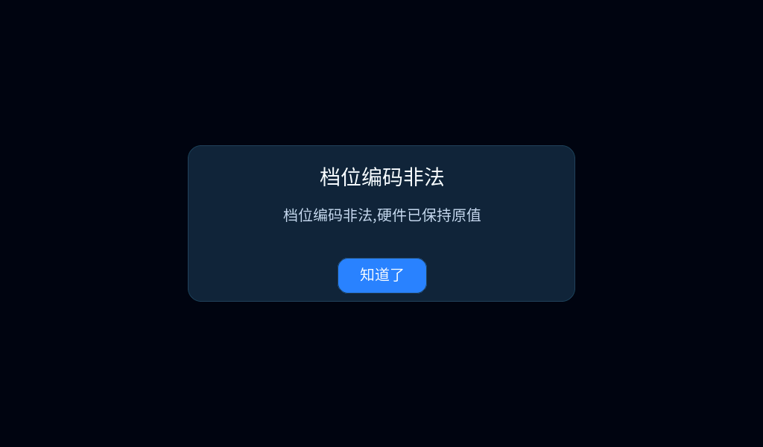
board/measurements/20261010_ui_alert_gear_illegal.png
