dsgmxc/2026_fpga_qrs/board/measurements/20261010_ui_home_relay_gear_readonly.png

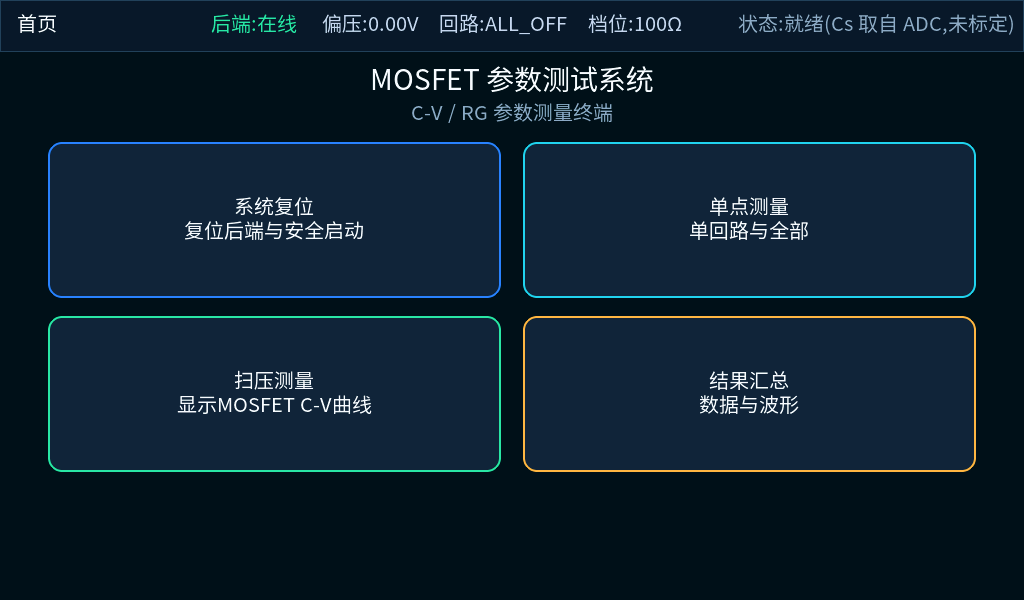
board/measurements/20261010_ui_home_relay_gear_readonly.png
