dsgmxc/2026_fpga_qrs/board/measurements/20261017_ui_result_transfer/result_page_probe10v.png

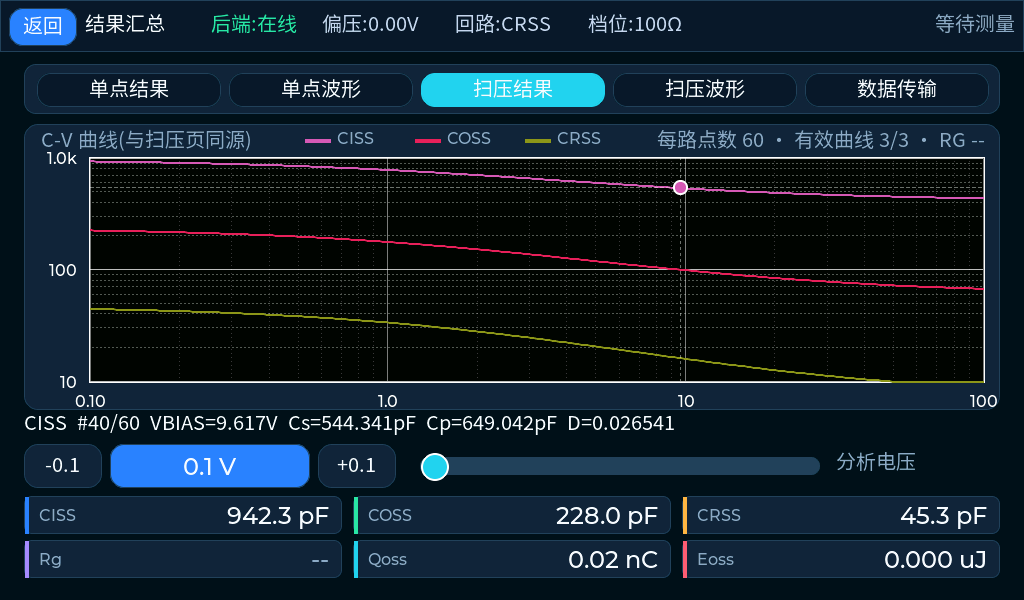
board/measurements/20261017_ui_result_transfer/result_page_probe10v.png
