dsgmxc/2026_fpga_qrs/board/measurements/20261017_ui_result_transfer/transfer_page.png

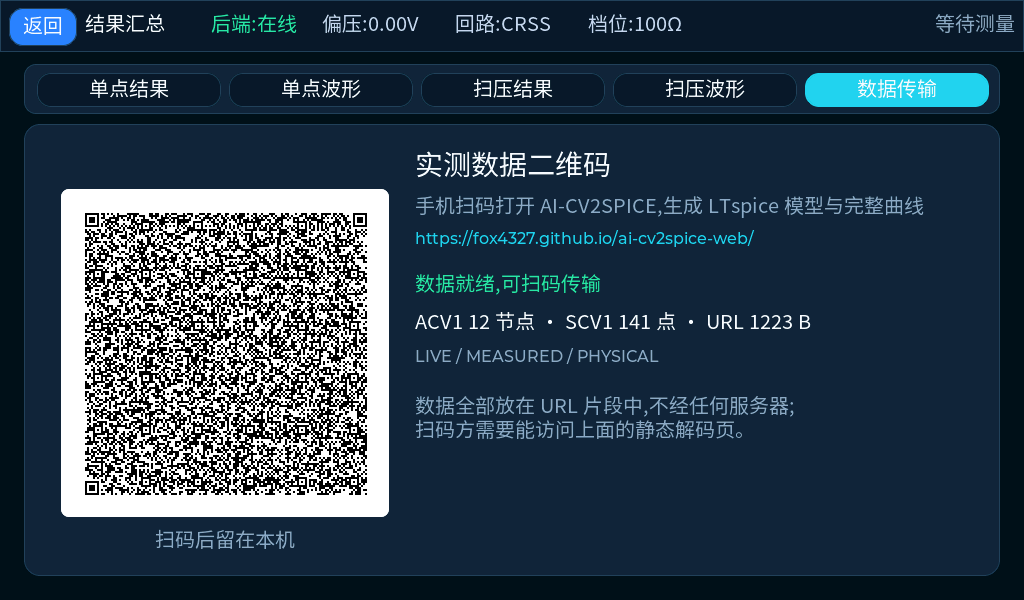
board/measurements/20261017_ui_result_transfer/transfer_page.png
