dsgmxc/2026_fpga_qrs/board/measurements/artifacts/20261006_board_point_fail_state.png

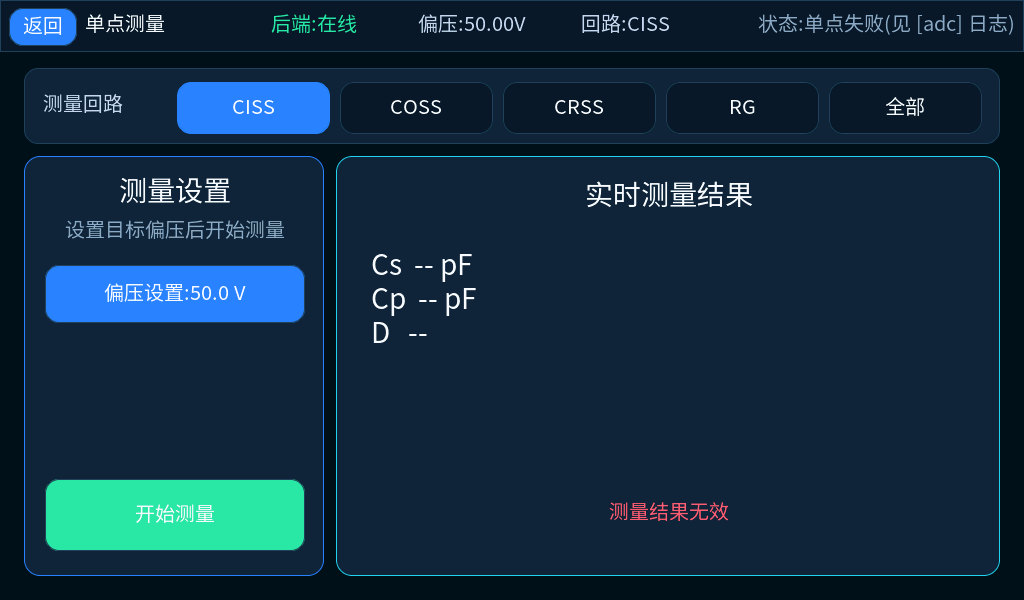
board/measurements/artifacts/20261006_board_point_fail_state.png
