dsgmxc/2026_fpga_qrs/board/measurements/artifacts/20261006_board_point_result_three_cards.png

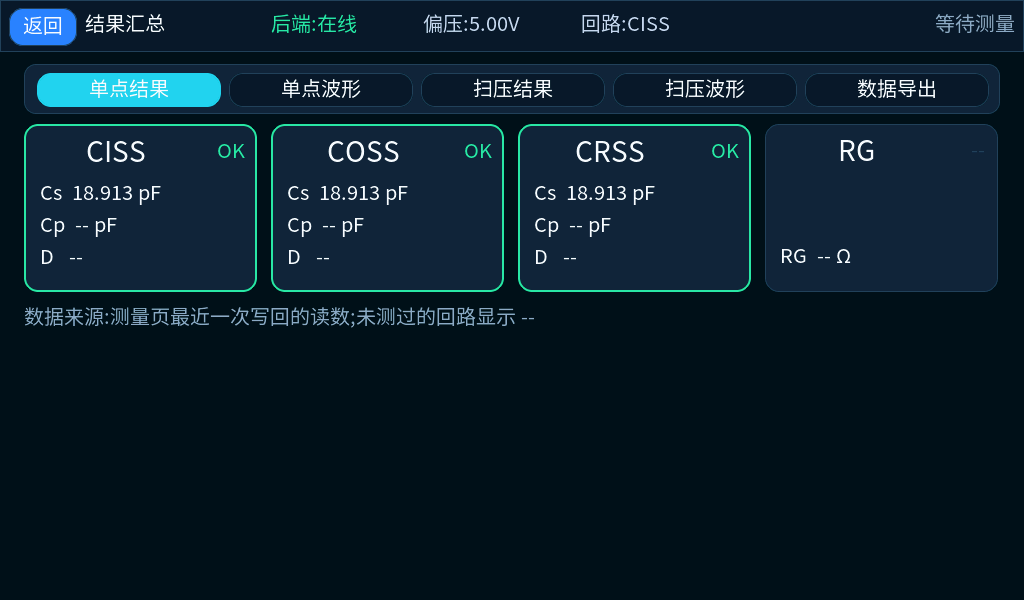
board/measurements/artifacts/20261006_board_point_result_three_cards.png
