dsgmxc/2026_fpga_qrs/board/measurements/artifacts/20261006_board_reset_page_state1.png

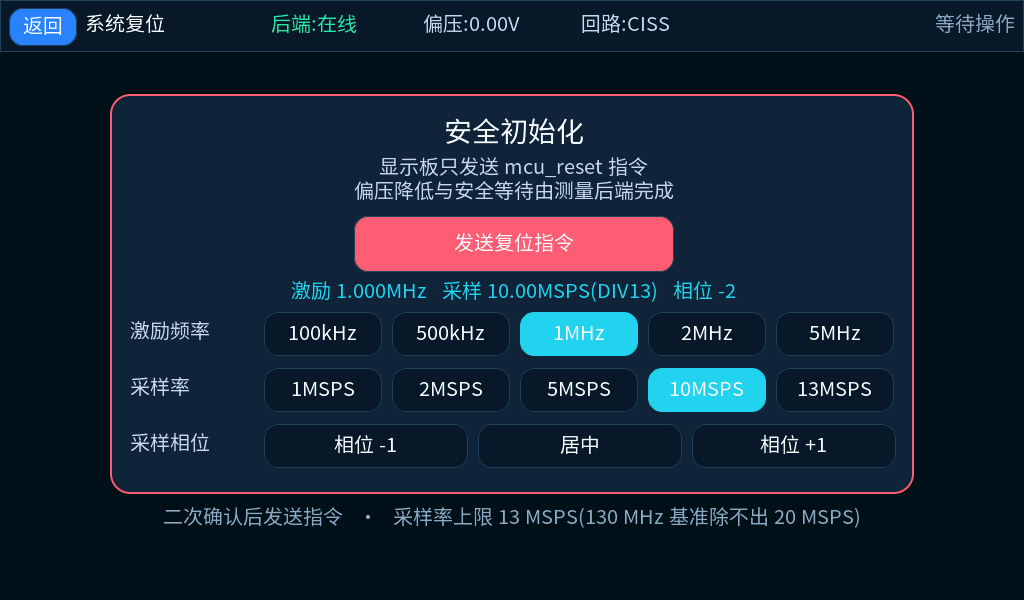
board/measurements/artifacts/20261006_board_reset_page_state1.png
