dsgmxc/2026_fpga_qrs/board/measurements/artifacts/20261006_board_sweep_waveform_page.png

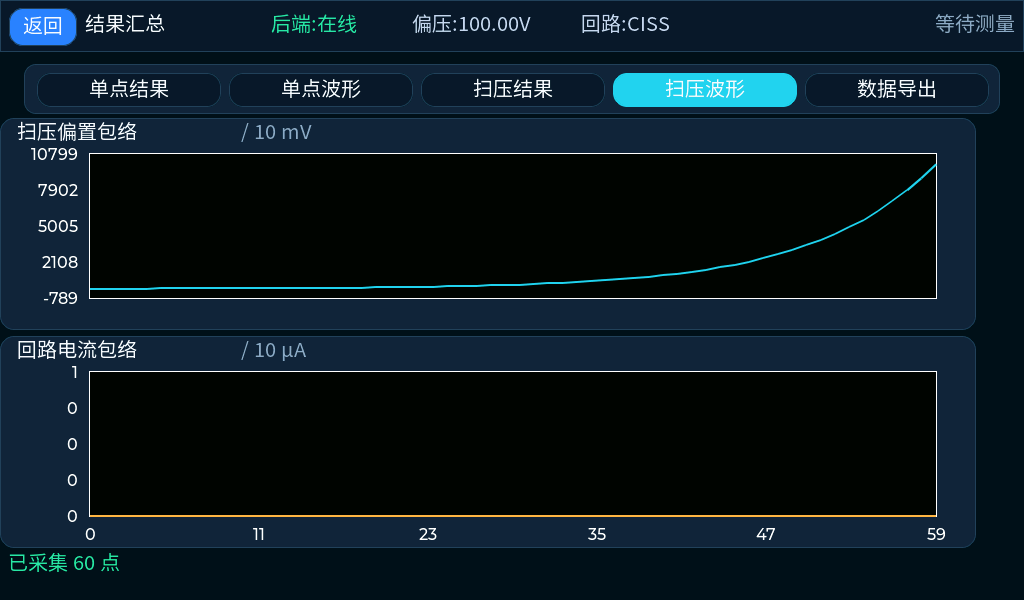
board/measurements/artifacts/20261006_board_sweep_waveform_page.png
