dsgmxc/2026_fpga_qrs/board/measurements/artifacts/20261023_ref_curve_ui.png

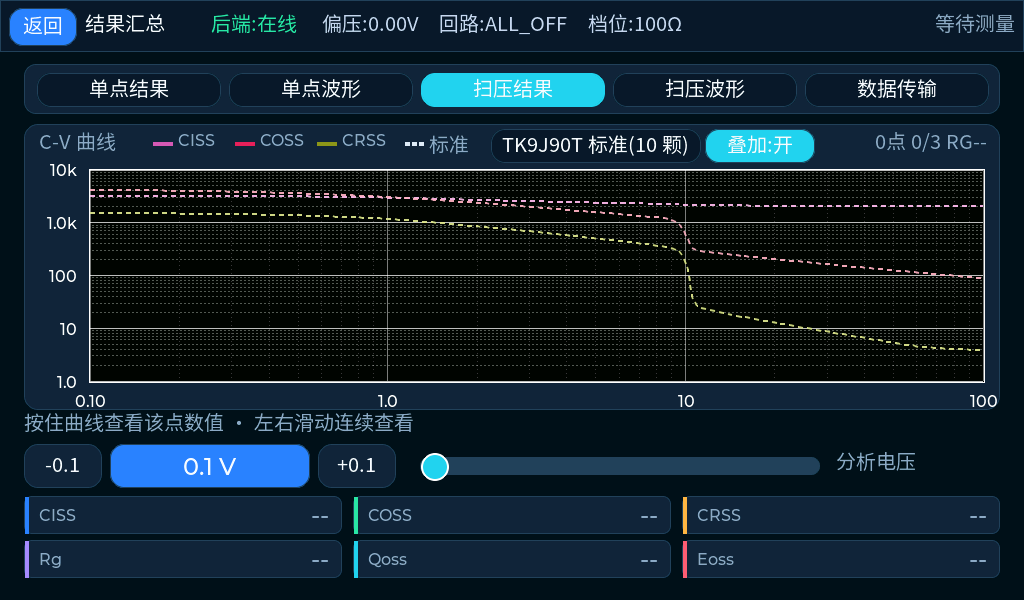
board/measurements/artifacts/20261023_ref_curve_ui.png
