dsgmxc/2026_fpga_qrs/board/measurements/20261024_leg_settle_fix_sweep.md

# 2026-10-24 换腿沉降修复 · 三腿全扫压复测

> 目的:验证 `LLM-077` 的两处改动 ——
> ①换腿后第一点**多等一个驻留**(300 ms);②换腿前**先 `bias_apply(0)` 再切继电器**。
> 判据:第 2/3 腿的**首点是否与次点连续**(修复前 COSS/CRSS 首点只有次点的 55 % / 34 %)。

## 一、条件

| 项 | 值 |
|---|---|
| 板卡 | 正点原子领航者 ZYNQ-7020,PL 顶层 `cv_sys` |
| 固件 | `c_ui` md5 **`6ca7dd195ef084c69824974934a373b6`**(含本轮两项改动) |
| 位流 | 本次上电周期 **恰加载 1 次**(`dmesg`: `writing qrs.bin`,服务启动那一次) |
| 时钟 | FCLK0 **50.0000 MHz**(日志 `[dac]` 行) |
| 激励 / 采样 | 1.000 MHz / **32.50 MSPS**(`0x88 = 0x104`,DIV=4,PH_OFF=+1) |
| 挡位 | **B(100 Ω)**,`0x18` 回读 `0x2` |
| 扫压 | 0.10 V → 100.00 V,**60 点/腿**,驻留 **300 ms**,腿序 CISS → COSS → CRSS |
| 校准 | 未应用(日志 `(未校准)`;校准文件 0/48 点) |
| 外设 | 已接(同轮 ADC 通路自检 A/B 峰峰 ~1124 / ~987 码) |

## 二、结果

### 2.1 首点 vs 次点(修复前后对照)

| 腿 | 修复前 首点 Cs | 修复前 次点 Cs | 修复前 比值 | **修复后 首点 Cs** | **修复后 次点 Cs** | **修复后 比值** |
|---|---|---|---|---|---|---|
| CISS | 3378.98 pF | 3374.30 pF | 1.001 | **3378.81 pF** | **3375.22 pF** | **1.001** |
| COSS | 1872.47 pF | 3393.32 pF | **0.552** | **3568.80 pF** | **3559.53 pF** | **1.003** |
| CRSS | 572.58 pF | 1700.40 pF | **0.337** | **1749.57 pF** | **1795.66 pF** | **0.974** |

- “修复前”取自同一块板上一次连续三腿扫压(`/var/log/qrs-ui.log` 第 2008 / 2010 / 2137 / 2139 行)。
- 修复后 CRSS 首点比次点低 **2.6 %**,但**介于第 2 点与第 3 点之间**
  (第 3 点 1785.53 pF)⇒ 属正常点间抖动,不是沉降不足。
- COSS 绝对值与上一轮不同(3568.8 vs 3393.3 pF):两轮相隔一次关机/接线,**不据此做跨轮比较**,
  本轮只比较**同一轮内的首点/次点连续性**。

### 2.2 逐腿首三点

| 腿 | #1 (0.100 V) | #2 (0.112 V) | #3 (0.126 V) |
|---|---|---|---|
| CISS | Cs 3378.81 pF,D 0.17076 | Cs 3375.22 pF,D 0.17075 | Cs 3370.83 pF,D 0.17046 |
| COSS | Cs 3568.80 pF,D 0.12489 | Cs 3559.53 pF,D 0.12408 | Cs 3535.16 pF,D 0.12434 |
| CRSS | Cs 1749.57 pF,D 1.66031 | Cs 1795.66 pF,D 1.73439 | Cs 1785.53 pF,D 1.71496 |

### 2.3 完整性

| 项 | 结果 |
|---|---|
| 点数 | **180 / 180**(60 点/腿) |
| OTR 非零 | **0 / 180** |
| 三条 `[proto] 换腿后第一点:多等 300 ms …` | **3 / 3**(第 51 / 175 / 305 行) |
| 扫压结束标记 | `[proto] 扫压结束:CRSS,共 60 点已下发到 DAC`(第 428 行) |
| 用户目视评价 | 「**现在好多了**」 |

## 三、两处改动各自的证据强度(别混为一谈)

| 改动 | 证据 | 结论 |
|---|---|---|
| 换腿后首点多等一个驻留 | 三条 `[proto]` 标记 + COSS/CRSS 首点回到与次点同级(0.552 / 0.337 → 1.003 / 0.974) | ✅ **已上板验证** |
| 换腿前先 `bias_apply(0)` 再切继电器 | 代码在运行二进制里,但 `bias_apply()` **不打印日志**,无独立读数 | ⚠️ **代码路径已生效、无独立证据**;若要坐实,需加一行日志并在下一个上电周期验证 |

## 四、产物

| 文件 | md5 |
|---|---|
| `artifacts/20261024_leg_settle_run.log`(本轮 445 行原始日志) | `79f6a1a03065fd8e816ffaf5ca7764e2` |
| `artifacts/20261024_leg_settle_sweep.csv`(180 点逐点表) | `aa855094223627ef8b95052f880e3c4e` |

> 日志截取范围:`/var/log/qrs-ui.log` 第 **3213** 行起(服务启动),到第 3657 行(扫压结束后的触摸操作)。
