dsgmxc/2026_fpga_qrs/(list of files, drawings)

Other design files:
hardware/cv_control_expansion_board.epro
