dsgmxc/2026_fpga_qrs/src/rtl/lcd_display.v

//****************************************Copyright (c)***********************************//
//原子哥在线教学平台：www.yuanzige.com
//技术支持：http://www.openedv.com/forum.php
//淘宝店铺：https://zhengdianyuanzi.tmall.com
//关注微信公众平台微信号："正点原子"，免费获取ZYNQ & FPGA & STM32 & LINUX资料。
//版权所有，盗版必究。
//Copyright(C) 正点原子 2023-2033
//All rights reserved                                  
//----------------------------------------------------------------------------------------
// File name:           lcd_display
// Created by:          正点原子
// Created date:        2025年10月16日14:20:02
// Version:             V1.0
// Descriptions:        LCD显示模块
//
//----------------------------------------------------------------------------------------
//****************************************************************************************//

module lcd_display(
    input                lcd_pclk,    //时钟
    input                rst_n,       //复位，低电平有效
    input        [10:0]  pixel_xpos,  //当前像素点横坐标
    input        [10:0]  pixel_ypos,  //当前像素点纵坐标  
    input        [10:0]  h_disp,      //LCD屏水平分辨率
    input        [10:0]  v_disp,      //LCD屏垂直分辨率       
    output  reg  [23:0]  pixel_data   //像素数据
    );

//parameter define  
parameter WHITE = 24'hFFFFFF;  //白色
parameter BLACK = 24'h000000;  //黑色
parameter RED   = 24'hFF0000;  //红色
parameter GREEN = 24'h00FF00;  //绿色
parameter BLUE  = 24'h0000FF;  //蓝色

//*****************************************************
//**                    main code
//*****************************************************

//根据当前像素点坐标指定当前像素点颜色数据，在屏幕上显示彩条
always @(posedge lcd_pclk or negedge rst_n) begin
    if(!rst_n)
        pixel_data <= BLACK;
    else begin
        if((pixel_xpos >= 11'd0) && (pixel_xpos < h_disp/5*1))
            pixel_data <= WHITE;
        else if((pixel_xpos >= h_disp/5*1) && (pixel_xpos < h_disp/5*2))    
            pixel_data <= BLACK;
        else if((pixel_xpos >= h_disp/5*2) && (pixel_xpos < h_disp/5*3))    
            pixel_data <= RED;   
        else if((pixel_xpos >= h_disp/5*3) && (pixel_xpos < h_disp/5*4))    
            pixel_data <= GREEN;                
        else
            pixel_data <= BLUE; 
    end    
end

endmodule
