dsgmxc/2026_fpga_qrs/src/c_ui/app/pynq_protocol.c

/**
 * @file pynq_protocol.c
 * @brief `display_protocol.h` 的**真实实现** —— 把界面指令变成 PL 寄存器写
 *
 * 取代 `app/_retired/pynq_protocol_stub.c`(那个是空实现,`Request*` 一律返回
 * `false`,屏上每个测量按钮都显示「指令发送失败」)。
 *
 * ────────────────────────────────────────────────────────────────────────
 * 【这一层是什么】
 *   `display_protocol.h` 是**前序的接口,一行没改**。前序它跑在 UART 上,
 *   是一套带 CRC 的帧协议:界面往外发指令,`Process()` 收回来更新界面。
 *   本项目的架构里它对应的是「UI ↔ 测量后端」那条边。
 *
 *   🔴 **本文件实现的是「方案 A」:C 侧直写 AXI 寄存器,不建 IPC。**
 *      理由(2026-10-05 定):
 *        · C 进程**本来就已经** mmap 了 AXI 窗口(`--axi-base`),
 *          `pynq_disp.c` 写 LCD 寄存器走的就是这条路。写偏压只是同一套。
 *        · 走 socket 的对端(`ui_process.py`)现在**没有测量数据可发** ——
 *          DLIA / CORDIC 在 PL 里都还没有(继电器/档位寄存器 2026-10-10
 *          已上板,但界面只**读回显**,不产生"测量数据")。建 IPC 只增加两进程
 *          故障面,不增加能力。
 *        · 文档里 pipe/socket 的定位是「接**测量数据**」,那件事属于 P3–P4。
 *          到那时换掉的是**本文件**,`ui_demo.c` 仍然一行不动。
 * ────────────────────────────────────────────────────────────────────────
 *
 * 【已经真的动硬件的】
 *   · 「偏压设置」/ 点测  → 写 0x14 BIAS_CODE → dac_1220 → 高压级 → 栅极
 *   · 「开始扫压」       → `Process()` 里逐点写 0x14,指数间隔,带驻留时间
 *   · 「停止扫压」       → 停状态机(偏压停在当前点,不回零)
 *   · 「发送复位指令」    → 停扫压 + 偏压归 0 V + **所有测量参数回默认** + 清界面
 *                          (采样率与相位也复 —— 见 RequestReset 的函数头;
 *                           ⛔ **不复 0x84**,DAC 放行权归 Python 侧)
 *   · 上电               → 偏压 0 V(写 0x14);激励频率 / 采样率 / 相位
 *                          由 `MeasureConfig_Init()` 一次下发
 *
 * 🆕 2026-10-06:激励频率(0x80)与采样率+相位(0x88)**不再由本文件写** ——
 *    归 `measure_config.c` 单写。「系统复位」页新增了五档激励频率、
 *    五档采样率、三档相位微调;前序其余四页逐字未动。
 *
 * 【继电器 / 档位(2026-10-10 起有硬件)】
 *   · `0x18 RANGE_SEL` / `0x1C RELAY_CFG` / `0x04 STATUS` 已在位流里,
 *     上板验证通过(见 `docs/project_state.md` 2026-10-10 那一条)。
 *     ⛔ 旧写法「本位流里没有 `relay_ctrl`,`cv_regs.py` 里也没有继电器
 *        寄存器」**作废** —— 那是本次接线之前的实况。
 *   · 🟢 **2026-10-14 起 C 界面是 `0x1C` 的唯一写入方**(用户 2026-10-14 拍板)。
 *     原文是「C 界面本轮只读,写入权归 Python 侧,避免第二个写入方」——
 *     **那条约定没有兑现**:Python 侧根本没有调用方(`main.py` 只 import
 *     `drivers.board`),于是硬件永远停在复位值 `ALL_OFF`。根因与证据表见
 *     `app/relay_view.c` 文件头。
 *   · 现在点「回路」按钮**真的切继电器**(`RelayView_ApplyPath()`);
 *     顶栏那两栏仍然只显示**回读的已生效值**,不显示"用户点了什么"。
 *   · 🟢 **2026-10-15 起 `0x18`(挡位)也由本进程写** —— 测量页新增
 *     A/B/C/D 四颗按钮,走 `DisplayProtocol_RequestGear()` →
 *     `RelayView_ApplyGear()`。原文是「`0x18` 本轮仍只读,挡位不在本次
 *     范围内」,**那句只在 2026-10-14 那一轮的范围内成立**;用户随后
 *     接上了挡位矩阵并要求控制它。
 *     ⇒ 至此 `0x1C` 与 `0x18` **两个寄存器都是本进程独占写**,
 *        `drivers/relay.py` 仍然是没有任何调用方的取证材料。
 * 🆕 2026-10-06:**Cs 读数有了,但不是 DLIA 算的。** 走的是
 *    `adc_sample.c` —— 采 AD9238 缓冲(0x8C/0x90/0x94/0x98)+ C 侧正交解调。
 *    结果页的「单点波形 / 扫压波形」两张图和扫压曲线上的 Cs 都由此来。
 *    ⚠️ **DLIA(`dlia_core` / `cordic_polar`)仍然没做** —— 这是 P3 之前的
 *    替代路径,不是终点。差别在于:软件解调在 PS 上跑,受 `cv_millis()`
 *    调度和 AXI 事务开销限制;**PL 侧 DLIA 才是评分对象**(见 CLAUDE.md §二)。
 *
 * 🆕 **2026-10-14:一次 GO 同时收 INA/INB 两路,相位通了。**
 *    `adc_capture.v` 改成 A 窗、B 窗各写一次(偶地址 A、奇地址 B),
 *    两路来自**同一个 ADC 转换周期** ⇒ 相位相关 ⇒ 能算复数阻抗。
 *
 * ⚠️ **但读数仍然只是"能出数",不是"测得准"**:
 *    · 两路 A/B 通路的**增益与相位失配未标定** —— `Z = R0·(VH−VL)/VL` 的
 *      正确性依赖两路一致,那是 OPEN/SHORT 校准(B8)的活,本轮没做;
 *    · `(A − B)` 相减前**没有相位微调**,两路各按自己的 `PH_OFF` 取点时,
 *      残余的时基偏移会**直接进 Z 的相位**;
 *    · 模拟输入现在**没接**,采到的可能是贴顶的平线 —— 那是**真数据**,
 *      不是画错了。判据:`dump_stats` 的 `ADC 采集 成功/失败` 计数。
 *
 * 🔴 **状态行有字数上限,写长了会被截掉右半边。**
 *    `g_header_operation_label` 在 x=696、宽 `LCD_PIXEL_WIDTH − 706`
 *    = **318 px**、**右对齐**、`ui_font_cn_20`。
 *    🆕 2026-10-10 顶栏由 7 栏加到 8 栏(插了「档位:」),右边六栏的宽度
 *    一起重算过 —— 完整表在 `ui_demo.c::UI_CreateCommonStatusHeader()`。
 *    20 px 字体 ⇒ 一个汉字 20 px、一个半角字符约 10 px。
 *    ⇒ 大约 **15 个汉字**,或"8 汉字 + 10 半角"。**超了从左边开始被吃掉**
 *    (右对齐),用户看到的正好是「状态:…」被啃掉的那种别扭样子。
 *    ⛔ 别再往状态行里塞解释 —— 解释写 `printf`,日志里看得见。
 * ────────────────────────────────────────────────────────────────────────
 *
 * 【为什么写 0x14 就等于"下发到 DAC"】
 *   `cv_axi_lite_slave.v:454` —— 每次对 0x14 的写都会顺带发**一拍**
 *   `cfg_bias_set` 脉冲给 `dac_1220.set_in`。不需要额外的"执行"寄存器。
 *   0x80 对 `adc_9833` 同理(`:455`)。
 *
 *   ⚠️ 但 `dac_1220` 只在 `NORMAL_WAIT` 状态里锁存 `set_in` 的上升沿。
 *      它上电要 200 ms + 自校准才进 `NORMAL_WAIT`,所以上位机**开机第一次**
 *      写偏压如果太早,那一拍会被丢掉。从机里已经补了「等 `dac_init_done`
 *      再发一次上电脉冲」的兜底;`DisplayProtocol_Init()` 里也重写一次,
 *      两次都落在 `init_done` 之后,不必在上位机侧再等。
 *      证据:`cv_axi_lite_slave.v` §set 脉冲。
 *
 * 【回读核对】
 *   每次写偏压后立刻读回 0x14 比对。不一致 ⇒ AXI 通路有问题(地址错、
 *   位流不对、DS 关掉了),这里会打一行 `[proto] ⚠️` 并计数,退出时进
 *   `dump_stats`。**这是判"寄存器写没写进去"最快的证据。**
 */

#include "display_protocol.h"
#include "ui_demo.h"
#include "pynq_regs.h"
/* 🆕 2026-10-06:激励频率 / 采样率 / 相位 归 `measure_config.c` 单写。
 *    本文件原先自己写 0x80,现在改成转发 —— 见下面 `dds_set_hz()` 的说明。 */
#include "measure_config.h"
/* 🆕 2026-10-06:结果页波形的真数据源 —— 读 AD9238 缓冲 + 正交解调。
 *    此前 `UI_Demo_*Waveform*` 没有任何活调用者,扫压的 Cs 是 `demo_capacitance()`
 *    编的模型。现在默认走真实采集,模型只剩 `CV_UI_DEMO=1` 一条退路。 */
#include "adc_sample.h"
/* 🆕 2026-10-10:继电器 / 档位的回显。🔄 2026-10-14:本文件**会写** `0x1C`
 *    (经 `RelayView_ApplyPath()` / `RelayView_ApplyCode()`),不再是只读。
 *    顶栏仍只显示回读真值。见 `relay_view.c` 文件头。 */
#include "relay_view.h"
/* 🆕 2026-10-24:开路/短接/标准板三标准校准。本文件负责"采",数学在
 * calibration.c,界面在 ui_demo.c。 */
#include "calibration.h"
#include "cv_qr_live.h"
#include "anomaly_detect.h"

#include <math.h>
#include <stdio.h>
#include <stdlib.h>
#include <string.h>
#include <unistd.h>         /* access() —— 扫压自动换挡的开关文件,见 SWEEP_AUTO_GEAR_FLAG */

/* ==========================================================================
 * 参数
 * ========================================================================== */

/* 扫压点数。扫压页 X 轴是 log10(V),范围 −1…+2(即 0.1 V … 100 V,见
 * ui_demo.c:38-39),所以**指数间隔**才铺得满整条轴。
 * 60 点 = 3 个数量级上每十倍 20 点,对 C-V 曲线的形状足够;
 * 上限是 ui_demo.h 的 201,留了余量。 */
#define SWEEP_MAX_POINTS       60u

/* 扫压起点。界面只给**终止电压**(`g_ui_sweep_end_tenths`),没有起点控件,
 * 所以起点定死在上限轴左端 0.1 V —— 和界面对偏压的允许下限是同一个值。 */
#define SWEEP_START_VOLTS      0.1f

/* 每点驻留。真扫压要等高压级和被测器件稳定,不能像演示那样一拍一个点。
 * 60 点 × 300 ms ≈ 18 s 一条曲线。可由 `CV_SWEEP_DWELL_MS` 覆盖。 */
#define SWEEP_DWELL_MS_DEF     300u
#define SWEEP_DWELL_MS_MIN     1u
#define SWEEP_DWELL_MS_MAX     10000u

/* 🆕 2026-10-15 扫压自动换挡的迟滞宽度(十倍程),交给 `cv_range_pick()`。
 * 为什么必须有迟滞、0.15 这个数怎么来的 —— 见 `pynq_regs.h::cv_range_pick()`。
 * 一句话:挡位边界恰在相邻两挡正中间,不给迟滞就会在边界附近来回跳。 */
#define SWEEP_GEAR_MARGIN      0.15

/* 🆕 2026-10-23:`VL/VH` 比例判据。**比 `|Z|` 更可信** —— 它是两路解调幅值
 * 直接相除,不经过 `(A−B)/B` 的相消;在 `|Z|` 已经算错(甚至变号)的区间里,
 * 这个比值仍然是对的。
 *
 * 【为什么上界是硬闸,下界只警告】
 *   比例越接近 1,R0 越比 |Z| 大,`A−B` 是两个大数相减:通道增益/相位失配
 *   会被按 `|Z|/R0` 倍放大进实部。2026-10-23 实测同一器件同一 50 V:
 *   B 挡 Re Z = 1.85 kΩ、C 挡 = 17.7 kΩ、D 挡 = 175 kΩ —— **几乎正好 ∝ R0**,
 *   而 Im Z 基本不动(12.5/11.9/9.7 kΩ)。比例 > 0.95 时算出来的 Z 已经不是
 *   器件,而是通道失配的镜像,所以**拒收**。
 *   比例太小只是信噪比差(Cs 靠相干平均仍然稳),不该把高压段整段判没 ⇒
 *   只警告,不置 `z_valid = 0`。
 *
 * 【自动换挡的目标带】
 *   纯电容在 `R0 = |Z|` 时 `VL/VH = 1/√2 ≈ 0.71`;目标带 [0.15, 0.90] 对应
 *   `R0/|Z|` 约 [0.15, 4.4],把两边都留在"最多差一个十倍程"的范围里。
 *   ⚠️ 上界取 0.90 而不是 0.85:0.1 V 附近的 CISS 在 B 挡上就是 0.894
 *   (|Z| ≈ 50 Ω, 100/|100−j50|),那一点是用户实测"问题不大"的,不该被
 *   自动换挡赶去 A 挡。 */
#define CV_VLVH_TARGET_LOW     0.15
#define CV_VLVH_TARGET_HIGH    0.90
#define CV_VLVH_REJECT_HIGH    0.95
#define CV_VLVH_WARN_LOW       0.0015

/* 换挡后核对:同一个器件换一挡,反推的 |Z| 应当基本不变。
 * 2026-10-23 实测 B→C 差 1.76 倍、C→D 差 8.3 倍(而 B→C 那次本身也已偏大)。
 * 阈值 1.5 倍:真曲线在高压段是平的,换挡后跳 1.5 倍只能说明**新挡不可信**。 */
#define SWEEP_GEAR_STEP_RATIO  1.5

/* 🔴 **2026-10-15 起扫压自动换挡默认【关闭】—— 挡位固定,由用户手动选。**
 *
 * 为什么关:接线整理后的一次上板,打开自动换挡跑出来是这样 ——
 *   COSS 腿把挡位从 B 顶到 C,CRSS 腿**继承 C** 再顶到 D;而 **CRSS 恰恰是当时
 *   唯一一条随偏压变化的曲线**,抬到 D 之后出来的是 |Z| = 140 kΩ、Cs 为负、
 *   D = 71 的垃圾(见 `report/measurements/20261015_uilog_*.txt`)。
 *   当时的结论是"判据没错,错的是脚下的 |Z|"。**2026-10-23 修正了一半**:
 *   判据(拿复数 `|Z|` 选挡)也有错 —— 那条 `|Z|` 的实部本身就 ∝ R0,正是
 *   通道失配的镜像(见上面 `CV_VLVH_*` 那段)。现在判据改成由 `VL/VH` 反推,
 *   并加了换挡后核对与"一次只走一挡";**但默认仍然是关**:
 *   参考电阻是否真是挡位标称值,至今没用已知件标定过,而在一个未标定的
 *   比例上做任何自动决策,只是在放大同一个未知量。
 *   ⇒ **四挡已知电阻 + OPEN 标定做完之前,挡位钉死,少一个自变量。**
 *
 * 开关用**文件**不用环境变量:环境变量要重启服务才生效,而 `qrs-ui.service`
 *   重启 = 第二次加载位流(**红线**)。这个文件在 `sweep_start()` 时读,随时可改:
 *       sudo touch /home/xilinx/sweep_auto_gear     # 打开自动换挡
 *       sudo rm    /home/xilinx/sweep_auto_gear     # 关闭(默认)
 * ⚠️ 两种模式在 `sweep_start()` 的日志里都会明说,事后对日志不会有歧义。 */
#define SWEEP_AUTO_GEAR_FLAG    "/home/xilinx/sweep_auto_gear"

/* 激励频率与采样率**不在这里定义** —— 归 `measure_config.h` / `pynq_regs.h`。
 * 本文件只负责"什么时候下发",不负责"下发什么值"。 */

/* 扫压页要用的点数与驻留见上;激励频率的默认值 = `CV_DDS_HZ_DEFAULT`(1 MHz,决策 D08)。 */

/* ==========================================================================
 * 状态
 * ========================================================================== */

static int      s_demo_enabled;         /* CV_UI_DEMO=1:叠加模型读数 */
static uint32_t s_dwell_ms;

static uint32_t s_sweep_active;
static uint32_t s_sweep_mask;           /* bit0..2 = CISS/COSS/CRSS,【要跑哪几条腿】 */
static uint32_t s_sweep_leg;            /* 🆕 【当前正在跑的那条腿】(0..2);mask 里可能有多条 */
static float    s_sweep_stop_volts;
static uint32_t s_sweep_total;
static uint32_t s_sweep_index;          /* 已下发的点数(1 起) */
static uint32_t s_sweep_next_ms;
static float    s_bias_volts;           /* 最后一次真正下发的偏压(量化后的真值) */

/* 🆕 2026-10-24:换腿后的**第一点**要多等一个驻留再采。
 *
 * 实测(60 点/腿、三腿连扫、驻留 300 ms):第 2/3 腿的第 1 点(0.100 V)总是
 * **偏低**,第 2 点(0.112 V)就正常;而**只扫单腿**时第 1 点完全正常。
 * 两条对照把原因夹死了:
 *   · 三腿连扫 vs 单腿 —— 同样的继电器切换,后者正常 ⇒ **不是继电器**;
 *   · "0.1 V → 0.1 V,1 点/腿"那轮(每腿只有一点、上一腿从没上过高压)三腿
 *     **全部正常** ⇒ 也不是"换腿"本身,而是**上一腿最后一点停在 100 V**。
 * ⇒ 换腿时高压级要从 100 V 降回 0.1 V,300 ms 驻留不够(第 1 点采到的是
 *   还在路上的偏压,|Z| 偏大 ⇒ C 偏小 ⇒ 曲线开头看起来"陡升")。
 * ⇒ 换腿后的第一点给**两个驻留**:先下发偏压、空等一个驻留,再按原节奏采。
 *    代价 = 每条腿 +`s_dwell_ms`(三腿一轮 +0.9 s),相对 54 s 可忽略。
 *
 * 📐 **为什么"多等一个"而不是随便给个更长的数**:老代码里同一条腿的**第 2 点**
 *    是在 0.1 V 下发后 600 ms 采的(= 第 1 点的 300 ms 又加一个驻留),
 *    而它**一直是对的**(COSS 3393 pF、CRSS 1700 pF,与第 3 点一致)。
 *    ⇒ 600 ms 这条线是**实测已经证明够用**的;本改动就是把第 1 点挪到这条线上,
 *      不是拍脑袋加时间,也不是"越长越好"。 */
static uint32_t s_leg_settle_pending;

/* 🆕 2026-10-15:自动换挡**这一轮已被关掉**(换失败了,或非独热码)。
 * ⚠️ 必须是粘滞的:判据是确定性的,失败后每一点都会算同一个"该换"的结论,
 *    不粘滞就会**每 300 ms 重试一次并弹一次框**,把扫压搅成一片报错。 */
static uint32_t s_auto_gear_off;

/* 🆕 2026-10-23:换挡后的**核对状态**。
 *   换了挡之后,下一点要拿新挡反推的 |Z| 与换挡前那个比一比 —— 同一个器件、
 *   相邻两个偏压点,|Z| 不该差出 1.5 倍。对不上就说明**新挡按标称 R0 算不出来**
 *   (2026-10-23 实测 D 挡:B 挡 12.6 kΩ → D 挡 185 kΩ),回退并关掉本轮自动换挡。 */
static uint32_t s_gear_probe_pending;   /* 1 = 上一点刚换过挡,本点要核对       */
static uint32_t s_gear_probe_prev;      /* 换挡前的挡位(回退目标)               */
static double   s_gear_probe_z;         /* 换挡前由比例反推的 |Z|(Ω)            */
static uint32_t s_gear_limit_logged;    /* 已经到 A/D 端仍不匹配时只喊一次      */

/* ---- 校准采集状态机(🆕 2026-10-24) ----------------------------------
 * 一次采集 = 4 条腿 × 4 个挡位 = 16 点。
 * 🔴 **2026-10-29 纠错**:原来这里写「挡位切换是当拍生效的」—— **只对寄存器成立**。
 *    量程 A/B/C/D 是继电器矩阵板上的**继电器**(`hardware/README.md`:
 *    「CISS / COSS / CRSS 回路与量程切换」),`0x18` 写进去当拍变的是 `gear_reg`,
 *    触点还要几毫秒才翻。不等待就采,测到的是**上一挡的触点状态**,
 *    而 Z 却按新挡的 R0 算 ⇒ 相邻挡差 10 倍。
 *    实测证据(`LOAD2` 那一轮):CISS 四个挡的 −Im 是 7.58 / 737 / 758 / 794 Ω,
 *    而同一个器件的真值只有 **75.8 Ω** —— 逐行正好对应「B / A / B / C」,
 *    即每个点都慢了**一行**。⇒ 现在换挡后也等 `s_dwell_ms` 再采。
 * ⚠️ `s_cal_capture_active` 在采集中为 1:
 *   ① 让 `adc_capture_pair_once()` **跳过 >95% 的挡位硬闸**
 *      (短接 / 开路本来就会被那个闸判"无读数",校准必须拿到原始数);
 *   ② 让本文件**不应用**校准(采的是原始 M_o/M_s/M_L)。
 */
static uint32_t s_cal_capture_active;
static uint32_t s_cal_active;           /* 1 = 正在跑一轮采集               */
static uint32_t s_cal_std;              /* CalStandard                      */
static uint32_t s_cal_leg;              /* 0..3                             */
static uint32_t s_cal_gear;             /* 0..3                             */
static uint32_t s_cal_done;             /* 已完成点数(0..16)               */
static uint32_t s_cal_ok;
static uint32_t s_cal_bad;
static uint32_t s_cal_due_ms;
static uint32_t s_cal_leg_started;      /* 本腿继电器是否已切到目标          */
static uint32_t s_cal_gear_armed;       /* 本点挡位已切、正在等触点稳定      */
/* 80 字节装不下中文:每个汉字 3 字节,进度条那行最长的一句约 200 字节
 * (2026-10-27 加两负载提示时 -Wformat-truncation 当场报出来)。
 * UI 的进度标签宽 960 px,256 字节按 20 号字算约 800 px,放得下。 */
static char     s_cal_text[256];        /* 给界面的一行状态                  */

/* 🔴 扫压自动换挡的**总开关**(与上面那个粘滞位不同:这个是用户意图,那是失败状态)。
 *    默认关 —— 理由与开关文件路径见 `SWEEP_AUTO_GEAR_FLAG` 的注释。
 *    ⚠️ 每次 `sweep_start()` 现读,不缓存:这样"改文件 → 下一场扫压"就生效,
 *       不必重启服务(重启 = 第二次加载位流,红线)。 */
static int sweep_auto_gear_enabled(void)
{
    return access(SWEEP_AUTO_GEAR_FLAG, F_OK) == 0;
}

/* 当前激励频率下的校准状态:0 = 没有可用校准点,1 = 部分(有拟合点但不满
 * 4 腿 × 4 挡),2 = 16 点全有。
 * ⚠️ 界面与日志都必须用它说「已校准 / 未标定」:
 *    2026-10-29 上电抓帧发现,校准文件明明载入了 16/48(1 MHz 全亮),
 *    顶栏却还写「Cs/Cp/D 未标定」—— 与 `[cal] 已载入…拟合 16/48` 自相矛盾,
 *    而异常检测的中心正是按「已校准」的读数建的。 */
static uint32_t cal_state_at_current_freq(void)
{
    int32_t  fi;
    uint32_t fitted;

    if (!Calibration_IsEnabled()) {
        return 0u;
    }
    fi = Calibration_FreqIndex(MeasureConfig_GetDdsHz());
    if (fi < 0) {
        return 0u;
    }
    fitted = Calibration_FittedCount((uint32_t)fi);
    if (fitted == 0u) {
        return 0u;
    }
    /* 🆕 2026-10-29:校准改成**通道级**(按挡位/频率)后,"16 个点都存了"
     * 不再等于"当前挡位能用"。A 挡的两块标准板(80–150 Ω)对 10 Ω 挡全是
     * 外推,1 MHz 下 |b|/R0 最小也有 0.56 ⇒ 判不可校正、原样出原始值。
     * 这种挡位只能说"部分校准",不能说"已校准"。 */
    if (!Calibration_ChannelAvailable(cv_reg_read(CV_REG_RANGE_SEL) &
                                      CV_RANGE_MASK,
                                      MeasureConfig_GetDdsHz())) {
        return 1u;
    }
    return (fitted >= (CAL_LEG_COUNT * CAL_GEAR_COUNT)) ? 2u : 1u;
}

static const char *cal_state_text(void)
{
    static const char *const texts[3] = {"未标定", "部分校准", "已校准"};

    return texts[cal_state_at_current_freq()];
}

static uint32_t s_demo_auto_page;       /* CV_UI_DEMO_PAGE:跑完切到这一页 */
static uint32_t s_demo_auto_stage;

/* 统计(排障用;不在 display_protocol.h 里 —— 那是前序的接口) */
static uint32_t s_cmd_total;            /* 收到的指令总数             */
static uint32_t s_readback_pending;     /* 要读数、但读不到的指令数   */
static uint32_t s_path_cmds;            /* 回路按钮点击次数(只读)  */
static uint32_t s_bias_writes;          /* 写 0x14 的次数             */
static uint32_t s_bias_verify_fail;     /* 回读与写入不一致的次数     */
static int      s_verify_notice;        /* 回读失败提示只打一次       */
static int      s_dac_rst_notice;       /* "DAC 还没放行"提示只打一次 */

/* ==========================================================================
 * ADC 采集(结果页波形的数据源)
 *
 * 【两路怎么来的】
 *   `adc_capture.v`:`adc_clk = (cnt < P/2)`,刻度 `tick = cnt − P/2`。
 *   ⇒ **两路不是一个"眼"的两端,是两个时间槽**:port A = INA 窗 `[2−P/2,+1]`
 *      (中心 `1.5−P/4`)、port B = INB 窗 `[+2,P/2+1]`(中心 `1.5+P/4`)。
 *      ⚠️ 用户口径的「上升沿=通道 a / 下降沿=通道 b」**正好是反的**,见 `adc_capture_pair()`。
 *
 * 🟢 **2026-10-14 起:一次 GO 同时收下 A 和 B**(RTL 已改,见 `adc_capture.v` ④):
 *    同一个 ADC 转换沿产生的那一对字,现在各写各的缓冲 —— 偶地址给 A、奇地址给 B,
 *    **同一次 GO、同一个转换周期** ⇒ **两路相位相关**,可以算阻抗。
 *
 * 🔴 **原稿这一段是反的,保留一句以免旧结论被当成现状**:原文写
 *    「一次 GO 只锁一个刻度 ⇒ 两路靠两次采集」「两路的相位不相关,只能比幅值」,
 *    那是 2026-10-14 之前的形态。相位原点不同 ⇒ Cp / D 只能填 `--`。
 *    **本轮把这条路打通了**,现在 `Cs / Cp / D / Rg` 都从同一个复数 Z 出。
 * ========================================================================== */

/** 单点测量:bias_apply 之后等多久再采。复用扫压的驻留时间 —— 那是本项目
 *  对"高压级 + 被测件稳定下来要多久"的唯一口径,不另立一个数。 */
#define POINT_SETTLE_MS_DEF   300u

typedef struct
{
    float      mag_a_v;     /* 通道 A(INA = VH)解调幅值,伏 —— 未标定 */
    float      mag_b_v;     /* 通道 B(INB = VL)解调幅值,伏 —— 未标定 */
    double     vl_vh;       /* 🆕 VL/VH(B 路参考电阻电压 / A 路总激励)。
                             *    挡位是否匹配的直接判据,见 CV_VLVH_* 常数。 */
    AdcSampleZ z;           /* 🆕 复数阻抗及其派生量(Cs / Cp / D / 电流)   */
    uint32_t   gear;        /* 🆕 本次读到的 0x18 原始码(挡位是谁说了算)   */
    double     r0_ohm;      /* 🆕 本次用的参考电阻 = 挡位电阻(回读换算)     */
    float      pp_a;        /* 通道 A 峰峰值,ADC 码(排障:输入有没有信号)  */
    float      pp_b;        /* 通道 B 峰峰值,ADC 码 */
    float      mag_a_codes; /* 🆕 通道 A 解调幅值,**码**(自洽判据要的就是它)   */
    float      mag_b_codes; /* 🆕 通道 B 解调幅值,**码**                        */
    uint32_t   otr;         /* 两路 OTR 置起的字数合计 */
    uint32_t   z_valid;     /* 🆕 1 = `z` 是本次算出来的;0 = 保留上一次的值 */
    uint32_t   fresh;       /* 🆕 1 = 本点的幅值/比例是这一次采的(不是上一点的残留)。
                             *    自动换挡据此判断"能不能拿这组数做决定"。      */
    uint32_t   tries;       /* 🆕 本点连采了几次才自洽(1 = 一次就对)            */
    /* 🆕 2026-10-24:校准。`z` 在应用校准后是**已修正**的值;
     *    `calibrated` 说明 `z` 是不是修正过的,`z_raw_*` 留一份原始值写日志。 */
    uint32_t   calibrated;
    double     z_raw_re_ohm;
    double     z_raw_im_ohm;
} AdcPair;

static uint32_t s_code_a[ADC_SAMPLE_POINTS];
static uint32_t s_code_b[ADC_SAMPLE_POINTS];
static AdcPair  s_pair;

/* 🆕 自洽判据的账本(2026-10-15)。`s_adc_points` 数的是"实际采了几次",
 * 这两个数的是"其中被拒了几次 / 有几个点靠重采才救回来"。
 * 出问题时看这三个数的比值就知道毛刺有多勤 —— 比翻日志快。 */
static uint32_t s_adc_rej;          /* 被自洽判据拒掉的采集次数 */
static uint32_t s_adc_rescued;      /* 靠重采救回来的点数(第一次就被拒的那些) */
static uint32_t s_adc_void;         /* 连采满仍不自洽、判无读数的点数 */
/* 一次测量最多采几次。默认 `ADC_SAMPLE_TRIES_MAX`,可用 `CV_ADC_TRIES` 覆盖
 * (设 1 = 关掉重采,退回旧行为 —— 用来 A/B 对照验证本判据确实在起作用)。 */
static uint32_t s_adc_tries_max = ADC_SAMPLE_TRIES_MAX;

/** 本次采集**是在哪条腿上**做的(0/1/2/3 = CISS/COSS/CRSS/RG)。
 *  只用于日志 —— 出问题时第一句话是"这是在哪一路采的"。
 *  由 `sweep_start()` / 单点排程在切完继电器之后设置。 */
static uint32_t s_pair_path;

static uint32_t s_adc_points;       /* 一轮总共采了多少次(统计) */
static uint32_t s_adc_fail;         /* 采集/解调失败次数       */
static int      s_adc_notice;       /* 失败提示只打一次        */

/* 单点测量:请求 → 等偏压稳定 → 采 → 报结果 */
static uint32_t s_point_pending;
static uint32_t s_point_due_ms;
static uint32_t s_point_path;
static uint32_t s_point_volts_x10;
static uint32_t s_point_all;        /* 1 = 「CISS+COSS+CRSS」→ **三腿序列** */
static uint32_t s_point_leg;        /* 🆕 当前腿(0..3);`all=1` 时 0→1→2 依次走 */
static uint32_t s_point_leg_n;      /* 🆕 总腿数:1(单路)或 3(「全部」) */

/* ==========================================================================
 * 小工具
 * ========================================================================== */

static const char *path_name(uint32_t path)
{
    static const char *const names[] = {"CISS", "COSS", "CRSS", "RG"};

    return (path < 4u) ? names[path] : "?";
}

/**
 * @brief 挡位编号 → 名字(2026-10-15 加)。
 *
 * ⚠️ 与 `relay_view.c` 里那个 `range_name()` **是两份** —— 那个是 `static`,
 *    且它的输入是**独热码**(`0x1/0x2/0x4/0x8`),本函数的输入是**下标**(0..3)。
 *    ⛔ 别把两者接错:传独热码进来会得到 `CV_RANGE_B(2) → "C"`,错一位且不报。
 *    名字带 R0 而不只是挡号 —— 用户看到的"A/B/C/D"本身不带信息量,
 *    R0 才是它在算式里的含义(`Z = R0·(VH−VL)/VL`)。
 */
static const char *gear_name(uint32_t index)
{
    static const char *const names[] = {"A(10Ω)", "B(100Ω)", "C(1kΩ)", "D(10kΩ)"};

    return (index < 4u) ? names[index] : "?";
}

/**
 * @brief 写偏压码,并**回读核对**。
 *
 * 这一次写会顺带触发 `cfg_bias_set` 一拍脉冲(见文件头),所以返回 0
 * 就意味着"DAC 已经收到新码",不需要额外的启动动作。
 *
 * @param code 20 位偏压码(0x80000 = 0 V)
 * @return 0 回读一致;1 回读不一致(AXI 通路可疑)
 */
static uint32_t bias_write_code(uint32_t code)
{
    uint32_t back;

    cv_reg_write(CV_REG_BIAS_CODE, code);
    s_bias_writes++;
    s_bias_volts = cv_bias_code_to_volts(code);

    back = cv_reg_read(CV_REG_BIAS_CODE);
    if (back != code) {
        s_bias_verify_fail++;
        if (!s_verify_notice) {
            s_verify_notice = 1;
            fprintf(stderr,
                    "[proto] ⚠️ 偏压回读不一致:写 0x%05X,读回 0x%05X\n"
                    "        ⇒ AXI 通路有问题。依次查:\n"
                    "          ① --axi-base 是不是 0x43C00000;\n"
                    "          ② 位流是不是含 DAC/DDS 那一版(board/qrs.bit);\n"
                    "          ③ 读 0x64(显示状态)有没有值 —— 全 0 说明压根没通。\n",
                    (unsigned)code, (unsigned)back);
        }
        return 1u;
    }

    /* 回读一致 ≠ DAC 真的收到了 —— 还得看初始化放行了没有。
     * ⚠️ **只读不写**:放行权归 Python 侧独占(见 pynq_regs.h 的 CV_CTRL 段),
     *    这里只负责把"还没放行"喊出来。不喊的话,现象就是
     *    "界面上偏压从 0.1 V 调到 5.0 V、寄存器也回读正常,**而 DAC 输出不动**"
     *    —— 2026-10-05 就是这个现象,查了很久。 */
    if ((cv_reg_read(CV_REG_CV_CTRL) & CV_CTRL_DAC_RST_N) == 0u) {
        if (!s_dac_rst_notice) {
            s_dac_rst_notice = 1;
            fprintf(stderr,
                    "[proto] 🔴 0x84[0] = 0 ⇒ **dac_1220 仍被按在复位态**,"
                    "初始化没跑。\n"
                    "        偏压码会被硬件收下(回读正常),但**不会到达 DAC 输出**,\n"
                    "        输出会一直停在芯片默认的 −10 V。\n"
                    "        ⇒ 放行必须在 FCLK0 补到 50 MHz **之后**做(该窗口\n"
                    "           [46.1, 54.0] MHz 很窄,开机默认 27.78 在外),\n"
                    "           正常路径是跑 main.py —— 它在本步之前已调过\n"
                    "           drivers/board.release_dac()。\n");
        }
    }

    return 0u;
}

/** @brief 把偏压写进表头的「偏压:」一栏(界面初始化值是 0.1V,这里给真值)。 */
static void bias_announce(float volts)
{
    char text[16];

    /* 两位小数:扫压低压段的相邻点只差几毫伏,一位小数会显示成同一串 */
    (void)snprintf(text, sizeof(text), "%.2fV", (double)volts);
    UI_Demo_SetActualBias(text);
}

/**
 * @brief 下发一个偏压:**全精度换算 → 写 → 回读核对 → 报回界面**。
 *
 * ⚠️ 显示的是**写完之后回算的值**(`s_bias_volts`),不是请求值 ——
 *    这样界面上看到的永远是 DAC 真正拿到的那个电压。
 *
 * @return 0 回读一致;1 回读不一致。原先返回 void,2026-10-06 改成返回状态:
 *         「所有参数恢复默认」的成败要如实上报,偏压也是"所有参数"之一。
 */
static uint32_t bias_apply(float volts)
{
    uint32_t err = bias_write_code(cv_bias_volts_to_code(volts));

    bias_announce(s_bias_volts);
    return err;
}

/* ⛔ 这里原先有个 `dds_set_hz()` 自己写 `0x80`(当时的注释是「界面上没有频率控件」)。
 *    🔄 2026-10-06 用户明确要求把频率接口引出来 ⇒「系统复位」页加了
 *    五档激励频率 + 五档采样率按钮,前序其余四页仍逐字未动。
 *    **写入方必须唯一**:`0x80`/`0x88` 现在只由 `measure_config.c` 写,
 *    本文件不再直接碰这两个寄存器(两个写入方 = "谁最后写谁赢"的经典 bug)。
 *    ⇒ 这个空壳包装没有调用点了,已删除;要设激励频率请调
 *      `MeasureConfig_SetDdsHz()`。 */

/* ==========================================================================
 * ADC 采集 —— 结果页波形的真数据源
 * ========================================================================== */

/** @brief 采集/解调失败的提示(只打一次,免得扫压时刷 60 行)。 */
static void adc_report_failure(const char *where)
{
    s_adc_fail++;
    if (s_adc_notice) {
        return;
    }
    s_adc_notice = 1;
    fprintf(stderr,
            "[adc] 🔴 %s:采集或解调失败 —— %s\n"
            "      ⚠️ 此后不再重复打印这一条。\n"
            "      ⇒ 依次查:\n"
            "         ① 位流是不是含 0x88–0x98 的那一版;\n"
            "         ② 0x90[0] mmcm_locked 是不是 1(没锁就是 MMCM 没起来);\n"
            "         ③ 采样率档位是不是太低 —— 每周期点数 < %u 时本层**拒绝解调**\n"
            "            (N=2 正好在 Nyquist 上、N=1 混叠到 DC,算出来是噪声);\n"
            "         ④ 冒烟看 [adc] 那行的「峰峰」—— 个位数说明输入没信号。\n",
            where, AdcSample_LastError(), (unsigned)ADC_SAMPLE_DEMOD_MIN_N);
}

/** @brief 采**一对**(A = INA = VH / B = INB = VL)并解调。结果进 `s_pair` / `s_code_*`。
 *
 *  🔴 **一次 GO 收齐两路(2026-10-14 改)。** 原文是"先 PushPhase(A 窗中心)采 INA,
 *     再 PushPhase(B 窗中心)采 INB"—— 两次 GO 之间隔着一万多个转换周期,而解调
 *     基准锚在**各次采集的第 0 点**,⇒ 两路相位差**随机**,只能比幅值。
 *     现在 `adc_capture.v` 在 A 窗、B 窗各命中一次(RTL 按 B = A + P/2 自推),
 *     两路来自**同一个转换周期** ⇒ 同一个相位参考系,复数除法成立。
 *     **软件侧一个时间改正都不加** —— 硬件上本来就没有时间差。
 *
 *  ⚠️ `tick_a` 只是"软件以为 A 在哪";B 的刻度是**硬件**算的,这里用
 *     `AdcSample_PortBTickHw()` 把它复算一遍**只为日志**(排障时判断
 *     "硬件那一版是不是还在数据窗里")。⛔ 不要拿它去修正相位。
 *
 * 🔴 **2026-10-15 起本函数只负责"采一次"** —— 对外的入口是下面的
 *    `adc_capture_pair()`,它按自洽判据重采。**不要直接调本函数。** */
static bool adc_capture_pair_once(void)
{
    uint32_t div    = MeasureConfig_GetSampleDiv();
    uint32_t fs_hz  = cv_adc_sample_hz(div);
    uint32_t fe_hz  = MeasureConfig_GetDdsHz();
    /* 🔴 **按"时间槽窗口中心"取刻度,不是按上升沿/下降沿。** 那 12 位总线是
     *    双端口时分复用:port A = INA 窗 `[2−P/2,+1]`(中心 `1.5−P/4`)、
     *    port B = INB 窗 `[+2,P/2+1]`(中心 `1.5+P/4`)。用户口径说的
     *    「上升沿=通道 a、下降沿=通道 b」**正好是反的**(tick −P/2 落在 B 窗、
     *    tick 0 落在 A 窗),而且都贴窗沿。见 `adc_sample.h` 文件头与 `LLM-045` §G。
     *
     * 🆕 **两个刻度现在都在 `AdcSample_CapturePair()` 内部算**(A 由
     *    `AdcSample_PortATick()`、B 由 RTL 同款折叠规则),这里不再自己算一份 ——
     *    算两份等于留一个"哪天改了忘记同步"的口子。日志里要打的那份由
     *    `adc_log_pair()` 现算,同样是查表式的纯函数,不会漂。 */
    float    ia, qa, ib, qb;
    float    mag_a_codes, mag_b_codes;
    uint32_t otr_n = 0u;
    uint32_t i;
    uint32_t min_a, max_a, min_b, max_b;
    uint32_t path = s_pair_path;                     /* 本次测的是哪条腿 */

    /* 🔴 **参考电阻 R0 每次现读 0x18**,不硬编码、不缓存 ——
     *    挡位一变,Rg / Cs / Cp / 电流会**同时**错。见 `cv_range_ohms()`。
     *    🆕 2026-10-15 起挡位**真的会变**了(测量页 A/B/C/D 四颗按钮 →
     *    `DisplayProtocol_RequestGear()`),所以"必须现读"从"纪律"变成了
     *    "事实":写死一个常数现在会**当场**出错数,不再是"将来某天"。
     *    ⚠️ 读到的可能是**上一次写失败**遗留的旧挡 —— 判据在同一函数下面的
     *    `[adc]` 日志行:它把 `R0` 与挡位码一并打出来,事后对得上。 */
    s_pair.gear   = cv_reg_read(CV_REG_RANGE_SEL) & CV_RANGE_MASK;
    s_pair.r0_ohm = cv_range_ohms(s_pair.gear);
    /* 🆕 本函数一旦中途失败,`s_pair` 里的幅值仍是**上一点**的 ——
     *    自动换挡不能拿它做决定,所以先清 fresh,成功解调后再置 1。 */
    s_pair.fresh  = 0u;
    s_pair.calibrated = 0u;
    s_pair.z_raw_re_ohm = 0.0;
    s_pair.z_raw_im_ohm = 0.0;

    /* ① 采一对。刻度合法性检查在 `AdcSample_CapturePair()` 内部(它才知道 DIV)。 */
    if (!AdcSample_CapturePair(s_code_a, s_code_b, &otr_n)) {
        return false;
    }

    /* ② 一路一路解调 —— 参考表是**同一条**(同一个 (m,l)),所以两路天然同相。 */
    if (!AdcSample_Demodulate(s_code_a, ADC_SAMPLE_POINTS, fs_hz, fe_hz,
                              &ia, &qa, &mag_a_codes)) {
        return false;
    }
    if (!AdcSample_Demodulate(s_code_b, ADC_SAMPLE_POINTS, fs_hz, fe_hz,
                              &ib, &qb, &mag_b_codes)) {
        return false;
    }

    /* 峰峰值只进日志 —— 它是"输入到底有没有信号"最快的判据 */
    min_a = max_a = s_code_a[0];
    min_b = max_b = s_code_b[0];
    for (i = 1u; i < ADC_SAMPLE_POINTS; ++i) {
        if (s_code_a[i] < min_a) { min_a = s_code_a[i]; }
        if (s_code_a[i] > max_a) { max_a = s_code_a[i]; }
        if (s_code_b[i] < min_b) { min_b = s_code_b[i]; }
        if (s_code_b[i] > max_b) { max_b = s_code_b[i]; }
    }

    s_pair.mag_a_codes = mag_a_codes;       /* 🆕 码,不是伏 —— 自洽判据用 */
    s_pair.mag_b_codes = mag_b_codes;
    s_pair.mag_a_v = AdcSample_CodesToVolts(mag_a_codes);
    s_pair.mag_b_v = AdcSample_CodesToVolts(mag_b_codes);
    /* 🆕 2026-10-23:比例直接由两路解调幅值相除得到 —— **不经过 Z**。
     *    A 为 0 时置 0(阻抗本来就算不出来,下面不会再往下走)。 */
    s_pair.vl_vh = (s_pair.mag_a_v > 0.0f)
                 ? ((double)s_pair.mag_b_v / (double)s_pair.mag_a_v)
                 : 0.0;
    s_pair.fresh = 1u;          /* 两路幅值都是本次采的,比例可以拿去选挡了 */
    s_pair.pp_a    = (float)(max_a - min_a);
    s_pair.pp_b    = (float)(max_b - min_b);
    s_pair.otr     = otr_n;
    s_pair.tries   = 1u;                    /* 由 `adc_capture_pair()` 累加 */

    /* ③ 复数阻抗 —— 这是本次改动的**目的**:Cs 不再靠"纯电容"近似,
     *    Cp / D 也从"算不出来"变成算得出来。
     *    ⚠️ 算不出来时**保留上一次的值**并把 `z_valid` 置 0,不写 0 ——
     *       0 会一路画成一条贴着横轴的曲线,看着像"电容很小",那是假数据。 */
    s_pair.z_valid = AdcSample_Impedance(ia, qa, ib, qb,
                                         s_pair.r0_ohm, fe_hz, &s_pair.z) ? 1u : 0u;
    if (!s_pair.z_valid) {
        /* 阻抗算不出来**不等于采集失败** —— 两路的幅值、波形都是真的,
         * 仍然要喂给波形页。所以这里不 return false,由调用方看 z_valid。 */
        fprintf(stderr, "[adc] ⚠️ %s 这一点算不出阻抗:%s\n",
                path_name(path), AdcSample_LastError());
    }

    /* 🆕 2026-10-23:**挡位过大硬闸。**
     *   比例接近 1 ⇒ `A−B` 是两个大数相减,R0 的失配(增益/相位)被按
     *   `|Z|/R0` 倍放大 ⇒ Re Z 几乎正比于 R0、Im Z 可能变号(Cs 负)。
     *   这不是器件行为,是量程错配;把这一点**判无读数**比往曲线上塞一个
     *   负电容好。⚠️ 只在 `z_valid` 时判 —— 阻抗本来就失败的,原因已打过。 */
    /* 🔴 校准采集**必须绕过这道闸**:短接的 VL/VH ≈ 1(必然 >95%)、开路虽然
     *    比例很小但也是"标准点",两者都不是"挡位错配"。绕过只影响本次采集的
     *    判定,**不改任何测量值**;校准结束后下一拍照常按原判据走。 */
    if (!s_cal_capture_active &&
        s_pair.z_valid && (s_pair.vl_vh > CV_VLVH_REJECT_HIGH)) {
        double z_app = 0.0;

        if (s_pair.vl_vh < 1.0) {
            z_app = s_pair.r0_ohm *
                    sqrt((1.0 / (s_pair.vl_vh * s_pair.vl_vh)) - 1.0);
        }
        s_pair.z_valid = 0u;
        printf("[adc] ⛔ %s 挡位不匹配:VL/VH = %.2f%%(R0 = %.0f Ω)",
               path_name(path), 100.0 * s_pair.vl_vh, s_pair.r0_ohm);
        if (z_app > 0.0) {
            uint32_t sug = cv_range_pick(z_app, s_pair.gear, 0.0);

            printf(",由比例反推 |Z| ≈ %.0f Ω ⇒ 建议 %.0f Ω 挡", z_app,
                   cv_range_ohms(sug));
        }
        printf("。\n        A−B 已相消,实部是通道失配的镜像(实测 Re Z ∝ R0),"
               "本点判无读数 —— 换低挡再看。\n");
    }
    if (s_pair.z_valid && !s_cal_capture_active &&
        (s_pair.vl_vh < CV_VLVH_WARN_LOW)) {
        printf("[adc] ⚠️ %s VL/VH 只有 %.3f%%(B 路已接近噪声底)。"
               "Cs 靠相干平均仍可看,**D/Cp 不可信**;能换高挡就换。\n",
               path_name(path), 100.0 * s_pair.vl_vh);
    }

    /* 🆕 2026-10-24:应用三标准校准。
     *   · 校准采集中**不应用**(采的必须是原始 M_o/M_s/M_L);
     *   · 没校准 / 该点未拟合 / 反演退化 ⇒ 原样保留,`calibrated = 0`;
     *   · 修正后 Cs/Cp/D **必须重算**(同一个 Z 出三个量,见 adc_sample.h)。
     * ⚠️ 硬闸在**修正之前**判 —— 它判的是"这个测点本身能不能信",
     *    校准只能修系统误差,不能把一次 A−B 相消的坏测点变成好测点。 */
    if (s_pair.z_valid && !s_cal_capture_active) {
        double zr = 0.0;
        double zi = 0.0;

        if (Calibration_Apply(path, s_pair.gear, fe_hz,
                              s_pair.z.z_re_ohm, s_pair.z.z_im_ohm,
                              &zr, &zi)) {
            s_pair.z_raw_re_ohm = s_pair.z.z_re_ohm;
            s_pair.z_raw_im_ohm = s_pair.z.z_im_ohm;
            s_pair.z.z_re_ohm = zr;
            s_pair.z.z_im_ohm = zi;
            AdcSample_DeriveFromZ(&s_pair.z, fe_hz);
            s_pair.calibrated = 1u;
        }
    }

    s_adc_points++;
    return true;
}

/**
 * @brief 采一对,**直到这一次采集自洽为止**(2026-10-15 新增)。
 *
 * 【为什么是"重采"而不是"多采几次取中位数"】
 *   CRSS 高压端的尖峰不是"读数有噪声",是**整次采集里混进了坏样本**:
 *   同一个缓冲里,`幅值` 反推的峰峰是 27 码,而 `峰峰` 是 2588 码 —— **94 倍**。
 *   这种点**整次都错**,N 次取中位数会让"错的多数"赢 ⇒ **中位数治不了它**。
 *   有效的问法是先问"这一次算不算数"(判据见 `AdcSample_PpConsistent`),
 *   不算数就**换一次重采**。这是用户口径「多测几次取合理值」的正确形态:
 *   **"合理"由一条物理不变式定义,不由投票定义。**
 *
 * 【重采真的有用吗 —— 实测过】
 *   日志里同一偏压连测 ≥4 次的 **63 组,全部是"有时标、有时不标"**,
 *   **"次次都标"一组都没有** ⇒ 毛刺在同一点上不是恒定的,重采能救。
 *
 * 【返回值的语义(与 `_once` 一致 ⇒ 调用方一行都不用改)】
 *   · false = 采集/解调本身失败(MMCM 没锁 / done 超时 / 窗长不合法…)
 *             —— 重采救不了,直接上报。
 *   · true  = 采到了,再看 `s_pair.z_valid`:
 *              1 → 读数可用;0 → **本点判无读数**(曲线断一格,不填假值)。
 *
 * ⚠️ **判无读数时两路幅值与波形仍是那一次(坏)采集的真实内容** ——
 *    不清成 0:0 会画成一条贴着横轴的曲线,看着像"电容很小",那是**假数据**。
 *    日志里那行 ⛔ 会说明这一点。
 */
static bool adc_capture_pair(void)
{
    uint32_t k;

    for (k = 0u; k < s_adc_tries_max; ++k) {
        float ratio_a = 0.0f;
        float ratio_b = 0.0f;
        bool  ok_a;
        bool  ok_b;

        if (!adc_capture_pair_once()) {
            return false;                       /* 采集/解调失败 —— 重采救不了 */
        }

        ok_a = AdcSample_PpConsistent(s_pair.pp_a, s_pair.mag_a_codes, &ratio_a);
        ok_b = AdcSample_PpConsistent(s_pair.pp_b, s_pair.mag_b_codes, &ratio_b);

        if (ok_a && ok_b) {
            s_pair.tries = k + 1u;
            if (k > 0u) {
                s_adc_rescued++;
                printf("[adc] ✓ 重采第 %u 次自洽,采用(码/期望 A %.2f B %.2f)\n",
                       (unsigned)(k + 1u), (double)ratio_a, (double)ratio_b);
            }
            return true;
        }

        s_adc_rej++;
        printf("[adc] ⚠️ 拒收第 %u/%u 次采集:%s%s(码/期望 A %.2f B %.2f,允 ≤ %.1f)"
               " —— 重采\n",
               (unsigned)(k + 1u), (unsigned)s_adc_tries_max,
               ok_a ? "" : "A 路峰峰与解调幅值对不上;",
               ok_b ? "" : "B 路峰峰与解调幅值对不上;",
               (double)ratio_a, (double)ratio_b,
               (double)ADC_SAMPLE_PP_RATIO_MAX);
    }

    /* 连采满仍不自洽 ⇒ **本点判无读数**。
     * ⛔ 不要在这里"取个中位数凑一个值" —— 那会把 40 倍的假尖峰变成一个
     *    **看着很正常的假数**,比留空坏得多。 */
    s_pair.tries   = s_adc_tries_max;
    s_pair.z_valid = 0u;
    s_adc_void++;
    printf("[adc] ⛔ 本点连采 %u 次都不自洽 ⇒ **判无读数**(曲线断一格)。\n"
           "        排查:另开 SSH 跑 `sudo -E python3 tools/relay_hold.py --watch` 看回路;\n"
           "        对照:把 `CV_ADC_TRIES=1` 起来(关掉重采,退回旧行为,尖峰会回来)。\n"
           "        两路幅值与波形仍是那一次采集的真实内容(仅供波形页看),已置 z_valid=0。\n",
           (unsigned)s_adc_tries_max);
    return true;
}

/** @brief 一行采集证据。扫压时每点一行 —— 出问题时第一眼看的就是它。
 *
 *  🔴 **2026-10-14 改:加了 Z / Cs / Cp / D 与 R0。**
 *     原文只打印两路幅值与 Cs(那会儿相位不可用,打印 Z 是没意义的)。
 *     现在这几项是**要看的第一批数**:`Re Z` 与万用表量的栅极电阻对得上,
 *     就说明整条相位通路是通的 —— 这是 §五 验证里最关键的一条自证。
 *     `R0` 一并打出来,是为了让"挡位到底是多少"这件事**有出处**,不靠猜。 */
/** `码 / (2×幅值)` —— 正常点 ≈ 1.0;几十以上就是这一次采到了坏字。
 *  判据本体在 `AdcSample_PpConsistent()`;这里只是**同一个式子**的取值版,
 *  因为它要同时给出 true/false,没法顺手把比值带出来。 */
static double pp_ratio(float pp_codes, float mag_codes)
{
    double exp_pp = 2.0 * (double)mag_codes;

    return (exp_pp > 0.0) ? ((double)pp_codes / exp_pp) : 0.0;
}

static void adc_log_pair(const char *tag, float bias_v)
{
    uint32_t div = MeasureConfig_GetSampleDiv();

    /* 🆕 尾部两项是 2026-10-15 加的**自洽证据**:
     *    `码/期望` 正常 ≈ 1.0(实测中位 1.02/1.04),几十以上就是这一次采到坏字;
     *    `采 N 次` 就是这个点重采了几次才过判据。尖峰再冒出来时,
     *    第一眼看这两项就能分清"设备真变了"和"采集又采错了"。 */
    printf("[adc] %-8s 偏压 %7.3f V | A/INA tick%+d 幅值 %7.4f V 峰峰 %5.0f 码 | "
           "B/INB tick%+d 幅值 %7.4f V 峰峰 %5.0f 码 | OTR %u | "
           "VL/VH %7.2f%%%s | 码/期望 %.2f / %.2f | 采 %u 次\n",
           tag, (double)bias_v,
           (int)AdcSample_PortATick(div), (double)s_pair.mag_a_v, (double)s_pair.pp_a,
           (int)AdcSample_PortBTickHw(div, AdcSample_PortATick(div)),
           (double)s_pair.mag_b_v, (double)s_pair.pp_b,
           (unsigned)s_pair.otr,
           100.0 * s_pair.vl_vh,
           /* 🆕 2026-10-23:挡位是否匹配,一眼可读。
            *    高 > 95 % ⇒ 参考电阻太大,本点 Z 已判无效(⛔ 那行);
            *    低 < 0.15 % ⇒ A 路满幅而 B 路只剩几码,Cs 的噪声被放大 |Z|/R0 倍。 */
           (s_pair.fresh == 0u)            ? " (旧)" :
           (s_pair.vl_vh > CV_VLVH_REJECT_HIGH) ? " ⛔高" :
           (s_pair.vl_vh < CV_VLVH_WARN_LOW)    ? " ⚠低" : "",
           pp_ratio(s_pair.pp_a, s_pair.mag_a_codes),
           pp_ratio(s_pair.pp_b, s_pair.mag_b_codes),
           (unsigned)((s_pair.tries != 0u) ? s_pair.tries : 1u));

    if (s_pair.z_valid) {
        if (s_pair.calibrated) {
            /* 校准后的行**两个 Z 都打** —— 报告里要能看出"修掉了多少",
             * 也能在怀疑校准时一眼拿原始值复核。 */
            printf("[adc] %-8s Z = %9.3f %+.3f j Ω (校准前 %9.3f %+.3f j) | "
                   "R0 = %.0f Ω,挡位 0x%X | Cs %9.3f pF | Cp %9.3f pF | "
                   "D %.5f | I %8.4f mA  (已校准)\n",
                   tag,
                   s_pair.z.z_re_ohm, s_pair.z.z_im_ohm,
                   s_pair.z_raw_re_ohm, s_pair.z_raw_im_ohm,
                   s_pair.r0_ohm, (unsigned)s_pair.gear,
                   s_pair.z.cs_pf, s_pair.z.cp_pf, s_pair.z.d, s_pair.z.cur_ma);
        } else {
            printf("[adc] %-8s Z = %9.3f %+.3f j Ω (R0 = %.0f Ω,挡位 0x%X) | "
                   "Cs %9.3f pF | Cp %9.3f pF | D %.5f | I %8.4f mA  (未校准)\n",
                   tag,
                   s_pair.z.z_re_ohm, s_pair.z.z_im_ohm,
                   s_pair.r0_ohm, (unsigned)s_pair.gear,
                   s_pair.z.cs_pf, s_pair.z.cp_pf, s_pair.z.d, s_pair.z.cur_ma);
        }
    } else {
        printf("[adc] %-8s Z 无读数(原因见上面那一行 ⚠️);"
               "两路幅值仍有效,波形照画\n", tag);
    }
}

/**
 * @brief 把 `s_code_a` / `s_code_b` 灌进「单点波形」页(kind 0)。
 *
 * 用户口径:通道 A → 电压图,通道 B → 电流图(A = INA = VH,B = INB = VL)。
 * ⚠️ 通道 B 是**参考电阻 R0 两端的电压**,这里按 `I = VL / R0` 折算成电流,
 *    而 R0 是**从 `0x18` 回读现算的挡位电阻**(不是常数,见 `cv_range_ohms()`)。
 *
 * 🔴 **2026-10-08:采集点数与显示点数在这里分开。**
 *    以前两者是同一个数(`ADC_SAMPLE_POINTS` = 250),所以"读多少画多少"是自洽的。
 *    加长窗之后,解调要的是**满窗 8192 点**,而波形图的容量只有
 *    `UI_Demo_WaveMaxSamples()` = 480 点 —— 直接把 8192 点喂进去,
 *    `ui_demo.c` 会**静默截断**到前 480 点(94% 的采样被丢掉),
 *    屏上表现为"波形是平的或者只有一小段",**不报错**。
 *
 *    ⇒ 喂之前先算「画哪一段」和「抽稀多少」:
 *
 *    **当前档(2026-10-15 起,DIV=4 / 32.5 MSPS;`period` 是整除,`show = min(L,3·period)`)**
 *
 *    | 激励 | 窗长 L | 整周期 m | 一周期点数 period | 显示区间 show | 抽稀 stride | 实喂 fed |
 *    |---|---|---|---|---|---|---|
 *    | 10 kHz  | 6500 |  2 | 3250 | 6500 | 14 | 465 |
 *    | 100 kHz | 8125 | 25 |  325 |  975 |  3 | 325 |
 *    | 1 MHz   | 8190 | 252 |   32 |   96 |  1 |  96 |
 *
 *    **旧档(2026-10-08 ~ 10-14,DIV=2 / 65 MSPS)—— 留作对照,别照着它改代码**
 *
 *    | 激励 | 窗长 L | 整周期 m | period | show | stride |
 *    |---|---|---|---|---|---|
 *    | 10 kHz  | 6500 |    1 | 6500 | 6500 | 14 |
 *    | 100 kHz | 7800 |   12 |  650 | 1950 |  5 |
 *    | 1 MHz   | 8190 |  126 |   65 |  195 |  1 |
 *
 *    取「3 个周期」而不是整窗:整窗周期数一多,480 个像素画几百个周期
 *    只会画出摩尔纹,**看不出波形形状**。
 *    ⚠️ 10 kHz 在 32.5 MSPS 下 `m = 2`(65 MSPS 下是 `m = 1`,正好落在第 1 根
 *       谱线上),`3·period > L` ⇒ 它画的仍是整窗;`m` 从 1 涨到 2 是**副产品改进**。
 *    📌 10 MHz 档已于 2026-10-08 从界面删除(AD9833 的 25 MHz MCLK 输出不了),
 *       本表的对应行随之删除 —— 但**上面的 stride 公式一个字都不用改**：
 *       它是由 `L`/`m` 现算的,不是查表。
 */
static void adc_feed_point_waveform(void)
{
    uint32_t max_pts = UI_Demo_WaveMaxSamples();
    uint32_t l = 0u;
    uint32_t m = 0u;
    uint32_t period;
    uint32_t show;
    uint32_t stride;
    uint32_t i;
    uint32_t fed = 0u;

    AdcSample_LastWindow(&l, &m);

    if ((l == 0u) || (m == 0u)) {
        /* 还没成功解调过(或解调失败)—— 退回"把整块缓冲粗看一遍"。
         * 这时不该假装知道周期,所以整窗抽稀,至少让人看到有没有信号。 */
        l = ADC_SAMPLE_POINTS;
        m = 1u;
    }
    period = l / m;
    if (period == 0u) {
        period = 1u;
    }

    show = period * 3u;
    if (show > l)                  { show = l; }
    if (show > ADC_SAMPLE_POINTS)  { show = ADC_SAMPLE_POINTS; }

    stride = (max_pts == 0u) ? 1u : ((show + max_pts - 1u) / max_pts);
    if (stride == 0u) {
        stride = 1u;
    }

    /* 喂进去的总点数 = ceil(show / stride)。先算出来 —— 这个 API 的
     * `total_samples` 是"最终会有多少点",要一次给全,不能边喂边变。 */
    fed = (show + stride - 1u) / stride;

    /* B 的瞬时值 → 电流:`I = VL / R0`(R0 = 挡位电阻,从 0x18 回读换算)。
     * ⛔ **不要再用 `ADC_SAMPLE_R_TIA`** —— 那是 1 kΩ 的遗留常数,而硬件
     *    复位挡位是 100 Ω,差 10 倍。理由见 `adc_sample.h` 的说明。 */
    UI_Demo_BeginWaveform(UI_DEMO_WAVE_POINT, fed);
    for (i = 0u; i < show; i += stride) {
        float  v   = AdcSample_CodesToVolts((float)s_code_a[i]);
        float  cur = 0.0f;

        if (s_pair.r0_ohm > 0.0) {
            cur = (float)(((double)AdcSample_CodesToVolts((float)s_code_b[i]) /
                           s_pair.r0_ohm) * 1000.0);      /* A → mA */
        }

        UI_Demo_UpdateWaveformPoint(UI_DEMO_WAVE_POINT, (i / stride) + 1u,
                                    fed, v, cur, NULL);
    }

    printf("[adc] 波形:窗长 %u 点(%u 个激励周期),显示前 %u 点、每 %u 点取一 → %u 点\n",
           (unsigned)l, (unsigned)m, (unsigned)show, (unsigned)stride,
           (unsigned)fed);
}
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
