dsgmxc/2026_fpga_qrs/src/c_ui/app/adc_sample.c

/**
 * @file adc_sample.c
 * @brief @ref adc_sample.h 的实现 —— 采一次缓冲 + 正交解调
 *
 * 【本文件的编写纪律】
 *   ⛔ **不直接写 `0x88`。** 那个寄存器归 `measure_config.c` 独占
 *      (见 `measure_config.h` 的文件头)。改采样刻度一律走
 *      `MeasureConfig_PushPhase()` / `MeasureConfig_PopPhase()`。
 *   ⛔ **不写 `0x84`(CV_CTRL)。** DAC 放行权归 Python 侧。
 *   ✅ 只碰 `0x8C`(GO)、`0x90`(状态)、`0x94`/`0x98`(缓冲)。
 *
 * 【踩过的坑,别重犯】
 *   ⛔ **`done` 必须先清后等。** 幸好不需要软件去清:RTL 在 `go_pulse` 上
 *      **同时** `done <= 0`,所以"写完 GO 再等 done=1"等到的必定是本次的。
 *      但**不能省掉"等 busy=1"这一步** —— 少了它,首次轮询可能读到上一次
 *      留下的 `done=1`(CDC 要几个周期),然后读出**上一次**的数据。
 *      这正是 `measure_config.c` 文件头记的那个坑的另一种触发方式。
 *   ⛔ **失败路径也必须 PopPhase。** 漏掉的话硬件停在临时刻度上,而界面
 *      显示的是逻辑值 —— 没有症状,下次测量才发现。
 */

#include "adc_sample.h"

#include "measure_config.h"
#include "pynq_regs.h"

#include <math.h>
#include <stdarg.h>
#include <stdio.h>
#include <string.h>

/* ==========================================================================
 * 参数
 * ========================================================================== */

/* 0x90 的**掩码**。`pynq_regs.h` 里的 `CV_ADC_STS_*()` 宏要的是一个完整的
 * 状态字(内部自带移位),这里要的是掩码,所以另立常量而不是硬凑那个宏。 */
#define ADC_STS_LOCKED_MASK   0x1u
#define ADC_STS_DONE_MASK     0x2u
#define ADC_STS_BUSY_MASK     0x4u
#define ADC_STS_OTR_MASK      0x8u

/* 等待超时(ms)。`cv_millis()` 只有 1 ms 分辨力,所以这几个数要**明显大于**
 * 真实耗时,不然会把"正常但慢"判成超时。真实耗时量级(2026-10-14 缓冲加倍后):
 *   收满 16384 字:最快档(DIV=2,65 MSPS)= 252 µs;最慢档(DIV=130)= 16.4 ms
 * ⇒ done 给 200 ms 仍有 ~12 倍余量,不会误报。 */
#define ADC_WAIT_IDLE_MS      50u
#define ADC_WAIT_GO_MS        50u
#define ADC_WAIT_DONE_MS      200u

/** 🔴 **参考表的点数上限 = 一次解调用多少个采样点(窗长)**,不是"每周期最多几点"。
 *
 *  2026-10-07 改。旧实现按**一个激励周期**建表,于是表长 = `f_s/f_e`,
 *  激励一调低表就爆(`100 kHz + 10 MSPS` → 100 点 > 64)——
 *  那是**这张表能装多少**,不是 DFT 的限制。DFT 的唯一要求是
 *  **窗覆盖整数个激励周期**(`L·f_e/f_s ∈ ℤ`),它**不要求 `f_s/f_e` 是整数**。
 *  改成按**整窗 `L` 点**建表后,表长只跟窗长走,与频率比**无关**。
 *
 *  🔴 **2026-10-08 由 256 改 8192。** 这是"加长窗"改动里的**第二道闸**:
 *     `ADC_SAMPLE_POINTS` 从 250 提到 8192 后,各档激励的窗长
 *     `L = 6500 / 7800 / 8190` **全部超过 256** ⇒ 表长不改的话
 *     `build_table()` 直接 `return false`,用户看到的是
 *     「解调不可用:窗长 6500 点,超出参考表上限 256」——
 *     **数字上算得出来、这里装不下**,与 `ui_demo.c` 那个停在旧档位的
 *     回调守卫是同一个形状(算得对、闸在中间)。
 *
 *  ⚠️ 它是 `static` 的 `.bss`,**不是栈**:8192 × 4 B × 2 张表 = 64 KB,
 *     改大不会炸栈。若哪天改成局部变量,64 KB 就会当场爆栈。
 *  ⚠️ 必须 ≥ `ADC_SAMPLE_POINTS`(`L ≤ n`)。两个值一起改。 */
#define ADC_DEMOD_MAX_L       ADC_SAMPLE_POINTS

/** 窗内至少要有几个激励周期。低于此值 ⇒ 窗里连一个完整周期都没有,
 *  相关运算等于在比"两个不同的东西",不如明说不解调。
 *  (当前实现下不会触发 —— 由"窗长必须是 `q` 的整数倍"这条保证 `m ≥ 1`;
 *   留作断言用。) */
#define ADC_DEMOD_MIN_M       1u

#define ADC_TWO_PI            6.28318530717958647692

/* ==========================================================================
 * 状态
 * ========================================================================== */

/* 🔴 320 不是随手写的:下面"超时诊断"和"每周期点数不足"两条消息
 *    最长可达 ~261 / ~249 字节(算上 `%s` 展开的那个 0x90 状态串)。
 *    原来写 192,`-Wformat-truncation` 实测报**截断** —— 恰好在这种
 *    "就靠这行字定位"的时候把最关键的尾句吃掉。加宽到 320 留余量。 */
static char     s_err[320];
static uint32_t s_tab_m;                            /* 表是按哪组 (M, L) 建的 */
static uint32_t s_tab_l;
static float    s_tab_cos[ADC_DEMOD_MAX_L];
static float    s_tab_sin[ADC_DEMOD_MAX_L];

/* ==========================================================================
 * 小工具
 * ========================================================================== */

static void set_err(const char *msg)
{
    if (msg == NULL) {
        s_err[0] = '\0';
        return;
    }
    (void)snprintf(s_err, sizeof(s_err), "%s", msg);
}
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
