dsgmxc/2026_fpga_qrs/(commit log)

2026-10-03 交付:技能包 10 项 + PL/PS 全量源码 + 当前位流 [llm-039]
    自 2026-09-22 建立目录框架以来第一次实质内容提交。此前仓库除骨架外为空。
    技能包(M6 / B1)
    skill/ 一次落地 10 项,各含五要素(适用范围/使用方法/失效条件/已验证的效果/来源):
    通用 PYNQ(B1 加分项):pynq-overlay-bringup / pynq-register-map-pattern
    / pynq-ddr-framebuffer-display
    项目技能:verilog-review-checklist / spi-tb-patterns
    / measurement-instrument-can-be-wrong / stale-artifact-silent-reuse
    / rtl-constant-experiment-must-verify-netlist / use-layout-as-ruler
    / gbk-example-porting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
    [adc_9833.v, cv_axi_lite_slave.v, cv_monitor.py, cv_regs.py, cv_sys.v, dac_1220.v, display_probe.py]
2026-10-05 交付同步:界面批次 2+3 + 规格文档 + 实测存档 + LLM 记录入仓 + LICENSE(MIT) [llm-041]
    - src/c_ui/: 结果页拆 5 子页(批次 3)+ 结果页聚合(批次 2)
    ui_demo.c 5367 -> 6293 行,pynq_protocol_stub.c 168 -> 519 行
    - docs/: 补 board_pins / dac1220_interface / display_subsystem 三份规格
    - board/measurements/: 7 份上板实测存档入库(M13 / M04 直接证据)
    - llm-log/: 40 条交互记录 + INDEX 从 report/ 拆出为顶层目录
    - build/: system_wrapper 关键 4 份综合与实现报告(M03)
    - sim/: 补 tb_lcd_rgb_colorbar.v
    - LICENSE: 0 字节 -> MIT
    - README: 目录对照说明同步更新(4 个新增目录 + 引用处理规则)
2026-10-05 记录:补 LLM-041(交付仓库整理与同步)[llm-041]
    - llm-log/LLM-041.md:本次会话完整记录(实测差集 → 方向定案 → 同步 → 推送)
    - llm-log/INDEX.md:新增 LLM-041 行;统计 40→41 条、部分可用 31→32、
    候选 skill 76→77、未落地 63→67(按实测更正)
2026-10-05 sync: DAC1220 复位图案频率失配修复 + 界面点击链路取证 + 实测存档入库 [llm-043]
    RTL(本轮修复)
    - cv_sys.v: 新增 0x84 CV_CTRL, dac_1220.rst_n = s_axi_aresetn & cfg_dac_rst_n;
    更正 §7 那处「运行时钟与设计时钟不一致对一次性上电握手无影响」的错误注释
    —— 三个复位窗口都有上界, 板载 BOOT.BIN 把 FCLK0 留在 27.7778 MHz 时三段全部超界
    - cv_axi_lite_slave.v: BIAS_CODE / DDS_FREQ 寄存器与 cv_ctrl, ADDR_WIDTH 7 -> 8
    位流与报告(与 board/qrs.bit 同批)
    - board/qrs.bit md5 30b7f46e235023b9868fc4fef5b66f1a (旧 0e4cb57c3ab4399a6fe4fc9d9c25719d)
    - board/qrs.hwh md5 73b7b2af20db14b9a5a5e8e7ffe8d4a5 (BD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
    [cv_axi_lite_slave.v, cv_monitor.py, cv_regs.py, cv_sys.v, main.c, main.py, pynq_protocol.c]
2026-10-05 docs: LLM-043 补记交付同步一节(方向实测 / 凭据处置 / add -A 自我撤回) [llm-043]
    - 新增「交付同步」节:四份「看着像工作区文件」的文档其实是仓库版,靠 mtime 拦下
    - 记录一次性 credential helper 的用法(密文不进命令行参数、不进 git 配置)
    - 记录 git add -A 误暂存两个 0 字节文件并 git restore --staged 撤回
    - 补 skill 候选 sync-direction-must-be-measured(第 2 次发作)
2026-10-05 清理:删 io.xdc 与两个空占位文件,推入最新 led.xdc / 实验位流 / 板上脚本 [llm-043]
    删(用户「没用的就删了」)
    - src/constrs/io.xdc —— 工程里 UserDisabled=1 的重复/过时副本;删前逐项核过它
    内容在别处有没有:clk_in1=U18/rst_n=N16 在 docs/board_pins.md(出处更强)、
    adc_*=V12/W14/V15 已被真实接线 dds_*=T5/U7/T11 取代、LCD 30 根 led.xdc 有同一份。
    唯一无备份的是 clk_65m=U5(旧顶层遗留死端口)⇒ 归档留在工作区
    docs/_retired/io.xdc.disabled-20261005.bak(md5 2591b0ae…,逐字节相同)
    - src/python/config.py / display.py —— 两个 0 字节文件,git 从未跟踪
    推(用户「有用的就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
2026-10-06 交付同步:第 43–46 次上板成果全量入库,并补三个此前漏掉的源码/约束缺口
    同步工作区 → 交付仓库。方向逐文件核对过,没有按惯性反向覆盖。
    【新增 LLM 记录 7 条】LLM-044 ~ LLM-050 + INDEX(统计 43 → 50 条)
    · LLM-044 AD9238 采集通路板上调通;★ 总线是双端口时分复用;OEB 经三态冻结实验证明有效,
    并查明「OEB 无反应」是模型自己的测量假象
    · LLM-045 「系统复位」页三项改造(频率接口引出 / 常驻状态行 / 全参数复位)
    · LLM-046 采样显示落地:把 AD9238 真实采样接进结果页四张图;五处自我纠错,
    其中两次是「差点把对的改成错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
2026-10-08 交付同步:第 47–50 次上板成果全量入库(采样率统一 65 MSPS + 采集窗 8192 + 激励档位收敛为三档)
    同步工作区/工程 → 交付仓库。方向逐文件核对过,没有按惯性反向覆盖。
    RTL 的事实源是 Vivado 工程 qrs.srcs/sources_1/new/(工作区 src/rtl/ 只有一份 vestigial 拷贝),
    本轮按工程逐文件比对。
    【新增 LLM 记录 5 条】LLM-051 ~ LLM-055 + INDEX(统计 50 → 55 条,✅20 / ⚠️34 / ❌0 / 无标记 1)
    · LLM-051 / 052 / 053 —— 65 MSPS 采样通路的寄存器层与波形层验证(接 LLM-050 的失败根因)
    · LLM-054 —— 65 MSPS 界面档位端到端验收;★ 陈旧守卫 index>5u 静默吞掉第 6 颗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
2026-10-08 清板补档:两件此前未归档的板上原件 + 截图存档说明补 §五 [llm-055]
    第 50 次会话收尾清板时从板上取出、工作区此前一份都没有的两件:
    1) board/measurements/artifacts/20261008_cui_before_8192_window.log
    (142258 B,md5 8517f0b38c29c672b9fce0cb6126b5ea)
    板上来源 /var/log/qrs-ui.log.pre-8192,共 2361 行,与工作区副本逐字节相同。
    含 fclk0_real 27.7778 MHz / ADC 采集 成功=11 失败=1 / 0x64 = 0x000BA278
    underrun=1 … vblank_cnt=158 swap_cnt=116。
    ⚠️ 上一轮状态文档曾写该文件与其同批"均已归档" —— 实测工作区内 md5 8517f0b3…
    查无对应,"均已归档"是顺手写的、没验。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
2026-10-08 LLM-055 补纠错轨迹 §6:纠正上一轮"均已归档"的不实断言 [llm-055]
    清板时按"删之前先找副本"走,撞出上一轮状态文档里的一处不实断言:
    板上 /var/log/qrs-ui.log.pre-8192(142258 B)的 md5 8517f0b3… 在工作区查无,
    而原话写的是该文件与其同批"均已归档"。补档的同时把这条 自我纠正 写进记录。
    同节定形一条可复用判据:清板的删除条件是「板上这一份是不是唯一一份」,
    "是不是唯一一份"必须用内容比对查、不能靠文件名或大小猜;比图要解码后比
    md5(pixels) 而非文件哈希 —— PNG 编码不同则哈希必然不等。
    本次为纯文档增补,不涉及位流、R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
2026-10-08 LLM-055 补纠错轨迹 §7:漏掉"关系统"(关机),且用户追问才发现 [llm-055]
    用户指令末段「...改为整理环境关系统整理文档和代码以及测试结果更新交付仓库推送」中,
    "关系统"被模型切成了「关(掉环境)+ 系统(性)整理文档」,于是只整理不关机,由用户
    一句「系统怎么没关」点破。
    补做时又发现板上 /var/log/qrs-ui.log.pre-8192 与 .pre-3dds 仍在盘上,md5 与已归档件
    逐一相同 —— 前一轮记录写成"已归档/已删除"是不准的:归档了,但板上那份没删。已删。
    关机三重确认:两次 ping 4发0收 100% 丢包 + /dev/tcp/…/22 无响应。
    关机前 qrs-ui = disabled 但 ac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
2026-10-10 交付同步:第 51–54 次上板成果全量入库(继电器矩阵+挡位落地、只读界面接入、0x1C 缺陷结案) [llm-056..059]
    四轮会话的产物一次性入库,33 个文件 + 6 个新目录/文件:
    【硬件新增】继电器矩阵(K1..K7)+ 挡位选择(A/B/C/D)全链路
    · src/rtl/relay_ctrl.v(新)—— 白名单而非黑名单、7 位同拍翻转(不插 AllOff 中间态)、
    稳定时间以 ms 计;bit7 恒判非法
    · src/rtl/cv_axi_lite_slave.v —— 新增 0x04 STATUS / 0x18 RANGE_SEL / 0x1C RELAY_CFG / 0x24 SETTLE_CFG
    · src/rtl/cv_sys.v —— 11 根新端口 + 例化 + STATUS 拼装
    · src/constrs/led.xdc —— 11 行新约束(56 → 67 条 PACKAGE_PIN)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
2026-10-10 LLM-060: 目标改向「复刻出结果」+ 仓库管理授权 + D30 推翻 D03 [llm-060]
    用户一句话改了三件事,并追加一个文档需求:
    ① 目标排序改为「复刻出结果」优先,加分点押后（必做点仍一项不能缺）
    ② 代码编写 + 仓库管理全归 Claude ⇒ CLAUDE.md §6.0.1「交付仓库默认只读」作废
    ③ D30 推翻 D03 —— 解调不要求在 PL 算,P3 判据随之改写,C 侧解调从"替补"变"正选"
    ④ 自用手册 docs/dev_handbook.md（398 行）+ tools/board_run.py
    ⚠️ 本次只入库 llm-log 两份。两个新产物都不进交付仓库：
    - docs/dev_handbook.md 含板卡 SSH 口令
    - board/board_run.py 是宿主侧脚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
2026-10-10 LLM-060 补纠错轨迹 §6/§7:写进手册的 helper 没跑过,实推时当场失败 [llm-060]
    §6 —— 我把一条未实测的命令序列写进了手册 §9.2（credential helper），
    同一次会话末尾照着推送时报 fatal: could not read Username。
    sed 取值实测是对的（name 6B / password 32B）⇒ 不是凭据问题；
    真因是 helper 没有 shebang ⇒ git execve 失败(ENOEXEC) ⇒ 零输出。
    已改为带 #!/bin/sh 的版本并加一步自检（喂一个 get，只看输出键名）。
    教训：写进手册的命令要么当场跑过、要么显式标"未实测" ——
    与既有 verify-your-own-checker-first 同族：先证明工具活着，再谈读数。
    §7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
2026-10-12 LLM-061: DAC1220 偏压根因 = 偏移二进制补码,两端同改 + 新位流上板验证 [llm-061]
    根因(数据手册 SBAS082G 佐证):CMR bit5 DF —— 0 = 偏移二进制补码(上电默认)、
    1 = 直通二进制;Table 9(20 位)补码 0 V = 码 80000h。板上六点实测(模块级)
    0x7FFFF→+9.72 / 0x26666→+2.80 / 0x0CCCC→+0.820 / 0x80000→−10.0 /
    0x99999→−8.0 / 0xA6666→−7.0,全部只吻合补码、全部否定直通。
    两端同改:
    src/c_ui/app/pynq_regs.h cv_bias_volts_to_code() 旋转 ^ 0x80000;逆函数反向再转
    src/rtl/dac_1220.v cal_byte_f 的 CMR 0x20A1(DF=1/RES=0) → 0x2081(DF=0/RES=1)
    为何改 RTL 而非只旋转软件:文档里 2026-09-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
2026-10-12 LLM-061 补:用户持表确认「DAC 输出正确了」—— 偏压链端到端闭环 [llm-061]
    模拟输出侧由用户收口:寄存器/ADC/生产二进制三条此前已坐实,缺的就是实际电压,
    本轮用户读表后确认正确 ⇒ 「触摸/软件 → c_ui → AXI → PL → dac_1220 → 模拟输出」跑通。
    结果由 ⚠️ 部分可用 改为 ✅ 直接可用。
    ⛔ 口径纪律(不越界引用):用户是口头判读,无逐点表值 ⇒ 可写"与设定相符",
    不可写"逐点线性度误差 X%";万用表量程/分辨力未记录 ⇒ 不算偏差百分数。
    (同 LLM-043 ⑭⑮ 两条边界声明。)
    ⚠️ 两项仍标「未结案」,不因该确认而关闭 —— "输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
2026-10-14 [llm-062] 回路真的会切了 + VH/VL 相位通路打通(一次 GO 存 A/B)
    用户问:「为什么我切换测量项目回路没有相应的切换」。
    根因不是 bug,是一处从未落地的设计 —— 0x1C(RELAY_CFG)三处能写的地方
    一处都没写:PL relay_ctrl.v 已实现且 10-10 上板验证过;C 界面 relay_view.c
    文件头自述「只读」;Python drivers/relay.py 写得完整但 main.py 零调用方。
    ⇒ 硬件永远停在复位值 ALL_OFF(0x10)。顶栏读的是硬件真值没说谎,
    说谎的是按钮高亮 —— 按下去只换了个颜色。
    一、0x1C 写入权移交 C 界面(五个调用点,纯 C)
    RelayView_ApplyCode 成为唯一写入口(幂等跳过 + 等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
    [adc_capture.v, adc_sample.c, adc_sample.h, cv_axi_lite_slave.v, cv_sys.v, pynq_protocol.c, pynq_regs.h]
2026-10-14 [llm-063] 采样刻度 CV_ADC_DIV_DEFAULT 2 -> 4 + 位流 md5 更正
    用户拍板:「这个修复吧,档位先别动等我连上档位控制引脚,然后如果你用不上
    开发板就先关系统」。
    改动(纯 C,6 个文件;零 RTL、零位流):
    - pynq_regs.h CV_ADC_DIV_DEFAULT 2u -> 4u(唯一功能性改动)
    - adc_sample.c/.h、measure_config.c/.h、pynq_protocol.c 仅注释/错误串
    为什么:DIV=2 时刻度表只有 {-1, 0} 两点,贴死 adc_clk 两个边沿、零建立裕量,
    实测在翻 B 端口的总线位(A/INA 幅值平滑 0.2706/0.2705/0.2710 V,而峰峰
    1286 -> 1289 -> 1535 码,跳幅正好 ±1024/±2048)。DIV=4 的表是 {-2,-1,0,+1},
    cv_adc_phase_center(4) 折回到 +1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
    [adc_sample.c, adc_sample.h, measure_config.c, measure_config.h, pynq_protocol.c, pynq_regs.h]
2026-10-14 [llm-063] M03 报告归属到部署位流 + .gitignore 8 条失效规则修活
    收尾自查发现两处真实缺陷(见 llm-log/LLM-063.md 纠错 ⑤⑥):
    一、M03 入库的实现报告与部署位流不是同一次构建
    · 那一夜跑了三次完整构建(会话头 22:16 / 23:29 / 23:39)
    · 位流锚点由工程 impl_1/system_wrapper.bit 的 md5 正面坐实 =
    232c649d0cc143c12c87f17365f6ddd3(与 board/qrs.bit 一致)
    · 而入库的 4 份 .rpt 是 22:28 那一次(第一次构建)
    · 两次数值确实不同:WNS +0.354↔+0.316、LUT 1789↔1790、
    失败端点分母 5469↔5472(BRAM/DSP/IOB/BUFG 才相同)
    ⇒ 源没变,P&R 不是逐比特可复现
    · 处置:换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
2026-10-14 [llm-062] INDEX 里 LLM-062 行的 WNS/资源/端点数改取部署版构建 同 [llm-063] 的第二条更正:M03 证据归属到部署位流 232c649d…。 旧数 +0.354 / 1789 LUT / 0 of 5469 是同一夜第一次构建的,同源不同 P&R。
2026-10-15 [llm-064] 扫压收尾归零偏压 + 扫压自动换挡(|Z| ≈ R0 判据 + 0.15 十倍程迟滞)+ 挡位 4 颗按钮真写 0x18
    ① 扫压收尾不归零偏压(用户实测发现)
    `sweep_finish()` 完全没写 `0x14`,结束时读回 0x0007FFFF = +100.000 V,
    DUT 栅极被留在满扫压上。⇒ `sweep_finish()` 与 `RequestSweepStop()`(后者原
    主动打印"偏压保持在当前点")都改走 `bias_apply(0.0f)`;顺带更正
    `RequestReset()` 注释里的错误口径(0x80000 是 −100 V,不是 0 V;代码本来是对的)。
    ② 扫压全程固定一个挡位 ⇒ 新增 `cv_range_pick()`(pynq_regs.h,纯判据,不写寄存器)
    + `sweep_autoscale()`(pynq_protocol.c)。判据:两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
2026-10-15 [llm-066] 0x14 复位值在 DF=0 下是 −100 V(安全项):32'h0008_0000 → 32'h0000_0000 + 重综合
    问题(用户):「dac上电后默认电压是多少，我发现dac一直输出5v」
    指令(用户):「把pl端默认值给改了重新编译」
    根因:cv_axi_lite_slave.v:514 的复位值 0x0008_0000 依据的是**旧的 DF=1 传递式**
    (V_module = −10 + 20 × code/1048575)。而 dac_1220.v 的 CMR 已于 2026-10-12
    由 0x20A1(DF=1) 改成 0x2081(DF=0) ⇒ 同一个码翻到量程另一端:
    DF=1: 0x80000 = 0 V DF=0: 0x00000 = 0 V,0x80000 = −10 V(栅极 −100 V)
    而那段注释自己写着「上电停在 0 V 是无条件安全的中点」⇒ DF=0 之后它恰好落在
    Vgs 绝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
    [cv_axi_lite_slave.v]
2026-10-15 [llm-067] 上板核验 0x14 复位值 ✅ + 「PL 空着没有」判据纠错 + 恒定 5 V 未定位
    - llm-log: 补 LLM-065/066/067 三份记录与 INDEX(交付仓库此前停在 LLM-064)
    - src/python/cv_regs.py: DF=0 重写(同一个 DF 位的第三处落点)
    bias_volts_to_code(0.0) 原会算出 0x80000 = −100 V —— "要 0 V 给 −100 V"
    - src/python/tools/pl_state.py: devcfg 判据更正
    STATUS 0x14 bit10 PSS_FST_CFG_B(位 5 不是 PCFG_DONE,且加载前后都读 1)
    - src/python/tools/bias_set.py: 本周期唯一一次 Overlay + 读复位值 + 配 FCLK0 + 放行 0x84[0]
    - src/python/tools/bias_mmap.py: 裸 mmap 改偏压,一次位流都不加载
    - 删除误建重复件 src/python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
2026-10-15 [llm-068] 扫压尖峰修复:自洽判据 + 重采(中位数治不了整次坏采集)
    根因(详见 llm-log/LLM-068.md):不是算术错,是同一个缓冲里两个数矛盾 ——
    幅值反推的峰峰 27 码 vs 打出的峰峰 2588 码,差 94 倍;坏点整次都错,
    故 N 次取中位数会让"错的多数赢"。正确形态 = 物理不变式先判"这次算不算数",
    不算数就换一次重采。
    - src/c_ui/app/adc_sample.{c,h}:新增 AdcSample_PpConsistent()
    判据 码 <= K x 2x幅值 + FLOOR(单边),K=3.0 / FLOOR=64
    阈值取自 2039-4462 个真实样本:抓 342/347(98.6%),误伤 31/1692(1.8%)
    - src/c_ui/app/pynq_protocol.c:
    - adc_capture_pair() 改为重采外壳,原实现更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
    [adc_sample.c, adc_sample.h, pl_state.py, pynq_protocol.c]
2026-10-15 [llm-068] 扫压尖峰修复 ✅ 上板验证:519.52 pF 尖峰消失,三个坏点落回邻点趋势线
    用户点屏跑完一轮扫压(CISS+COSS+CRSS,0.1→100 V,60 点/腿),数据记录如下。
    决定性证据 —— 同一台设备、同批偏压,改前(旧 c_ui,同参数)录到的三个坏点:
    偏压 44.060 V 21.26 pF → 15.57 pF
    偏压 49.530 V 519.52 pF → 14.74 pF ← 用户最初报告的那根尖峰
    偏压 70.380 V 13.43 pF → 12.31 pF
    改后三点全部落在各自邻点插值上(邻点:16.35/15.57/13.28、12.86/12.31/11.83)。
    总账:码/期望 max 167.04 → 7.54;比值 >10 的点 5 → 0;>50 的点 3 → 0。
    账本:实际采 223 次 / 判据拒收 36 /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
    [20261015_sweep63_after.csv, 20261015_sweep63_before.csv]
2026-10-15 [llm-068] 更正测量记录三处错:拒收分组漏了 COSS 腿、账本对账算错、判读用了循环论证
    用户追问"那几个坏点出现在哪个回路哪个偏压"时逐条重核,发现记录里有三处不实。
    ① 拒收分组表漏了 COSS 腿两组(79.123 / 88.951 V,各 2 次,比值 24.32 / 26.00)。
    连带推翻了"A 类灾难性坏字只在 CRSS 高压端"这条断言 —— 两条腿都有,只是 COSS 只有 2 处。
    修正后 20 组 / 36 次,与账本逐字吻合;原表是 18 组 / 32 次,与账本对不上而我当时没查。
    根因:按"连续行"分组时把收尾的 `✓ 重采第 N 次自洽` 行也当成了拒收统计。
    ② 账本对账算错:原写 "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
2026-10-15 [llm-069] CRSS 高压端坏点根因:改判到「ADC 真的过载了」(adc_otr 作证)
    用户报告「50 附近测量 CRSS 确实容易出问题」+「调试界面的正弦有波动不干净」。
    本次为纯分析,一行代码没动。
    坏点在哪(坏 = ppA ≥ 2000 码,干净值约 1060–1640):
    干净 213/245(86.9%);高压过载 20 条全部在 CRSS;低压过载 12 条横跨三条腿。
    CRSS@50.000 V 坏 11/15(73%)、@55.000 V 坏 8/9(89%)、
    CRSS@0.100 V 只 1/20(5%)、CISS 扫压 60 点全程 0%
    ⇒ 回路与偏压两个变量都成立,不是单因子。
    三条指纹:
    1) 解调干净、峰峰炸 —— CRSS ≥39 V 采纳点 A 路解调幅值 CV 仅 0.14%,
    同期 ppA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
2026-10-15 [llm-069] 交付仓现状核对:修 adc_capture.v(交付 RTL 建不出自己发布的位流)+ 补 5 个工具 + 技能包 4 项
    用户问「仓库现在是最新吗,不是的话就更新」。核 606 个跟踪文件:
    一致 562 / 有差异 6 / 仅仓库有 38。
    【★ 真缺口】src/rtl/adc_capture.v 与 Vivado 工程不同,而 board/qrs.bit 正是
    用工程那一份建的。时间链:源码 10-14 23:39 → 位流 10-15 18:21(晚于源码 ⇒
    位流含修复);交付仓提交 10-14 22:35(早于修复 ⇒ 交付的是旧版)。
    漏掉的改动 = 记录窗口起点由「GO 后第一个命中的刻度」改成「恒取 A 的刻度」,
    原写法下错开一整个转换会让相位原点失效(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
    [adc_buf_dump.py, adc_capture.v, adc_cfg_probe.py, board_run.py, relay_set.py, relay_smoke.py]
2026-10-17 [llm-070] 扫压参数页并入结果页 + 触摸读数 + 实测数据二维码
2026-10-17 [llm-070] 板上验证:补子集字体缺字 + 摘要裁切 + 屏上 QR 解码证据
2026-10-17 [llm-070] 用户实按/实扫确认:触摸读数与手机扫码通过,全部验证项结案
2026-10-22 [llm-071] 修复「全部」页三卡不显示数据(UpdateAllCapacitance 无调用点)+ 归档三腿全量扫压 180 点
    [20261023_sweep_3legs_60pt.csv]
2026-10-23 [llm-072] TK9J90T 典型曲线参考模型 + 结果页叠加对比(十颗同型号器件中位)
    - 数据:同惠 TH521 导出,1-10 十颗同型号器件,逐点取中位;
    0.1-100 V / 201 点 + Rg -3..+3 V / 101 点;Zip 与 CSV 一并归档
    - Cp 不存表,运行时 Cs/(1+D^2) 现算,保证单点三值自洽
    - 新增 app/ref_model.{c,h}、app/ref_th521_data.{c,h}、
    tests/test_ref_model.c(75 项)、board/make_th521_reference.py
    - 结果页:器件类型选择器 + 叠加开关(同时驱动两张图),参考线为虚线;
    单点卡逐行排参考 Cs/Cp/D,RG 卡排 Rg
    - 正名:TH521 是仪器,TK9J90T 是器件
    - 板上 make 零 warning,c_ui f2e169de;抓帧 20261023_ref_curve_ui.png
    [th521_typ_cv.csv, th521_typ_rg.csv]
2026-10-24 [llm-073][llm-074][llm-075] 校准:三标准 Möbius + 仅开路平行杂散校正 + 四挡一致性闸
    - 自动换挡判据改用 VL/VH 反推 |Z|,加换挡后核对,一次只走一挡(LLM-073)
    - 新增 app/calibration.{c,h}:OPEN/SHORT/LOAD 分式线性误差模型、
    标准板四腿参数、采集状态机、CRC32 存盘(LLM-074)
    - 校准页(第 6 页):参数输入、4×4 覆盖表、三采集按钮、开关(LLM-074)
    - 新增仅开路路径 a=1,b=0,c=1/M_o,标记 CAL_F_FIT_OPEN(LLM-075)
    - 新增四挡开路 3 倍一致性闸 + 导纳占比守卫;Init 载入后重拟合(LLM-075)
    - 宿主单测 tests/test_calibration.c:六条路径 + 守卫 ALL OK(LLM-075)
    [adc_sample.c, adc_sample.h, calibration.c, calibration.h, pynq_protocol.c]
2026-10-24 [llm-076] 界面整体 180° 旋转:分块渲染 + 触摸坐标双路径镜像
2026-10-24 [llm-077] 换腿后第一点多等一个驻留 + 换腿前先撤压再切继电器;附 ADC 全 0 探针
    - sweep: 换腿后第一点(0.1 V)原来在 300 ms 驻留后就采,而高压级要从上一腿
    终点 100 V 落下来 —— COSS/CRSS 首点 Cs 1872/573 pF,次点 3393/1700 pF。
    单腿连扫与「0.1 V→0.1 V、1 点/腿」两个对照把原因夹死(不是继电器切换本身)。
    老代码第 2 点在 600 ms 采且一直正确 ⇒ 换腿后第一点也叠一个驻留。
    - sweep: 换继电器前先 bias_apply(0) —— 原来是在上一腿终点(通常 100 V)下热切换。
    - board/adc_*_probe.py: 定位「采样恒 2048」的只读探针(相位/分频扫描、偏压直流响应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
2026-10-24 [llm-077] 更正:ADC 全 0 是外设未接,不是硬件故障;补记关机步骤
    用户原话「是我没接外设，先关系统吧我后面测」。
    原记录把「数据线全 0」判成 ADC 硬件故障 —— 排除性的证据(相位/分频/寄存器/
    软重启)全部成立,错的只是结论措辞:证据只支持「外设侧没有信号」。
    补记收尾:服务 stop、偏压 0 V、继电器 ALL_OFF、sync、shutdown。
2026-10-24 [llm-077] 上板复验:换腿后首点已回正;归档 180 点扫压数据
    接好外设后三腿全扫(0.1→100 V,60 点/腿):180/180 点、OTR 全 0、
    三条 [proto] 换腿后第一点标记齐全。
    COSS 首/次 = 3568.80 / 3559.53 pF(比值 1.003;修复前 0.552)
    CRSS 首/次 = 1749.57 / 1795.66 pF(0.974;修复前 0.337)
    用户目视「现在好多了」。
    撤压改动 bias_apply(0) 无独立日志证据,只记「代码路径已生效」。
    新增 board/measurements/20261024_leg_settle_fix_sweep.md + 原始日志 + 逐点 CSV。
    [20261024_leg_settle_sweep.csv]
2026-10-24 [llm-078] 新增 hardware/ 四块自绘板卡设计源文件;记录「拐点提前 = 显示问题」已排除
    [cv_control_expansion_board.epro]
2026-10-25 [llm-079] AI anomaly detection integrated into C/LVGL UI
    Unsupervised Mahalanobis-distance diagnosis of the three sweep legs,
    no fault samples required.
    - features per leg: log10(Cs@0.3V), log10(Cs@100V), log10(V50), log10(V75/V25)
    - covariance from 10 TK9J90T devices (shrinkage reg=0.1);
    center = 2026-10-24 healthy baseline on this rig
    - thresholds: <25 normal, 25-100 suspect, >=100 fault
    - results tab 6 "AI detection"; scored automatically at sweep end,
    cleared on abort/restart; [ai] log lines
    - host unit test + on-board (A9) unit test pass
    - board run 2026-10-25: 180/180 points, scores 0.1 / 0.0 / 5.2, all normal
    Also fixes four "%.3f" label calls that rendered as "f"
    (LV_SPRINTF_US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
    [20261025_ai_detection_3legs_60pt.csv]
2026-10-27 [llm-080] two-load calibration: LOAD1+LOAD2 affine fit, file format v2
2026-10-27 [llm-080] on-board UI check: fix clipped coverage labels/cells, status overflow, stale tile text
    [pynq_protocol.c]
2026-10-27 [llm-080] record on-board re-check of UI fixes
2026-10-29 [llm-081] channel-level calibration: fix negative point CRSS, rebuild AI baseline
    - calibration: apply per (gear, freq) channel fit instead of per leg;
    sweep and point measurement now share one set of coefficients
    - pynq_protocol: sweep_begin_leg() sets s_pair_path (historical bug)
    - anomaly_model_data.h regenerated from 2026-10-29 v2 sweep baseline
    - tests updated; board binary 2a0c7ccb...
    [20261029_leg_settle_sweep_cal_v2.csv]
2026-10-29 [llm-081] add |a-1| physicality guard: only gear B applies calibration
    C/D gears passed the old |b|/R0 guard only because R0 is large, while
    their fitted complex gain is 1.42/9.6 in magnitude (phase 42/80 deg).
    Applying those would amplify noise ~10x and still show 'calibrated'.
    New CAL_A_DEV_MAX = 0.50 rejects A (b 0.564), C and D (|a-1| 0.95/9.48);
    verified against the real calibration file: availability A/B/C/D = 0/1/0/0.
    Tests updated (synthetic a -> 1.05+0.02j, plus a dedicated a-only reject case).
    Board rebuilt to c_ui md5 44c1ff2b794078d78de7b448613a5755; takes effect
    next power-on (service untouched, one bitstream load per power cycle).
    [calibration.c, calibration.h]
2026-10-29 [llm-081] on-board re-verify: guard and new AI baseline live
    Board soft-rebooted (exactly one bitstream load), service started on demand.
    /proc/<pid>/exe md5 == 44c1ff2b... so the |a-1| guard is the binary in use.
    Gear A point measurement logged (未校准) with raw 3485.7/3758.9/1589.2 pF;
    gear B logged (已校准), CISS 3311.6/3328.7, COSS 3609.4/3598.5,
    CRSS 1539.3/1539.8 pF, Rg 3.113 ohm.
    Sweeps: 60 + 180 points, 250/250 ADC records OTR 0, no auto gear change.
    AI: CISS 0.1 / COSS 0.1 / CRSS 0.7 -> normal (threshold 25), so the
    2026-10-29 baseline is confirmed in effect. C/D gears were not exercised
    on hardware; their rejection is host-verified only.
2026-10-29 [llm-082] RG summary: strip unit before parsing so results page and QR get Rg
    UI_Demo_UpdateResistance() received "3.11 Ω" but the strict parser rejects any space, so g_latest_rg_valid was never set and the results snapshot never recorded route 3. The measurement-page card updated outside the parse block, which masked the failure.
    Add UI_ExtractDecimalText(): trim leading blanks, take the numeric prefix, and still reject trailing junk ("3.11abc"). Store numeric-only text in the snapshot and let the UI append the single Ω. Log parse failures instead of failing silently.
    Also carries two already-present workspace UI tweaks: header status label LV_LABEL_LONG_DOT and dynamic AI baseline date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
2026-10-29 [llm-083] AI anomaly model: add platform repeatability to covariance
    The 2026-10-29 sweep was flagged CISS 117.1 even though its whole CISS
    curve stayed within ±1 % of the healthy baseline. The Mahalanobis
    covariance only modelled device-to-device spread and had no term for
    this platform's own repeat sweeps, so a 1 % platform shift was amplified
    by log10(V75/V25) into ~5 % and crossed the 100 threshold.
    - new extract_platform_repeats.py: pull complete, calibrated, 3-leg
    sweeps out of a board log; keep only the current channel-level
    calibration runs (8170+ in the 2026-10-29 log) so the old per-leg
    calibrations are not mistaken for repeatability.
    - fit_anomaly_model.py: --repeat; cente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
    [20261029_platform_repeat_cal_v2.csv]
2026-11-02 [llm-084] sync 2026-11-02 standard-board check; prune dead RTL and debug artifacts; refresh README
    - add 20261025_ai_detection_board.md and 20261029/20261023 evidence that reports cited
    - add 20261102 standard-board single-point check and screenshot
    - add LLM-084, update INDEX
    - remove non-instantiated RTL: qrs.v, lcd_driver.v, ad9238.v, swm.v
    - remove unreferenced debug artifacts (20261005 cvctrl reports, autoscale log)
    - rewrite README: current bitstream/resource facts, official directory mapping
    - trim cv_sys.v historical header
    [20261025_ai_detection_3legs_60pt.csv, 20261029_leg_settle_sweep_cal.csv]
2026-11-04 [report] renumber figure references after inserting Fig.9; unify caption spacing
    Update the in-text figure references that shifted after the new Kelvin
    measurement figure (Fig.9), and align its caption spacing with the
    other captions. Text, data, images and layout are otherwise unchanged.
